sundevilmotorsports/pcb-dev/MiscLibraries/Figures/Mr Robberts/matt_throberts_720.png

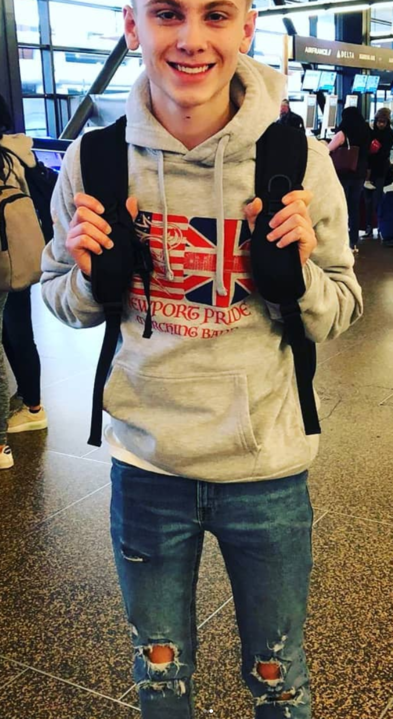
MiscLibraries/Figures/Mr Robberts/matt_throberts_720.png
