sundevilmotorsports/pcb-dev/MiscLibraries/Figures/Berdly/Cooking_Strain_Gauge2.jpeg

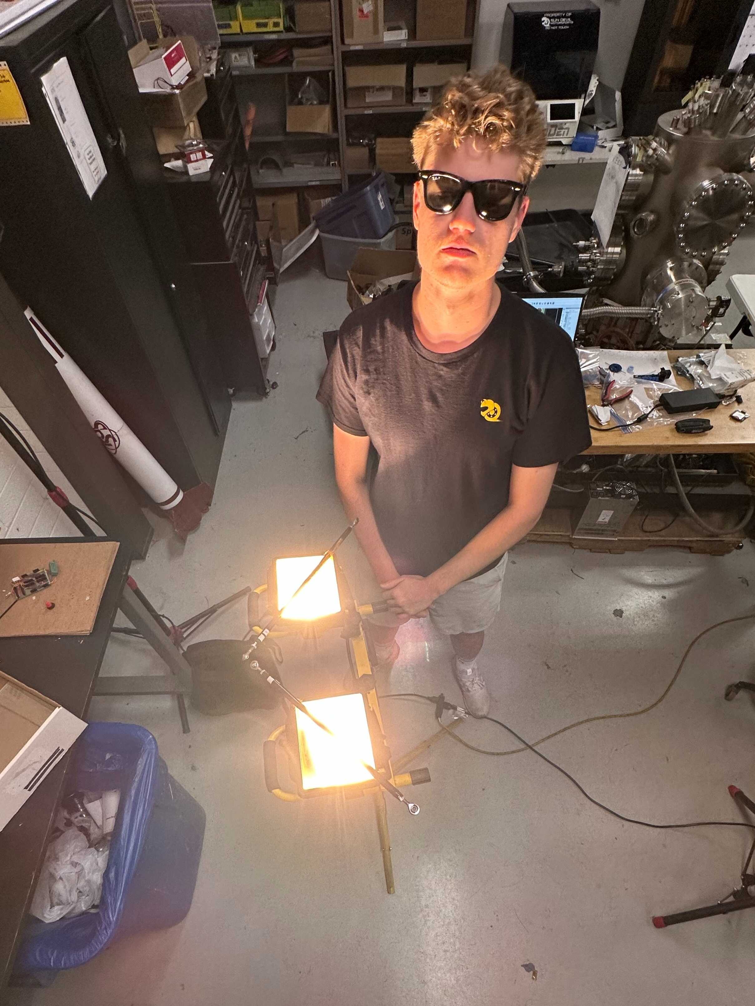
MiscLibraries/Figures/Berdly/Cooking_Strain_Gauge2.jpeg
