sundevilmotorsports/pcb-dev/README.md

# Sun Devil Motorsports Data Acquisition PCB Repository
## About
Various PCB projects for Data Acquisition. Includes:
- SDM-22 Main Board
- SDM-22 Wheel Board
- SDM CAN Board (Texas Instruments SN65HVD230)
- SDM KiCad library (submodule)
- SDM-23 things
- SDM-24 things
## Installation Requirements
- KiCad 6
- `SDM.pretty`, `SDM_kicad`, `teensy.pretty`, `teensy_library` (included here as submodules)
## Installation Instructions
1. Get the project.
```bash
$ git clone --recursive git@github.com:sundevilmotorsports/pcb-dev.git
```
2. Add `SDM.pretty`, `SDM_kicad`, `teensy.pretty`, `teensy_library` as libraries in KiCad.
