sundevilmotorsports/pcb-dev/2027/ESP_C5_Template/ESP C5 Extra Documentation.pdf

ESP USB_C
Power Net Names:
- Any voltage like 3.3v or 5v comes from a regulator on board.
- VBUS comes from a USB connection
- VCC comes from the car/anywhere outside the board.
- GND/VDD = Ground
Switching to USB_C for commonality/accessibility purposes

Power (Protection)
Max current calculation
- 12 * historic input current = 5 * output current + c
- c = losses due to heat, can essentially be ignored 2025 max constant current = 400mA
- 12 * 0.4 = 5 * oc
- oc = 1.042A
The lowest max rated current is TPS2116DRL @ 2.5A. Lowest Max rated current = LMC = 2.5A.
Efuze Max current = EMC.
Max constant current = MCC = 1.042.
MCC < EMC <= LMC

TPS25925x Calculations
TPS259250 = Latch on fault,
TPS259251 = auto retry on fault
Resistor @ ILIM pin calc = (ILIM (max current) - 0.7) / (3 * (10 ^ -5))
(LMC - 0.7) / (3 * (10 ^ -5)) = 60k Ohm
Undervoltage Lockout Set = V_(UV) = ((R_1 + R_2) /R_2) * V_ENR (1.4 Given) Left open so default value of V_(UV) is 4.3V

CAN Transceiver
Layout is essentially the same as SDM 26 except for a few changes:
- New 3.3V FD Transceiver with:
- An exposed thermal pad pin (EP)
- No 0 resistor to adjust slew rate New chip is 8Mbps, while last years was just 1.

Crystal/Oscillator
- 48 MHz req. by C5 chip
Load Capacitors Calculations
- CL is Load Capacitance listed in the crystals datasheet
- Cs is Stray Capacitance (unintentional capacitance due to close proximity of components), set range is debated based on the board but calculators use 2-7pF. CL=10 pF
*Say Cs=4pF
CL= (C1xC2)/(C1+C2)+Cs

Symmetrical Load
C1=C2= 2(CL-Cs)
C = 2(10-4) = 12pF

https://nodeloop.org/tools/crystal-load-capacitor-calculator/?cl=10&cs=4
