sundevilmotorsports/pcb-dev/PRE2026/old/sdm_kicad/README.md

# sdm_kicad
Sun Devil Motorsports KiCad Library.
