sundevilmotorsports/pcb-dev/2026/Telemetry/SDM26_Telemetry_V1.0/Impedance Matching Layers.png

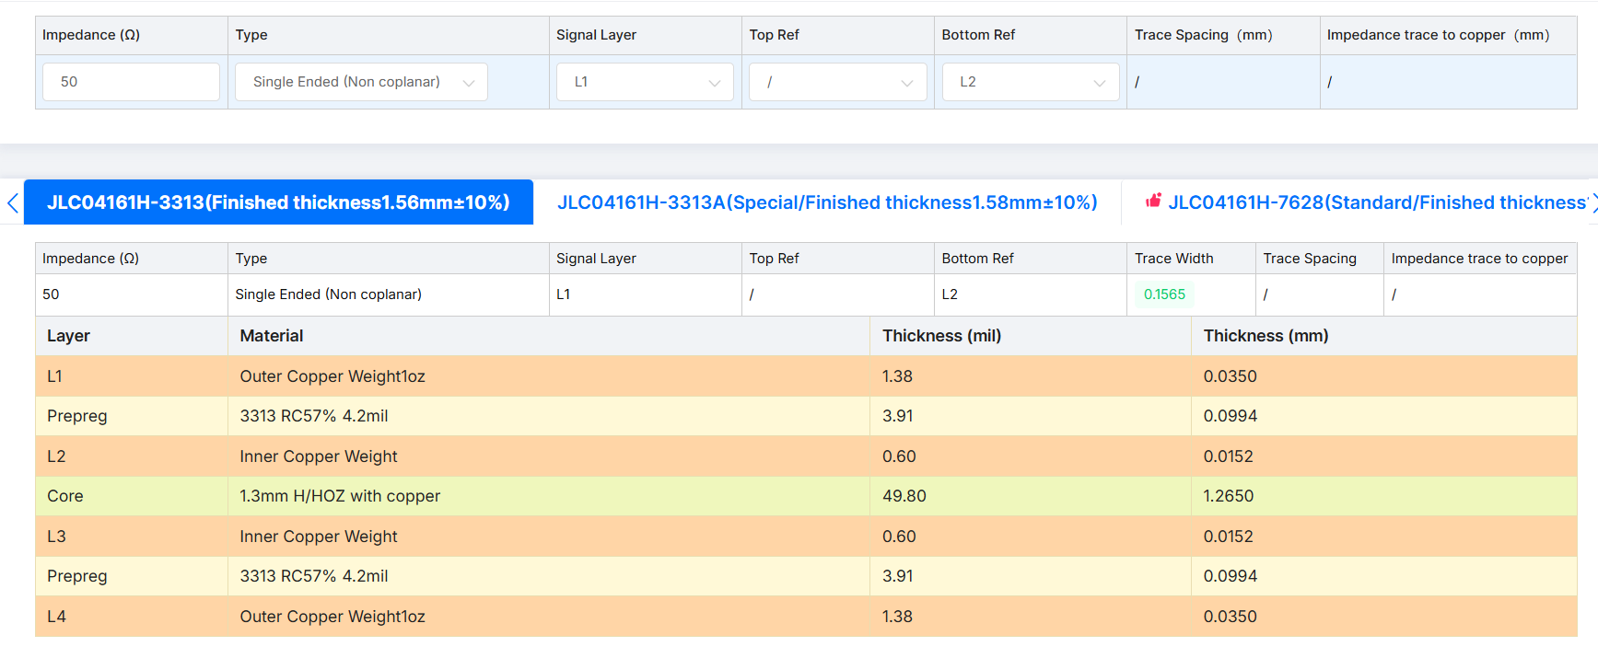
2026/Telemetry/SDM26_Telemetry_V1.0/Impedance Matching Layers.png
