sundevilmotorsports/pcb-dev/MiscLibraries/Figures/Berdly/Cooking_Strain_Gauge.jpeg

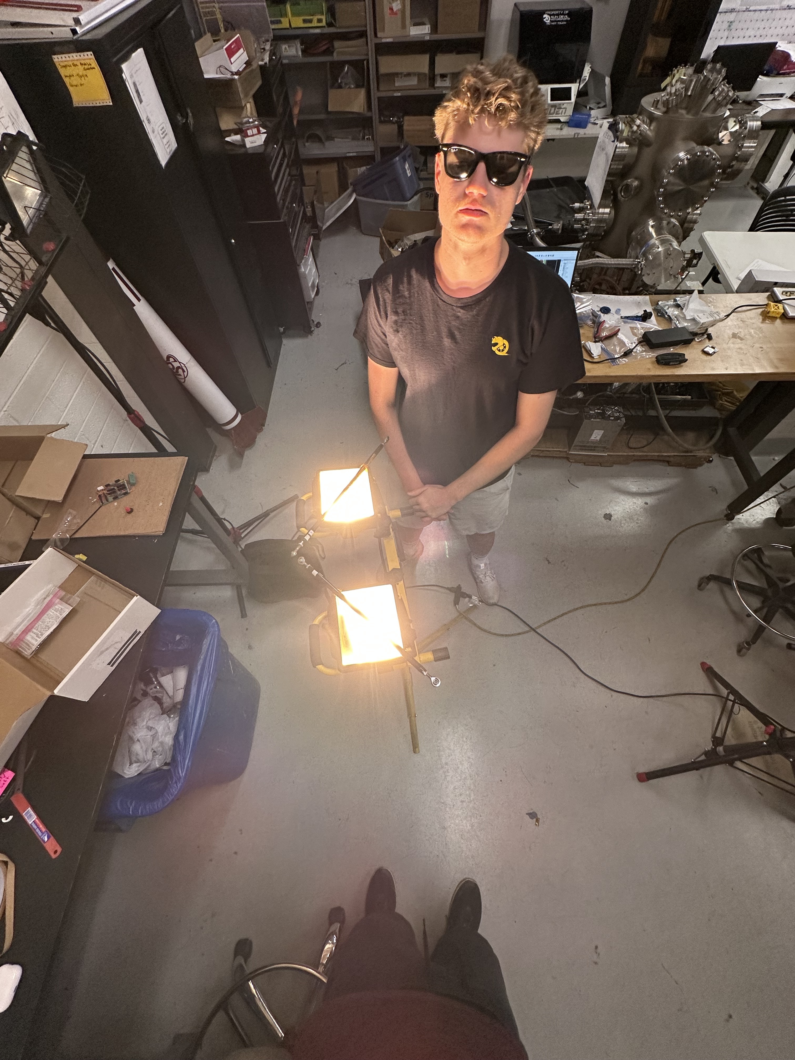
MiscLibraries/Figures/Berdly/Cooking_Strain_Gauge.jpeg
