sundevilmotorsports/pcb-dev/MiscLibraries/Figures/Berdly/FindingGold.jpg

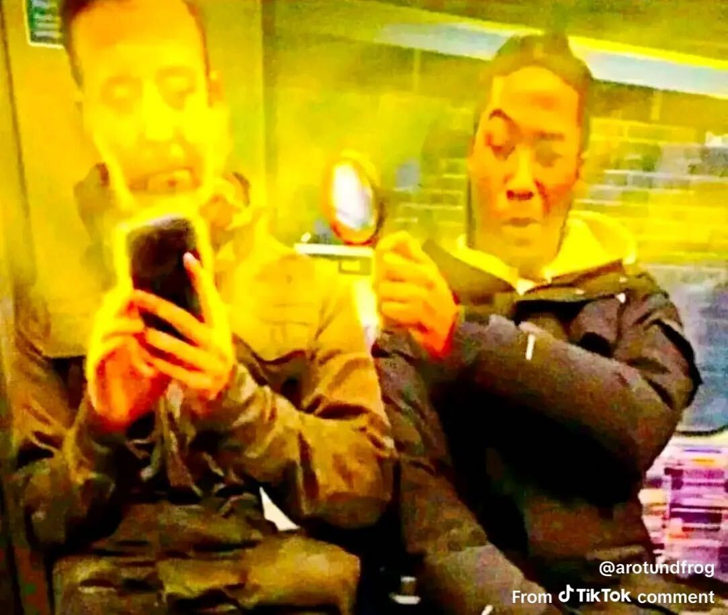
MiscLibraries/Figures/Berdly/FindingGold.jpg
