sundevilmotorsports/pcb-dev/MiscLibraries/Figures/Chris/DevistatedChris.jpg

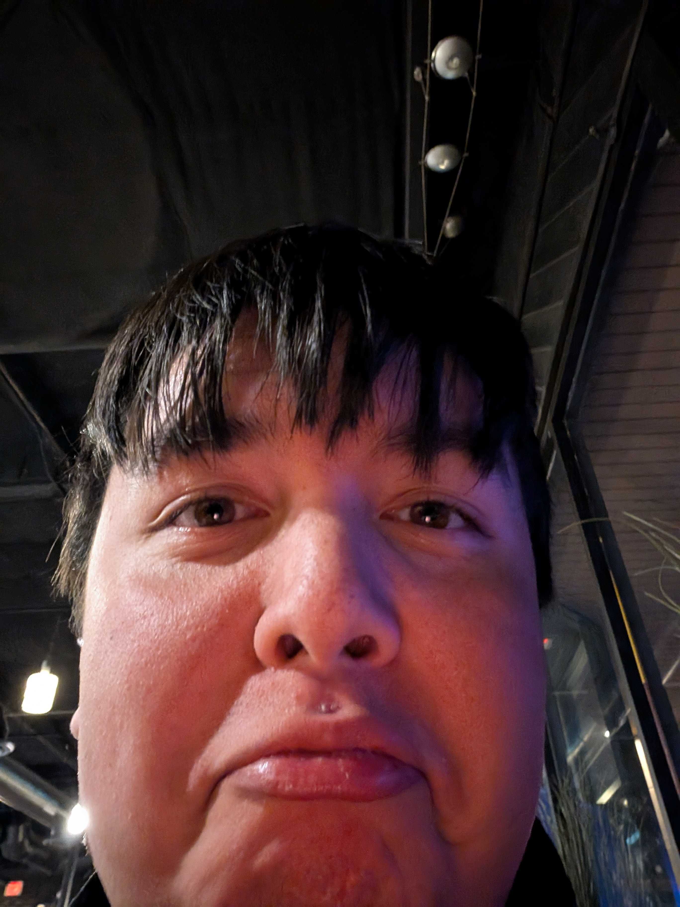
MiscLibraries/Figures/Chris/DevistatedChris.jpg
