sundevilmotorsports/pcb-dev/MiscLibraries/Figures/Chris/PXL_20250712_215207178.jpg

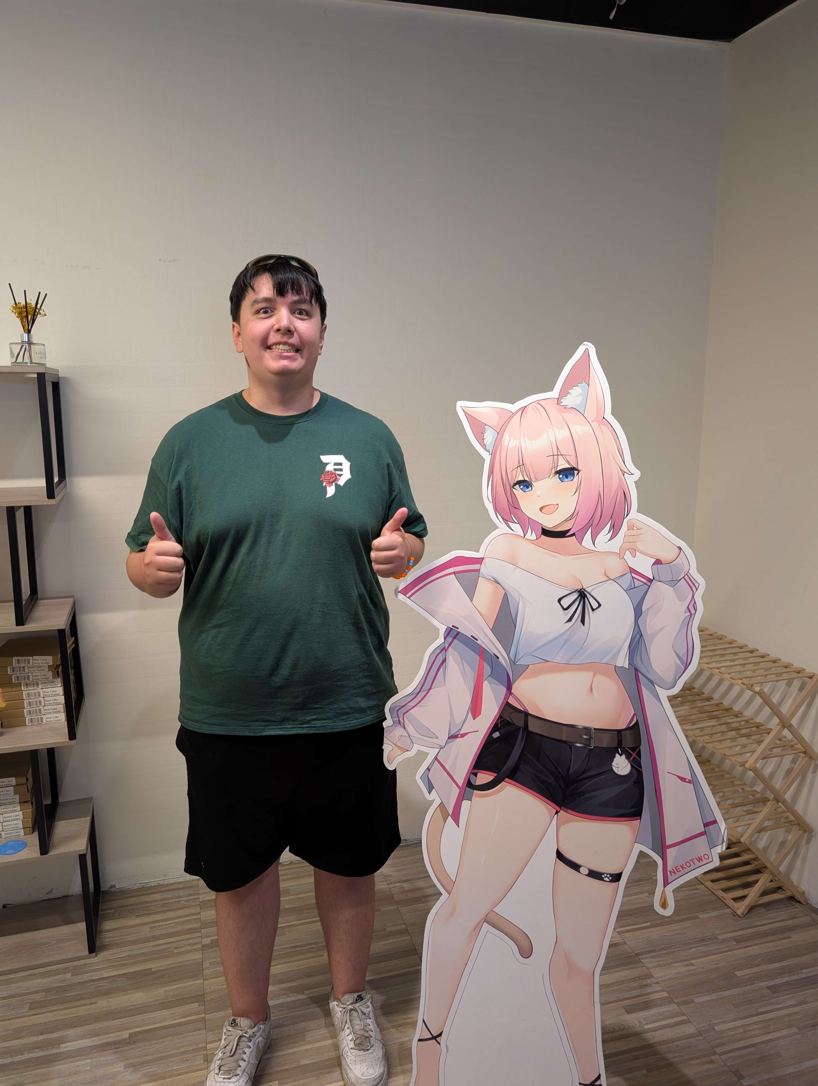
MiscLibraries/Figures/Chris/PXL_20250712_215207178.jpg
