sundevilmotorsports/pcb-dev/MiscLibraries/Figures/Chris/rsz_1chrisdevistatedbw.jpg

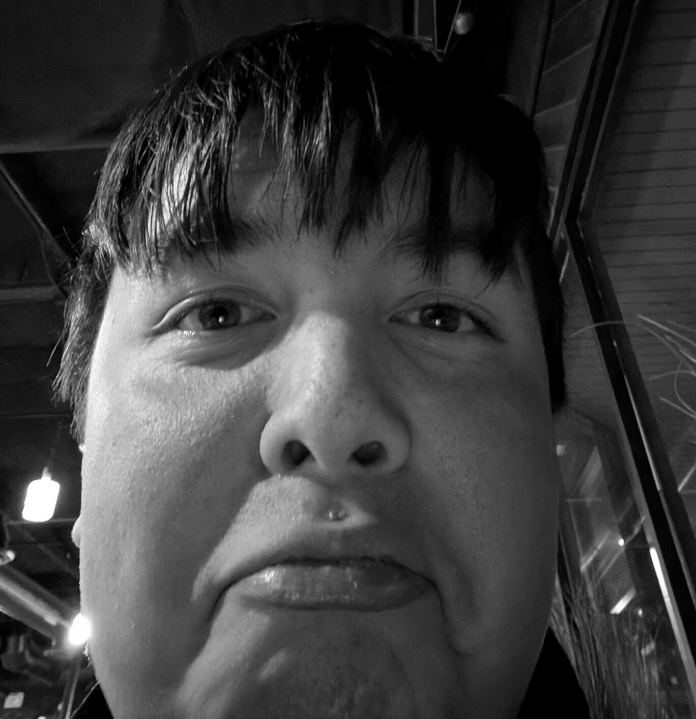
MiscLibraries/Figures/Chris/rsz_1chrisdevistatedbw.jpg
