sundevilmotorsports/pcb-dev/MiscLibraries/Figures/Comp/SDM_Comp24_Team.jpg

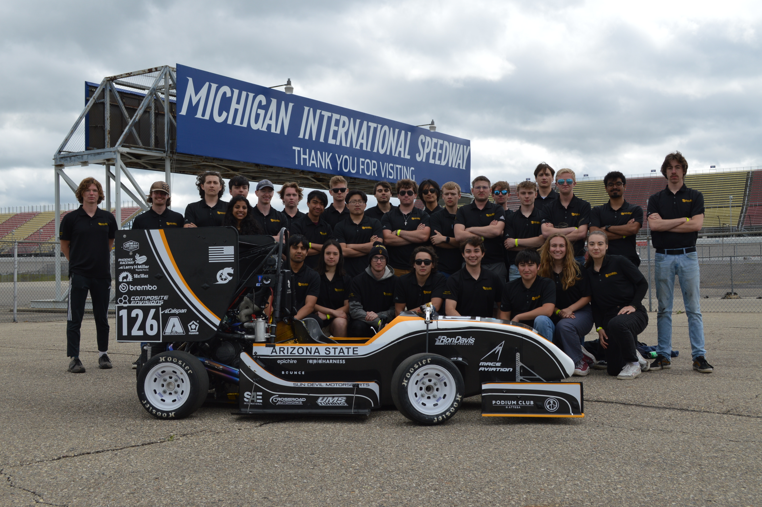
MiscLibraries/Figures/Comp/SDM_Comp24_Team.jpg
