sundevilmotorsports/pcb-dev/MiscLibraries/Figures/Comp/SDM_Comp25_Team.jpg

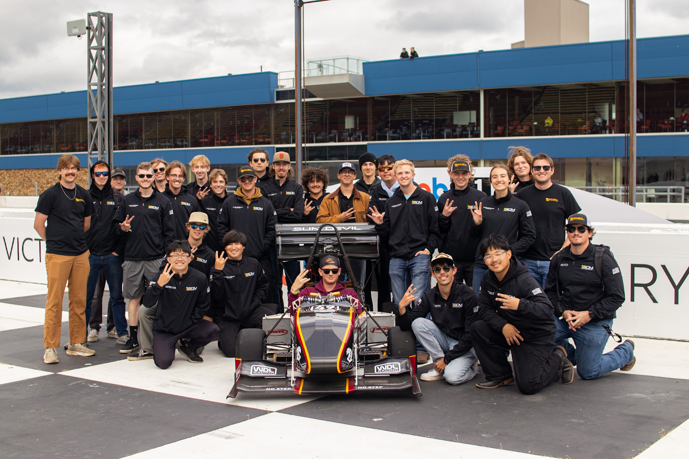
MiscLibraries/Figures/Comp/SDM_Comp25_Team.jpg
