sundevilmotorsports/pcb-dev/MiscLibraries/Figures/DAQ/DAQ_Drawing.jpg

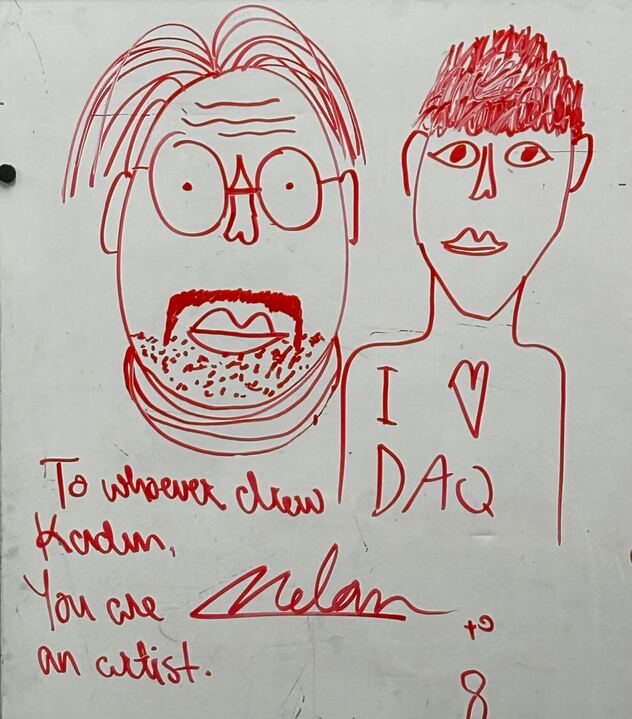
MiscLibraries/Figures/DAQ/DAQ_Drawing.jpg
