sundevilmotorsports/pcb-dev/MiscLibraries/Figures/Derk/Derk2.JPG

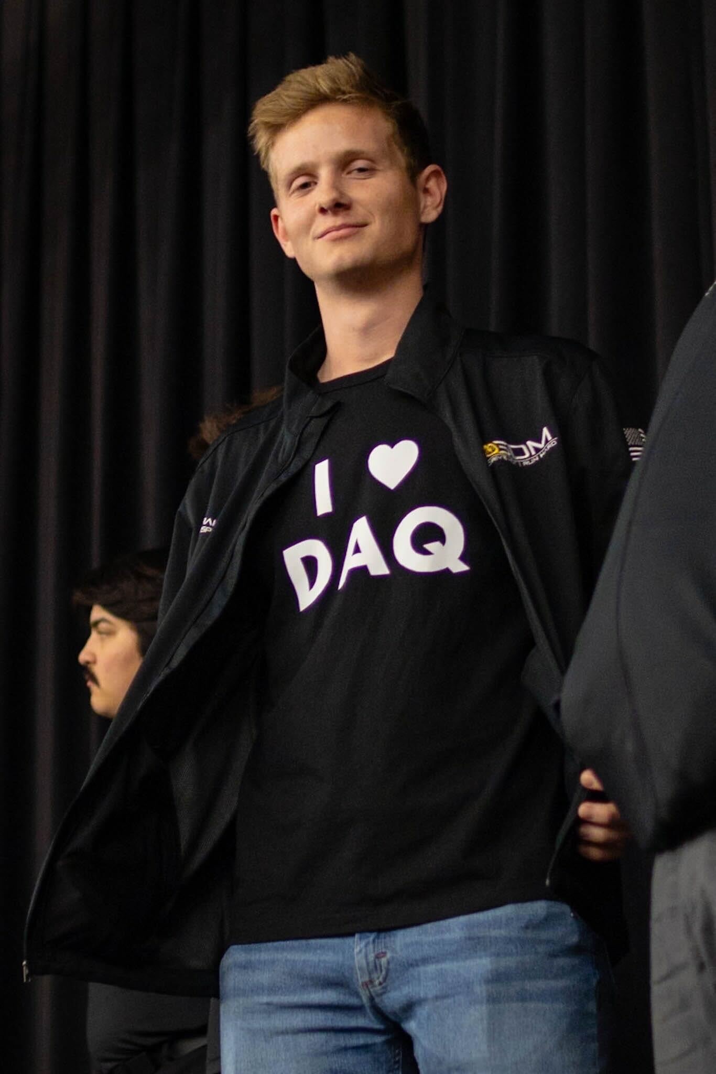
MiscLibraries/Figures/Derk/Derk2.JPG
