sundevilmotorsports/pcb-dev/MiscLibraries/Figures/Derk/Derk-Better.png

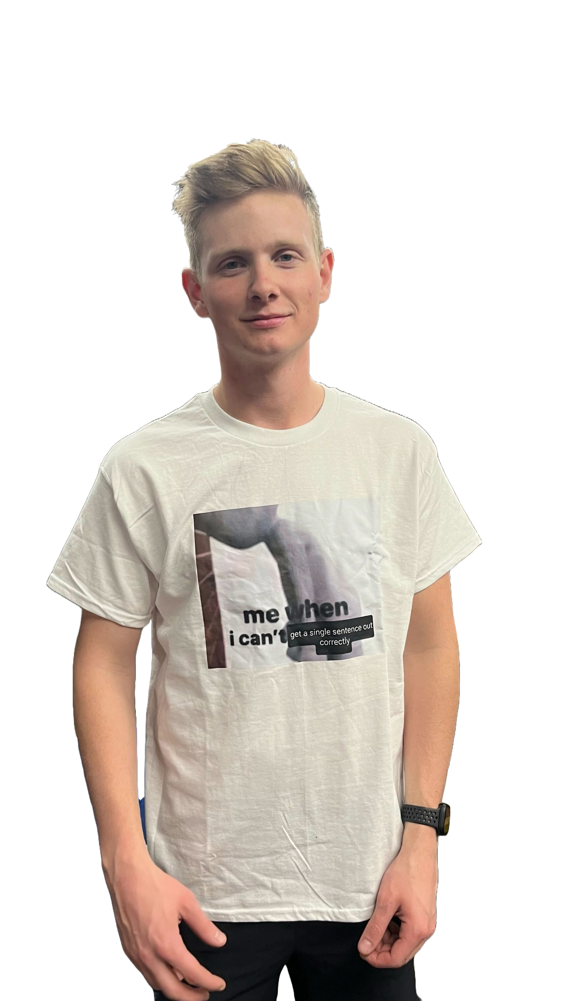
MiscLibraries/Figures/Derk/Derk-Better.png
