sundevilmotorsports/pcb-dev/MiscLibraries/Figures/Derk/Derk.PNG

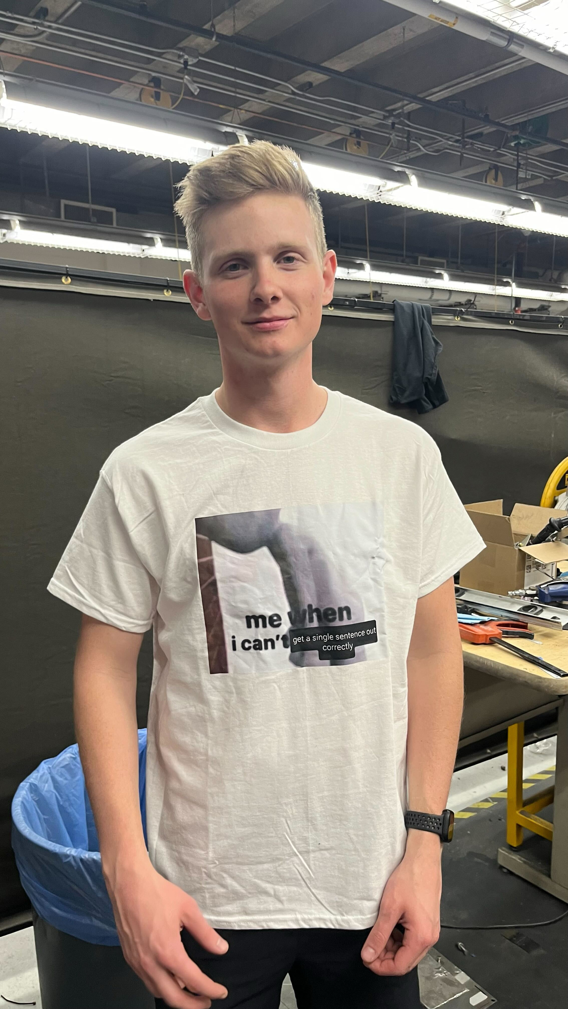
MiscLibraries/Figures/Derk/Derk.PNG
