sundevilmotorsports/pcb-dev/MiscLibraries/Figures/Derk/NotVeryMormonOfYou.jpg

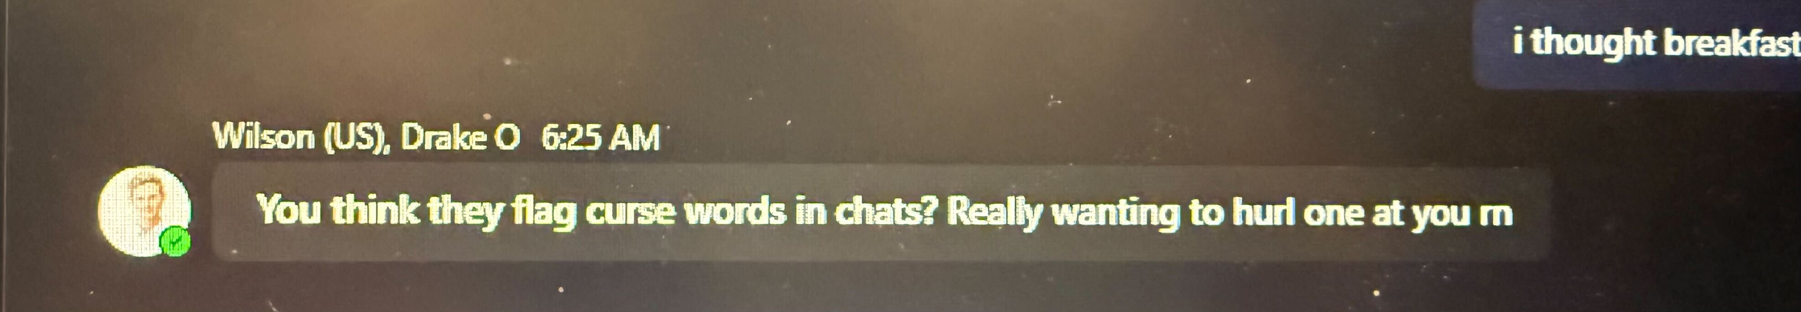
MiscLibraries/Figures/Derk/NotVeryMormonOfYou.jpg
