sundevilmotorsports/pcb-dev/MiscLibraries/Figures/EmojiGuys/BoarHeadExploding.png

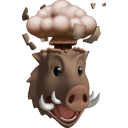
MiscLibraries/Figures/EmojiGuys/BoarHeadExploding.png
