sundevilmotorsports/pcb-dev/MiscLibraries/Figures/EmojiGuys/Emo_ji.JPG

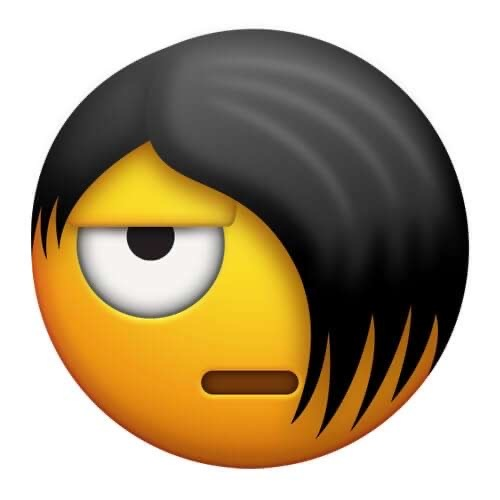
MiscLibraries/Figures/EmojiGuys/Emo_ji.JPG
