sundevilmotorsports/pcb-dev/MiscLibraries/Figures/EmojiGuys/evil_hands.png

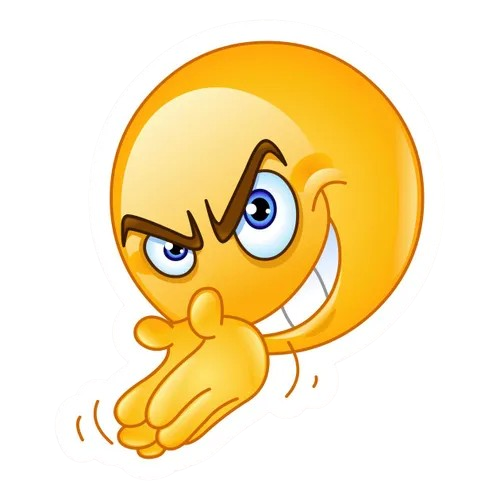
MiscLibraries/Figures/EmojiGuys/evil_hands.png
