sundevilmotorsports/pcb-dev/MiscLibraries/Figures/EmojiGuys/Lean.png

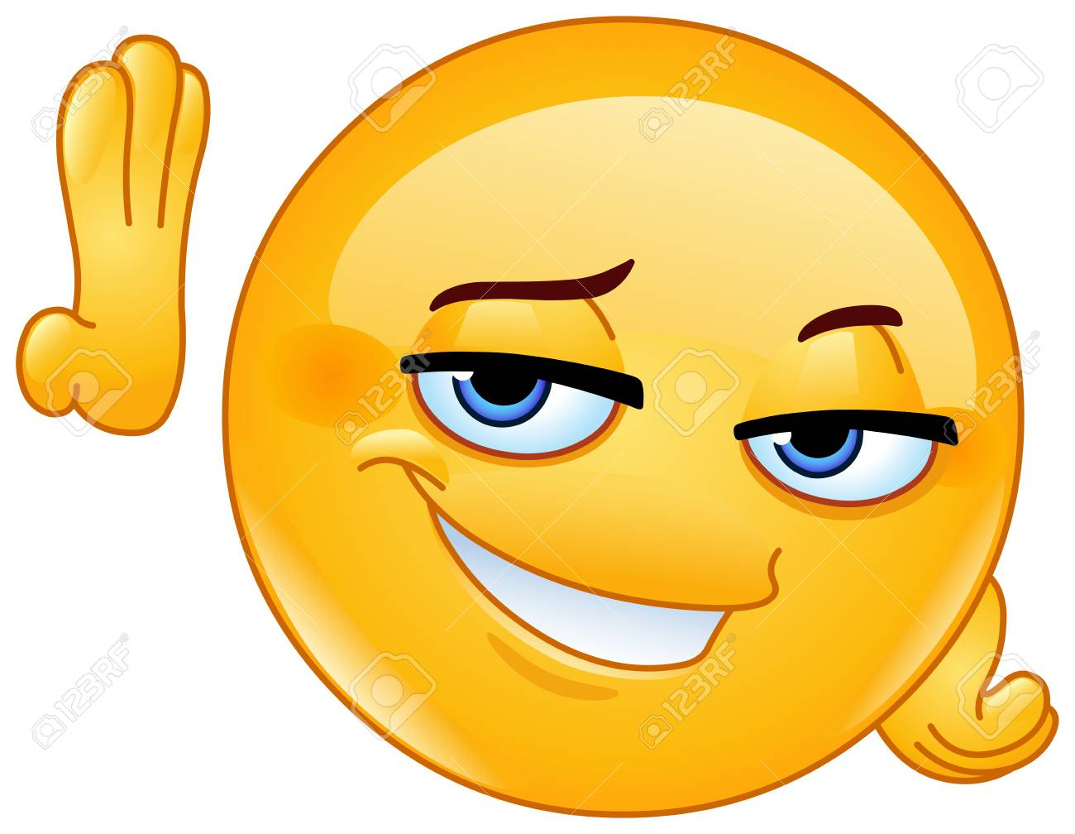
MiscLibraries/Figures/EmojiGuys/Lean.png
