sundevilmotorsports/pcb-dev/MiscLibraries/Figures/Fattu/IMG_8624.jpg

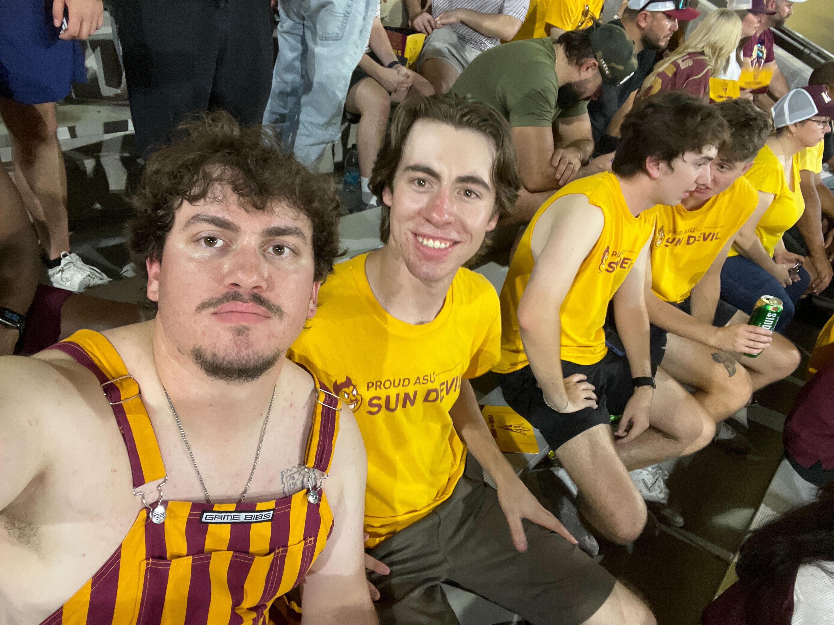
MiscLibraries/Figures/Fattu/IMG_8624.jpg
