sundevilmotorsports/pcb-dev/MiscLibraries/Figures/Hunter/DoubleBoof.jpg

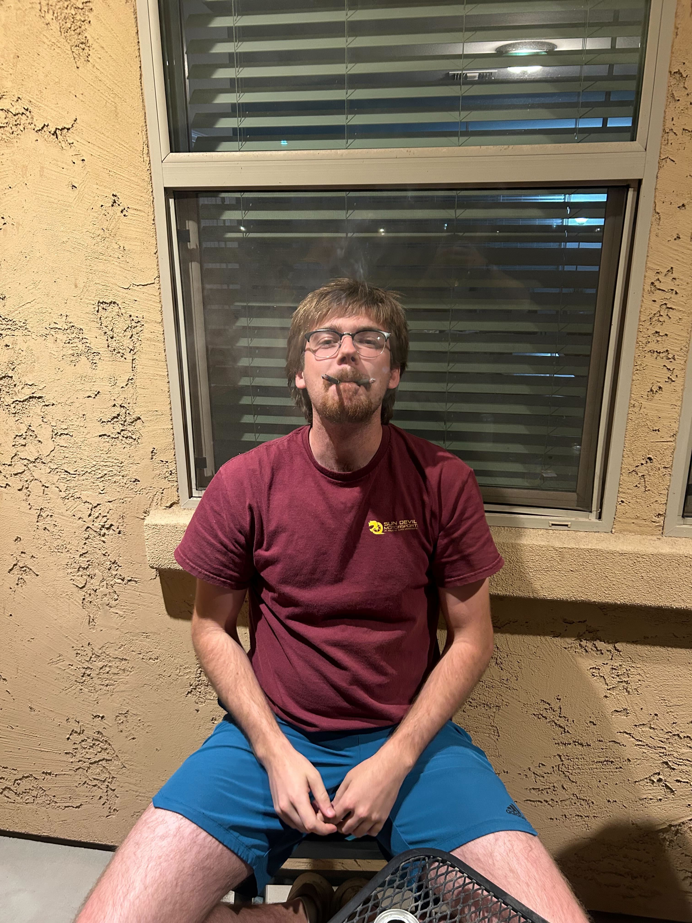
MiscLibraries/Figures/Hunter/DoubleBoof.jpg
