sundevilmotorsports/pcb-dev/MiscLibraries/Figures/Hunter/IMG_1586.jpg

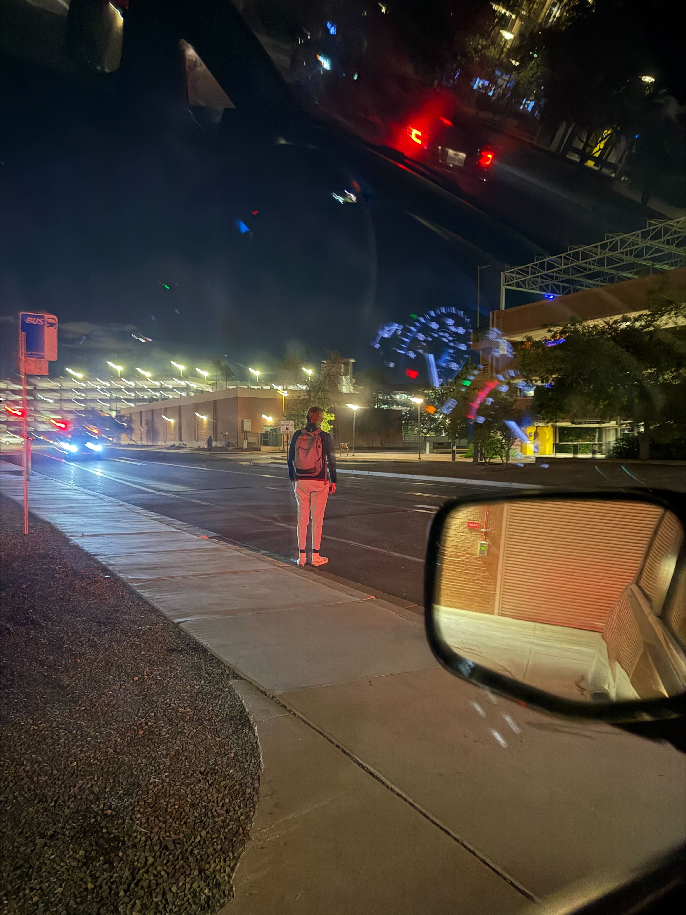
MiscLibraries/Figures/Hunter/IMG_1586.jpg
