sundevilmotorsports/pcb-dev/MiscLibraries/Figures/Kaden/Cooking_Strain_Gauge_Kaden2.jpeg

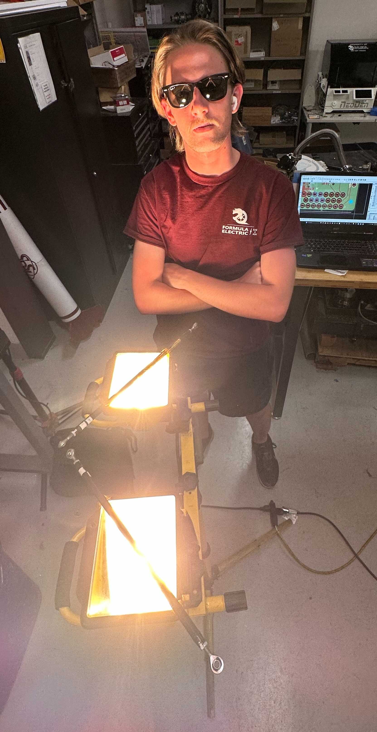
MiscLibraries/Figures/Kaden/Cooking_Strain_Gauge_Kaden2.jpeg
