sundevilmotorsports/pcb-dev/MiscLibraries/Figures/Kaden/Cooking_Strain_Gauge_Kaden.jpeg

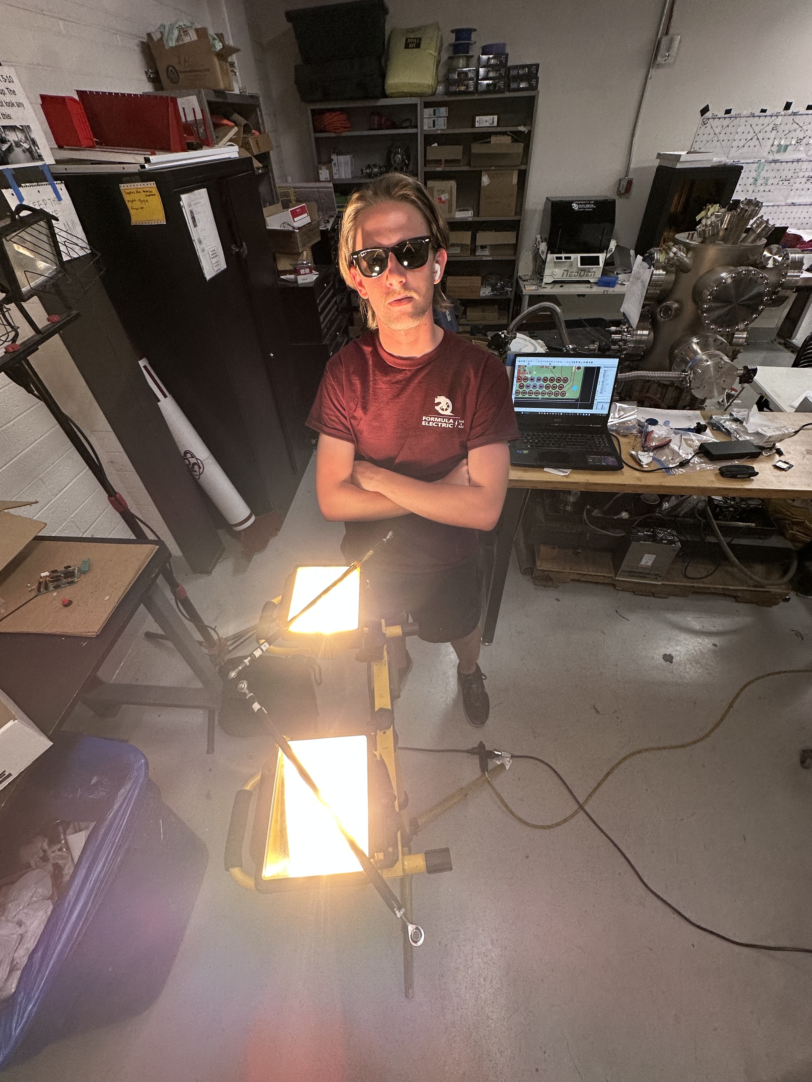
MiscLibraries/Figures/Kaden/Cooking_Strain_Gauge_Kaden.jpeg
