sundevilmotorsports/pcb-dev/MiscLibraries/Figures/Kaden/GodForbidAWhiteBoyHasALittleMotion.png

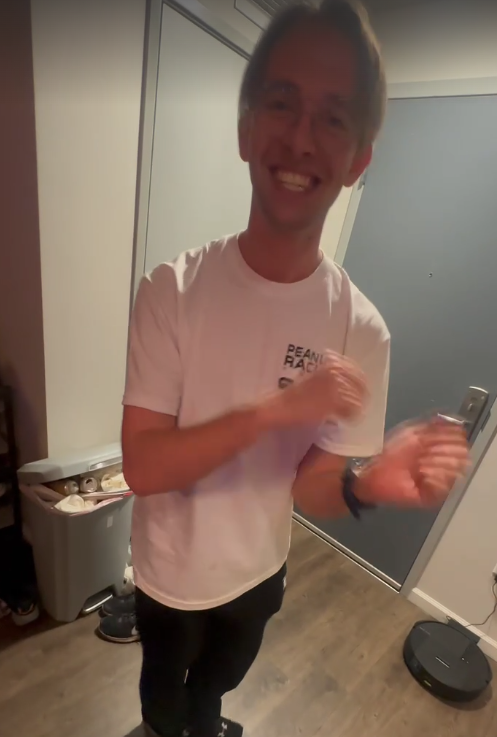
MiscLibraries/Figures/Kaden/GodForbidAWhiteBoyHasALittleMotion.png
