sundevilmotorsports/pcb-dev/MiscLibraries/Figures/Kaden/GodForbidAWhiteBoyHasALittleMotion_NoBackground.png

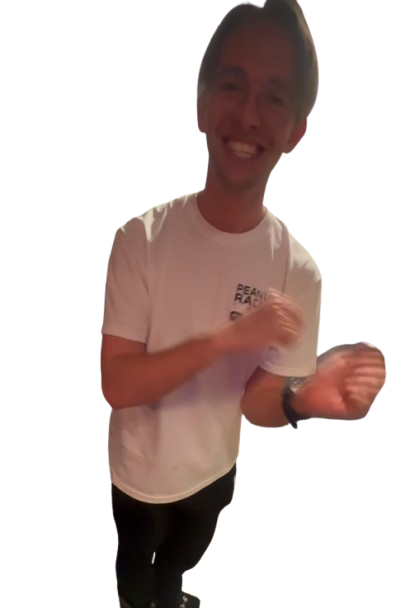
MiscLibraries/Figures/Kaden/GodForbidAWhiteBoyHasALittleMotion_NoBackground.png
