sundevilmotorsports/pcb-dev/MiscLibraries/Figures/Kaden/IMG_5408.JPG

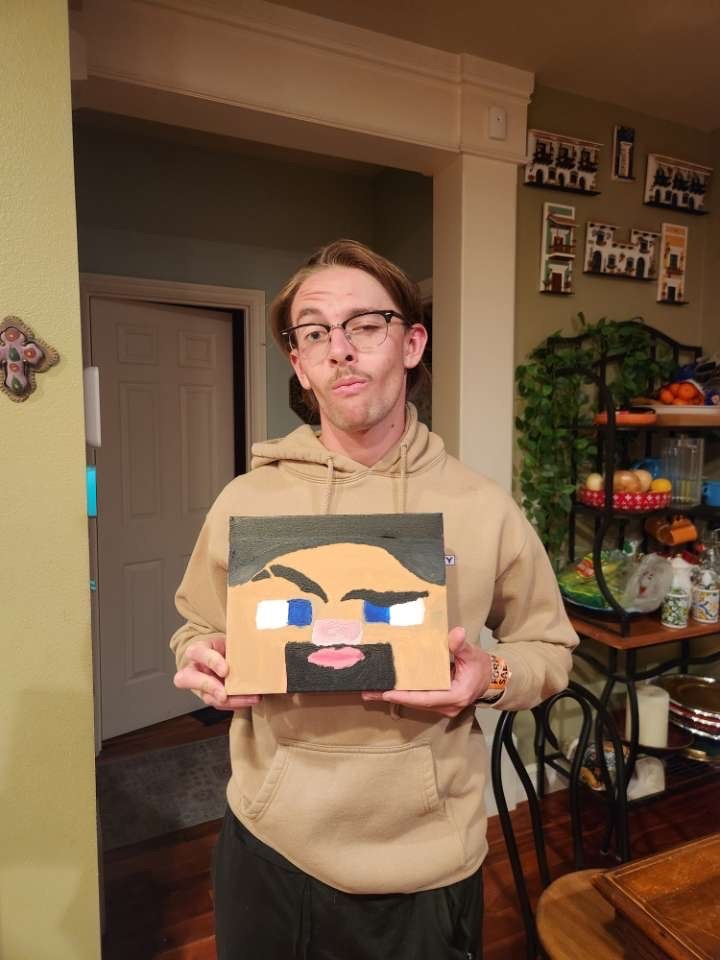
MiscLibraries/Figures/Kaden/IMG_5408.JPG
