sundevilmotorsports/pcb-dev/MiscLibraries/Figures/Kaden/Screenshot 2024-09-02 at 6.34.21 PM.jpg

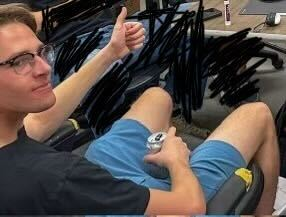
MiscLibraries/Figures/Kaden/Screenshot 2024-09-02 at 6.34.21 PM.jpg
