sundevilmotorsports/pcb-dev/MiscLibraries/Figures/Nick/engine_guy.jpg

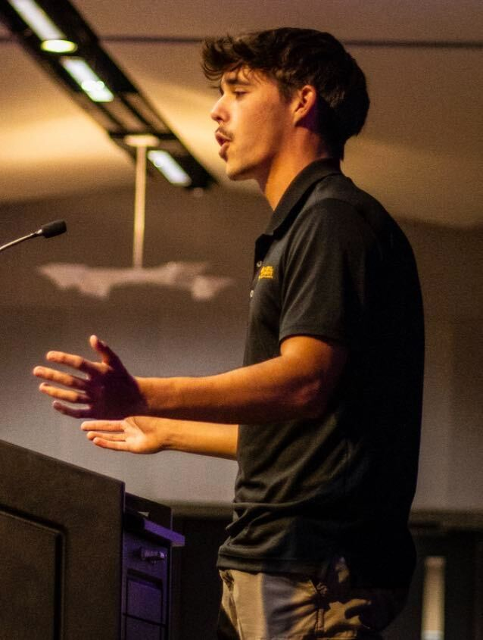
MiscLibraries/Figures/Nick/engine_guy.jpg
