sundevilmotorsports/pcb-dev/MiscLibraries/Figures/Nick/Flickless.png

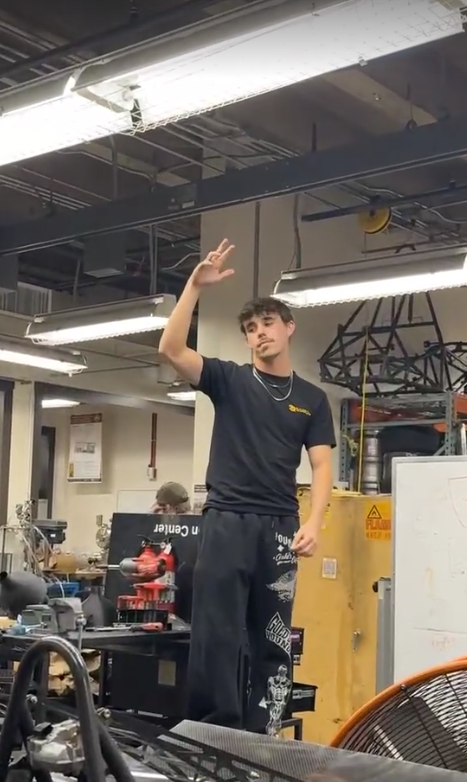
MiscLibraries/Figures/Nick/Flickless.png
