sundevilmotorsports/pcb-dev/MiscLibraries/Figures/Nick/Flickless_NoBackground.png

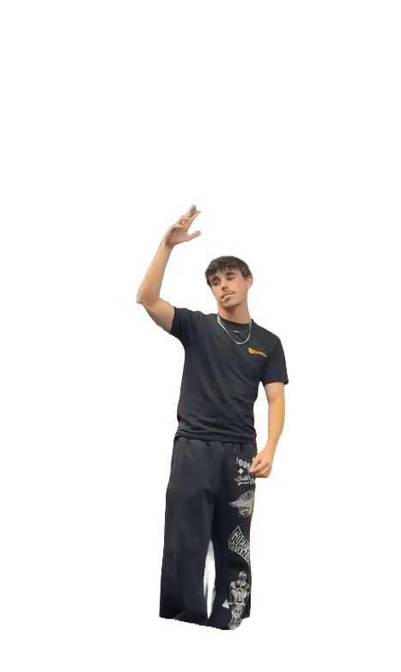
MiscLibraries/Figures/Nick/Flickless_NoBackground.png
