sundevilmotorsports/pcb-dev/MiscLibraries/Figures/Nick/Wazzaaa.jpg

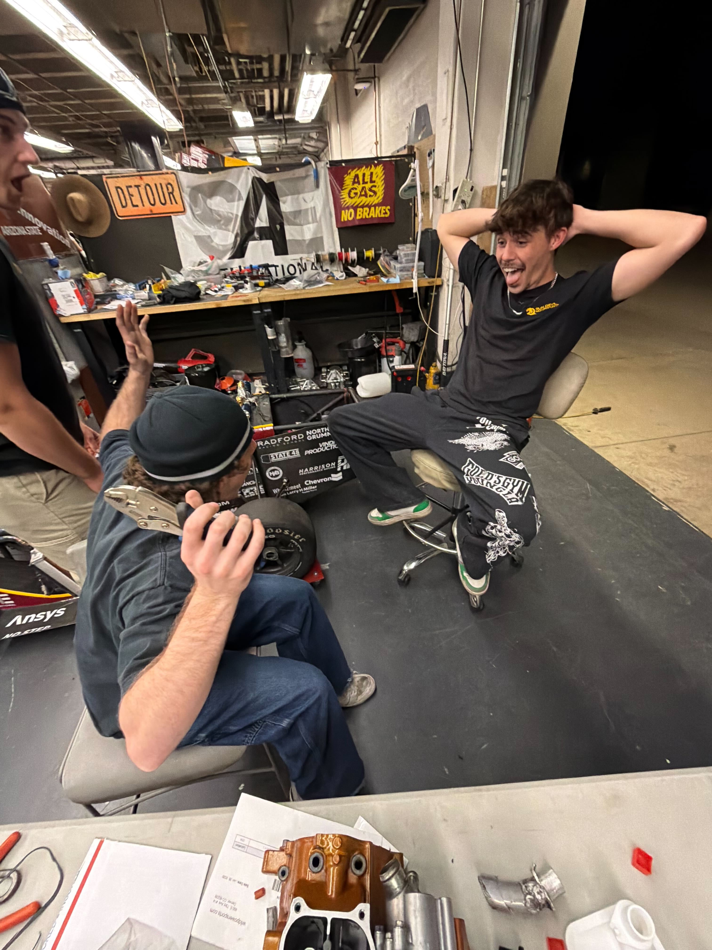
MiscLibraries/Figures/Nick/Wazzaaa.jpg
