sundevilmotorsports/pcb-dev/MiscLibraries/Figures/Nick/Wazzaaa_NoBackground.png

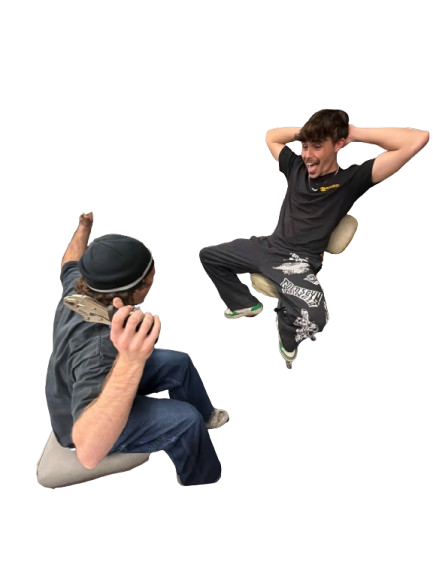
MiscLibraries/Figures/Nick/Wazzaaa_NoBackground.png
