sundevilmotorsports/pcb-dev/MiscLibraries/Figures/SW Requests/aint-shit-sweet.png

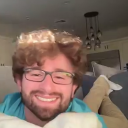
MiscLibraries/Figures/SW Requests/aint-shit-sweet.png
