sundevilmotorsports/pcb-dev/MiscLibraries/Figures/SW Requests/claud silly.png

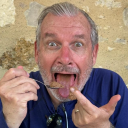
MiscLibraries/Figures/SW Requests/claud silly.png
