sundevilmotorsports/pcb-dev/MiscLibraries/Figures/SW Requests/Thinking Monkey.jpg

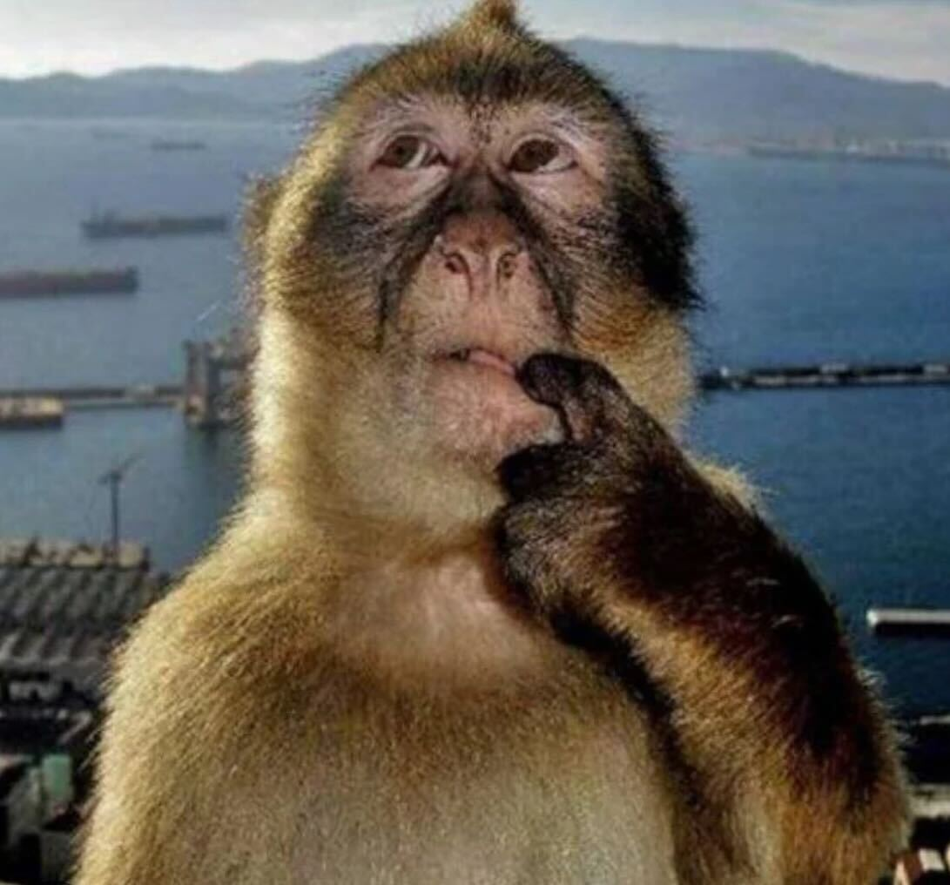
MiscLibraries/Figures/SW Requests/Thinking Monkey.jpg
