sundevilmotorsports/pcb-dev/pictures/sdm22-main.png

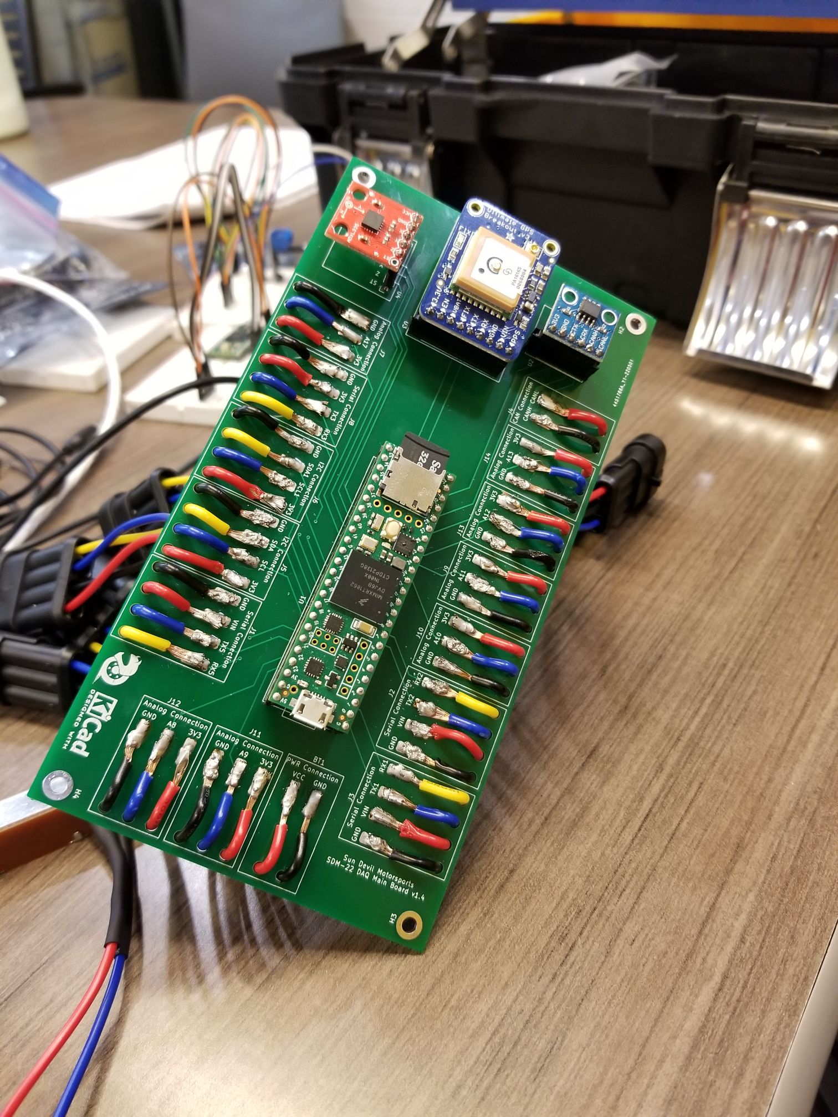
pictures/sdm22-main.png
