sundevilmotorsports/pcb-dev/PRE2026/cansplitter/info/boardstats.png

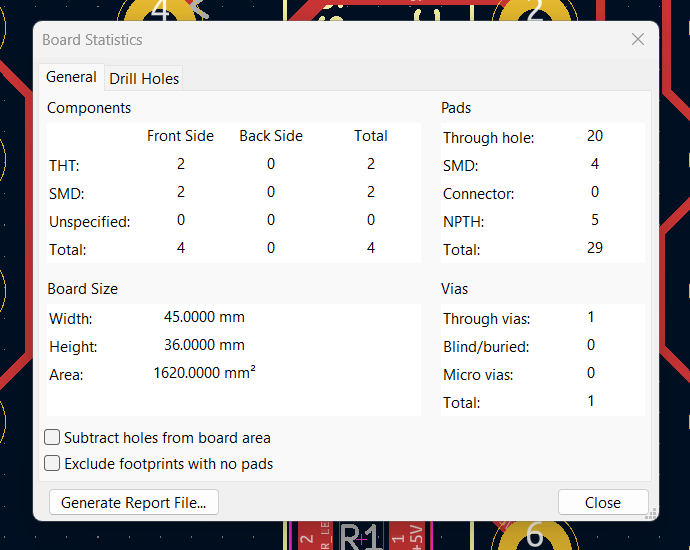
PRE2026/cansplitter/info/boardstats.png
