sundevilmotorsports/pcb-dev/PRE2026/loggerpanel/illegal.jpg

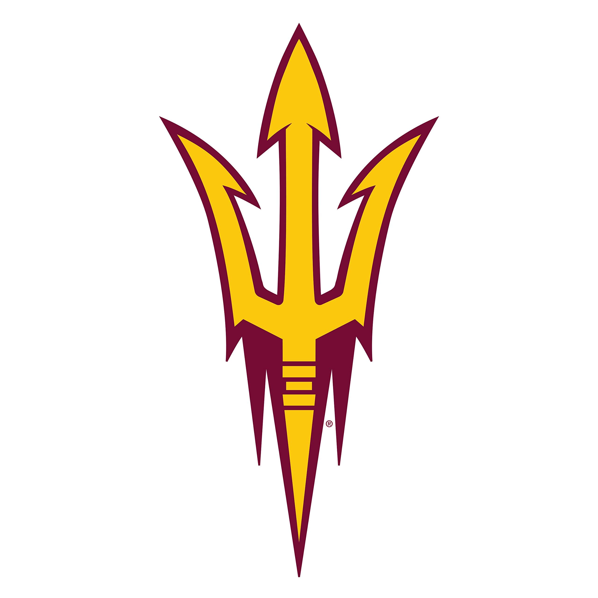
PRE2026/loggerpanel/illegal.jpg
