sundevilmotorsports/pcb-dev/PRE2026/loggerpanel/pompompurin-half.png

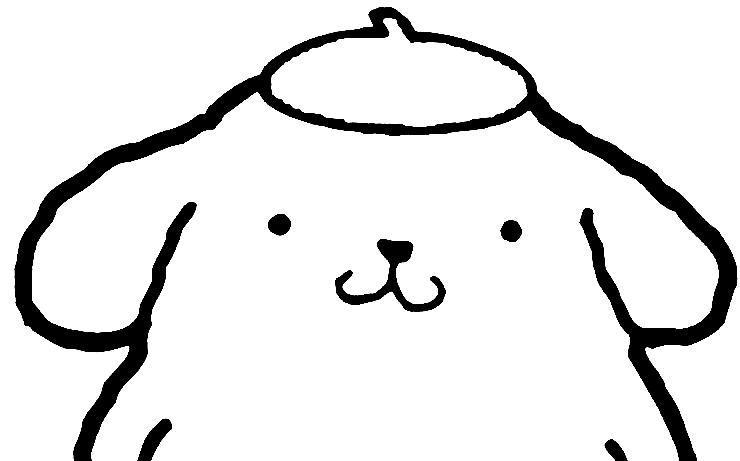
PRE2026/loggerpanel/pompompurin-half.png
