sundevilmotorsports/pcb-dev/PRE2026/loggerpanel/pompompurin.png

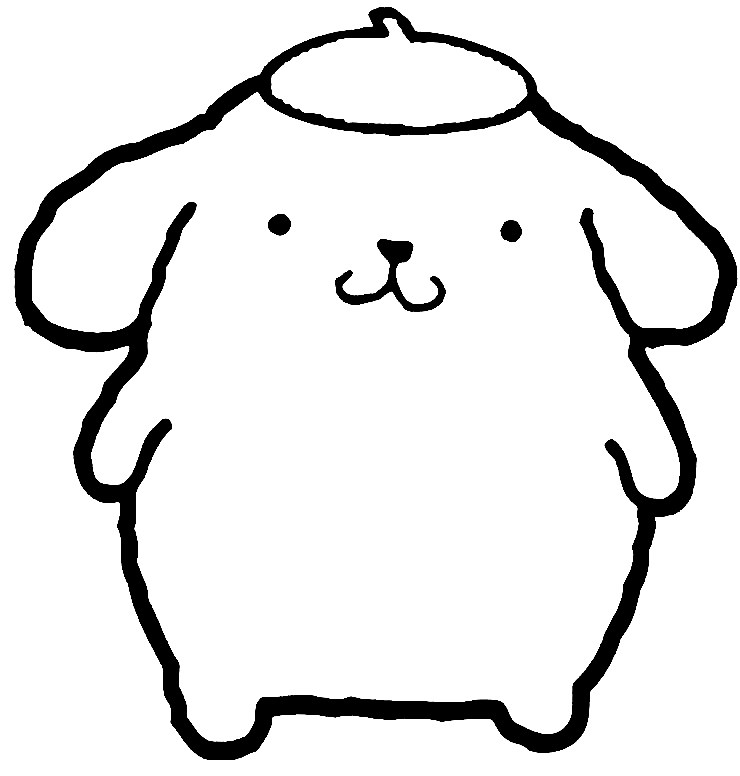
PRE2026/loggerpanel/pompompurin.png
