sundevilmotorsports/pcb-dev/PRE2026/sdm24logger/Screenshot 2023-10-12 192610.png

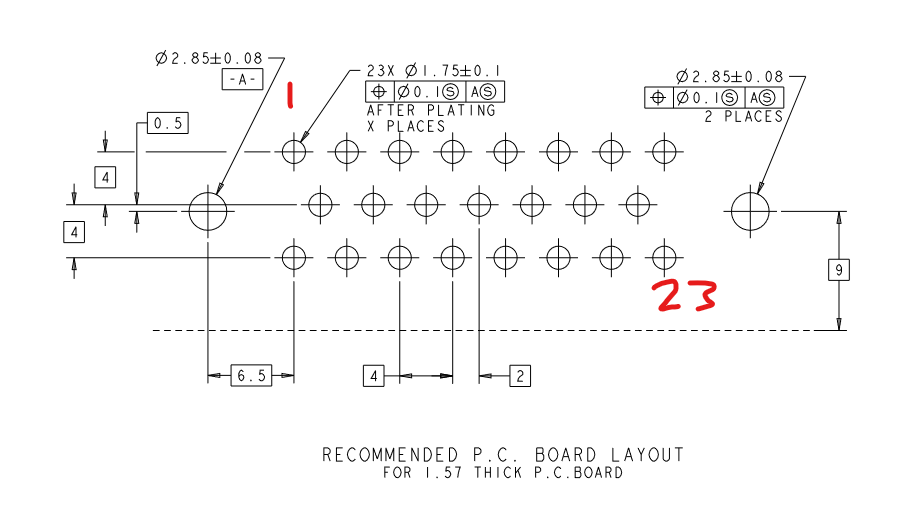
PRE2026/sdm24logger/Screenshot 2023-10-12 192610.png
