sundevilmotorsports/pcb-dev/yaw_probe_stm32/pinout.png

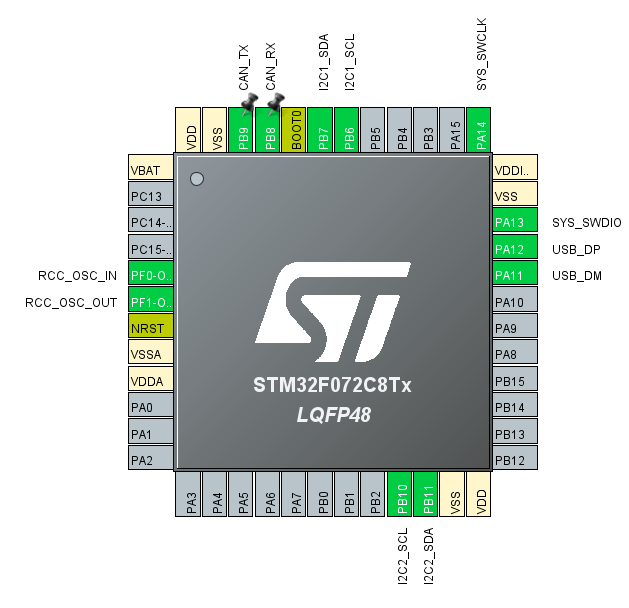
yaw_probe_stm32/pinout.png
