sundevilmotorsports/pcb-dev/2027/SDM27_CANSniffer/CANSniffer V1/ESP-C5-CAN SNIFFERV1.1.csv

Reference | Qty | Value | DNP | Exclude from BOM | Exclude from Board | Footprint | Supplier Link | Datasheet
C1,C2,C3,C4,C5 | 5 | 1uF |  |  |  | Capacitor_SMD:C_0603_1608Metric | https://mou.sr/4A2n7yy
C6,C7,C8,C9,C19,C23,C24,C25,C28 | 9 | 100nF |  |  |  | Capacitor_SMD:C_0603_1608Metric | https://mou.sr/4zfe25a
C10,C11,C12,C26 | 4 | 10uF |  |  |  | Capacitor_SMD:C_0603_1608Metric | https://mou.sr/4BqfCmx
C13 | 1 | 0.3pF |  |  |  | Capacitor_SMD:C_0603_1608Metric | https://mou.sr/4iscM7N
C14 | 1 | 0.8pF |  |  |  | Capacitor_SMD:C_0603_1608Metric | https://mou.sr/4ilLvDI
C15 | 1 | 2.6pF |  |  |  | Capacitor_SMD:C_0603_1608Metric | https://mou.sr/3UsMn1F
C16 | 1 | 3pF |  |  |  | Capacitor_SMD:C_0603_1608Metric | https://mou.sr/4BvYDz4
C17,C18 | 2 | 12pF |  |  |  | Capacitor_SMD:C_0201_0603Metric | https://mou.sr/4yHUIwj
C20 | 1 | 1uF 10V 0603 |  |  |  | Capacitor_SMD:C_0603_1608Metric | https://mou.sr/4A2n7yy
C21 | 1 | 10uF 25V |  |  |  | Capacitor_SMD:C_0603_1608Metric | https://mou.sr/4BqfCmx
C22 | 1 | 22uF |  |  |  | Capacitor_SMD:C_0603_1608Metric | https://mou.sr/4zjyUbM
C27 | 1 | 10nF |  |  |  | Capacitor_SMD:C_0603_1608Metric | https://mou.sr/4zfUVYV
D1,D3,D4 | 3 | LED |  |  |  | SDM_MISC:SSFLXH100LID01 | https://mou.sr/4kBq5Ft
D2 | 1 | ESDCAN03-2BWY |  |  |  | SDM_MISC:SOT65P210X110-3N | https://mou.sr/4idAHHK | https://www.mouser.de/datasheet/2/389/esdcan02-2bwy-954689.pdf
J1,J4 | 2 | WEIPU SA12 7PIN |  |  |  | Connector_PinHeader_2.54mm:PinHeader_1x07_P2.54mm_Vertical
J2 | 1 | USB_C_Receptacle_USB2.0_16P |  |  |  | SDM_MISC:USB_C_Receptacle_G-Switch_GT-USB-7010ASVCAN | https://mou.sr/4zdBBeJ | https://www.usb.org/sites/default/files/documents/usb_type-c.zip
J3 | 1 | ELECROW_2.8_ILI9341 |  |  |  | Connector_PinSocket_2.54mm:PinSocket_1x14_P2.54mm_Vertical | https://www.elecrow.com/2-8-inch-320x240-spi-serial-tft-lcd-module-display-with-driver-ic-ili9341.html
L1 | 1 | 24nH |  |  |  | Inductor_SMD:L_0402_1005Metric | https://mou.sr/4Ajn0if
L2 | 1 | 2.0nH |  |  |  | Inductor_SMD:L_0402_1005Metric | https://mou.sr/3URcQ9e
L3 | 1 | F1C1-201612-2R2M |  |  |  | SDM_MISC:F1C12016122R2M | https://mou.sr/48odq1e | https://www.mouser.de/datasheet/3/191/1/ds_ST_F1C1_2016_series.pdf
LED2 | 1 | 150060RS75000 |  |  |  | SDM_MISC:LEDC1608X80N | https://mou.sr/4x26roO | https://www.we-online.com/components/products/datasheet/150060RS75000.pdf
R1,R2,R20,R21,R23 | 5 | 10k |  |  |  | Resistor_SMD:R_0402_1005Metric | https://mou.sr/4xBMwOD
R3,R4 | 2 | 27 |  |  |  | Resistor_SMD:R_0402_1005Metric | https://mou.sr/4is68yt
R5,R6 | 2 | 5.1k |  |  |  | Resistor_SMD:R_0603_1608Metric | https://mou.sr/48g2HWK
R7,R8,R9,R10 | 4 | 5k |  |  |  | Resistor_SMD:R_0603_1608Metric | https://mou.sr/4eYPfdw
R11 | 1 | 63.4k |  |  |  | Resistor_SMD:R_0603_1608Metric | https://mou.sr/48idtvz
R12 | 1 | 23.7k |  |  |  | Resistor_SMD:R_0603_1608Metric | https://mou.sr/4ijYBmx
R13 | 1 | 18.2k |  |  |  | Resistor_SMD:R_0603_1608Metric | https://mou.sr/4BrQcVz
R14 | 1 | 10.2k |  |  |  | Resistor_SMD:R_0603_1608Metric | https://mou.sr/3W9IuPG
R15 | 1 | 100k |  |  |  | Resistor_SMD:R_0603_1608Metric | https://mou.sr/4hhzJvp
R16 | 1 | 113k |  |  |  | Resistor_SMD:R_0603_1608Metric | https://mou.sr/4jFTFtb
R17 | 1 | 24.9k |  |  |  | Resistor_SMD:R_0603_1608Metric | https://mou.sr/4sBbA6M
R18 | 1 | 330 |  |  |  | Resistor_SMD:R_0603_1608Metric | https://mou.sr/4ioQROT
R19 | 1 | 100 |  |  |  | Resistor_SMD:R_0603_1608Metric | https://mou.sr/4iIFVg5
R22,R24 | 2 | 1k |  |  |  | Resistor_SMD:R_0402_1005Metric | https://mou.sr/4BOeOrv
R25 | 1 | 4.7k |  |  |  | Resistor_SMD:R_0402_1005Metric | https://mou.sr/4sIE2n3
R26 | 1 | 680 |  |  |  | Resistor_SMD:R_0402_1005Metric | https://mou.sr/4BQBzv3
SW1,SW2 | 2 | SW_Push |  |  |  | Button_Switch_SMD:SW_SPST_CK_KXT3 | https://mou.sr/4evRTHy
SW3 | 1 | RotaryEncoder_Bourns_PEC11R-Switch_Vertical |  |  |  | SDM_MISC:XDCR_PEC11R-4220F-S0024 | https://mou.sr/4sIDnlz
U2 | 1 | GD25Q32ESIG |  |  |  | Package_SO:SOIC-8_5.3x5.3mm_P1.27mm | https://mou.sr/4svlFC4 | https://www.gigadevice.com/datasheet/gd25q32e/
U3 | 1 | TPS2121RUXR |  |  |  | SDM_MISC:TPS2121RUXR | https://mou.sr/3WQ0TBc | https://www.ti.com/lit/gpn/TPS2121
U4 | 1 | TPS62901RPJR |  |  |  | SDM_MISC:TPS62901RPJR | https://www.unikeyic.com/products/dc-dc-controller/tps62901rpjr/23452895.html?sku=1003001045691650 | https://www.ti.com/lit/ds/symlink/tps62901.pdf?ts=1622532312813
U5 | 1 | TCAN3403DRBRQ1 |  |  |  | SDM_MISC:SON65P300X300X100-9N-D | https://www.bettlink.com/product/texasinstruments-tcan3403drbrq1-15871437 | https://www.ti.com/lit/ds/symlink/tcan3404-q1.pdf?ts=1775327036713
U6 | 1 | TLP175A_TPL,E |  |  |  | SDM_MISC:TLP266J | https://mou.sr/3WAxCdL | http://toshiba.semicon-storage.com/info/docget.jsp?did=13665&prodName=TLP175A
U7 | 1 | USBLC6-2SC6 |  |  |  | Package_TO_SOT_SMD:SOT-23-6 | https://mou.sr/3Ugb80Z | https://www.st.com/resource/en/datasheet/usblc6-2.pdf
Uee1 | 1 | ESP32-C5HR8 |  |  |  | SDM_MISC:QFN40P600X600X90-49N-D | https://mou.sr/4BvHp4W | https://documentation.espressif.com/esp32-c5_datasheet_en.pdf
Y3 | 1 | CX1612DB48000D0FPJC1 |  |  |  | SDM_MISC:CX1612DB48000D0FPJC1 | https://mou.sr/4sw7bC7 | https://www.mouser.de/datasheet/2/40/cx1612db_e-3180263.pdf
