sundevilmotorsports/pcb-dev/2027/SDM27_SteeringWheel/SDM27_PattleShifterV0/Pattel_Shifter_V0/Pattel_Shifter_V0.step

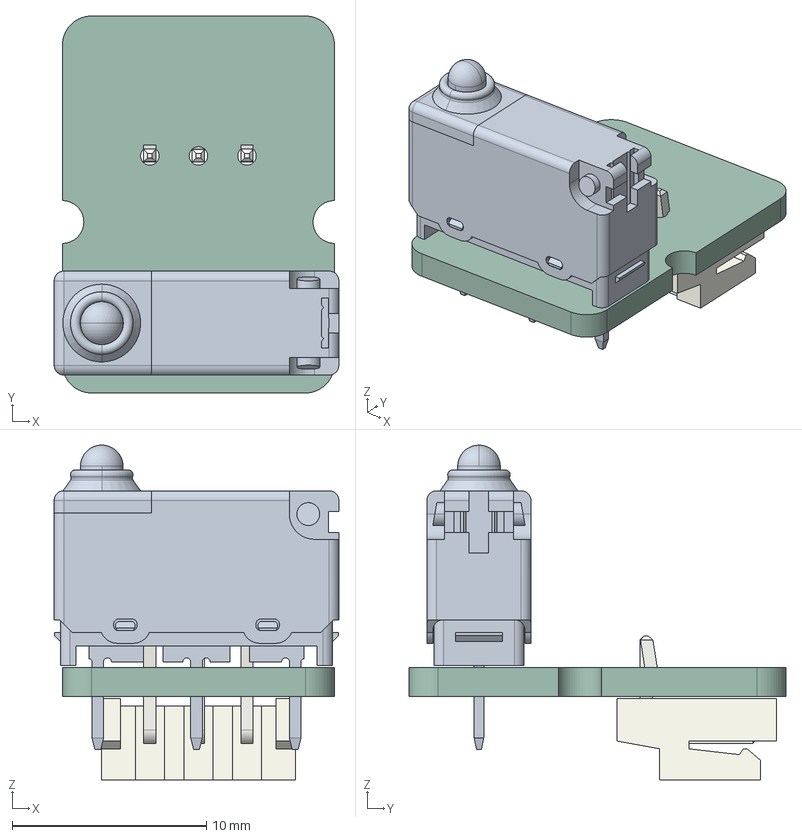
[picture p46: CAD file, 2026-11-06]
2027/SDM27_SteeringWheel/SDM27_PattleShifterV0/Pattel_Shifter_V0/Pattel_Shifter_V0.step
14.6 x 19.4 x 17.2 mm
7792N11_Ultra-Miniature Snap-Acting Switch
JST_S3B_EH
Pattel_Shifter_V0_PCB
