sundevilmotorsports/pcb-dev/2027/SDM27_WheelBoard/SDM27_WheelBoard_v1.0/27wheel board.stl

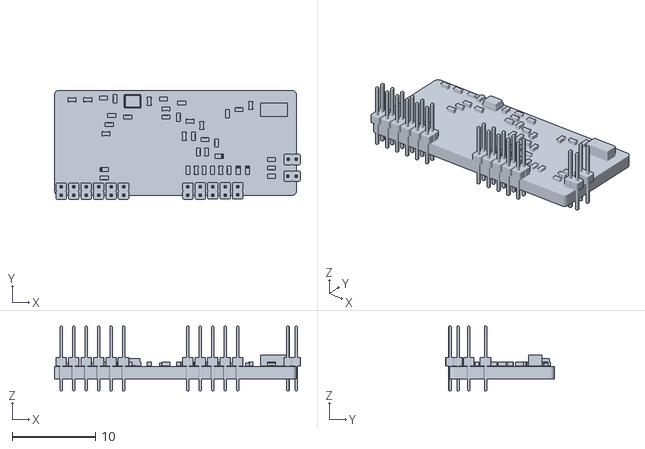
[picture p47: CAD file, 2026-05-21]
2027/SDM27_WheelBoard/SDM27_WheelBoard_v1.0/27wheel board.stl
29.6 x 13.1 x 7.80
