sundevilmotorsports/pcb-dev/MiscLibraries/SDM_Misc3D/KGD_Models/MC74HC1G32DBVT1G.step

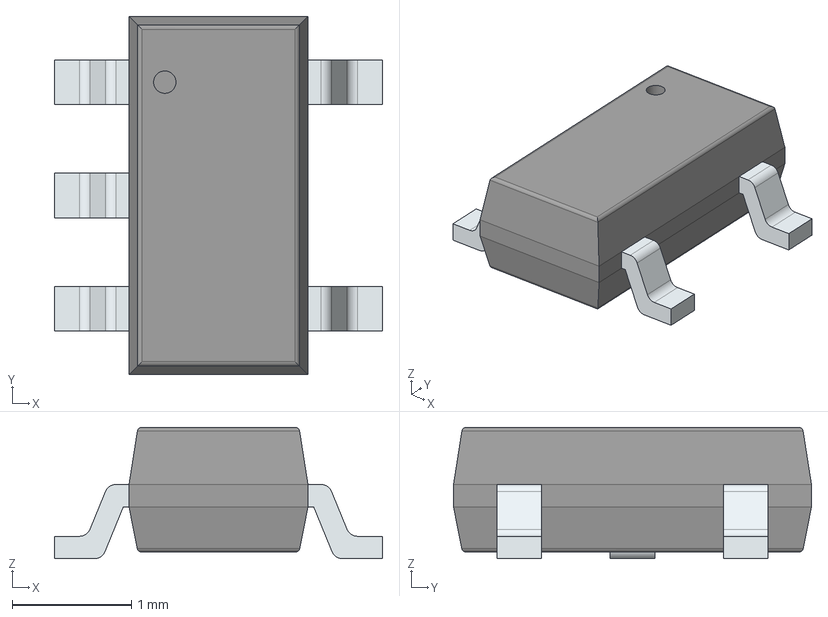
[picture p48: CAD file, 2026-11-06]
MiscLibraries/SDM_Misc3D/KGD_Models/MC74HC1G32DBVT1G.step
2.75 x 3.00 x 1.10 mm
PinsArrayL
PinsArrayR
