sundevilmotorsports/pcb-dev/MiscLibraries/SDM_Misc3D/TC1108-3.0VDBTR.stp

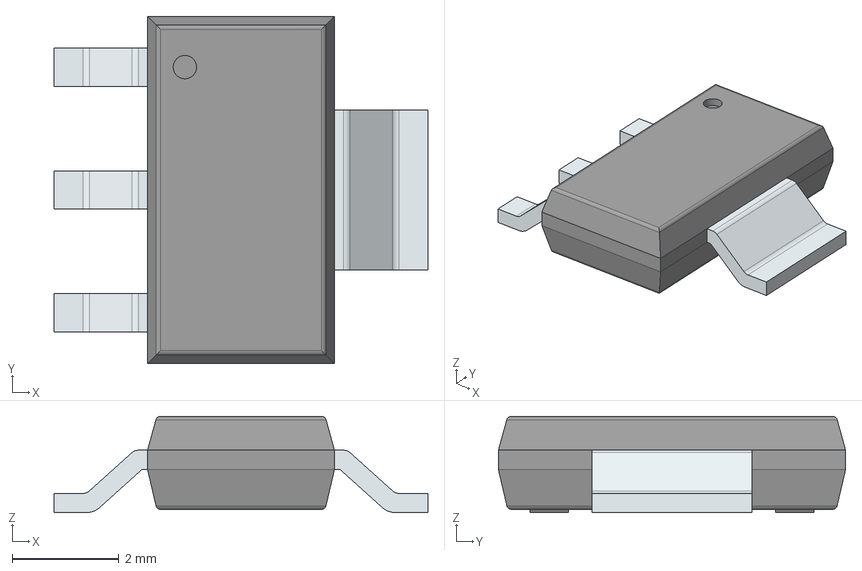
[picture p49: CAD file, 2026-10-08]
MiscLibraries/SDM_Misc3D/TC1108-3.0VDBTR.stp
7.00 x 6.50 x 1.80 mm
PinsArrayL
FilletPinR
