sundevilmotorsports/pcb-dev/PRE2026/BSPD/3362U-1-104ALF/3362U-1-104ALF.stp

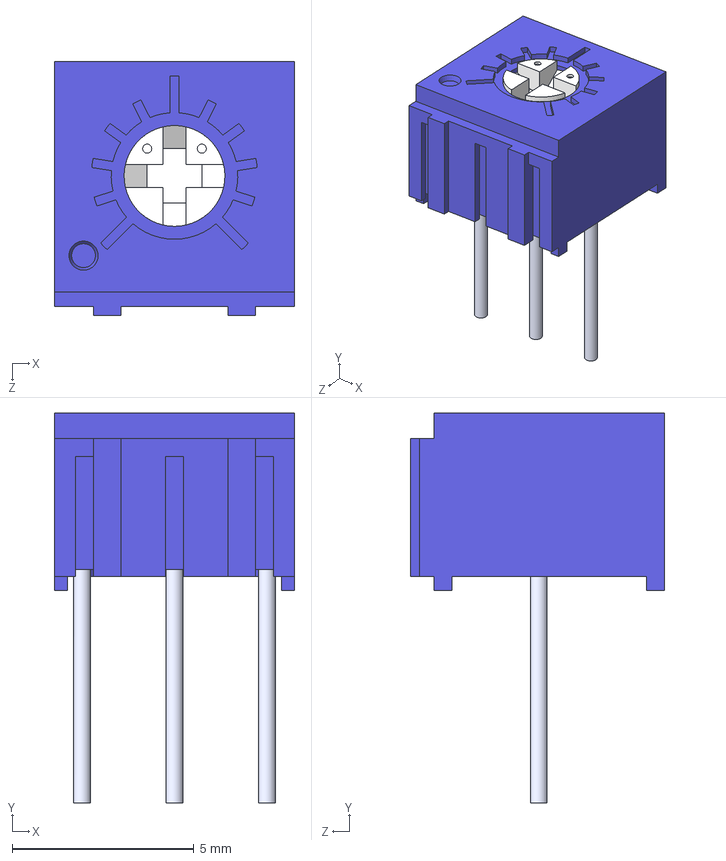
[picture p50: CAD file, 2025-03-17]
PRE2026/BSPD/3362U-1-104ALF/3362U-1-104ALF.stp
6.60 x 10.7 x 6.99 mm
