sundevilmotorsports/pcb-dev/PRE2026/BSPD/CD4001BM96E4/CD4001BM96E4.stp

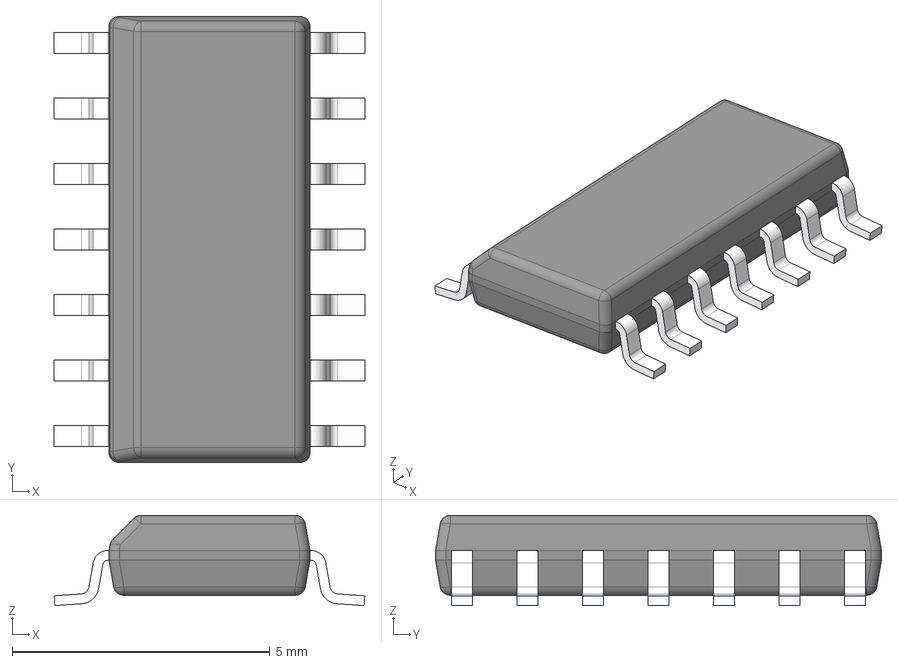
[picture p51: CAD file, 2025-03-17]
PRE2026/BSPD/CD4001BM96E4/CD4001BM96E4.stp
6.03 x 8.65 x 1.75 mm
BODY-SO
LEAD-SO x 14
PIN1-ID
