sundevilmotorsports/pcb-dev/PRE2026/BSPD/DT13_08PA/DT13-08PA.step

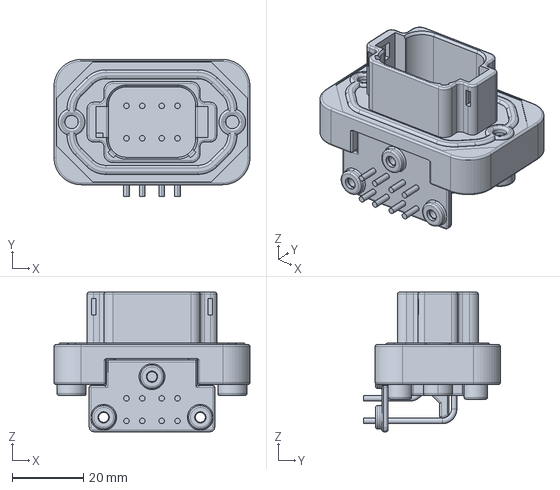
[picture p52: CAD file, 2025-03-18]
PRE2026/BSPD/DT13_08PA/DT13-08PA.step
55.1 x 38.6 x 39.2 mm
