sundevilmotorsports/pcb-dev/PRE2026/BSPD/IMB03IGR/IMB03IGR.stp

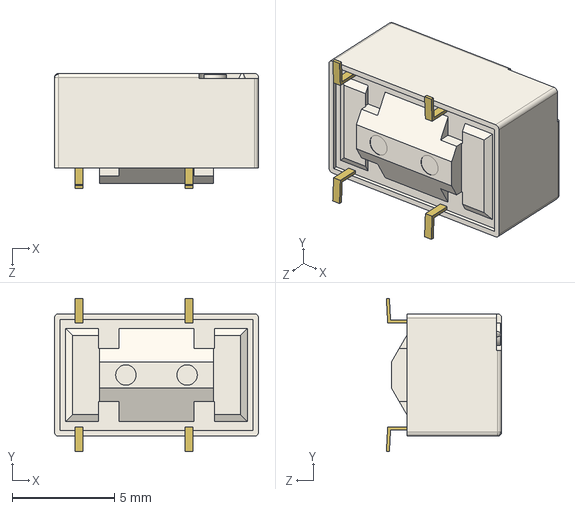
[picture p53: CAD file, 2025-04-12]
PRE2026/BSPD/IMB03IGR/IMB03IGR.stp
10.0 x 7.52 x 5.65 mm
