sundevilmotorsports/pcb-dev/PRE2026/BSPD/L7805ACD2T-TR/L7805ACD2T-TR.stp

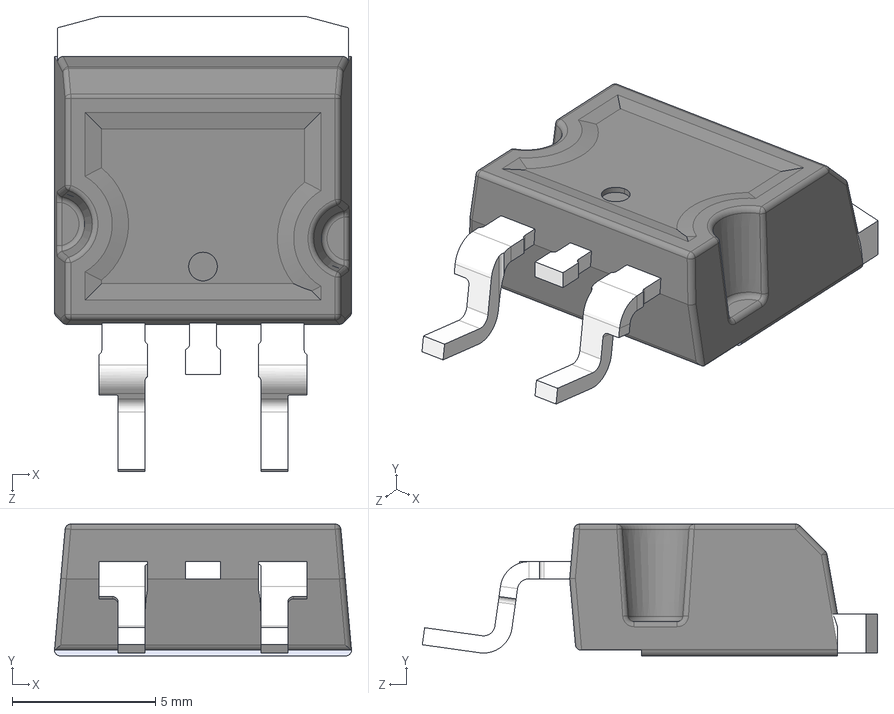
[picture p54: CAD file, 2025-03-17]
PRE2026/BSPD/L7805ACD2T-TR/L7805ACD2T-TR.stp
10.4 x 4.60 x 15.9 mm
