sundevilmotorsports/pcb-dev/PRE2026/BSPD/L78M10ABDT-TR/L78M10ABDT-TR.stp

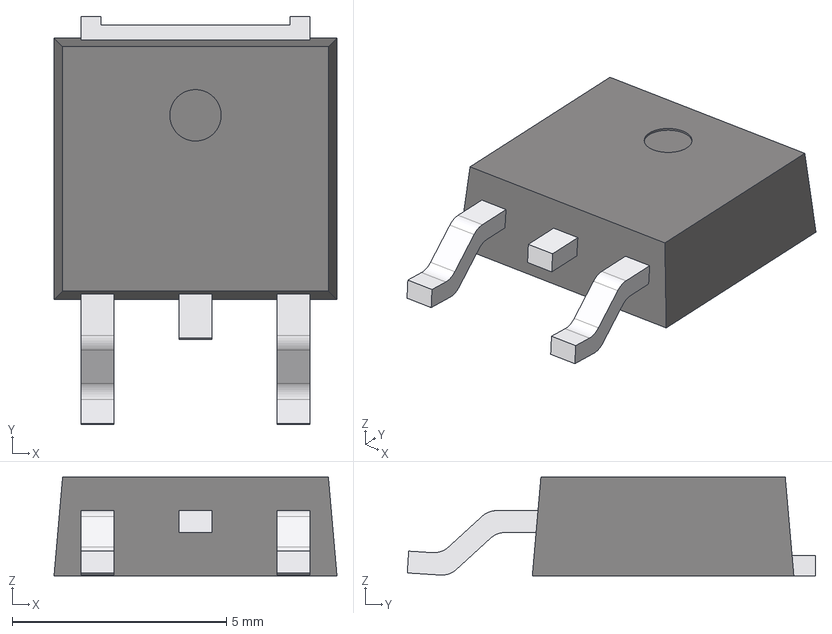
[picture p55: CAD file, 2025-03-17]
PRE2026/BSPD/L78M10ABDT-TR/L78M10ABDT-TR.stp
6.60 x 9.53 x 2.30 mm
