sundevilmotorsports/pcb-dev/PRE2026/BSPD/LM324MTX_NOPB/LM324MTX_NOPB.stp

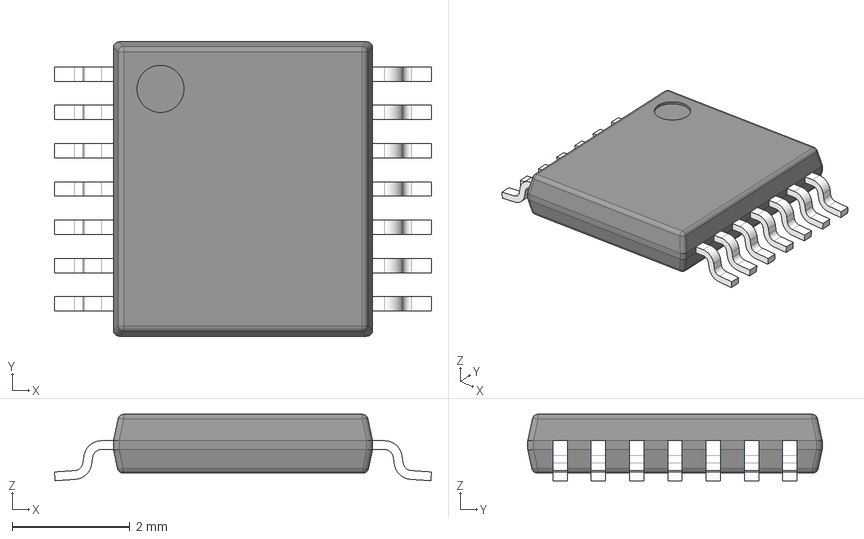
[picture p56: CAD file, 2025-03-17]
PRE2026/BSPD/LM324MTX_NOPB/LM324MTX_NOPB.stp
6.40 x 5.00 x 1.13 mm
BODY-TSSOP
LEAD-TSSOP x 14
PIN1
