sundevilmotorsports/pcb-dev/PRE2026/BSPD/LM358AST/LM358AST.stp

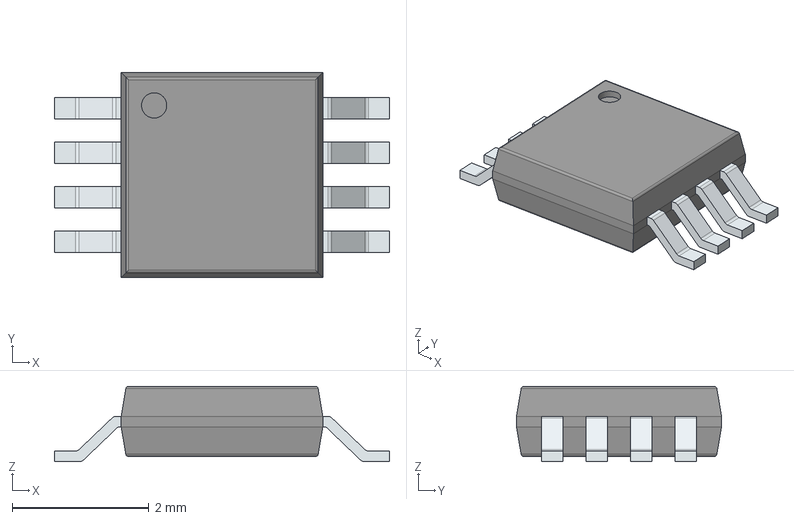
[picture p57: CAD file, 2025-03-17]
PRE2026/BSPD/LM358AST/LM358AST.stp
4.90 x 3.00 x 1.10 mm
PinsArrayLR
