sundevilmotorsports/pcb-dev/PRE2026/BSPD/PV37W502C01B00/PV37W502C01B00.stp

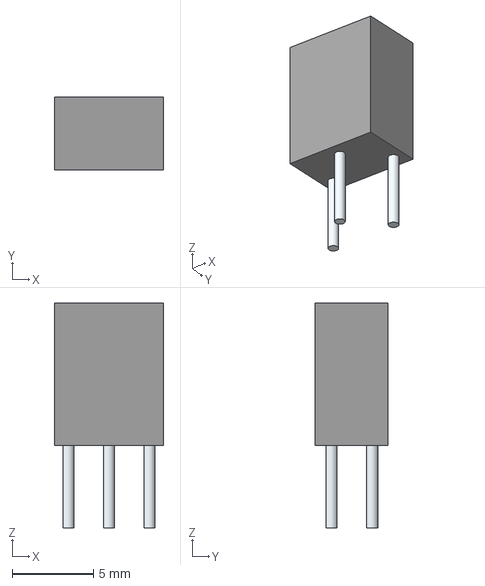
[picture p58: CAD file, 2025-04-12]
PRE2026/BSPD/PV37W502C01B00/PV37W502C01B00.stp
6.71 x 4.50 x 13.9 mm
Leads
