sundevilmotorsports/pcb-dev/PRE2026/BSPD/SN74HC32NSR/SN74HC32NSR.stp

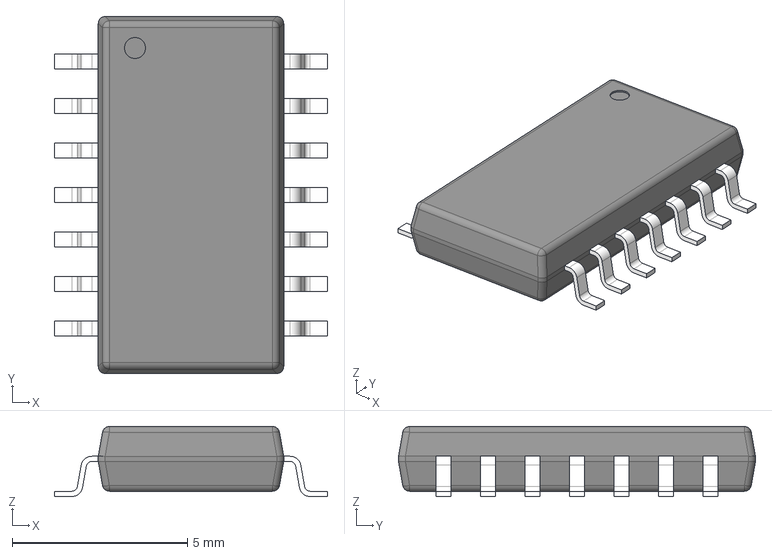
[picture p59: CAD file, 2025-03-17]
PRE2026/BSPD/SN74HC32NSR/SN74HC32NSR.stp
7.80 x 10.2 x 2.00 mm
BODY-SO
LEAD-SO x 14
