sundevilmotorsports/pcb-dev/PRE2026/IMUBox/ISM330DHCX (1)/ISM330DHCX.step

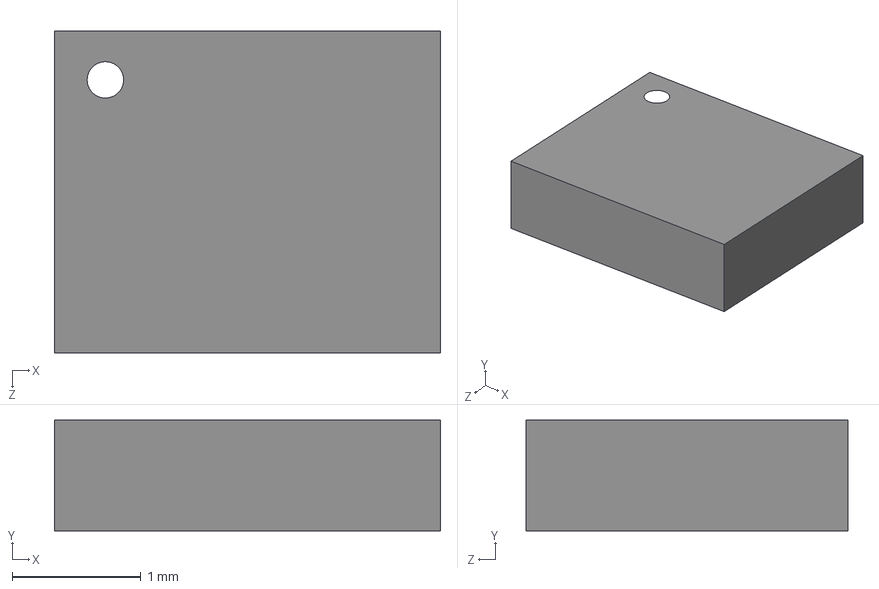
[picture p60: CAD file, 2025-10-08]
PRE2026/IMUBox/ISM330DHCX (1)/ISM330DHCX.step
3.00 x 0.86 x 2.50 mm
