sundevilmotorsports/pcb-dev/PRE2026/lapbeacon/models/c-282834-2-c-3d.stp

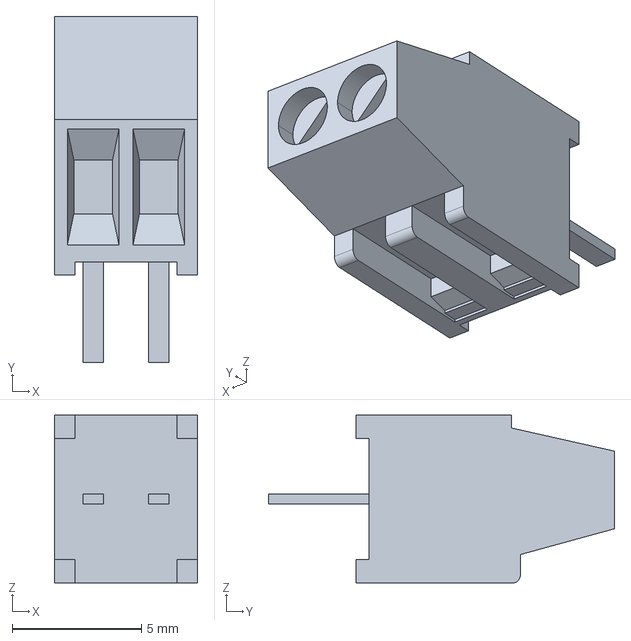
[picture p61: CAD file, 2024-01-14]
PRE2026/lapbeacon/models/c-282834-2-c-3d.stp
5.54 x 13.4 x 6.50 mm
