sundevilmotorsports/pcb-dev/PRE2026/loadcelladapter/c-1734598-4-r-3d.stp

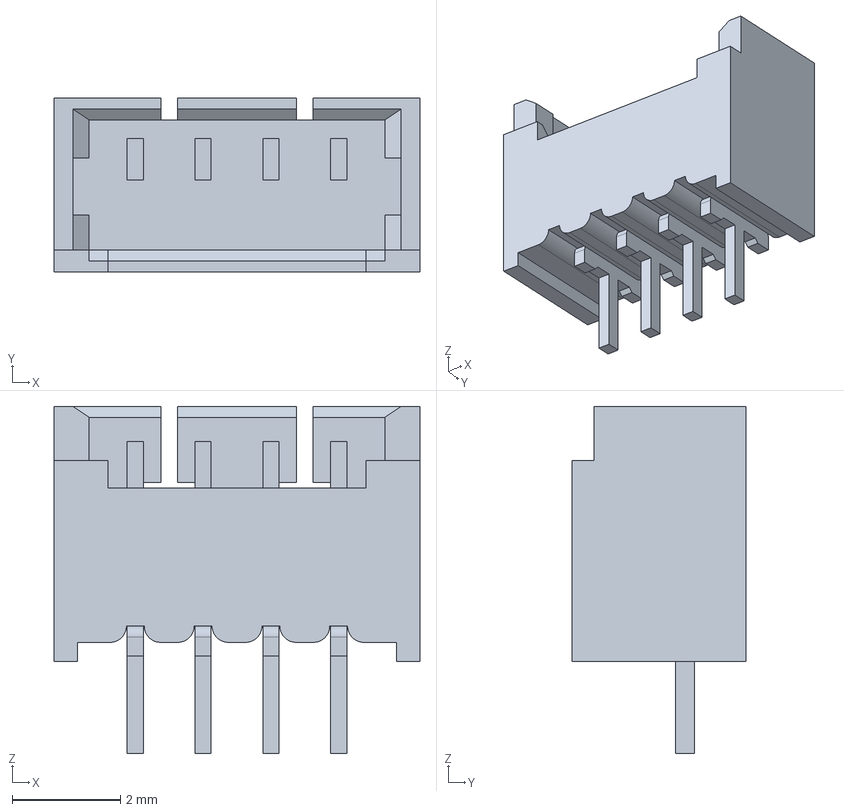
[picture p62: CAD file, 2025-10-08]
PRE2026/loadcelladapter/c-1734598-4-r-3d.stp
6.75 x 3.20 x 6.40 mm
