sundevilmotorsports/pcb-dev/PRE2026/mpcm/JST - XH - Thru - 2Pin - 2.5mm (Genuine).stp

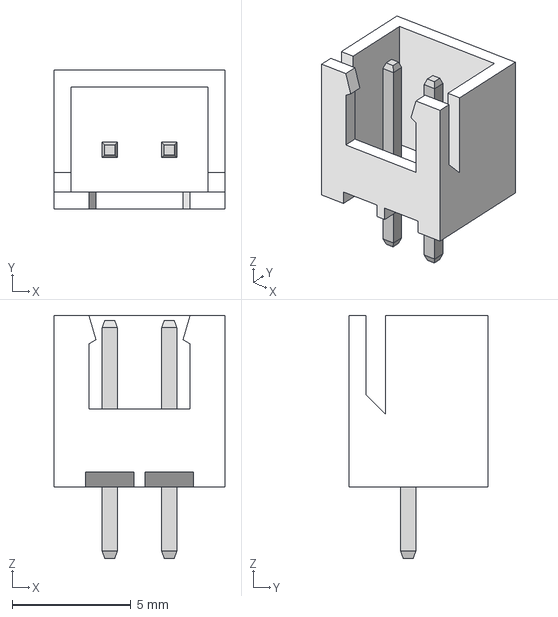
[picture p63: CAD file, 2023-11-30]
PRE2026/mpcm/JST - XH - Thru - 2Pin - 2.5mm (Genuine).stp
7.17 x 5.84 x 10.2 mm
