sundevilmotorsports/pcb-dev/PRE2026/sdm24logger/models/ssf-lxh100lid.STEP

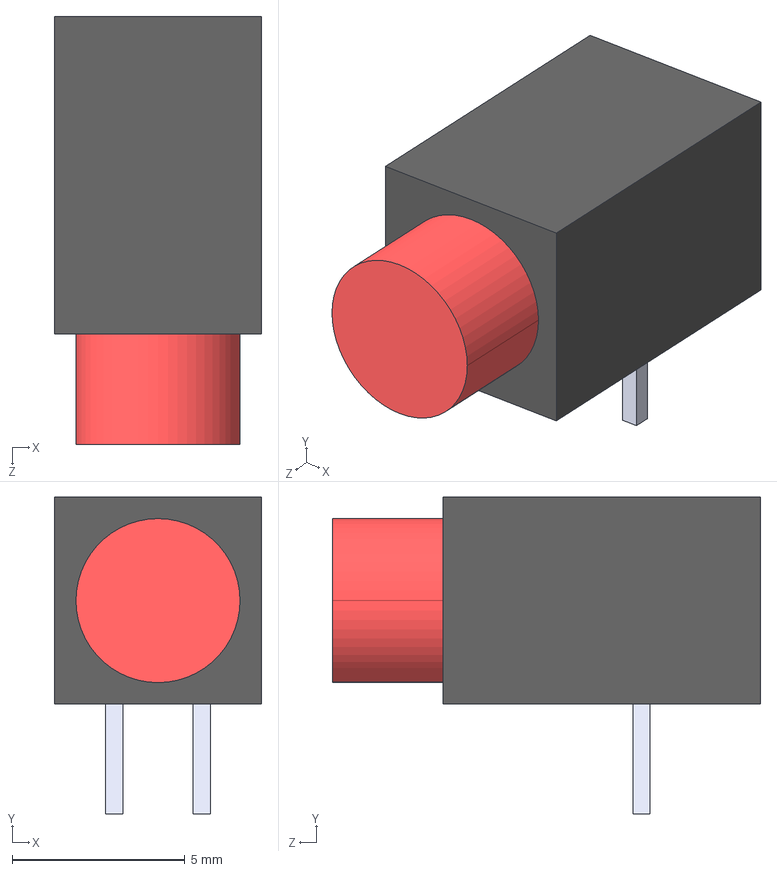
[picture p64: CAD file, 2023-11-08]
PRE2026/sdm24logger/models/ssf-lxh100lid.STEP
6.00 x 9.18 x 12.4 mm
