sundevilmotorsports/pcb-dev/PRE2026/SDM25_IMU_STM32/SDM25_IMU_3D/ISM330DHCXTR_3D.step

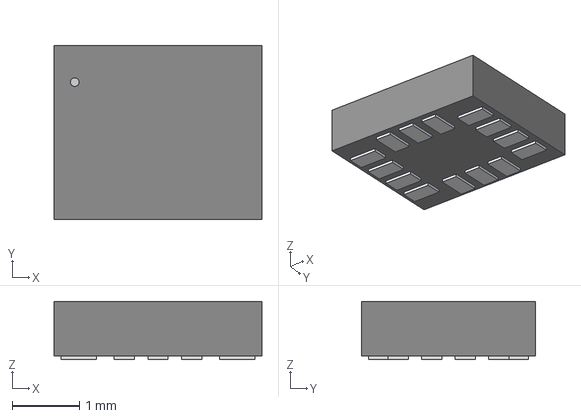
[picture p65: CAD file, 2025-01-25]
PRE2026/SDM25_IMU_STM32/SDM25_IMU_3D/ISM330DHCXTR_3D.step
3.10 x 2.59 x 0.866 mm
