sundevilmotorsports/pcb-dev/PRE2026/sdm25wheel/models/ECS-120-10-36Q-AES-TR.STEP

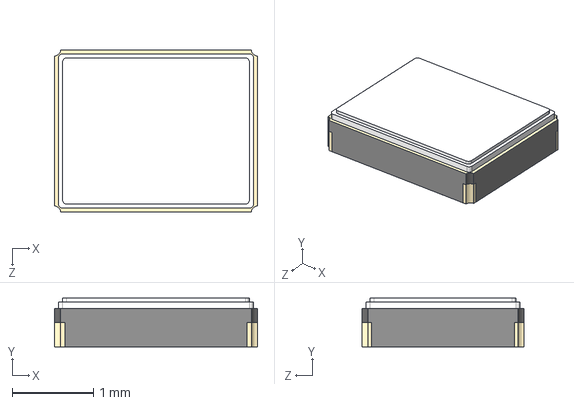
[picture p66: CAD file, 2024-01-21]
PRE2026/sdm25wheel/models/ECS-120-10-36Q-AES-TR.STEP
2.50 x 0.6 x 2.00 mm
