sundevilmotorsports/pcb-dev/PRE2026/sdm25wheel/sdm25mlxboard/sdm25mlxboard.step

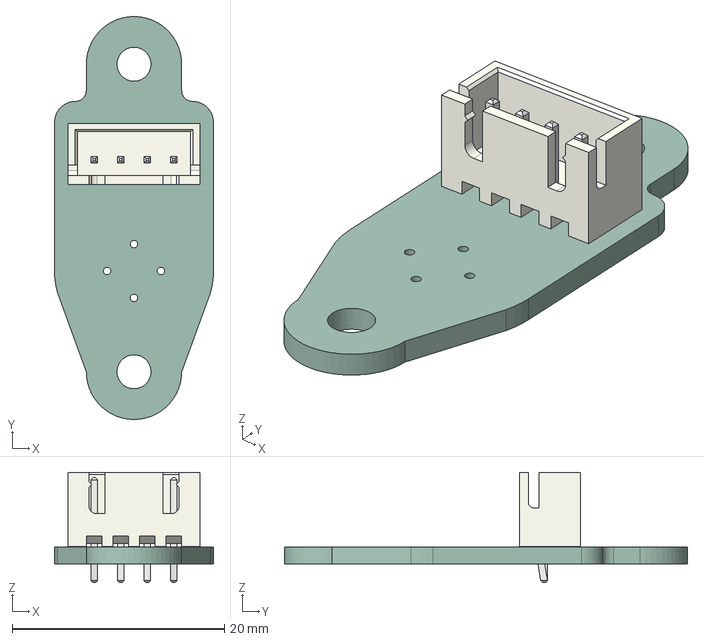
[picture p67: CAD file, 2025-01-25]
PRE2026/sdm25wheel/sdm25mlxboard/sdm25mlxboard.step
15.0 x 38.0 x 10.4 mm
JST_B4B_XH_A
sdm25mlxboard_PCB
