sundevilmotorsports/pcb-dev/PRE2026/telemetry/models/JST - XH - Thru - 4Pin - 2.5mm (Genuine).stp

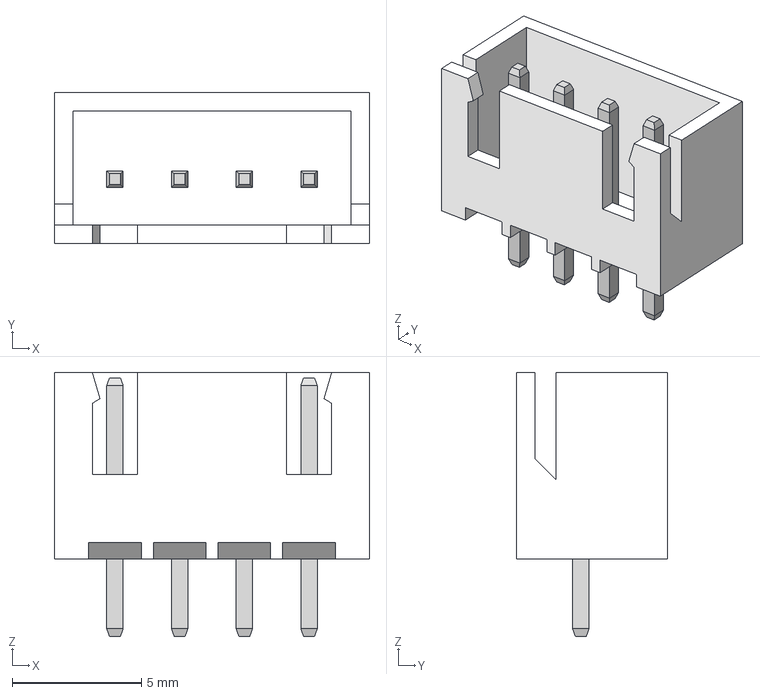
[picture p68: CAD file, 2023-09-04]
PRE2026/telemetry/models/JST - XH - Thru - 4Pin - 2.5mm (Genuine).stp
12.2 x 5.84 x 10.2 mm
