sundevilmotorsports/pcb-dev/PRE2026/TimingGates/timingGatesSTM32/timingGatesSTM32V1/timingGatesSTM32V1.step

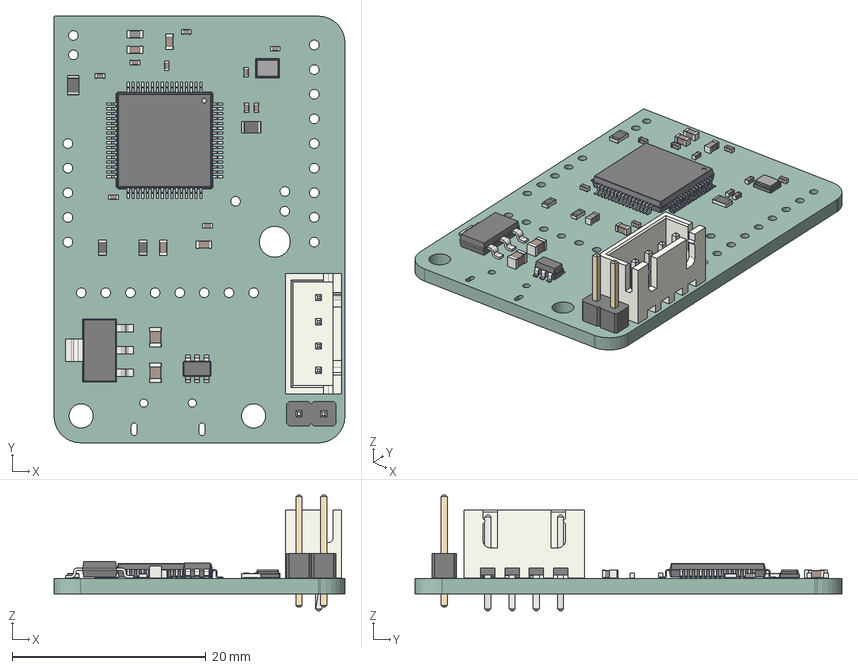
[picture p69: CAD file, 2025-02-26]
PRE2026/TimingGates/timingGatesSTM32/timingGatesSTM32V1/timingGatesSTM32V1.step
30.0 x 44.0 x 11.9 mm
L_0603_1608Metric
C_0402_1005Metric x 10
PinHeader_1x02_P254mm_Vertical
SOT_223
R_0603_1608Metric x 2
R_0805_2012Metric x 2
C_0603_1608Metric x 4
JST_B4B_XH_A
LQFP_64_10x10mm_P05mm
C_0805_2012Metric x 2
Crystal_SMD_2520-4Pin_2.5x2.0mm
SOT_23_6
timingGatesSTM32V1_PCB
