sundevilmotorsports/pcb-dev/MiscLibraries/SDM_Misc3D/CX1612DB48000D0FPJC1.stp

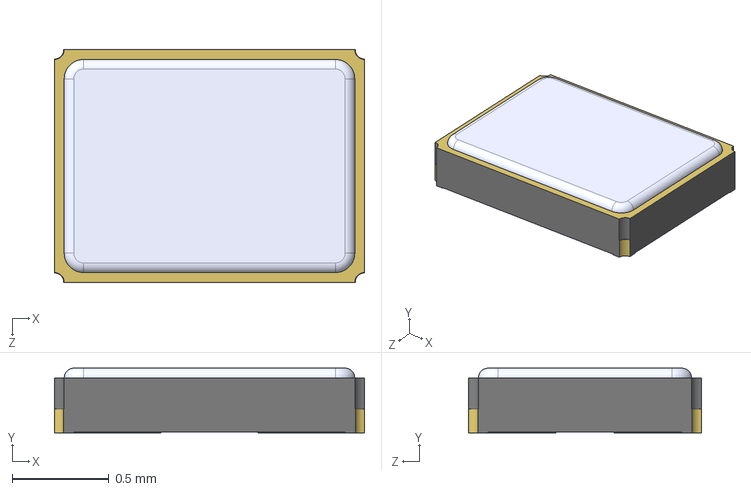
[picture p70: CAD file, 2026-09-10]
MiscLibraries/SDM_Misc3D/CX1612DB48000D0FPJC1.stp
1.60 x 0.334 x 1.20 mm
