sundevilmotorsports/pcb-dev/MiscLibraries/SDM_Misc3D/KGD_Models/74HC4060BQ,115.step

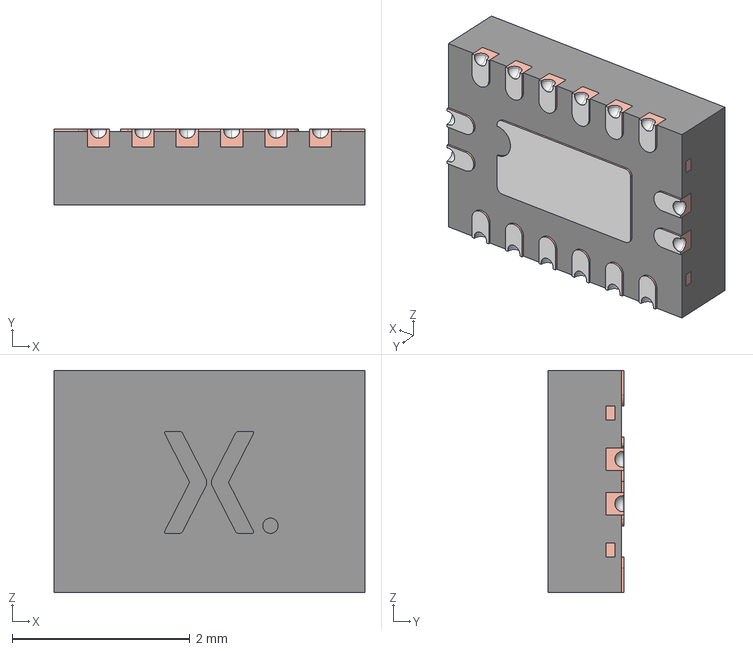
[picture p71: CAD file, 2026-11-06]
MiscLibraries/SDM_Misc3D/KGD_Models/74HC4060BQ,115.step
3.50 x 0.85 x 2.50 mm
SOT763-1 LF
SOT763-1 Mold Body
