sundevilmotorsports/pcb-dev/PRE2026/lapbeacon/models/c-2454985-3-a-3d.stp

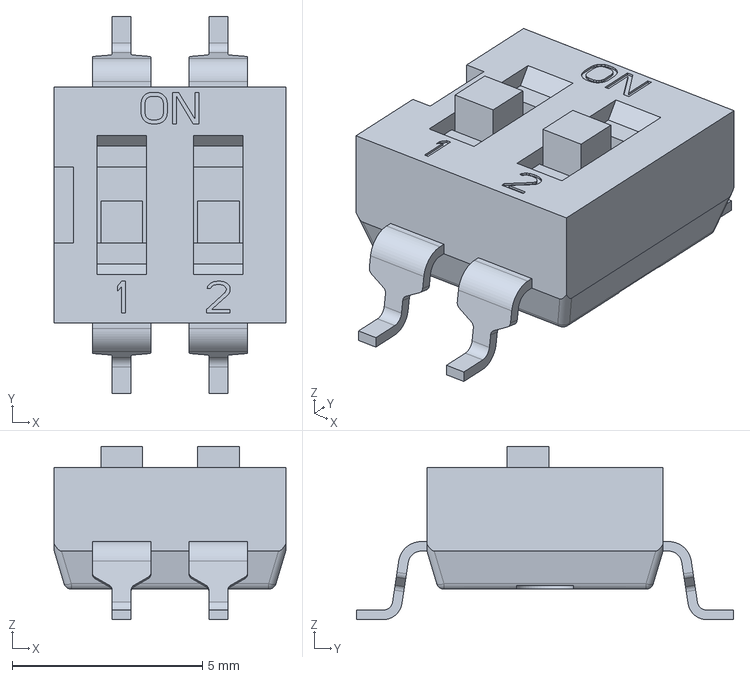
[picture p72: CAD file, 2024-01-14]
PRE2026/lapbeacon/models/c-2454985-3-a-3d.stp
6.08 x 9.90 x 4.55 mm
