sundevilmotorsports/pcb-dev/PRE2026/loadcelladapter/c-1734261-4-a-3d.stp

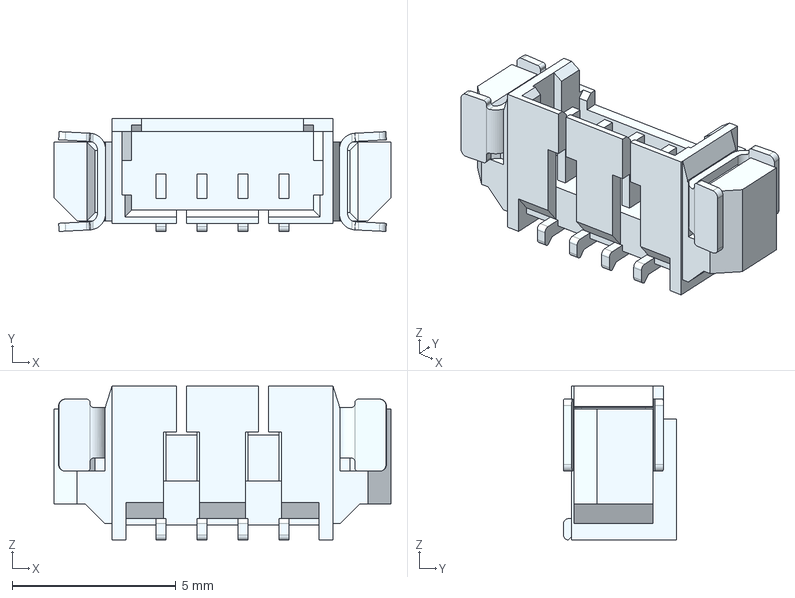
[picture p73: CAD file, 2025-10-08]
PRE2026/loadcelladapter/c-1734261-4-a-3d.stp
10.3 x 3.45 x 4.70 mm
