sundevilmotorsports/pcb-dev/PRE2026/loggerpanel/loggerpanel.step

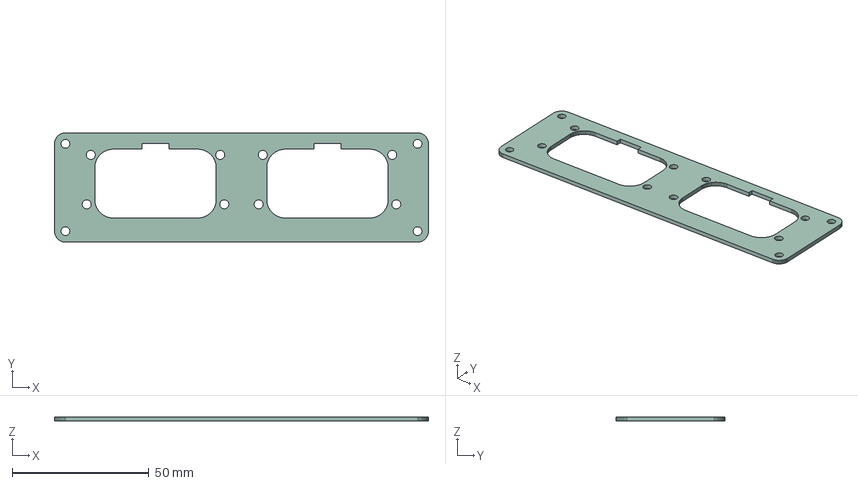
[picture p74: CAD file, 2024-02-01]
PRE2026/loggerpanel/loggerpanel.step
137.0 x 40.0 x 1.58 mm
