sundevilmotorsports/pcb-dev/PRE2026/ONVEHICLE/SOD-123FL.STEP

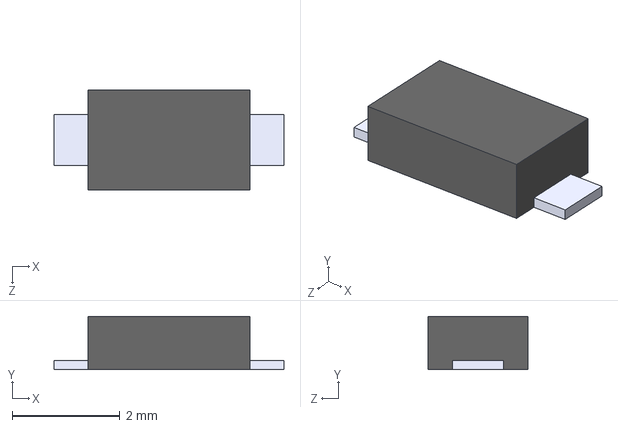
[picture p75: CAD file, 2023-07-04]
PRE2026/ONVEHICLE/SOD-123FL.STEP
4.26 x 0.99 x 1.85 mm
