sundevilmotorsports/pcb-dev/PRE2026/SDM25_IMU_STM32/SDM25_IMU_3D/24LC02BT_ELT_3D.step

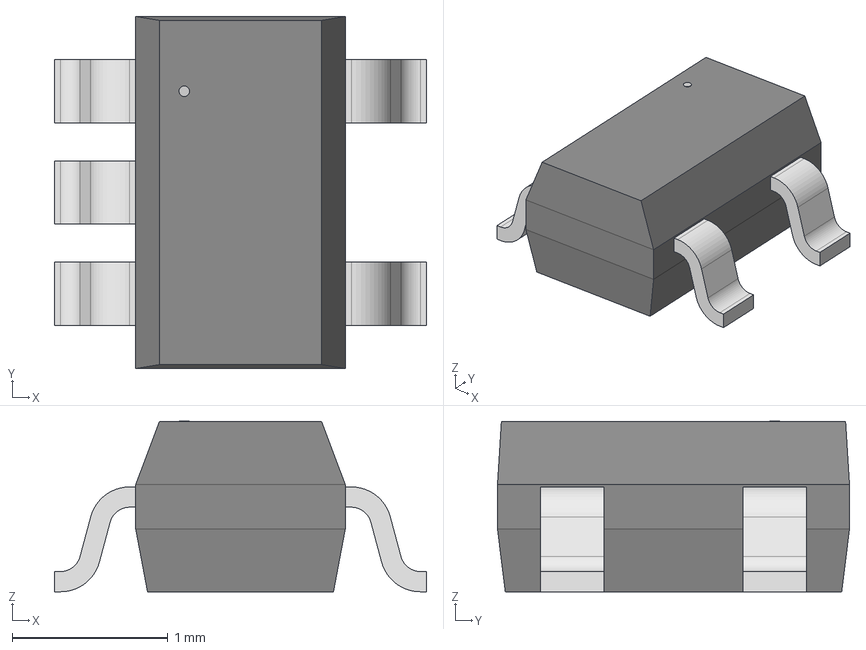
[picture p76: CAD file, 2025-01-25]
PRE2026/SDM25_IMU_STM32/SDM25_IMU_3D/24LC02BT_ELT_3D.step
2.39 x 2.26 x 1.09 mm
