sundevilmotorsports/pcb-dev/PRE2026/sdm25wheel/models/sc705_model.STEP

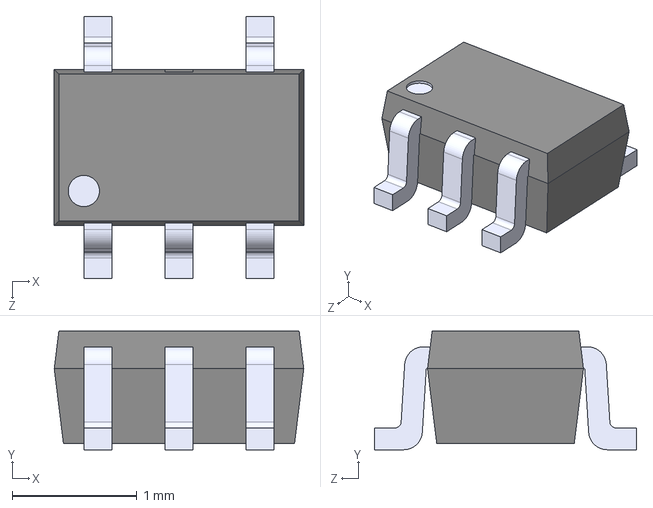
[picture p77: CAD file, 2024-01-21]
PRE2026/sdm25wheel/models/sc705_model.STEP
2.00 x 0.95 x 2.10 mm
sc705_pin x 5
SC705_0M65_2MX1M25X0M9
