sundevilmotorsports/pcb-dev/MiscLibraries/SDM_Misc3D/KGD_Models/74LVC2G02RA3-7.step

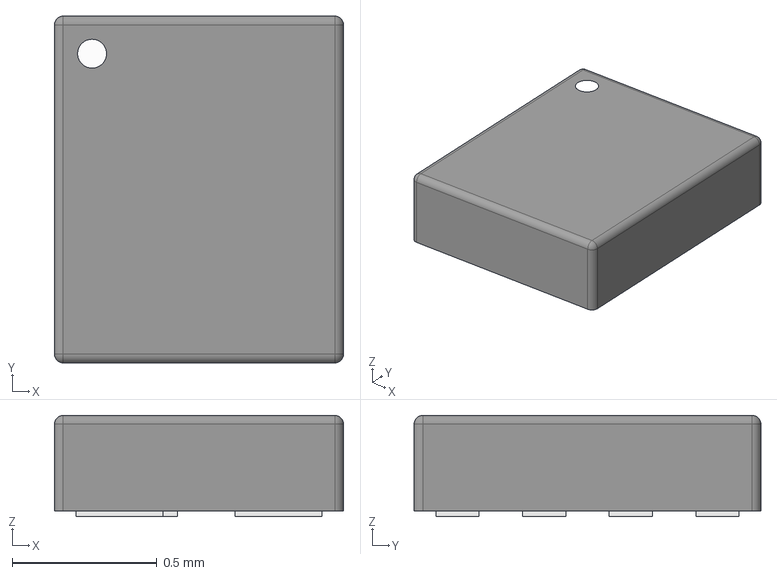
[picture p78: CAD file, 2026-11-06]
MiscLibraries/SDM_Misc3D/KGD_Models/74LVC2G02RA3-7.step
1.00 x 1.20 x 0.35 mm
