sundevilmotorsports/pcb-dev/PRE2026/loggerpanel/loggerpanel-Edge_Cuts.dxf

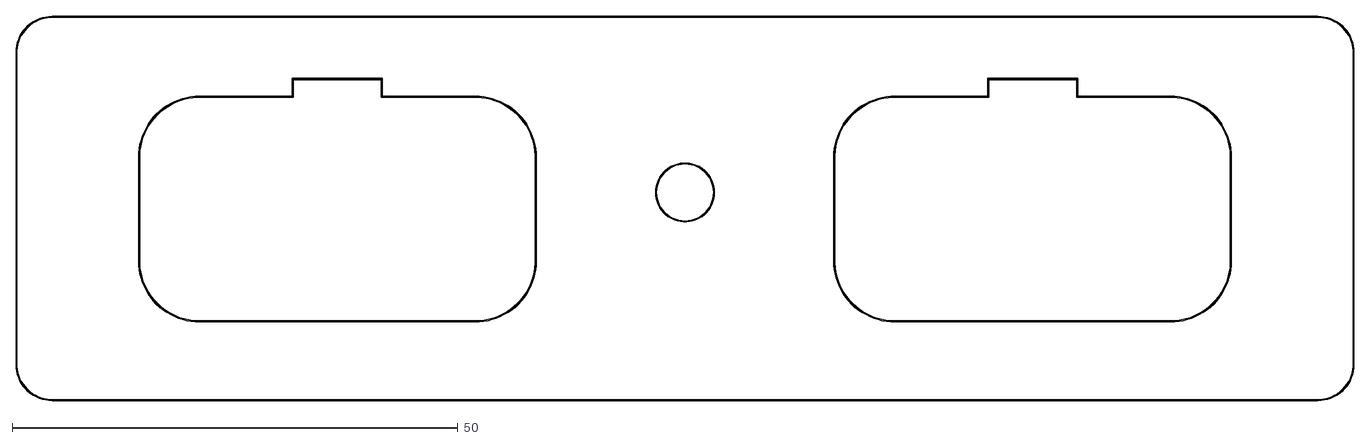
[picture p79: CAD file, 2024-01-22]
PRE2026/loggerpanel/loggerpanel-Edge_Cuts.dxf
150.1 x 43.1
