sundevilmotorsports/pcb-dev/PRE2026/mpcm/JST - XH - Thru - 3Pin - 2.5mm (Genuine).stp

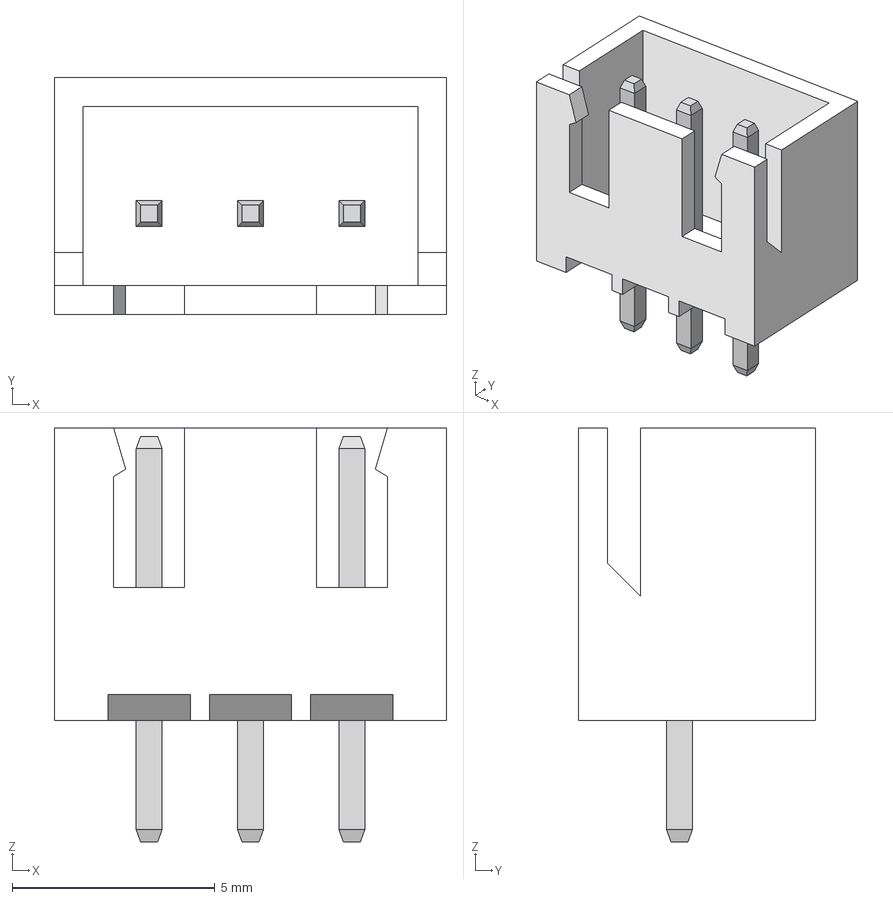
[picture p80: CAD file, 2023-09-04]
PRE2026/mpcm/JST - XH - Thru - 3Pin - 2.5mm (Genuine).stp
9.67 x 5.84 x 10.2 mm
