sundevilmotorsports/pcb-dev/PRE2026/sdm24logger/models/DCT0008A.stp

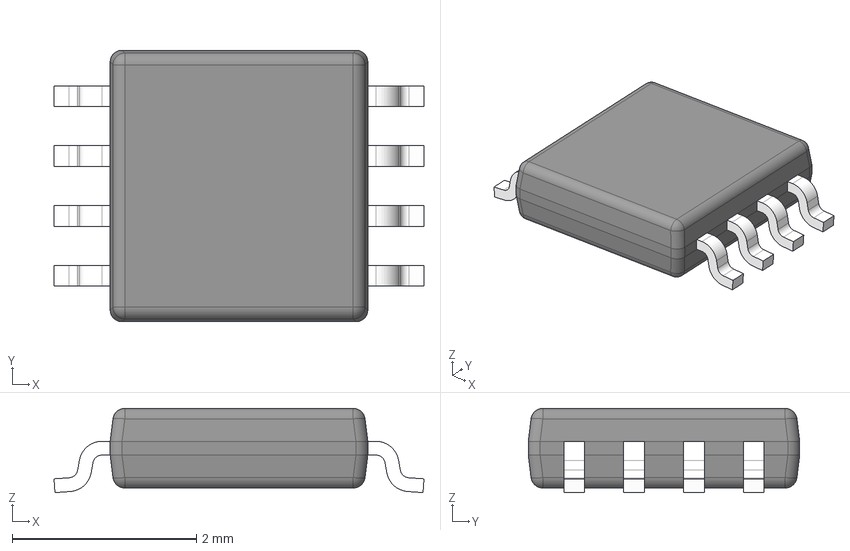
[picture p81: CAD file, 2023-10-21]
PRE2026/sdm24logger/models/DCT0008A.stp
4.02 x 2.95 x 0.915 mm
BODY-SO
LEAD-SO x 8
PIN1-ID
