sundevilmotorsports/pcb-dev/PRE2026/SDM25_IMU_STM32/SDM25_IMU_3D/Micro_USB_Type_B_3D.stp

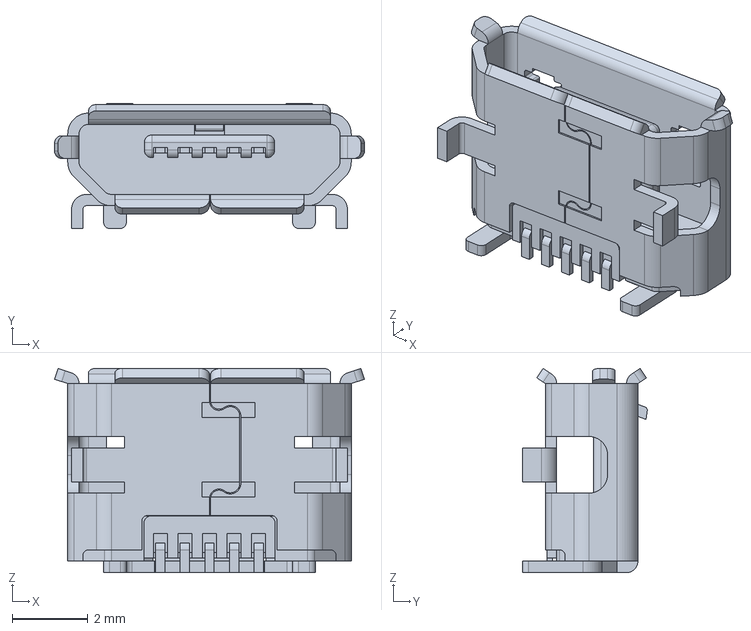
[picture p82: CAD file, 2023-07-09]
PRE2026/SDM25_IMU_STM32/SDM25_IMU_3D/Micro_USB_Type_B_3D.stp
8.20 x 3.30 x 5.40 mm
