sundevilmotorsports/pcb-dev/MiscLibraries/SDM_Misc3D/F1C1-201612-2R2M.stp

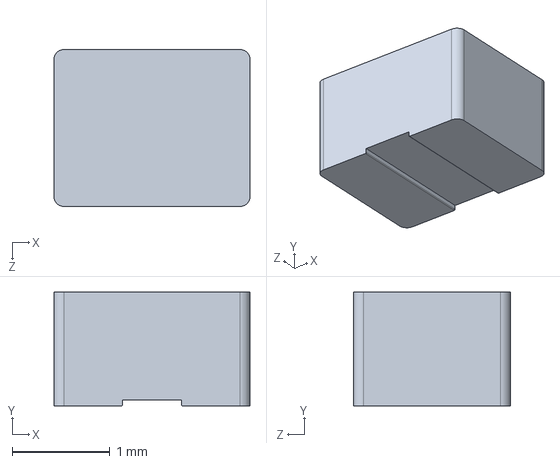
[picture p83: CAD file, 2026-09-03]
MiscLibraries/SDM_Misc3D/F1C1-201612-2R2M.stp
2.00 x 1.16 x 1.60 mm
