sundevilmotorsports/pcb-dev/MiscLibraries/SDM_Misc3D/KGD_Models/74LVC1G04GS,132.step

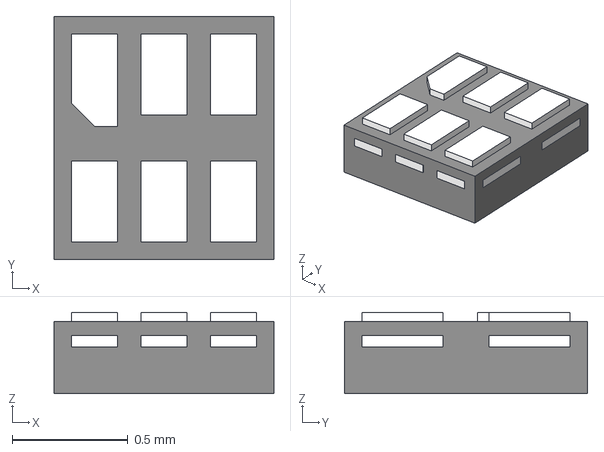
[picture p84: CAD file, 2026-11-06]
MiscLibraries/SDM_Misc3D/KGD_Models/74LVC1G04GS,132.step
0.95 x 1.05 x 0.35 mm
