sundevilmotorsports/pcb-dev/PRE2026/sdm24logger/models/TLX9291A.stp

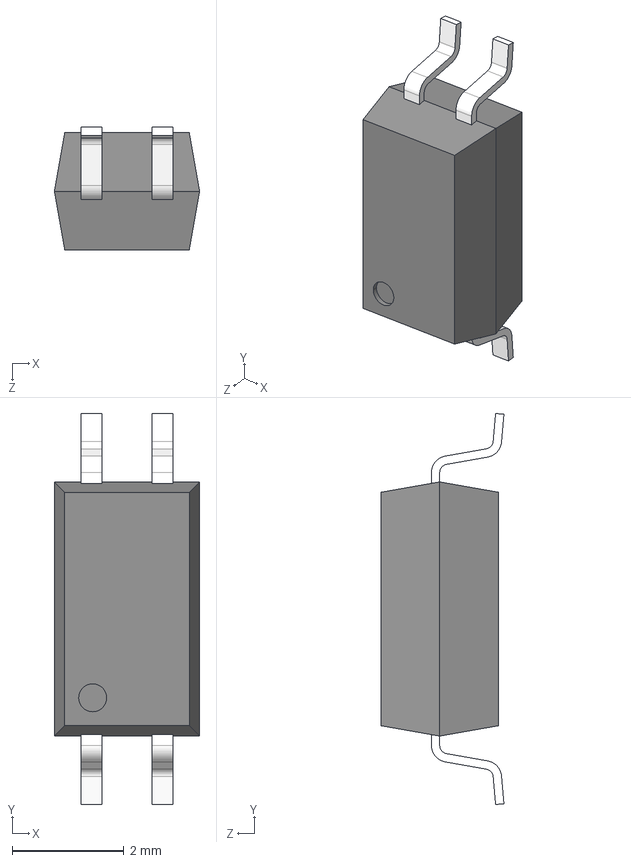
[picture p85: CAD file, 2023-10-20]
PRE2026/sdm24logger/models/TLX9291A.stp
2.60 x 7.00 x 2.20 mm
SO4_3
SO4_5
SO4
SO4_4
SO4_2
