sundevilmotorsports/pcb-dev/MiscLibraries/SDM_Misc3D/USB4730-GF-A_REVA.step

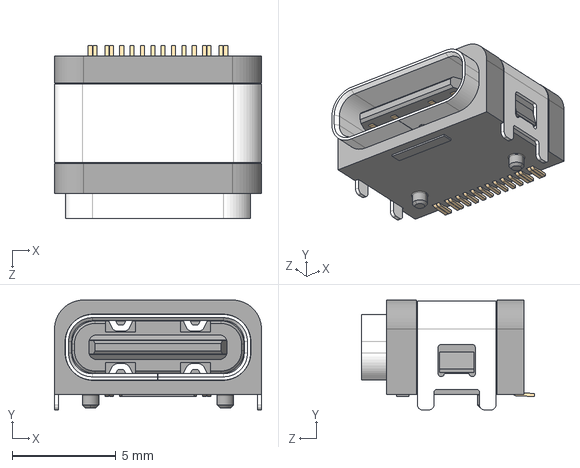
[picture p86: CAD file, 2026-09-02]
MiscLibraries/SDM_Misc3D/USB4730-GF-A_REVA.step
10.0 x 5.31 x 8.36 mm
