sundevilmotorsports/pcb-dev/PRE2026/loggerpanel/loggerpanel-h43-w162-r4.step

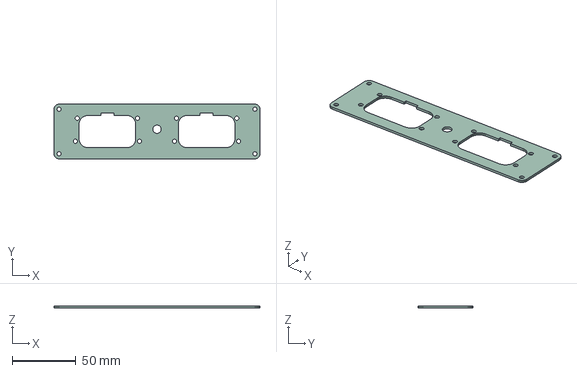
[picture p87: CAD file, 2024-01-14]
PRE2026/loggerpanel/loggerpanel-h43-w162-r4.step
162.0 x 43.0 x 1.58 mm
