sundevilmotorsports/pcb-dev/MiscLibraries/SDM_Misc3D/PUSB3FR6Z.stp

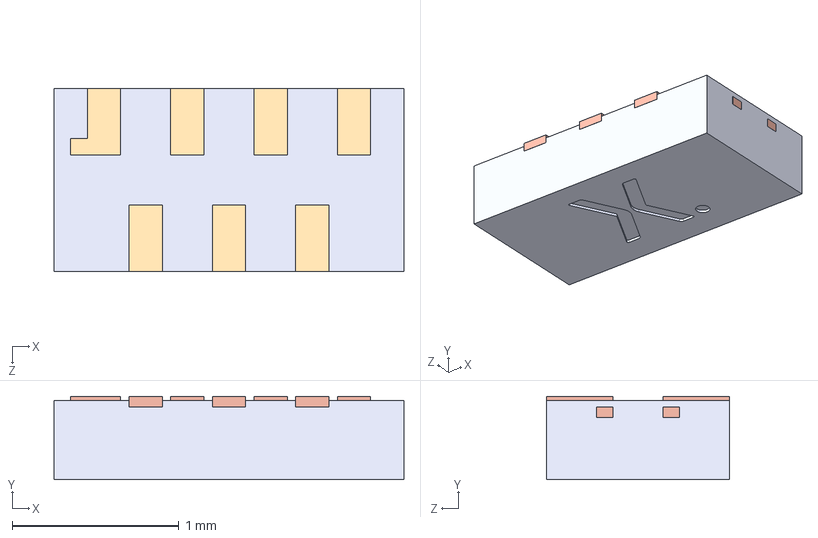
[picture p88: CAD file, 2026-08-12]
MiscLibraries/SDM_Misc3D/PUSB3FR6Z.stp
2.10 x 0.5 x 1.10 mm
SOT1358-1 LF
SOT1358-1 Mold body
