sundevilmotorsports/pcb-dev/PRE2026/loggerpanel/loggerpanel-h45-w164-r5.step

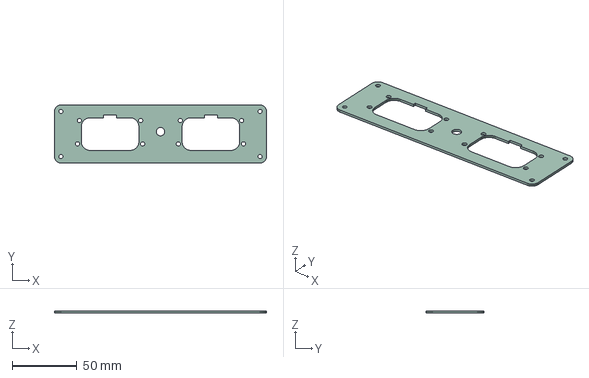
[picture p89: CAD file, 2023-12-19]
PRE2026/loggerpanel/loggerpanel-h45-w164-r5.step
164.0 x 45.0 x 1.58 mm
