sundevilmotorsports/pcb-dev/PRE2026/sdm24logger/models/NX2016SA_NDK.step

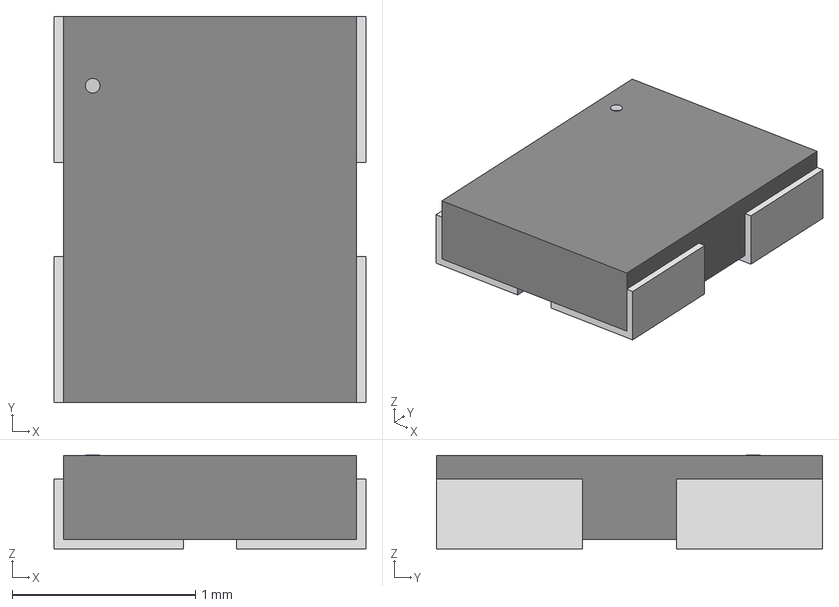
[picture p90: CAD file, 2023-10-14]
PRE2026/sdm24logger/models/NX2016SA_NDK.step
1.70 x 2.11 x 0.511 mm
