sundevilmotorsports/pcb-dev/MiscLibraries/SDM_Misc3D/MLZ2012N3R3LTD25.step

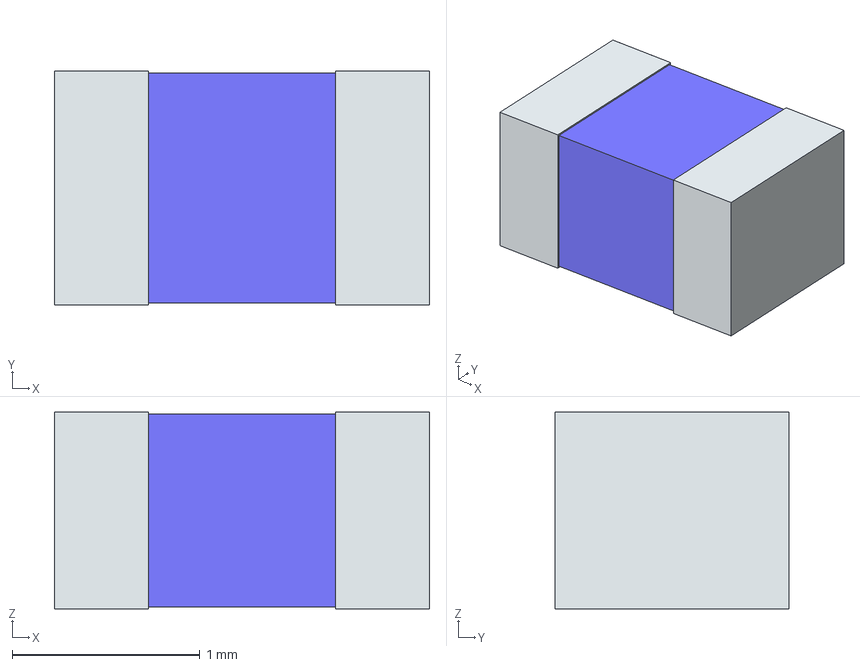
[picture p91: CAD file, 2026-08-01]
MiscLibraries/SDM_Misc3D/MLZ2012N3R3LTD25.step
2.00 x 1.25 x 1.05 mm
term1
term2
