sundevilmotorsports/pcb-dev/PRE2026/sdm24logger/models/3D_SRP7028CC SERIES.stp

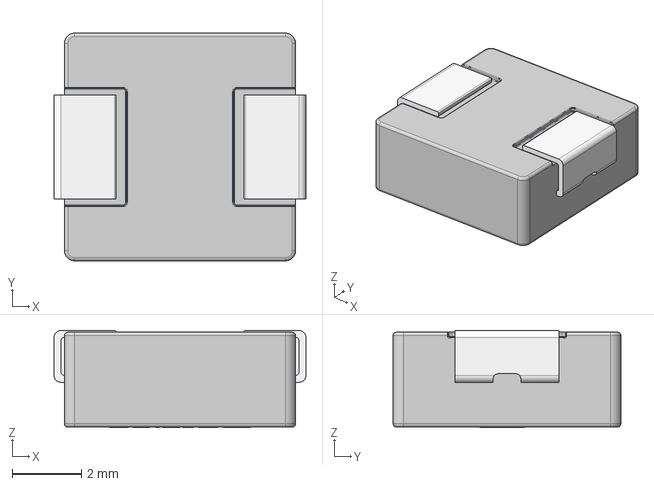
[picture p92: CAD file, 2023-10-13]
PRE2026/sdm24logger/models/3D_SRP7028CC SERIES.stp
7.30 x 6.60 x 2.81 mm
