sundevilmotorsports/pcb-dev/PRE2026/sdm25wheel/models/561-1301-100F.STEP

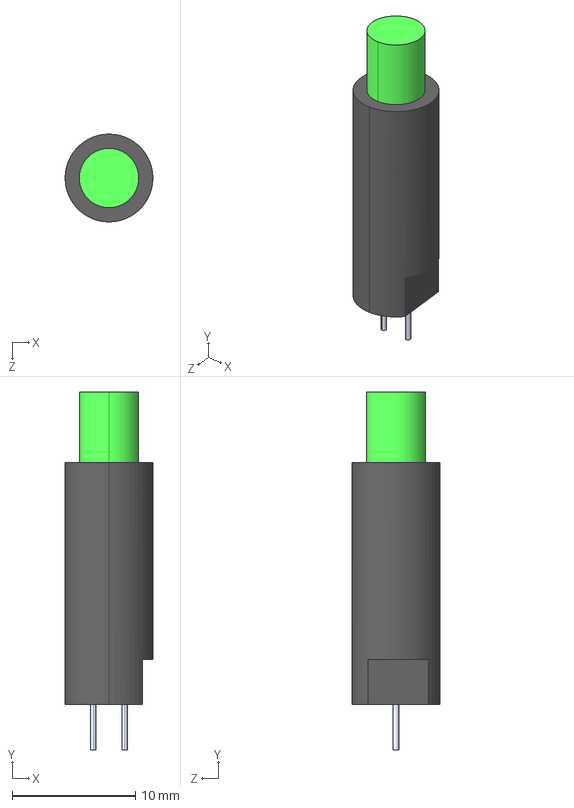
[picture p93: CAD file, 2023-07-04]
PRE2026/sdm25wheel/models/561-1301-100F.STEP
7.14 x 29.1 x 7.14 mm
