sundevilmotorsports/pcb-dev/MiscLibraries/SDM_Misc3D/BSS84AK,215.step

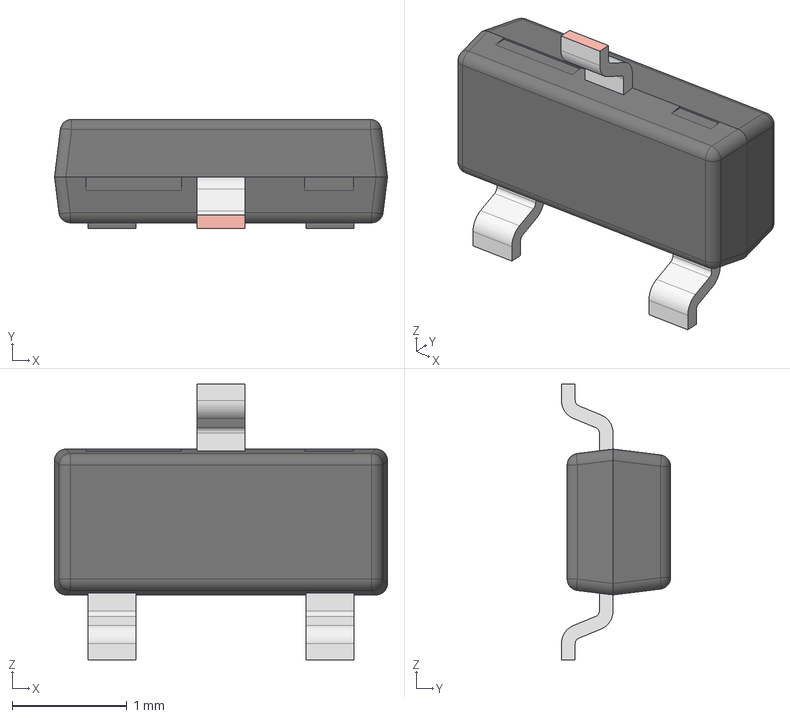
[picture p94: CAD file, 2026-07-31]
MiscLibraries/SDM_Misc3D/BSS84AK,215.step
2.90 x 0.95 x 2.40 mm
SOT23 lower body
SOT23 Lead x 3
SOT23 Upper body
