sundevilmotorsports/pcb-dev/MiscLibraries/SDM_Misc3D/SKTHBAE010.stp

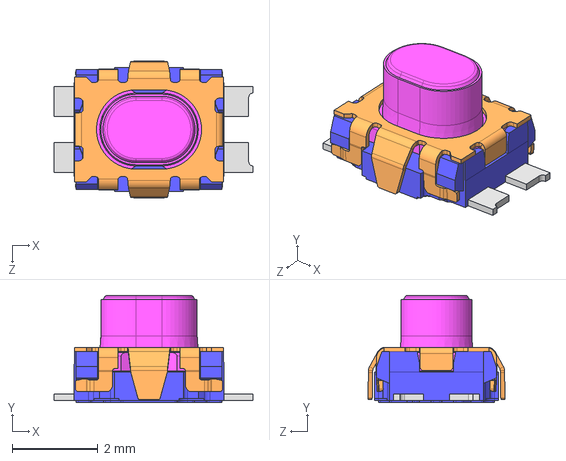
[picture p95: CAD file, 2026-07-30]
MiscLibraries/SDM_Misc3D/SKTHBAE010.stp
4.64 x 2.50 x 3.20 mm
