sundevilmotorsports/pcb-dev/MiscLibraries/SDM_Misc3D/SA1215-S3-C-.stp

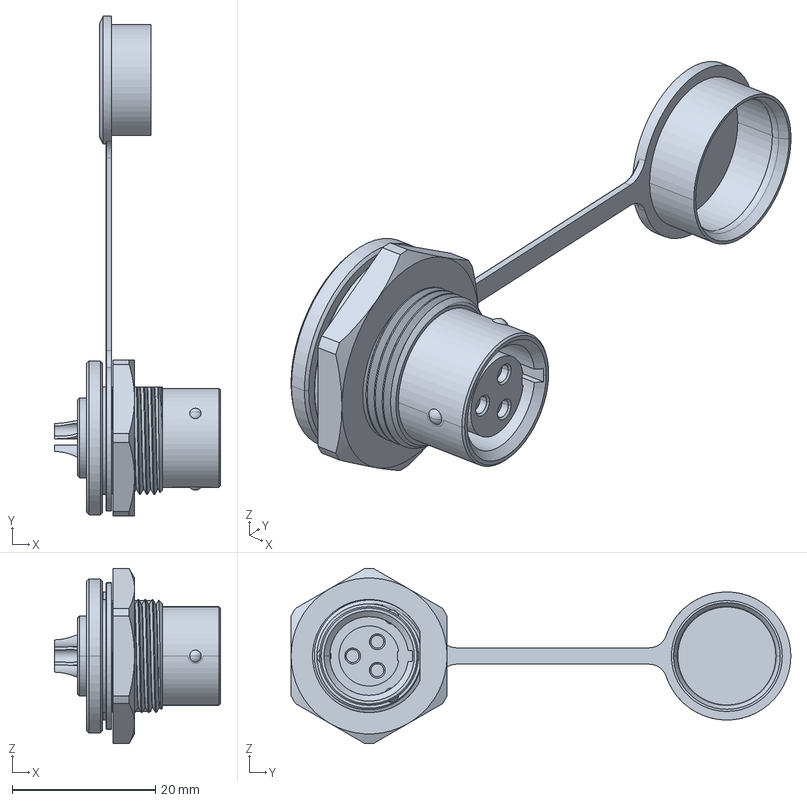
[picture p96: CAD file, 2026-07-28]
MiscLibraries/SDM_Misc3D/SA1215-S3-C-.stp
23.2 x 69.9 x 24.5 mm
