sundevilmotorsports/pcb-dev/PRE2026/sdm24logger/models/c-1-776087-1-n-3d.stp.SLDPRT

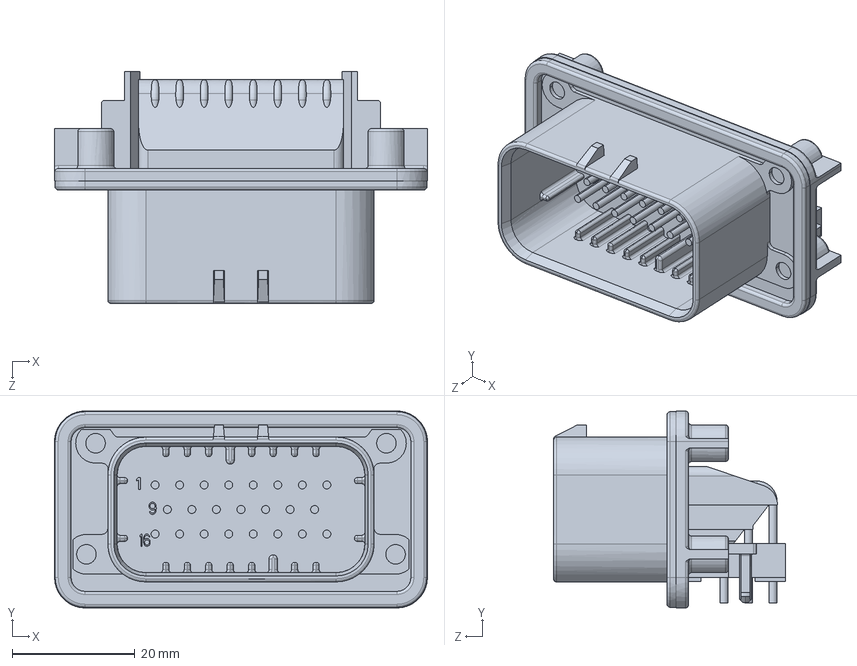
[picture p97: CAD file, 2023-10-13]
PRE2026/sdm24logger/models/c-1-776087-1-n-3d.stp.SLDPRT
60.8 x 32.1 x 37.8 mm
