sundevilmotorsports/pcb-dev/PRE2026/sdm25wheel/models/5x3-2mm.STEP

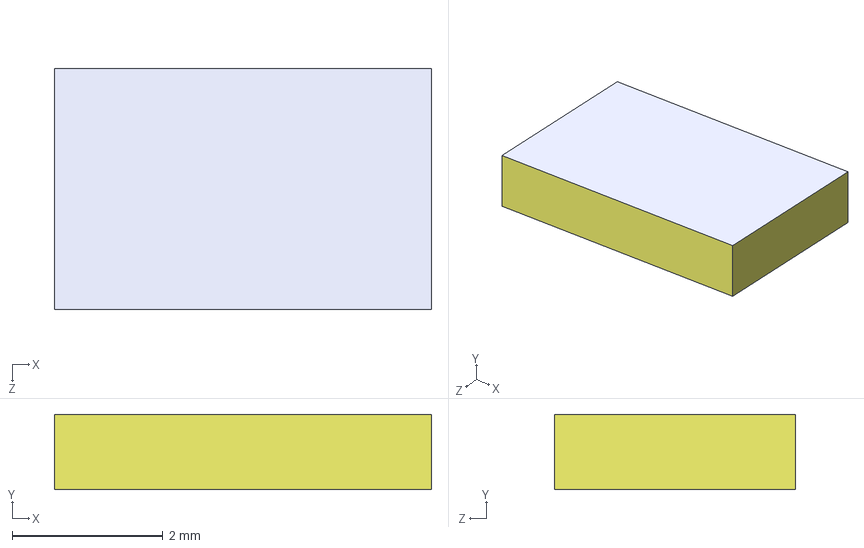
[picture p98: CAD file, 2023-07-04]
PRE2026/sdm25wheel/models/5x3-2mm.STEP
5.00 x 1.00 x 3.20 mm
