sundevilmotorsports/pcb-dev/MiscLibraries/SDM_Misc3D/SN74LVC1G17YZPR.stp

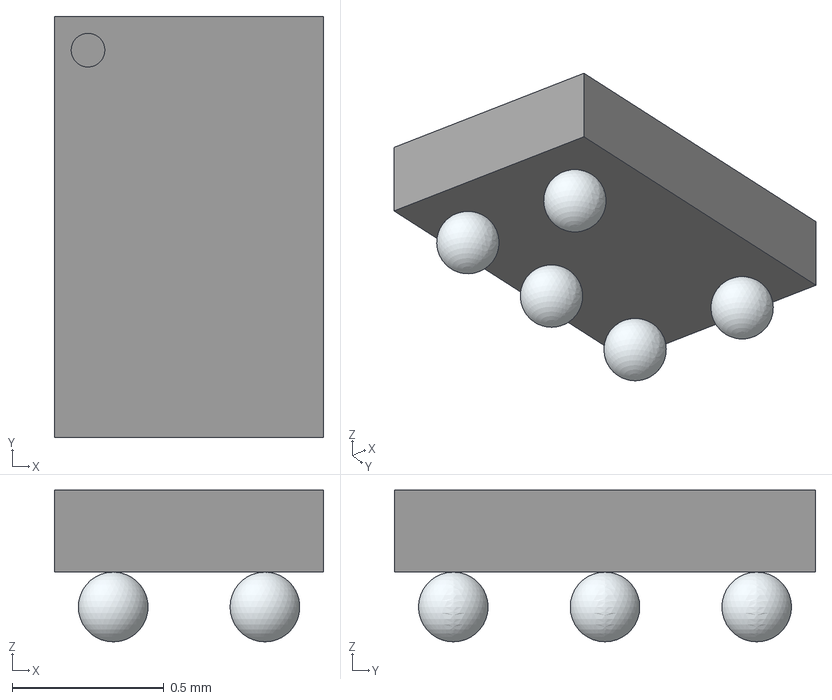
[picture p99: CAD file, 2026-07-17]
MiscLibraries/SDM_Misc3D/SN74LVC1G17YZPR.stp
0.887 x 1.39 x 0.5 mm
A1
A2
B1
C1
C2
