sundevilmotorsports/pcb-dev/MiscLibraries/SDM_Misc3D/TPS2121RUXR.stp

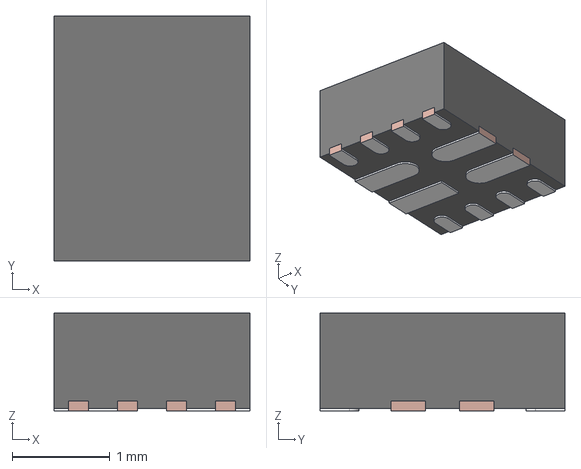
[picture p100: CAD file, 2026-07-11]
MiscLibraries/SDM_Misc3D/TPS2121RUXR.stp
2.00 x 2.50 x 1.00 mm
FRAME
MOLD
