sundevilmotorsports/pcb-dev/PRE2026/sdm24logger/models/texas-sot-5x3.stp

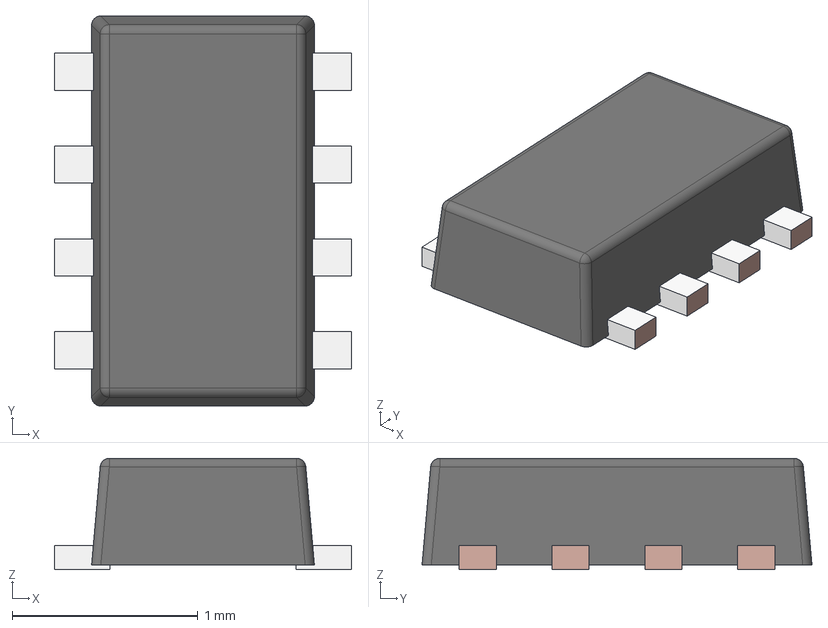
[picture p101: CAD file, 2023-10-13]
PRE2026/sdm24logger/models/texas-sot-5x3.stp
1.60 x 2.10 x 0.6 mm
FRAME-DRL0008A
BODY-SOT
