sundevilmotorsports/pcb-dev/MiscLibraries/SDM_Misc3D/6EDL7141XUMA1.stp

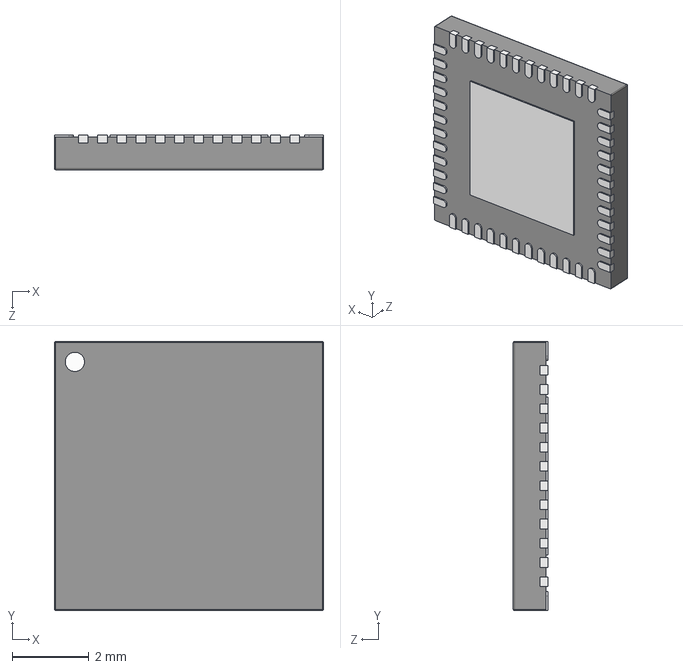
[picture p102: CAD file, 2026-07-11]
MiscLibraries/SDM_Misc3D/6EDL7141XUMA1.stp
7.00 x 7.00 x 0.9 mm
