sundevilmotorsports/pcb-dev/PRE2026/sdm24logger/models/EMIF06-MSD02N16.stp

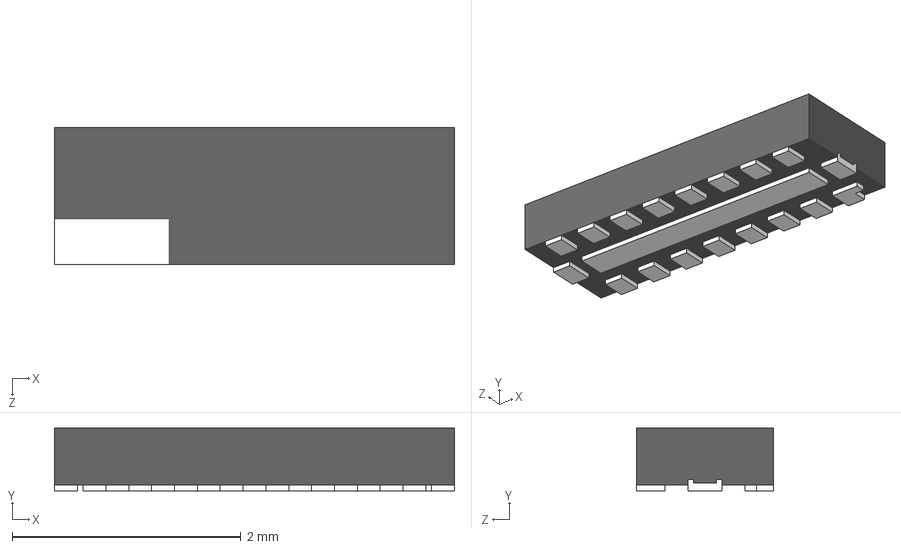
[picture p103: CAD file, 2023-07-09]
PRE2026/sdm24logger/models/EMIF06-MSD02N16.stp
3.50 x 0.55 x 1.20 mm
