sundevilmotorsports/pcb-dev/MiscLibraries/SDM_Misc3D/ADNS-3050.stp

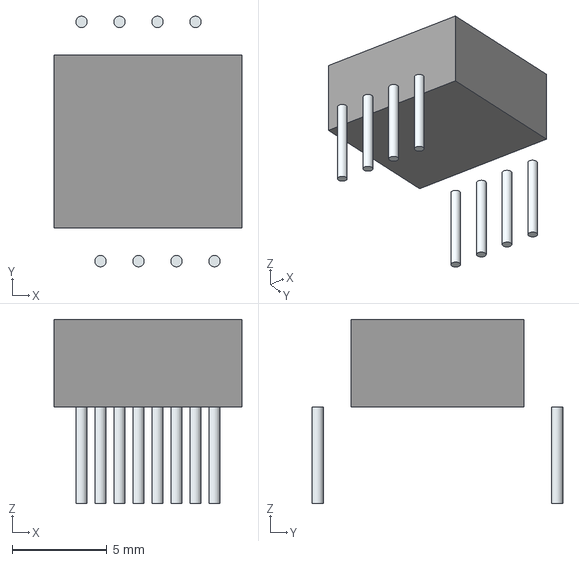
[picture p104: CAD file, 2026-06-14]
MiscLibraries/SDM_Misc3D/ADNS-3050.stp
9.90 x 13.2 x 9.70 mm
Leads x 8
