sundevilmotorsports/pcb-dev/MiscLibraries/SDM_Misc3D/LFD182G45DCHD277.stp

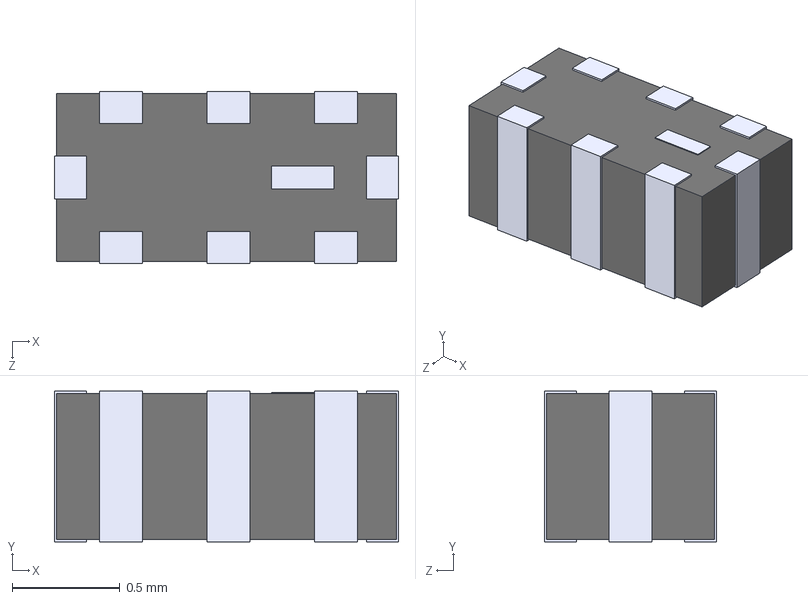
[picture p105: CAD file, 2026-05-19]
MiscLibraries/SDM_Misc3D/LFD182G45DCHD277.stp
1.60 x 0.7 x 0.8 mm
