sundevilmotorsports/pcb-dev/MiscLibraries/SDM_Misc3D/NCP187AMT330TAG.stp

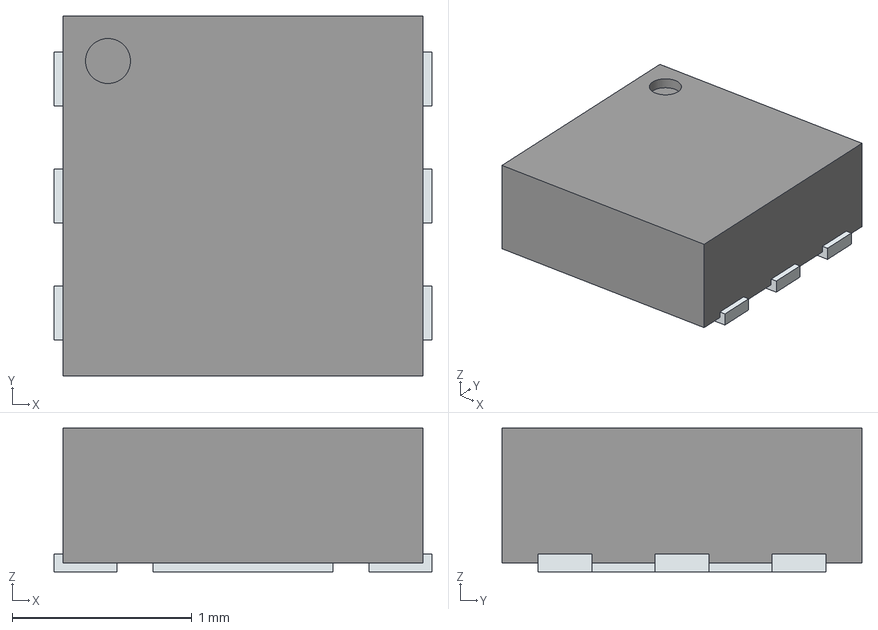
[picture p106: CAD file, 2026-05-19]
MiscLibraries/SDM_Misc3D/NCP187AMT330TAG.stp
2.10 x 2.00 x 0.8 mm
ThermalPin
PinsArrayLR
