sundevilmotorsports/pcb-dev/MiscLibraries/SDM_Misc3D/ESP32-C5HR8.stp

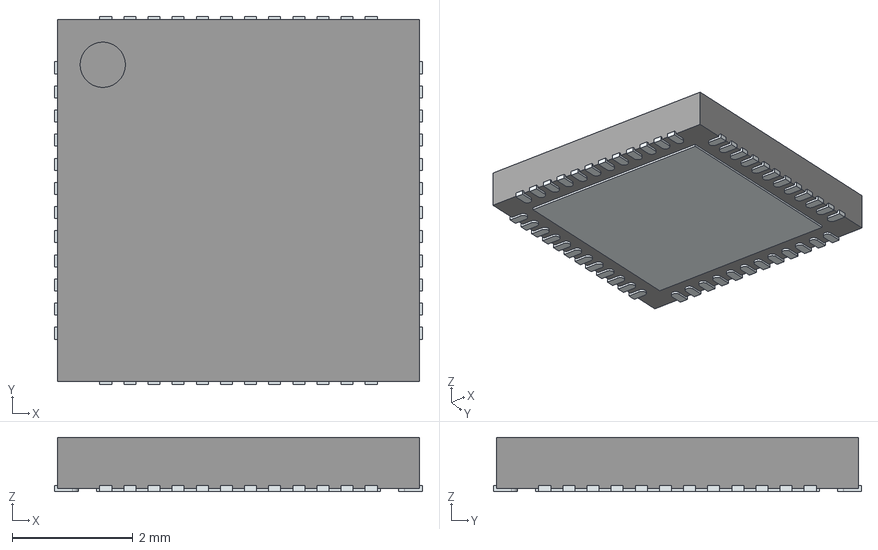
[picture p107: CAD file, 2026-04-25]
MiscLibraries/SDM_Misc3D/ESP32-C5HR8.stp
6.10 x 6.10 x 0.9 mm
ThermalPin
PinsArrayLR
PinsArrayTB
