sundevilmotorsports/pcb-dev/MiscLibraries/SDM_Misc3D/CX3225FB48000F0FZZH1.stp

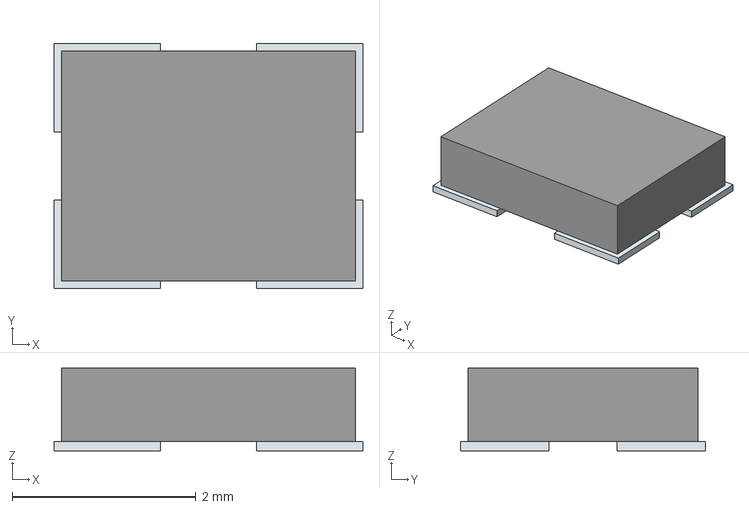
[picture p108: CAD file, 2026-04-25]
MiscLibraries/SDM_Misc3D/CX3225FB48000F0FZZH1.stp
3.36 x 2.66 x 0.9 mm
Pins
