sundevilmotorsports/pcb-dev/MiscLibraries/SDM_Misc3D/TCAN3403DRBRQ1.stp

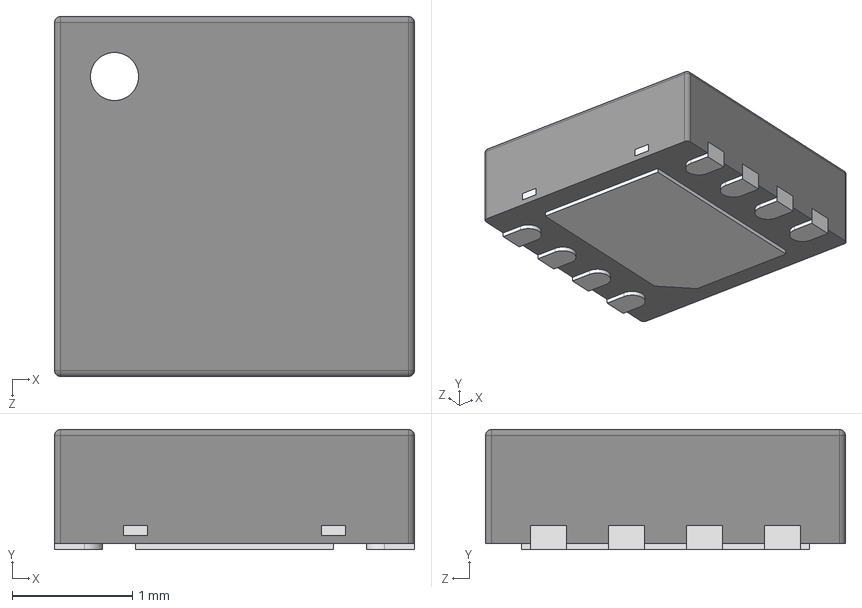
[picture p109: CAD file, 2026-04-25]
MiscLibraries/SDM_Misc3D/TCAN3403DRBRQ1.stp
3.00 x 1.00 x 3.00 mm
