sundevilmotorsports/pcb-dev/MiscLibraries/SDM_Misc3D/CONUFL001-SMD-T.step

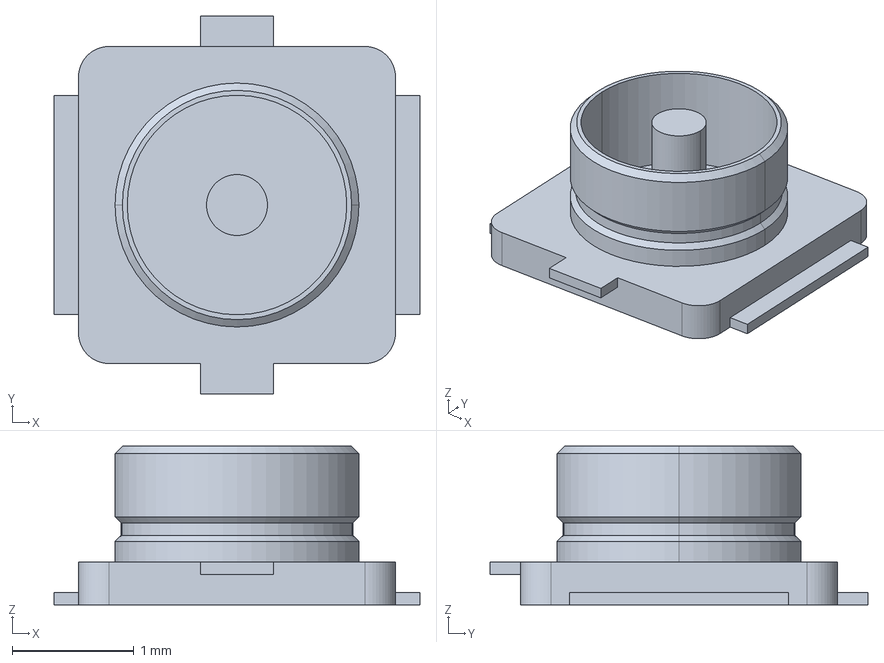
[picture p110: CAD file, 2026-03-19]
MiscLibraries/SDM_Misc3D/CONUFL001-SMD-T.step
3.00 x 3.10 x 1.30 mm
