sundevilmotorsports/pcb-dev/MiscLibraries/SDM_Misc3D/TS11-674-73-BK-260-RA-D.step

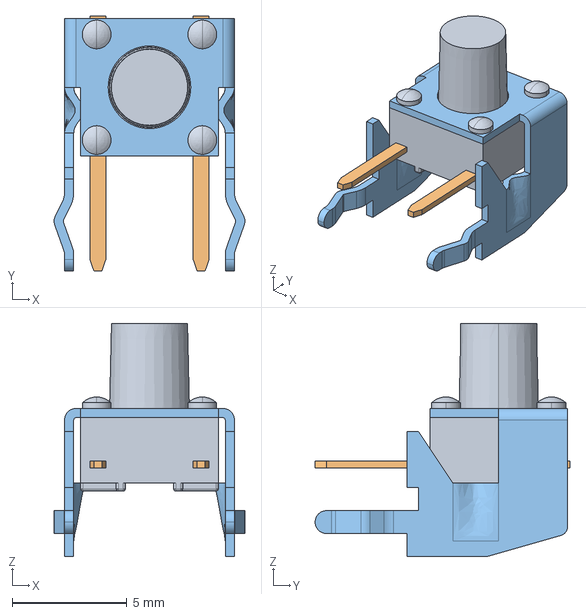
[picture p111: CAD file, 2026-03-19]
MiscLibraries/SDM_Misc3D/TS11-674-73-BK-260-RA-D.step
8.31 x 11.1 x 10.1 mm
