sundevilmotorsports/pcb-dev/MiscLibraries/SDM_Misc3D/IIS2MDCTR.stp

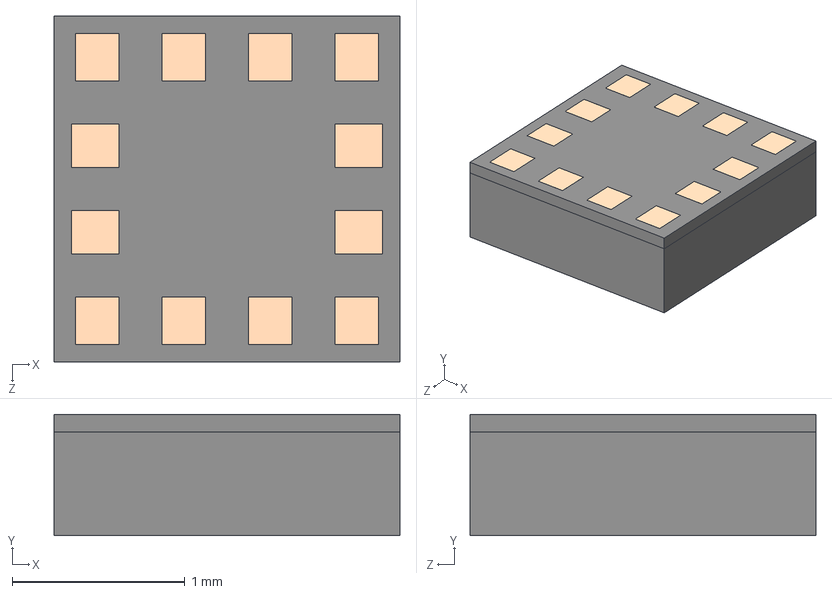
[picture p112: CAD file, 2026-03-19]
MiscLibraries/SDM_Misc3D/IIS2MDCTR.stp
2.00 x 0.7 x 2.00 mm
