sundevilmotorsports/pcb-dev/MiscLibraries/SDM_Misc3D/TPD4S480RUKR.step

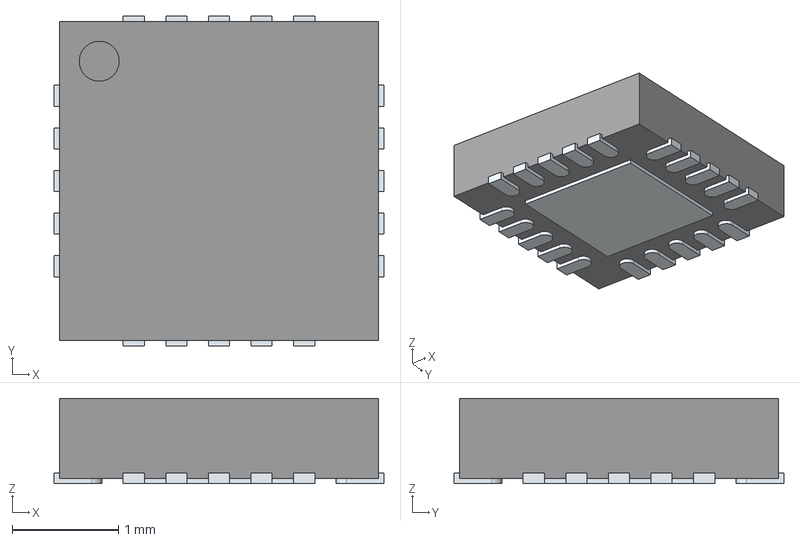
[picture p113: CAD file, 2026-03-19]
MiscLibraries/SDM_Misc3D/TPD4S480RUKR.step
3.10 x 3.10 x 0.8 mm
ThermalPin
PinsArrayLR
PinsArrayTB
