sundevilmotorsports/pcb-dev/MiscLibraries/SDM_Misc3D/SE2576L-R.step

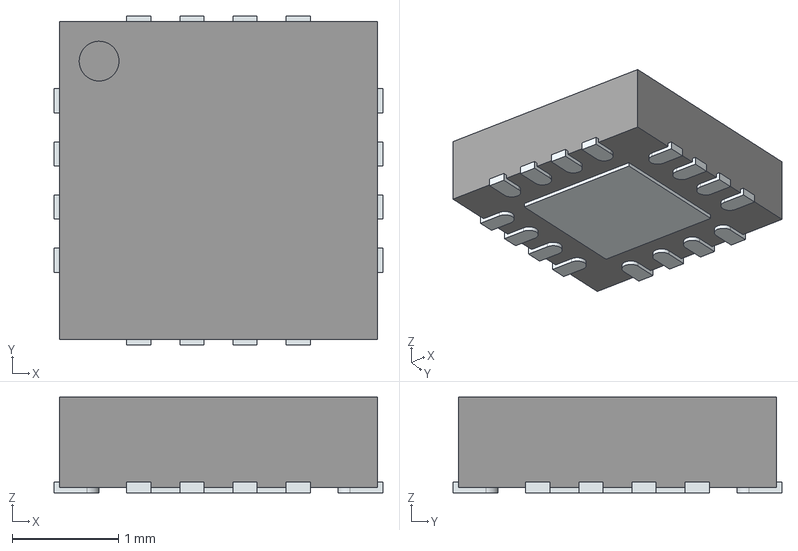
[picture p114: CAD file, 2026-03-17]
MiscLibraries/SDM_Misc3D/SE2576L-R.step
3.10 x 3.10 x 0.9 mm
ThermalPin
PinsArrayLR
PinsArrayTB
