sundevilmotorsports/pcb-dev/MiscLibraries/SDM_Misc3D/ADS7953SRHBR.step

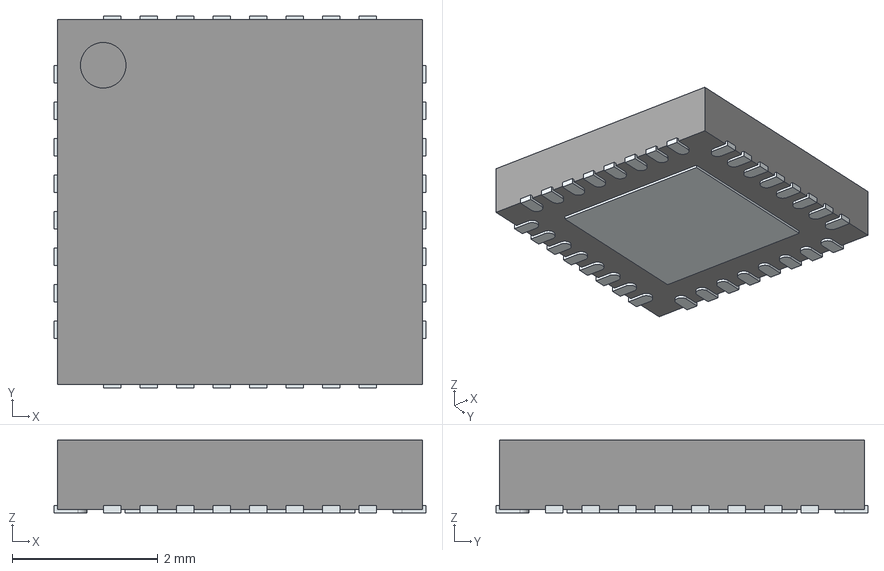
[picture p115: CAD file, 2026-02-18]
MiscLibraries/SDM_Misc3D/ADS7953SRHBR.step
5.10 x 5.10 x 1.00 mm
ThermalPin
PinsArrayLR
PinsArrayTB
