sundevilmotorsports/pcb-dev/MiscLibraries/SDM_Misc3D/KSS321G_LFS.stp

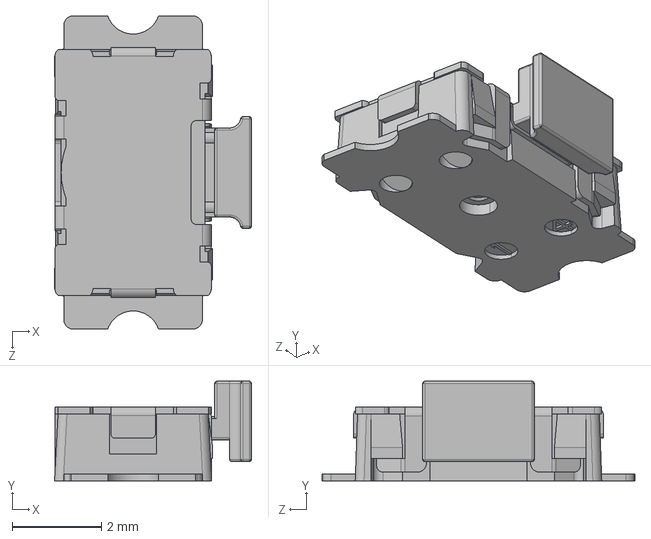
[picture p116: CAD file, 2026-02-13]
MiscLibraries/SDM_Misc3D/KSS321G_LFS.stp
4.41 x 2.23 x 7.00 mm
