sundevilmotorsports/pcb-dev/MiscLibraries/SDM_Misc3D/S25FL256LAGNFB010.stp

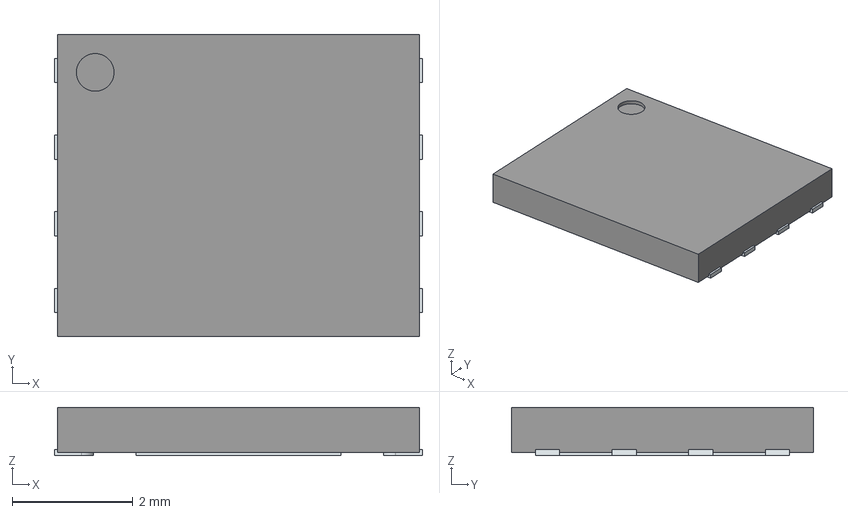
[picture p117: CAD file, 2026-01-31]
MiscLibraries/SDM_Misc3D/S25FL256LAGNFB010.stp
6.10 x 5.00 x 0.8 mm
ThermalPin
PinsArrayLR
