sundevilmotorsports/pcb-dev/MiscLibraries/SDM_Misc3D/BT818Q-T.stp

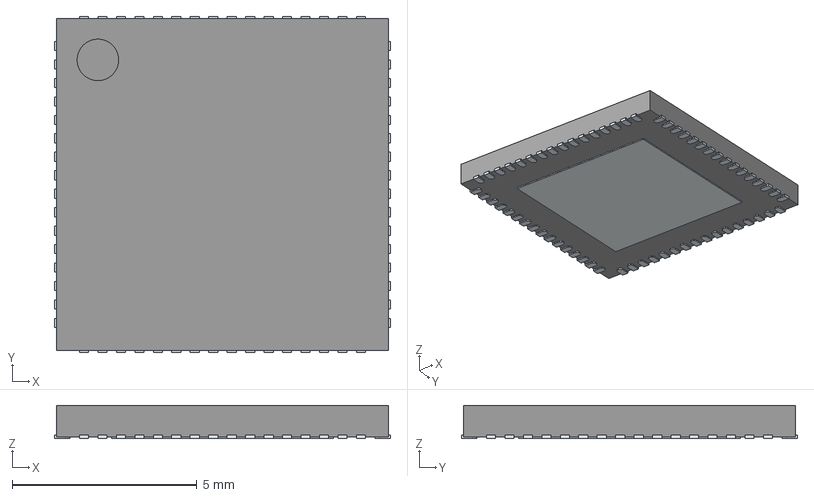
[picture p118: CAD file, 2026-01-31]
MiscLibraries/SDM_Misc3D/BT818Q-T.stp
9.10 x 9.10 x 0.9 mm
ThermalPin
PinsArrayLR
PinsArrayTB
