sundevilmotorsports/pcb-dev/MiscLibraries/SDM_Misc3D/USB4215-03-A.step

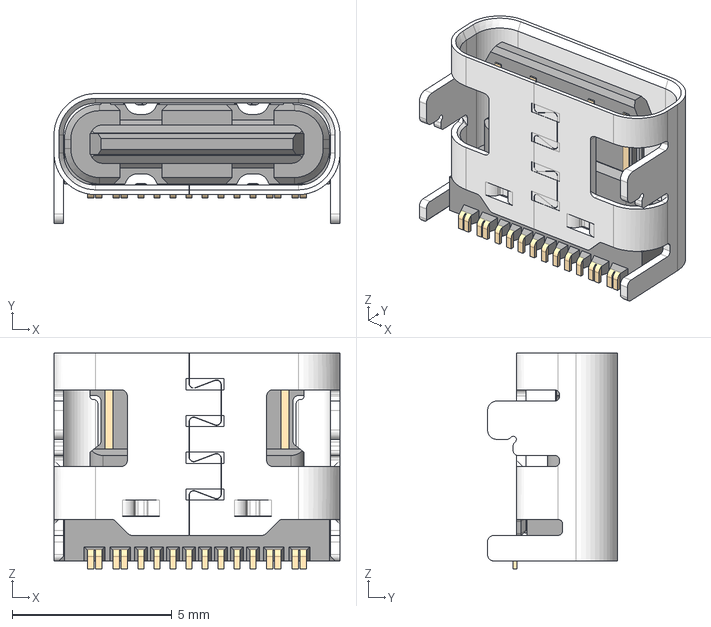
[picture p119: CAD file, 2026-01-16]
MiscLibraries/SDM_Misc3D/USB4215-03-A.step
8.94 x 4.06 x 6.75 mm
USB4215-03-A_PART1
USB4215-03-A_PART2
