sundevilmotorsports/pcb-dev/MiscLibraries/SDM_Misc3D/CLMUD-FKC-CHJNPM569ABB845343.stp

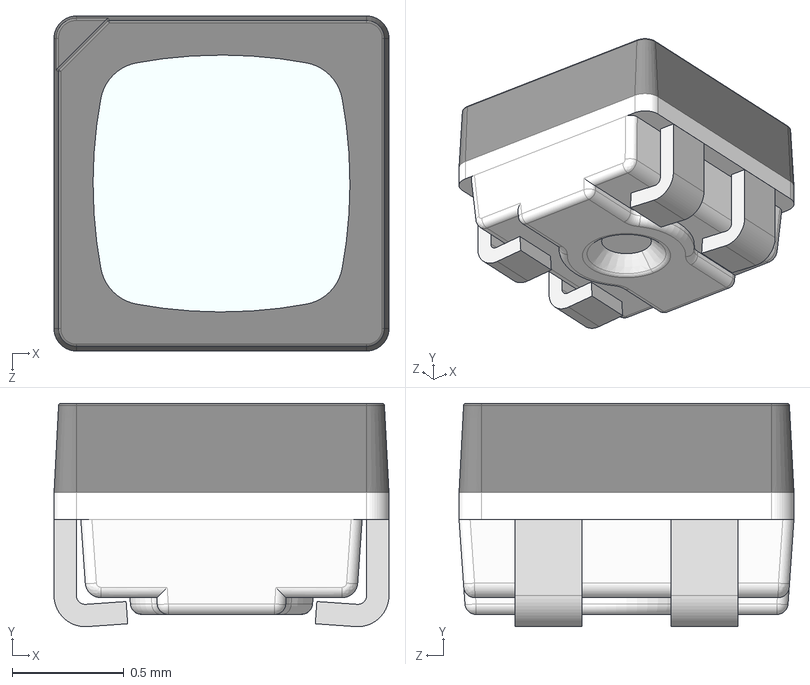
[picture p120: CAD file, 2025-12-04]
MiscLibraries/SDM_Misc3D/CLMUD-FKC-CHJNPM569ABB845343.stp
1.50 x 1 x 1.50 mm
