sundevilmotorsports/pcb-dev/MiscLibraries/SDM_Misc3D/TLC5955RTQT.stp

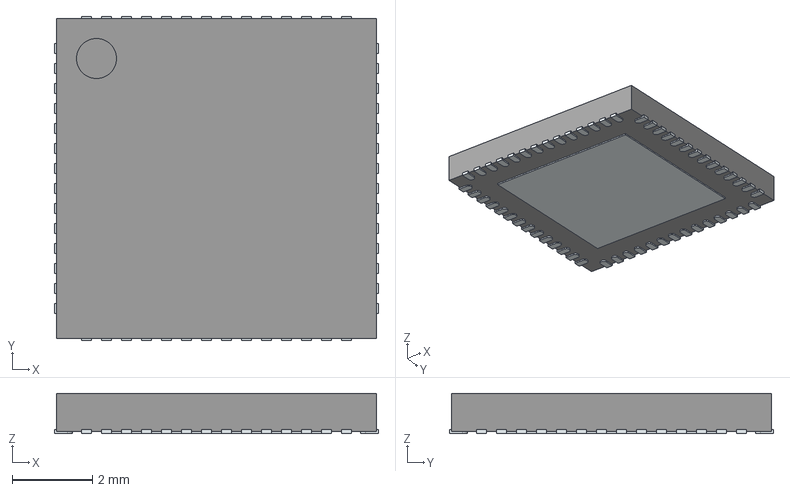
[picture p121: CAD file, 2025-11-26]
MiscLibraries/SDM_Misc3D/TLC5955RTQT.stp
8.10 x 8.10 x 1.00 mm
ThermalPin
PinsArrayLR
PinsArrayTB
