sundevilmotorsports/pcb-dev/MiscLibraries/SDM_Misc3D/MCP2518FDT-H_QBB.stp

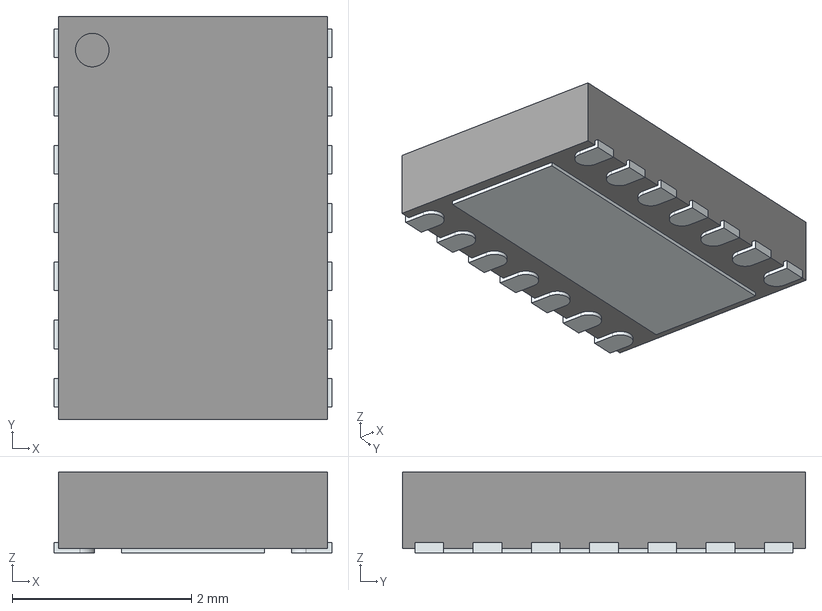
[picture p122: CAD file, 2025-11-03]
MiscLibraries/SDM_Misc3D/MCP2518FDT-H_QBB.stp
3.10 x 4.50 x 0.9 mm
ThermalPin
PinsArrayLR
