sundevilmotorsports/pcb-dev/MiscLibraries/SDM_Misc3D/MHPS2285V.step

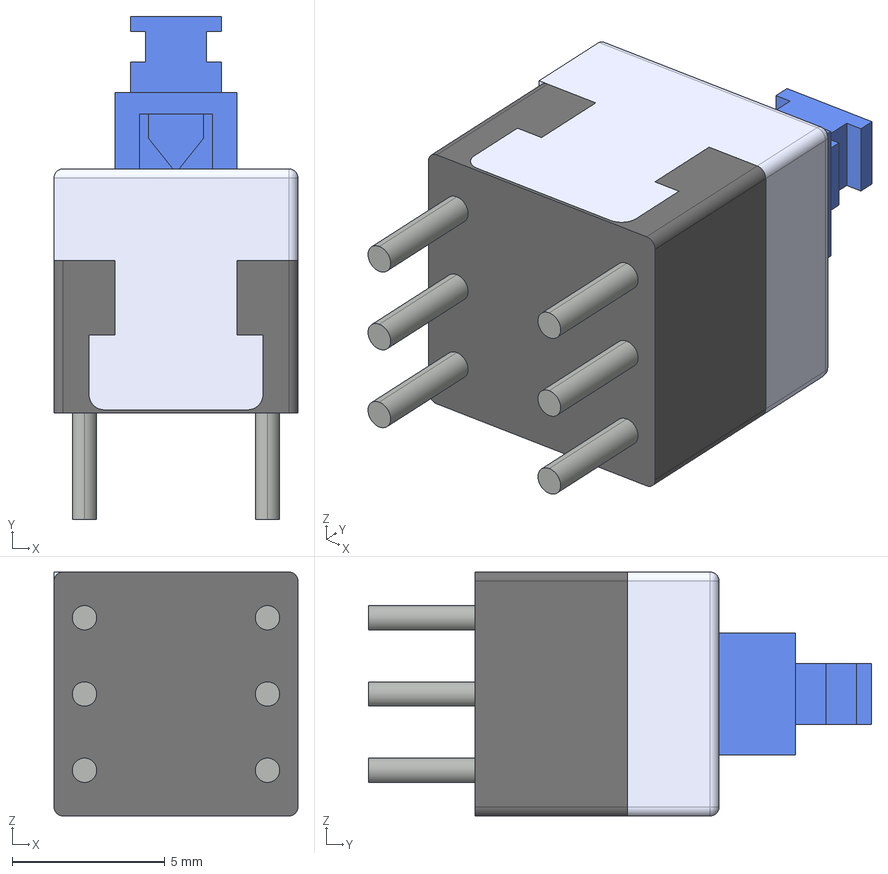
[picture p123: CAD file, 2025-10-20]
MiscLibraries/SDM_Misc3D/MHPS2285V.step
8.00 x 16.5 x 8.00 mm
User Library-MHPS2285_MHPS2285_Base_F
User Library-MHPS2285_MHPS2285_Base_M
User Library-MHPS2285_MHPS2285_Stalk
User Library-MHPS2285_MHPS2285_Pins
