sundevilmotorsports/pcb-dev/MiscLibraries/SDM_Misc3D/4525DO-DS5AI001DP.step

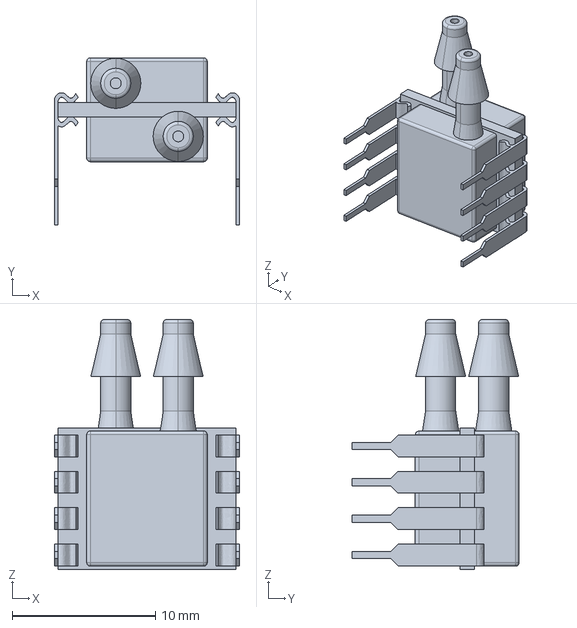
[picture p124: CAD file, 2025-10-17]
MiscLibraries/SDM_Misc3D/4525DO-DS5AI001DP.step
13.0 x 11.7 x 17.5 mm
