sundevilmotorsports/pcb-dev/MiscLibraries/SDM_Misc3D/74HC4050PW-Q100J.stp

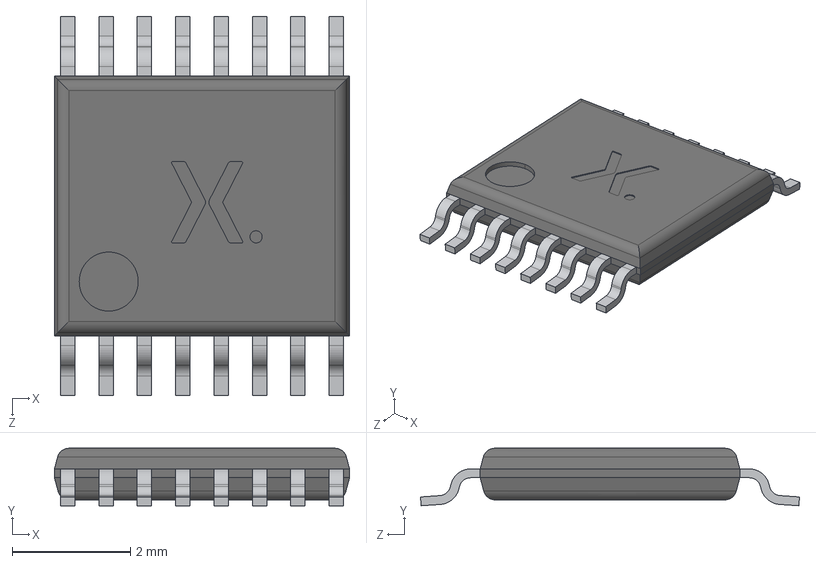
[picture p125: CAD file, 2025-10-08]
MiscLibraries/SDM_Misc3D/74HC4050PW-Q100J.stp
5.00 x 0.975 x 6.42 mm
SOT403-1 mold body
DETAIL X x 16
