sundevilmotorsports/pcb-dev/MiscLibraries/SDM_Misc3D/74AHC1G08GW,125.step

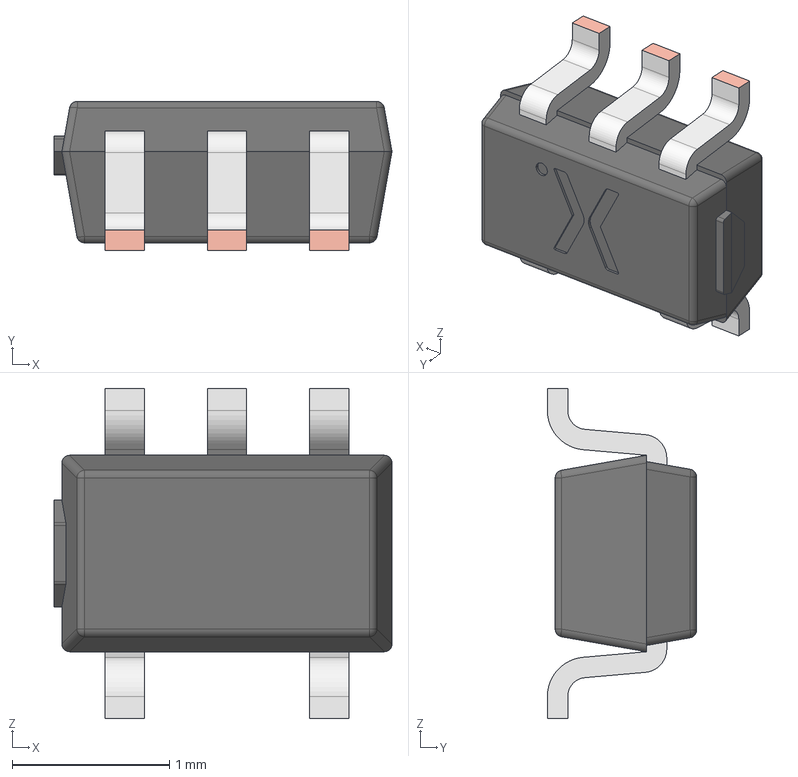
[picture p126: CAD file, 2025-10-08]
MiscLibraries/SDM_Misc3D/74AHC1G08GW,125.step
2.15 x 0.95 x 2.10 mm
SOT353-1 Lower body
SOT353-1 Lead x 5
SOT353-1 Upper body
