sundevilmotorsports/pcb-dev/MiscLibraries/SDM_Misc3D/5009.step

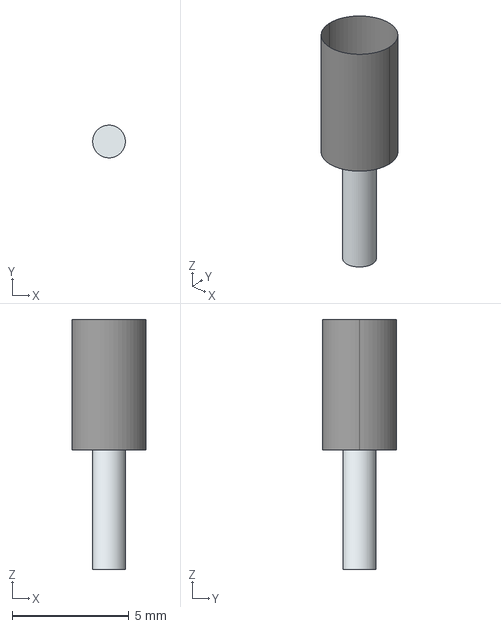
[picture p127: CAD file, 2025-10-08]
MiscLibraries/SDM_Misc3D/5009.step
3.18 x 3.18 x 10.7 mm
Leads
