sundevilmotorsports/pcb-dev/MiscLibraries/SDM_Misc3D/ABM3B-8.000MHZ-10-1-U-T.step

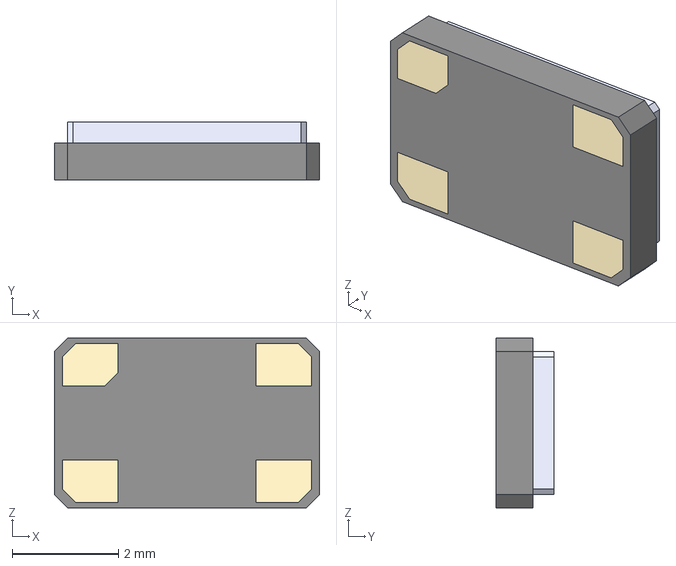
[picture p128: CAD file, 2025-10-08]
MiscLibraries/SDM_Misc3D/ABM3B-8.000MHZ-10-1-U-T.step
5.00 x 1.10 x 3.20 mm
