sundevilmotorsports/pcb-dev/MiscLibraries/SDM_Misc3D/TLP175A_TPL,E.step

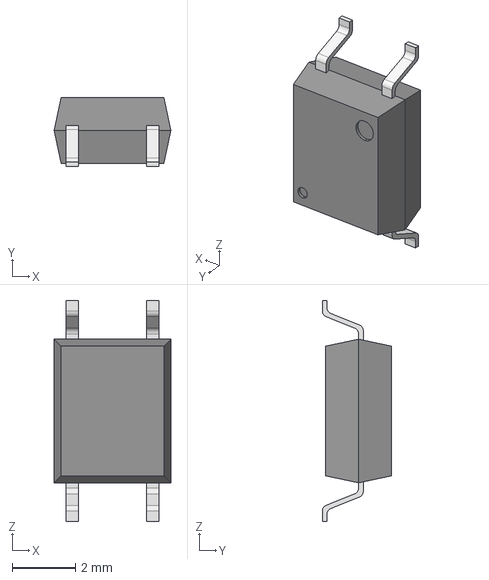
[picture p129: CAD file, 2025-10-08]
MiscLibraries/SDM_Misc3D/TLP175A_TPL,E.step
3.70 x 2.20 x 7.00 mm
