sundevilmotorsports/pcb-dev/MiscLibraries/SDM_Misc3D/PCW1J-B24-KEB103L.step

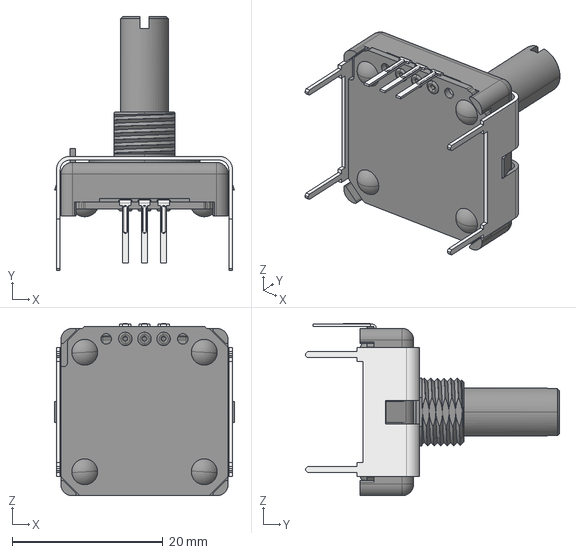
[picture p130: CAD file, 2025-10-08]
MiscLibraries/SDM_Misc3D/PCW1J-B24-KEB103L.step
23.9 x 33.7 x 22.9 mm
