sundevilmotorsports/pcb-dev/MiscLibraries/SDM_Misc3D/5006.step

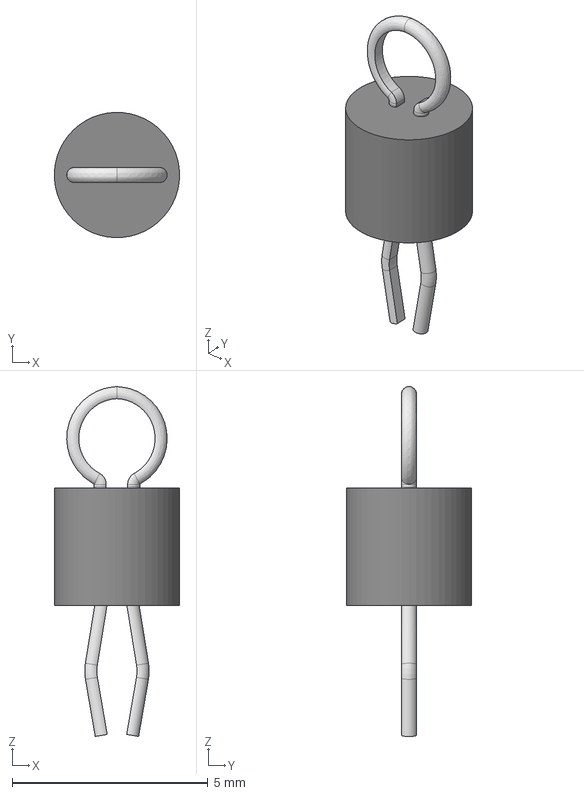
[picture p131: CAD file, 2025-10-08]
MiscLibraries/SDM_Misc3D/5006.step
3.20 x 3.20 x 8.94 mm
