sundevilmotorsports/pcb-dev/MiscLibraries/SDM_Misc3D/ATM13-08PA-BM01.step

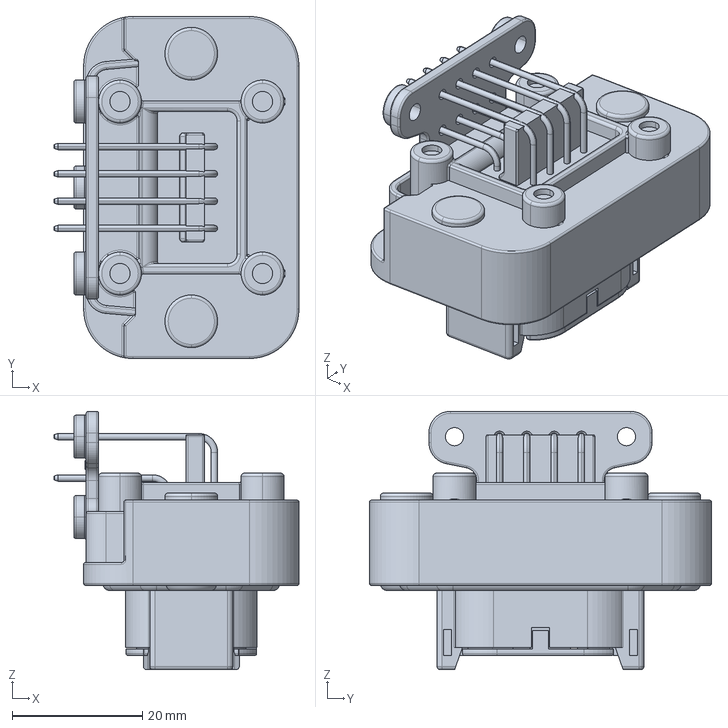
[picture p132: CAD file, 2025-10-08]
MiscLibraries/SDM_Misc3D/ATM13-08PA-BM01.step
37.7 x 52.6 x 39.7 mm
