sundevilmotorsports/pcb-dev/MiscLibraries/SDM_Misc3D/ESP32-S3-WROOM-1U-N8R8.step

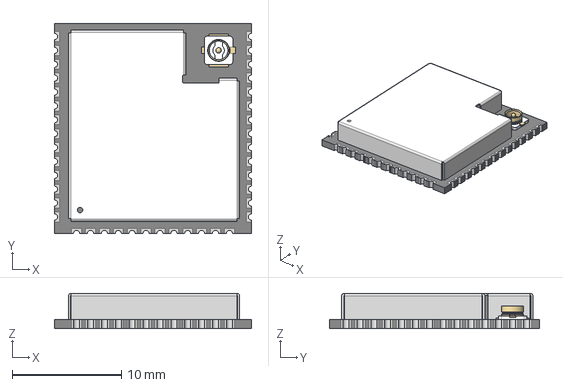
[picture p133: CAD file, 2025-10-08]
MiscLibraries/SDM_Misc3D/ESP32-S3-WROOM-1U-N8R8.step
18.0 x 19.2 x 3.22 mm
