sundevilmotorsports/pcb-dev/MiscLibraries/SDM_Misc3D/SN65HVD230QDR.step

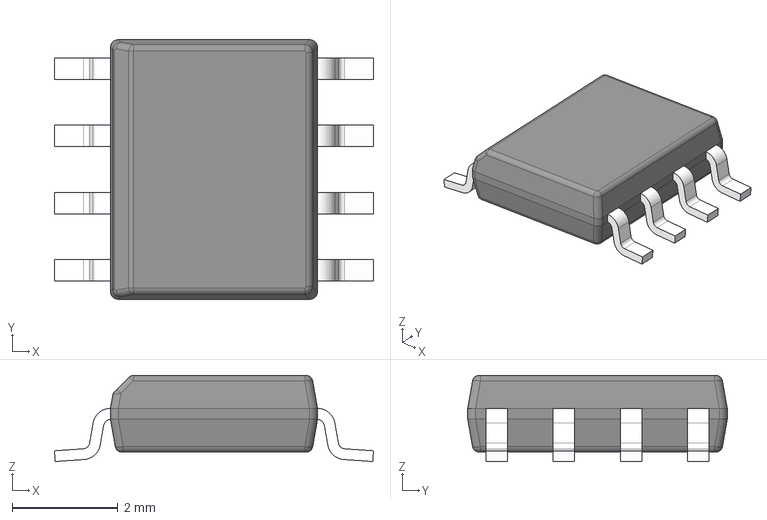
[picture p134: CAD file, 2025-10-08]
MiscLibraries/SDM_Misc3D/SN65HVD230QDR.step
6.02 x 4.90 x 1.63 mm
BODY-SO
LEAD-D0008A x 8
