sundevilmotorsports/pcb-dev/MiscLibraries/SDM_Misc3D/BAT54XV2T1G.step

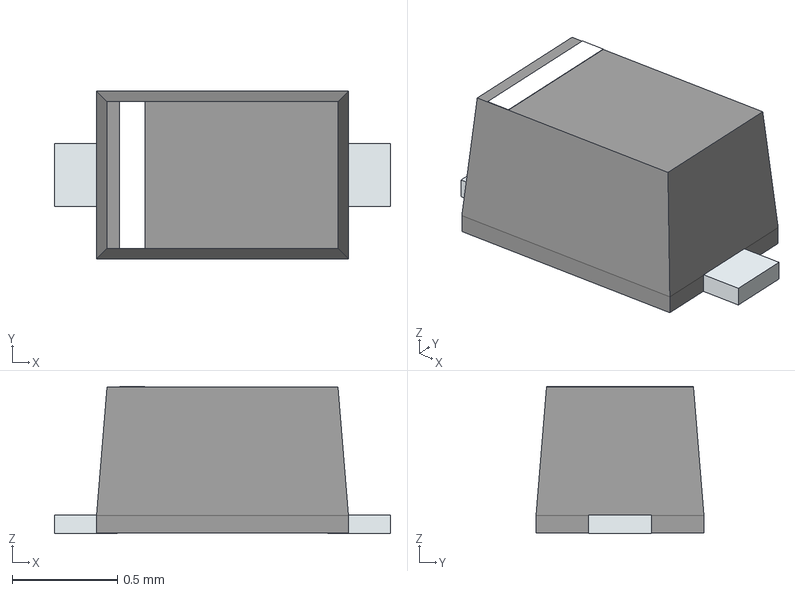
[picture p135: CAD file, 2025-10-08]
MiscLibraries/SDM_Misc3D/BAT54XV2T1G.step
1.60 x 0.8 x 0.7 mm
PinKIdent
PinK
PinA
