sundevilmotorsports/pcb-dev/MiscLibraries/SDM_Misc3D/SM04B-ULHK-1TA1-ETB_HF_.step

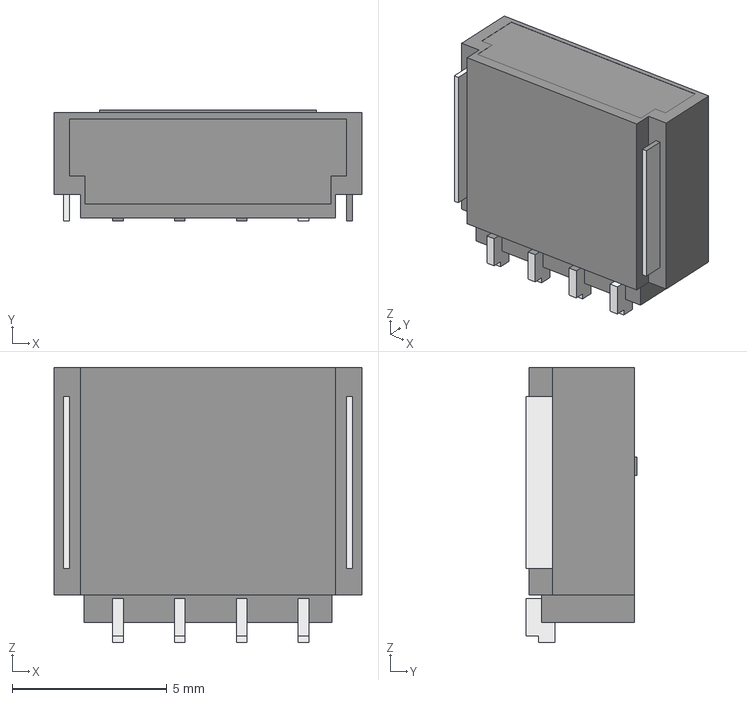
[picture p136: CAD file, 2025-10-08]
MiscLibraries/SDM_Misc3D/SM04B-ULHK-1TA1-ETB_HF_.step
9.95 x 3.58 x 8.90 mm
SM04B-ULH()-1()A()(HF)_2
SM04B-ULH()-1()A()(HF)
