sundevilmotorsports/pcb-dev/MiscLibraries/SDM_Misc3D/MAX9924UAUB+.step

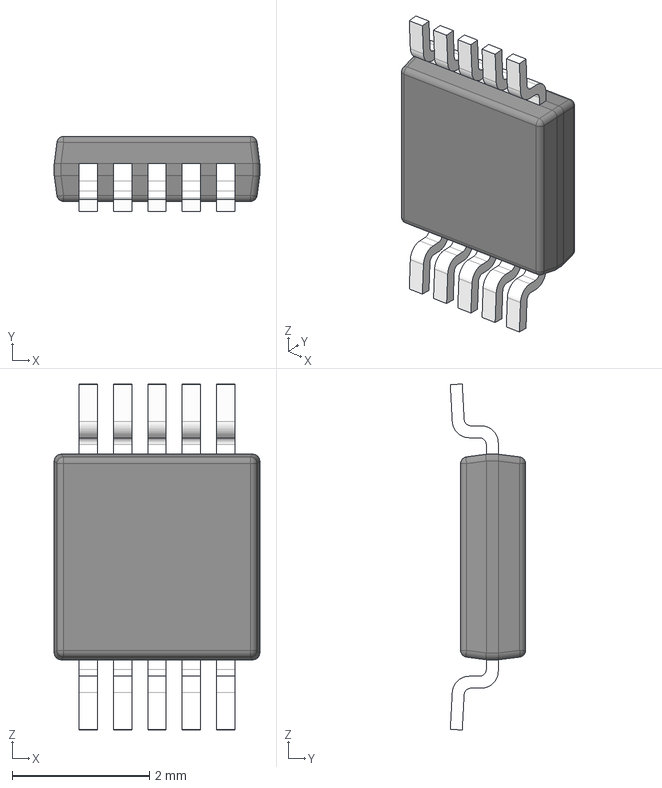
[picture p137: CAD file, 2025-10-08]
MiscLibraries/SDM_Misc3D/MAX9924UAUB+.step
3.00 x 1.10 x 5.05 mm
