sundevilmotorsports/pcb-dev/MiscLibraries/SDM_Misc3D/MBR0540T1G.step

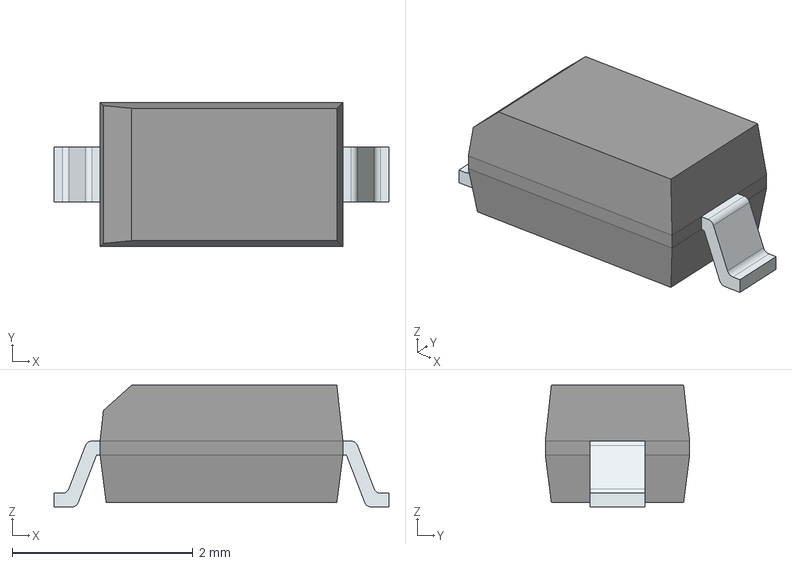
[picture p138: CAD file, 2025-10-08]
MiscLibraries/SDM_Misc3D/MBR0540T1G.step
3.71 x 1.60 x 1.35 mm
FilletPinL
FilletPinR
