sundevilmotorsports/pcb-dev/MiscLibraries/SDM_Misc3D/ECX-.327-CDX-2096.stp

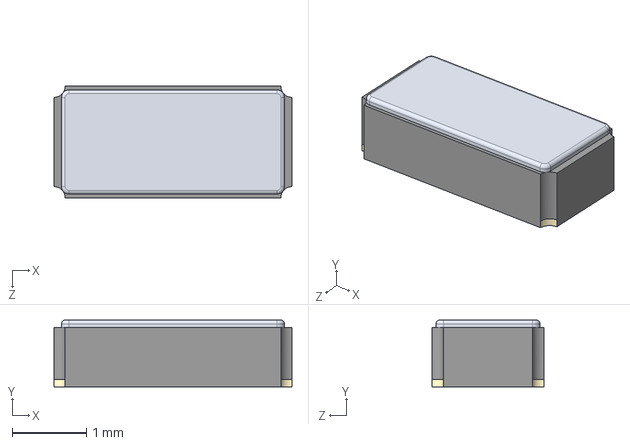
[picture p139: CAD file, 2025-10-08]
MiscLibraries/SDM_Misc3D/ECX-.327-CDX-2096.stp
3.20 x 0.9 x 1.50 mm
