sundevilmotorsports/pcb-dev/MiscLibraries/SDM_Misc3D/3386P-1-103TLF.step

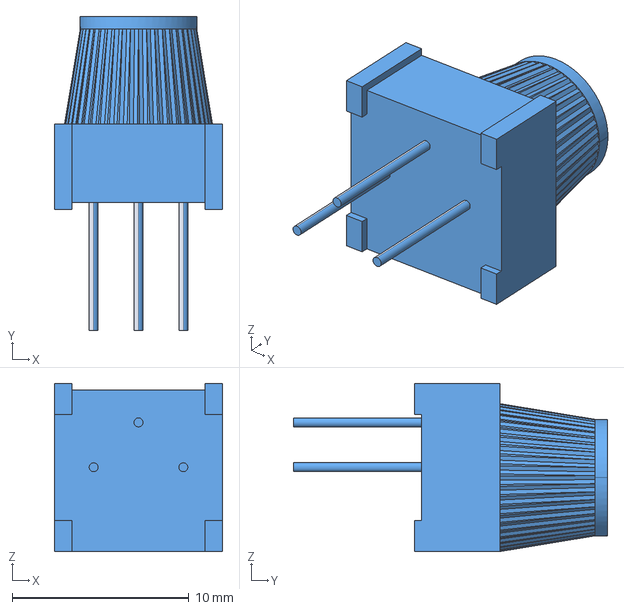
[picture p140: CAD file, 2025-10-08]
MiscLibraries/SDM_Misc3D/3386P-1-103TLF.step
9.53 x 17.8 x 9.53 mm
