sundevilmotorsports/pcb-dev/MiscLibraries/SDM_Misc3D/NEO-F9P-15B.step

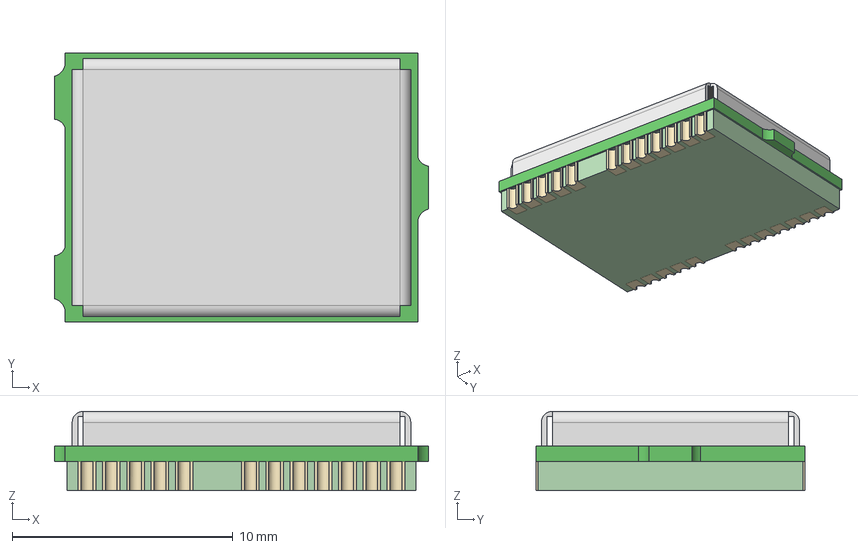
[picture p141: CAD file, 2025-10-08]
MiscLibraries/SDM_Misc3D/NEO-F9P-15B.step
16.9 x 12.2 x 3.59 mm
