sundevilmotorsports/pcb-dev/MiscLibraries/SDM_Misc3D/X0202MN_5BA4.step

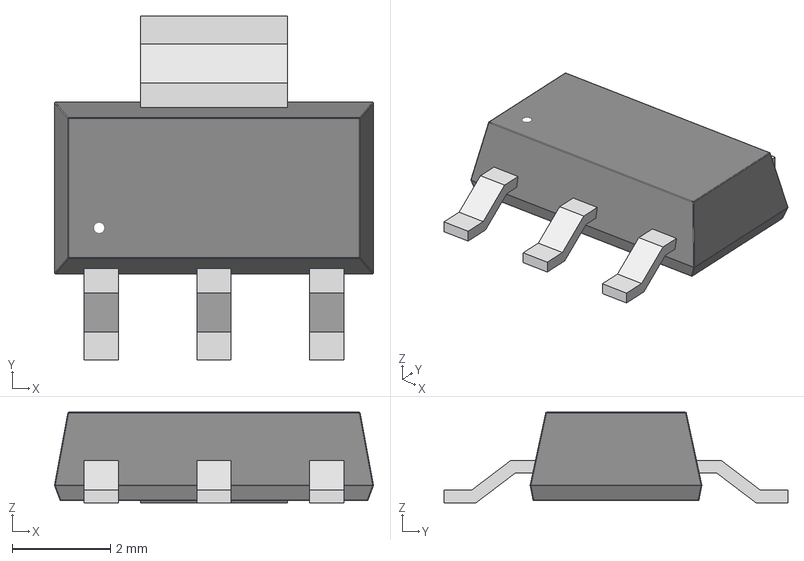
[picture p142: CAD file, 2025-10-08]
MiscLibraries/SDM_Misc3D/X0202MN_5BA4.step
6.50 x 7.00 x 1.84 mm
