sundevilmotorsports/pcb-dev/MiscLibraries/SDM_Misc3D/LM2901BIRTER.step

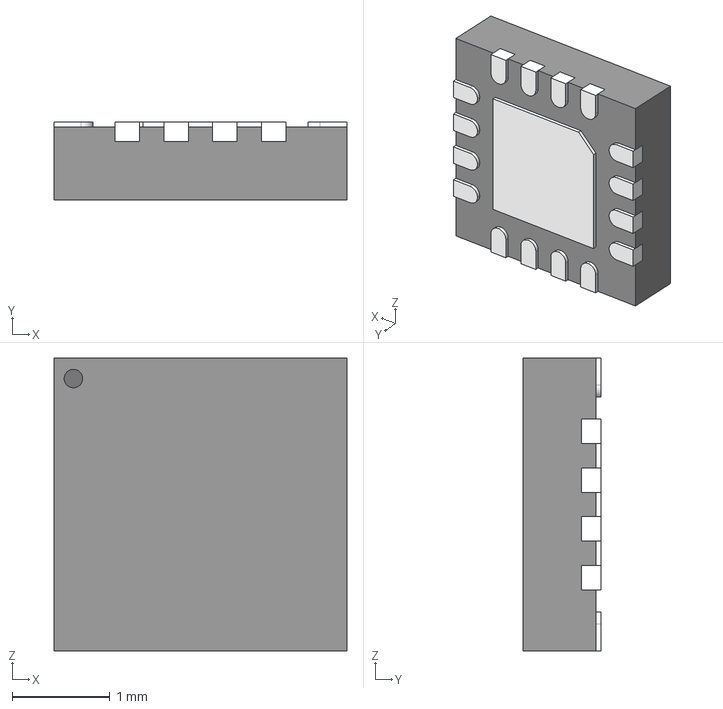
[picture p143: CAD file, 2025-10-08]
MiscLibraries/SDM_Misc3D/LM2901BIRTER.step
3.00 x 0.8 x 3.00 mm
