sundevilmotorsports/pcb-dev/MiscLibraries/SDM_Misc3D/ISM330DHCXTR.step

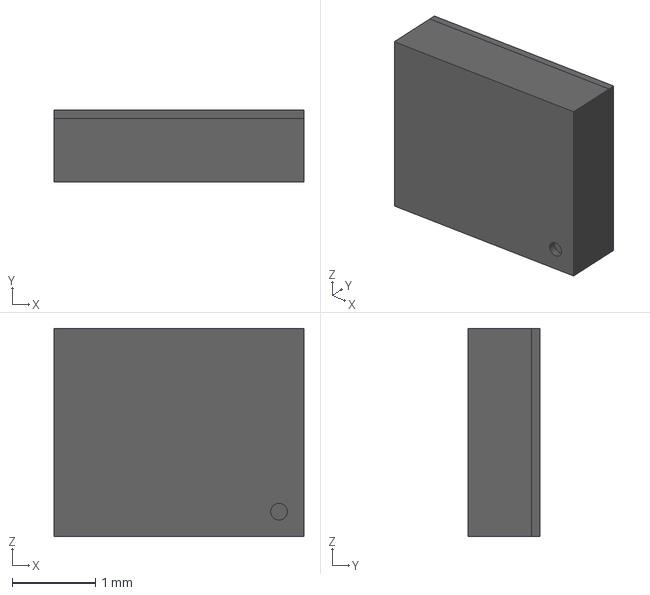
[picture p144: CAD file, 2025-10-08]
MiscLibraries/SDM_Misc3D/ISM330DHCXTR.step
3.00 x 0.86 x 2.50 mm
