sundevilmotorsports/pcb-dev/MiscLibraries/SDM_Misc3D/SOT-323_SC-70.step

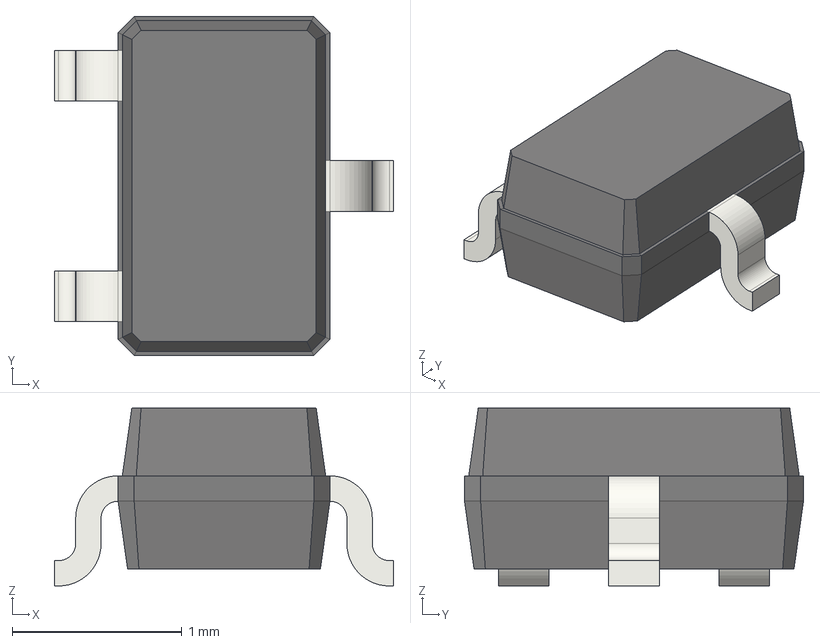
[picture p145: CAD file, 2025-10-08]
MiscLibraries/SDM_Misc3D/SOT-323_SC-70.step
2.00 x 2.00 x 1.05 mm
