sundevilmotorsports/pcb-dev/MiscLibraries/SDM_Misc3D/74LVC1G17SE-7.step

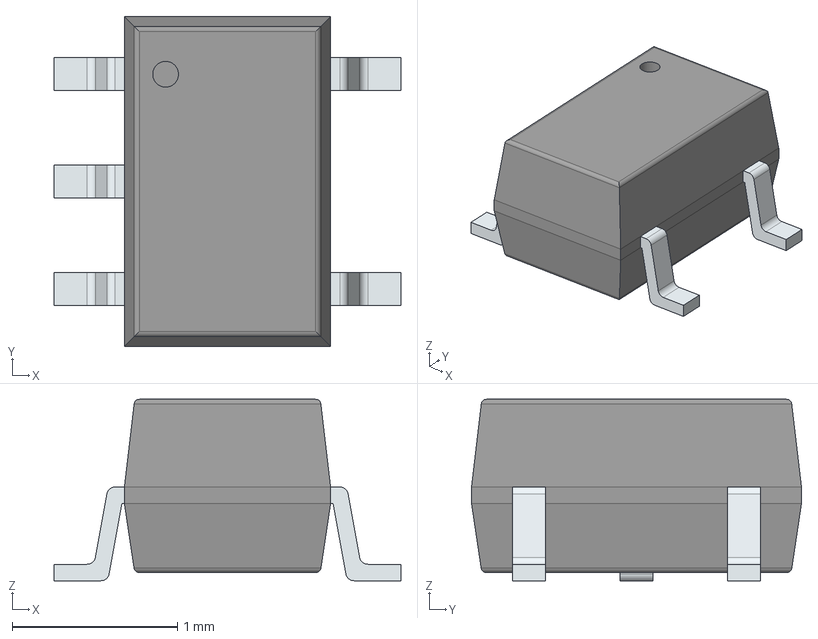
[picture p146: CAD file, 2025-10-08]
MiscLibraries/SDM_Misc3D/74LVC1G17SE-7.step
2.10 x 2.00 x 1.10 mm
PinsArrayL
PinsArrayR
