sundevilmotorsports/pcb-dev/MiscLibraries/SDM_Misc3D/BWVS006060454R7ML1.step

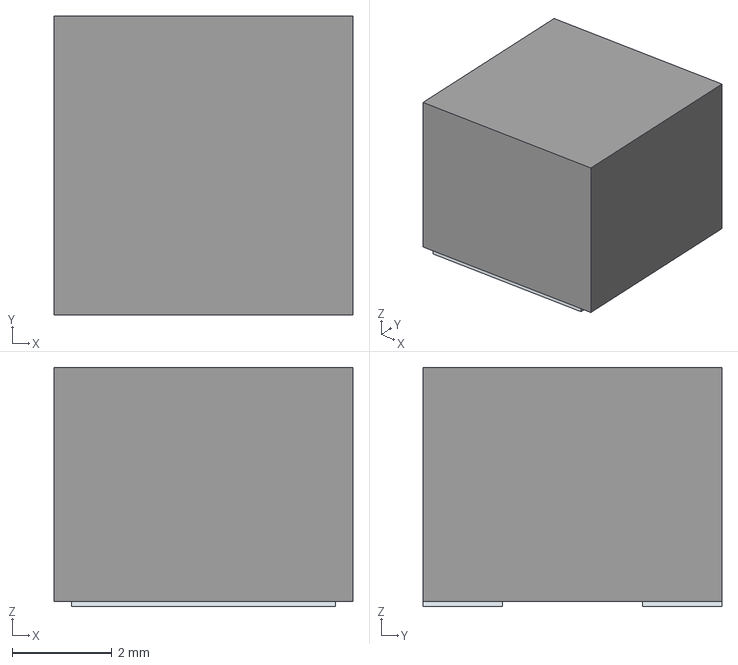
[picture p147: CAD file, 2025-10-08]
MiscLibraries/SDM_Misc3D/BWVS006060454R7ML1.step
6.00 x 6.00 x 4.80 mm
Pins
