sundevilmotorsports/pcb-dev/MiscLibraries/SDM_Misc3D/5007.step

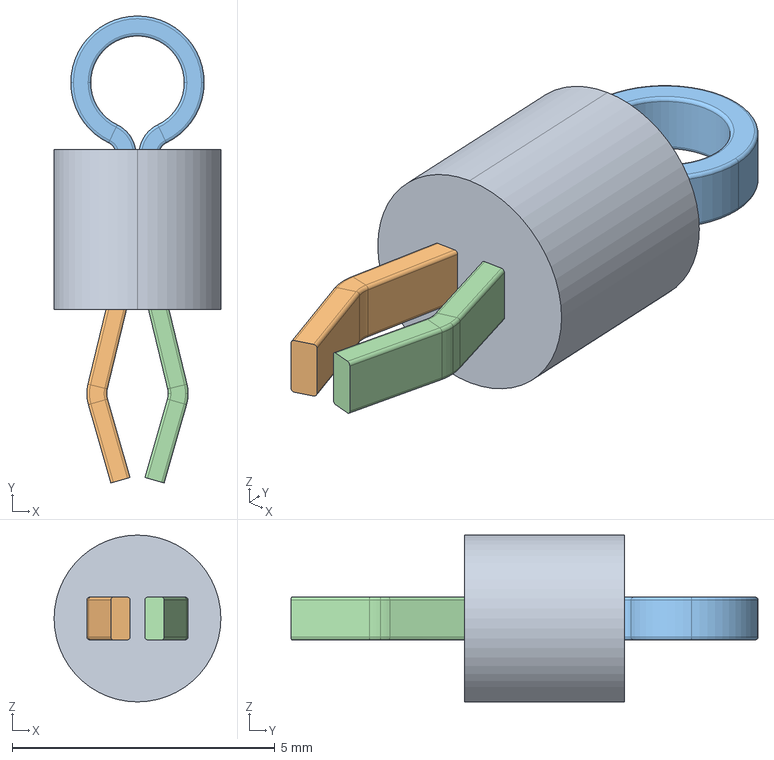
[picture p148: CAD file, 2025-10-08]
MiscLibraries/SDM_Misc3D/5007.step
3.17 x 8.89 x 3.17 mm
