sundevilmotorsports/pcb-dev/MiscLibraries/SDM_Misc3D/BAT54WS-7-F.step

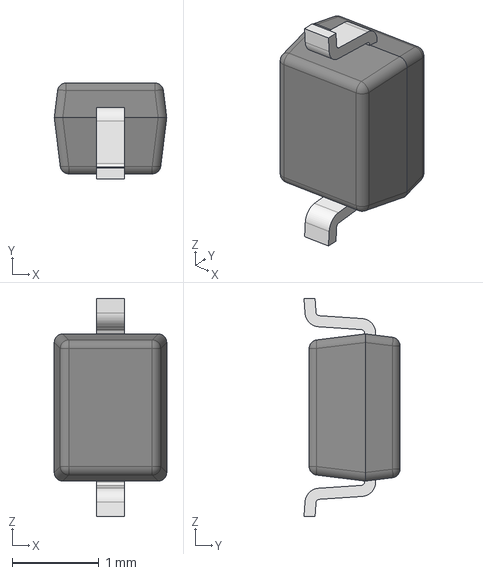
[picture p149: CAD file, 2025-10-08]
MiscLibraries/SDM_Misc3D/BAT54WS-7-F.step
1.30 x 1.11 x 2.52 mm
SOD323-PCB-001
SOD323-LP-001
