sundevilmotorsports/pcb-dev/MiscLibraries/SDM_Misc3D/S5MC-13-F.step

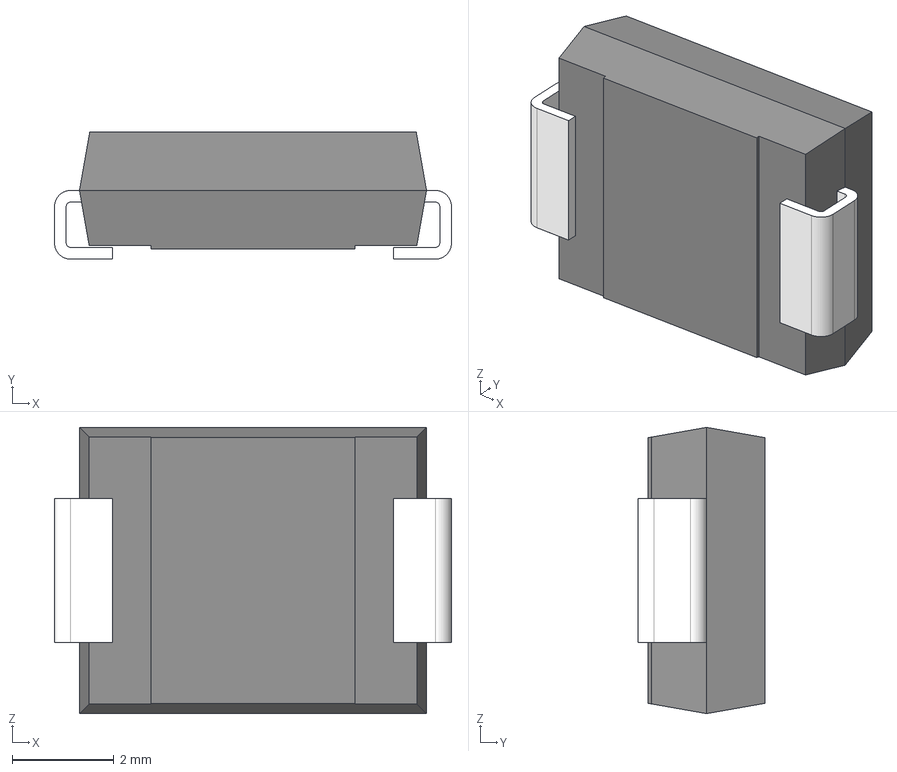
[picture p150: CAD file, 2025-10-08]
MiscLibraries/SDM_Misc3D/S5MC-13-F.step
7.79 x 2.50 x 5.62 mm
SMBJ58CA-13-F_2
SMBJ58CA-13-F
SMBJ58CA-13-F_1
