sundevilmotorsports/pcb-dev/MiscLibraries/SDM_Misc3D/BAT-HLD-001-THM.step

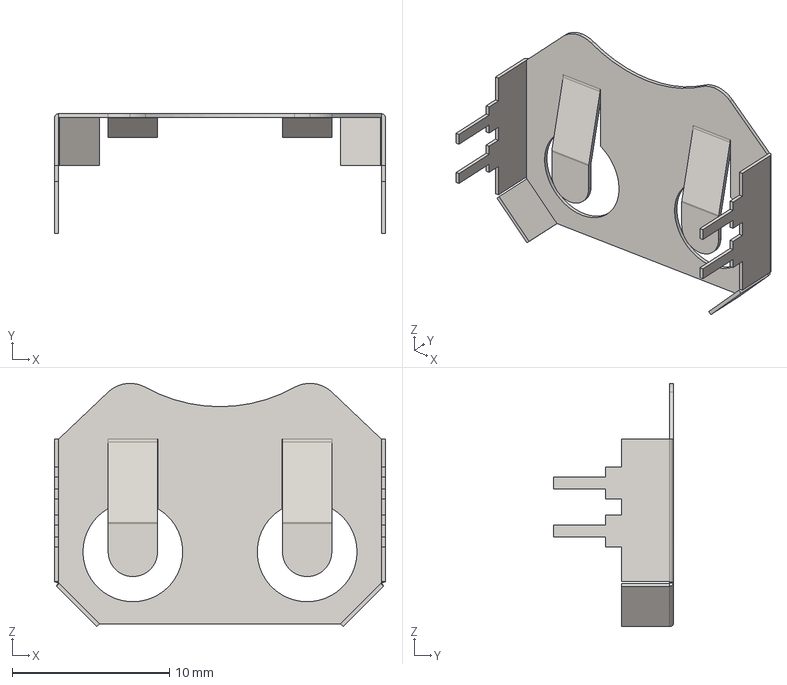
[picture p151: CAD file, 2025-10-08]
MiscLibraries/SDM_Misc3D/BAT-HLD-001-THM.step
21.1 x 7.62 x 15.5 mm
