sundevilmotorsports/pcb-dev/MiscLibraries/SDM_Misc3D/DS3231SN#.step

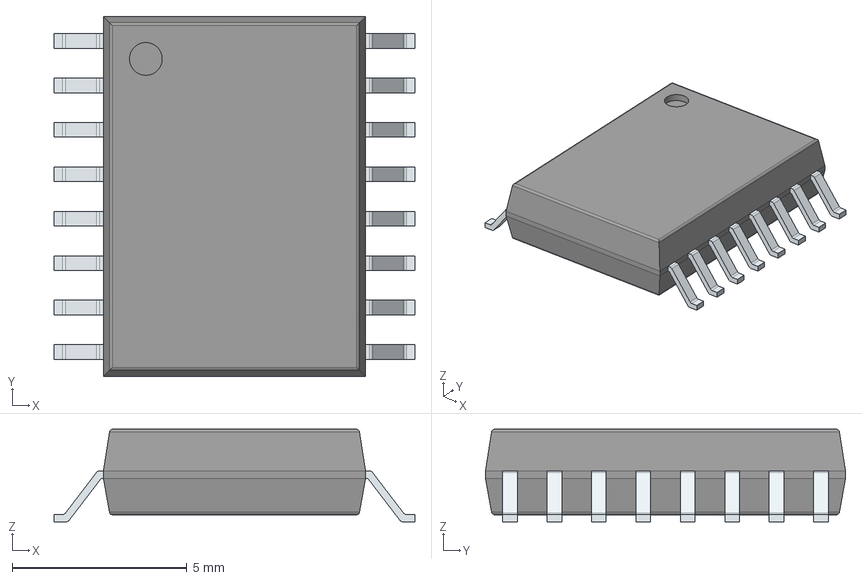
[picture p152: CAD file, 2025-10-08]
MiscLibraries/SDM_Misc3D/DS3231SN#.step
10.3 x 10.3 x 2.65 mm
PinsArrayLR
