sundevilmotorsports/pcb-dev/MiscLibraries/SDM_Misc3D/ESP32-S3-WROOM-1-N8R8.step

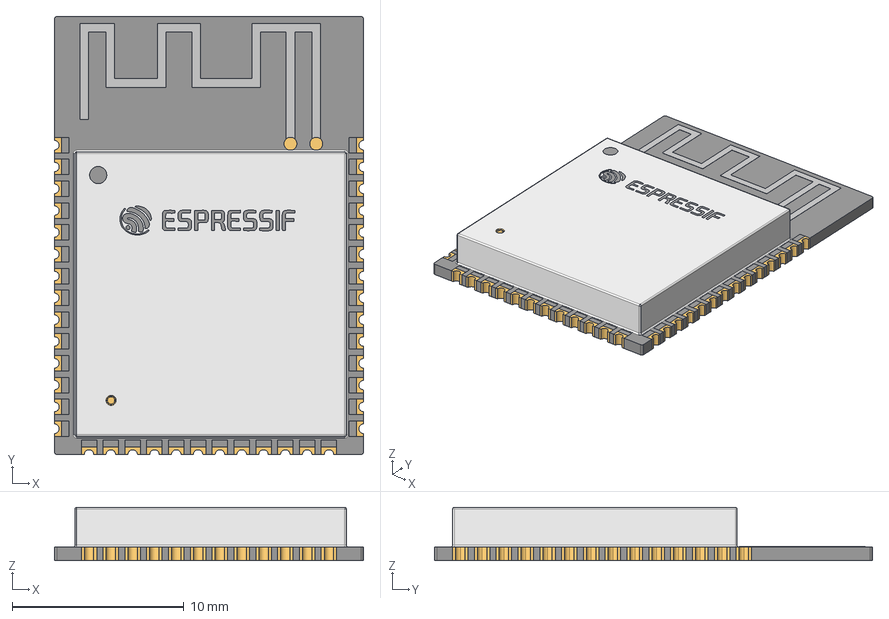
[picture p153: CAD file, 2025-10-08]
MiscLibraries/SDM_Misc3D/ESP32-S3-WROOM-1-N8R8.step
18.0 x 25.5 x 3.10 mm
