sundevilmotorsports/pcb-dev/MiscLibraries/SDM_Misc3D/CP2102N-A02-GQFN28.step

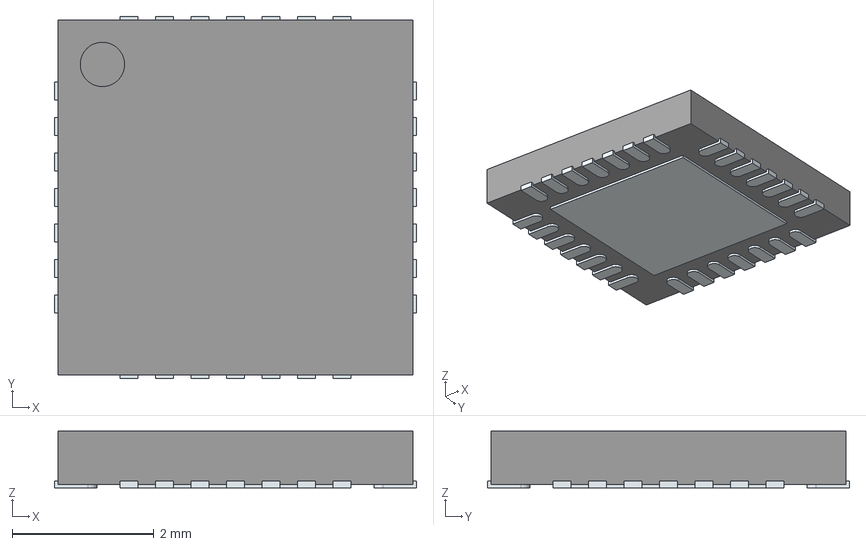
[picture p154: CAD file, 2025-10-08]
MiscLibraries/SDM_Misc3D/CP2102N-A02-GQFN28.step
5.10 x 5.10 x 0.8 mm
ThermalPin
PinsArrayLR
PinsArrayTB
