sundevilmotorsports/pcb-dev/MiscLibraries/SDM_Misc3D/MMBT2222LT1G.step

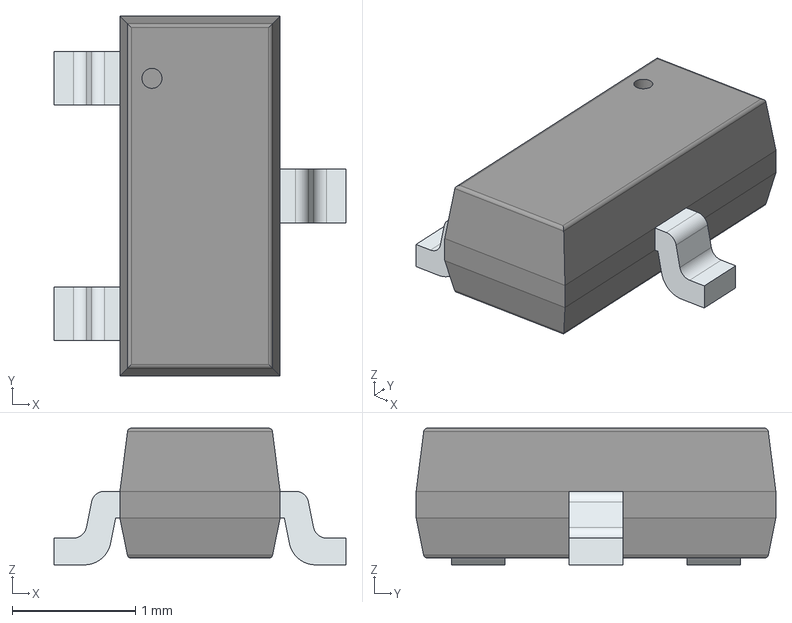
[picture p155: CAD file, 2025-10-08]
MiscLibraries/SDM_Misc3D/MMBT2222LT1G.step
2.37 x 2.92 x 1.11 mm
PinsArrayL
FilletPinR
