sundevilmotorsports/pcb-dev/MiscLibraries/SDM_Misc3D/5008.stp

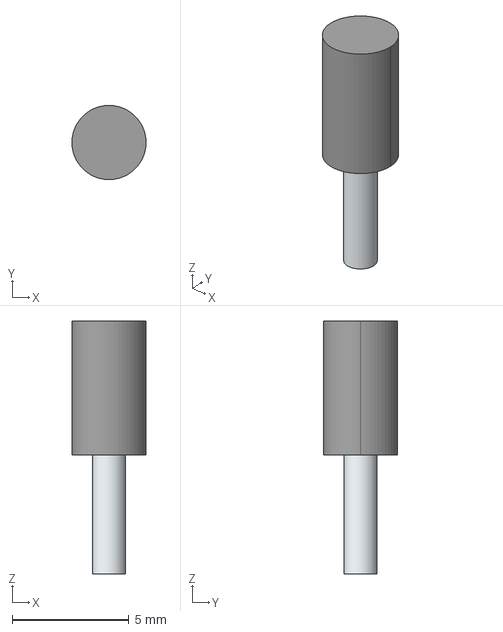
[picture p156: CAD file, 2025-10-08]
MiscLibraries/SDM_Misc3D/5008.stp
3.18 x 3.18 x 10.8 mm
Leads
