sundevilmotorsports/pcb-dev/MiscLibraries/SDM_Misc3D/STM32H743VIT6.step

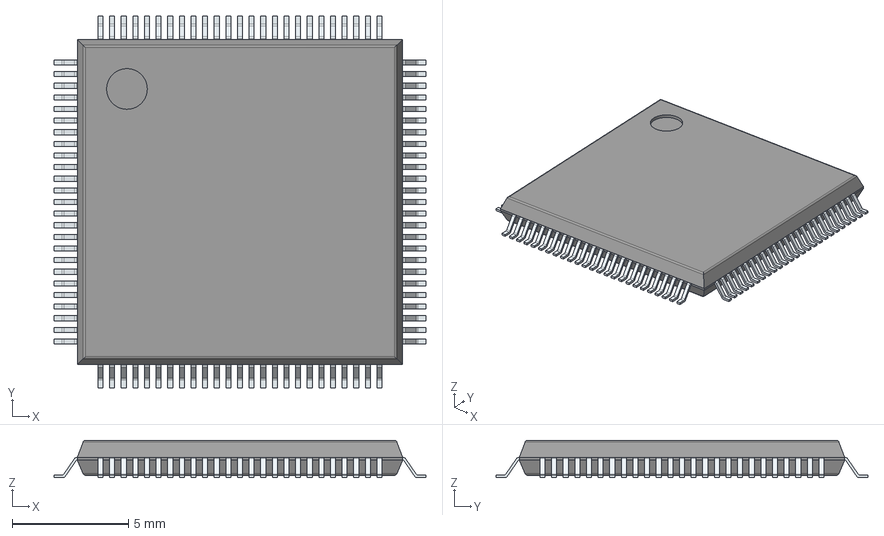
[picture p157: CAD file, 2025-10-08]
MiscLibraries/SDM_Misc3D/STM32H743VIT6.step
16.0 x 16.0 x 1.60 mm
PinsArrayLR
PinsArrayTB
