sundevilmotorsports/pcb-dev/MiscLibraries/SDM_Misc3D/XF2M-4015-1A.step

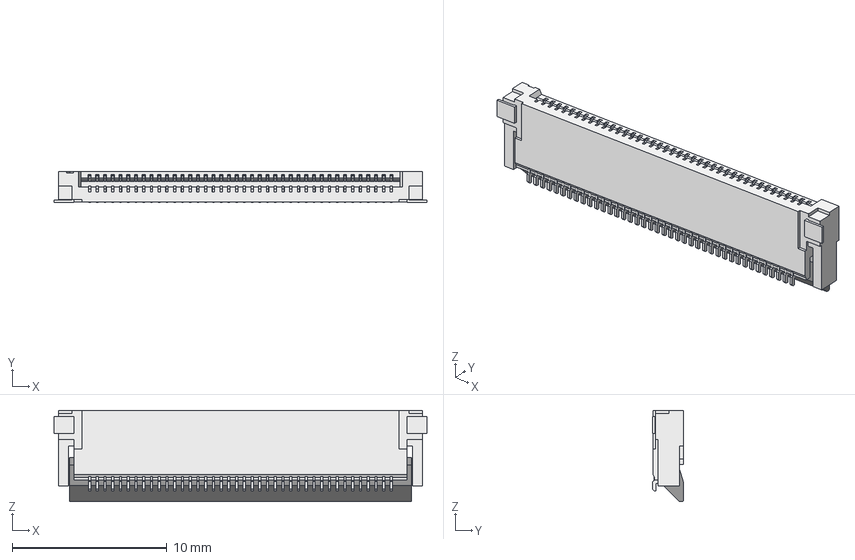
[picture p158: CAD file, 2025-10-08]
MiscLibraries/SDM_Misc3D/XF2M-4015-1A.step
24.1 x 2.00 x 5.90 mm
