sundevilmotorsports/pcb-dev/MiscLibraries/SDM_Misc3D/USB_Micro-B_Molex_47346-0001.step

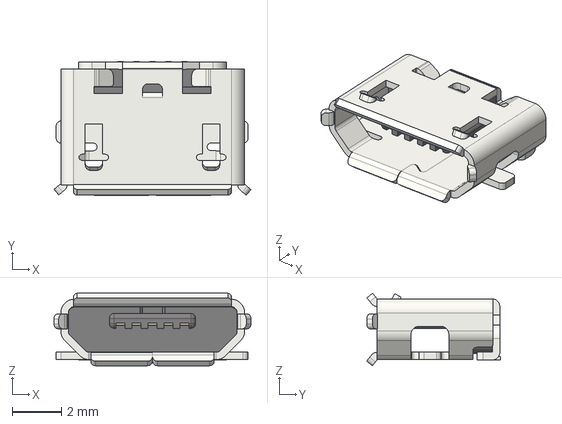
[picture p159: CAD file, 2025-10-08]
MiscLibraries/SDM_Misc3D/USB_Micro-B_Molex_47346-0001.step
7.98 x 5.42 x 2.94 mm
