sundevilmotorsports/pcb-dev/MiscLibraries/SDM_Misc3D/P091N-2QC20BR10K.step

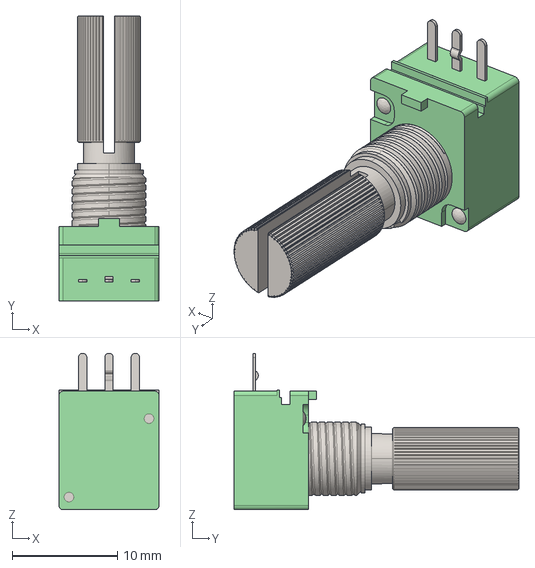
[picture p160: CAD file, 2025-10-08]
MiscLibraries/SDM_Misc3D/P091N-2QC20BR10K.step
9.50 x 27.1 x 14.8 mm
