sundevilmotorsports/pcb-dev/MiscLibraries/SDM_Misc3D/USB_Type_B.stp

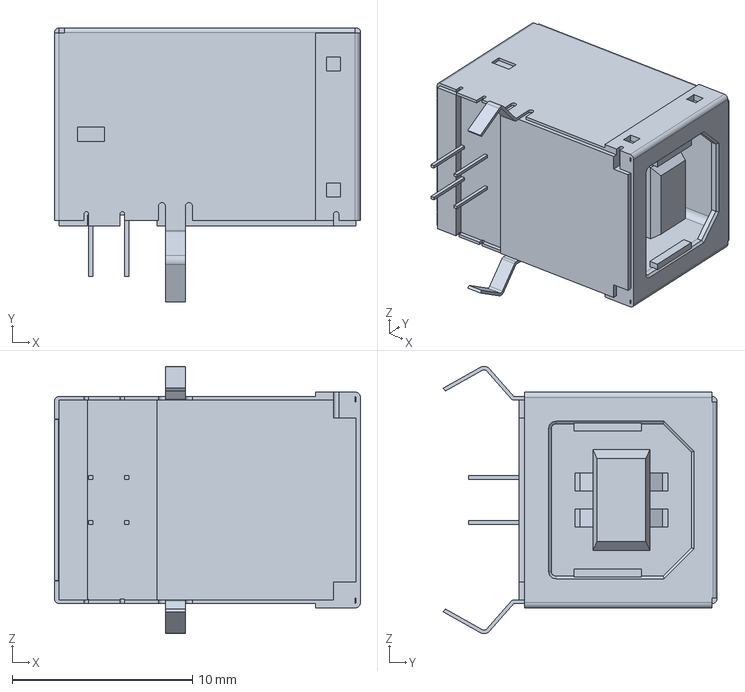
[picture p161: CAD file, 2023-10-13]
MiscLibraries/SDM_Misc3D/USB_Type_B.stp
17.0 x 15.2 x 14.9 mm
