sundevilmotorsports/pcb-dev/(list of files, cad)

Other CAD files:
PRE2026/loggerpanel/loggerpanel PCB.step.SLDPRT
PRE2026/sdm24logger/models/ssf-lxh100lgd.STEP
PRE2026/loggerpanel/loggerpanel PCB_3.step.SLDPRT
PRE2026/sdm25wheel/models/561-1101-100F.STEP
PRE2026/sdm24logger/models/c-1-776087-4-n-3d.stp
MiscLibraries/SDM_Misc3D/USB4730-GF-A.stp
MiscLibraries/SDM_Misc3D/MCP2518FDT-E_SL.step
MiscLibraries/SDM_Misc3D/EMIF06-MSD02N16.step
MiscLibraries/SDM_Misc3D/SN74HC32PWR.step
MiscLibraries/SDM_Misc3D/2N7002,215.step
MiscLibraries/SDM_Misc3D/L7805ACD2T-TR.step
MiscLibraries/SDM_Misc3D/TPS2116DRLR.step
MiscLibraries/SDM_Misc3D/5005.step
MiscLibraries/SDM_Misc3D/ssf-lxh100lgd.STEP
MiscLibraries/SDM_Misc3D/c-1-776087-4-n-3d.stp
MiscLibraries/SDM_Misc3D/1040310811.stp
MiscLibraries/SDM_Misc3D/150060RS75000.step
MiscLibraries/SDM_Misc3D/19428-0011.stp
MiscLibraries/SDM_Misc3D/734120110.stp
MiscLibraries/SDM_Misc3D/776280-1.step
MiscLibraries/SDM_Misc3D/KGD_Models/LM25143QRHARQ1.step
MiscLibraries/SDM_Misc3D/M2_Bolt.STEP
MiscLibraries/SDM_Misc3D/M3_Bolt.STEP
MiscLibraries/SDM_Misc3D/MIC37100-3.3WS.step
MiscLibraries/SDM_Misc3D/MLX90614ESF-BAA-000-SP.step
MiscLibraries/SDM_Misc3D/MLX90640ESF-BAB-000-SP.step
MiscLibraries/SDM_Misc3D/MLX90642ESF-BCA-000-SP.step
MiscLibraries/SDM_Misc3D/TPS259250DRCR.step
MiscLibraries/SDM_Misc3D/TPS26750SRSMR.step
MiscLibraries/SDM_Misc3D/TPS542951RSAR.stp
MiscLibraries/SDM_Misc3D/TPS62901RPJR.stp
PRE2026/ONVEHICLE/82720Mold_SS.stp
PRE2026/loggerpanel/loggerpanel-B_Silkscreen.dxf
PRE2026/loggerpanel/loggerpanel-F_Silkscreen.dxf
PRE2026/mpcm/GG040205170N2P.SLDPRT
PRE2026/mpcm/GG040205170N2P.STEP
PRE2026/old/sdm24wheel/models/561-1101-100F.SLDPRT
PRE2026/old/sdm24wheel/models/561-1101-100F.STEP
PRE2026/old/sdm24wheel/models/561-1301-100F.SLDPRT
PRE2026/old/sdm24wheel/models/5x3-2mm.SLDPRT
PRE2026/old/sdm24wheel/models/SOD-123FL.SLDPRT
PRE2026/old/sdm24wheel/models/mlx90614.SLDPRT
PRE2026/old/sdm24wheel/models/mlx90614.STEP
PRE2026/old/yaw_probe_stm32/629105150521 (rev1).stp
PRE2026/sdm24logger/models/1040310811.stp
PRE2026/sdm24logger/models/472192001.stp
PRE2026/sdm24logger/models/734120110.stp
PRE2026/sdm24logger/models/ssf-lxh100lgd.SLDPRT
PRE2026/sdm24logger/models/ssf-lxh100lid.SLDPRT
PRE2026/sdm25wheel/models/561-1101-100F.SLDPRT
PRE2026/sdm25wheel/models/561-1301-100F.SLDPRT
PRE2026/sdm25wheel/models/5x3-2mm.SLDPRT
PRE2026/sdm25wheel/models/SOD-123FL.SLDPRT
PRE2026/sdm25wheel/models/mlx90614.SLDPRT
PRE2026/sdm25wheel/models/mlx90614.STEP
yaw_probe_stm32/629105150521 (rev1).stp
