sundevilmotorsports/pcb-dev/PRE2026/IMUBox/assembly/IMUBox-F_Fab.pdf

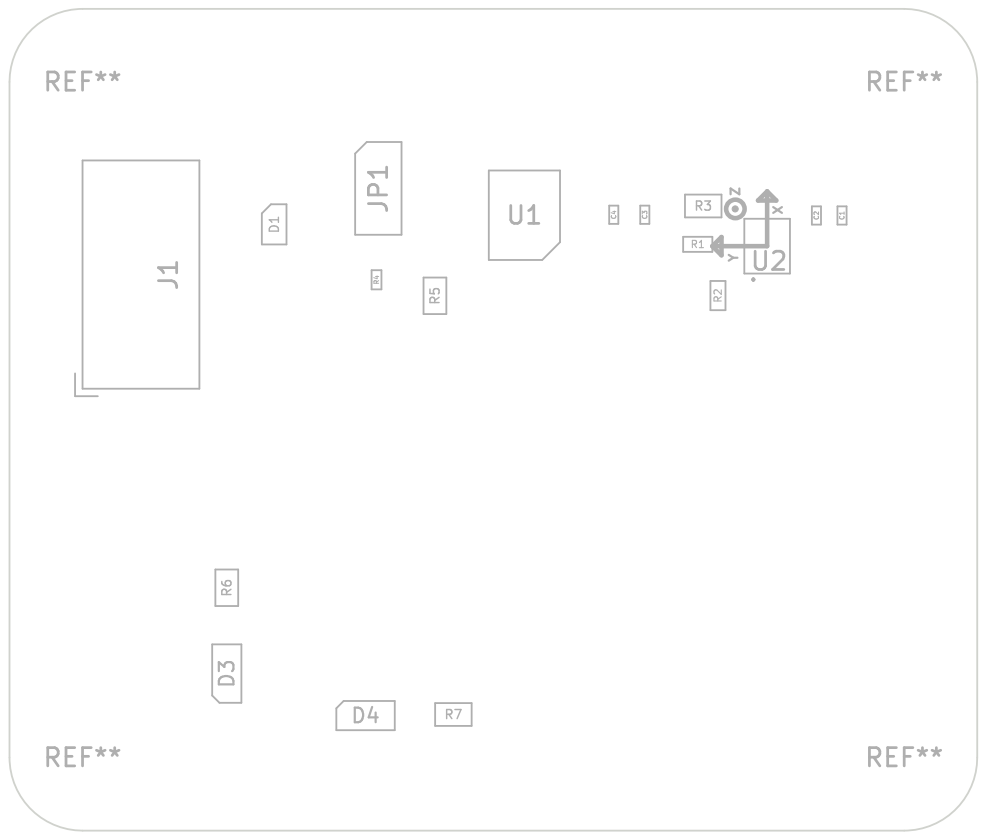
[picture p162: page 1]

Y R3 R7 REF** D1 D3 REF** REF** R4 REF**

Id: 1/1 Title: IMU Box
