sundevilmotorsports/pcb-dev/PRE2026/sdm24logger/assembly/sdm24logger-FB_Cu.pdf

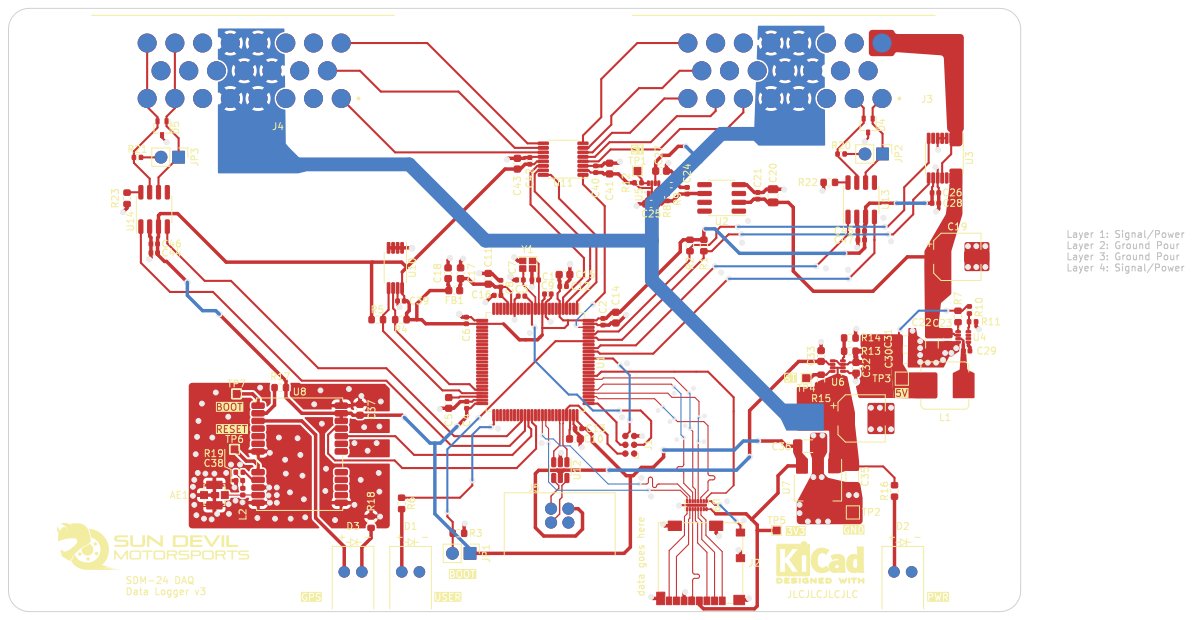
[picture p163: page 1]

Layer 1: Signal/Power Layer 2: Ground Pour Layer 3: Ground Pour Layer 4: Signal/Power
