sundevilmotorsports/pcb-dev/PRE2026/sdm24logger/assembly/sdm24logger.pdf

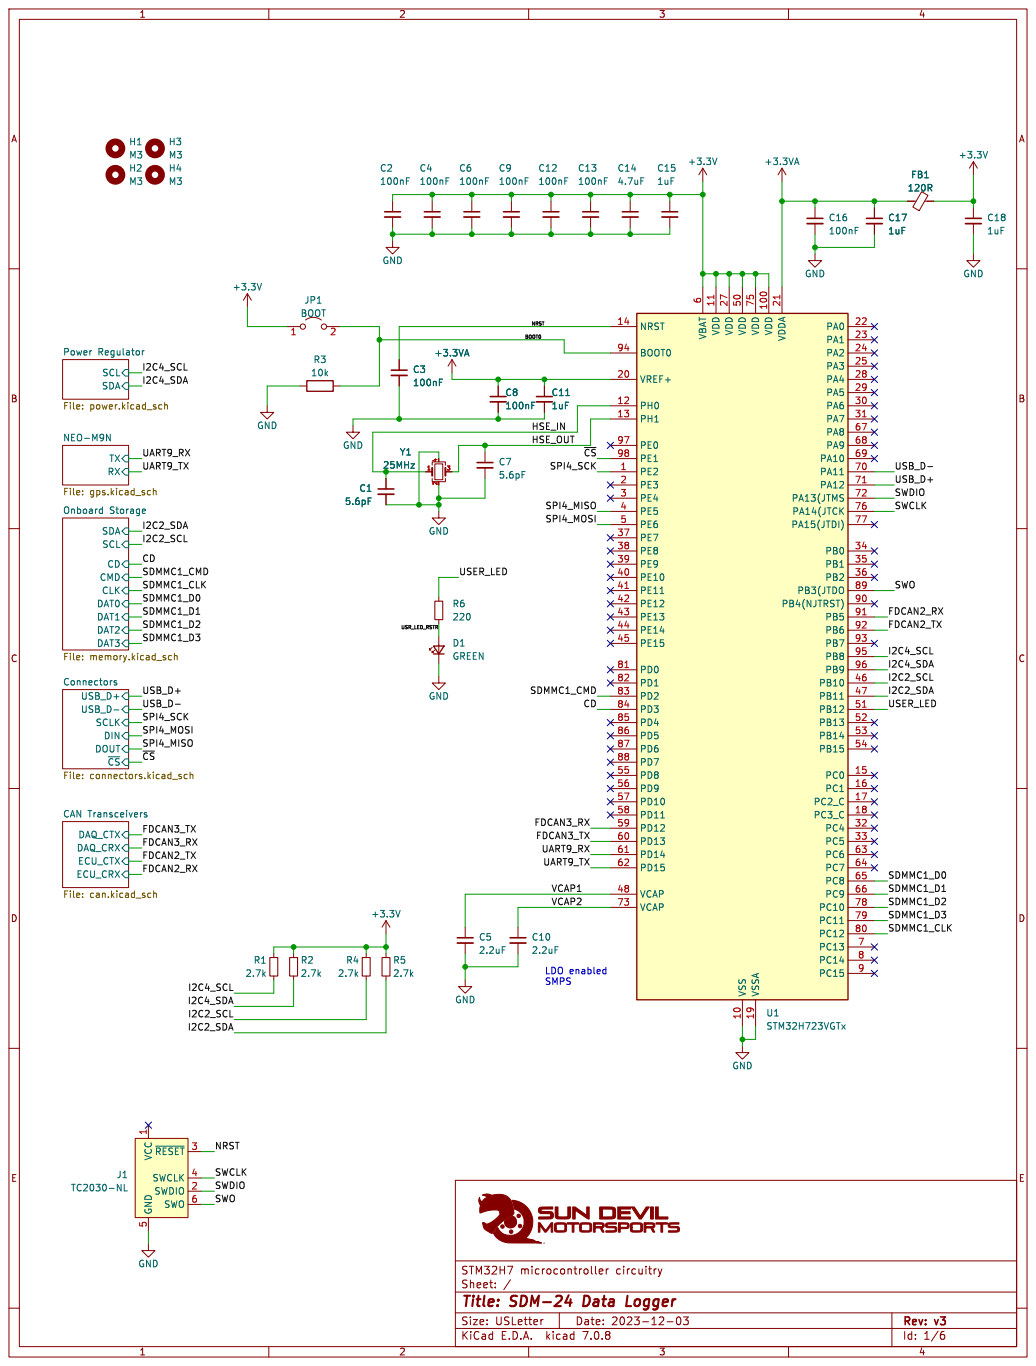
[picture p164: page 1]

Power Regulator File: power.kicad_sch USB_D+ USB_D- SCLK DIN
DAT3 CLK DAT1 DAT0 SCL CD Onboard Storage File: memory.kicad_sch SCL SDA

~{CS} Connectors File: connectors.kicad_sch DAQ_CTX DAQ_CRX

ECU_CRX CAN Transceivers File: can.kicad_sch

1 SWDIO 2 ~{RESET}3 SWCLK 4 GND
GNDVCC

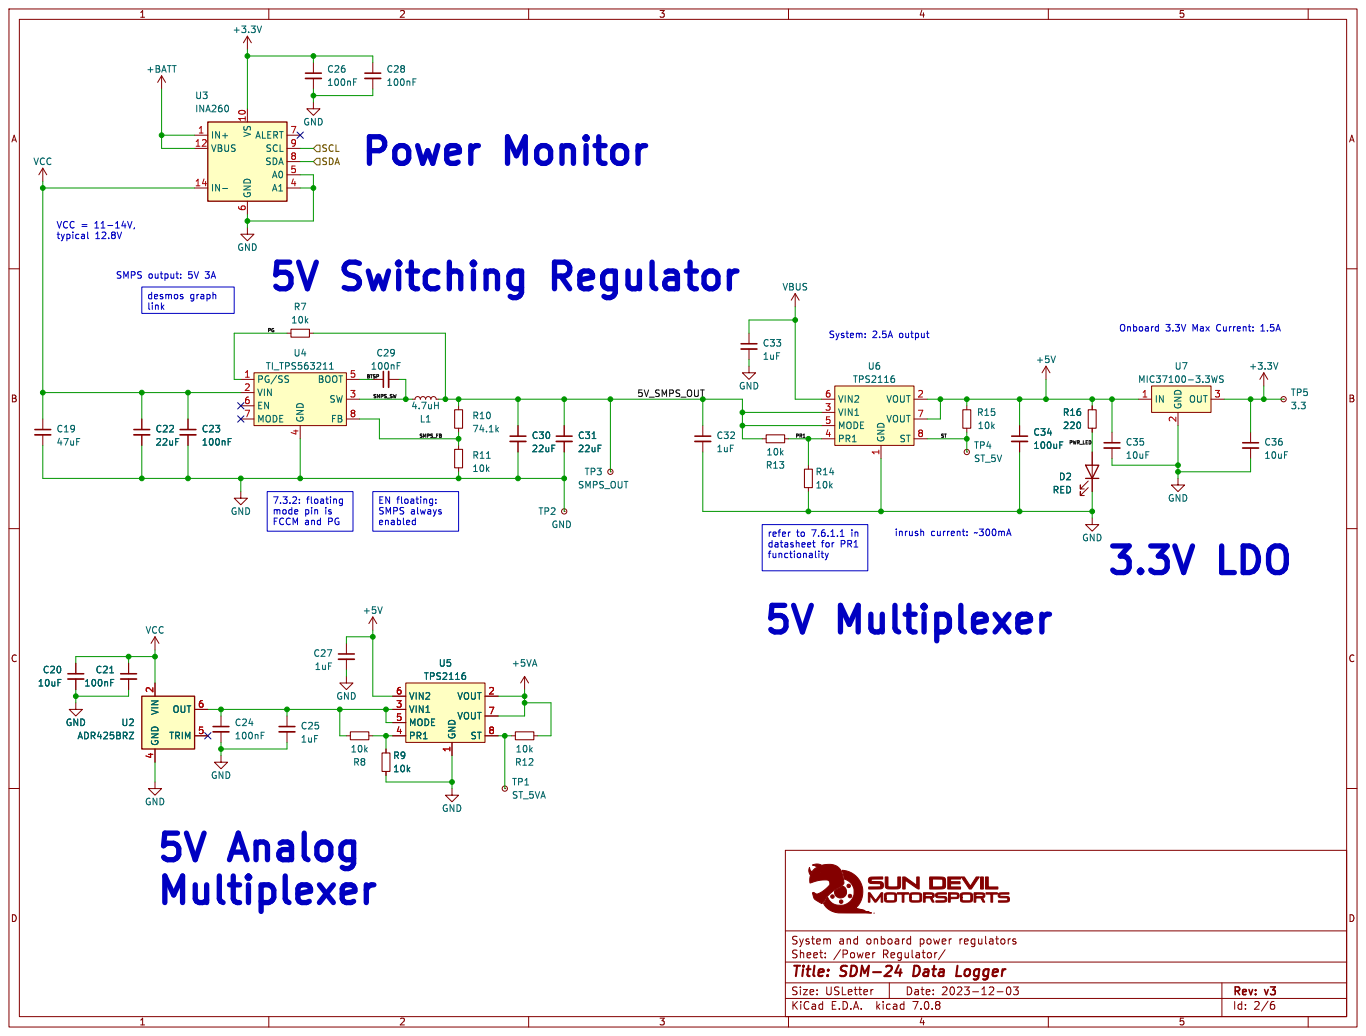
[picture p165: page 2]

4 BOOT 5 EN 6 MODE 7 FB 8 U4 TI_TPS563211 R7

1 VOUT 2 VIN1 3 PR1 4 MODE 5 VIN2 6 VOUT 7 ST 8 U6 TPS2116 +5V C24

functionality 7.3.2: floating mode pin is FCCM and PG

EN floating: SMPS always enabled

1 VOUT 2 VIN1 3 PR1 4 MODE 5 VIN2 6 VOUT 7 ST 8 U5 TPS2116 R9

1 VOUT 2 VIN1 3 PR1 4 MODE 5 VIN2 6 VOUT 7 ST 8 R9

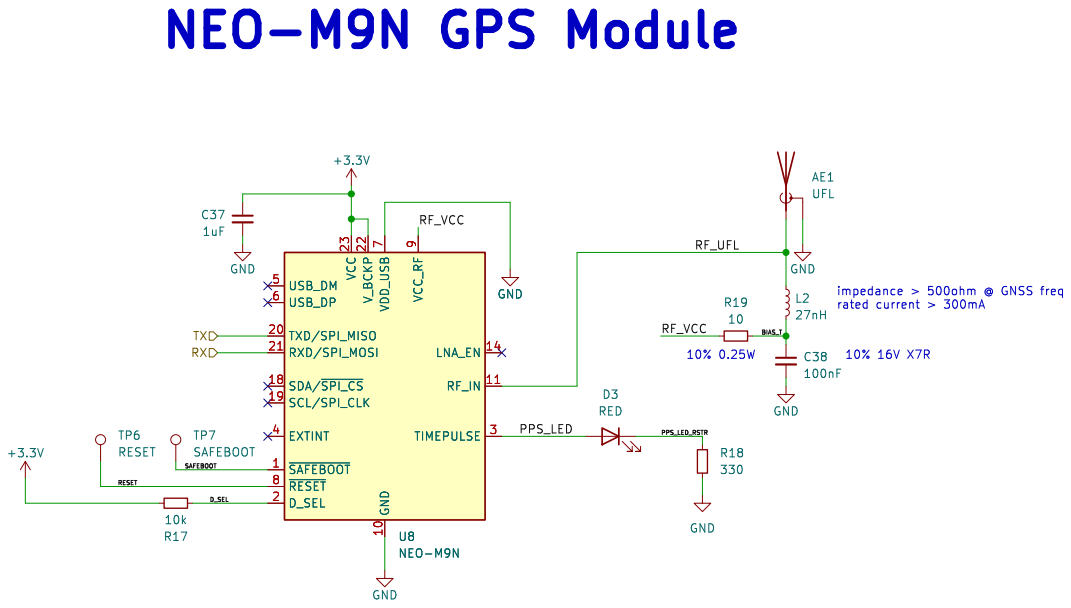
[picture p166: page 3]

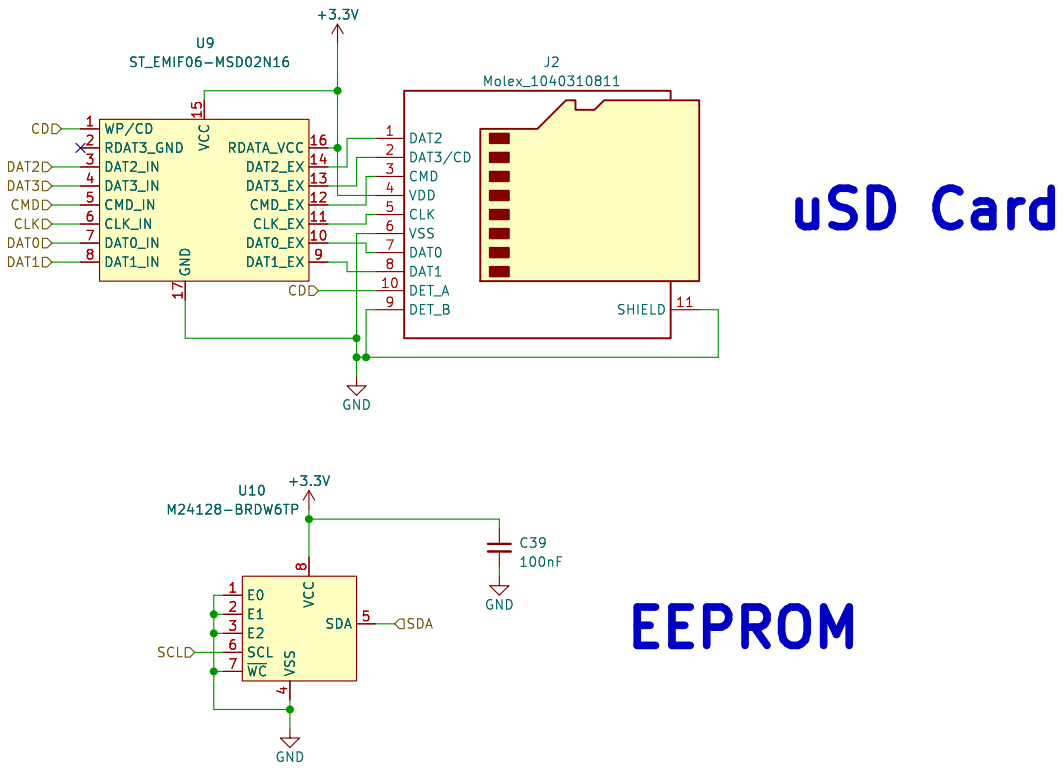
[picture p167: page 4]

8 +3.3V U9 ST_EMIF06-MSD02N16 WP/CD 1 DAT0_EX 10 CLK_EX 11 CMD_EX 12 DAT3_EX 13 DAT2_EX 14 VCC 15 RDATA_VCC16 GND 17 RDAT3_GND 2 DAT2_IN 3 DAT3_IN 4 CMD_IN 5 CLK_IN 6 DAT0_IN 7 DAT1_IN 8 DAT1_EX 9+3.3V

8 U10 M24128-BRDW6TP DAT2 1 DET_A 10 SHIELD 11 DAT3/CD 2 CMD 3 VDD 4 CLK 5 VSS 6 DAT0 7 DAT1 8 DET_B 9

4 SDA 5 SCL 6 ~{WC} 7 VCC

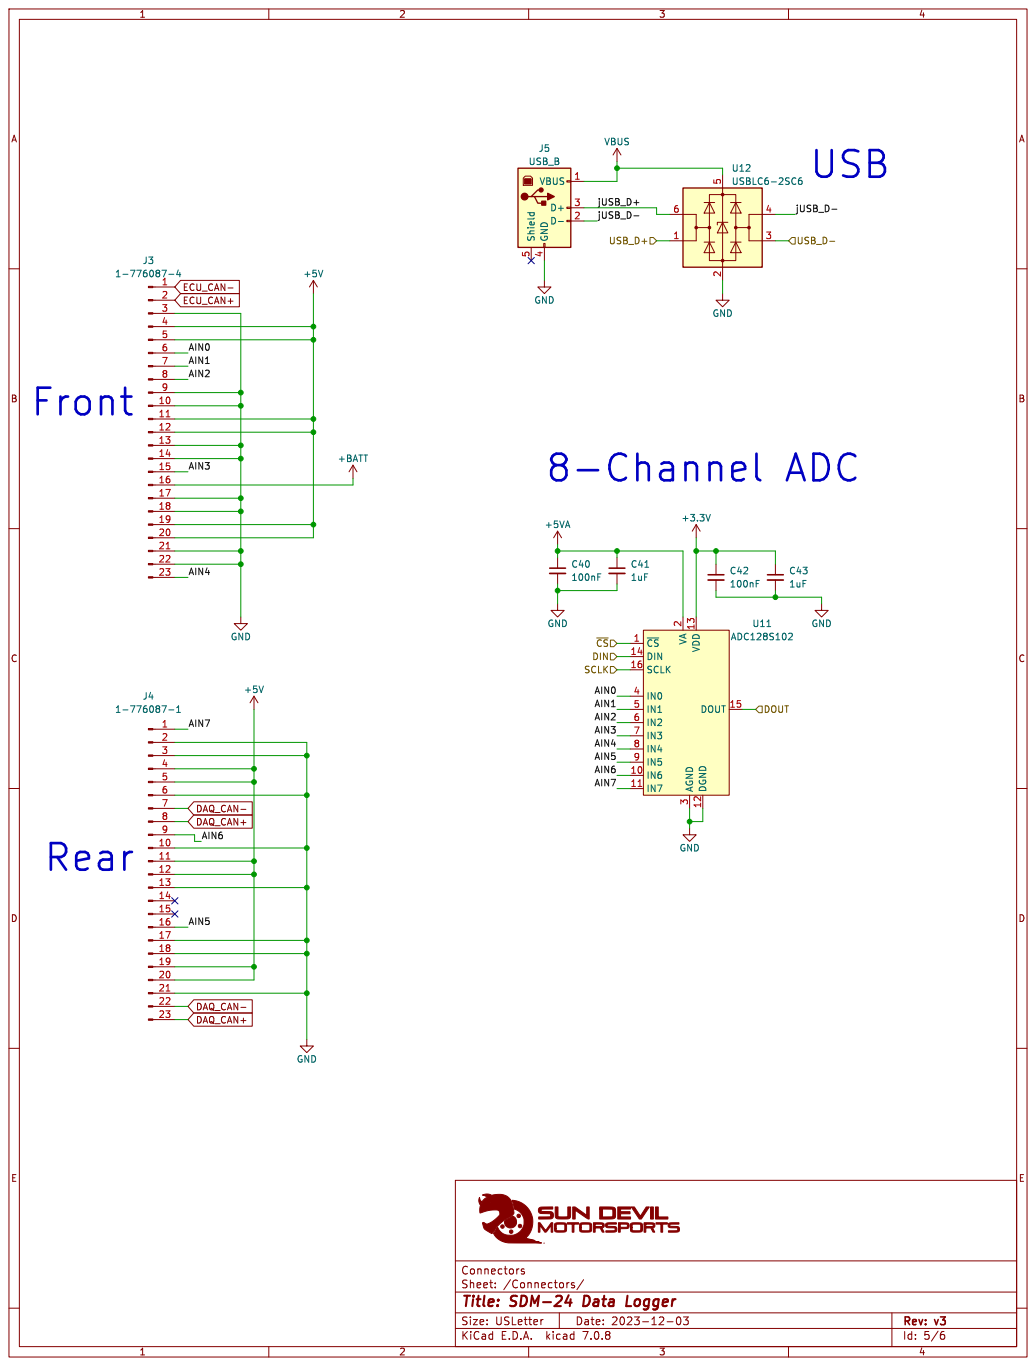
[picture p168: page 5]

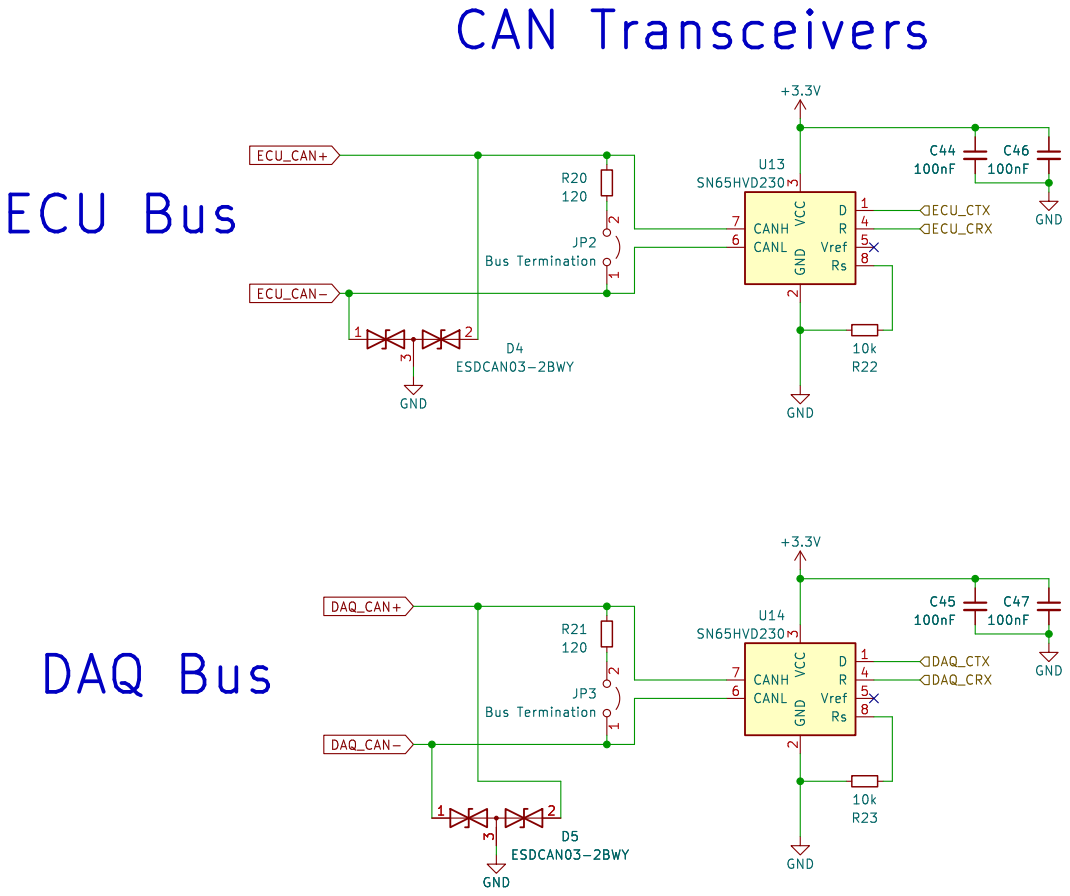
[picture p169: page 6]
