sundevilmotorsports/pcb-dev/PRE2026/cansplitter/info/cansplitter.pdf

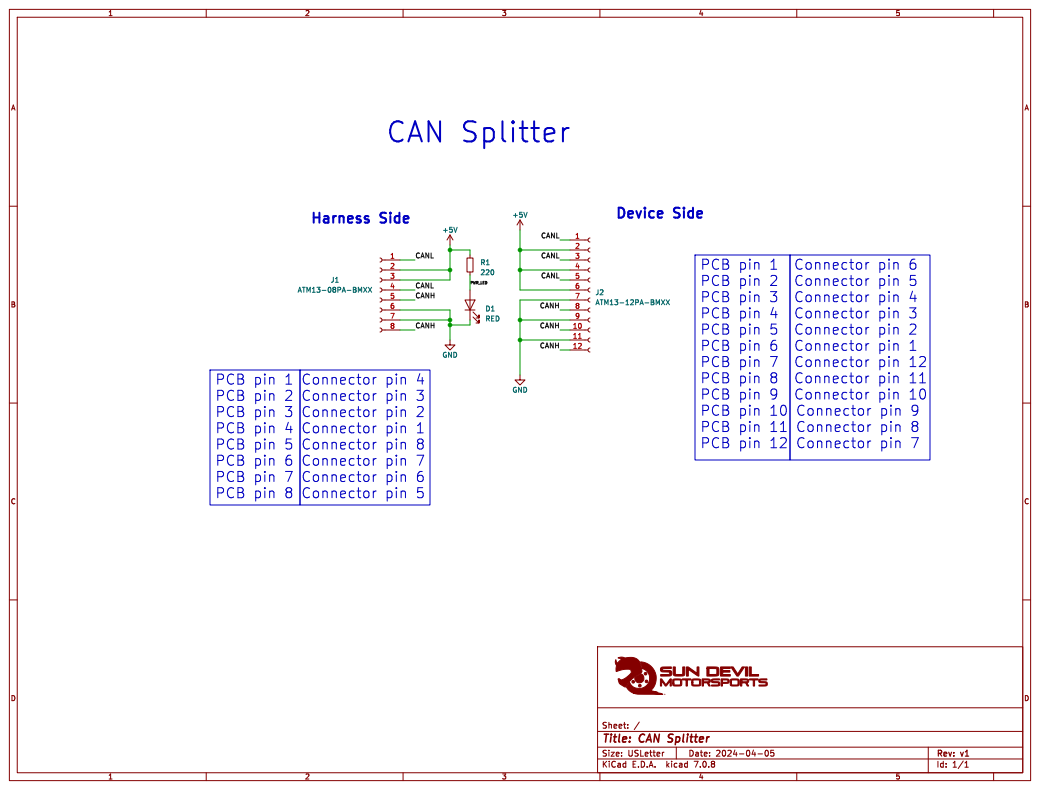
[picture p170: page 1]

PCB pin 6 Connector pin 7
PCB pin 7 Connector pin 6
PCB pin 8 Connector pin 5

Id: 1/1 Title: CAN Splitter Sheet: / GND
