sundevilmotorsports/pcb-dev/PRE2026/sdm25wheel/assembly/sdm24wheel-B_Fab-pads.pdf

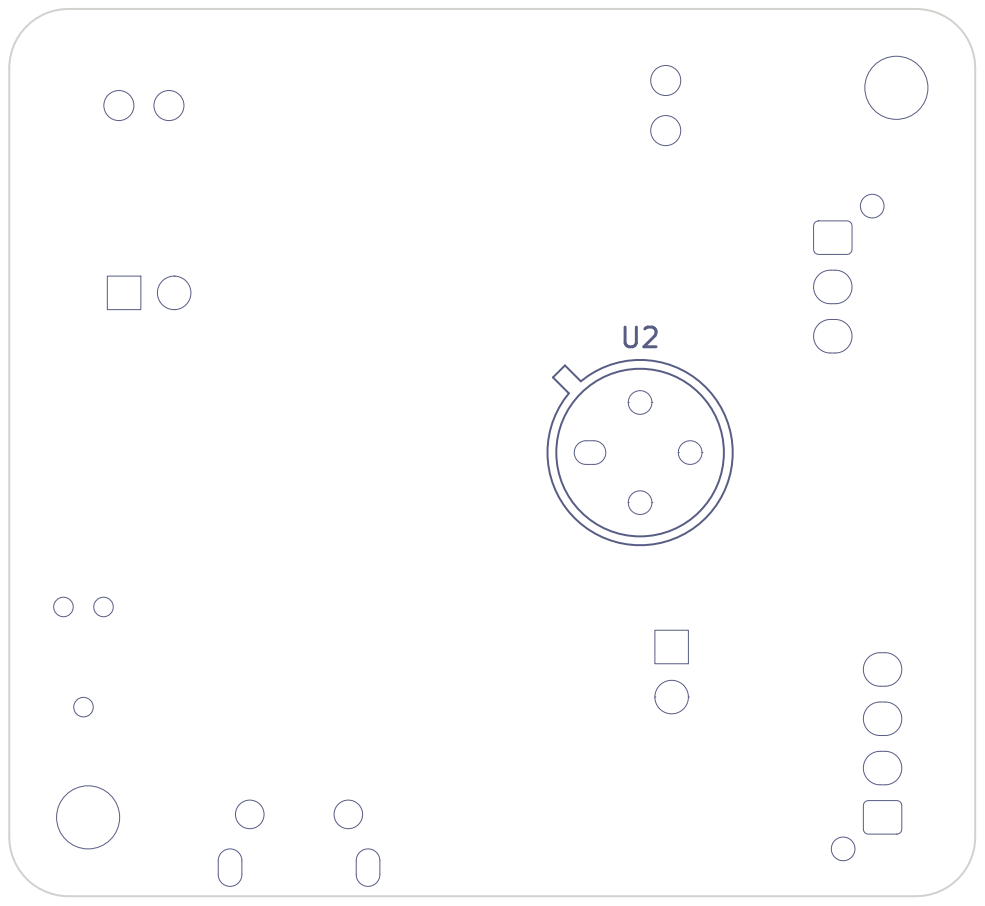
[picture p171: page 1]
