sundevilmotorsports/pcb-dev/PRE2026/sdm25wheel/assembly/sdm24wheel-B_Fab.pdf

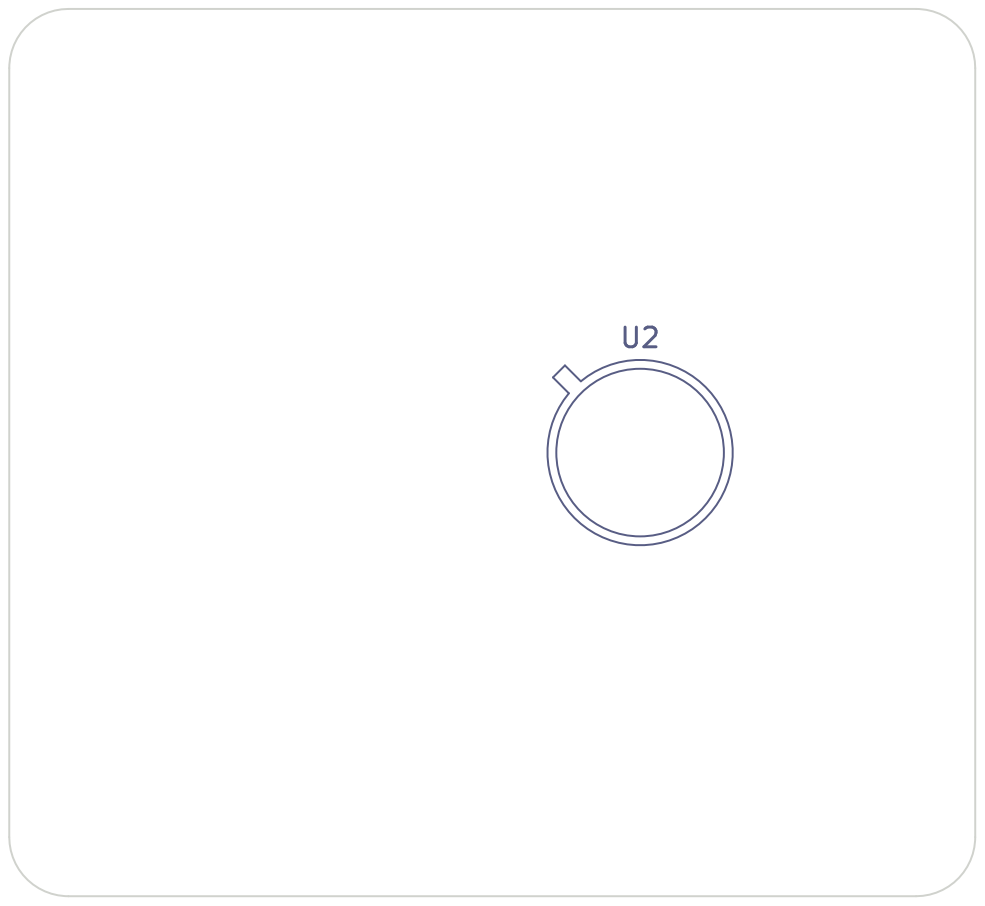
[picture p172: page 1]
