sundevilmotorsports/pcb-dev/PRE2026/sdm25wheel/assembly/sdm24wheel-F_Fab-pads.pdf

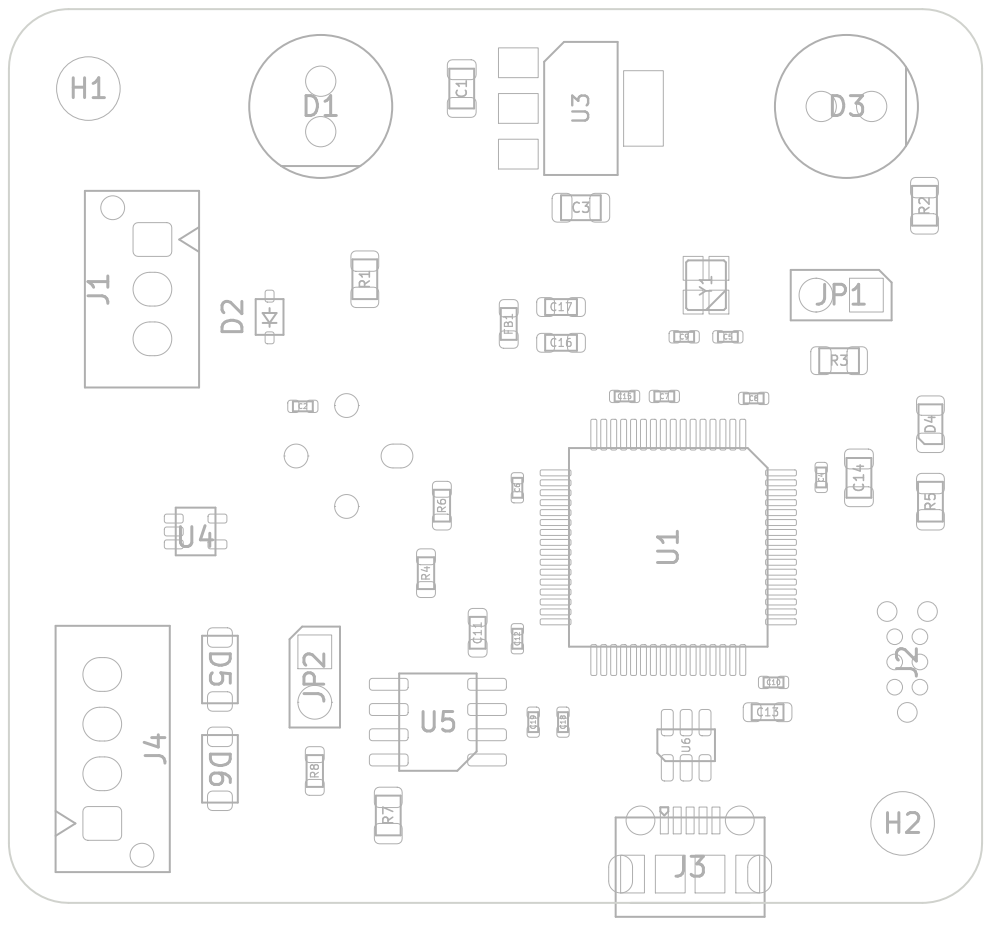
[picture p173: page 1]
