sundevilmotorsports/pcb-dev/PRE2026/sdm25wheel/assembly/sdm24wheel-F_Fab.pdf

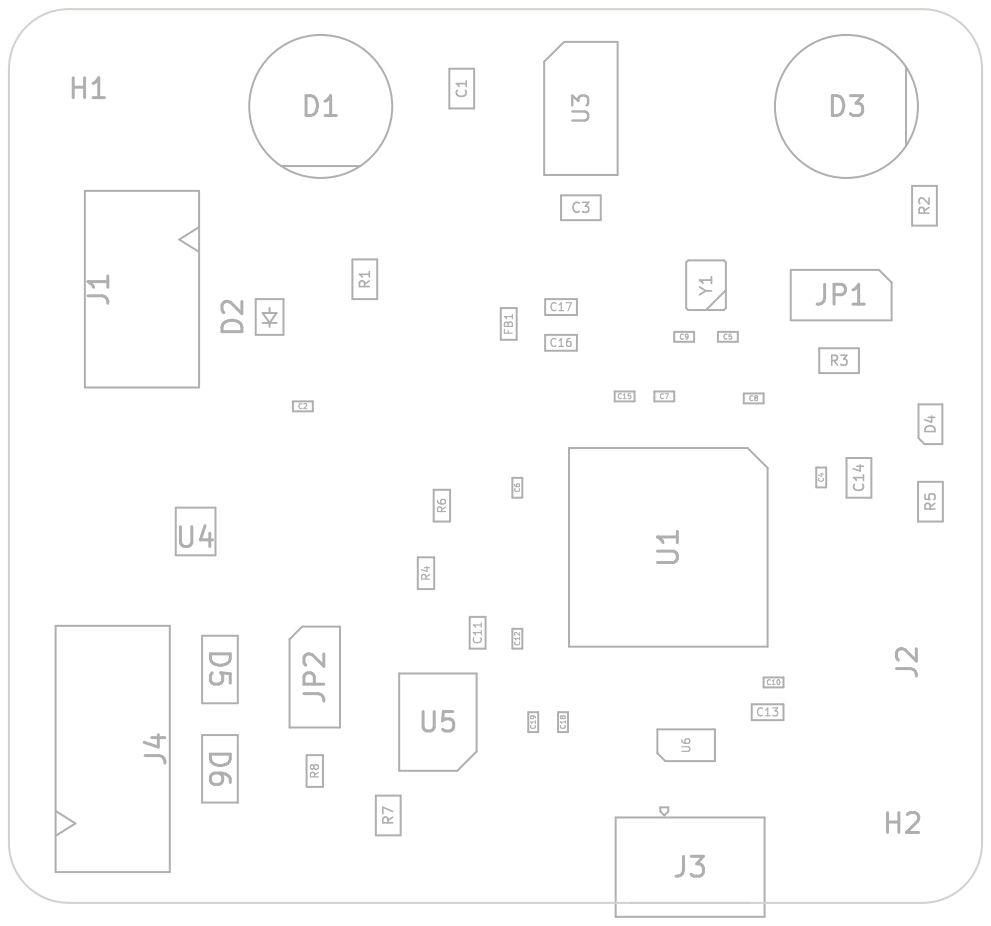
[picture p174: page 1]
