sundevilmotorsports/pcb-dev/PRE2026/wheelspeed/assembly/wheelspeed-B_Fab-pads.pdf

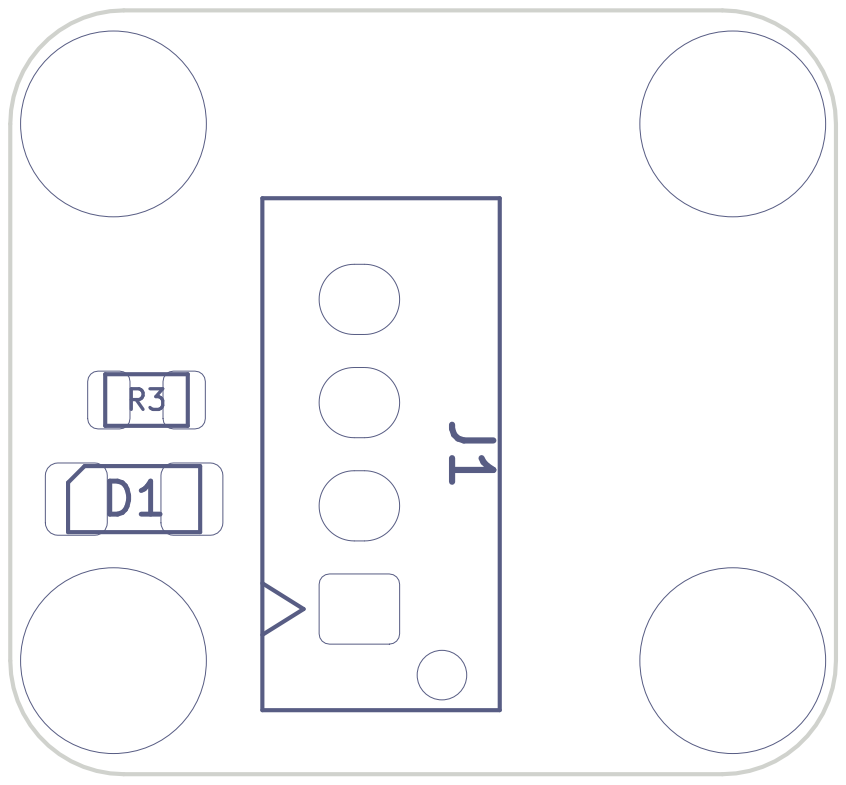
[picture p175: page 1]
