sundevilmotorsports/pcb-dev/PRE2026/wheelspeed/assembly/wheelspeed-B_Fab.pdf

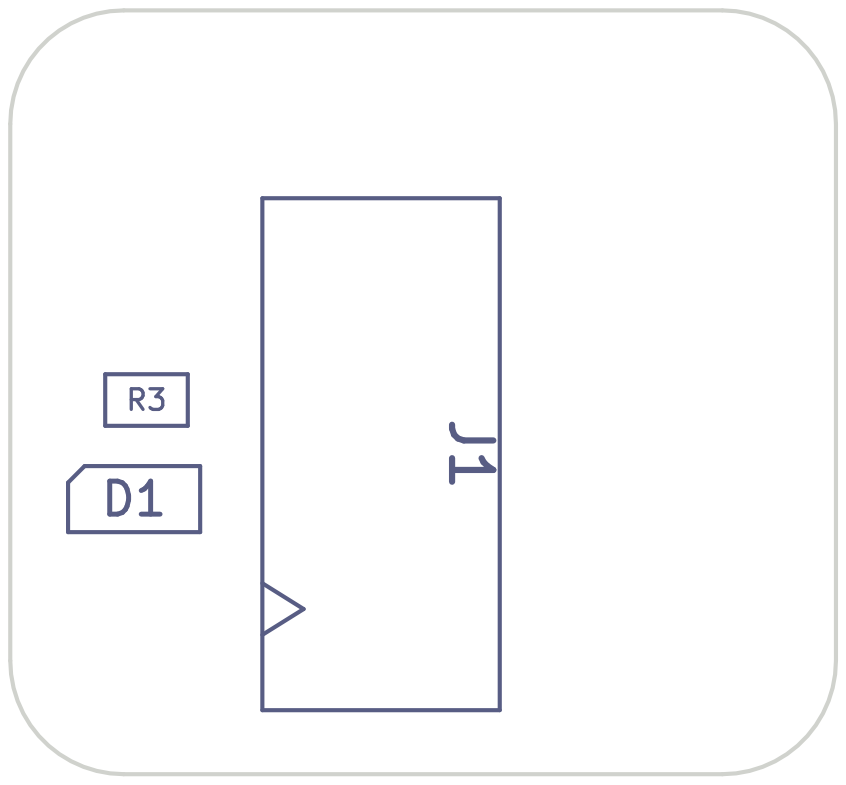
[picture p176: page 1]
