sundevilmotorsports/pcb-dev/PRE2026/wheelspeed/assembly/wheelspeed-F_Fab-pads.pdf

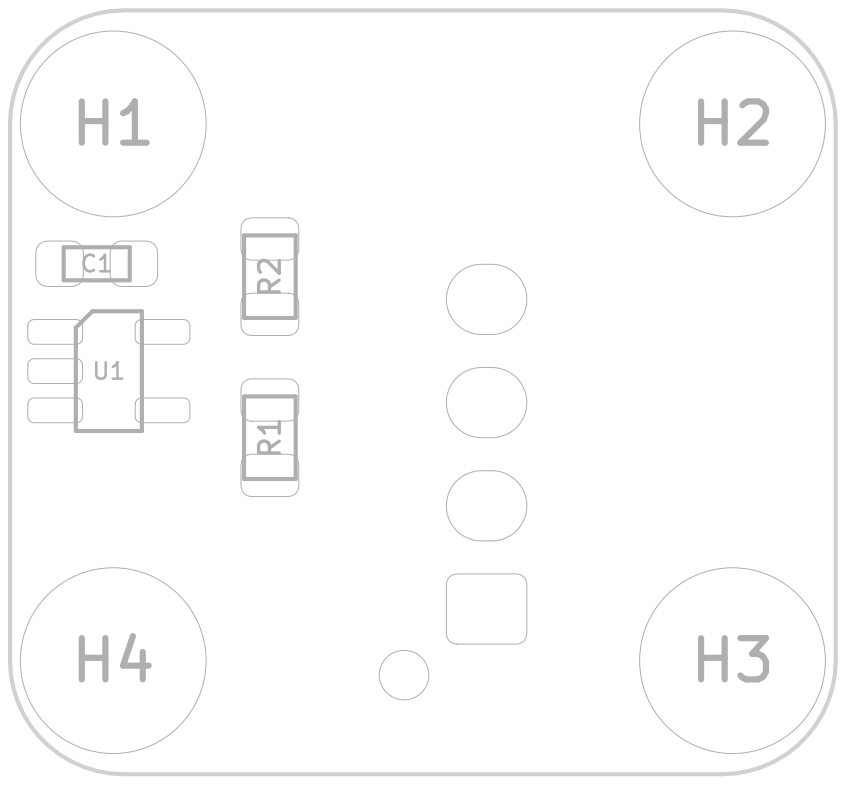
[picture p177: page 1]
