sundevilmotorsports/pcb-dev/PRE2026/wheelspeed/assembly/wheelspeed-F_Fab.pdf

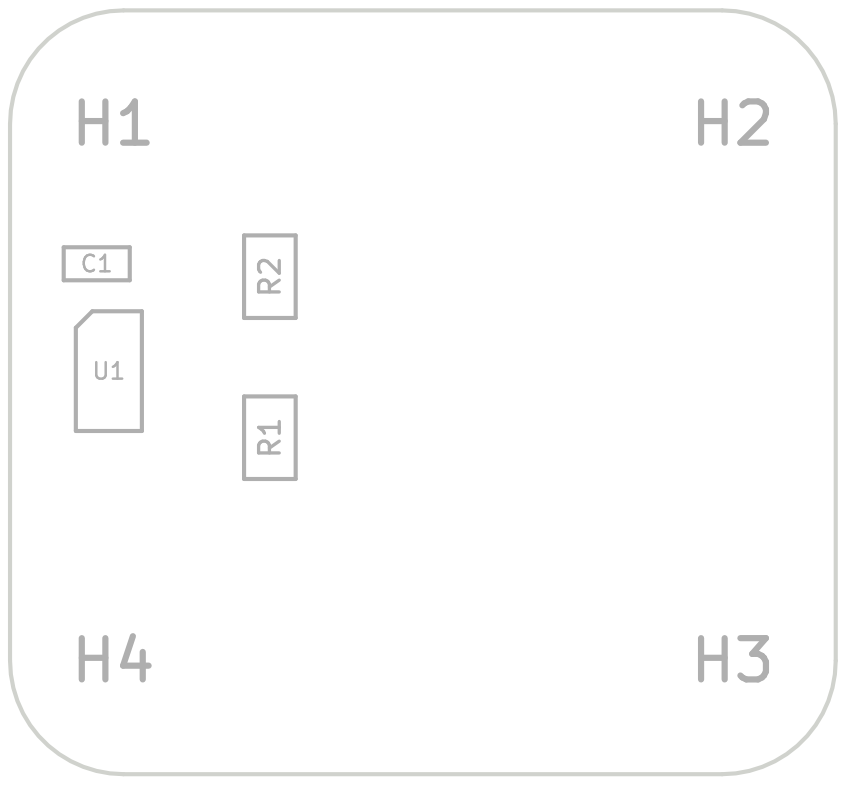
[picture p178: page 1]
