sundevilmotorsports/pcb-dev/PRE2026/sdm24logger/assembly/sdm24logger-B_Cu.pdf

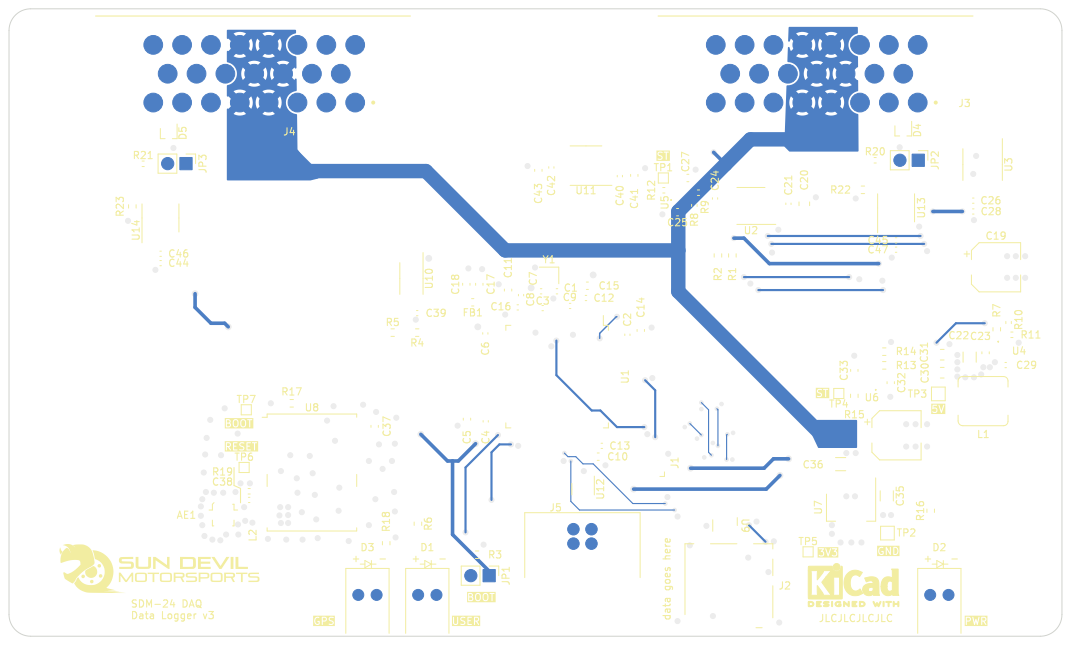
[picture p179: page 1]
