sundevilmotorsports/pcb-dev/PRE2026/sdm24logger/assembly/sdm24logger-F_Cu.pdf

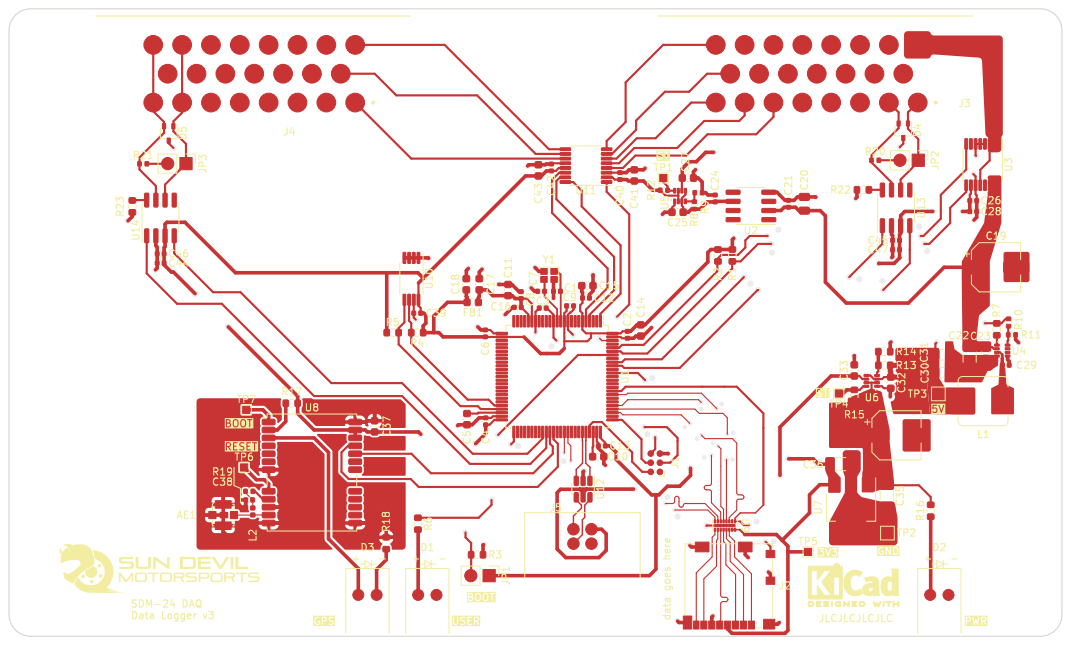
[picture p180: page 1]
