sundevilmotorsports/pcb-dev/PRE2026/sdm24logger/assembly/sdm24logger-F_Fab-pads.pdf

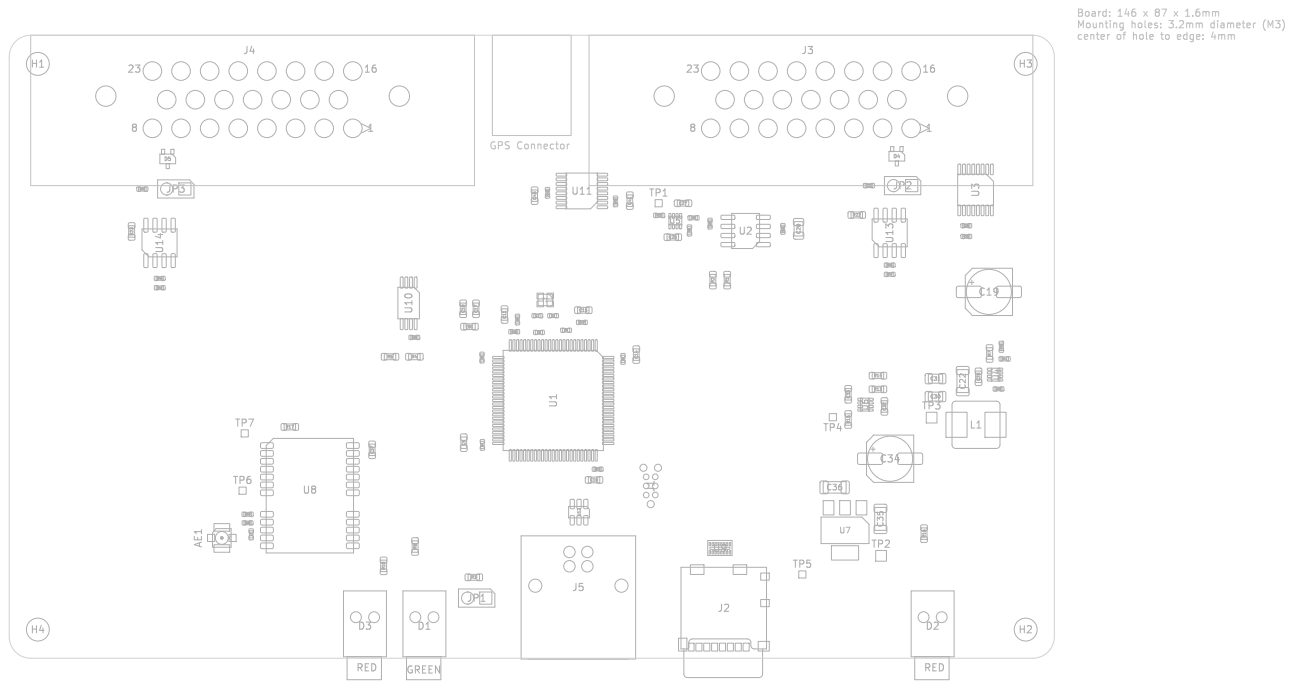
[picture p181: page 1]
