sundevilmotorsports/pcb-dev/PRE2026/sdm24logger/assembly/sdm24logger-F_Fab.pdf

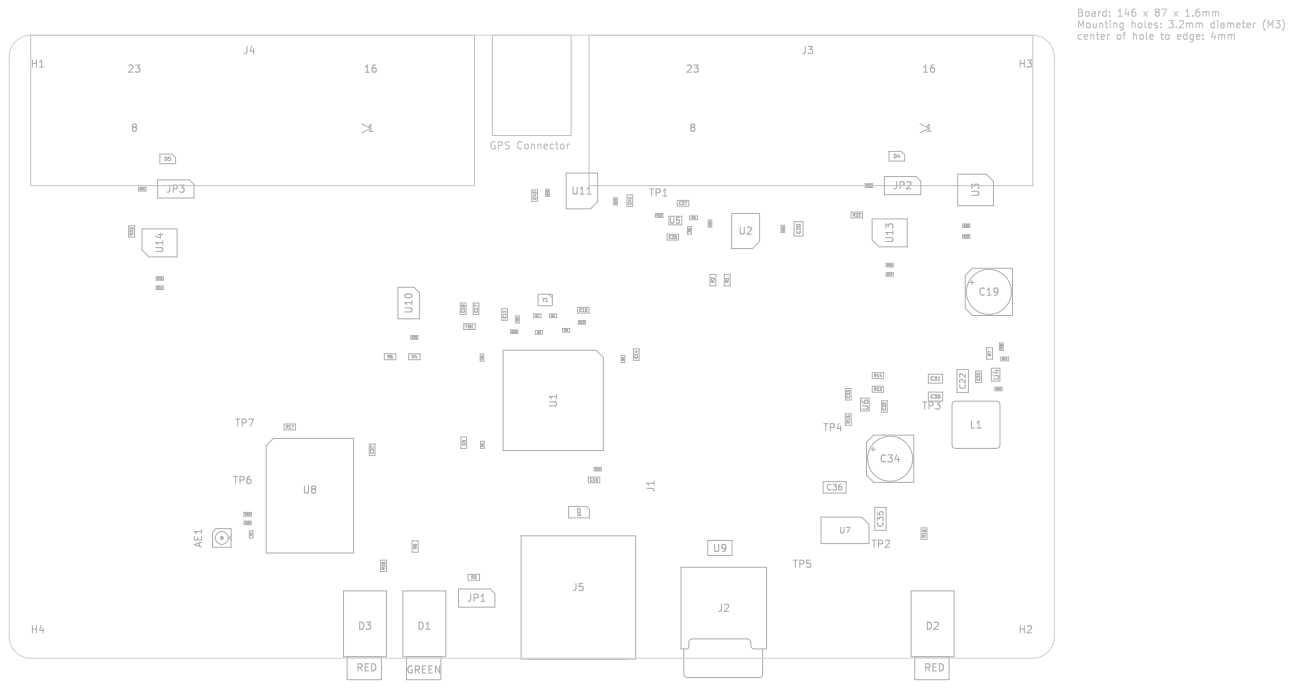
[picture p182: page 1]
