sundevilmotorsports/pcb-dev/PRE2026/sdm24logger/assembly/sdm24logger-In1_Cu.pdf

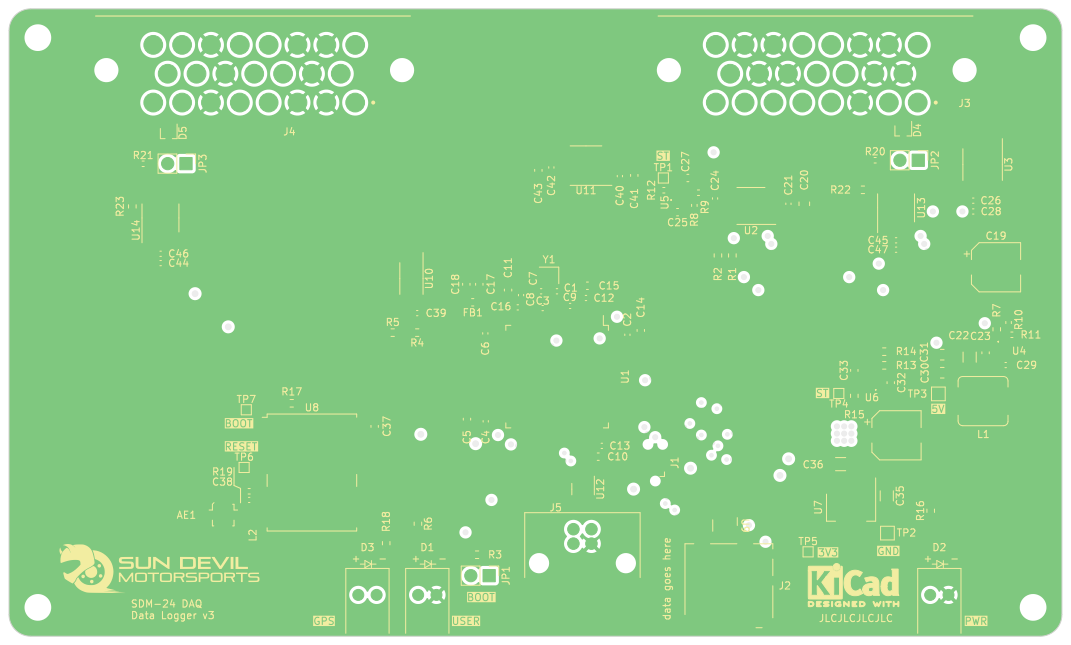
[picture p183: page 1]
