sundevilmotorsports/pcb-dev/PRE2026/sdm24logger/assembly/sdm24logger-In2_Cu.pdf

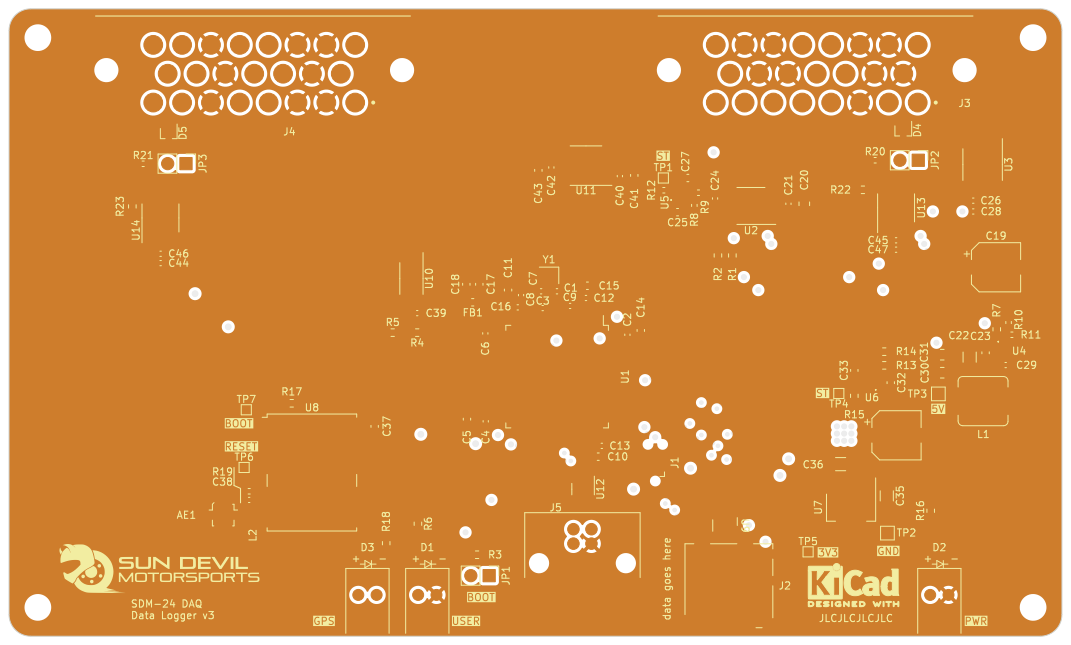
[picture p184: page 1]
