sundevilmotorsports/pcb-dev/PRE2026/BSPD/telemschem.pdf

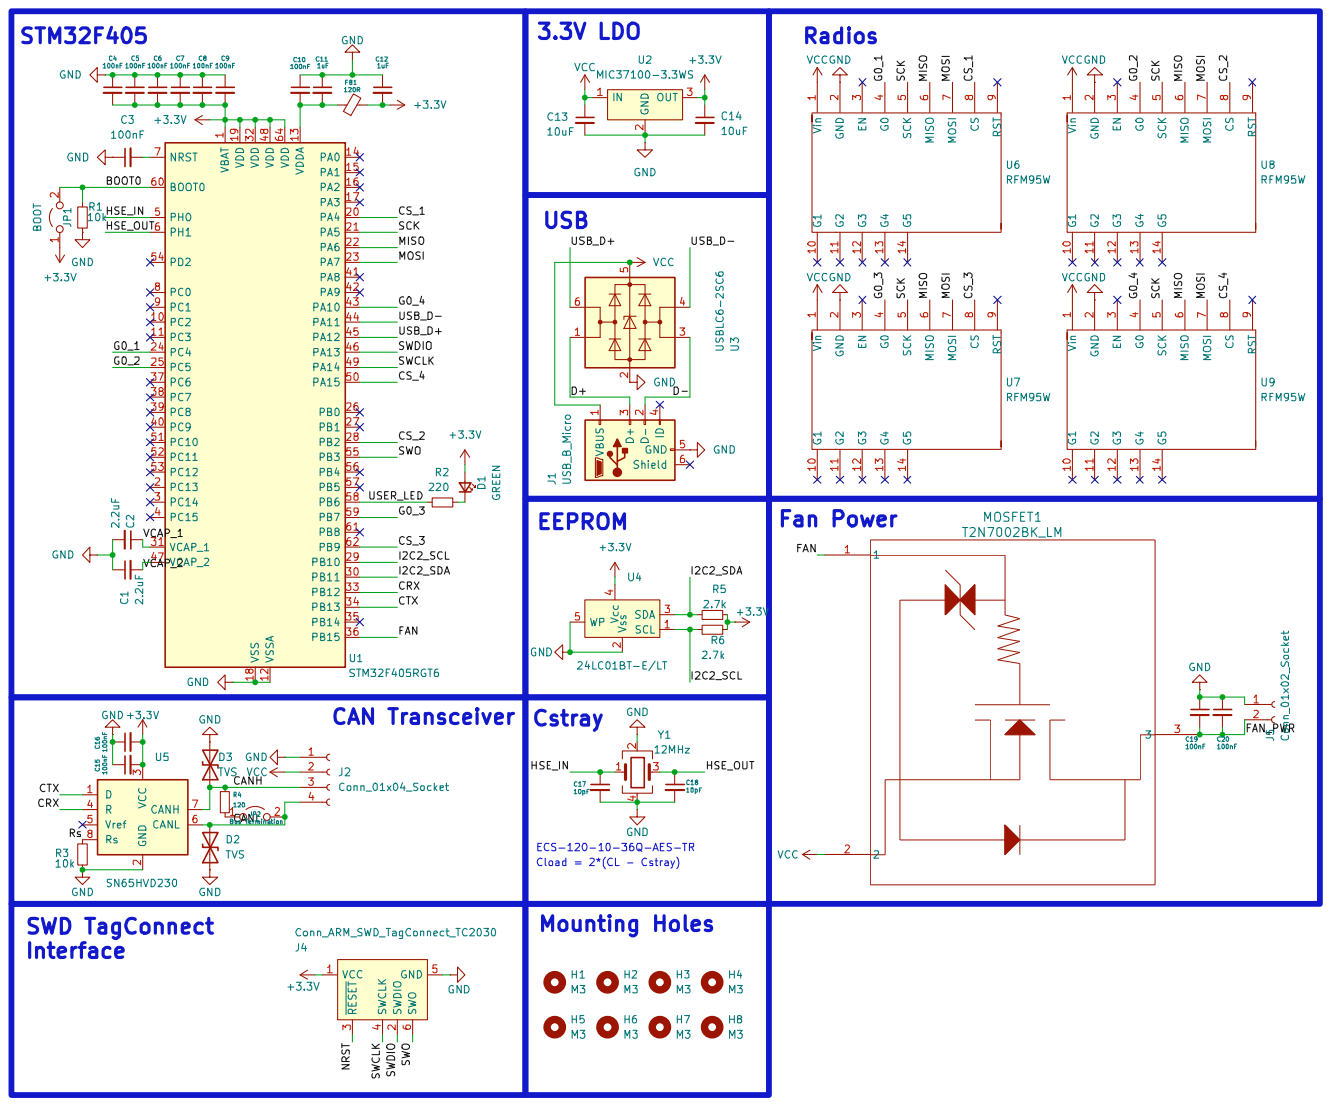
[picture p185: page 1]
