sundevilmotorsports/pcb-dev/2027/SDM27_CANSniffer/CANSniffer V1/ESP-C5-CAN SNIFFERV1.1.kicad_pcb

## KiCad design 2027/SDM27_CANSniffer/CANSniffer V1/ESP-C5-CAN SNIFFERV1.1.kicad_pcb (2026-11-13)

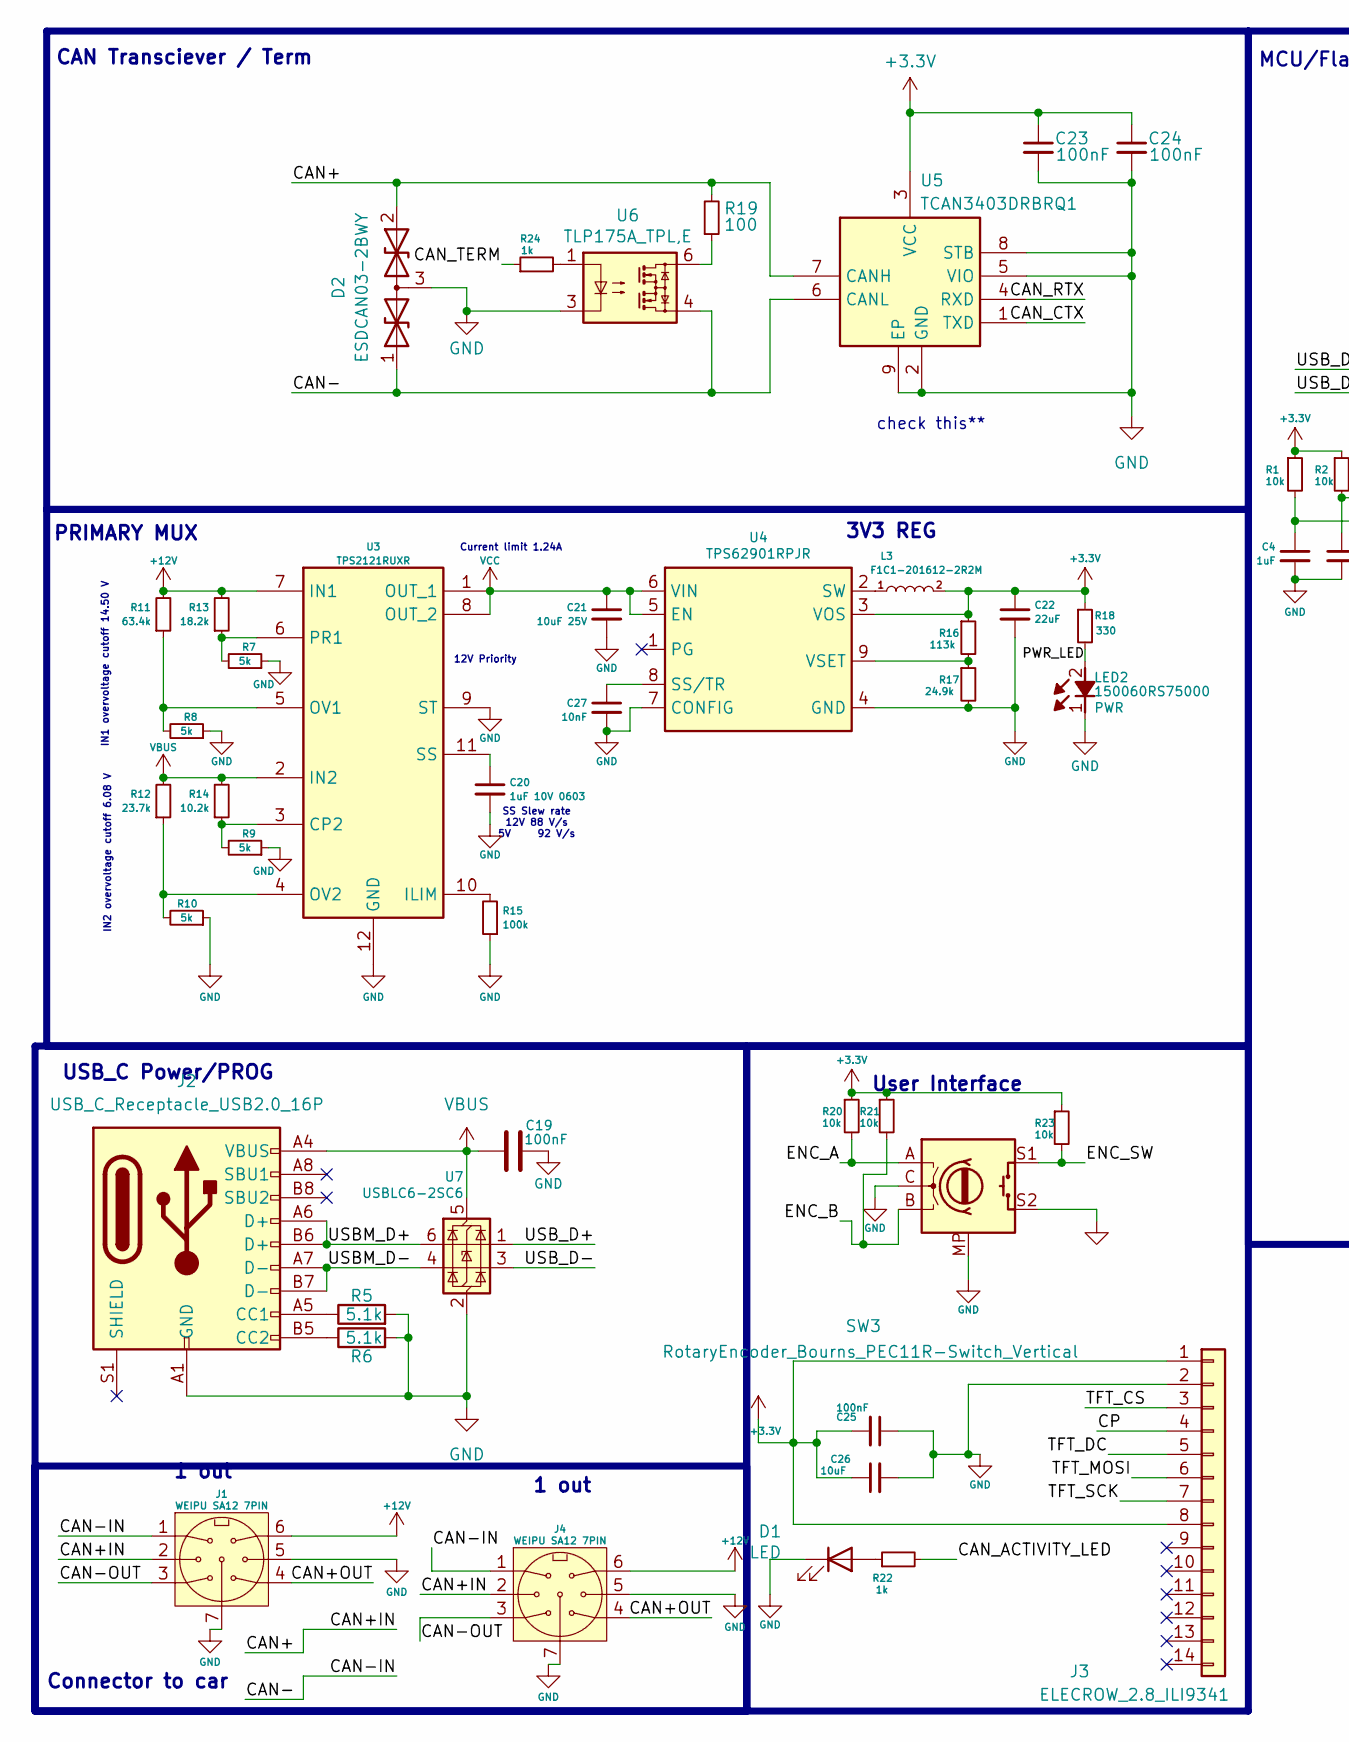
[picture p186: schematic ESP-C5-CAN SNIFFERV1.1.kicad_sch, ESP-C5 CAN Sniffer, part in row 1, column 1]

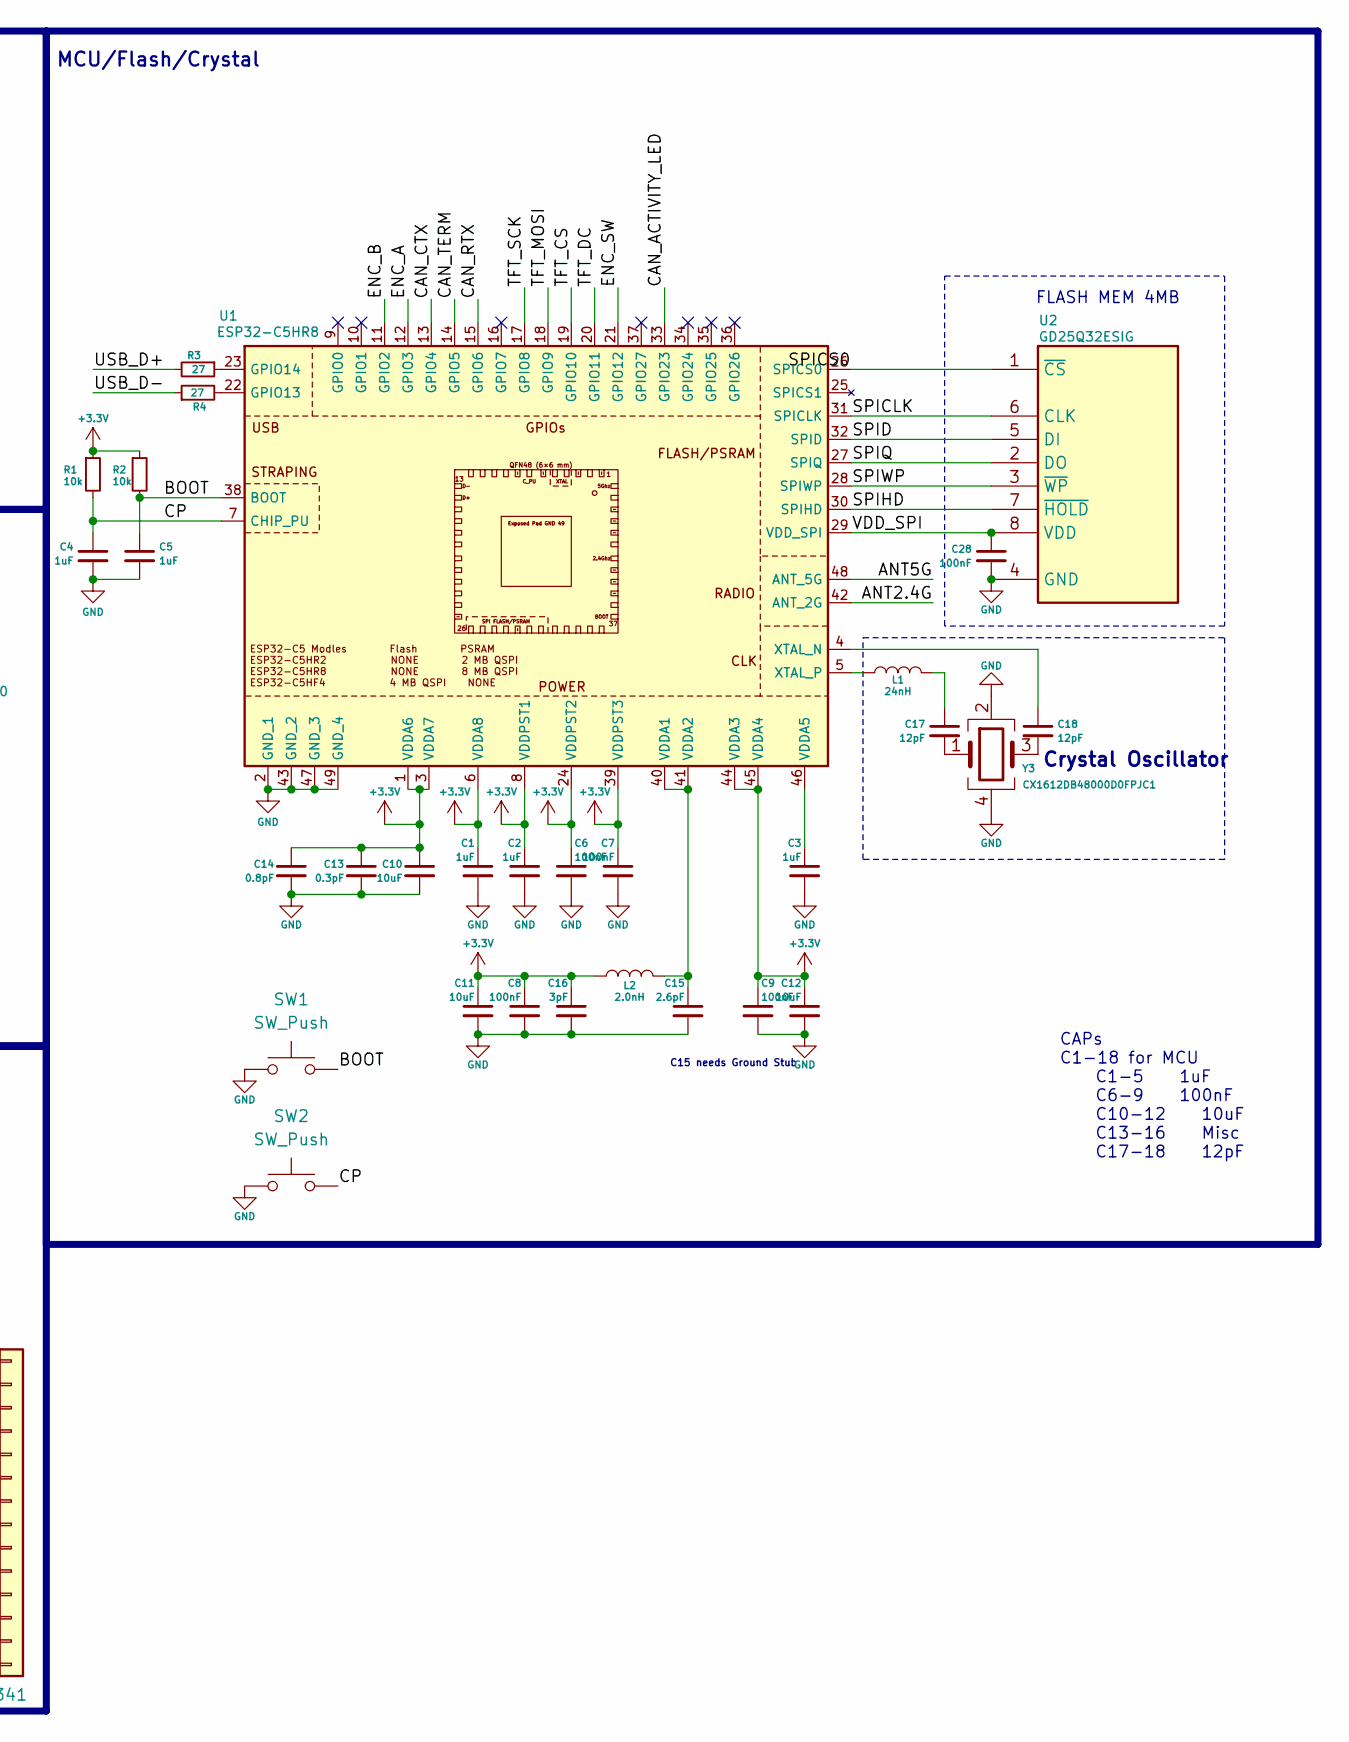
[picture p187: schematic ESP-C5-CAN SNIFFERV1.1.kicad_sch, ESP-C5 CAN Sniffer, part in row 1, column 2]

Parts:
C1, C2, C3, C4, C5: 1uF; C_0603_1608Metric
C6, C7, C8, C9, C19, C23, C24, C25, C28: 100nF; C_0603_1608Metric
C10, C11, C12, C26: 10uF; C_0603_1608Metric
C13: 0.3pF; C_0603_1608Metric
C14: 0.8pF; C_0603_1608Metric
C15: 2.6pF; C_0603_1608Metric
C16: 3pF; C_0603_1608Metric
C17, C18: 12pF; C_0201_0603Metric
C20: 1uF 10V 0603; C_0603_1608Metric
C21: 10uF 25V; C_0603_1608Metric
C22: 22uF; C_0603_1608Metric
C27: 10nF; C_0603_1608Metric
D1: LED; SSFLXH100LID01
D2: ESDCAN03-2BWY; SOT65P210X110-3N; Mouser Part Number 511-ESDCAN03-2BWY
J1, J4: WEIPU SA12 7PIN; PinHeader_1x07_P2.54mm_Vertical
J2: USB_C_Receptacle_USB2.0_16P; USB_C_Receptacle_G-Switch_GT-USB-7010ASVCAN
J3: ELECROW_2.8_ILI9341; PinHeader_1x14_P2.54mm_Vertical
L1: 24nH; L_0402_1005Metric
L2: 2.0nH; L_0402_1005Metric
L3: F1C1-201612-2R2M; F1C12016122R2M; Mouser Part Number 530-F1C1-201612-2R2M
LED2: 150060RS75000; LEDC1608X80N; Mouser Part Number 710-150060RS75000
R1, R2, R20, R21, R23: 10k; R_0402_1005Metric
R3, R4: 27; R_0402_1005Metric
R5, R6: 5.1k; R_0603_1608Metric
R7, R8, R9, R10: 5k; R_0603_1608Metric
R11: 63.4k; R_0603_1608Metric
R12: 23.7k; R_0603_1608Metric
R13: 18.2k; R_0603_1608Metric
R14: 10.2k; R_0603_1608Metric
R15: 100k; R_0603_1608Metric
R16: 113k; R_0603_1608Metric
R17: 24.9k; R_0603_1608Metric
R18: 330; R_0603_1608Metric
R19: 100; R_0603_1608Metric
R22, R24: 1k; R_0402_1005Metric
SW1, SW2: SW_Push; SW_SPST_CK_KXT3
SW3: RotaryEncoder_Bourns_PEC11R-Switch_Vertical; XDCR_PEC11R-4220F-S0024
U1: ESP32-C5HR8; QFN40P600X600X90-49N-D; Manufacturer_Part_Number ESP32-C5HR8
U2: GD25Q32ESIG; SOP-8-1EP_4.57x4.57mm_P1.27mm_EP4.57x4.45mm; Mouser Part Number 363-GD25Q32ESIG
U3: TPS2121RUXR; Mouser Part Number 595-TPS2121RUXR
U4: TPS62901RPJR; Mouser Part Number 595-TPS62901RPJR
U5: TCAN3403DRBRQ1; SON65P300X300X100-9N-D; Manufacturer_Part_Number TCAN3403DRBRQ1; Mouser Part Number 595-TCAN3403DRBRQ1
U6: TLP175A_TPL,E; TLP266J; Mouser Part Number 757-TLP175A(TPLE
U7: USBLC6-2SC6; SOT-23-6
Y3: CX1612DB48000D0FPJC1; Mouser Part Number 581-CX1612DB48D0FPJ

Connections:
+3.3V: C1.1, C2.1, C6.1, C7.1, C8.1, C9.1, C10.1, C11.1, C12.1, C13.1, C14.1, C16.1, C22.1, C23.1, C24.1, C25.2, C26.1, J3.1, J3.8, L2.2, L3.2, R1.1, R2.1, R16.1, R18.1, R20.1, R21.1, R23.1, U1.1 (VDDA6), U1.3 (VDDA7), U1.6 (VDDA8), U1.8 (VDDPST1), U1.24 (VDDPST2), U1.39 (VDDPST3), U1.44 (VDDA3), U1.45 (VDDA4), U4.3 (VOS), U5.3 (VCC); also elsewhere on the board
+12V: J1.6, J4.6, R11.2, R13.2, U3.7 (IN1); also elsewhere on the board
/BOOT: C5.1, R2.2, SW1.2, U1.38 (BOOT); also elsewhere on the board
/CAN+: D2.2, J1.2, J4.2, R19.2, U5.7 (CANH)
/CAN+OUT: J1.4, J4.4
/CAN-: D2.1, J1.1, J4.1, U5.6 (CANL), U6.4
/CAN-OUT: J1.3, J4.3
/CAN_ACTIVITY_LED: R22.2, U1.33 (GPIO23); also elsewhere on the board
/CAN_CTX: U1.13 (GPIO4), U5.1 (TXD); also elsewhere on the board
/CAN_RTX: U1.15 (GPIO6), U5.4 (RXD); also elsewhere on the board
/CAN_TERM: R24.1, U1.14 (GPIO5); also elsewhere on the board
/CP: C4.1, J3.4, R1.2, SW2.2, U1.7 (CHIP_PU); also elsewhere on the board
/ENC_A: R20.2, SW3.A, U1.12 (GPIO3); also elsewhere on the board
/ENC_B: R21.2, SW3.B, U1.11 (GPIO2); also elsewhere on the board
/ENC_SW: R23.2, SW3.S1, U1.21 (GPIO12); also elsewhere on the board
/PWR_LED: LED2.2 (A), R18.2
/SPICLK: U1.31 (SPICLK), U2.6 (CLK); also elsewhere on the board
/SPICS0: U1.26 (SPICS0), U2.1 (~CS); also elsewhere on the board
/SPID: U1.32 (SPID), U2.5 (DI); also elsewhere on the board
/SPIHD: U1.30 (SPIHD), U2.7 (~HOLD); also elsewhere on the board
/SPIQ: U1.27 (SPIQ), U2.2 (DO); also elsewhere on the board
/SPIWP: U1.28 (SPIWP), U2.3 (~WP); also elsewhere on the board
/TFT_CS: J3.3, U1.19 (GPIO10); also elsewhere on the board
/TFT_DC: J3.5, U1.20 (GPIO11); also elsewhere on the board
/TFT_MOSI: J3.6, U1.18 (GPIO9); also elsewhere on the board
/TFT_SCK: J3.7, U1.17 (GPIO8); also elsewhere on the board
/USBM_D+: J2.A6 (D+), J2.B6 (D+), U7.6 (I/O1)
/USBM_D-: J2.A7 (D-), J2.B7 (D-), U7.4 (I/O2)
/USB_D+: R3.2, U7.1 (I/O1)
/USB_D-: R4.1, U7.3 (I/O2)
/VDD_SPI: C28.1, U1.29 (VDD_SPI), U2.8 (VDD); also elsewhere on the board
GND: C1.2, C2.2, C3.2, C4.2, C5.2, C6.2, C7.2, C8.2, C9.2, C10.2, C11.2, C12.2, C13.2, C14.2, C15.2, C16.2, C19.1, C20.2, C21.2, C22.2, C23.2, C24.2, C25.1, C26.2, C27.2, C28.2, D1.1 (K), D2.3, J1.5, J1.7, J2.A1 (GND), J2.A12 (GND), J2.B1 (GND), J2.B12 (GND), J2.S1 (SHIELD), J3.2, J4.5, J4.7, LED2.1 (K), R5.2, R6.2, R7.1, R8.1, R9.1, R10.1, R15.1, R17.2, SW1.1, SW2.1, SW3.C, SW3.MP, SW3.S2, U1.2 (GND_1), U1.43 (GND_2), U1.47 (GND_3), U1.49 (GND_4), U2.4 (GND), U3.9 (ST), U3.12 (GND), U4.4 (GND), U4.7 (CONFIG), U5.2 (GND), U5.5 (VIO), U5.8 (STB), U5.9 (EP), U6.3, U7.2 (GND), Y3.2, Y3.4; also elsewhere on the board
unnamed: C17.1, L1.2
unnamed: C17.2, Y3.1
unnamed: C18.2, Y3.3
unnamed: D1.2 (A), R22.1
unnamed: J2.A5 (CC1), R5.1
unnamed: J2.B5 (CC2), R6.1
unnamed: R19.1, U6.6
unnamed: R24.2, U6.1
unnamed: R9.2, R14.1, U3.3 (CP2)
unnamed: R15.2, U3.10 (ILIM)
unnamed: R8.2, R11.1, U3.5 (OV1)
unnamed: R10.2, R12.1, U3.4 (OV2)
unnamed: R7.2, R13.1, U3.6 (PR1)
unnamed: C20.1, U3.11 (SS)
unnamed: C27.1, U4.8 (SS/TR)
unnamed: L3.1, U4.2 (SW)
unnamed: R16.2, R17.1, U4.9 (VSET)
unnamed 53: R4.2, U1.22 (GPIO13); also elsewhere on the board
unnamed 54: R3.1, U1.23 (GPIO14); also elsewhere on the board
unnamed 55: C15.1, L2.1, U1.40 (VDDA1), U1.41 (VDDA2); also elsewhere on the board
unnamed 56: C3.1, U1.46 (VDDA5); also elsewhere on the board
unnamed 57: C18.1, U1.4 (XTAL_N); also elsewhere on the board
unnamed 58: L1.1, U1.5 (XTAL_P); also elsewhere on the board
VBUS: C19.2, J2.A4 (VBUS), J2.A9 (VBUS), J2.B4 (VBUS), J2.B9 (VBUS), R12.2, R14.2, U3.2 (IN2), U7.5 (VBUS)
VCC: C21.1, U3.1 (OUT_1), U3.8 (OUT_2), U4.5 (EN), U4.6 (VIN)

Notes on the sheet:
3V3 REG
Connector to car
Current limit 1.24A
FLASH MEM 4MB
CAPs C1-18 for MCU C1-5 1uF C6-9 100nF C10-12 10uF C13-16 Misc C17-18 12pF
1 out
SS Slew rate 12V 88 V/s 5V 92 V/s
PRIMARY MUX
MCU/Flash/Crystal
User Interface
12V Priority
IN1 overvoltage cutoff 14.50 V
CAN Transciever / Term
IN2 overvoltage cutoff 6.08 V
C15 needs Ground Stub
Crystal Oscillator
USB_C Power/PROG
check this**

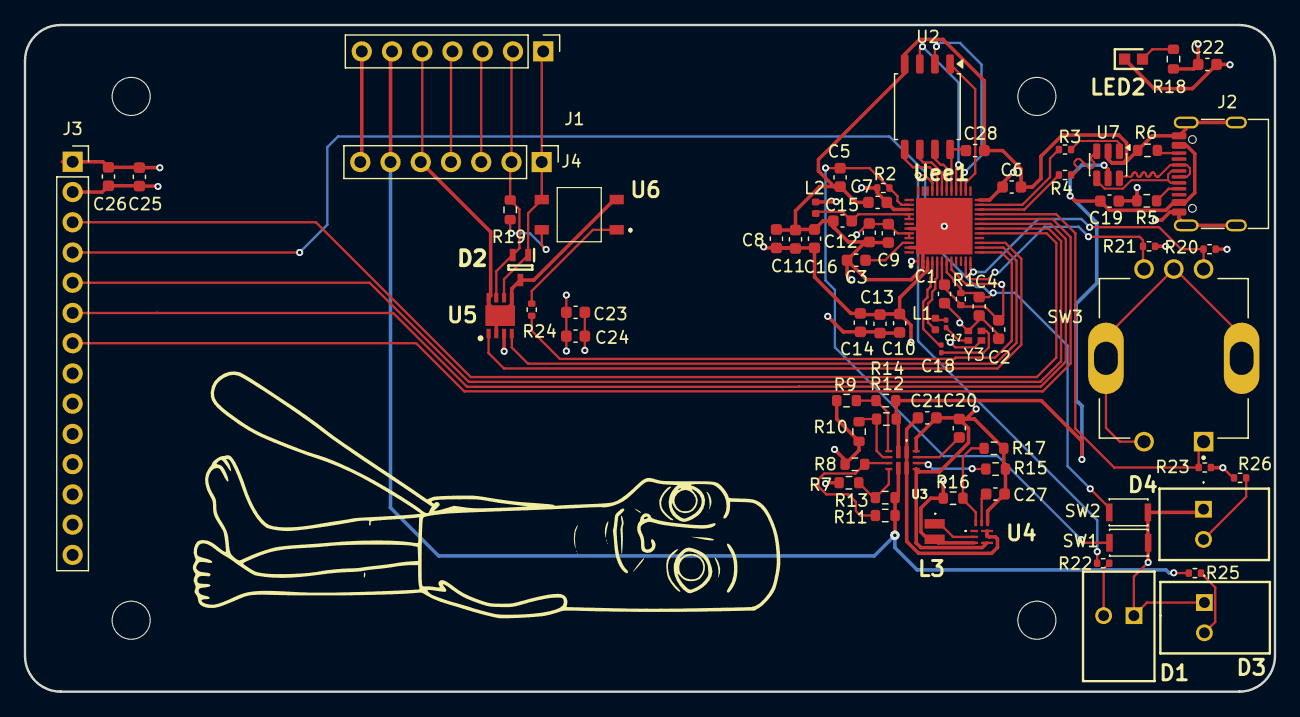
[picture p188: board ESP-C5-CAN SNIFFERV1.1.kicad_pcb from above]

Board: 4 copper layers, 105.0 x 56.0 mm, 77 parts (0 on the bottom side), 59 nets.

Other parts of the board:
D3, D4: LED; SSFLXH100LID01
R25: 4.7k; R_0402_1005Metric
R26: 680; R_0402_1005Metric
Uee1: ESP32-C5HR8; QFN40P600X600X90-49N-D

Their connections:
+3.3V: R26.2, Uee1.1 (VDDA6), Uee1.3 (VDDA7), Uee1.6 (VDDA8), Uee1.8 (VDDPST1), Uee1.24 (VDDPST2), Uee1.39 (VDDPST3), Uee1.44 (VDDA3), Uee1.45 (VDDA4); also elsewhere on the board
+12V: R25.2; also elsewhere on the board
/BOOT: Uee1.38 (BOOT); also elsewhere on the board
/CAN_ACTIVITY_LED: Uee1.33 (GPIO23); also elsewhere on the board
/CAN_CTX: Uee1.15 (GPIO6); also elsewhere on the board
/CAN_RTX: Uee1.14 (GPIO5); also elsewhere on the board
/CAN_TERM: Uee1.13 (GPIO4); also elsewhere on the board
/CP: Uee1.7 (CHIP_PU); also elsewhere on the board
/ENC_A: Uee1.12 (GPIO3); also elsewhere on the board
/ENC_B: Uee1.11 (GPIO2); also elsewhere on the board
/ENC_SW: Uee1.21 (GPIO12); also elsewhere on the board
/SPICLK: Uee1.31 (SPICLK); also elsewhere on the board
/SPICS0: Uee1.26 (SPICS0); also elsewhere on the board
/SPID: Uee1.32 (SPID); also elsewhere on the board
/SPIHD: Uee1.30 (SPIHD); also elsewhere on the board
/SPIQ: Uee1.27 (SPIQ); also elsewhere on the board
/SPIWP: Uee1.28 (SPIWP); also elsewhere on the board
/TFT_CS: Uee1.17 (GPIO8); also elsewhere on the board
/TFT_DC: Uee1.18 (GPIO9); also elsewhere on the board
/TFT_MOSI: Uee1.19 (GPIO10); also elsewhere on the board
/TFT_SCK: Uee1.20 (GPIO11); also elsewhere on the board
/VDD_SPI: Uee1.29 (VDD_SPI); also elsewhere on the board
GND: D3.1 (K), D4.1 (K), Uee1.2 (GND_1), Uee1.43 (GND_2), Uee1.47 (GND_3), Uee1.49 (GND_4); also elsewhere on the board
unnamed: D3.2 (A), R25.1
unnamed: D4.2 (A), R26.1
unnamed 53: Uee1.22 (GPIO13); also elsewhere on the board
unnamed 54: Uee1.23 (GPIO14); also elsewhere on the board
unnamed 55: Uee1.40 (VDDA1), Uee1.41 (VDDA2); also elsewhere on the board
unnamed 56: Uee1.46 (VDDA5); also elsewhere on the board
unnamed 57: Uee1.4 (XTAL_N); also elsewhere on the board
unnamed 58: Uee1.5 (XTAL_P); also elsewhere on the board
