sundevilmotorsports/pcb-dev/2027/SDM27_SteeringWheel/SDM27_PattleShifterV0/Pattel_Shifter_V0/Pattel_Shifter_V0.kicad_pcb

## KiCad design 2027/SDM27_SteeringWheel/SDM27_PattleShifterV0/Pattel_Shifter_V0/Pattel_Shifter_V0.kicad_pcb (2026-11-06)

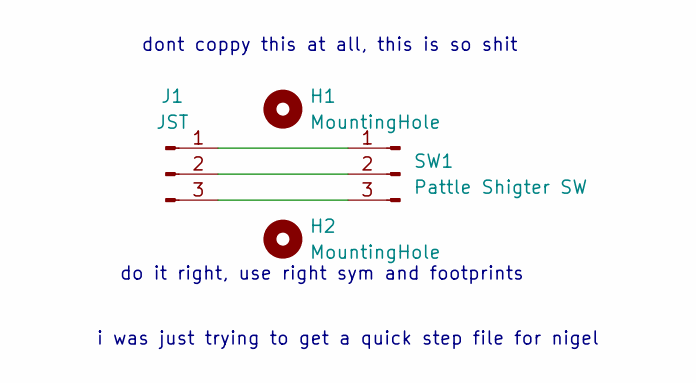
[picture p189: schematic Pattel_Shifter_V0.kicad_sch]

Parts:
H1, H2: MountingHole; MountingHole_2.2mm_M2
J1: JST; JST_EH_S3B-EH_1x03_P2.50mm_Horizontal
SW1: Pattle Shigter SW; SW_Slide_SPDT_Straight_CK_OS102011MS2Q

Connections:
unnamed: J1.1, SW1.1
unnamed: J1.2, SW1.2
unnamed: J1.3, SW1.3

Notes on the sheet:
dont coppy this at all, this is so shit
i was just trying to get a quick step file for nigel
do it right, use right sym and footprints

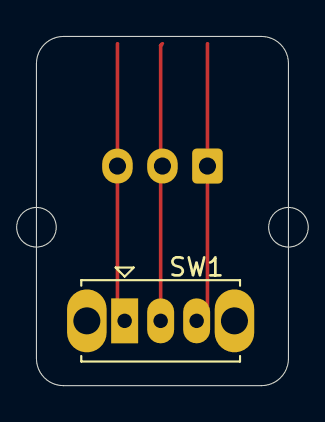
[picture p190: board Pattel_Shifter_V0.kicad_pcb from above]

Board: 2 copper layers, 14.0 x 19.4 mm, 4 parts (1 on the bottom side), 3 nets.
