sundevilmotorsports/pcb-dev/2027/SDM27_StrainGaugeAmp/StrainGaugeBreakout/SDM27_breakout.kicad_pcb

## KiCad design 2027/SDM27_StrainGaugeAmp/StrainGaugeBreakout/SDM27_breakout.kicad_pcb (2026-11-06)

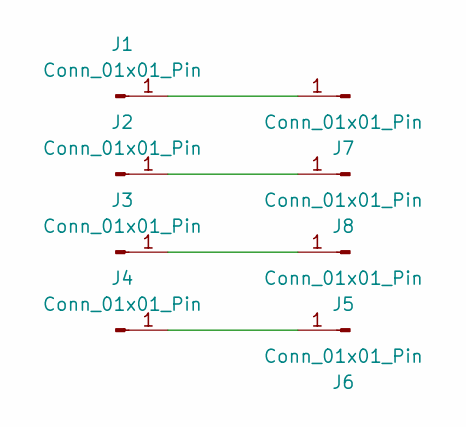
[picture p191: schematic SDM27_breakout.kicad_sch]

Parts:
J1, J2, J3, J4: Conn_01x01_Pin; SolderWirePad_1x01_SMD_1x2mm
J5, J6, J7, J8: Conn_01x01_Pin; SolderWirePad_1x01_SMD_2x4mm

Connections:
unnamed: J1.1 (Pin_1_1), J7.1 (Pin_1_1)
unnamed: J2.1 (Pin_1_1), J8.1 (Pin_1_1)
unnamed: J3.1 (Pin_1_1), J5.1 (Pin_1_1)
unnamed: J4.1 (Pin_1_1), J6.1 (Pin_1_1)

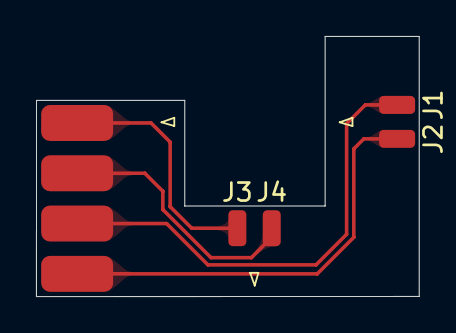
[picture p192: board SDM27_breakout.kicad_pcb from above]

Board: 2 copper layers, 21.3 x 14.5 mm, 8 parts (0 on the bottom side), 4 nets.
