sundevilmotorsports/pcb-dev/2026/IMU/SDM26_IMU_V1.0/SDM26_IMU_V1.0.kicad_pcb

## KiCad design 2026/IMU/SDM26_IMU_V1.0/SDM26_IMU_V1.0.kicad_pcb (2026-11-06, an earlier design)

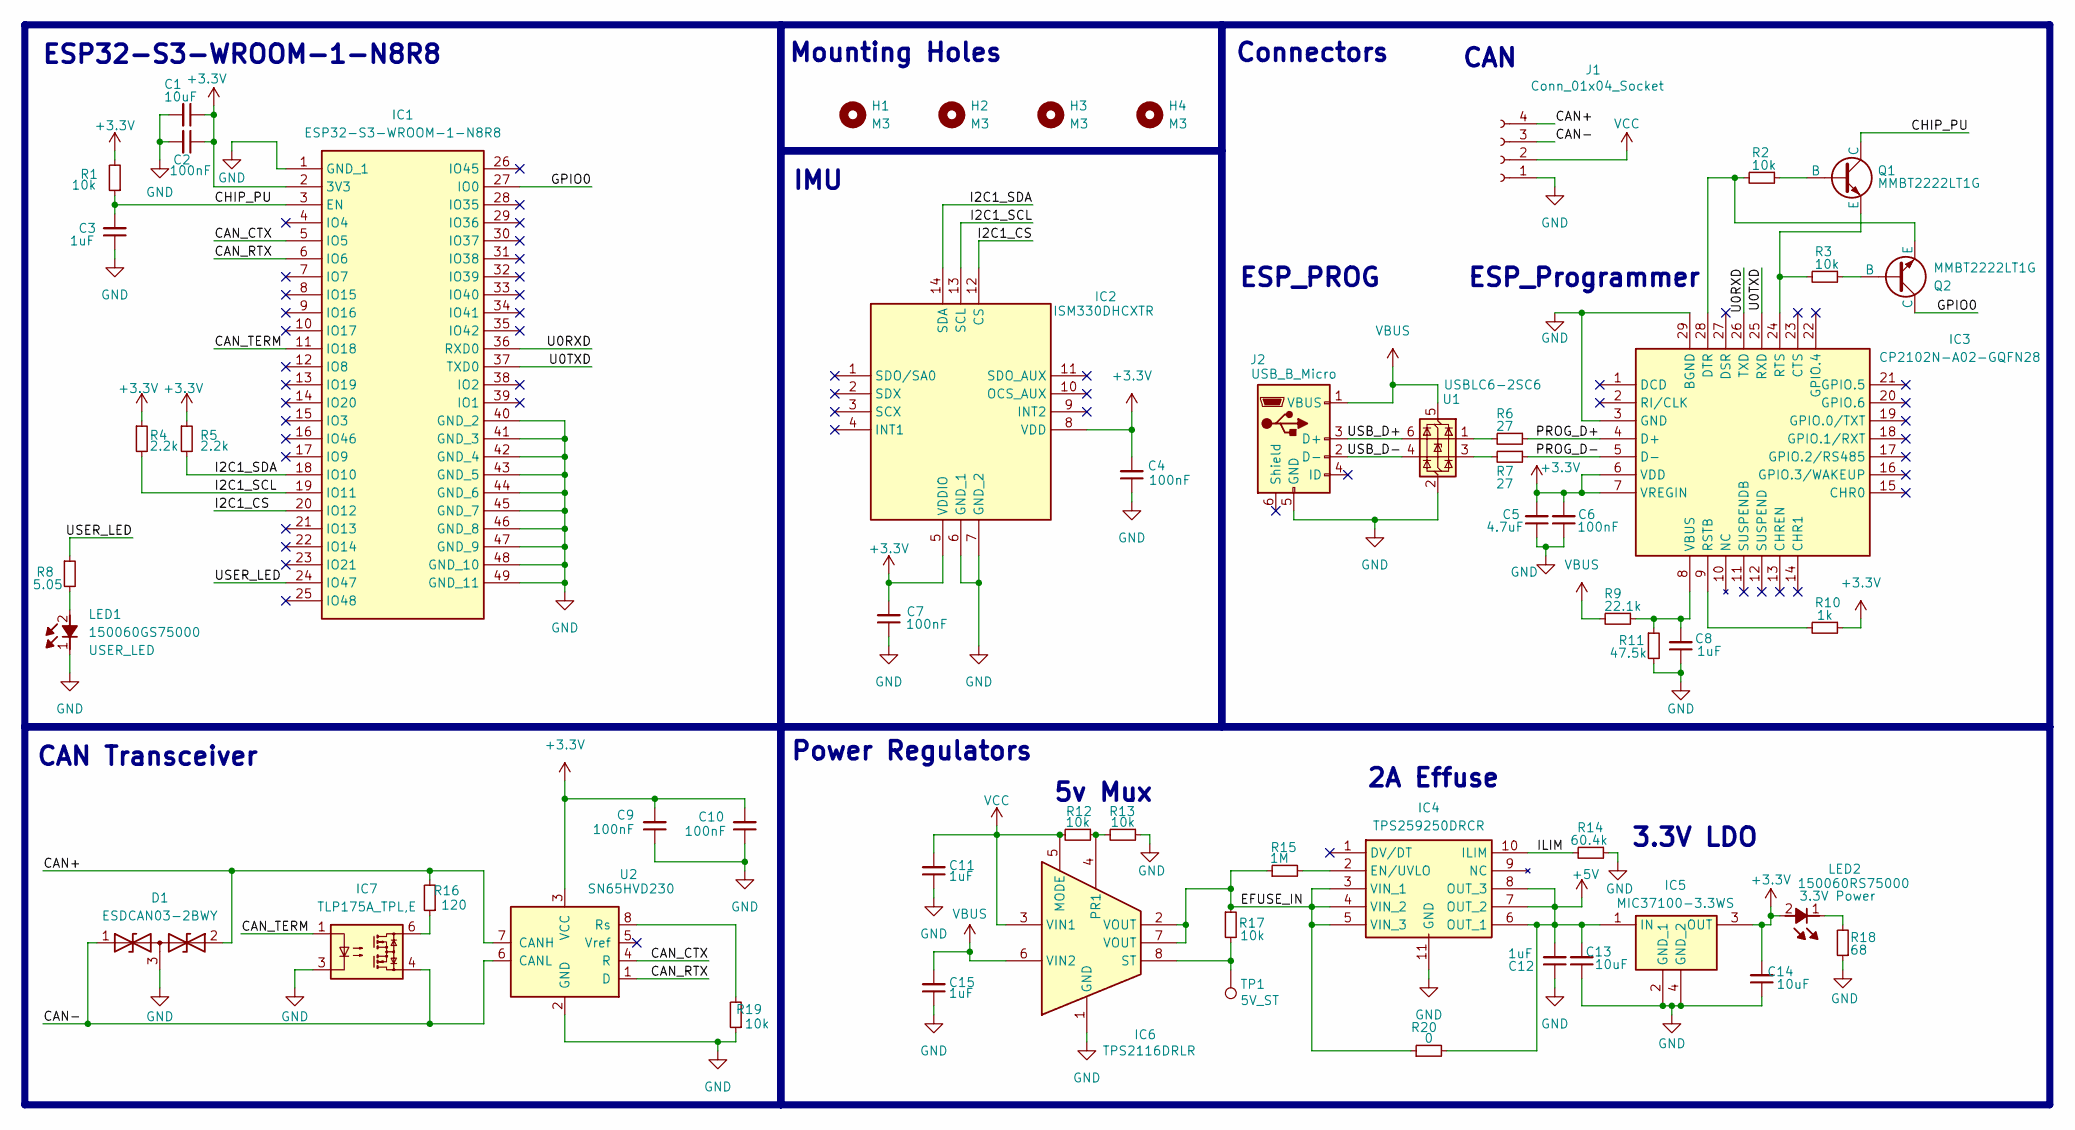
[picture p193: schematic SDM26_IMU_V1.0.kicad_sch]

Parts:
C1, C13, C14: 10uF; C_0603_1608Metric
C2, C4, C6, C7, C9, C10: 100nF; C_0603_1608Metric
C3, C8, C11, C12, C15: 1uF; C_0603_1608Metric
C5: 4.7uF; C_0603_1608Metric
D1: ESDCAN03-2BWY; SOT65P210X110-3N; Mouser Part Number 511-ESDCAN03-2BWY
H1, H2, H3, H4: M3; MountingHole_3.2mm_M3
IC1: ESP32-S3-WROOM-1-N8R8; ESP32S3WROOM1N8R8; Mouser Part Number 356-EP32S3WROOM1N8R8
IC2: ISM330DHCXTR; LSM6DS3USTR; Mouser Part Number 511-ISM330DHCXTR
IC3: CP2102N-A02-GQFN28; QFN50P500X500X80-29N-D; Mouser Part Number 634-CP2102NA02GQFN28
IC4: TPS259250DRCR; SON50P300X300X100-11L-D; Mouser Part Number 595-TPS259250DRCR
IC5: MIC37100-3.3WS; SOT230P700X180-4N; Mouser Part Number 998-MIC37100-3.3WS
IC6: TPS2116DRLR; SOTFL50P160X60-8L; Mouser Part Number 595-TPS2116DRLR
IC7: TLP175A_TPL,E; TLP266J; Mouser Part Number 757-TLP175A(TPLE
J1: Conn_01x04_Socket; JST_XH_S4B-XH-A_1x04_P2.50mm_Horizontal
J2: USB_B_Micro; USB_Micro-B_Molex-105017-0001
LED1: 150060GS75000; LEDC1608X80N; Mouser Part Number 710-150060VS75000
LED2: 150060RS75000; LEDC1608X80N; Mouser Part Number 710-150060RS75000
Q1, Q2: MMBT2222LT1G; SOT96P237X111-3N
R1, R2, R3, R12, R13, R17, R19: 10k; R_0603_1608Metric
R4, R5: 2.2k; R_0603_1608Metric
R6, R7: 27; R_0603_1608Metric
R8: 5.05; R_0603_1608Metric
R9: 22.1k; R_0603_1608Metric
R10: 1k; R_0603_1608Metric
R11: 47.5k; R_0603_1608Metric
R14: 60.4k; R_0603_1608Metric
R15: 1M; R_0603_1608Metric
R16: 120; R_0603_1608Metric
R18: 68; R_0603_1608Metric
R20: 0; R_0603_1608Metric
TP1: 5V_ST; TestPoint_Pad_1.5x1.5mm
U1: USBLC6-2SC6; SOT-23-6
U2: SN65HVD230; SOIC-8_3.9x4.9mm_P1.27mm

Connections:
+3.3V: C1.1, C2.1, C4.2, C5.2, C6.2, C7.2, C9.2, C10.2, C14.2, IC1.2 (3V3), IC2.5 (VDDIO), IC2.8 (VDD), IC3.6 (VDD), IC3.7 (VREGIN), IC5.3 (OUT), LED2.2 (A), R1.2, R4.1, R5.1, R10.1, U2.3 (VCC)
+5V: C12.2, C13.2, IC4.6 (OUT_1), IC4.7 (OUT_2), IC4.8 (OUT_3), IC5.1 (IN), R20.2
/CAN+: D1.2, J1.4, R16.2, U2.7 (CANH)
/CAN-: D1.1, IC7.4, J1.3, U2.6 (CANL)
/CAN_CTX: IC1.5 (IO5), U2.4 (R)
/CAN_RTX: IC1.6 (IO6), U2.1 (D)
/CAN_TERM: IC1.11 (IO18), IC7.1
/CHIP_PU: C3.2, IC1.3 (EN), Q1.3 (C), R1.1
/EFUSE_IN: IC4.3 (VIN_1), IC4.4 (VIN_2), IC4.5 (VIN_3), IC6.2 (VOUT), IC6.7 (VOUT), R15.1, R17.1, R20.1
/GPIO0: IC1.27 (IO0), Q2.3 (C)
/I2C1_CS: IC1.20 (IO12), IC2.12 (CS)
/I2C1_SCL: IC1.19 (IO11), IC2.13 (SCL), R4.2
/I2C1_SDA: IC1.18 (IO10), IC2.14 (SDA), R5.2
/ILIM: IC4.10 (ILIM), R14.2
/PROG_D+: IC3.4 (D+), R6.1
/PROG_D-: IC3.5 (D-), R7.1
/U0RXD: IC1.36 (RXD0), IC3.26 (TXD)
/U0TXD: IC1.37 (TXD0), IC3.25 (RXD)
/USB_D+: J2.3 (D+), U1.6 (I/O1)
/USB_D-: J2.2 (D-), U1.4 (I/O2)
/USER_LED: IC1.24 (IO47), R8.1
GND: C1.2, C2.2, C3.1, C4.1, C5.1, C6.1, C7.1, C8.1, C9.1, C10.1, C11.1, C12.1, C13.1, C14.1, C15.1, D1.3, IC1.1 (GND_1), IC1.40 (GND_2), IC1.41 (GND_3), IC1.42 (GND_4), IC1.43 (GND_5), IC1.44 (GND_6), IC1.45 (GND_7), IC1.46 (GND_8), IC1.47 (GND_9), IC1.48 (GND_10), IC1.49 (GND_11), IC2.6 (GND_1), IC2.7 (GND_2), IC3.3 (GND), IC3.29 (BGND), IC4.11 (GND), IC5.2 (GND_1), IC5.4 (GND_2), IC6.1 (GND), IC7.3, J1.1, J2.5 (GND), LED1.1 (K), R11.2, R13.1, R14.1, R18.1, R19.1, U1.2 (GND), U2.2 (GND)
unnamed: IC3.28 (DTR), Q2.2 (E), R2.2
unnamed: IC3.9 (RSTB), R10.2
unnamed: IC3.24 (RTS), Q1.2 (E), R3.2
unnamed: C8.2, IC3.8 (VBUS), R9.1, R11.1
unnamed: IC4.2 (EN/UVLO), R15.2
unnamed: IC6.4 (PR1), R12.1, R13.2
unnamed: IC6.8 (ST), R17.2, TP1.1
unnamed: IC7.6, R16.1
unnamed: LED1.2 (A), R8.2
unnamed: LED2.1 (K), R18.2
unnamed: Q1.1 (B), R2.1
unnamed: Q2.1 (B), R3.1
unnamed: R6.2, U1.1 (I/O1)
unnamed: R7.2, U1.3 (I/O2)
unnamed: R19.2, U2.8 (Rs)
VBUS: C15.2, IC6.6 (VIN2), J2.1 (VBUS), R9.2, U1.5 (VBUS)
VCC: C11.2, IC6.3 (VIN1), IC6.5 (MODE), J1.2, R12.2

Notes on the sheet:
3.3V LDO
Mounting Holes
ESP_Programmer
Connectors
IMU
5v Mux
ESP32-S3-WROOM-1-N8R8
Power Regulators
CAN
ESP_PROG
2A Effuse
CAN Transceiver

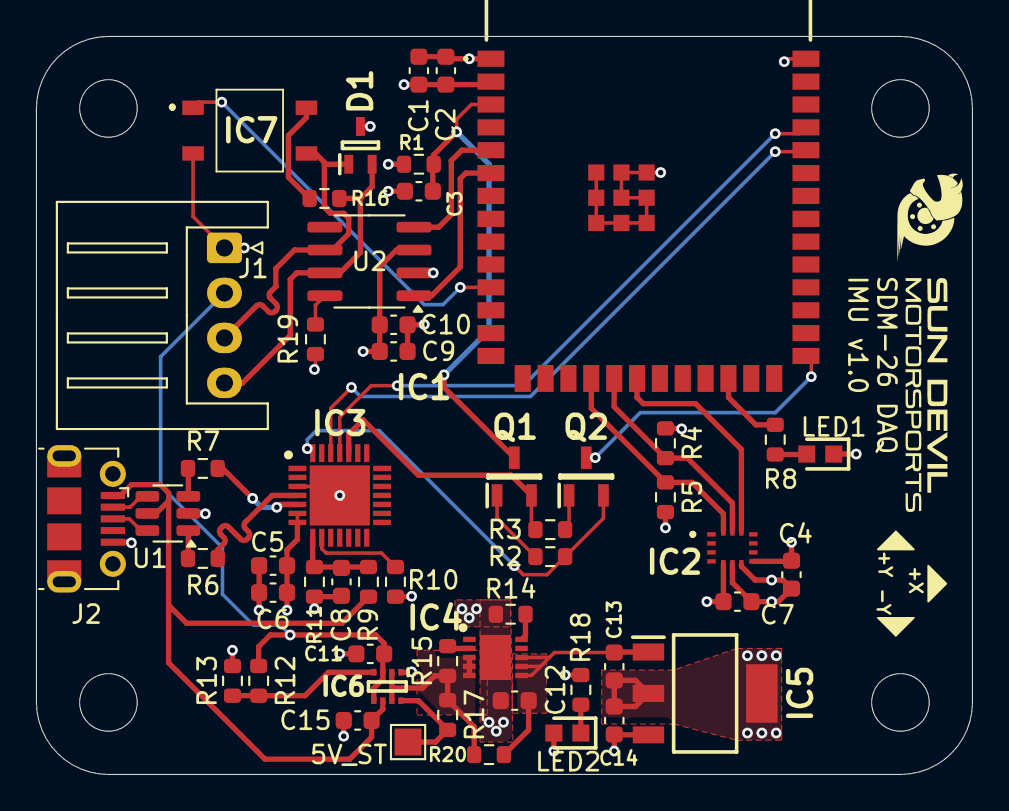
[picture p194: board SDM26_IMU_V1.0.kicad_pcb from above]

Board: 4 copper layers, 52.0 x 41.0 mm, 56 parts (0 on the bottom side), 39 nets.
