sundevilmotorsports/pcb-dev/2026/Logger/SDM26_Logger_V3.3/SDM26LoggerV3.3.kicad_pcb

## KiCad design 2026/Logger/SDM26_Logger_V3.3/SDM26LoggerV3.3.kicad_pcb (2026-11-06, an earlier design)

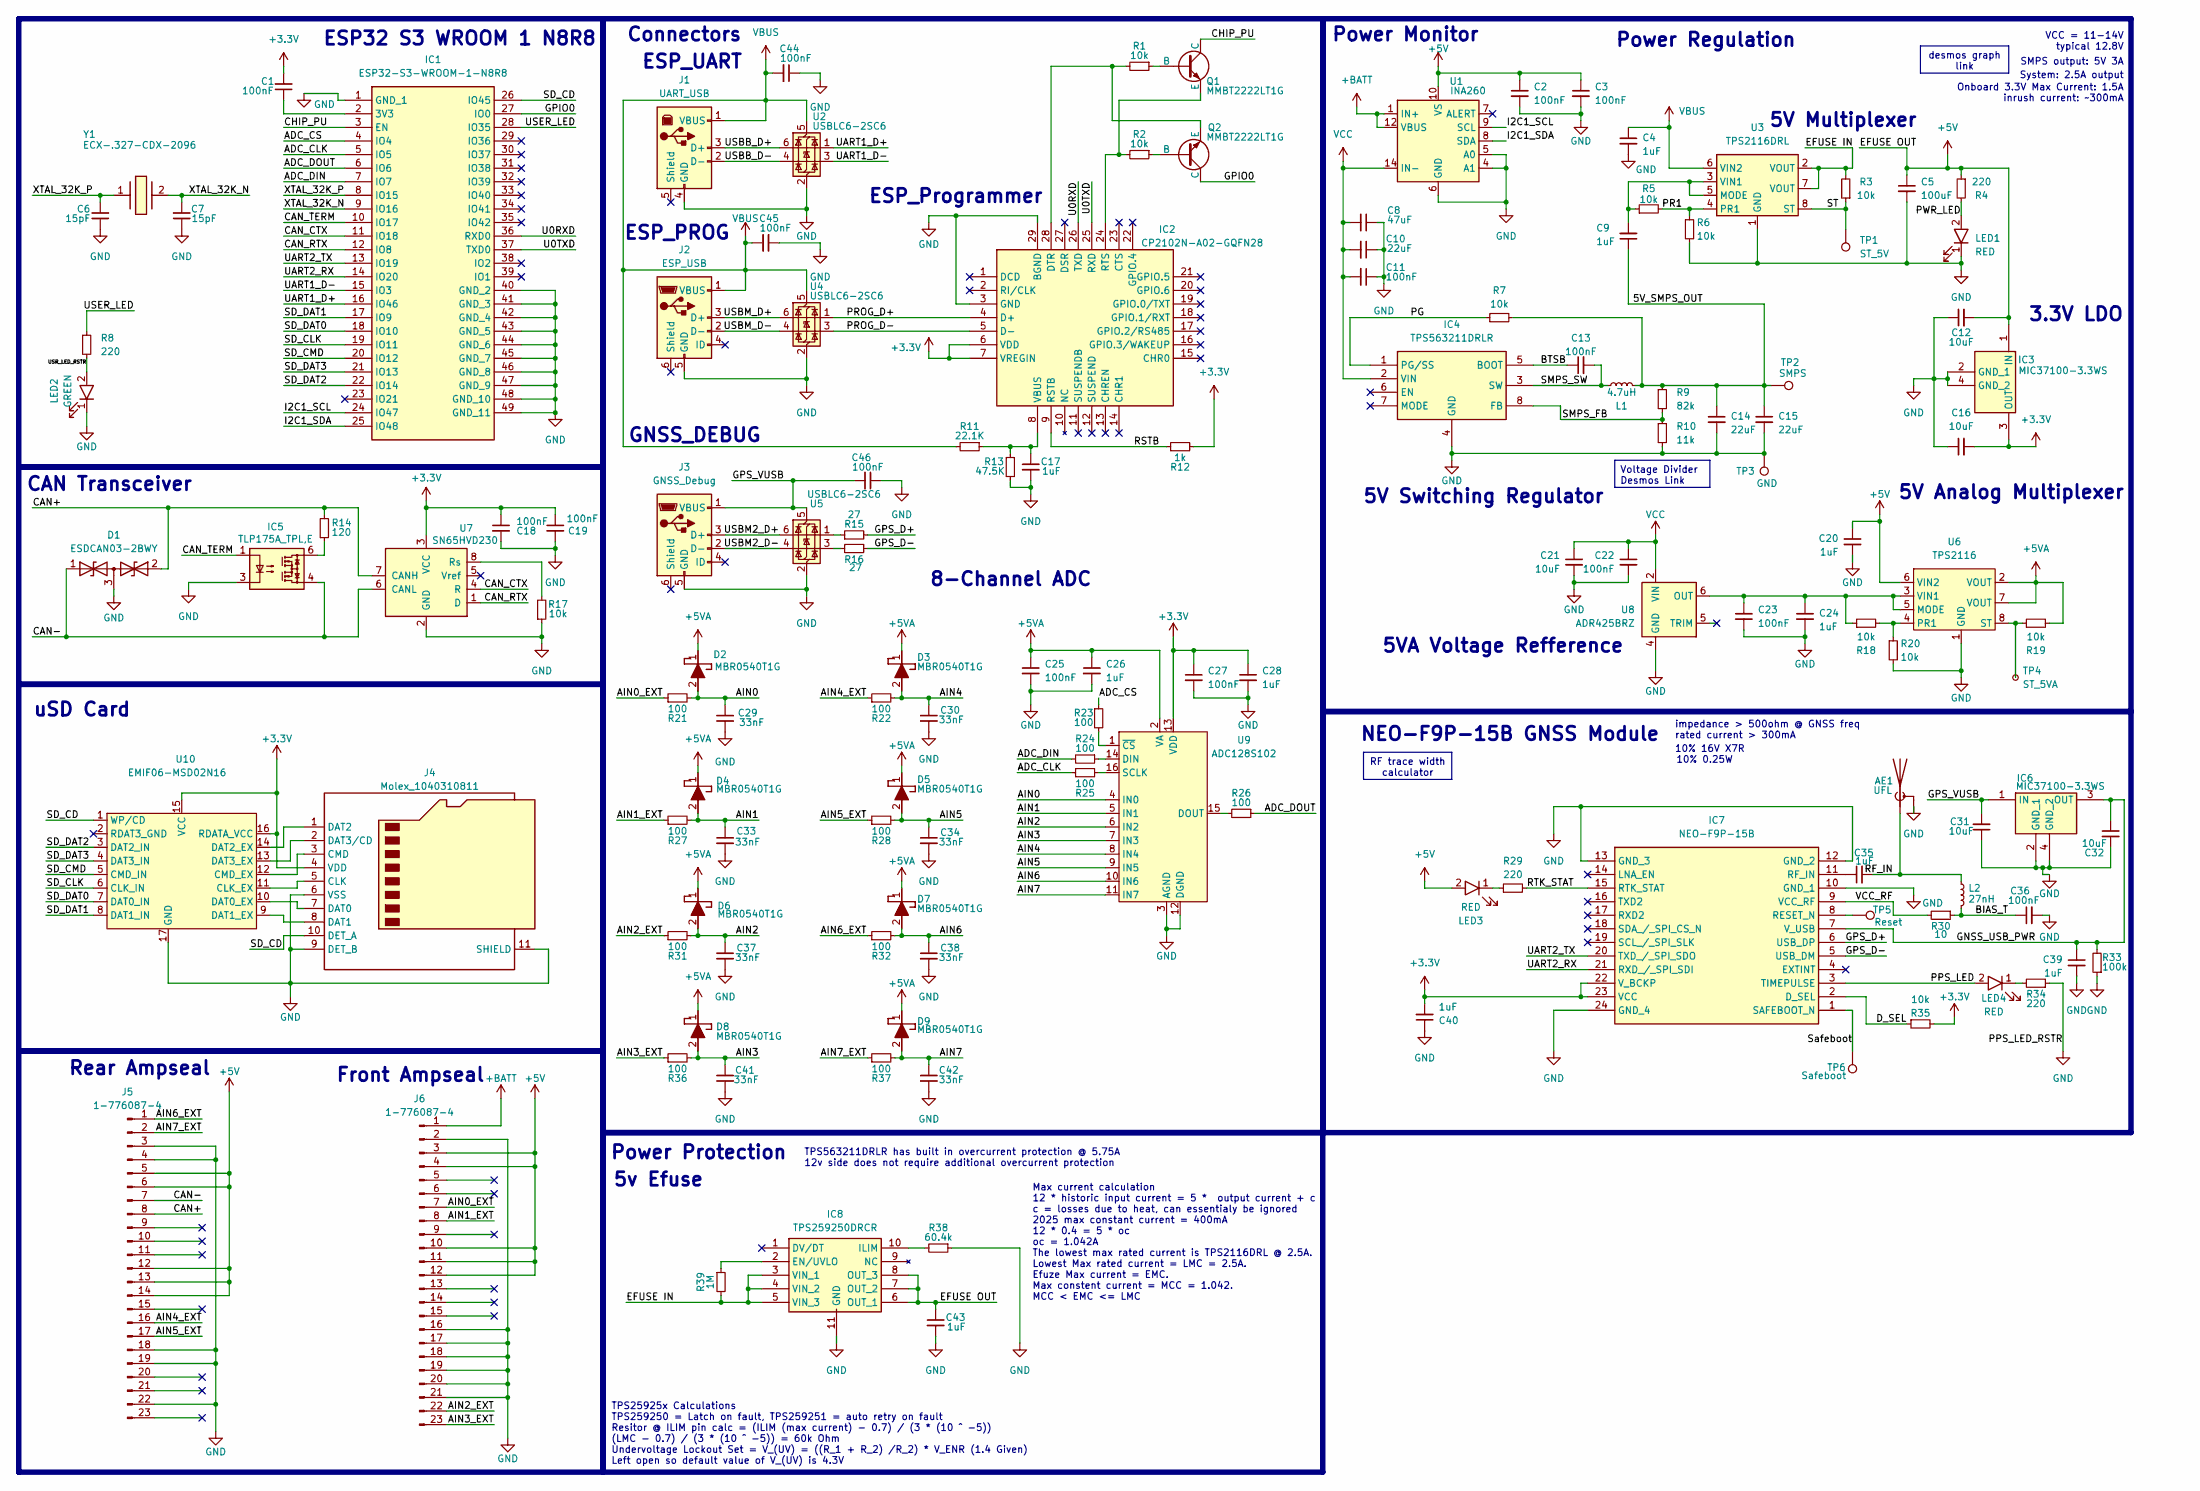
[picture p197: schematic SDM26LoggerV3.3.kicad_sch, SDM26 Datalogger]

Parts:
AE1: UFL; U.FL_Molex_MCRF_73412-0110_Vertical
C1, C2, C3, C11, C13, C18, C19, C22, C23, C25, C27, C36, C44, C45, C46: 100nF; C_0603_1608Metric
C4, C9, C17, C20, C24, C26, C28, C35, C39, C40, C43: 1uF; C_0603_1608Metric
C5: 100uF; CP_Elec_6.3x5.9
C6, C7: 15pF; C_0603_1608Metric
C8: 47uF; CP_Elec_6.3x5.9
C10, C14, C15: 22uF; C_0603_1608Metric
C12, C16, C21, C31, C32: 10uF; C_0603_1608Metric
C29, C30, C33, C34, C37, C38, C41, C42: 33nF; C_0603_1608Metric
D1: ESDCAN03-2BWY; SOT65P210X110-3N; Mouser Part Number 511-ESDCAN03-2BWY
D2, D3, D4, D5, D6, D7, D8, D9: MBR0540T1G; SOD3716X135N; Mouser Part Number 863-MBR0540T1G
IC1: ESP32-S3-WROOM-1-N8R8; ESP32S3WROOM1N8R8; Mouser Part Number 356-EP32S3WROOM1N8R8
IC2: CP2102N-A02-GQFN28; QFN50P500X500X80-29N-D; Mouser Part Number 634-CP2102NA02GQFN28
IC3, IC6: MIC37100-3.3WS; SOT230P700X180-4N; Mouser Part Number 998-MIC37100-3.3WS
IC4: TPS563211DRLR; SOTFL50P160X60-8N; Mouser Part Number 595-TPS563211DRLR
IC5: TLP175A_TPL,E; TLP266J; Mouser Part Number 757-TLP175A(TPLE
IC7: NEO-F9P-15B; NEOF9P15B; Mouser Part Number 377-NEO-F9P-15B
IC8: TPS259250DRCR; SON50P300X300X100-11L-D; Mouser Part Number 595-TPS259250DRCR
J1: UART_USB; 67068-7041
J2: ESP_USB; USB_Micro-B_Molex-105017-0001
J3: GNSS_Debug; USB_Micro-B_Molex-105017-0001
J4: Molex_1040310811; microSD_HC_Molex_104031-0811
J5, J6: 1-776087-4; CONN23_776087_TEC
L1: 4.7uH; L_Bourns_SRP7028A_7.3x6.6mm
L2: 27nH; L_0402_1005Metric
LED1, LED3, LED4: RED; SSFLXH100LID01; Mouser Part Number 696-SSFLXH100LID01
LED2: GREEN; SSFLXH100LID01; Mouser Part Number 696-SSFLXH100LID01
Q1, Q2: MMBT2222LT1G; SOT96P237X111-3N
R1, R2, R3, R5, R6, R7, R17, R18, R19, R20, R35: 10k; R_0603_1608Metric
R4, R8, R29, R34: 220; R_0603_1608Metric
R9: 82k; R_0603_1608Metric
R10: 11k; R_0603_1608Metric
R11: 22.1K; R_0603_1608Metric
R12: 1k; R_0603_1608Metric
R13: 47.5K; R_0603_1608Metric
R14: 120; R_0603_1608Metric
R15, R16: 27; R_0603_1608Metric
R21, R22, R23, R24, R25, R26, R27, R28, R31, R32, R36, R37: 100; R_0603_1608Metric
R30: 10; R_0603_1608Metric
R33: 100k; R_0603_1608Metric
R38: 60.4k; R_0603_1608Metric
R39: 1M; R_0603_1608Metric
TP1: ST_5V; TestPoint_Pad_1.5x1.5mm
TP2: SMPS; TestPoint_Pad_1.5x1.5mm
TP3: GND; TestPoint_Pad_1.5x1.5mm
TP4: ST_5VA; TestPoint_Pad_1.5x1.5mm
TP5: Reset; TestPoint_Pad_1.5x1.5mm
TP6: Safeboot; TestPoint_Pad_1.5x1.5mm
U1: INA260; TSSOP-16_4.4x5mm_P0.65mm
U2, U4, U5: USBLC6-2SC6; SOT-23-6
U3: TPS2116DRL; SOT-583-8
U6: TPS2116; SOT-5X3
U7: SN65HVD230; SOIC-8_3.9x4.9mm_P1.27mm
U8: ADR425BRZ; SOIC-8_3.9x4.9mm_P1.27mm
U9: ADC128S102; TSSOP-16_4.4x5mm_P0.65mm
U10: EMIF06-MSD02N16; UQFN-17-3.5x1.2mm
Y1: ECX-.327-CDX-2096; ECX327CDX2096; Mouser Part Number 520-X-.327-CDX2096

Connections:
+5V: C2.1, C3.1, C5.1, C12.2, C20.1, C43.1, IC3.1 (IN), IC8.6 (OUT_1), IC8.7 (OUT_2), IC8.8 (OUT_3), J5.5, J5.6, J5.12, J5.13, J5.14, J6.3, J6.4, J6.10, J6.11, J6.12, LED3.2 (A), R4.1, U1.10 (VS), U6.6 (VIN2)
+5VA: C25.1, C26.1, D2.1 (K), D3.1 (K), D4.1 (K), D5.1 (K), D6.1 (K), D7.1 (K), D8.1 (K), D9.1 (K), R19.2, U6.2 (VOUT), U6.7 (VOUT), U9.2 (VA)
+BATT: J6.1, U1.1 (IN+), U1.2 (IN+), U1.3 (IN+), U1.12 (VBUS)
/5V_SMPS_OUT: C9.1, C14.1, C15.1, L1.1, R7.2, R9.1, TP2.1
/ADC_CLK: IC1.5 (IO5), R25.1
/ADC_CS: IC1.4 (IO4), R23.1
/ADC_DIN: IC1.7 (IO7), R24.2
/ADC_DOUT: IC1.6 (IO6), R26.1
/AIN0: C29.1, D2.2 (A), R21.2, U9.4 (IN0)
/AIN0_EXT: J6.7, R21.1
/AIN1: C33.1, D4.2 (A), R27.2, U9.5 (IN1)
/AIN1_EXT: J6.8, R27.1
/AIN2: C37.1, D6.2 (A), R31.2, U9.6 (IN2)
/AIN2_EXT: J6.22, R31.1
/AIN3: C41.1, D8.2 (A), R36.2, U9.7 (IN3)
/AIN3_EXT: J6.23, R36.1
/AIN4: C30.1, D3.2 (A), R22.2, U9.8 (IN4)
/AIN4_EXT: J5.16, R22.1
/AIN5: C34.1, D5.2 (A), R28.2, U9.9 (IN5)
/AIN5_EXT: J5.17, R28.1
/AIN6: C38.1, D7.2 (A), R32.2, U9.10 (IN6)
/AIN6_EXT: J5.1, R32.1
/AIN7: C42.1, D9.2 (A), R37.2, U9.11 (IN7)
/AIN7_EXT: J5.2, R37.1
/BIAS_T: C36.1, L2.2, R30.1
/BTSB: C13.1, IC4.5 (BOOT)
/CAN+: D1.2, J5.8, R14.2, U7.7 (CANH)
/CAN-: D1.1, IC5.4, J5.7, U7.6 (CANL)
/CAN_CTX: IC1.11 (IO18), U7.4 (R)
/CAN_RTX: IC1.12 (IO8), U7.1 (D)
/CAN_TERM: IC1.10 (IO17), IC5.1
/CHIP_PU: IC1.3 (EN), Q1.1 (C)
/D_SEL: IC7.2 (D_SEL), R35.1
/EFUSE IN: IC8.3 (VIN_1), IC8.4 (VIN_2), IC8.5 (VIN_3), R3.2, R39.2, U3.2 (VOUT), U3.7 (VOUT)
/GNSS_USB_PWR: C32.1, C39.1, IC6.3 (OUT), IC7.7 (V_USB), R33.2
/GPIO0: IC1.27 (IO0), Q2.1 (C)
/GPS_D+: IC7.6 (USB_DP), R15.2
/GPS_D-: IC7.5 (USB_DM), R16.1
/GPS_VUSB: C31.2, C46.2, IC6.1 (IN), J3.1 (VBUS), U5.5 (VBUS)
/I2C1_SCL: IC1.24 (IO47), U1.9 (SCL)
/I2C1_SDA: IC1.25 (IO48), U1.8 (SDA)
/PG: IC4.1 (PG/SS), R7.1
/PPS_LED: IC7.3 (TIMEPULSE), LED4.2 (A)
/PR1: R5.2, R6.1, U3.4 (PR1)
/PROG_D+: IC2.4 (D+), U4.1 (I/O1)
/PROG_D-: IC2.5 (D-), U4.3 (I/O2)
/PWR_LED: LED1.2 (A), R4.2
/RF_IN: AE1.1 (A), C35.2, L2.1
/RSTB: IC2.9 (RSTB), R12.1
/RTK_STAT: IC7.15 (RTK_STAT), R29.2
/SD_CD: IC1.26 (IO45), J4.10 (DET_A), U10.1 (WP/CD)
/SD_CLK: IC1.19 (IO11), U10.6 (CLK_IN)
/SD_CMD: IC1.20 (IO12), U10.5 (CMD_IN)
/SD_DAT0: IC1.18 (IO10), U10.7 (DAT0_IN)
/SD_DAT1: IC1.17 (IO9), U10.8 (DAT1_IN)
/SD_DAT2: IC1.22 (IO14), U10.3 (DAT2_IN)
/SD_DAT3: IC1.21 (IO13), U10.4 (DAT3_IN)
/SMPS_FB: IC4.8 (FB), R9.2, R10.1
/SMPS_SW: C13.2, IC4.3 (SW), L1.2
/ST: R3.1, TP1.1, U3.8 (ST)
/Safeboot: IC7.1 (SAFEBOOT_N), TP6.1
/U0RXD: IC1.36 (RXD0), IC2.26 (TXD)
/U0TXD: IC1.37 (TXD0), IC2.25 (RXD)
/UART1_D+: IC1.16 (IO46), U2.1 (I/O1)
/UART1_D-: IC1.15 (IO3), U2.3 (I/O2)
/UART2_RX: IC1.14 (IO20), IC7.21 (RXD_/_SPI_SDI)
/UART2_TX: IC1.13 (IO19), IC7.20 (TXD_/_SPI_SDO)
/USBB_D+: J1.3 (D+), U2.6 (I/O1)
/USBB_D-: J1.2 (D-), U2.4 (I/O2)
/USBM2_D+: J3.3 (D+), U5.6 (I/O1)
/USBM2_D-: J3.2 (D-), U5.4 (I/O2)
/USBM_D+: J2.3 (D+), U4.6 (I/O1)
/USBM_D-: J2.2 (D-), U4.4 (I/O2)
/USER_LED: IC1.28 (IO35), R8.1
/USR_LED_RSTR: LED2.2 (A), R8.2
/VCC_RF: IC7.9 (VCC_RF), R30.2
/XTAL_32K_N: C7.2, IC1.9 (IO16), Y1.2
/XTAL_32K_P: C6.2, IC1.8 (IO15), Y1.1
GND: AE1.2 (Shield), C2.2, C3.2, C4.2, C5.2, C6.1, C7.1, C8.1, C10.1, C11.1, C12.1, C14.2, C15.2, C16.1, C17.2, C18.2, C19.2, C20.2, C21.2, C22.2, C23.2, C24.2, C25.2, C26.2, C27.2, C28.2, C29.2, C30.2, C31.1, C32.2, C33.2, C34.2, C36.2, C37.2, C38.2, C39.2, C40.1, C41.2, C42.2, C43.2, C44.1, C45.1, C46.1, D1.3, IC1.1 (GND_1), IC1.40 (GND_2), IC1.41 (GND_3), IC1.42 (GND_4), IC1.43 (GND_5), IC1.44 (GND_6), IC1.45 (GND_7), IC1.46 (GND_8), IC1.47 (GND_9), IC1.48 (GND_10), IC1.49 (GND_11), IC2.3 (GND), IC2.29 (BGND), IC3.2 (GND_1), IC3.4 (GND_2), IC4.4 (GND), IC5.3, IC6.2 (GND_1), IC6.4 (GND_2), IC7.10 (GND_1), IC7.12 (GND_2), IC7.13 (GND_3), IC7.24 (GND_4), IC8.11 (GND), J1.4 (GND), J2.5 (GND), J3.5 (GND), J4.6 (VSS), J4.9 (DET_B), J4.11 (SHIELD), J5.3, J5.4, J5.18, J5.19, J5.22, J6.2, J6.16, J6.17, J6.18, J6.19, J6.20, J6.21, LED1.1 (K), LED2.1 (K), R6.2, R10.2, R13.2, R17.1, R20.2, R33.1, R34.1, R38.1, TP3.1, U1.4 (A1), U1.5 (A0), U1.6 (GND), U1.11 (GND), U2.2 (GND), U3.1 (GND), U4.2 (GND), U5.2 (GND), U6.1 (GND), U7.2 (GND), U8.4 (GND), U9.3 (AGND), U9.12 (DGND), U10.17 (GND)
unnamed: IC2.28 (DTR), Q2.3 (E), R1.2
unnamed: IC2.24 (RTS), Q1.3 (E), R2.2
unnamed: C17.1, IC2.8 (VBUS), R11.1, R13.1
unnamed: IC5.6, R14.1
unnamed: IC7.8 (RESET_N), TP5.1
unnamed: C35.1, IC7.11 (RF_IN)
unnamed: IC8.2 (EN/UVLO), R39.1
unnamed: IC8.10 (ILIM), R38.2
unnamed: J4.5 (CLK), U10.11 (CLK_EX)
unnamed: J4.3 (CMD), U10.12 (CMD_EX)
unnamed: J4.7 (DAT0), U10.10 (DAT0_EX)
unnamed: J4.8 (DAT1), U10.9 (DAT1_EX)
unnamed: J4.1 (DAT2), U10.14 (DAT2_EX)
unnamed: J4.2 (DAT3/CD), U10.13 (DAT3_EX)
unnamed: LED3.1 (K), R29.1
unnamed: LED4.1 (K), R34.2
unnamed: Q1.2 (B), R1.1
unnamed: Q2.2 (B), R2.1
unnamed: R15.1, U5.1 (I/O1)
unnamed: R16.2, U5.3 (I/O2)
unnamed: C9.2, R5.1, U3.3 (VIN1), U3.5 (MODE)
unnamed: C23.1, C24.1, R18.1, U6.3 (VIN1), U6.5 (MODE), U8.6 (OUT)
unnamed: R18.2, R20.1, U6.4 (PR1)
unnamed: R19.1, TP4.1, U6.8 (ST)
unnamed: R17.2, U7.8 (Rs)
unnamed: R24.1, U9.14 (DIN)
unnamed: R26.2, U9.15 (DOUT)
unnamed: R25.2, U9.16 (SCLK)
unnamed: R23.2, U9.1 (~CS)
VBUS: C4.1, C44.2, C45.2, J1.1 (VBUS), J2.1 (VBUS), R11.2, U2.5 (VBUS), U3.6 (VIN2), U4.5 (VBUS)
VCC: C8.2, C10.2, C11.2, C21.1, C22.1, IC4.2 (VIN), U1.14 (IN-), U1.15 (IN-), U1.16 (IN-), U8.2 (VIN)

Notes on the sheet:
Power Regulation
5V Multiplexer
CAN Transceiver
10% 16V X7R
5v Efuse
inrush current: ~300mA
5V Switching Regulator
5V Analog Multiplexer
ESP32 S3 WROOM 1 N8R8
Power Monitor
Connectors
10% 0.25W
ESP_PROG
Onboard 3.3V Max Current: 1.5A
impedance > 500ohm @ GNSS freq rated current > 300mA
Front Ampseal
3.3V LDO
VCC = 11-14V typical 12.8V
GNSS_DEBUG
Max current calculation 12 * historic input current = 5 * output current + c c = losses due to heat, can essentialy be ignored 2025 max constant current = 400mA 12 * 0.4 = 5 * oc oc = 1.042A The lowest max rated current is TPS2116DRL @ 2.5A. Lowest Max rated current = LMC = 2.5A. Efuze Max current 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
ESP_UART
TPS563211DRLR has built in overcurrent protection @ 5.75A 12v side does not require additional overcurrent protection
8-Channel ADC
uSD Card
ESP_Programmer
Power Protection
5VA Voltage Refference
SMPS output: 5V 3A
NEO-F9P-15B GNSS Module
System: 2.5A output
Rear Ampseal
TPS25925x Calculations TPS259250 = Latch on fault, TPS259251 = auto retry on fault Resitor @ ILIM pin calc = (ILIM (max current) - 0.7) / (3 * (10 ^ -5)) (LMC - 0.7) / (3 * (10 ^ -5)) = 60k Ohm Undervoltage Lockout Set = V_(UV) = ((R_1 + R_2) /R_2) * V_ENR (1.4 Given) Left open so default value of 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
desmos graph link
Voltage Divider Desmos Link
RF trace width calculator

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
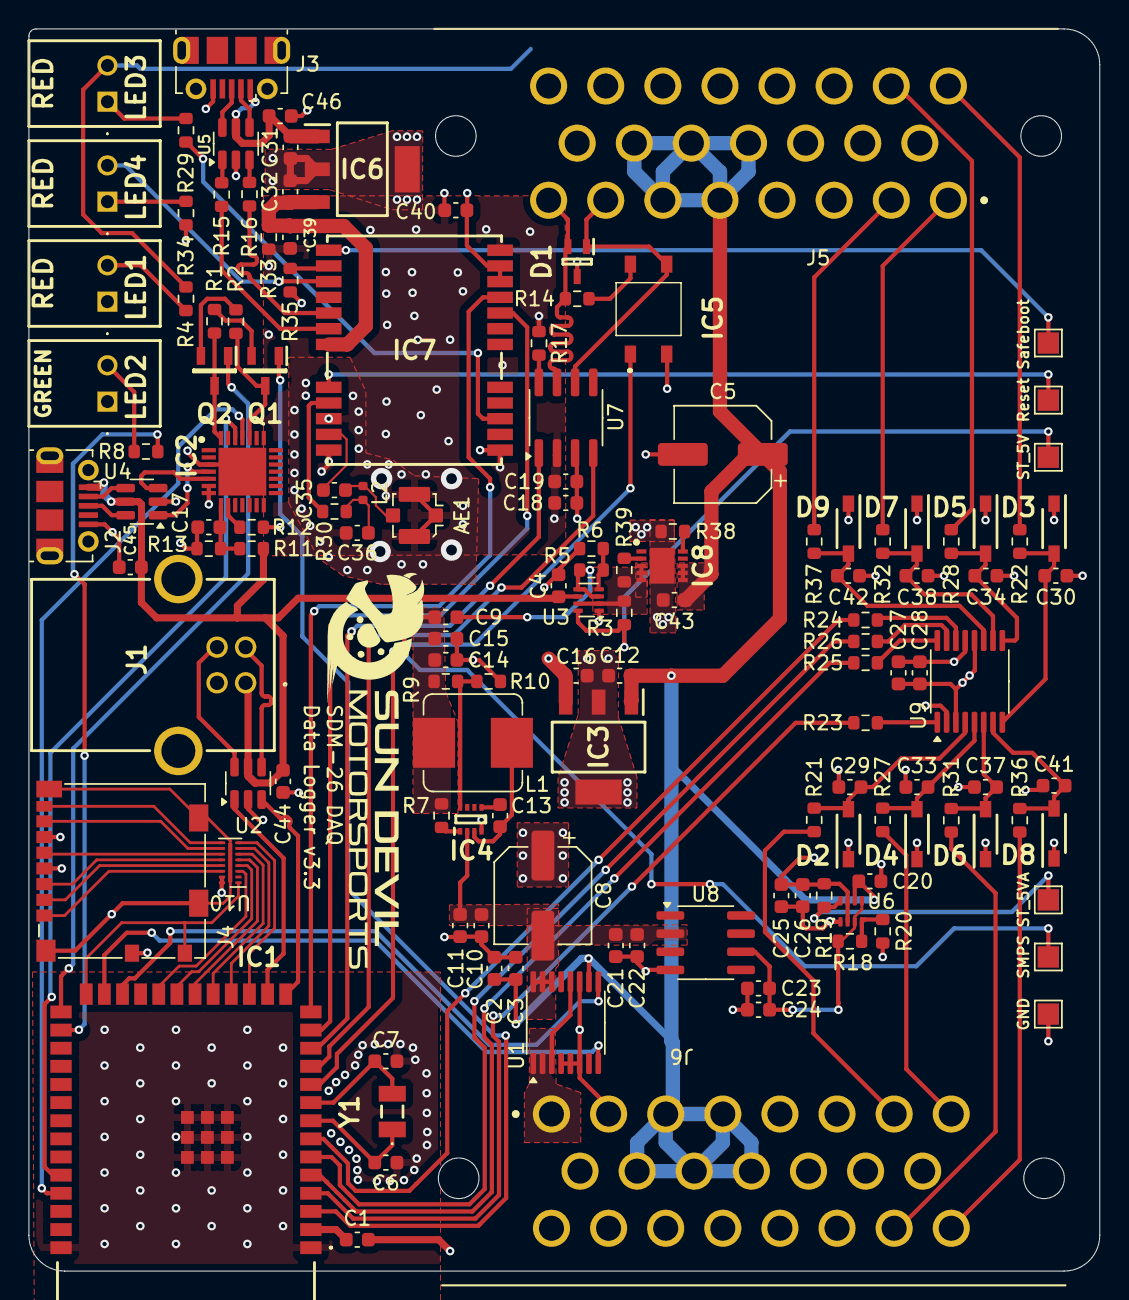
[picture p198: board SDM26LoggerV3.3.kicad_pcb from above]

Board: 4 copper layers, 75.0 x 87.0 mm, 134 parts (0 on the bottom side), 112 nets.
