sundevilmotorsports/pcb-dev/2026/BSPD/SDM26_BSPD_V1.1/SDM26_BSPD_V1.1.kicad_pcb

## KiCad design 2026/BSPD/SDM26_BSPD_V1.1/SDM26_BSPD_V1.1.kicad_pcb (2026-11-06)

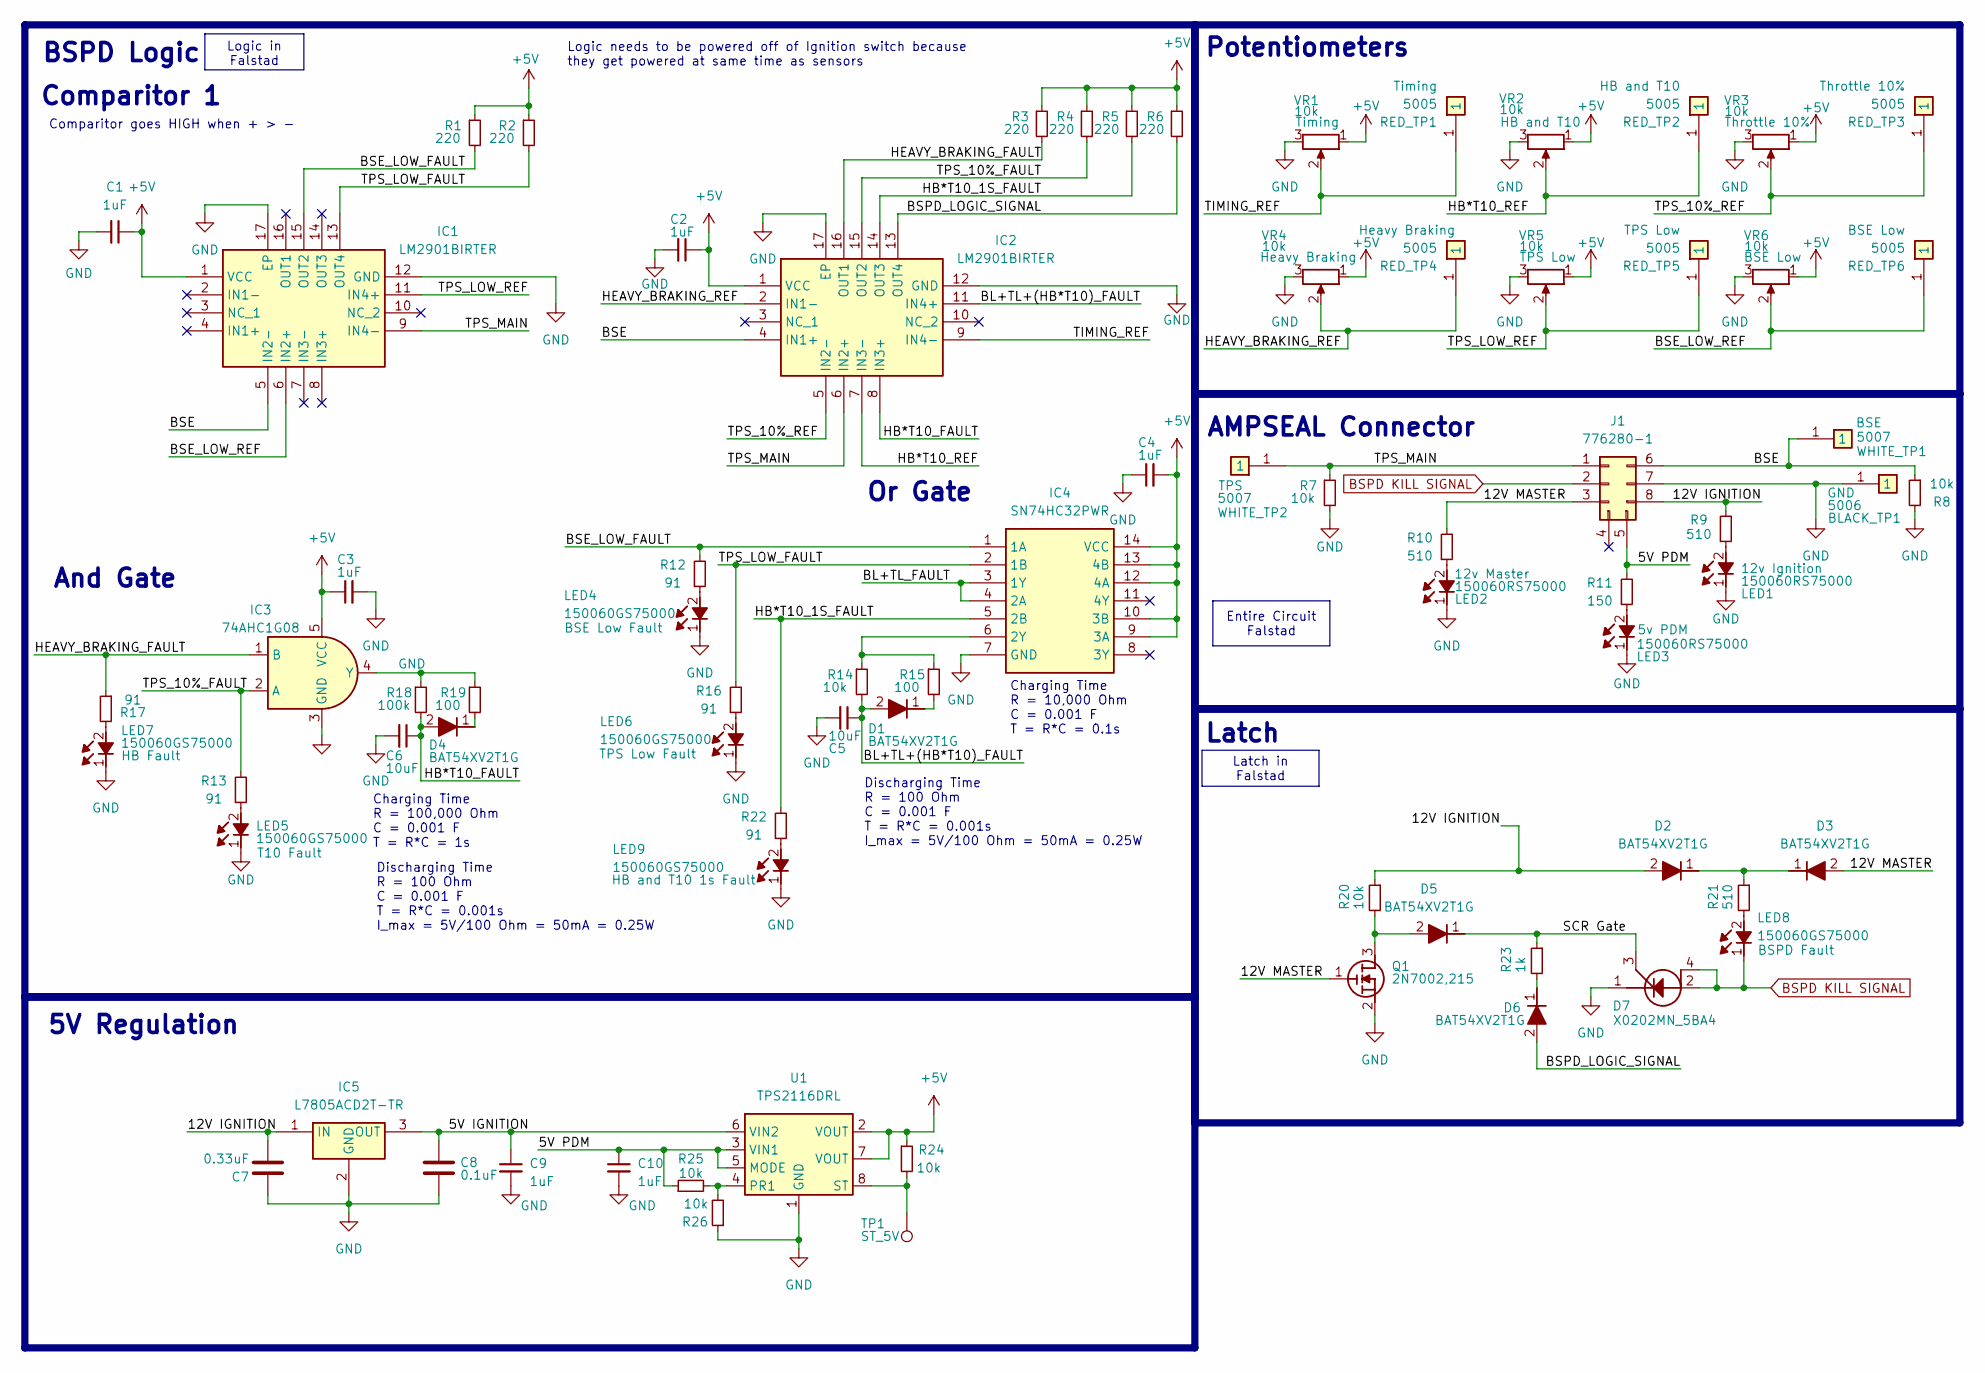
[picture p199: schematic SDM26_BSPD_V1.1.kicad_sch, SDM26 BSPD]

Parts:
BLACK_TP1: 5006; Mouser Part Number 534-5006
C1, C2, C3, C4, C9, C10: 1uF; C_0603_1608Metric
C5, C6: 10uF; C_0603_1608Metric
C7: 0.33uF; C_0603_1608Metric
C8: 0.1uF; C_0603_1608Metric
D1, D2, D3, D4, D5, D6: BAT54XV2T1G; SODFL1608X70N; Mouser Part Number 863-BAT54XV2T1G
D7: X0202MN_5BA4; SOT230P700X190-4N; Mouser Part Number 511-X0202MN
IC1, IC2: LM2901BIRTER; QFN50P300X300X80-17N-D; Mouser Part Number 595-LM2901BIRTER
IC3: 74AHC1G08; SOT65P212X110-5L; Mouser Part Number 771-74AHC1G08GW-G
IC4: SN74HC32PWR; SOP65P640X120-14L; Mouser Part Number 595-SN74HC32PWR
IC5: L7805ACD2T-TR; L7805ACD2TTR; Mouser Part Number 511-L7805ACD2T-TR
J1: 776280-1; Mouser Part Number 571-776280-1
LED1, LED2, LED3: 150060RS75000; LEDC1608X80N; Mouser Part Number 710-150060RS75000
LED4, LED5, LED6, LED7, LED8, LED9: 150060GS75000; LEDC1608X80N; Mouser Part Number 710-150060GS75000
Q1: 2N7002,215; SOT95P230X110-3N; Mouser Part Number 771-2N7002-T/R
R1, R2, R3, R4, R5, R6: 220; R_0603_1608Metric
R7, R8, R14, R20, R24, R25, R26: 10k; R_0603_1608Metric
R9, R10, R21: 510; R_0603_1608Metric
R11: 150; R_0603_1608Metric
R12, R13, R16, R17, R22: 91; R_0603_1608Metric
R15, R19: 100; R_0603_1608Metric
R18: 100k; R_0603_1608Metric
R23: 1k; R_0603_1608Metric
RED_TP1, RED_TP2, RED_TP3, RED_TP4, RED_TP5, RED_TP6: 5005; Mouser Part Number 534-5005
TP1: ST_5V; TestPoint_Pad_1.5x1.5mm
U1: TPS2116DRL; SOT-583-8
VR1, VR2, VR3, VR4, VR5, VR6: 10k; 3386P1103TLF; Mouser Part Number 652-3386P-1-103TLF
WHITE_TP1, WHITE_TP2: 5007; Mouser Part Number 534-5007

Connections:
+5V: C1.1, C2.1, C3.1, C4.2, IC1.1 (VCC), IC2.1 (VCC), IC3.5 (VCC), IC4.9 (3A), IC4.10 (3B), IC4.12 (4A), IC4.13 (4B), IC4.14 (VCC), R1.1, R2.1, R3.1, R4.1, R5.1, R6.1, R24.1, U1.2 (VOUT), U1.7 (VOUT), VR1.1 (CCW), VR2.1 (CCW), VR3.1 (CCW), VR4.1 (CCW), VR5.1 (CCW), VR6.1 (CCW)
/5V IGNITION: C8.2, C9.1, IC5.3 (OUT), U1.6 (VIN2)
/5V PDM: C10.1, J1.5, R11.2, R25.1, U1.3 (VIN1), U1.5 (MODE)
/12V IGNITION: C7.2, D2.2 (A), IC5.1 (IN), J1.8, R9.2, R20.1
/12V MASTER: D3.2 (A), J1.3, Q1.1 (G), R10.2
/BL+TL+(HB*T10)_FAULT: C5.1, D1.2 (A), IC2.11 (IN4+), R14.2
/BL+TL_FAULT: IC4.3 (1Y), IC4.4 (2A)
/BSE: IC1.5 (IN2-), IC2.4 (IN1+), J1.6, R8.1, WHITE_TP1.1
/BSE_LOW_FAULT: IC1.15 (OUT2), IC4.1 (1A), R1.2, R12.2
/BSE_LOW_REF: IC1.6 (IN2+), RED_TP6.1, VR6.2 (Wiper)
/BSPD_LOGIC_SIGNAL: D6.2 (A), IC2.13 (OUT4), R6.2
/HB*T10_1S_FAULT: IC2.14 (OUT3), IC4.5 (2B), R5.2, R22.2
/HB*T10_FAULT: C6.1, D4.2 (A), IC2.8 (IN3+), R18.2
/HB*T10_REF: IC2.7 (IN3-), RED_TP2.1, VR2.2 (Wiper)
/HEAVY_BRAKING_FAULT: IC2.16 (OUT1), IC3.1 (B), R3.2, R17.1
/HEAVY_BRAKING_REF: IC2.2 (IN1-), RED_TP4.1, VR4.2 (Wiper)
/SCR Gate: D5.1 (K), D7.3 (G), R23.1
/TIMING_REF: IC2.9 (IN4-), RED_TP1.1, VR1.2 (Wiper)
/TPS_10%_FAULT: IC2.15 (OUT2), IC3.2 (A), R4.2, R13.2
/TPS_10%_REF: IC2.5 (IN2-), RED_TP3.1, VR3.2 (Wiper)
/TPS_LOW_FAULT: IC1.13 (OUT4), IC4.2 (1B), R2.2, R16.2
/TPS_LOW_REF: IC1.11 (IN4+), RED_TP5.1, VR5.2 (Wiper)
/TPS_MAIN: IC1.9 (IN4-), IC2.6 (IN2+), J1.1, R7.1, WHITE_TP2.1
BSPD KILL SIGNAL: D7.2 (A_1), D7.4 (A_2), J1.2, LED8.1 (K)
GND: BLACK_TP1.1, C1.2, C2.2, C3.2, C4.1, C5.2, C6.2, C7.1, C8.1, C9.2, C10.2, D7.1 (K), IC1.12 (GND), IC1.17 (EP), IC2.12 (GND), IC2.17 (EP), IC3.3 (GND), IC4.7 (GND), IC5.2 (GND), J1.7, LED1.1 (K), LED2.1 (K), LED3.1 (K), LED4.1 (K), LED5.1 (K), LED6.1 (K), LED7.1 (K), LED9.1 (K), Q1.2 (S), R7.2, R8.2, R26.1, U1.1 (GND), VR1.3 (CW), VR2.3 (CW), VR3.3 (CW), VR4.3 (CW), VR5.3 (CW), VR6.3 (CW)
unnamed: D1.1 (K), R15.2
unnamed: D2.1 (K), D3.1 (K), R21.1
unnamed: D4.1 (K), R19.2
unnamed: D5.2 (A), Q1.3 (D), R20.2
unnamed: D6.1 (K), R23.2
unnamed: IC3.4 (Y), R18.1, R19.1
unnamed: IC4.6 (2Y), R14.1, R15.1
unnamed: LED1.2 (A), R9.1
unnamed: LED2.2 (A), R10.1
unnamed: LED3.2 (A), R11.1
unnamed: LED4.2 (A), R12.1
unnamed: LED5.2 (A), R13.1
unnamed: LED6.2 (A), R16.1
unnamed: LED7.2 (A), R17.2
unnamed: LED8.2 (A), R21.2
unnamed: LED9.2 (A), R22.1
unnamed: R25.2, R26.2, U1.4 (PR1)
unnamed: R24.2, TP1.1, U1.8 (ST)

Notes on the sheet:
5V Regulation
Latch
Discharging Time R = 100 Ohm C = 0.001 F T = R*C = 0.001s I_max = 5V/100 Ohm = 50mA = 0.25W
And Gate
Comparitor goes HIGH when + > -
Potentiometers
Logic needs to be powered off of Ignition switch because they get powered at same time as sensors
Charging Time R = 100,000 Ohm C = 0.001 F T = R*C = 1s
Charging Time R = 10,000 Ohm C = 0.001 F T = R*C = 0.1s
AMPSEAL Connector
BSPD Logic
Or Gate
Comparitor 1
Latch in Falstad
Entire Circuit Falstad
Logic in Falstad

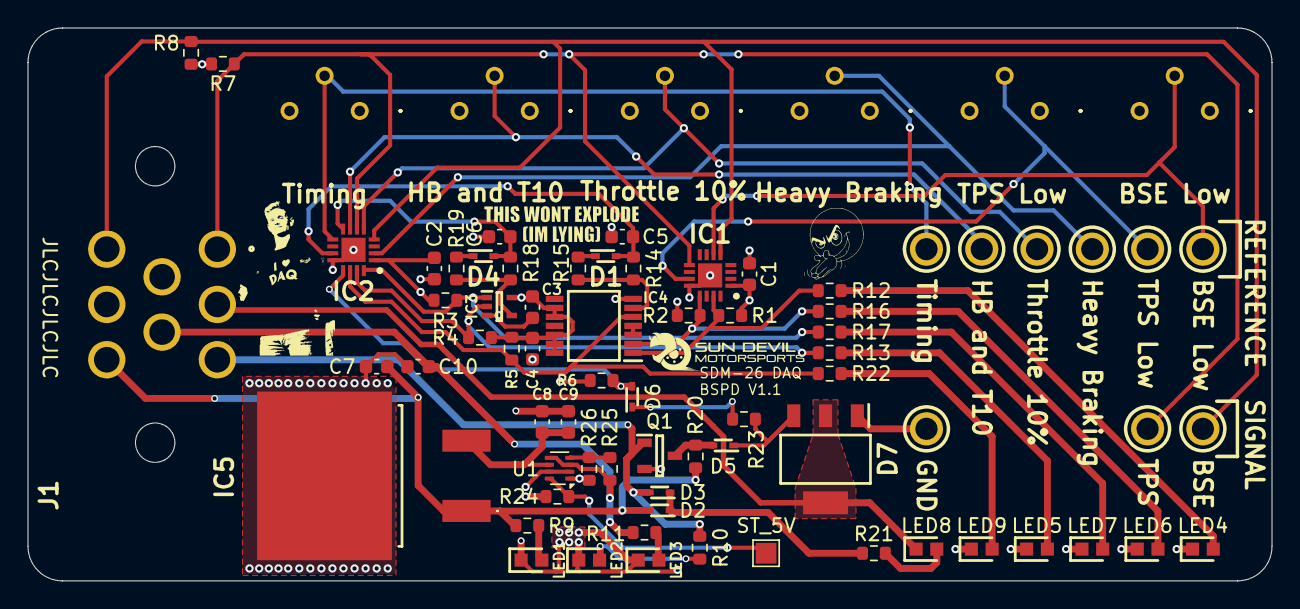
[picture p200: board SDM26_BSPD_V1.1.kicad_pcb from above]

Board: 4 copper layers, 90.0 x 40.0 mm, 76 parts (0 on the bottom side), 43 nets.
