sundevilmotorsports/pcb-dev/2026/NondimensionalTractionControl/SDM26_NondimensionalTractionControl_V1.2/NondimensionalTractionControl_V1.2.kicad_pcb

## KiCad design 2026/NondimensionalTractionControl/SDM26_NondimensionalTractionControl_V1.2/NondimensionalTractionControl_V1.2.kicad_pcb (2026-11-06)

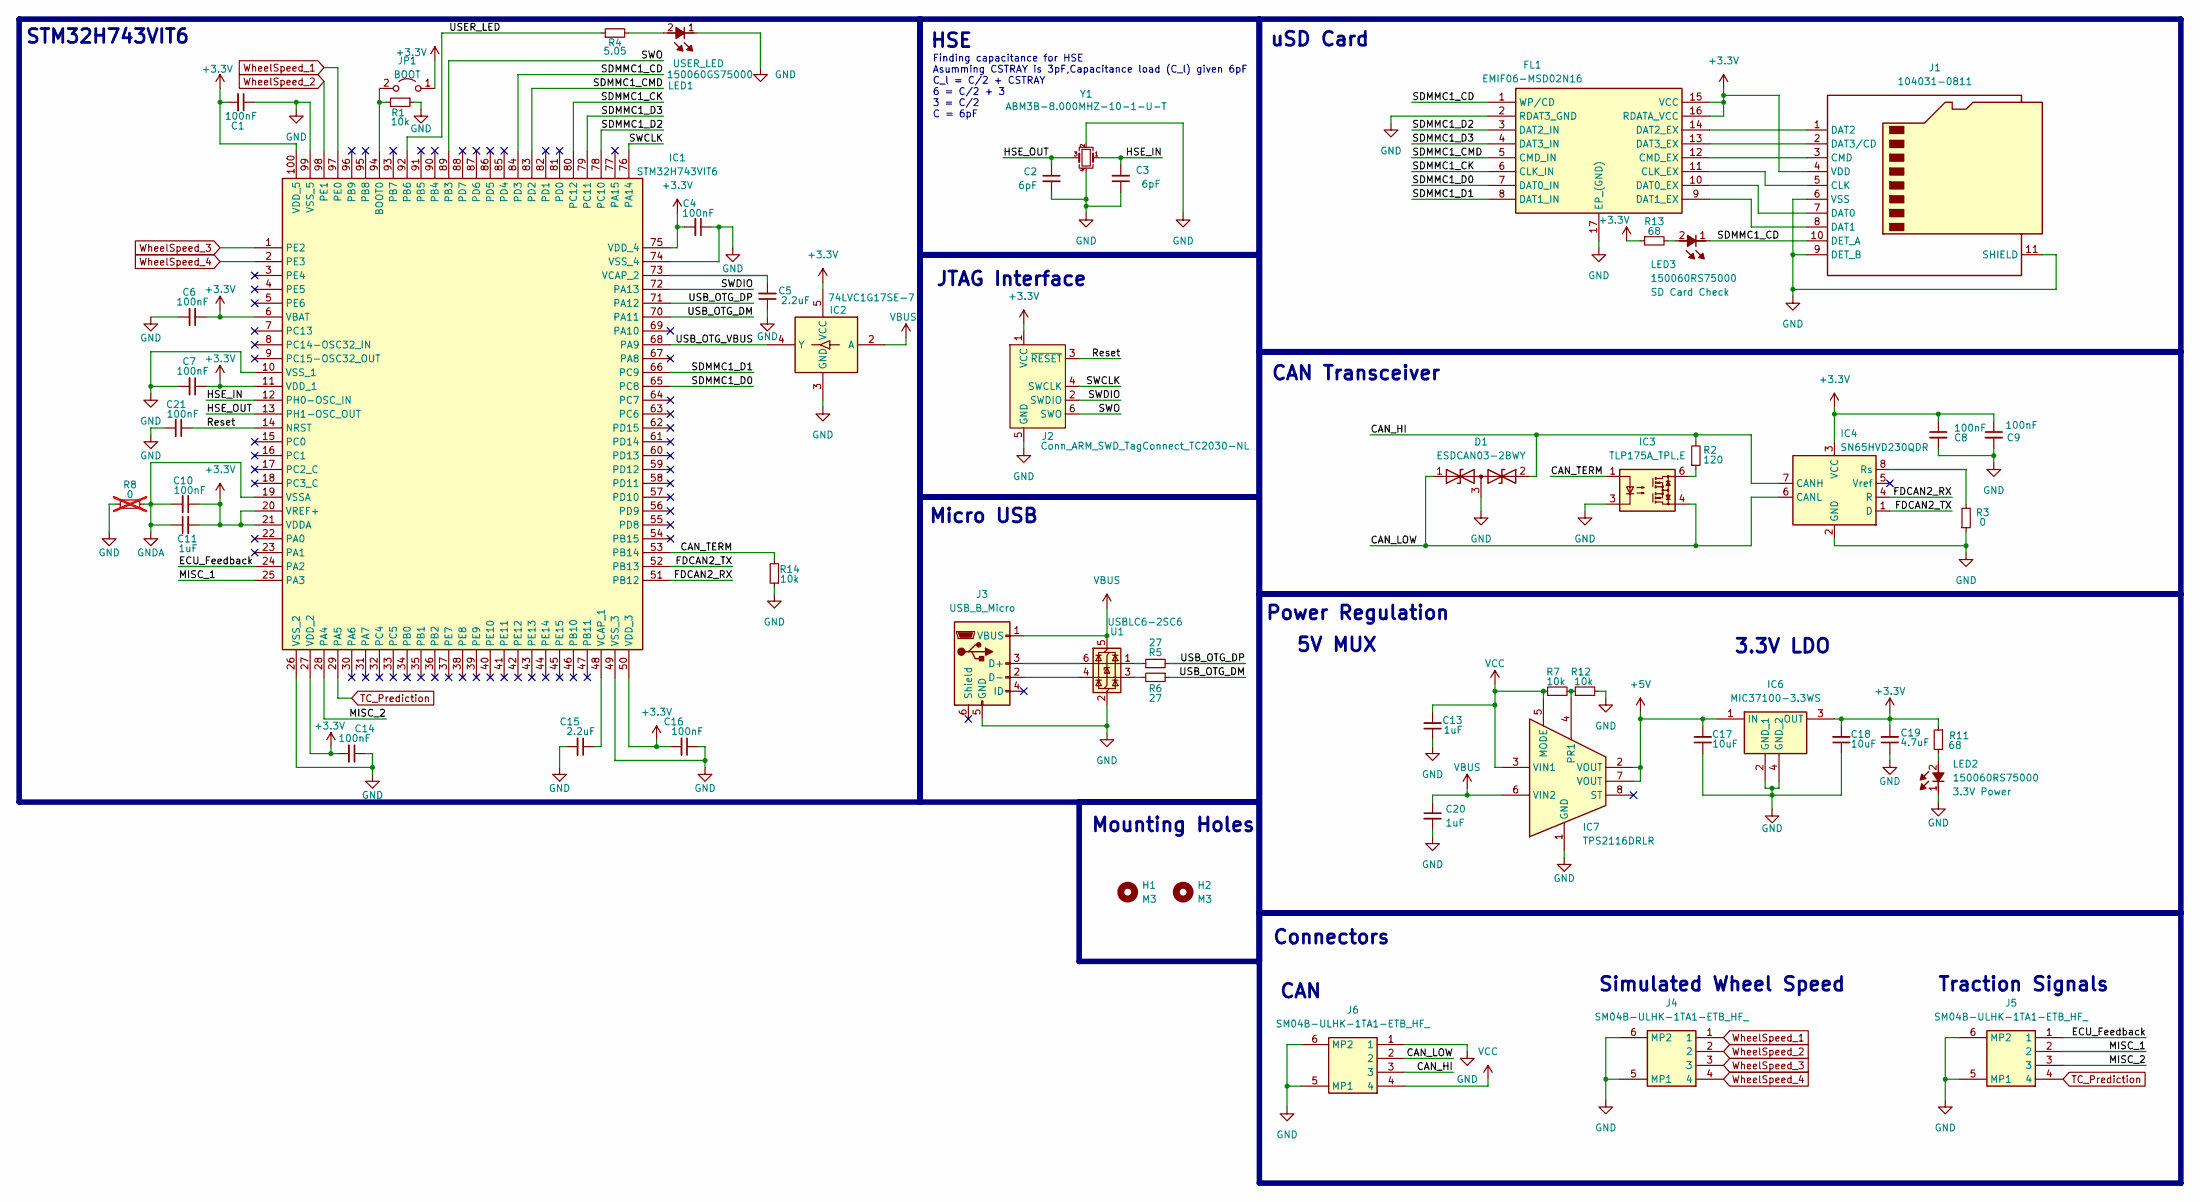
[picture p201: schematic NondimensionalTractionControl_V1.2.kicad_sch, SDM26 Nondimensional Traction Controll Module]

Parts:
C1, C4, C6, C7, C8, C9, C10, C14, C16, C21: 100nF; C_0603_1608Metric
C2, C3: 6pF; C_0603_1608Metric
C5, C15: 2.2uF; C_0603_1608Metric
C11, C13, C20: 1uF; C_0603_1608Metric
C17, C18: 10uF; C_0603_1608Metric
C19: 4.7uF; C_0603_1608Metric
D1: ESDCAN03-2BWY; SOT65P210X110-3N; Mouser Part Number 511-ESDCAN03-2BWY
FL1: EMIF06-MSD02N16; EMIF06MSD02N16; Mouser Part Number 511-EMIF06-MSD02N16
H1, H2: M3; MountingHole_3.2mm_M3
IC1: STM32H743VIT6; QFP50P1600X1600X160-100L; Mouser Part Number 511-STM32H743VIT6
IC2: 74LVC1G17SE-7; SOT65P210X110-5L; Mouser Part Number 621-74LVC1G17SE-7
IC3: TLP175A_TPL,E; TLP266J; Mouser Part Number 757-TLP175A(TPLE
IC4: SN65HVD230QDR; SOIC127P600X175-8L; Mouser Part Number 595-SN65HVD230QDR
IC6: MIC37100-3.3WS; SOT230P700X180-4N; Mouser Part Number 998-MIC37100-3.3WS
IC7: TPS2116DRLR; SOTFL50P160X60-8L; Mouser Part Number 595-TPS2116DRLR
J1: 104031-0811; 1040310811; Mouser Part Number 538-104031-0811
J2: Conn_ARM_SWD_TagConnect_TC2030-NL; Tag-Connect_TC2030-IDC-NL_2x03_P1.27mm_Vertical
J3: USB_B_Micro; USB_Micro-B_Molex-105017-0001
J4, J5, J6: SM04B-ULHK-1TA1-ETB_HF_; SM04BULHK1TA1ETBHF; Mouser Part Number 306-SM4BULH1TA1ETBHF
JP1: BOOT; PinHeader_1x02_P2.54mm_Vertical
LED1: 150060GS75000; LEDC1608X80N; Mouser Part Number 710-150060GS75000
LED2, LED3: 150060RS75000; LEDC1608X80N; Mouser Part Number 710-150060RS75000
R1, R7, R12, R14: 10k; R_0603_1608Metric
R2: 120; R_0603_1608Metric
R3: 0; R_0603_1608Metric
R4: 5.05; R_0603_1608Metric
R5, R6: 27; R_0603_1608Metric
R8: 0; R_0603_1608Metric; not fitted
R11, R13: 68; R_0603_1608Metric
U1: USBLC6-2SC6; SOT-23-6
Y1: ABM3B-8.000MHZ-10-1-U-T; ABM3B; Mouser Part Number 815-ABM3B8MHZ101UT

Connections:
+3.3V: C1.2, C4.2, C6.1, C7.1, C8.1, C9.1, C10.1, C11.2, C14.2, C16.2, C18.2, C19.2, FL1.15 (VCC), FL1.16 (RDATA_VCC), IC1.6 (VBAT), IC1.11 (VDD_1), IC1.20 (VREF+), IC1.21 (VDDA), IC1.27 (VDD_2), IC1.50 (VDD_3), IC1.75 (VDD_4), IC1.100 (VDD_5), IC2.5 (VCC), IC4.3 (VCC), IC6.3 (OUT), J1.4 (VDD), J2.1 (VCC), JP1.1 (A), R11.1, R13.1
+5V: C17.2, IC6.1 (IN), IC7.2 (VOUT), IC7.7 (VOUT)
/CAN_HI: D1.2, IC4.7 (CANH), J6.3, R2.2
/CAN_LOW: D1.1, IC3.4, IC4.6 (CANL), J6.2
/CAN_TERM: IC1.53 (PB14), IC3.1, R14.2
/ECU_Feedback: IC1.24 (PA2), J5.1
/FDCAN2_RX: IC1.51 (PB12), IC4.4 (R)
/FDCAN2_TX: IC1.52 (PB13), IC4.1 (D)
/HSE_IN: C3.2, IC1.12 (PH0-OSC_IN), Y1.1 (XTAL_1)
/HSE_OUT: C2.1, IC1.13 (PH1-OSC_OUT), Y1.3 (XTAL_2)
/MISC_1: IC1.25 (PA3), J5.2
/MISC_2: IC1.28 (PA4), J5.3
/Reset: C21.1, IC1.14 (NRST), J2.3 (~RESET)
/SDMMC1_CD: FL1.1 (WP/CD), IC1.84 (PD3), J1.10 (DET_A), LED3.1 (K)
/SDMMC1_CK: FL1.6 (CLK_IN), IC1.80 (PC12)
/SDMMC1_CMD: FL1.5 (CMD_IN), IC1.83 (PD2)
/SDMMC1_D0: FL1.7 (DAT0_IN), IC1.65 (PC8)
/SDMMC1_D1: FL1.8 (DAT1_IN), IC1.66 (PC9)
/SDMMC1_D2: FL1.3 (DAT2_IN), IC1.78 (PC10)
/SDMMC1_D3: FL1.4 (DAT3_IN), IC1.79 (PC11)
/SWCLK: IC1.76 (PA14), J2.4 (SWCLK)
/SWDIO: IC1.72 (PA13), J2.2 (SWDIO)
/SWO: IC1.89 (PB3), J2.6 (SWO)
/USB_OTG_DM: IC1.70 (PA11), R6.1
/USB_OTG_DP: IC1.71 (PA12), R5.2
/USB_OTG_VBUS: IC1.68 (PA9), IC2.4 (Y)
/USER_LED: IC1.92 (PB6), R4.1
GND: C1.1, C2.2, C3.1, C4.1, C5.1, C6.2, C7.2, C8.2, C9.2, C13.1, C14.1, C15.2, C16.1, C17.1, C18.1, C19.1, C20.2, C21.2, D1.3, FL1.2 (RDAT3_GND), FL1.17 (EP_(GND)), IC1.10 (VSS_1), IC1.26 (VSS_2), IC1.49 (VSS_3), IC1.74 (VSS_4), IC1.99 (VSS_5), IC2.3 (GND), IC3.3, IC4.2 (GND), IC6.2 (GND_1), IC6.4 (GND_2), IC7.1 (GND), J1.6 (VSS), J1.9 (DET_B), J1.11 (SHIELD), J2.5 (GND), J3.5 (GND), J4.5 (MP1), J4.6 (MP2), J5.5 (MP1), J5.6 (MP2), J6.1, J6.5 (MP1), J6.6 (MP2), LED1.1 (K), LED2.1 (K), R1.1, R3.1, R8.2, R12.2, R14.1, U1.2 (GND), Y1.2 (GND_1), Y1.4 (GND_2)
GNDA: C10.2, C11.1, IC1.19 (VSSA), R8.1
unnamed: FL1.11 (CLK_EX), J1.5 (CLK)
unnamed: FL1.12 (CMD_EX), J1.3 (CMD)
unnamed: FL1.10 (DAT0_EX), J1.7 (DAT0)
unnamed: FL1.9 (DAT1_EX), J1.8 (DAT1)
unnamed: FL1.14 (DAT2_EX), J1.1 (DAT2)
unnamed: FL1.13 (DAT3_EX), J1.2 (DAT3/CD)
unnamed: IC1.94 (BOOT0), JP1.2 (B), R1.2
unnamed: C15.1, IC1.48 (VCAP_1)
unnamed: C5.2, IC1.73 (VCAP_2)
unnamed: IC3.6, R2.1
unnamed: IC4.8 (Rs), R3.2
unnamed: IC7.4 (PR1), R7.2, R12.1
unnamed: J3.3 (D+), U1.6 (I/O1)
unnamed: J3.2 (D-), U1.4 (I/O2)
unnamed: LED1.2 (A), R4.2
unnamed: LED2.2 (A), R11.2
unnamed: LED3.2 (A), R13.2
unnamed: R5.1, U1.1 (I/O1)
unnamed: R6.2, U1.3 (I/O2)
TC_Prediction: IC1.29 (PA5), J5.4
VBUS: C20.1, IC2.2 (A), IC7.6 (VIN2), J3.1 (VBUS), U1.5 (VBUS)
VCC: C13.2, IC7.3 (VIN1), IC7.5 (MODE), J6.4, R7.1
WheelSpeed_1: IC1.97 (PE0), J4.1
WheelSpeed_2: IC1.98 (PE1), J4.2
WheelSpeed_3: IC1.1 (PE2), J4.3
WheelSpeed_4: IC1.2 (PE3), J4.4

Notes on the sheet:
HSE
Power Regulation
Traction Signals
Mounting Holes
Simulated Wheel Speed
STM32H743VIT6
uSD Card
CAN
CAN Transceiver
JTAG Interface
3.3V LDO
5V MUX
Finding capacitance for HSE Asumming CSTRAY is 3pF,Capacitance load (C_l) given 6pF C_l = C/2 + CSTRAY 6 = C/2 + 3 3 = C/2 C = 6pF
Connectors
Micro USB

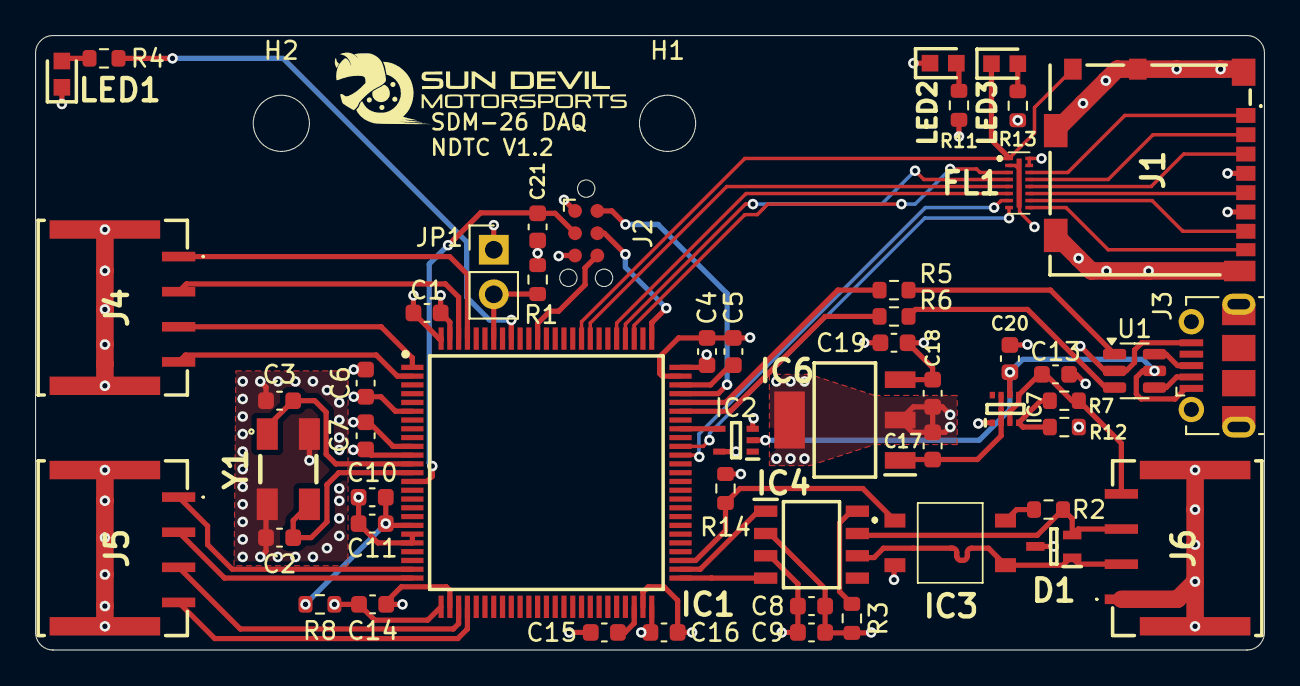
[picture p202: board NondimensionalTractionControl_V1.2.kicad_pcb from above]

Board: 4 copper layers, 70.0 x 35.0 mm, 54 parts (0 on the bottom side), 55 nets.
