sundevilmotorsports/pcb-dev/2026/ESP32_MCU_Template/ESP32_MCU_Template.kicad_pcb

## KiCad design 2026/ESP32_MCU_Template/ESP32_MCU_Template.kicad_pcb (2026-11-06)

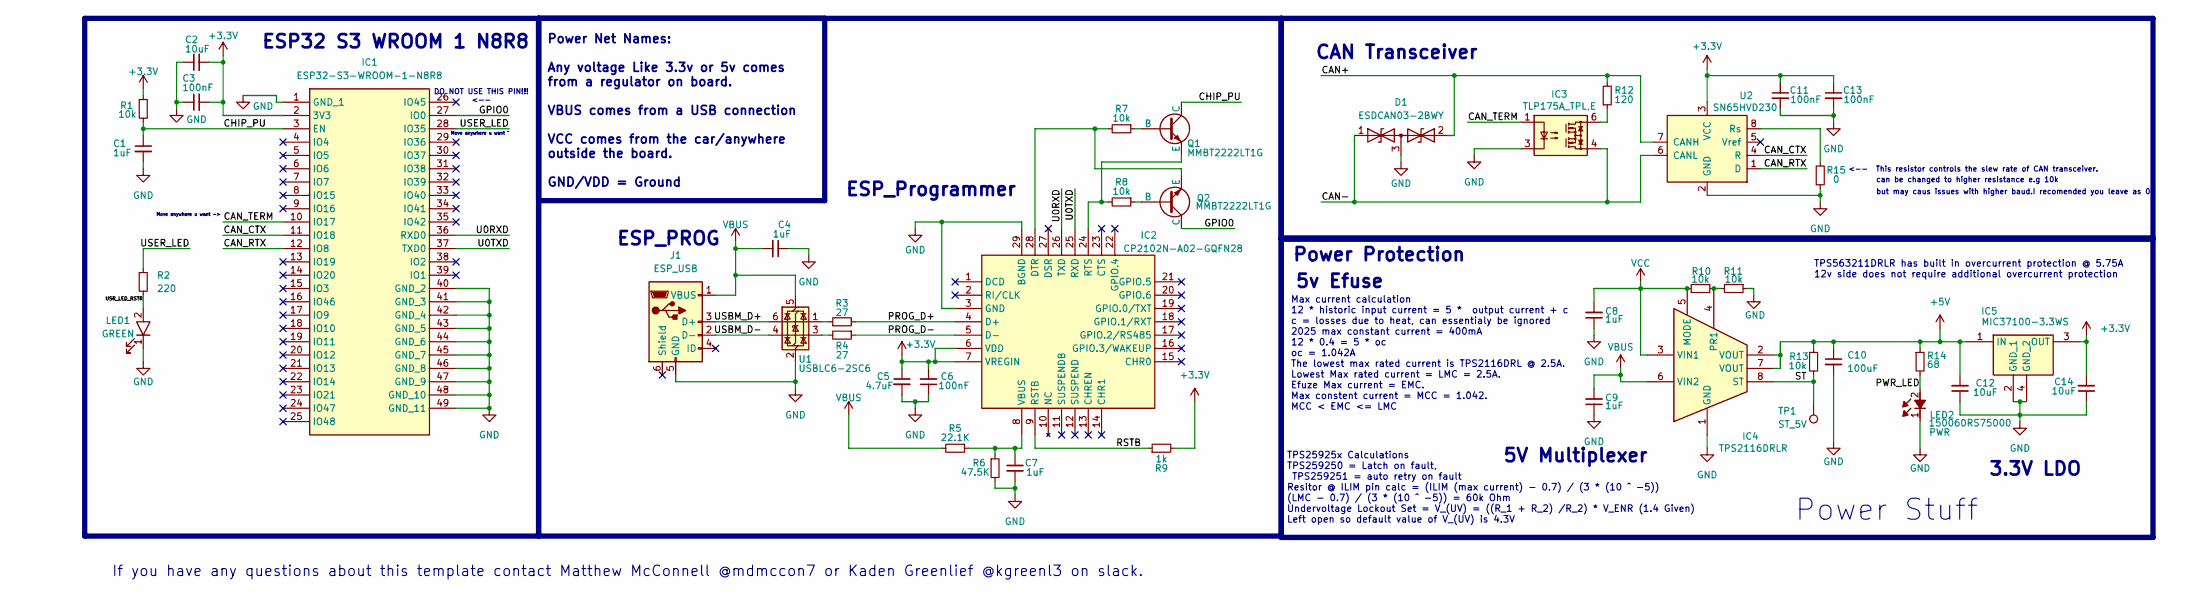
[picture p203: schematic ESP32_MCU_Template.kicad_sch]

Parts:
C1, C4, C7, C8, C9: 1uF; C_0603_1608Metric
C2, C12, C14: 10uF; C_0603_1608Metric
C3, C6, C11, C13: 100nF; C_0603_1608Metric
C5: 4.7uF; C_0603_1608Metric
C10: 100uF; C_0603_1608Metric
D1: ESDCAN03-2BWY; SOT65P210X110-3N; Mouser Part Number 511-ESDCAN03-2BWY
IC1: ESP32-S3-WROOM-1-N8R8; ESP32S3WROOM1N8R8; Mouser Part Number 356-EP32S3WROOM1N8R8
IC2: CP2102N-A02-GQFN28; QFN50P500X500X80-29N-D; Mouser Part Number 634-CP2102NA02GQFN28
IC3: TLP175A_TPL,E; TLP266J; Mouser Part Number 757-TLP175A(TPLE
IC4: TPS2116DRLR; SOTFL50P160X60-8L; Mouser Part Number 595-TPS2116DRLR
IC5: MIC37100-3.3WS; SOT230P700X180-4N; Mouser Part Number 998-MIC37100-3.3WS
J1: ESP_USB; USB_Micro-B_Molex-105017-0001
LED1: GREEN; LED_0603_1608Metric; Mouser Part Number 720-P4112S2U1252X4X5
LED2: 150060RS75000; LEDC1608X80N; Mouser Part Number 710-150060RS75000
Q1, Q2: MMBT2222LT1G; SOT96P237X111-3N
R1, R7, R8, R10, R11, R13: 10k; R_0603_1608Metric
R2: 220; R_0603_1608Metric
R3, R4: 27; R_0603_1608Metric
R5: 22.1K; R_0603_1608Metric
R6: 47.5K; R_0603_1608Metric
R9: 1k; R_0603_1608Metric
R12: 120; R_0603_1608Metric
R14: 68; R_0603_1608Metric
R15: 0; R_0603_1608Metric
TP1: ST_5V; TestPoint_Pad_1.5x1.5mm
U1: USBLC6-2SC6; SOT-23-6
U2: SN65HVD230; SOIC-8_3.9x4.9mm_P1.27mm

Connections:
+3.3V: C2.2, C3.2, C5.1, C6.2, C11.1, C13.1, C14.2, IC1.2 (3V3), IC2.6 (VDD), IC2.7 (VREGIN), IC5.3 (OUT), R1.1, R9.2, U2.3 (VCC)
+5V: C10.1, C12.2, IC4.2 (VOUT), IC4.7 (VOUT), IC5.1 (IN), R13.1, R14.1
/CAN+: D1.2, R12.2, U2.7 (CANH)
/CAN-: D1.1, IC3.4, U2.6 (CANL)
/CAN_CTX: IC1.11 (IO18), U2.4 (R)
/CAN_RTX: IC1.12 (IO8), U2.1 (D)
/CAN_TERM: IC1.10 (IO17), IC3.1
/CHIP_PU: C1.1, IC1.3 (EN), Q1.3 (C), R1.2
/GPIO0: IC1.27 (IO0), Q2.3 (C)
/PROG_D+: IC2.4 (D+), R3.2
/PROG_D-: IC2.5 (D-), R4.1
/PWR_LED: LED2.2 (A), R14.2
/RSTB: IC2.9 (RSTB), R9.1
/ST: IC4.8 (ST), R13.2, TP1.1
/U0RXD: IC1.36 (RXD0), IC2.26 (TXD)
/U0TXD: IC1.37 (TXD0), IC2.25 (RXD)
/USBM_D+: J1.3 (D+), U1.6 (I/O1)
/USBM_D-: J1.2 (D-), U1.4 (I/O2)
/USER_LED: IC1.28 (IO35), R2.1
/USR_LED_RSTR: LED1.2 (A), R2.2
GND: C1.2, C2.1, C3.1, C4.1, C5.2, C6.1, C7.2, C8.1, C9.1, C10.2, C11.2, C12.1, C13.2, C14.1, D1.3, IC1.1 (GND_1), IC1.40 (GND_2), IC1.41 (GND_3), IC1.42 (GND_4), IC1.43 (GND_5), IC1.44 (GND_6), IC1.45 (GND_7), IC1.46 (GND_8), IC1.47 (GND_9), IC1.48 (GND_10), IC1.49 (GND_11), IC2.3 (GND), IC2.29 (BGND), IC3.3, IC4.1 (GND), IC5.2 (GND_1), IC5.4 (GND_2), J1.5 (GND), LED1.1 (K), LED2.1 (K), R6.2, R11.1, R15.1, U1.2 (GND), U2.2 (GND)
unnamed: IC2.28 (DTR), Q2.2 (E), R7.2
unnamed: IC2.24 (RTS), Q1.2 (E), R8.2
unnamed: C7.1, IC2.8 (VBUS), R5.1, R6.1
unnamed: IC3.6, R12.1
unnamed: IC4.4 (PR1), R10.1, R11.2
unnamed: Q1.1 (B), R7.1
unnamed: Q2.1 (B), R8.1
unnamed: R3.1, U1.1 (I/O1)
unnamed: R4.2, U1.3 (I/O2)
unnamed: R15.2, U2.8 (Rs)
VBUS: C4.2, C9.2, IC4.6 (VIN2), J1.1 (VBUS), R5.2, U1.5 (VBUS)
VCC: C8.2, IC4.3 (VIN1), IC4.5 (MODE), R10.2

Notes on the sheet:
<-- This resistor controls the slew rate of CAN transceiver.
If you have any questions about this template contact Matthew McConnell @mdmccon7 or Kaden Greenlief @kgreenl3 on slack.
Move anywhere u want ^
Power Protection
Power Stuff
3.3V LDO
TPS563211DRLR has built in overcurrent protection @ 5.75A 12v side does not require additional overcurrent protection
Move anywhere u want ->
5v Efuse
but may caus issues with higher baud.I recomended you leave as 0.
TPS25925x Calculations TPS259250 = Latch on fault, TPS259251 = auto retry on fault Resitor @ ILIM pin calc = (ILIM (max current) - 0.7) / (3 * (10 ^ -5)) (LMC - 0.7) / (3 * (10 ^ -5)) = 60k Ohm Undervoltage Lockout Set = V_(UV) = ((R_1 + R_2) /R_2) * V_ENR (1.4 Given) Left open so default value of 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
ESP_PROG
CAN Transceiver
5V Multiplexer
DO NOT USE THIS PIN!!! <--
can be changed to higher resistance e.g 10k
Max current calculation 12 * historic input current = 5 * output current + c c = losses due to heat, can essentialy be ignored 2025 max constant current = 400mA 12 * 0.4 = 5 * oc oc = 1.042A The lowest max rated current is TPS2116DRL @ 2.5A. Lowest Max rated current = LMC = 2.5A. Efuze Max current 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
ESP32 S3 WROOM 1 N8R8
ESP_Programmer
Power Net Names: Any voltage Like 3.3v or 5v comes from a regulator on board. VBUS comes from a USB connection VCC comes from the car/anywhere outside the board. GND/VDD = Ground

Board: 2 copper layers, 43 parts (0 on the bottom side), 33 nets, no tracks yet.
