sundevilmotorsports/pcb-dev/2026/TimingGates/SDM26_TimingGates_V2.1/SDM26_TimingGates_V2.1.kicad_pcb

## KiCad design 2026/TimingGates/SDM26_TimingGates_V2.1/SDM26_TimingGates_V2.1.kicad_pcb (2026-11-06, an earlier design)

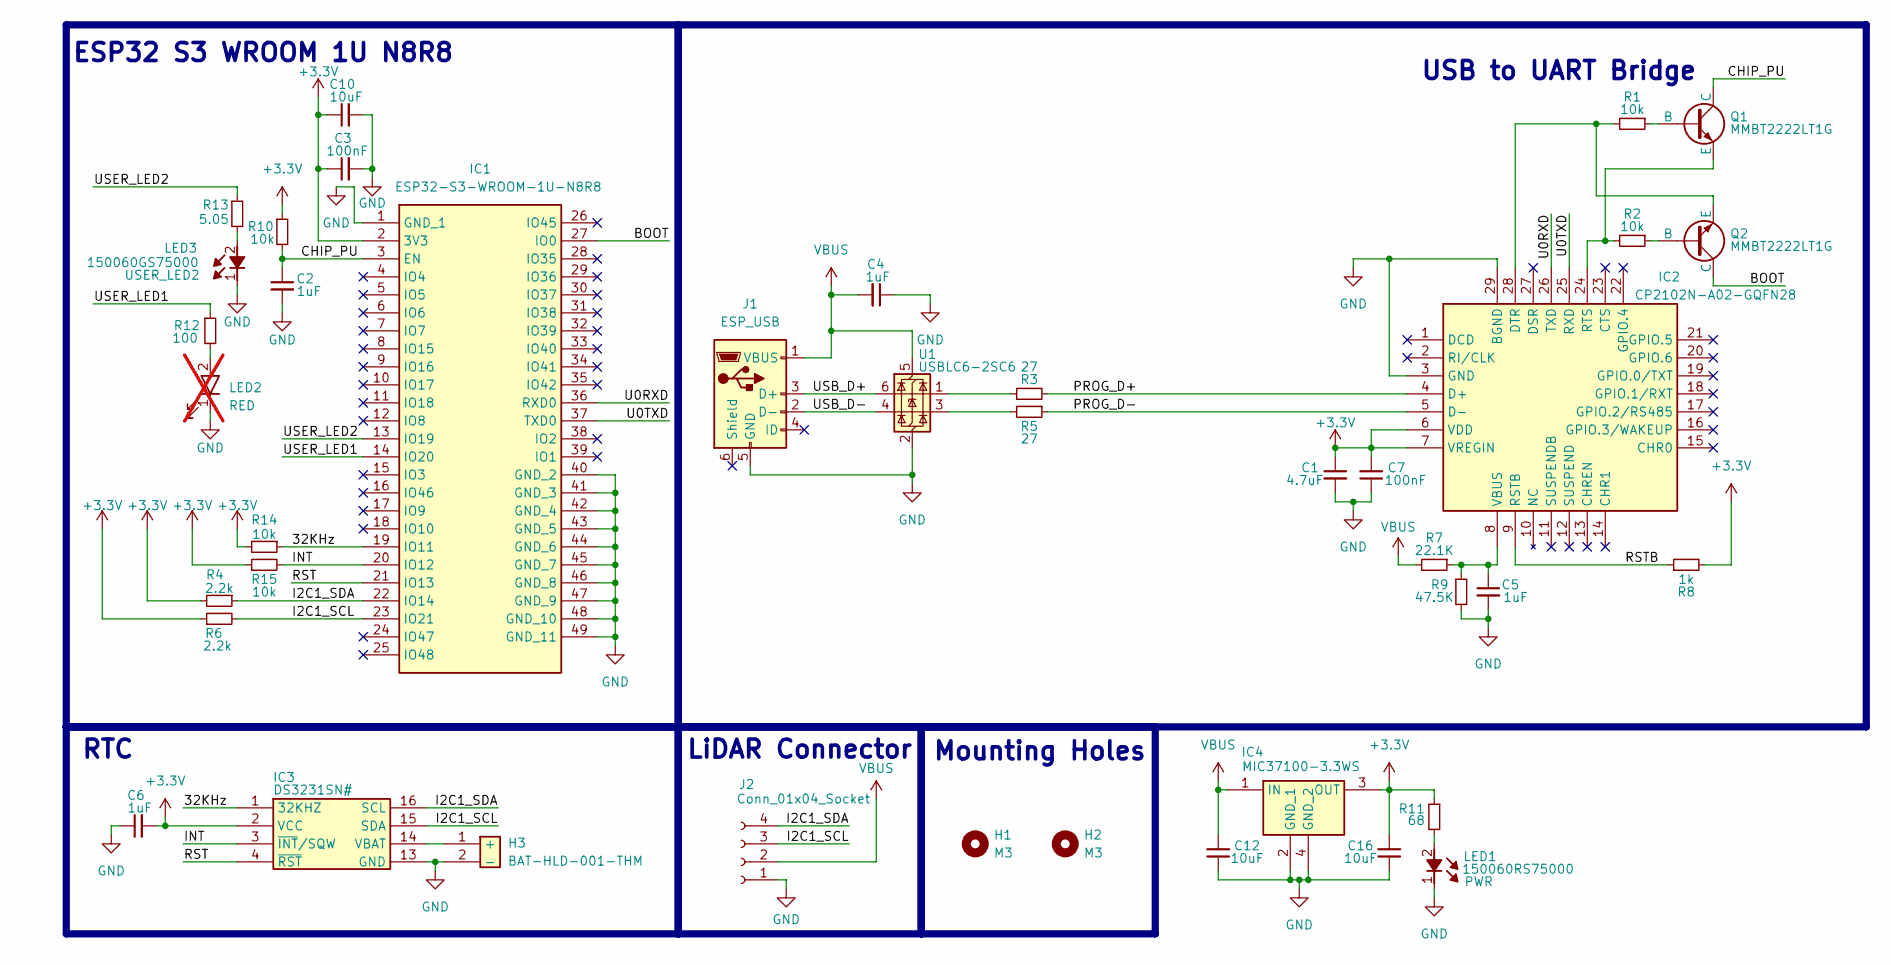
[picture p204: schematic SDM26_TimingGates_V2.1.kicad_sch, SDM26 Timing Gate]

Parts:
C1: 4.7uF; C_0603_1608Metric
C2, C4, C5, C6: 1uF; C_0603_1608Metric
C3, C7: 100nF; C_0603_1608Metric
C10, C12, C16: 10uF; C_0603_1608Metric
H1, H2: M3; MountingHole_3.2mm_M3
H3: BAT-HLD-001-THM; BATHLD001THM; Mouser Part Number N/A
IC1: ESP32-S3-WROOM-1U-N8R8; ESP32S3WROOM1UN8R8; Mouser Part Number 356-ESP32S3WRM1UN8R8
IC2: CP2102N-A02-GQFN28; QFN50P500X500X80-29N-D; Mouser Part Number 634-CP2102NA02GQFN28
IC3: DS3231SN#; SOIC127P1032X265-16L; Mouser Part Number 700-DS3231SN#
IC4: MIC37100-3.3WS; SOT230P700X180-4N; Mouser Part Number 998-MIC37100-3.3WS
J1: ESP_USB; USB_Micro-B_Molex-105017-0001
J2: Conn_01x04_Socket; JST_XH_B4B-XH-A_1x04_P2.50mm_Vertical
LED1: 150060RS75000; LEDC1608X80N; Mouser Part Number 710-150060RS75000
LED2: RED; SSFLXH100LID01; Mouser Part Number 696-SSFLXH100LID01; not fitted
LED3: 150060GS75000; LEDC1608X80N; Mouser Part Number 710-150060GS75000
Q1, Q2: MMBT2222LT1G; SOT96P237X111-3N
R1, R2, R10, R14, R15: 10k; R_0603_1608Metric
R3, R5: 27; R_0603_1608Metric
R4, R6: 2.2k; R_0603_1608Metric
R7: 22.1K; R_0603_1608Metric
R8: 1k; R_0603_1608Metric
R9: 47.5K; R_0603_1608Metric
R11: 68; R_0603_1608Metric
R12: 100; R_0603_1608Metric
R13: 5.05; R_0603_1608Metric
U1: USBLC6-2SC6; SOT-23-6

Connections:
+3.3V: C1.1, C3.1, C6.2, C7.2, C10.1, C16.2, IC1.2 (3V3), IC2.6 (VDD), IC2.7 (VREGIN), IC3.2 (VCC), IC4.3 (OUT), R4.2, R6.1, R8.2, R10.1, R11.1, R14.2, R15.1
/32KHz: IC1.19 (IO11), IC3.1 (32KHZ), R14.1
/BOOT: IC1.27 (IO0), Q2.3 (C)
/CHIP_PU: C2.1, IC1.3 (EN), Q1.3 (C), R10.2
/I2C1_SCL: IC1.23 (IO21), IC3.15 (SDA), J2.3, R6.2
/I2C1_SDA: IC1.22 (IO14), IC3.16 (SCL), J2.4, R4.1
/INT: IC1.20 (IO12), IC3.3 (~INT/SQW), R15.2
/PROG_D+: IC2.4 (D+), R3.2
/PROG_D-: IC2.5 (D-), R5.1
/RST: IC1.21 (IO13), IC3.4 (~RST)
/RSTB: IC2.9 (RSTB), R8.1
/U0RXD: IC1.36 (RXD0), IC2.26 (TXD)
/U0TXD: IC1.37 (TXD0), IC2.25 (RXD)
/USB_D+: J1.3 (D+), U1.6 (I/O1)
/USB_D-: J1.2 (D-), U1.4 (I/O2)
/USER_LED1: IC1.14 (IO20), R12.1
/USER_LED2: IC1.13 (IO19), R13.1
GND: C1.2, C2.2, C3.2, C4.1, C5.2, C6.1, C7.1, C10.2, C12.1, C16.1, H3.2 (-), IC1.1 (GND_1), IC1.40 (GND_2), IC1.41 (GND_3), IC1.42 (GND_4), IC1.43 (GND_5), IC1.44 (GND_6), IC1.45 (GND_7), IC1.46 (GND_8), IC1.47 (GND_9), IC1.48 (GND_10), IC1.49 (GND_11), IC2.3 (GND), IC2.29 (BGND), IC3.13 (GND), IC4.2 (GND_1), IC4.4 (GND_2), J1.5 (GND), J2.1, LED1.1 (K), LED2.1 (K), LED3.1 (K), R9.2, U1.2 (GND)
unnamed: H3.1 (+), IC3.14 (VBAT)
unnamed: IC2.28 (DTR), Q2.2 (E), R1.2
unnamed: IC2.24 (RTS), Q1.2 (E), R2.2
unnamed: C5.1, IC2.8 (VBUS), R7.1, R9.1
unnamed: LED1.2 (A), R11.2
unnamed: LED2.2 (A), R12.2
unnamed: LED3.2 (A), R13.2
unnamed: Q1.1 (B), R1.1
unnamed: Q2.1 (B), R2.1
unnamed: R3.1, U1.1 (I/O1)
unnamed: R5.2, U1.3 (I/O2)
VBUS: C4.2, C12.2, IC4.1 (IN), J1.1 (VBUS), J2.2, R7.2, U1.5 (VBUS)

Notes on the sheet:
ESP32 S3 WROOM 1U N8R8
RTC
USB to UART Bridge
Mounting Holes
LiDAR Connector

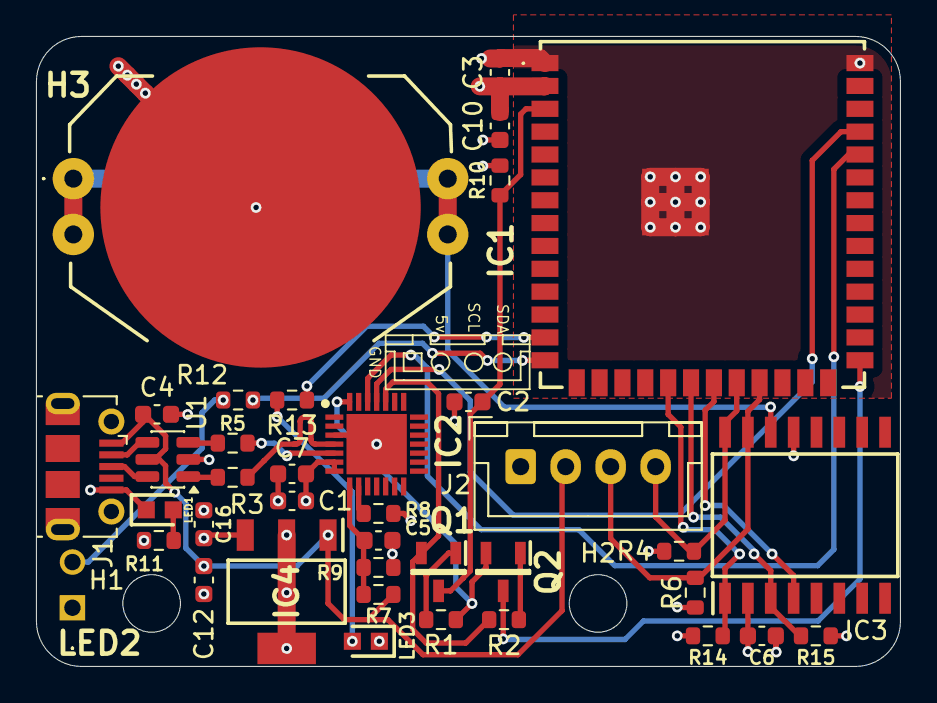
[picture p205: board SDM26_TimingGates_V2.1.kicad_pcb from above]

Board: 4 copper layers, 48.0 x 35.0 mm, 40 parts (1 on the bottom side), 30 nets.
