sundevilmotorsports/pcb-dev/2027/SDM27_CANSplitter/SDM27_CANSplitter_V1.0/SDM27_CANSplitter_V1.0.kicad_pcb

## KiCad design 2027/SDM27_CANSplitter/SDM27_CANSplitter_V1.0/SDM27_CANSplitter_V1.0.kicad_pcb (2026-11-06)

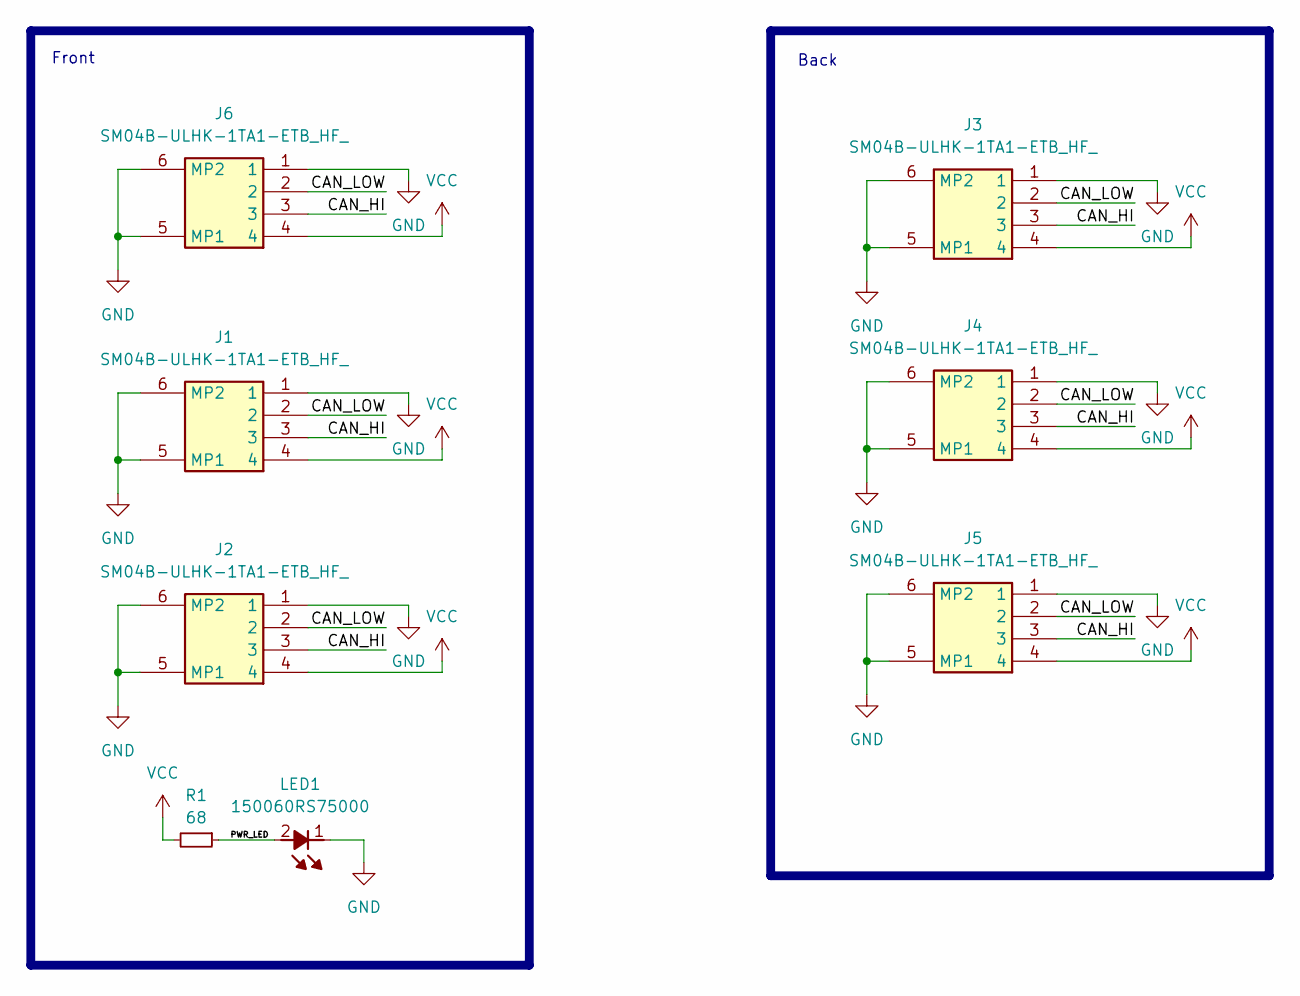
[picture p206: schematic SDM27_CANSplitter_V1.0.kicad_sch]

Parts:
J1, J2, J3, J4, J5, J6: SM04B-ULHK-1TA1-ETB_HF_; SM04BULHK1TA1ETBHF; Mouser Part Number 306-SM4BULH1TA1ETBHF
LED1: 150060RS75000; LEDC1608X80N; Mouser Part Number 710-150060RS75000
R1: 68; C_0603_1608Metric

Connections:
/CAN_HI: J1.3, J2.3, J3.3, J4.3, J5.3, J6.3
/CAN_LOW: J1.2, J2.2, J3.2, J4.2, J5.2, J6.2
/PWR_LED: LED1.2 (A), R1.1
GND: J1.1, J1.5 (MP1), J1.6 (MP2), J2.1, J2.5 (MP1), J2.6 (MP2), J3.1, J3.5 (MP1), J3.6 (MP2), J4.1, J4.5 (MP1), J4.6 (MP2), J5.1, J5.5 (MP1), J5.6 (MP2), J6.1, J6.5 (MP1), J6.6 (MP2), LED1.1 (K)
VCC: J1.4, J2.4, J3.4, J4.4, J5.4, J6.4, R1.2

Notes on the sheet:
Back
Front

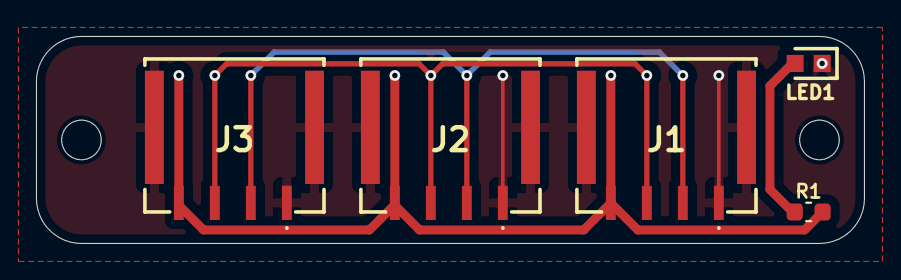
[picture p207: board SDM27_CANSplitter_V1.0.kicad_pcb from above]

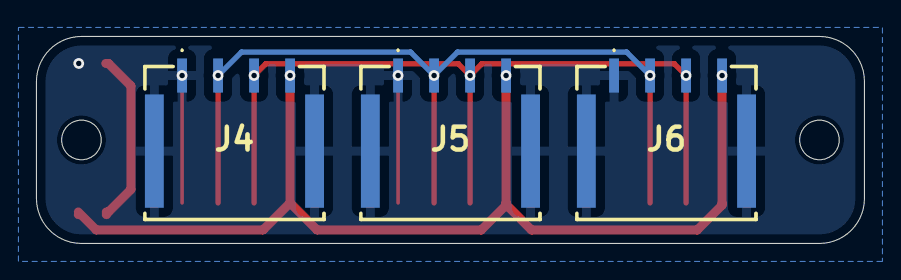
[picture p208: board SDM27_CANSplitter_V1.0.kicad_pcb from below]

Board: 2 copper layers, 46.0 x 11.5 mm, 8 parts (3 on the bottom side), 5 nets.
