sundevilmotorsports/pcb-dev/2026/Telemetry/SDM26_Telemetry_V1.0/SDM26_Telemetry_V1.0.kicad_pcb

## KiCad design 2026/Telemetry/SDM26_Telemetry_V1.0/SDM26_Telemetry_V1.0.kicad_pcb (2026-11-06)

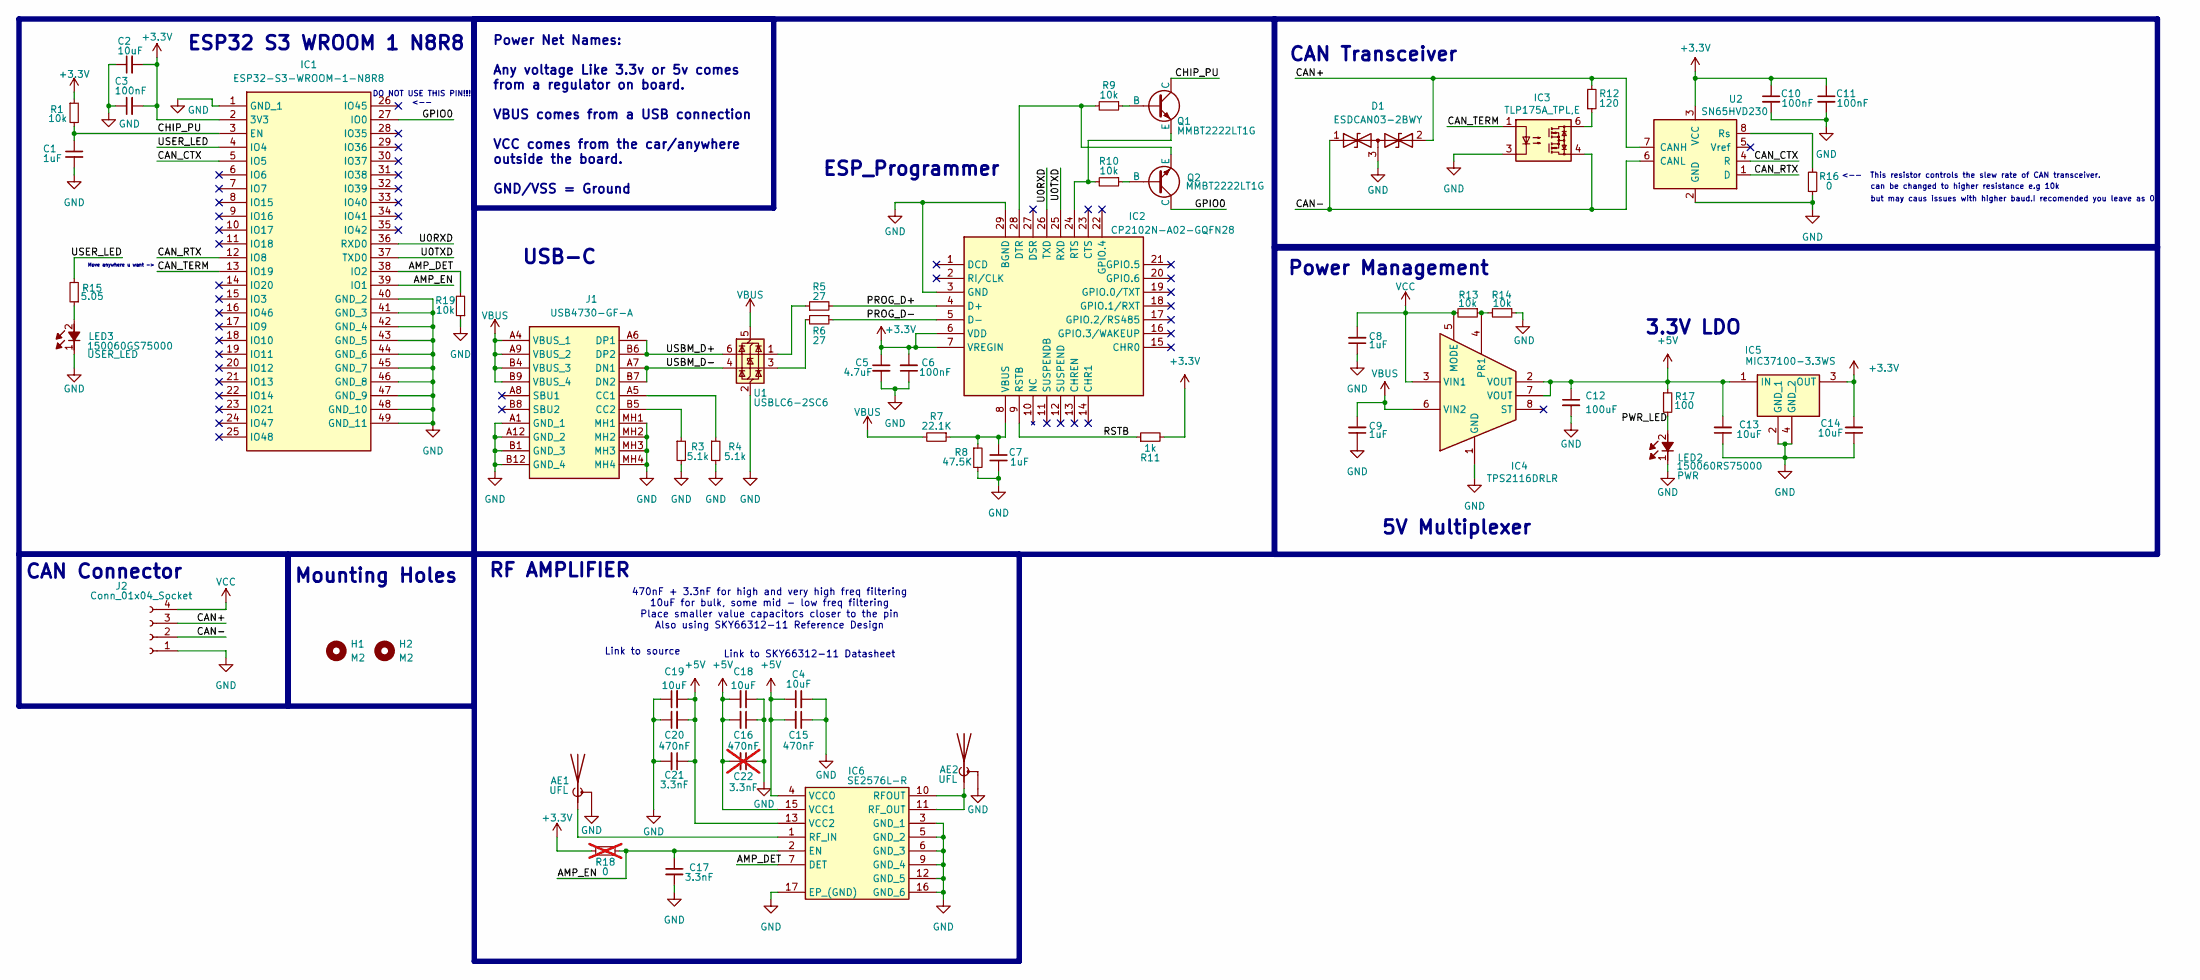
[picture p209: schematic SDM26_Telemetry_V1.0.kicad_sch]

Parts:
AE1, AE2: UFL; CONUFL001SMDT; Mouser Part Number N/A
C1, C7, C8, C9: 1uF; C_0603_1608Metric
C2, C4, C13, C14, C18, C19: 10uF; C_0603_1608Metric
C3, C6, C10, C11: 100nF; C_0603_1608Metric
C5: 4.7uF; C_0603_1608Metric
C12: 100uF; C_0603_1608Metric
C15, C16, C20: 470nF; C_0603_1608Metric
C17, C21: 3.3nF; C_0603_1608Metric
C22: 3.3nF; C_0603_1608Metric; not fitted
D1: ESDCAN03-2BWY; SOT65P210X110-3N; Mouser Part Number 511-ESDCAN03-2BWY
H1, H2: M2; MountingHole_2.2mm_M2
IC1: ESP32-S3-WROOM-1-N8R8; ESP32S3WROOM1UN8R8; Mouser Part Number 356-ESP32S3WRM1UN8R8
IC2: CP2102N-A02-GQFN28; QFN50P500X500X80-29N-D; Mouser Part Number 634-CP2102NA02GQFN28
IC3: TLP175A_TPL,E; TLP266J; Mouser Part Number 757-TLP175A(TPLE
IC4: TPS2116DRLR; SOTFL50P160X60-8L; Mouser Part Number 595-TPS2116DRLR
IC5: MIC37100-3.3WS; SOT230P700X180-4N; Mouser Part Number 998-MIC37100-3.3WS
IC6: SE2576L-R; QFN50P300X300X90-17L-D; Mouser Part Number 873-SE2576L-R
J1: USB4730-GF-A; USB_C_Receptacle_16P; Mouser Part Number 640-USB4730GFA
J2: Conn_01x04_Socket; JST_XH_S4B-XH-A_1x04_P2.50mm_Horizontal
LED2: 150060RS75000; LEDC1608X80N; Mouser Part Number 710-150060RS75000
LED3: 150060GS75000; LEDC1608X80N; Mouser Part Number 710-150060GS75000
Q1, Q2: MMBT2222LT1G; SOT96P237X111-3N
R1, R9, R10, R13, R14, R19: 10k; R_0603_1608Metric
R3, R4: 5.1k; R_0603_1608Metric
R5, R6: 27; R_0603_1608Metric
R7: 22.1K; R_0603_1608Metric
R8: 47.5K; R_0603_1608Metric
R11: 1k; R_0603_1608Metric
R12: 120; R_0603_1608Metric
R15: 5.05; R_0603_1608Metric
R16: 0; R_0603_1608Metric
R17: 100; R_0603_1608Metric
R18: 0; R_0603_1608Metric; not fitted
U1: USBLC6-2SC6; SOT-23-6
U2: SN65HVD230; SOIC-8_3.9x4.9mm_P1.27mm

Connections:
+3.3V: C2.2, C3.2, C5.1, C6.2, C10.1, C11.1, C14.2, IC1.2 (3V3), IC2.6 (VDD), IC2.7 (VREGIN), IC5.3 (OUT), R1.1, R11.2, R18.1, U2.3 (VCC)
+5V: C4.1, C12.1, C13.2, C15.2, C16.2, C18.2, C19.2, C20.2, C21.1, C22.2, IC4.2 (VOUT), IC4.7 (VOUT), IC5.1 (IN), IC6.4 (VCCO), IC6.13 (VCC2), IC6.15 (VCC1), R17.1
/AMP_DET: IC1.38 (IO2), IC6.7 (DET), R19.2
/AMP_EN: C17.1, IC1.39 (IO1), IC6.2 (EN), R18.2
/CAN+: D1.2, J2.3, R12.2, U2.7 (CANH)
/CAN-: D1.1, IC3.4, J2.2, U2.6 (CANL)
/CAN_CTX: IC1.5 (IO5), U2.4 (R)
/CAN_RTX: IC1.12 (IO8), U2.1 (D)
/CAN_TERM: IC1.13 (IO19), IC3.1
/CHIP_PU: C1.1, IC1.3 (EN), Q1.3 (C), R1.2
/GPIO0: IC1.27 (IO0), Q2.3 (C)
/PROG_D+: IC2.4 (D+), R5.2
/PROG_D-: IC2.5 (D-), R6.1
/PWR_LED: LED2.2 (A), R17.2
/RSTB: IC2.9 (RSTB), R11.1
/U0RXD: IC1.36 (RXD0), IC2.26 (TXD)
/U0TXD: IC1.37 (TXD0), IC2.25 (RXD)
/USBM_D+: J1.A6 (DP1), J1.B6 (DP2), U1.6 (I/O1)
/USBM_D-: J1.A7 (DN1), J1.B7 (DN2), U1.4 (I/O2)
/USER_LED: IC1.4 (IO4), R15.2
GND: AE1.2 (Shield), AE1.3 (Shield), AE2.2 (Shield), AE2.3 (Shield), C1.2, C2.1, C3.1, C4.2, C5.2, C6.1, C7.2, C8.1, C9.1, C10.2, C11.2, C12.2, C13.1, C14.1, C15.1, C16.1, C17.2, C18.1, C19.1, C20.1, C21.2, C22.1, D1.3, IC1.1 (GND_1), IC1.40 (GND_2), IC1.41 (GND_3), IC1.42 (GND_4), IC1.43 (GND_5), IC1.44 (GND_6), IC1.45 (GND_7), IC1.46 (GND_8), IC1.47 (GND_9), IC1.48 (GND_10), IC1.49 (GND_11), IC2.3 (GND), IC2.29 (BGND), IC3.3, IC4.1 (GND), IC5.2 (GND_1), IC5.4 (GND_2), IC6.3 (GND_1), IC6.5 (GND_2), IC6.6 (GND_3), IC6.9 (GND_4), IC6.12 (GND_5), IC6.16 (GND_6), IC6.17 (EP_(GND)), J1.A1 (GND_1), J1.A12 (GND_2), J1.B1 (GND_3), J1.B12 (GND_4), J1.MH1, J1.MH2, J1.MH3, J1.MH4, J2.1, LED2.1 (K), LED3.1 (K), R3.2, R4.2, R8.2, R14.1, R16.1, R19.1, U1.2 (GND), U2.2 (GND)
unnamed: AE1.1 (A), IC6.1 (RF_IN)
unnamed: AE2.1 (A), IC6.10 (RFOUT), IC6.11 (RF_OUT)
unnamed: IC2.28 (DTR), Q2.2 (E), R9.2
unnamed: IC2.24 (RTS), Q1.2 (E), R10.2
unnamed: C7.1, IC2.8 (VBUS), R7.1, R8.1
unnamed: IC3.6, R12.1
unnamed: IC4.4 (PR1), R13.1, R14.2
unnamed: J1.A5 (CC1), R4.1
unnamed: J1.B5 (CC2), R3.1
unnamed: LED3.2 (A), R15.1
unnamed: Q1.1 (B), R9.1
unnamed: Q2.1 (B), R10.1
unnamed: R5.1, U1.1 (I/O1)
unnamed: R6.2, U1.3 (I/O2)
unnamed: R16.2, U2.8 (Rs)
VBUS: C9.2, IC4.6 (VIN2), J1.A4 (VBUS_1), J1.A9 (VBUS_2), J1.B4 (VBUS_3), J1.B9 (VBUS_4), R7.2, U1.5 (VBUS)
VCC: C8.2, IC4.3 (VIN1), IC4.5 (MODE), J2.4, R13.2

Notes on the sheet:
Mounting Holes
<-- This resistor controls the slew rate of CAN transceiver.
Power Management
ESP_Programmer
RF AMPLIFIER
470nF + 3.3nF for high and very high freq filtering 10uF for bulk, some mid - low freq filtering Place smaller value capacitors closer to the pin Also using SKY66312-11 Reference Design
Power Net Names: Any voltage Like 3.3v or 5v comes from a regulator on board. VBUS comes from a USB connection VCC comes from the car/anywhere outside the board. GND/VSS = Ground
Link to source
3.3V LDO
Link to SKY66312-11 Datasheet
Move anywhere u want ->
but may caus issues with higher baud.I recomended you leave as 0.
USB-C
CAN Transceiver
5V Multiplexer
DO NOT USE THIS PIN!!! <--
can be changed to higher resistance e.g 10k
CAN Connector
ESP32 S3 WROOM 1 N8R8

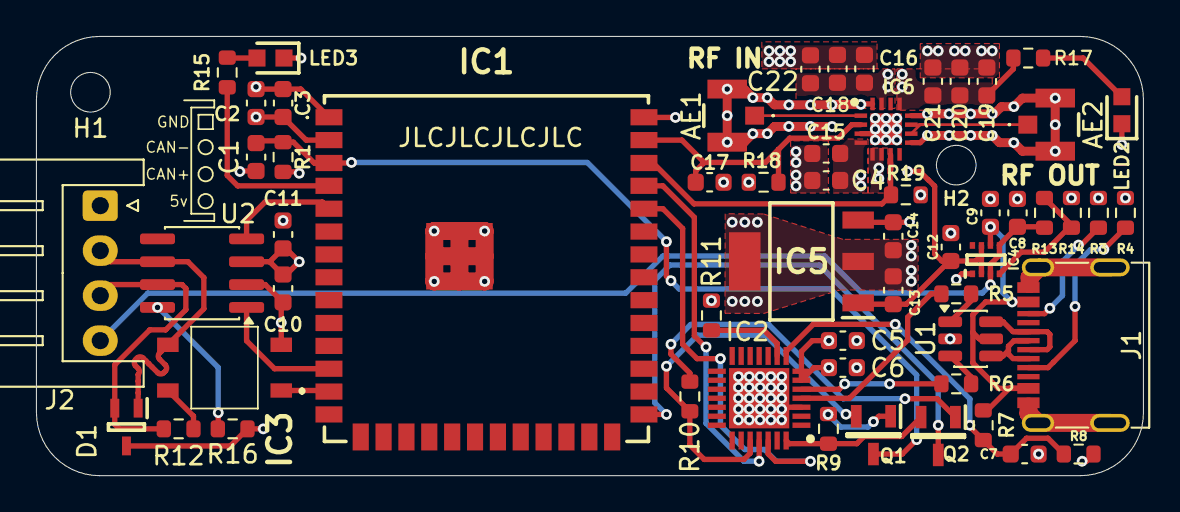
[picture p210: board SDM26_Telemetry_V1.0.kicad_pcb from above]

Board: 4 copper layers, 61.5 x 24.4 mm, 59 parts (1 on the bottom side), 38 nets.
