sundevilmotorsports/pcb-dev/2026/Wheelboard/SDM26_Wheelboard_V1.2/SDM26_Wheelboard_V1.2.kicad_pcb

## KiCad design 2026/Wheelboard/SDM26_Wheelboard_V1.2/SDM26_Wheelboard_V1.2.kicad_pcb (2026-11-06, an earlier design)

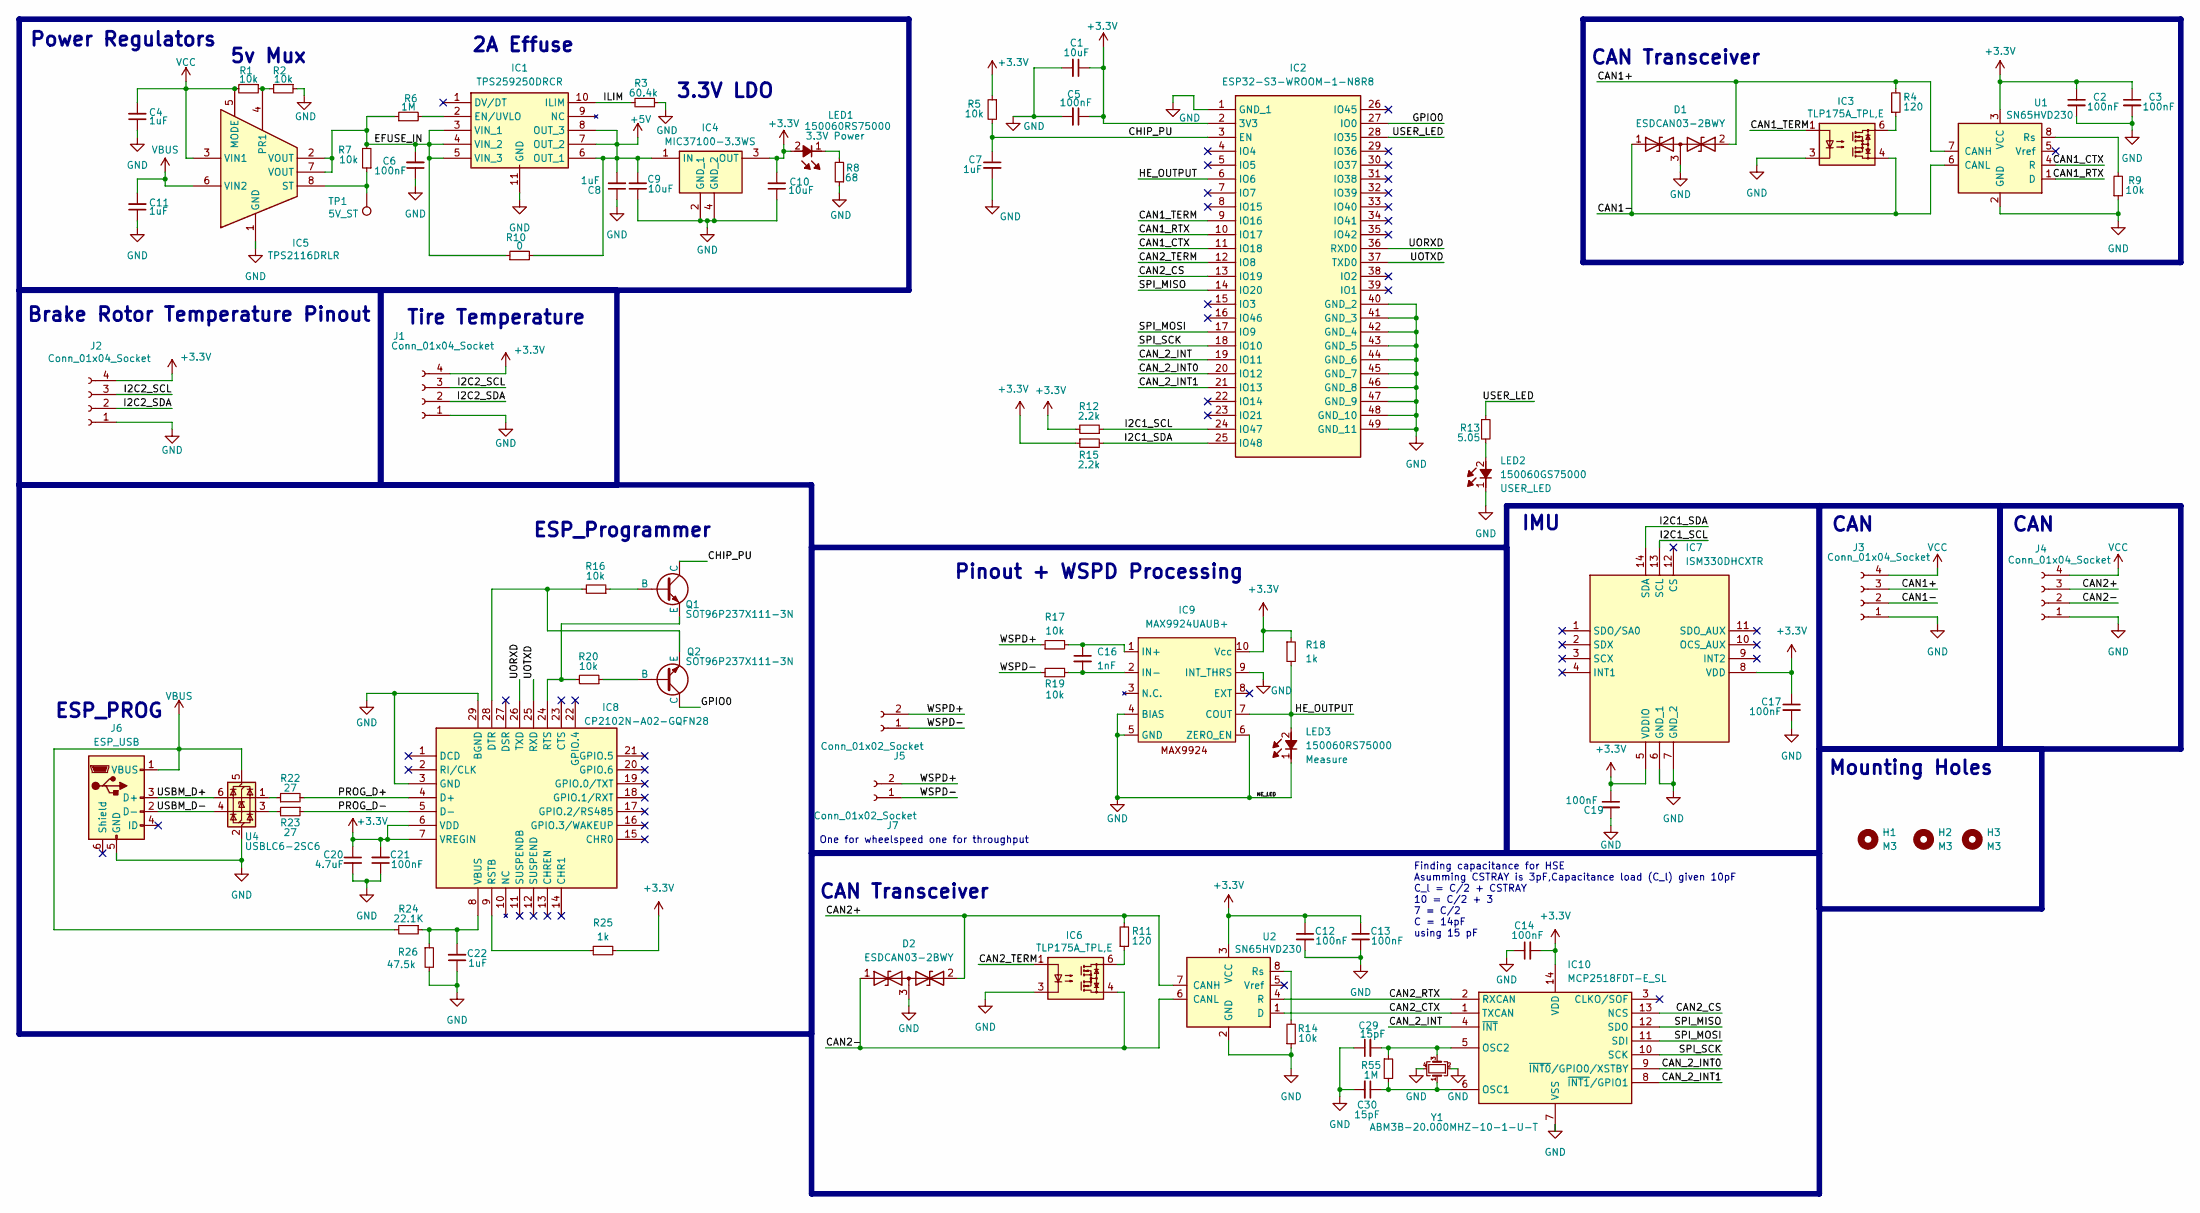
[picture p211: schematic SDM26_Wheelboard_V1.2.kicad_sch]

Parts:
C1, C9, C10: 10uF; C_0603_1608Metric
C2, C3, C5, C6, C12, C13, C14, C17, C19, C21: 100nF; C_0603_1608Metric
C4, C7, C8, C11, C22: 1uF; C_0603_1608Metric
C16: 1nF; C_0603_1608Metric
C20: 4.7uF; C_0603_1608Metric
C29, C30: 15pF; C_0603_1608Metric
D1, D2: ESDCAN03-2BWY; SOT65P210X110-3N; Mouser Part Number 511-ESDCAN03-2BWY
H1, H2, H3: M3; MountingHole_3.2mm_M3
IC1: TPS259250DRCR; SON50P300X300X100-11L-D; Mouser Part Number 595-TPS259250DRCR
IC2: ESP32-S3-WROOM-1-N8R8; ESP32S3WROOM1N8R8; Mouser Part Number 356-EP32S3WROOM1N8R8
IC3, IC6: TLP175A_TPL,E; TLP266J; Mouser Part Number 757-TLP175A(TPLE
IC4: MIC37100-3.3WS; SOT230P700X180-4N; Mouser Part Number 998-MIC37100-3.3WS
IC5: TPS2116DRLR; SOTFL50P160X60-8L; Mouser Part Number 595-TPS2116DRLR
IC7: ISM330DHCXTR; LSM6DS3USTR; Mouser Part Number 511-ISM330DHCXTR
IC8: CP2102N-A02-GQFN28; QFN50P500X500X80-29N-D; Mouser Part Number 634-CP2102NA02GQFN28
IC9: MAX9924UAUB+; SOP50P490X110-10L; Mouser Part Number 700-MAX9924UAUB
IC10: MCP2518FDT-E_SL; SOIC127P600X175-14L; Mouser Part Number 579-MCP2518FDT-E/SL
J1, J2, J3, J4: Conn_01x04_Socket; JST_XH_S4B-XH-A_1x04_P2.50mm_Horizontal
J5, J7: Conn_01x02_Socket; JST_XH_S2B-XH-A_1x02_P2.50mm_Horizontal
J6: ESP_USB; USB_Micro-B_Molex-105017-0001
LED1, LED3: 150060RS75000; LEDC1608X80N; Mouser Part Number 710-150060RS75000
LED2: 150060GS75000; LEDC1608X80N; Mouser Part Number 710-150060VS75000
Q1, Q2: SOT96P237X111-3N
R1, R2, R5, R7, R9, R14, R16, R20: 10k; R_0603_1608Metric
R3: 60.4k; R_0603_1608Metric
R4, R11: 120; R_0603_1608Metric
R6, R55: 1M; R_0603_1608Metric
R8: 68; R_0603_1608Metric
R10: 0; R_0603_1608Metric
R12, R15: 2.2k; R_0603_1608Metric
R13: 5.05; R_0603_1608Metric
R17, R19: 10k; R_0805_2012Metric
R18, R25: 1k; R_0603_1608Metric
R22, R23: 27; R_0603_1608Metric
R24: 22.1K; R_0603_1608Metric
R26: 47.5k; R_0603_1608Metric
TP1: 5V_ST; TestPoint_Pad_1.5x1.5mm
U1, U2: SN65HVD230; SOIC-8_3.9x4.9mm_P1.27mm
U4: USBLC6-2SC6; SOT-23-6
Y1: ABM3B-20.000MHZ-10-1-U-T; ABM3B; Mouser Part Number 815-ABM3B-20-T

Connections:
+3.3V: C1.1, C2.1, C3.1, C5.1, C10.2, C12.1, C13.1, C14.2, C17.1, C19.1, C20.1, C21.2, IC2.2 (3V3), IC4.3 (OUT), IC7.5 (VDDIO), IC7.8 (VDD), IC8.6 (VDD), IC8.7 (VREGIN), IC9.10 (Vcc), IC10.14 (VDD), J1.4, J2.4, LED1.2 (A), R5.1, R12.2, R15.1, R18.1, R25.2, U1.3 (VCC), U2.3 (VCC)
+5V: C8.2, C9.2, IC1.6 (OUT_1), IC1.7 (OUT_2), IC1.8 (OUT_3), IC4.1 (IN), R10.2
/CAN1+: D1.2, J3.3, R4.2, U1.7 (CANH)
/CAN1-: D1.1, IC3.4, J3.2, U1.6 (CANL)
/CAN1_CTX: IC2.11 (IO18), U1.4 (R)
/CAN1_RTX: IC2.10 (IO17), U1.1 (D)
/CAN1_TERM: IC2.9 (IO16), IC3.1
/CAN2+: D2.2, J4.3, R11.2, U2.7 (CANH)
/CAN2-: D2.1, IC6.4, J4.2, U2.6 (CANL)
/CAN2_CS: IC2.13 (IO19), IC10.13 (NCS)
/CAN2_CTX: IC10.1 (TXCAN), U2.1 (D)
/CAN2_RTX: IC10.2 (RXCAN), U2.4 (R)
/CAN2_TERM: IC2.12 (IO8), IC6.1
/CAN_2_INT: IC2.19 (IO11), IC10.4 (~INT)
/CAN_2_INT0: IC2.20 (IO12), IC10.9 (~INT0/GPIO0/XSTBY)
/CAN_2_INT1: IC2.21 (IO13), IC10.8 (~INT1/GPIO1)
/CHIP_PU: C7.1, IC2.3 (EN), Q1.1 (C), R5.2
/EFUSE_IN: C6.2, IC1.3 (VIN_1), IC1.4 (VIN_2), IC1.5 (VIN_3), IC5.2 (VOUT), IC5.7 (VOUT), R6.1, R7.2, R10.1
/GPIO0: IC2.27 (IO0), Q2.1 (C)
/HE_OUTPUT: IC2.6 (IO6), IC9.7 (COUT), LED3.2 (A), R18.2
/I2C1_SCL: IC2.24 (IO47), IC7.13 (SCL), R12.1
/I2C1_SDA: IC2.25 (IO48), IC7.14 (SDA), R15.2
/I2C2_SCL: J1.3, J2.3
/I2C2_SDA: J1.2, J2.2
/ILIM: IC1.10 (ILIM), R3.2
/PROG_D+: IC8.4 (D+), R22.2
/PROG_D-: IC8.5 (D-), R23.1
/SPI_MISO: IC2.14 (IO20), IC10.12 (SDO)
/SPI_MOSI: IC2.17 (IO9), IC10.11 (SDI)
/SPI_SCK: IC2.18 (IO10), IC10.10 (SCK)
/UORXD: IC2.36 (RXD0), IC8.26 (TXD)
/UOTXD: IC2.37 (TXD0), IC8.25 (RXD)
/USBM_D+: J6.3 (D+), U4.6 (I/O1)
/USBM_D-: J6.2 (D-), U4.4 (I/O2)
/USER_LED: IC2.28 (IO35), R13.1
/WSPD+: J5.2, J7.2, R17.1
/WSPD-: J5.1, J7.1, R19.1
GND: C1.2, C2.2, C3.2, C4.1, C5.2, C6.1, C7.2, C8.1, C9.1, C10.1, C11.1, C12.2, C13.2, C14.1, C17.2, C19.2, C20.2, C21.1, C22.1, C29.1, C30.2, D1.3, D2.3, IC1.11 (GND), IC2.1 (GND_1), IC2.40 (GND_2), IC2.41 (GND_3), IC2.42 (GND_4), IC2.43 (GND_5), IC2.44 (GND_6), IC2.45 (GND_7), IC2.46 (GND_8), IC2.47 (GND_9), IC2.48 (GND_10), IC2.49 (GND_11), IC3.3, IC4.2 (GND_1), IC4.4 (GND_2), IC5.1 (GND), IC6.3, IC7.6 (GND_1), IC7.7 (GND_2), IC8.3 (GND), IC8.29 (BGND), IC9.4 (BIAS), IC9.5 (GND), IC9.6 (ZERO_EN), IC9.9 (INT_THRS), IC10.7 (VSS), J1.1, J2.1, J3.1, J4.1, J6.5 (GND), LED2.1 (K), LED3.1 (K), R2.1, R3.1, R8.1, R9.1, R14.1, R26.2, U1.2 (GND), U2.2 (GND), U4.2 (GND), Y1.2 (GND_1), Y1.4 (GND_2)
unnamed: IC1.2 (EN/UVLO), R6.2
unnamed: IC3.6, R4.1
unnamed: IC5.4 (PR1), R1.1, R2.2
unnamed: IC5.8 (ST), R7.1, TP1.1
unnamed: IC6.6, R11.1
unnamed: IC8.28 (DTR), Q2.3 (E), R16.2
unnamed: IC8.9 (RSTB), R25.1
unnamed: IC8.24 (RTS), Q1.3 (E), R20.2
unnamed: C22.2, IC8.8 (VBUS), R24.1, R26.1
unnamed: C16.1, IC9.1 (IN+), R17.2
unnamed: C16.2, IC9.2 (IN-), R19.2
unnamed: C30.1, IC10.6 (OSC1), R55.2, Y1.1 (XTAL_1)
unnamed: C29.2, IC10.5 (OSC2), R55.1, Y1.3 (XTAL_2)
unnamed: LED1.1 (K), R8.2
unnamed: LED2.2 (A), R13.2
unnamed: Q1.2 (B), R16.1
unnamed: Q2.2 (B), R20.1
unnamed: R22.1, U4.1 (I/O1)
unnamed: R23.2, U4.3 (I/O2)
unnamed: R9.2, U1.8 (Rs)
unnamed: R14.2, U2.8 (Rs)
VBUS: C11.2, IC5.6 (VIN2), J6.1 (VBUS), R24.2, U4.5 (VBUS)
VCC: C4.2, IC5.3 (VIN1), IC5.5 (MODE), J3.4, J4.4, R1.2

Notes on the sheet:
Finding capacitance for HSE Asumming CSTRAY is 3pF,Capacitance load (C_l) given 10pF C_l = C/2 + CSTRAY 10 = C/2 + 3 7 = C/2 C = 14pF using 15 pF
One for wheelspeed one for throughput
2A Effuse
IMU
3.3V LDO
CAN Transceiver
CAN
Brake Rotor Temperature Pinout
ESP_Programmer
ESP_PROG
Pinout + WSPD Processing
5v Mux
Mounting Holes
Tire Temperature
Power Regulators
