sundevilmotorsports/pcb-dev/2026/Wheelboard/SDM26_Wheelboard_V1.2/SDM26_Wheelboard_V1.2.kicad_pcb

## KiCad design 2026/Wheelboard/SDM26_Wheelboard_V1.2/SDM26_Wheelboard_V1.2.kicad_pcb (continued)

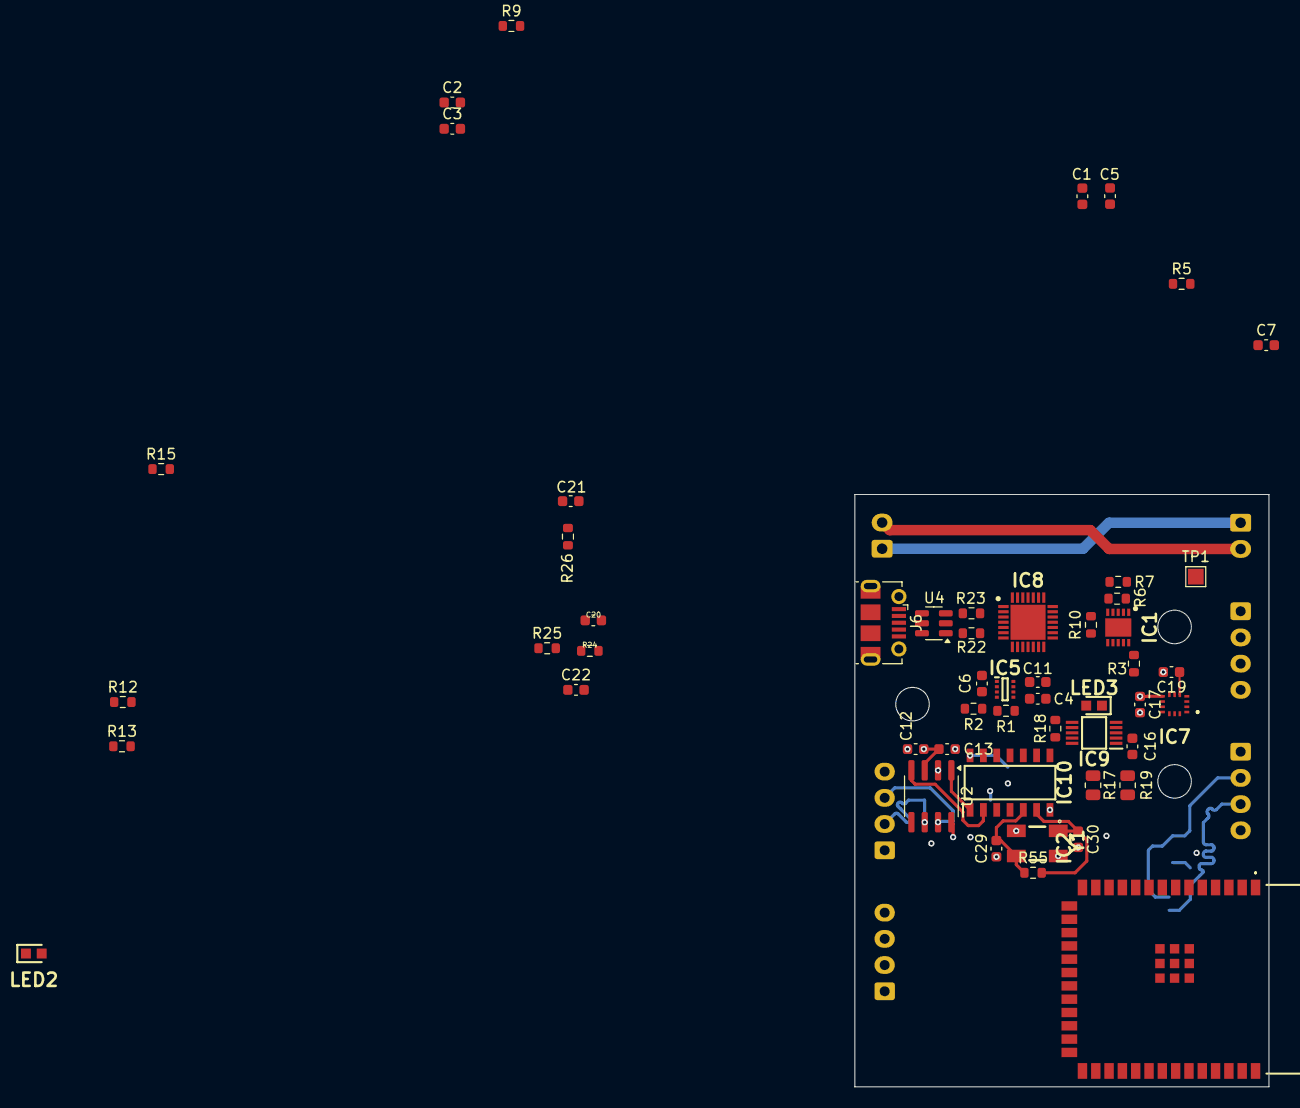
[picture p212: board SDM26_Wheelboard_V1.2.kicad_pcb from above]

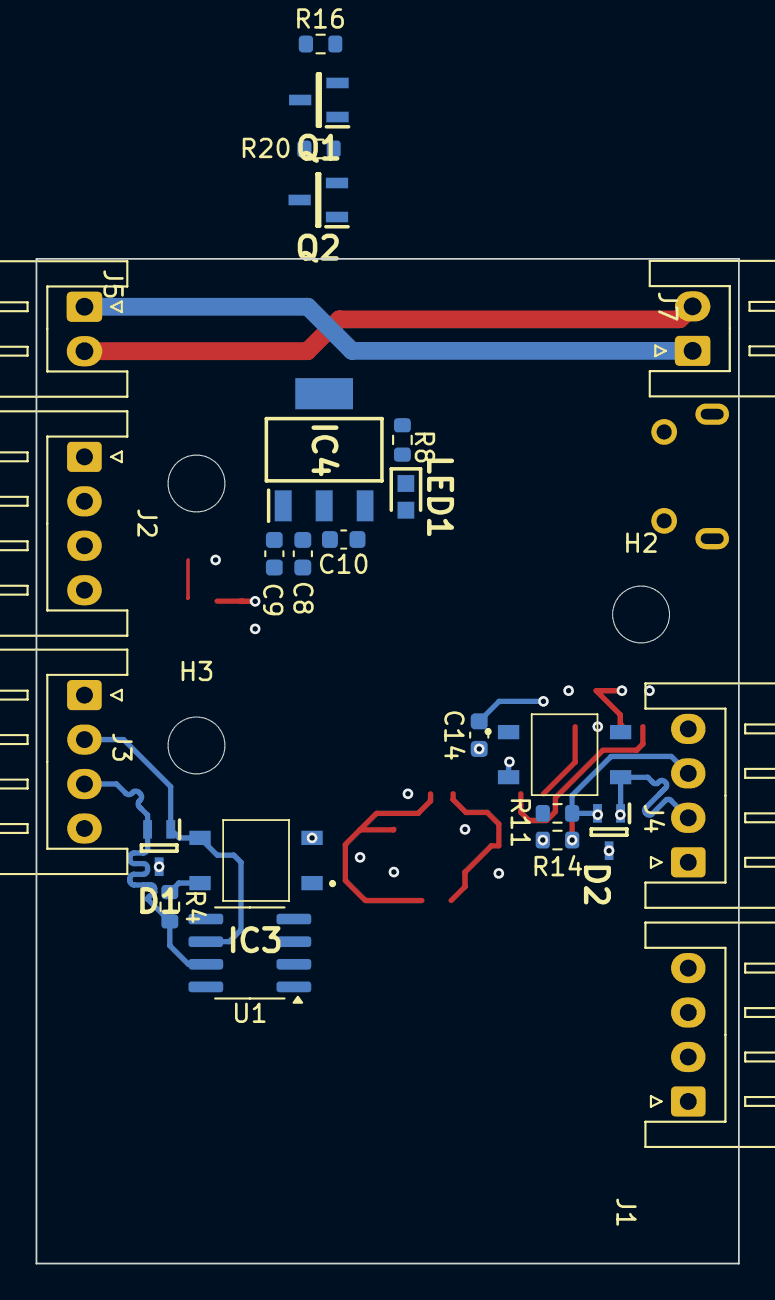
[picture p213: board SDM26_Wheelboard_V1.2.kicad_pcb from below]

Board: 4 copper layers, 39.5 x 56.5 mm, 80 parts (28 on the bottom side), 61 nets.
