sundevilmotorsports/pcb-dev/2027/ESP_C5_Template/ESP-C5.kicad_pcb

## KiCad design 2027/ESP_C5_Template/ESP-C5.kicad_pcb (2026-11-06)

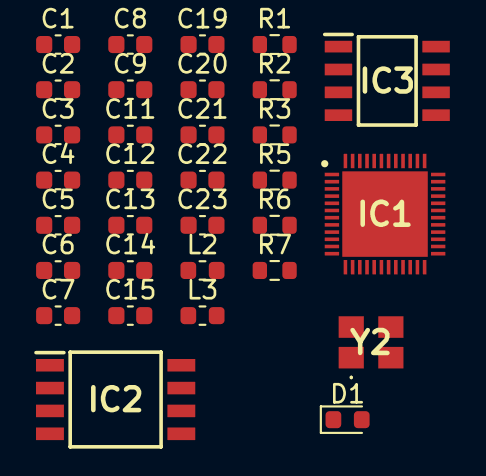
[picture p214: board ESP-C5.kicad_pcb from above]

Board: 2 copper layers, 32 parts (0 on the bottom side), 20 nets, no tracks yet.

Parts:
C1: 0.8pF; C_0603_1608Metric
C2, C3: 12pF; C_0603_1608Metric
C4: 0.3pF; C_0603_1608Metric
C5, C19, C23: 10uF; C_0603_1608Metric
C6, C8, C14: 1uF; C_0603_1608Metric
C7, C11, C13, C20, C22: 0.1uF; C_0603_1608Metric
C9: 2.6pF; C_0603_1608Metric
C12: 10nF; C_0603_1608Metric
C15: 1 uF; C_0603_1608Metric
C21: 3.0pF; C_0603_1608Metric
D1: D_TVS (ESD); D_0603_1608Metric
IC1: ESP32-C5HR8; QFN40P600X600X90-49N-D
IC2: SST26VF064B-104I_SM; SOIC127P794X203-8N
IC3: IS66WVR8M8FBLL-104NLI; SOIC127P600X175-8N
L2: 24nH; L_0603_1608Metric
L3: 2nH; L_0603_1608Metric
R1: 499; R_0603_1608Metric
R2, R3, R5, R6, R7: 0; R_0603_1608Metric
Y2: CX3225FB48000F0FZZH1

Connections:
/SPICLK: IC2.6 (CLK), IC3.6 (CLK), R6.2
/SPICS0: IC1.26 (SPICS0), IC2.1 (~CS)
/SPICS1_IO15: IC1.25 (SPICS1), IC3.1 (~CS)
/SPID: IC2.5 (DI), IC3.5 (DI), R7.2
/SPIHD: IC2.7 (~HOLD), IC3.7 (~HOLD), R5.2
/SPIQ: IC2.2 (DO), IC3.2 (DO), R2.2
/SPIWP: IC2.3 (~WP), IC3.3 (~WP), R3.2
/VDD33: C1.1, C4.1, C5.1, C6.1, C7.1, C8.1, C11.1, C12.1, C13.1, C14.1, C19.1, C21.1, C22.1, C23.1, D1.1 (A1), IC1.1 (VDDA6), IC1.3 (VDDA7), IC1.6 (VDDA8), IC1.8 (VDDPST1), IC1.24 (VDDPST2), IC1.39 (VDDPST3), IC1.44 (VDDA3), IC1.45 (VDDA4), IC1.46 (VDDA5), L3.2
/VDD_SPI: C15.1, C20.1, IC1.29 (VDD_SPI), IC2.8 (VDD), IC3.8 (VDD)
/XTAL_N: C2.2, IC1.4 (XTAL_N), Y2.3 (X_OUT)
/XTAL_P: C3.2, L2.1, Y2.1 (X_IN)
GND: C1.2, C2.1, C3.1, C4.2, C5.2, C6.2, C7.2, C8.2, C9.2, C11.2, C12.2, C13.2, C14.2, C15.2, C19.2, C20.2, C21.2, C22.2, C23.2, D1.2 (A2), IC1.2 (GND_1), IC1.43 (GND_2), IC1.47 (GND_3), IC1.49 (GND_4), IC2.4 (GND), IC3.4 (GND), Y2.2 (GND_1), Y2.4 (GND_2)
unnamed: IC1.31 (SPICLK), R6.1
unnamed: IC1.32 (SPID), R7.1
unnamed: IC1.30 (SPIHD), R5.1
unnamed: IC1.27 (SPIQ), R2.1
unnamed: IC1.28 (SPIWP), R3.1
unnamed: IC1.20 (U0TXD), R1.1
unnamed: C9.1, IC1.40 (VDDA1), IC1.41 (VDDA2), L3.1
unnamed: IC1.5 (XTAL_P), L2.2
