sundevilmotorsports/pcb-dev/2026/PitotBoard/PitotBoard.kicad_pcb

## KiCad design 2026/PitotBoard/PitotBoard.kicad_pcb (2026-11-06)

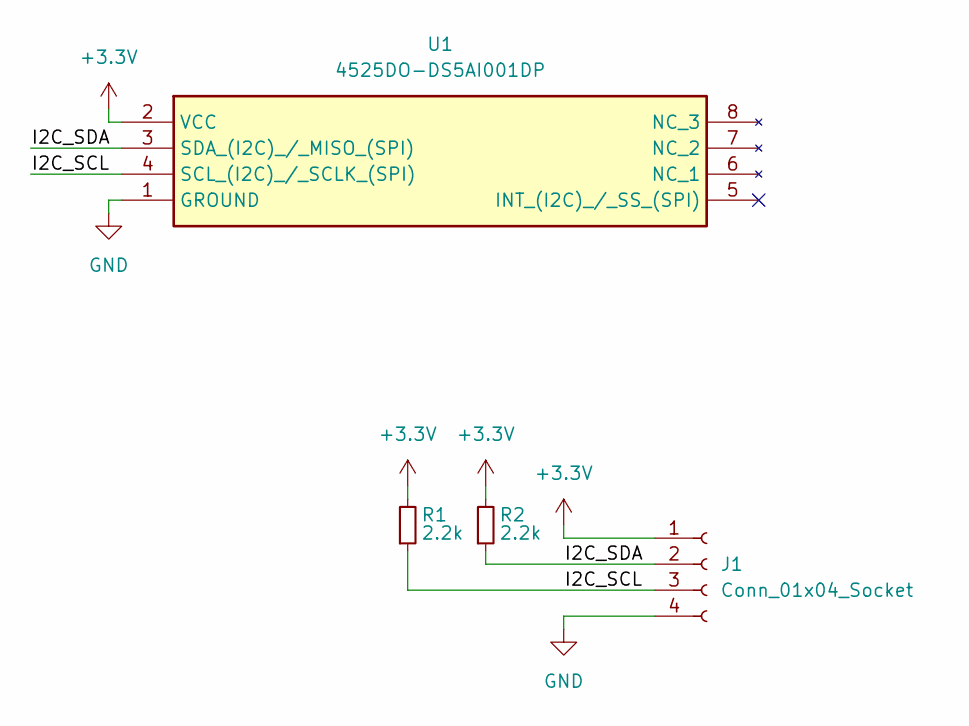
[picture p215: schematic PitotBoard.kicad_sch]

Parts:
J1: Conn_01x04_Socket; JST_XH_B4B-XH-A_1x04_P2.50mm_Vertical
R1, R2: 2.2k; R_0603_1608Metric
U1: 4525DO-DS5AI001DP; 4525DO-DS...P; Mouser Part Number 824-4525DODS5AI001DP

Connections:
+3.3V: J1.1, R1.2, R2.2, U1.2 (VCC)
/I2C_SCL: J1.3, R1.1, U1.4 (SCL_(I2C)_/_SCLK_(SPI))
/I2C_SDA: J1.2, R2.1, U1.3 (SDA_(I2C)_/_MISO_(SPI))
GND: J1.4, U1.1 (GROUND)

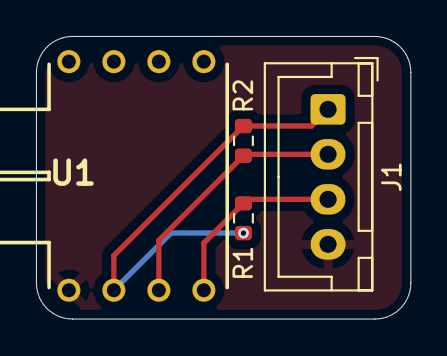
[picture p216: board PitotBoard.kicad_pcb from above]

Board: 2 copper layers, 20.8 x 15.7 mm, 4 parts (0 on the bottom side), 4 nets.
