sundevilmotorsports/pcb-dev/2026/TempSensor/SDM26_TempSensor_V1.0/SDM26_TempSensor_V1.0/SDM26_TempSensor_V1.0.kicad_pcb

## KiCad design 2026/TempSensor/SDM26_TempSensor_V1.0/SDM26_TempSensor_V1.0/SDM26_TempSensor_V1.0.kicad_pcb (2026-11-06)

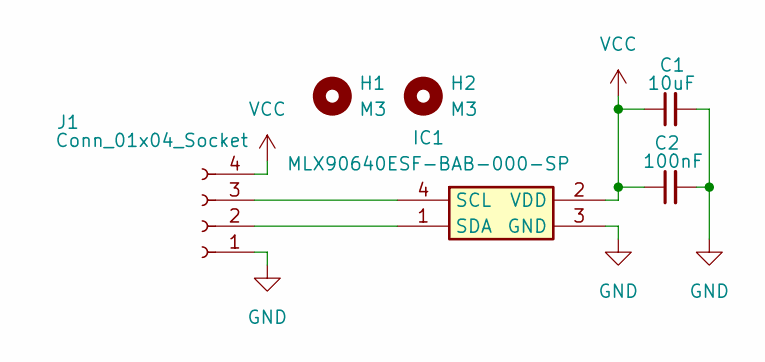
[picture p217: schematic SDM26_TempSensor_V1.0.kicad_sch]

Parts:
C1: 10uF; C_0603_1608Metric
C2: 100nF; C_0603_1608Metric
H1, H2: M3; MountingHole_3.2mm_M3
IC1: MLX90640ESF-BAB-000-SP; MLX90642ESFBCA000SP; Mouser Part Number 482-MLX90640ESFBABSP
J1: Conn_01x04_Socket; JST_XH_S4B-XH-A_1x04_P2.50mm_Horizontal

Connections:
GND: C1.2, C2.2, IC1.3 (GND), J1.1
unnamed: IC1.4 (SCL), J1.3
unnamed: IC1.1 (SDA), J1.2
VCC: C1.1, C2.1, IC1.2 (VDD), J1.4

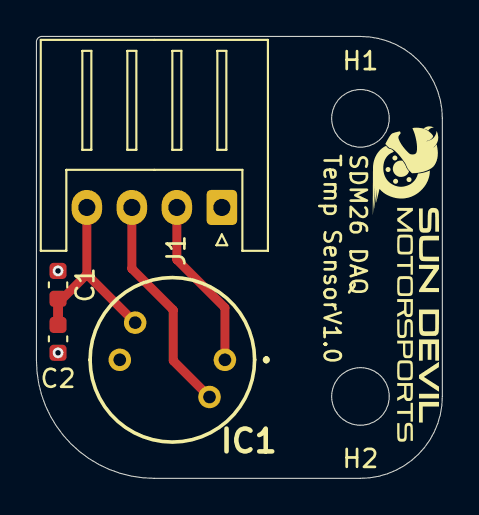
[picture p218: board SDM26_TempSensor_V1.0.kicad_pcb from above]

Board: 2 copper layers, 22.5 x 24.5 mm, 6 parts (0 on the bottom side), 4 nets.
