sundevilmotorsports/pcb-dev/2027/SDM27_StrainGaugeAmp/SDM27_StrainGaugeAmp.kicad_pcb

## KiCad design 2027/SDM27_StrainGaugeAmp/SDM27_StrainGaugeAmp.kicad_pcb (2026-09-28)

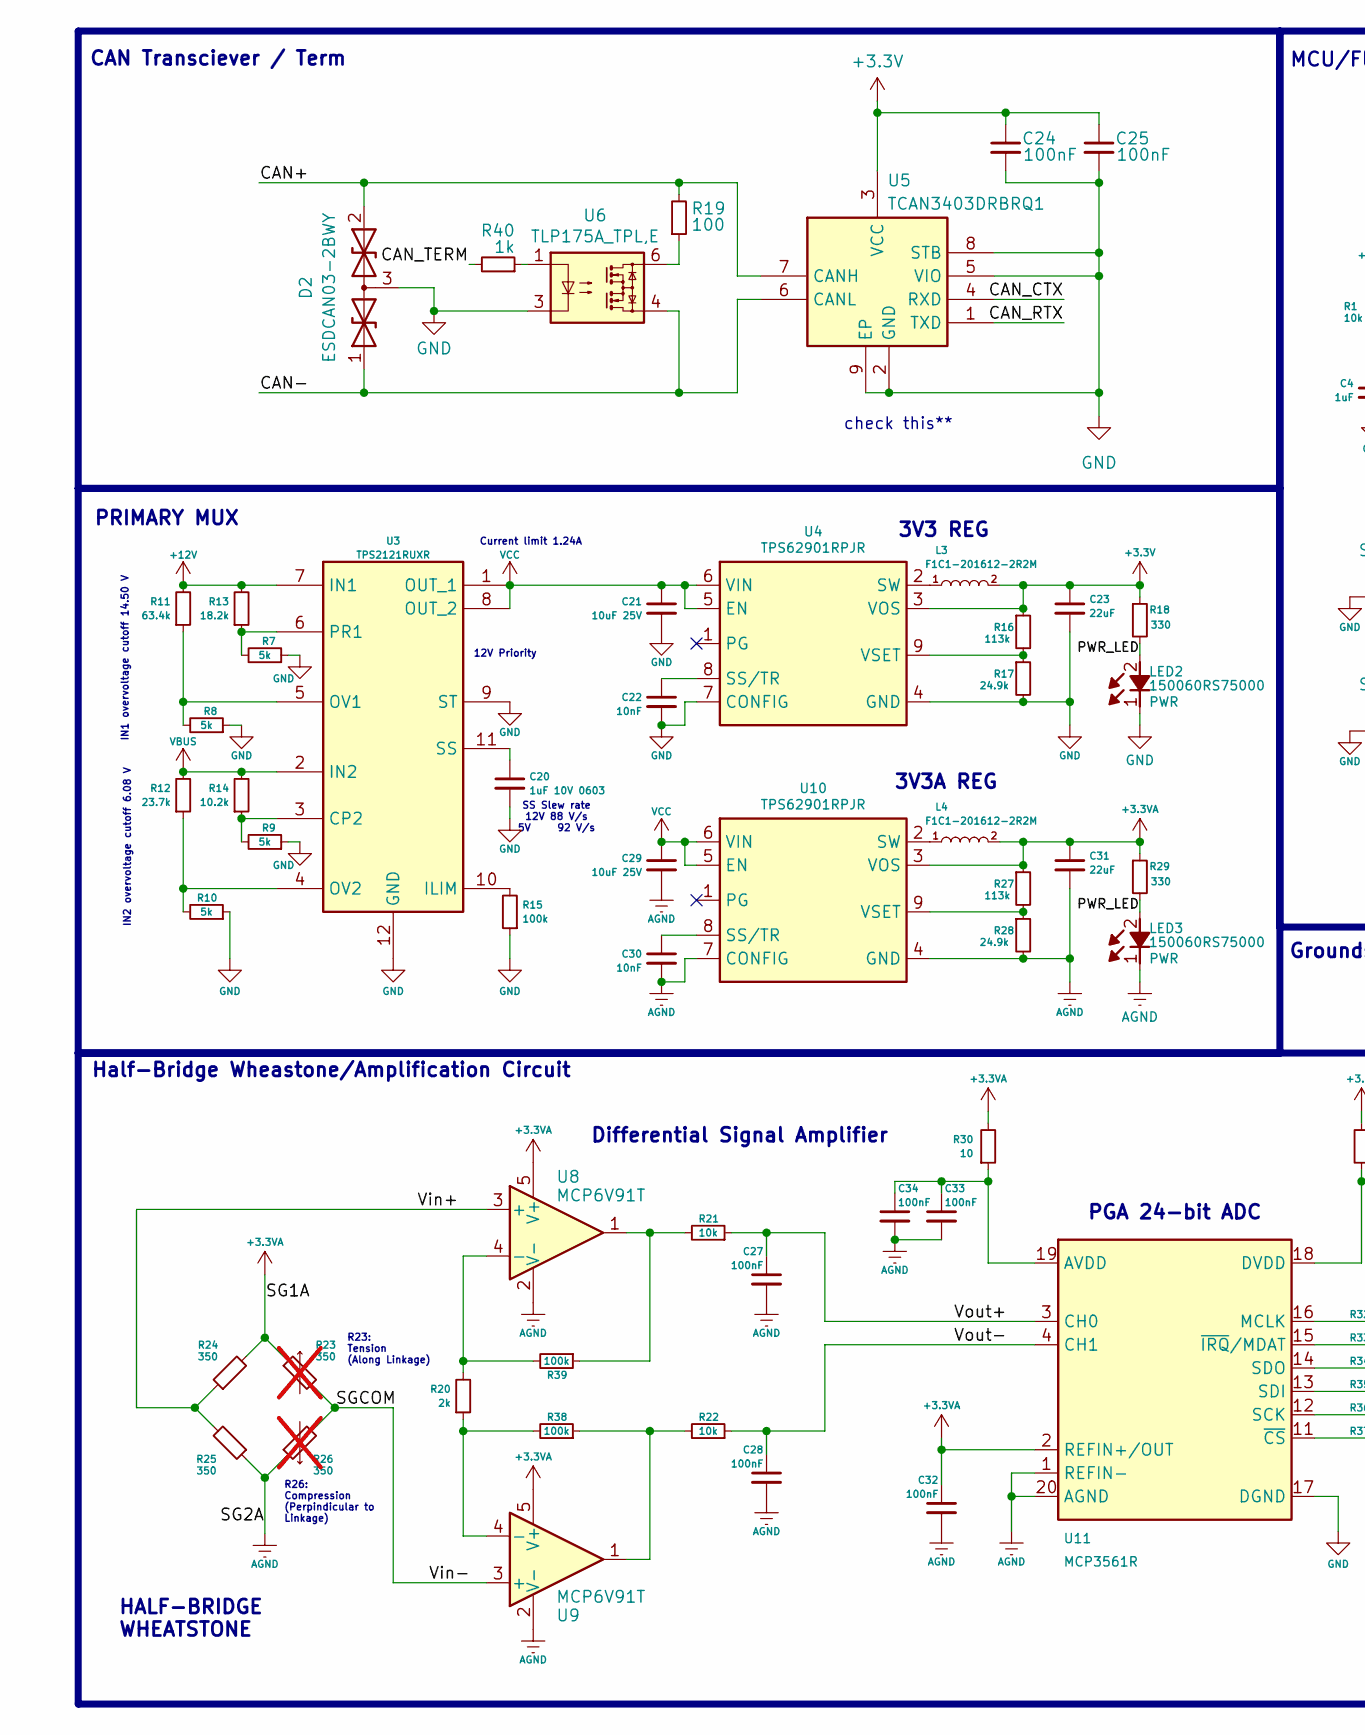
[picture p219: schematic SDM27_StrainGaugeAmp.kicad_sch, part in row 1, column 1]

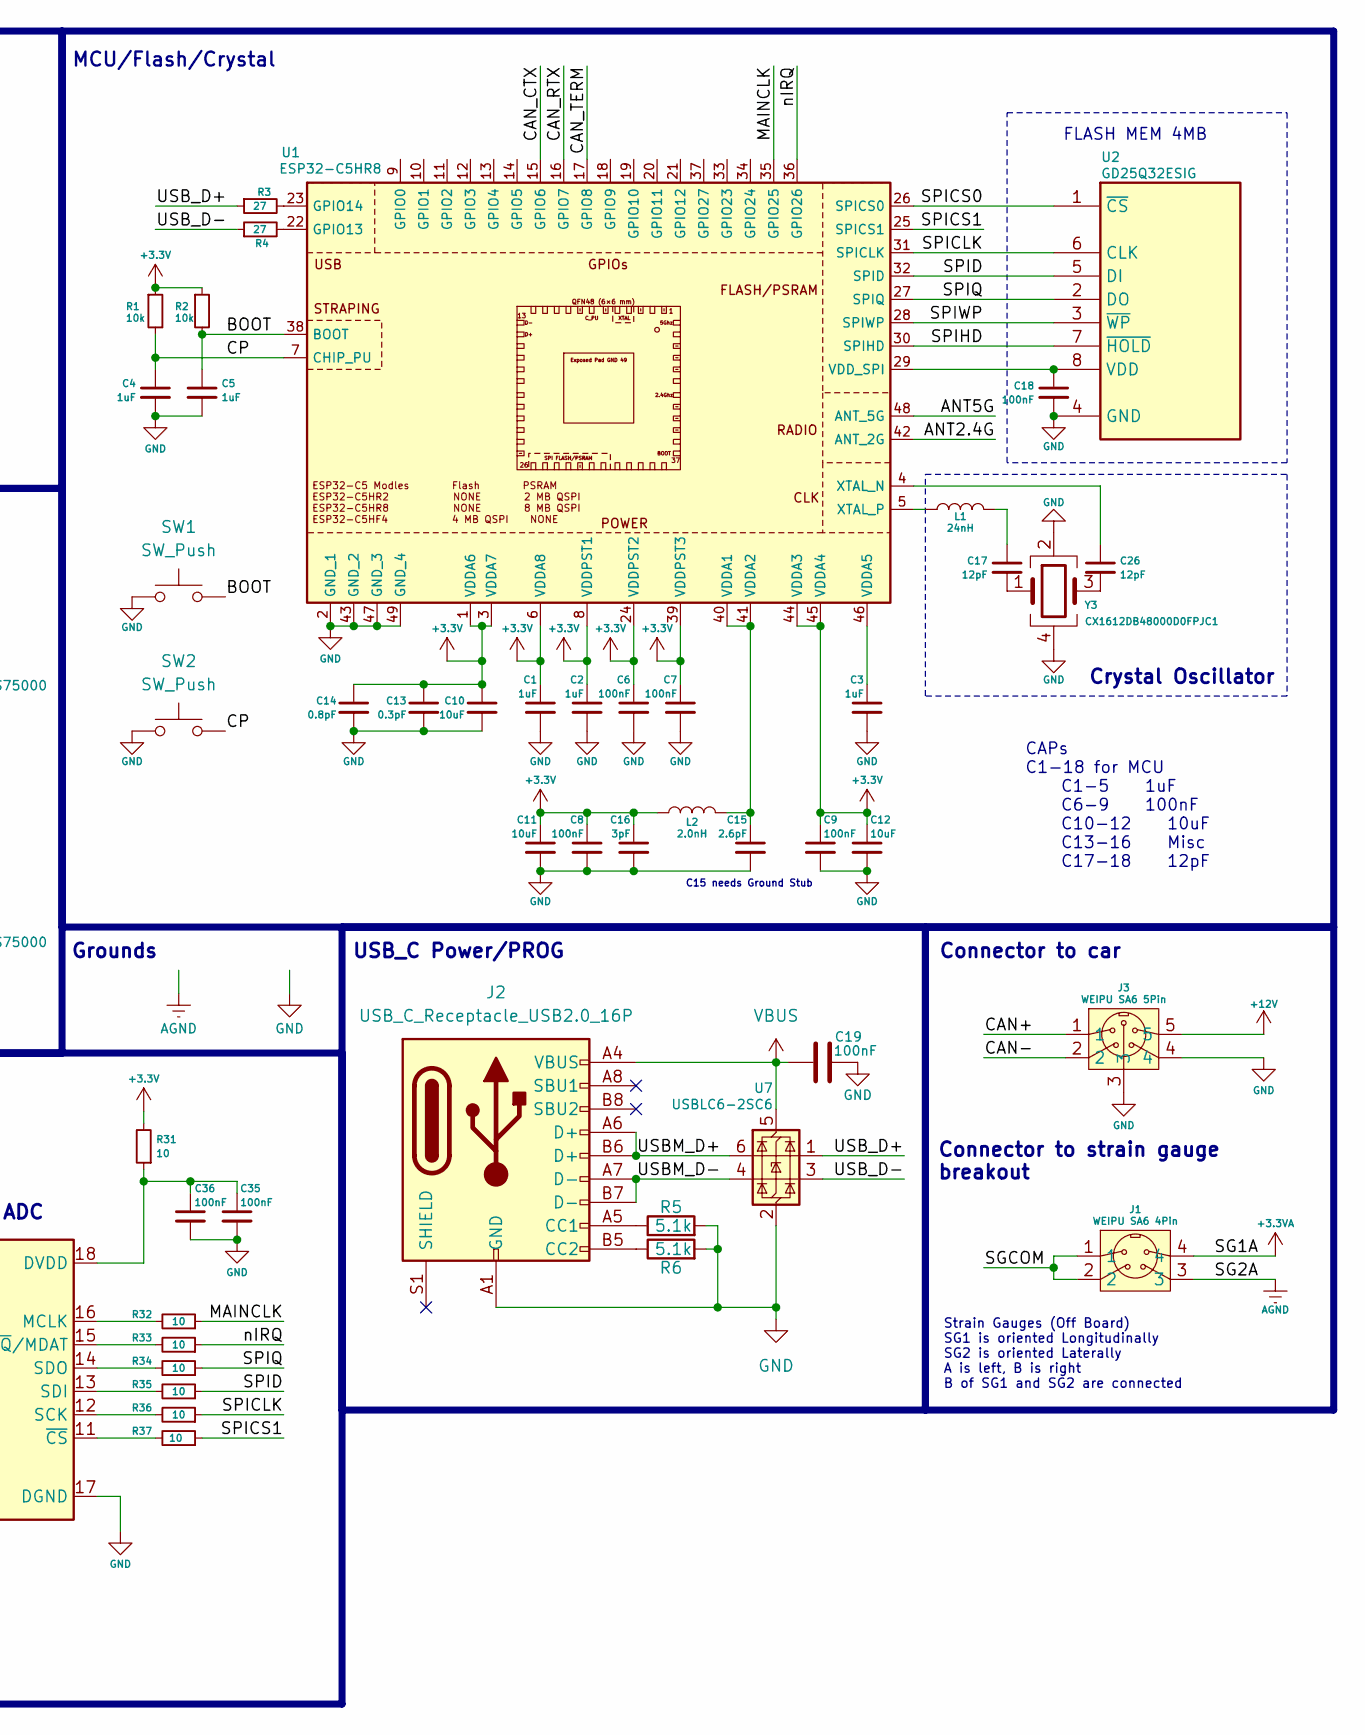
[picture p220: schematic SDM27_StrainGaugeAmp.kicad_sch, part in row 1, column 2]

Parts:
C1, C2, C3, C4, C5: 1uF; C_0603_1608Metric
C6, C7, C8, C9, C18, C19, C24, C25, C27, C28, C32, C33, C34, C35, C36: 100nF; C_0603_1608Metric
C10, C11, C12: 10uF; C_0603_1608Metric
C13: 0.3pF; C_0603_1608Metric
C14: 0.8pF; C_0603_1608Metric
C15: 2.6pF; C_0603_1608Metric
C16: 3pF; C_0603_1608Metric
C17, C26: 12pF; C_0201_0603Metric
C20: 1uF 10V 0603; C_0603_1608Metric
C21, C29: 10uF 25V; C_0603_1608Metric
C22, C30: 10nF; C_0603_1608Metric
C23, C31: 22uF; C_0603_1608Metric
D2: ESDCAN03-2BWY; SOT65P210X110-3N; Mouser Part Number 511-ESDCAN03-2BWY
J1: WEIPU SA6 4Pin; JST_EH_S4B-EH_1x04_P2.50mm_Horizontal
J2: USB_C_Receptacle_USB2.0_16P; USB_C_Receptacle_G-Switch_GT-USB-7010ASV
J3: WEIPU SA6 5Pin; JST_EH_S5B-EH_1x05_P2.50mm_Horizontal
L1: 24nH; L_0402_1005Metric
L2: 2.0nH; L_0402_1005Metric
L3, L4: F1C1-201612-2R2M; F1C12016122R2M; Mouser Part Number 530-F1C1-201612-2R2M
LED2, LED3: 150060RS75000; LEDC1608X80N; Mouser Part Number 710-150060RS75000
R1, R2: 10k; R_0402_1005Metric
R3, R4: 27; R_0402_1005Metric
R5, R6: 5.1k; R_0603_1608Metric
R7, R8, R9, R10: 5k; R_0603_1608Metric
R11: 63.4k; R_0603_1608Metric
R12: 23.7k; R_0603_1608Metric
R13: 18.2k; R_0603_1608Metric
R14: 10.2k; R_0603_1608Metric
R15, R38, R39: 100k; R_0603_1608Metric
R16, R27: 113k; R_0603_1608Metric
R17, R28: 24.9k; R_0603_1608Metric
R18, R29: 330; R_0603_1608Metric
R19: 100; R_0603_1608Metric
R20: 2k; R_0603_1608Metric
R21, R22: 10k; R_0603_1608Metric
R23, R26: 350; R_0603_1608Metric; not fitted
R24, R25: 350; R_0603_1608Metric
R30, R31, R32, R33, R34, R35, R36, R37: 10; R_0603_1608Metric
R40: 1k; R_0603_1608Metric
SW1, SW2: SW_Push; SW_SPST_CK_KXT3
U1: ESP32-C5HR8; QFN40P600X600X90-49N-D; Manufacturer_Part_Number ESP32-C5HR8
U2: GD25Q32ESIG; SOP-8-1EP_4.57x4.57mm_P1.27mm_EP4.57x4.45mm; Mouser Part Number 363-GD25Q32ESIG
U3: TPS2121RUXR; Mouser Part Number 595-TPS2121RUXR
U4, U10: TPS62901RPJR; Mouser Part Number 595-TPS62901RPJR
U5: TCAN3403DRBRQ1; SON65P300X300X100-9N-D; Manufacturer_Part_Number TCAN3403DRBRQ1; Mouser Part Number 595-TCAN3403DRBRQ1
U6: TLP175A_TPL,E; TLP266J; Mouser Part Number 757-TLP175A(TPLE
U7: USBLC6-2SC6; SOT-23-6
U8, U9: MCP6V91T; SOT-23-5
U11: MCP3561R; UQFN-20_3x3mm_P0.55mm
Y3: CX1612DB48000D0FPJC1; Mouser Part Number 581-CX1612DB48D0FPJ

Connections:
+3.3V: C1.1, C2.1, C6.1, C7.1, C8.1, C9.1, C10.1, C11.1, C12.1, C13.1, C14.1, C16.1, C23.1, C24.1, C25.1, L2.2, L3.2, R1.1, R2.1, R16.1, R18.1, R31.2, U1.1 (VDDA6), U1.3 (VDDA7), U1.6 (VDDA8), U1.8 (VDDPST1), U1.24 (VDDPST2), U1.39 (VDDPST3), U1.44 (VDDA3), U1.45 (VDDA4), U4.3 (VOS), U5.3 (VCC)
+3.3VA: C31.1, C32.1, J1.4, L4.2, R23.1, R24.2, R27.1, R29.1, R30.2, U8.5 (V+), U9.5 (V+), U10.3 (VOS), U11.2 (REFIN+/OUT)
+12V: J3.5, R11.2, R13.2, U3.7 (IN1)
/ANT2.4G: U1.42 (ANT_2G)
/ANT5G: U1.48 (ANT_5G)
/BOOT: C5.1, R2.2, SW1.2, U1.38 (BOOT)
/CAN+: D2.2, J3.1, R19.2, U5.7 (CANH)
/CAN-: D2.1, J3.2, U5.6 (CANL), U6.4
/CAN_CTX: U1.15 (GPIO6), U5.4 (RXD)
/CAN_RTX: U1.16 (GPIO7), U5.1 (TXD)
/CAN_TERM: R40.2, U1.17 (GPIO8)
/CP: C4.1, R1.2, SW2.2, U1.7 (CHIP_PU)
/MAINCLK: R32.1, U1.35 (GPIO25)
/PWR_LED: LED2.2 (A), LED3.2 (A), R18.2, R29.2
/SGCOM: J1.1, J1.2, R23.2, R26.2, U9.3 (+)
/SPICLK: R36.1, U1.31 (SPICLK), U2.6 (CLK)
/SPICS0: U1.26 (SPICS0), U2.1 (~CS)
/SPICS1: R37.1, U1.25 (SPICS1)
/SPID: R35.1, U1.32 (SPID), U2.5 (DI)
/SPIHD: U1.30 (SPIHD), U2.7 (~HOLD)
/SPIQ: R34.1, U1.27 (SPIQ), U2.2 (DO)
/SPIWP: U1.28 (SPIWP), U2.3 (~WP)
/USBM_D+: J2.A6 (D+), J2.B6 (D+), U7.6 (I/O1)
/USBM_D-: J2.A7 (D-), J2.B7 (D-), U7.4 (I/O2)
/USB_D+: R3.1, U7.1 (I/O1)
/USB_D-: R4.1, U7.3 (I/O2)
/Vin+: R24.1, R25.2, U8.3 (+)
/Vout+: C27.1, R21.1, U11.3 (CH0)
/Vout-: C28.1, R22.1, U11.4 (CH1)
/nIRQ: R33.1, U1.36 (GPIO26)
AGND: C27.2, C28.2, C29.2, C30.2, C31.2, C32.2, C33.2, C34.2, J1.3, LED3.1 (K), R25.1, R26.1, R28.2, U8.2 (V-), U9.2 (V-), U10.4 (GND), U10.7 (CONFIG), U11.1 (REFIN-), U11.20 (AGND)
GND: C1.2, C2.2, C3.2, C4.2, C5.2, C6.2, C7.2, C8.2, C9.2, C10.2, C11.2, C12.2, C13.2, C14.2, C15.2, C16.2, C18.2, C19.1, C20.2, C21.2, C22.2, C23.2, C24.2, C25.2, C35.2, C36.2, D2.3, J2.A1 (GND), J2.A12 (GND), J2.B1 (GND), J2.B12 (GND), J3.3, J3.4, LED2.1 (K), R5.2, R6.2, R7.1, R8.1, R9.1, R10.1, R15.1, R17.2, SW1.1, SW2.1, U1.2 (GND_1), U1.43 (GND_2), U1.47 (GND_3), U1.49 (GND_4), U2.4 (GND), U3.9 (ST), U3.12 (GND), U4.4 (GND), U4.7 (CONFIG), U5.2 (GND), U5.5 (VIO), U5.8 (STB), U5.9 (EP), U6.3, U7.2 (GND), U11.17 (DGND), Y3.2, Y3.4
unnamed: C17.1, L1.2
unnamed: C17.2, Y3.1
unnamed: C26.2, Y3.3
unnamed: J2.A5 (CC1), R5.1
unnamed: J2.B5 (CC2), R6.1
unnamed: R19.1, U6.6
unnamed: R21.2, R39.1, U8.1
unnamed: R22.2, R38.1, U9.1
unnamed: R40.1, U6.1
unnamed: R4.2, U1.22 (GPIO13)
unnamed: R3.2, U1.23 (GPIO14)
unnamed: C15.1, L2.1, U1.40 (VDDA1), U1.41 (VDDA2)
unnamed: C3.1, U1.46 (VDDA5)
unnamed: C18.1, U1.29 (VDD_SPI), U2.8 (VDD)
unnamed: C26.1, U1.4 (XTAL_N)
unnamed: L1.1, U1.5 (XTAL_P)
unnamed: R9.2, R14.1, U3.3 (CP2)
unnamed: R15.2, U3.10 (ILIM)
unnamed: R8.2, R11.1, U3.5 (OV1)
unnamed: R10.2, R12.1, U3.4 (OV2)
unnamed: R7.2, R13.1, U3.6 (PR1)
unnamed: C20.1, U3.11 (SS)
unnamed: C22.1, U4.8 (SS/TR)
unnamed: L3.1, U4.2 (SW)
unnamed: R16.2, R17.1, U4.9 (VSET)
unnamed: R20.2, R39.2, U8.4 (-)
unnamed: R20.1, R38.2, U9.4 (-)
unnamed: C30.1, U10.8 (SS/TR)
unnamed: L4.1, U10.2 (SW)
unnamed: R27.2, R28.1, U10.9 (VSET)
unnamed: C33.1, C34.1, R30.1, U11.19 (AVDD)
unnamed: C35.1, C36.1, R31.1, U11.18 (DVDD)
unnamed: R32.2, U11.16 (MCLK)
unnamed: R36.2, U11.12 (SCK)
unnamed: R35.2, U11.13 (SDI)
unnamed: R34.2, U11.14 (SDO)
unnamed: R37.2, U11.11 (~CS)
unnamed: R33.2, U11.15 (~IRQ/MDAT)
VBUS: C19.2, J2.A4 (VBUS), J2.A9 (VBUS), J2.B4 (VBUS), J2.B9 (VBUS), R12.2, R14.2, U3.2 (IN2), U7.5 (VBUS)
VCC: C21.1, C29.1, U3.1 (OUT_1), U3.8 (OUT_2), U4.5 (EN), U4.6 (VIN), U10.5 (EN), U10.6 (VIN)

Notes on the sheet:
check this**
FLASH MEM 4MB
3V3 REG
R23: Tension (Along Linkage)
SS Slew rate 12V 88 V/s 5V 92 V/s
Current limit 1.24A
Connector to car
Connector to strain gauge breakout
C15 needs Ground Stub
12V Priority
CAN Transciever / Term
IN2 overvoltage cutoff 6.08 V
MCU/Flash/Crystal
Half-Bridge Wheastone/Amplification Circuit
Differential Signal Amplifier
3V3A REG
HALF-BRIDGE WHEATSTONE
R26: Compression (Perpindicular to Linkage)
CAPs C1-18 for MCU C1-5 1uF C6-9 100nF C10-12 10uF C13-16 Misc C17-18 12pF
Crystal Oscillator
PGA 24-bit ADC
PRIMARY MUX
Grounds
Strain Gauges (Off Board) SG1 is oriented Longitudinally SG2 is oriented Laterally A is left, B is right B of SG1 and SG2 are connected
USB_C Power/PROG
IN1 overvoltage cutoff 14.50 V

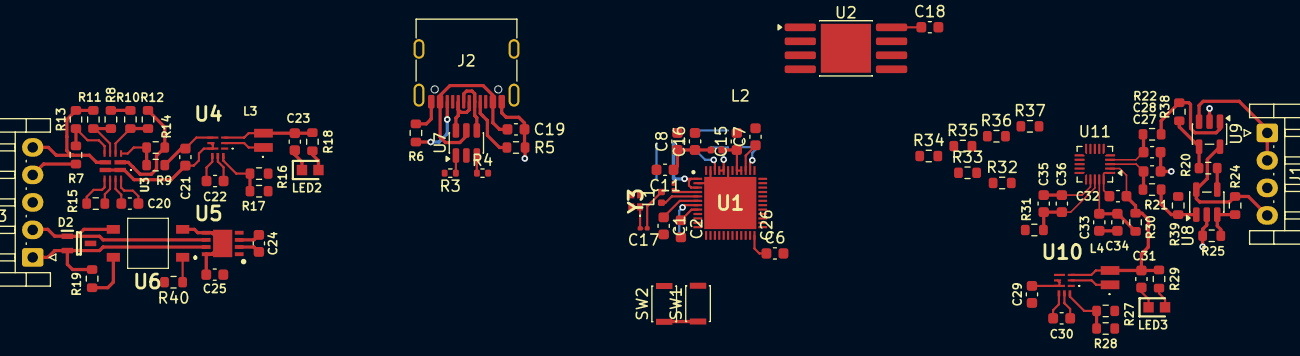
[picture p221: board SDM27_StrainGaugeAmp.kicad_pcb from above]

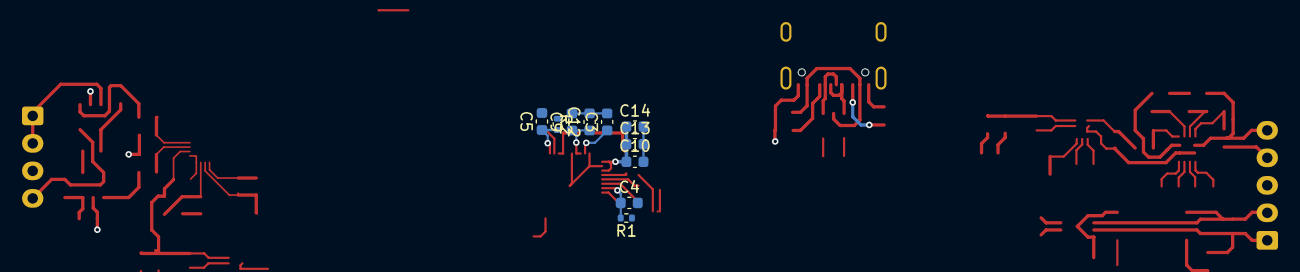
[picture p222: board SDM27_StrainGaugeAmp.kicad_pcb from below]

Board: 2 copper layers, 98 parts (10 on the bottom side), 70 nets.
