sundevilmotorsports/pcb-dev/2027/SDM27_IMU/IMU_V1/IMU_V1.kicad_pcb

## KiCad design 2027/SDM27_IMU/IMU_V1/IMU_V1.kicad_pcb (2026-10-08)

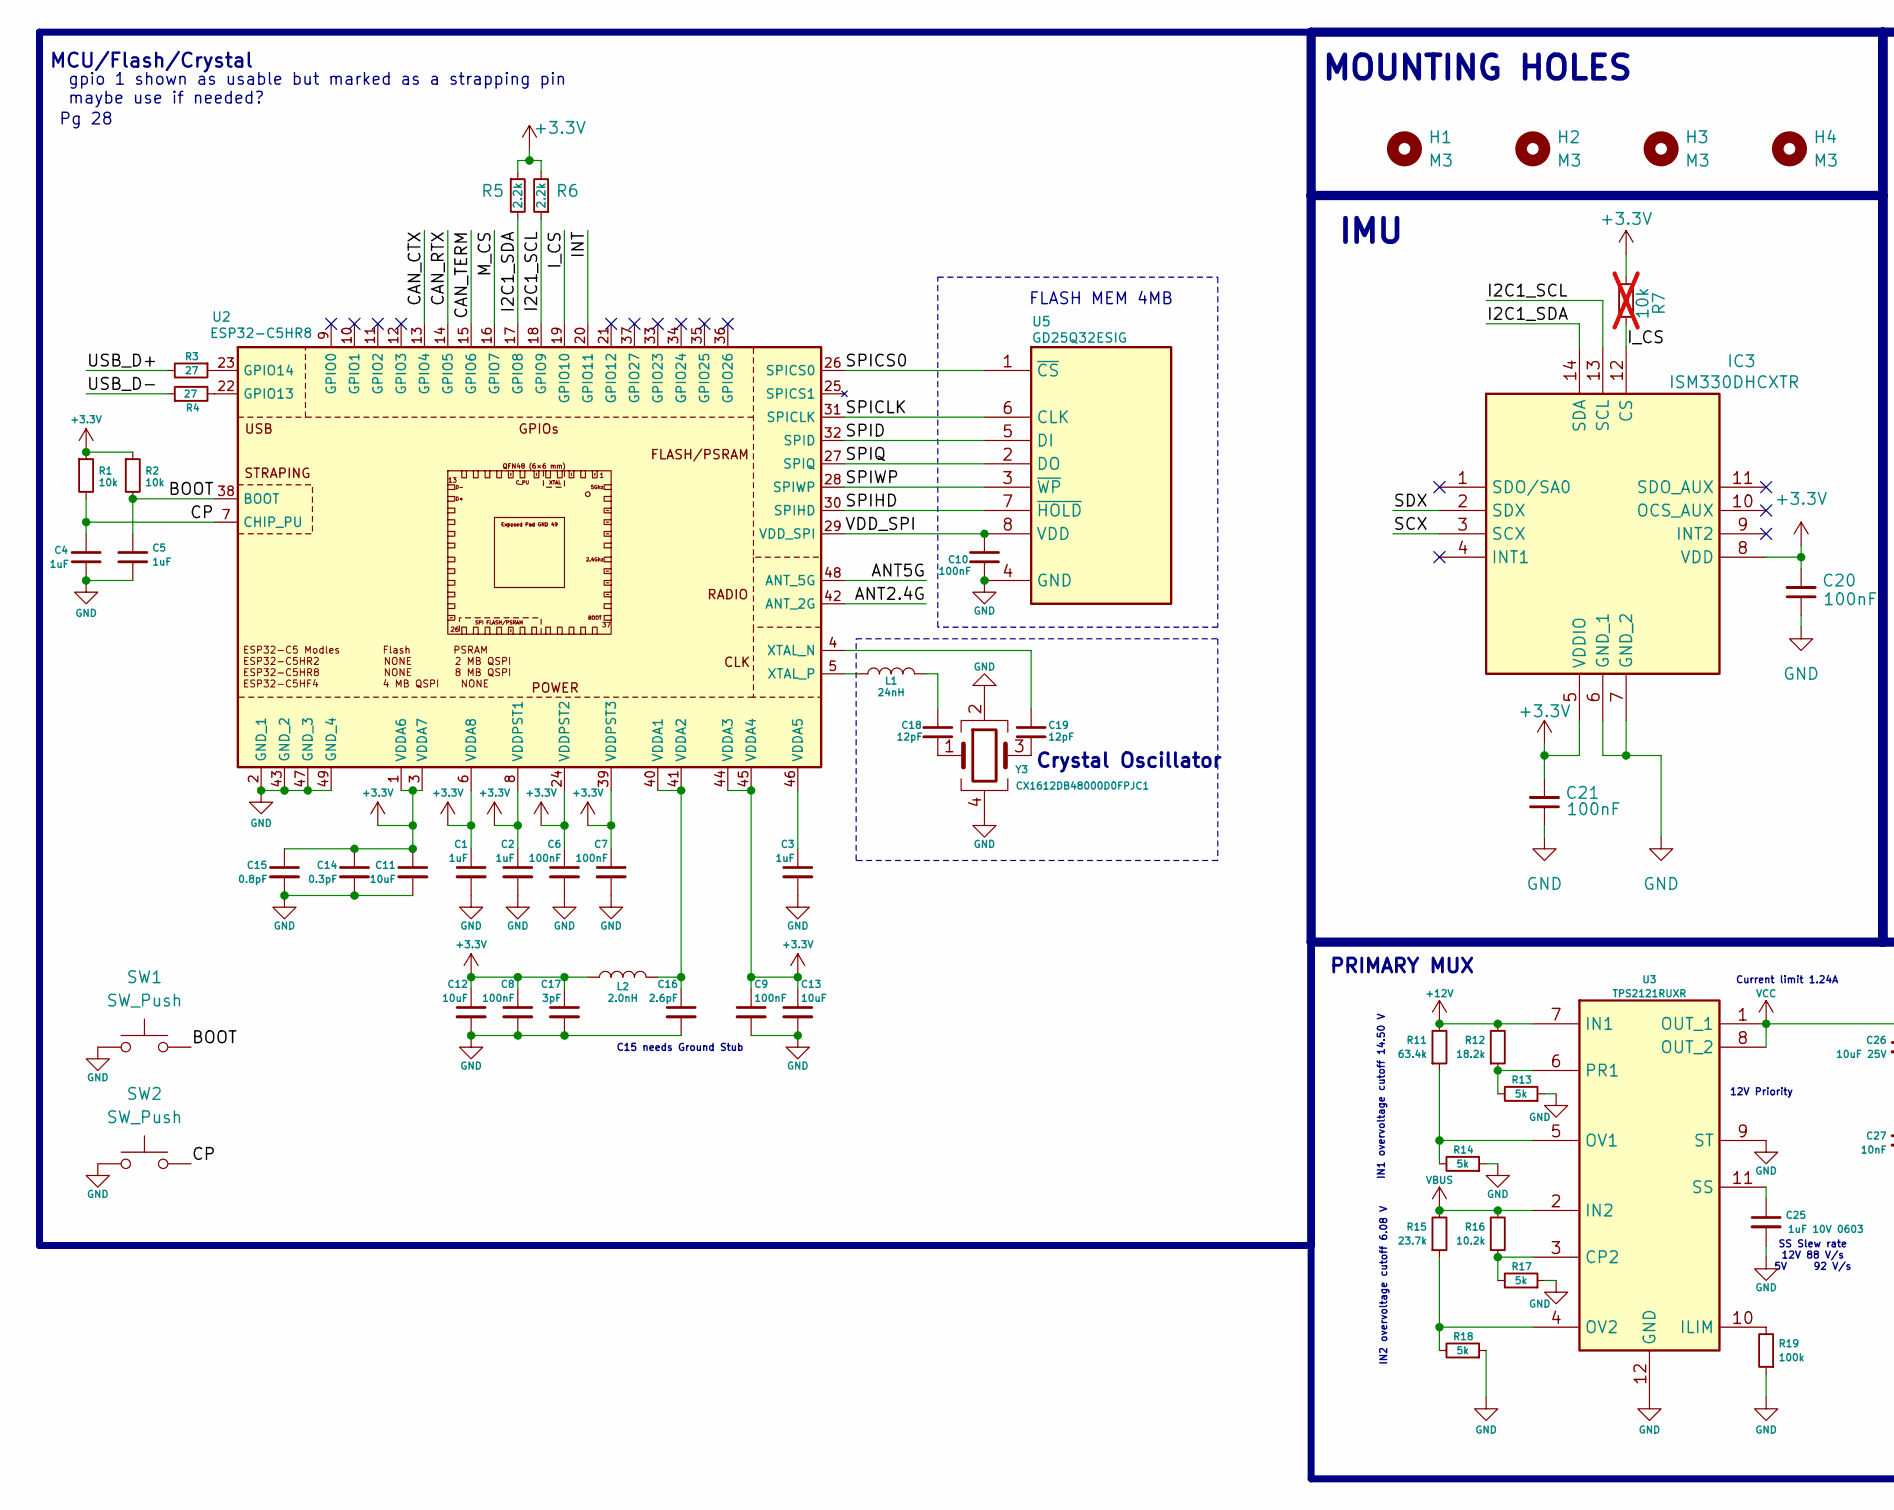
[picture p223: schematic IMU_V1.kicad_sch, part in row 1, column 1]

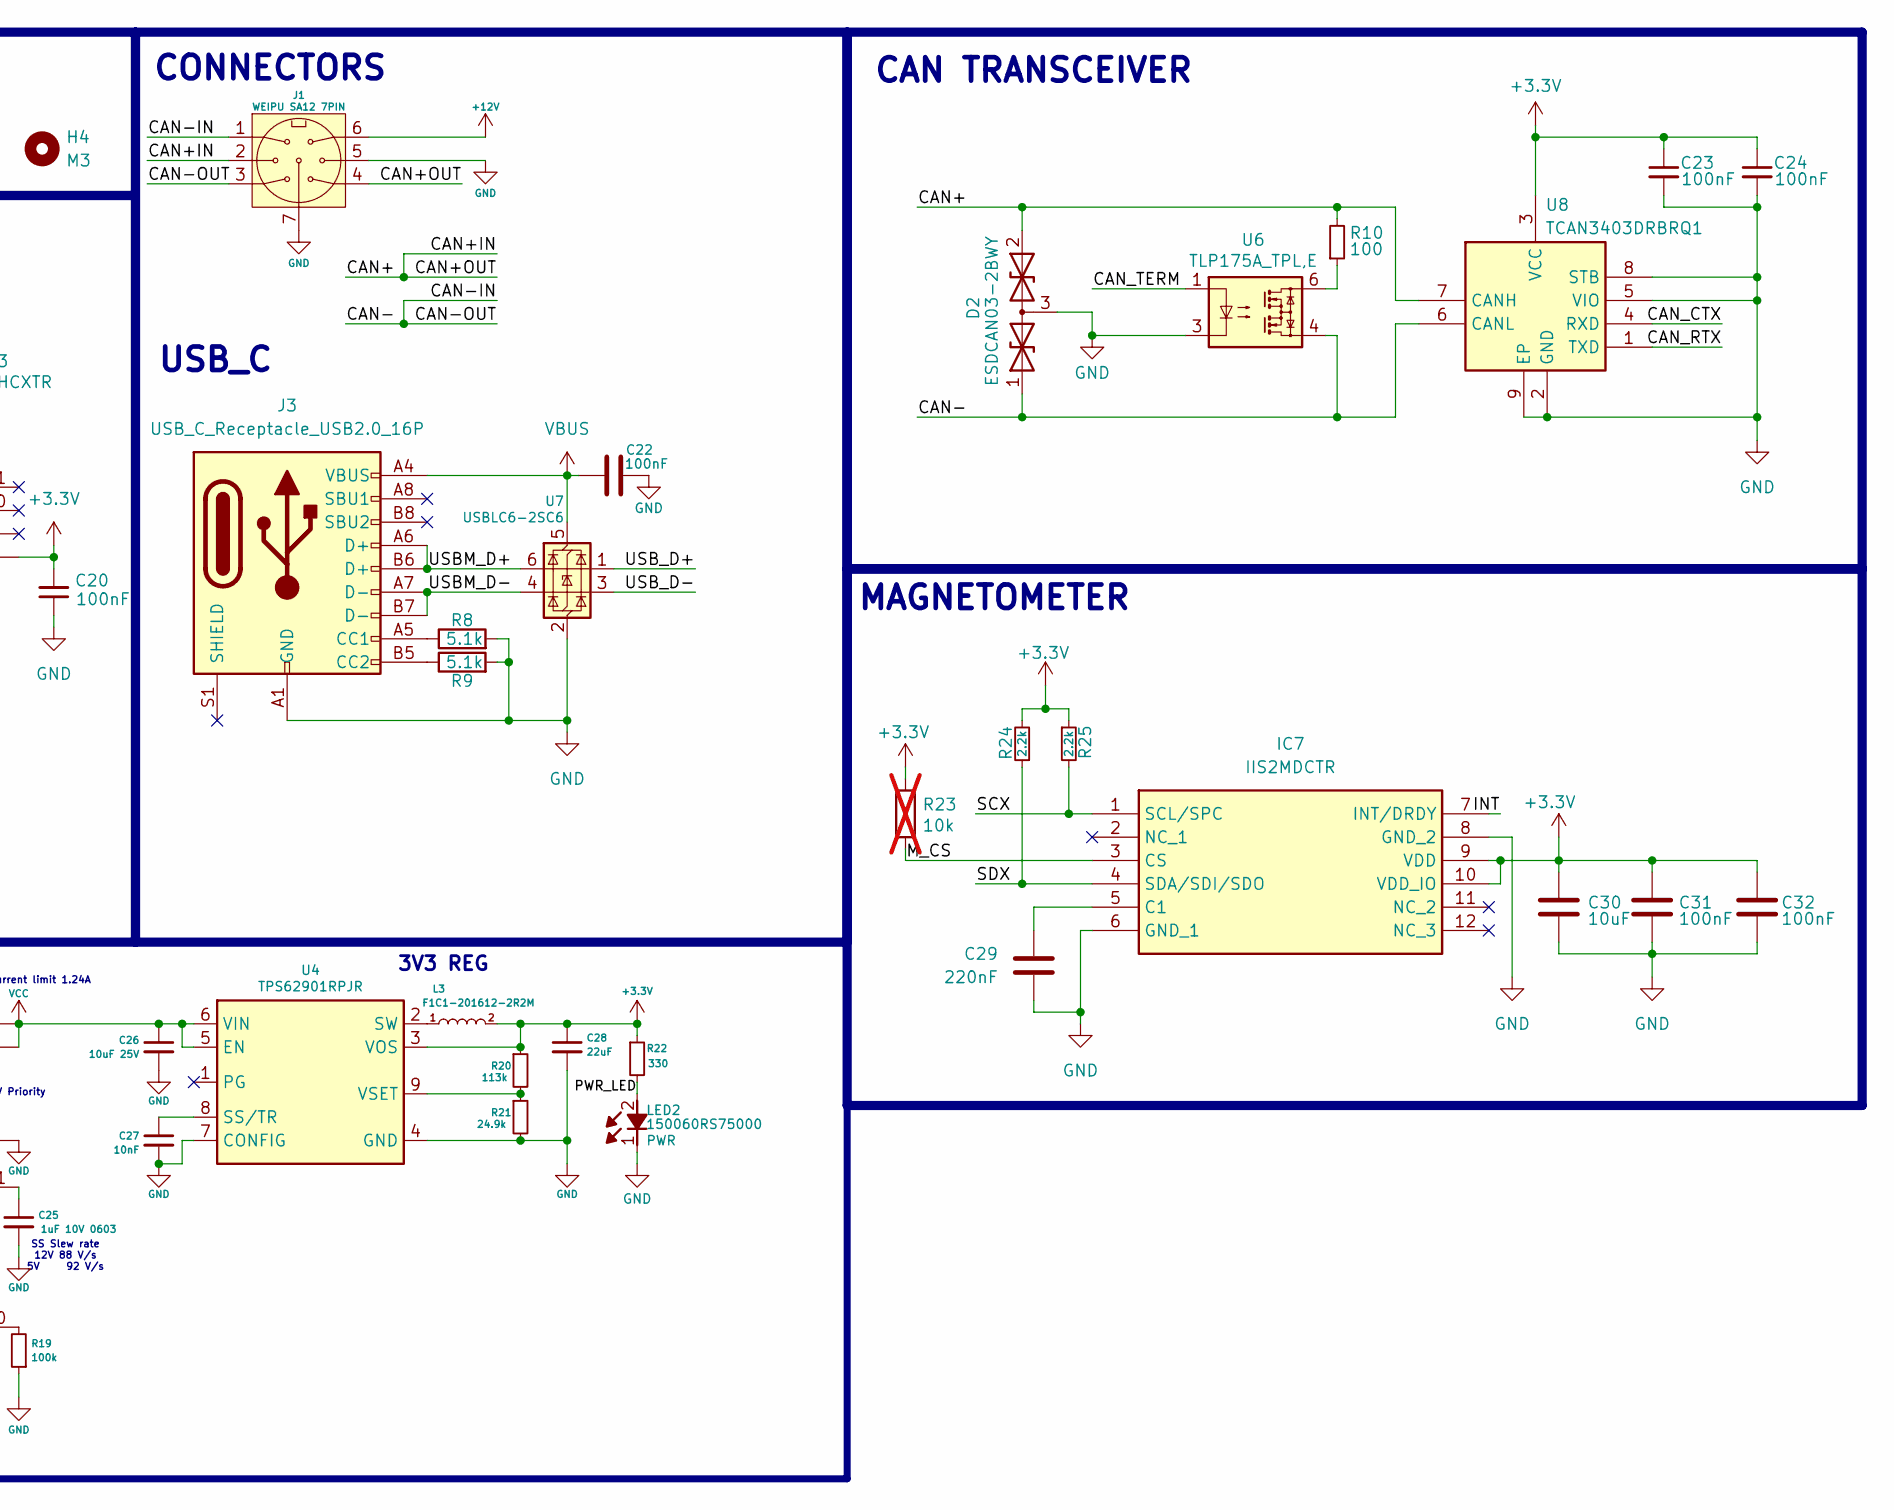
[picture p224: schematic IMU_V1.kicad_sch, part in row 1, column 2]

Parts:
C1, C2, C3, C4, C5: 1uF; C_0603_1608Metric
C6, C7, C8, C9, C10, C20, C21, C22, C23, C24, C31, C32: 100nF; C_0603_1608Metric
C11, C12, C13, C30: 10uF; C_0603_1608Metric
C14: 0.3pF; C_0603_1608Metric
C15: 0.8pF; C_0603_1608Metric
C16: 2.6pF; C_0603_1608Metric
C17: 3pF; C_0603_1608Metric
C18, C19: 12pF; C_0603_1608Metric
C25: 1uF 10V 0603; C_0603_1608Metric
C26: 10uF 25V; C_0603_1608Metric
C27: 10nF; C_0603_1608Metric
C28: 22uF; C_0603_1608Metric
C29: 220nF; C_0603_1608Metric
D2: ESDCAN03-2BWY; SOT65P210X110-3N; Mouser Part Number 511-ESDCAN03-2BWY
H1, H2, H3, H4: M3; MountingHole_3.2mm_M3
IC3: ISM330DHCXTR; LSM6DS3USTR; Mouser Part Number 511-ISM330DHCXTR
IC7: IIS2MDCTR; Mouser Part Number 511-IIS2MDCTR
J1: WEIPU SA12 7PIN; JST_PH_B7B-PH-K_1x07_P2.00mm_Vertical
J3: USB_C_Receptacle_USB2.0_16P; USB_C_Receptacle_G-Switch_GT-USB-7010ASV
L1: 24nH; L_0402_1005Metric
L2: 2.0nH; L_0402_1005Metric
L3: F1C1-201612-2R2M; F1C12016122R2M; Mouser Part Number 530-F1C1-201612-2R2M
LED2: 150060RS75000; LEDC1608X80N; Mouser Part Number 710-150060RS75000
R1, R2: 10k; R_0603_1608Metric
R3, R4: 27; R_0402_1005Metric
R5, R6, R24, R25: 2.2k; R_0603_1608Metric
R7, R23: 10k; R_0603_1608Metric; not fitted
R8, R9: 5.1k; R_0603_1608Metric
R10: 100; R_0603_1608Metric
R11: 63.4k; R_0603_1608Metric
R12: 18.2k; R_0603_1608Metric
R13, R14, R17, R18: 5k; R_0603_1608Metric
R15: 23.7k; R_0603_1608Metric
R16: 10.2k; R_0603_1608Metric
R19: 100k; R_0603_1608Metric
R20: 113k; R_0603_1608Metric
R21: 24.9k; R_0603_1608Metric
R22: 330; R_0603_1608Metric
SW1, SW2: SW_Push; SW_SPST_CK_KXT3
U2: ESP32-C5HR8; QFN40P600X600X90-49N-D; Manufacturer_Part_Number ESP32-C5HR8
U3: TPS2121RUXR; Mouser Part Number 595-TPS2121RUXR
U4: TPS62901RPJR; Mouser Part Number 595-TPS62901RPJR
U5: GD25Q32ESIG; SOP-8_3.76x4.96mm_P1.27mm; Mouser Part Number 363-GD25Q32ESIG
U6: TLP175A_TPL,E; TLP266J; Mouser Part Number 757-TLP175A(TPLE
U7: USBLC6-2SC6; SOT-23-6
U8: TCAN3403DRBRQ1; SON65P300X300X100-9N-D; Manufacturer_Part_Number TCAN3403DRBRQ1; Mouser Part Number 595-TCAN3403DRBRQ1
Y3: CX1612DB48000D0FPJC1; Mouser Part Number 581-CX1612DB48D0FPJ

Connections:
+3.3V: C1.1, C2.1, C6.1, C7.1, C8.1, C9.1, C11.1, C12.1, C13.1, C14.1, C15.1, C17.1, C20.2, C21.2, C23.1, C24.1, C28.1, C30.1, C31.1, C32.1, IC3.5 (VDDIO), IC3.8 (VDD), IC7.9 (VDD), IC7.10 (VDD_IO), L2.2, L3.2, R1.1, R2.1, R5.1, R6.2, R7.2, R20.1, R22.1, R23.1, R24.2, R25.1, U2.1 (VDDA6), U2.3 (VDDA7), U2.6 (VDDA8), U2.8 (VDDPST1), U2.24 (VDDPST2), U2.39 (VDDPST3), U2.44 (VDDA3), U2.45 (VDDA4), U4.3 (VOS), U8.3 (VCC)
+12V: J1.6, R11.2, R12.2, U3.7 (IN1)
/ANT2.4G: U2.42 (ANT_2G)
/ANT5G: U2.48 (ANT_5G)
/BOOT: C5.1, R2.2, SW1.2, U2.38 (BOOT)
/CAN+: D2.2, J1.2, J1.4, R10.2, U8.7 (CANH)
/CAN-: D2.1, J1.1, J1.3, U6.4, U8.6 (CANL)
/CAN_CTX: U2.13 (GPIO4), U8.4 (RXD)
/CAN_RTX: U2.14 (GPIO5), U8.1 (TXD)
/CAN_TERM: U2.15 (GPIO6), U6.1
/CP: C4.1, R1.2, SW2.2, U2.7 (CHIP_PU)
/I2C1_SCL: IC3.13 (SCL), R6.1, U2.18 (GPIO9)
/I2C1_SDA: IC3.14 (SDA), R5.2, U2.17 (GPIO8)
/INT: IC7.7 (INT/DRDY), U2.20 (GPIO11)
/I_CS: IC3.12 (CS), R7.1, U2.19 (GPIO10)
/M_CS: IC7.3 (CS), R23.2, U2.16 (GPIO7)
/PWR_LED: LED2.2 (A), R22.2
/SCX: IC3.3 (SCX), IC7.1 (SCL/SPC), R25.2
/SDX: IC3.2 (SDX), IC7.4 (SDA/SDI/SDO), R24.1
/SPICLK: U2.31 (SPICLK), U5.6 (CLK)
/SPICS0: U2.26 (SPICS0), U5.1 (~CS)
/SPID: U2.32 (SPID), U5.5 (DI)
/SPIHD: U2.30 (SPIHD), U5.7 (~HOLD)
/SPIQ: U2.27 (SPIQ), U5.2 (DO)
/SPIWP: U2.28 (SPIWP), U5.3 (~WP)
/USBM_D+: J3.A6 (D+), J3.B6 (D+), U7.6 (I/O1)
/USBM_D-: J3.A7 (D-), J3.B7 (D-), U7.4 (I/O2)
/USB_D+: R3.2, U7.1 (I/O1)
/USB_D-: R4.1, U7.3 (I/O2)
/VDD_SPI: C10.1, U2.29 (VDD_SPI), U5.8 (VDD)
GND: C1.2, C2.2, C3.2, C4.2, C5.2, C6.2, C7.2, C8.2, C9.2, C10.2, C11.2, C12.2, C13.2, C14.2, C15.2, C16.2, C17.2, C20.1, C21.1, C22.1, C23.2, C24.2, C25.2, C26.2, C27.2, C28.2, C29.2, C30.2, C31.2, C32.2, D2.3, IC3.6 (GND_1), IC3.7 (GND_2), IC7.6 (GND_1), IC7.8 (GND_2), J1.5, J1.7, J3.A1 (GND), J3.A12 (GND), J3.B1 (GND), J3.B12 (GND), LED2.1 (K), R8.2, R9.2, R13.1, R14.1, R17.1, R18.1, R19.1, R21.2, SW1.1, SW2.1, U2.2 (GND_1), U2.43 (GND_2), U2.47 (GND_3), U2.49 (GND_4), U3.9 (ST), U3.12 (GND), U4.4 (GND), U4.7 (CONFIG), U5.4 (GND), U6.3, U7.2 (GND), U8.2 (GND), U8.5 (VIO), U8.8 (STB), U8.9 (EP), Y3.2, Y3.4
unnamed: C18.1, L1.2
unnamed: C18.2, Y3.1
unnamed: C19.2, Y3.3
unnamed: C29.1, IC7.5 (C1)
unnamed: J3.A5 (CC1), R8.1
unnamed: J3.B5 (CC2), R9.1
unnamed: R10.1, U6.6
unnamed: R4.2, U2.22 (GPIO13)
unnamed: R3.1, U2.23 (GPIO14)
unnamed: C16.1, L2.1, U2.40 (VDDA1), U2.41 (VDDA2)
unnamed: C3.1, U2.46 (VDDA5)
unnamed: C19.1, U2.4 (XTAL_N)
unnamed: L1.1, U2.5 (XTAL_P)
unnamed: R16.1, R17.2, U3.3 (CP2)
unnamed: R19.2, U3.10 (ILIM)
unnamed: R11.1, R14.2, U3.5 (OV1)
unnamed: R15.1, R18.2, U3.4 (OV2)
unnamed: R12.1, R13.2, U3.6 (PR1)
unnamed: C25.1, U3.11 (SS)
unnamed: C27.1, U4.8 (SS/TR)
unnamed: L3.1, U4.2 (SW)
unnamed: R20.2, R21.1, U4.9 (VSET)
VBUS: C22.2, J3.A4 (VBUS), J3.A9 (VBUS), J3.B4 (VBUS), J3.B9 (VBUS), R15.2, R16.2, U3.2 (IN2), U7.5 (VBUS)
VCC: C26.1, U3.1 (OUT_1), U3.8 (OUT_2), U4.5 (EN), U4.6 (VIN)

Notes on the sheet:
Crystal Oscillator
IN1 overvoltage cutoff 14.50 V
SS Slew rate 12V 88 V/s 5V 92 V/s
12V Priority
USB_C
IN2 overvoltage cutoff 6.08 V
FLASH MEM 4MB
gpio 1 shown as usable but marked as a strapping pin maybe use if needed?
Pg 28
MAGNETOMETER
CAN TRANSCEIVER
MCU/Flash/Crystal
IMU
C15 needs Ground Stub
3V3 REG
PRIMARY MUX
CONNECTORS
Current limit 1.24A
MOUNTING HOLES

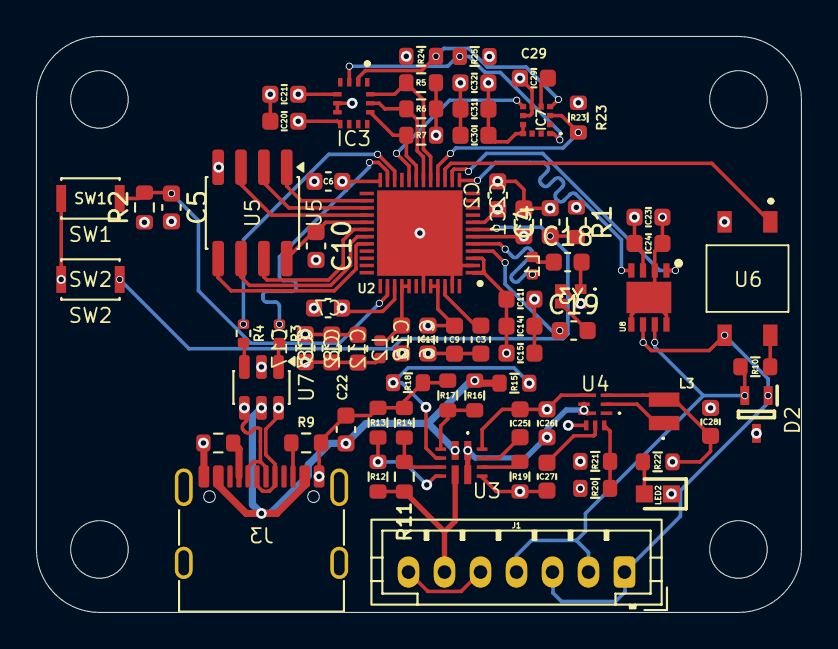
[picture p225: board IMU_V1.kicad_pcb from above]

Board: 4 copper layers, 42.5 x 32.0 mm, 80 parts (0 on the bottom side), 53 nets.
