sundevilmotorsports/pcb-dev/2027/SDM27_WheelBoard/SDM27_WheelBoard_v1.0/SDM27_WheelBoard_v1.0.kicad_pcb

## KiCad design 2027/SDM27_WheelBoard/SDM27_WheelBoard_v1.0/SDM27_WheelBoard_v1.0.kicad_pcb (2026-10-08)

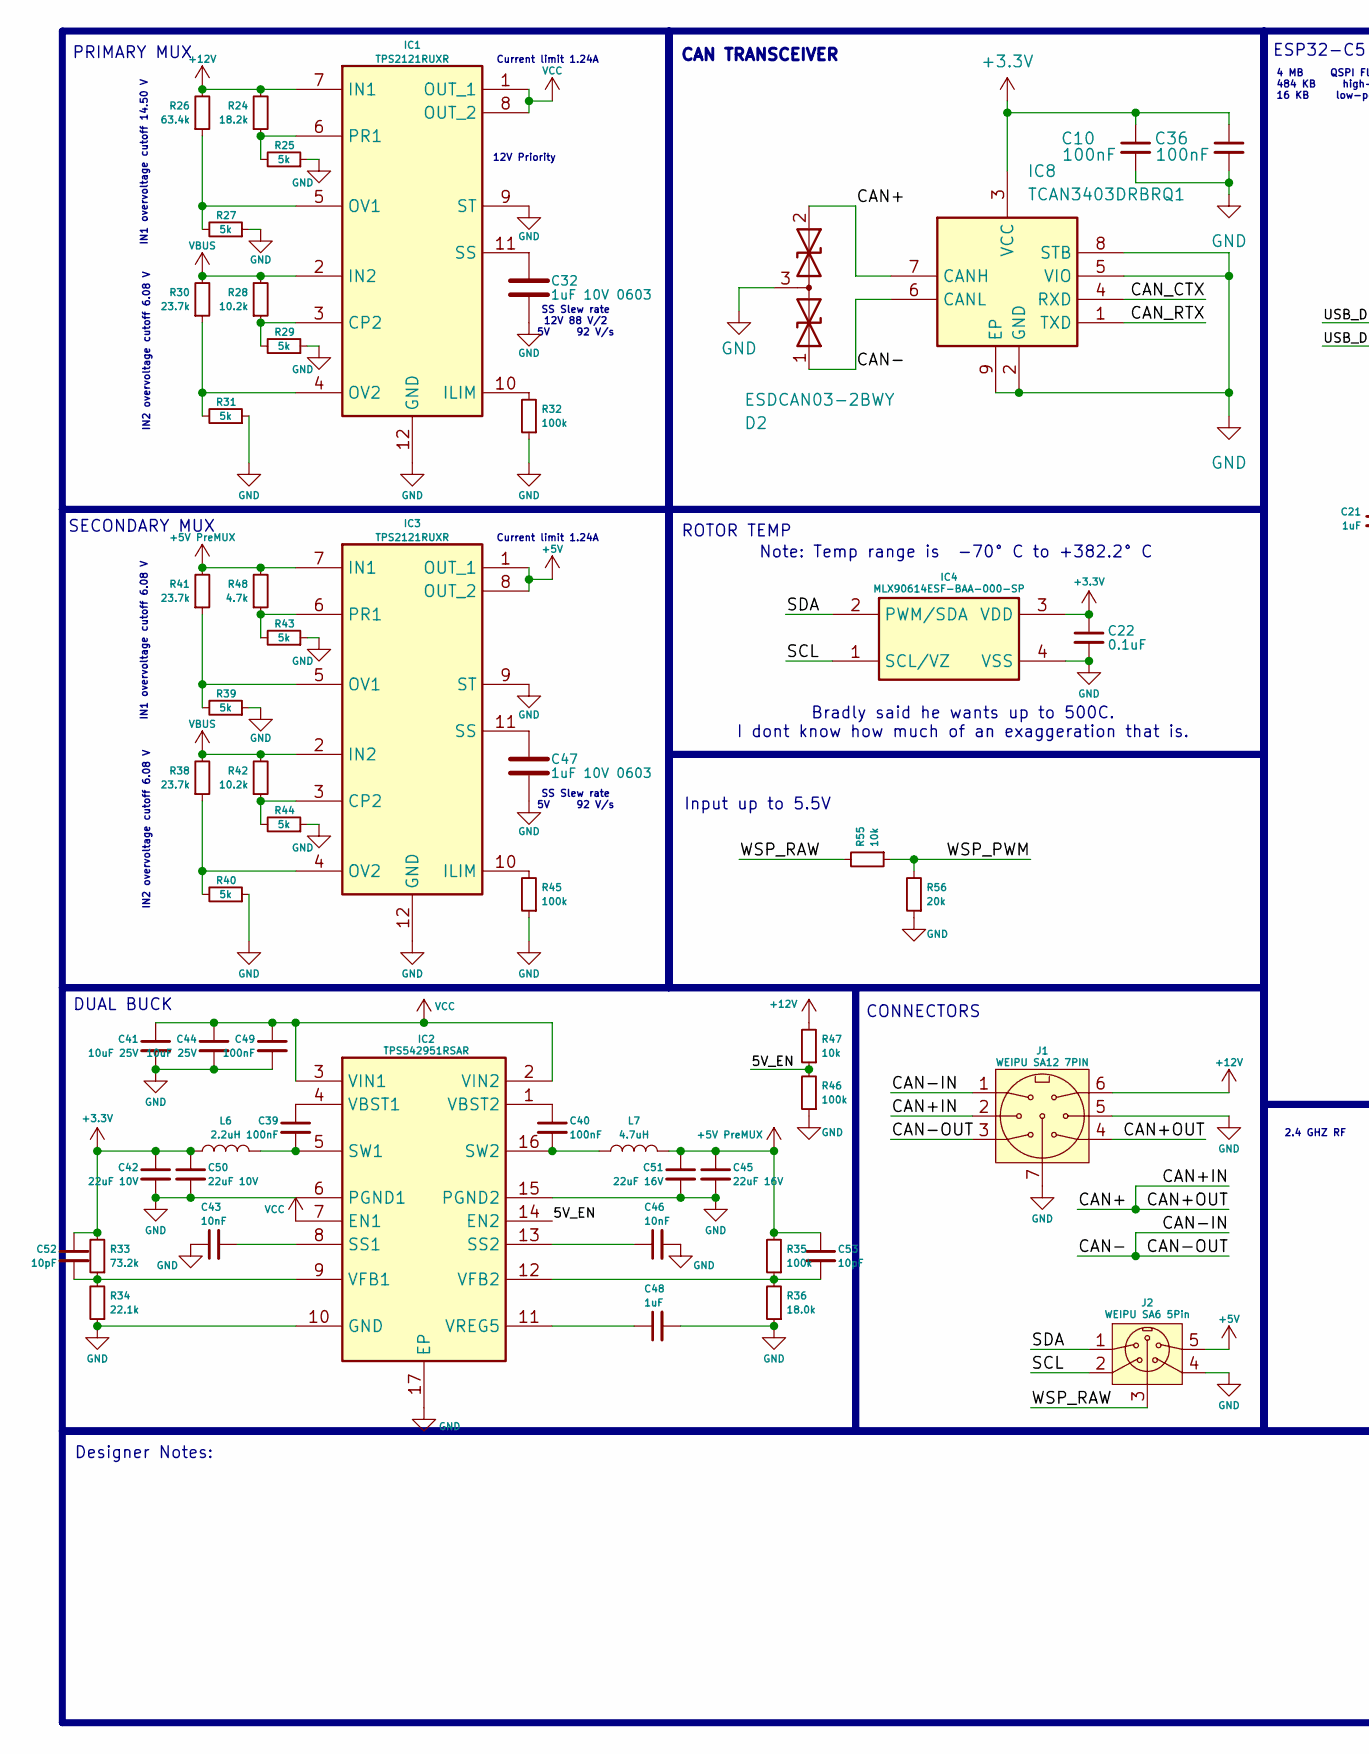
[picture p226: schematic SDM27_WheelBoard_v1.0.kicad_sch, SDM27 Wheel Board ESP32 C5HF4, part in row 1, column 1]

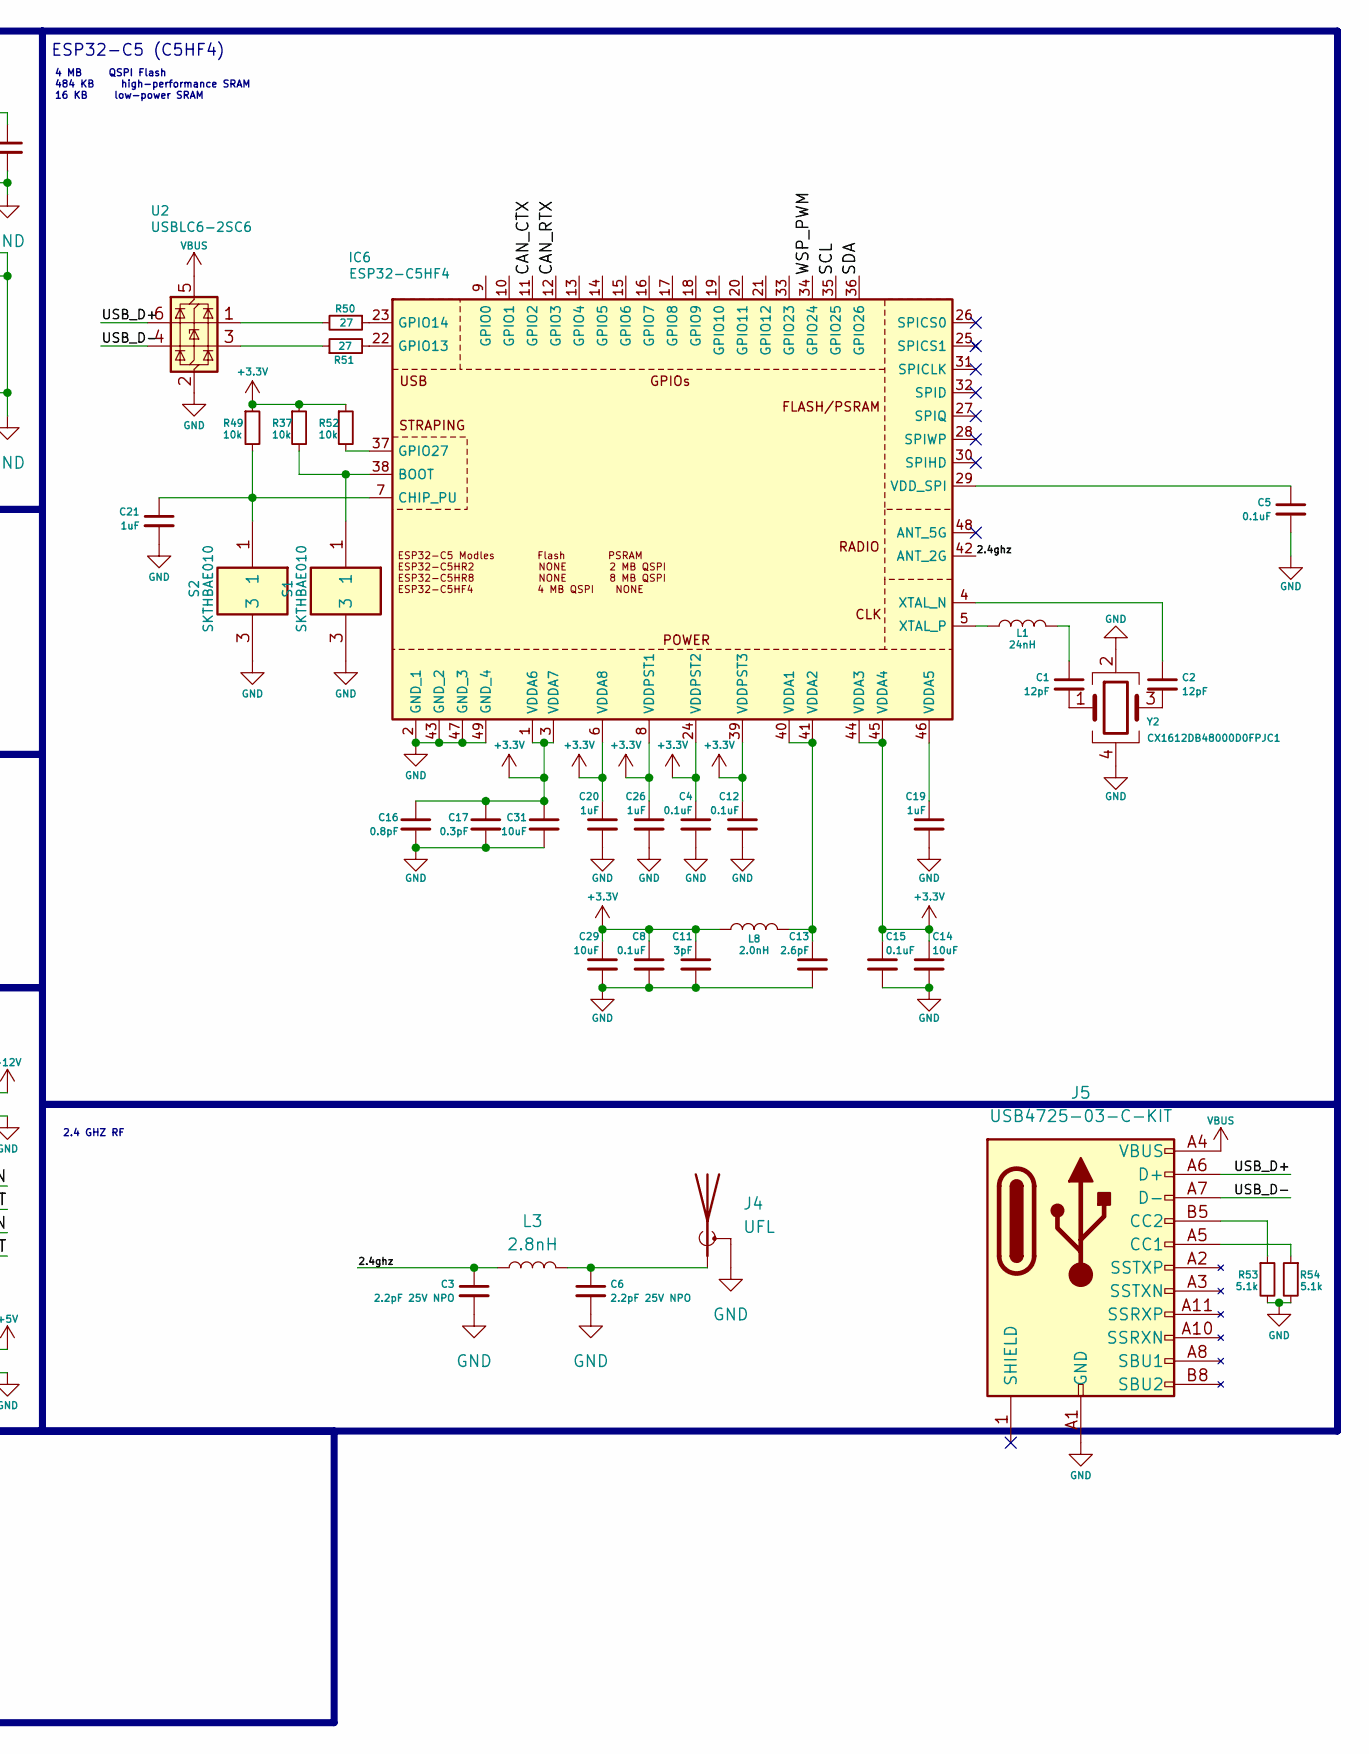
[picture p227: schematic SDM27_WheelBoard_v1.0.kicad_sch, SDM27 Wheel Board ESP32 C5HF4, part in row 1, column 2]

Parts:
C1, C2: 12pF; C_0201_0603Metric
C3, C6: 2.2pF 25V NPO; C_0402_1005Metric
C4, C5, C8, C12, C15, C22: 0.1uF; C_0402_1005Metric
C10, C36, C39, C40, C49: 100nF; C_0402_1005Metric
C11: 3pF; C_0402_1005Metric
C13: 2.6pF; C_0402_1005Metric
C14, C29, C31: 10uF; C_0402_1005Metric
C16: 0.8pF; C_0402_1005Metric
C17: 0.3pF; C_0402_1005Metric
C19, C20, C21, C26, C48: 1uF; C_0402_1005Metric
C32, C47: 1uF 10V 0603; C_0603_1608Metric
C41, C44: 10uF 25V; C_0805_2012Metric
C42, C50: 22uF 10V; C_0805_2012Metric
C43, C46: 10nF; C_0402_1005Metric
C45, C51: 22uF 16V; C_0805_2012Metric
C52, C53: 10pF; C_0402_1005Metric
D2: ESDCAN03-2BWY; SOT65P210X110-3N; Mouser Part Number 511-ESDCAN03-2BWY
IC1, IC3: TPS2121RUXR; Mouser Part Number 595-TPS2121RUXR
IC2: TPS542951RSAR; QFN65P400X400X100-17N-D; Mouser Part Number 595-TPS542951RSAR
IC4: MLX90614ESF-BAA-000-SP; MLX90614ESFBAA000SP; Mouser Part Number 482-90614ESFBAA000SP
IC6: ESP32-C5HF4; QFN40P600X600X90-49N-D; Manufacturer_Part_Number ESP32-C5HR8
IC8: TCAN3403DRBRQ1; SON65P300X300X100-9N-D; Manufacturer_Part_Number TCAN3403DRBRQ1; Mouser Part Number 595-TCAN3403DRBRQ1
J1: WEIPU SA12 7PIN; SA12 7Pin
J2: WEIPU SA6 5Pin; JST_SH_BM05B-SRSS-TB_1x05-1MP_P1.00mm_Vertical
J4: UFL; CONUFL001SMDT; Mouser Part Number N/A
J5: USB4725-03-C-KIT; GCT_USB4730-GF-A_REVA; Mouser Part Number 640-USB472503CKIT
L1: 24nH; L_0402_1005Metric
L3: 2.8nH; L_0402_1005Metric
L6: 2.2uH; L_1008_2520Metric
L7: 4.7uH; L_1210_3225Metric
L8: 2.0nH; L_0402_1005Metric
R24: 18.2k; R_0402_1005Metric
R25, R27, R29, R31, R39, R40, R43, R44: 5k; R_0402_1005Metric
R26: 63.4k; R_0402_1005Metric
R28, R42: 10.2k; R_0402_1005Metric
R30, R38, R41: 23.7k; R_0402_1005Metric
R32, R35, R45, R46: 100k; R_0402_1005Metric
R33: 73.2k; R_0402_1005Metric
R34: 22.1k; R_0402_1005Metric
R36: 18.0k; R_0402_1005Metric
R37, R47, R49, R52, R55: 10k; R_0402_1005Metric
R48: 4.7k; R_0402_1005Metric
R50, R51: 27; R_0402_1005Metric
R53, R54: 5.1k; R_0402_1005Metric
R56: 20k; R_0402_1005Metric
S1, S2: SKTHBAE010; Mouser Part Number 688-SKTHBAE010
U2: USBLC6-2SC6; SOT-23-6
Y2: CX1612DB48000D0FPJC1; Mouser Part Number 581-CX1612DB48D0FPJ

Connections:
+3.3V: C4.1, C8.1, C10.1, C11.1, C12.1, C14.1, C15.1, C16.1, C17.1, C20.1, C22.1, C26.1, C29.1, C31.1, C36.1, C42.1, C50.1, C52.1, IC4.3 (VDD), IC6.1 (VDDA6), IC6.3 (VDDA7), IC6.6 (VDDA8), IC6.8 (VDDPST1), IC6.24 (VDDPST2), IC6.39 (VDDPST3), IC6.44 (VDDA3), IC6.45 (VDDA4), IC8.3 (VCC), L6.2, L8.2, R33.2, R37.1, R49.1, R52.1
+5V: IC3.1 (OUT_1), IC3.8 (OUT_2), J2.5
+5V PreMUX: C45.1, C51.1, C53.1, IC3.7 (IN1), L7.1, R35.2, R41.2, R48.2
+12V: IC1.7 (IN1), J1.6, R24.2, R26.2, R47.2
/2.4ghz: C3.1, IC6.42 (ANT_2G), L3.2
/5V_EN: IC2.14 (EN2), R46.2, R47.1
/CAN+: D2.2, IC8.7 (CANH), J1.2, J1.4
/CAN-: D2.1, IC8.6 (CANL), J1.1, J1.3
/CAN_CTX: IC6.11 (GPIO2), IC8.4 (RXD)
/CAN_RTX: IC6.12 (GPIO3), IC8.1 (TXD)
/SCL: IC4.1 (SCL/VZ), IC6.35 (GPIO25), J2.2
/SDA: IC4.2 (PWM/SDA), IC6.36 (GPIO26), J2.1
/USB_D+: J5.A6 (D+), J5.B6 (D+), U2.6 (I/O1)
/USB_D-: J5.A7 (D-), J5.B7 (D-), U2.4 (I/O2)
/WSP_PWM: IC6.34 (GPIO24), R55.1, R56.2
/WSP_RAW: J2.3, R55.2
GND: C3.2, C4.2, C5.2, C6.2, C8.2, C10.2, C11.2, C12.2, C13.2, C14.2, C15.2, C16.2, C17.2, C19.2, C20.2, C21.2, C22.2, C26.2, C29.2, C31.2, C32.2, C36.2, C41.2, C42.2, C43.1, C44.2, C45.2, C46.2, C47.2, C48.2, C49.2, C50.2, C51.2, D2.3, IC1.9 (ST), IC1.12 (GND), IC2.6 (PGND1), IC2.10 (GND), IC2.15 (PGND2), IC2.17 (EP), IC3.9 (ST), IC3.12 (GND), IC4.4 (VSS), IC6.2 (GND_1), IC6.43 (GND_2), IC6.47 (GND_3), IC6.49 (GND_4), IC8.2 (GND), IC8.5 (VIO), IC8.8 (STB), IC8.9 (EP), J1.5, J1.7, J2.4, J4.2 (Shield), J4.3 (Shield), J5.A1 (GND), R25.1, R27.1, R29.1, R31.1, R32.1, R34.1, R36.1, R39.1, R40.1, R43.1, R44.1, R45.1, R46.1, R53.2, R54.2, R56.1, S1.3, S1.4, S2.3, S2.4, U2.2 (GND), Y2.2, Y2.4
unnamed: C1.1, L1.2
unnamed: C1.2, Y2.1
unnamed: C2.2, Y2.3
unnamed: IC1.3 (CP2), R28.1, R29.2
unnamed: IC1.10 (ILIM), R32.2
unnamed: IC1.5 (OV1), R26.1, R27.2
unnamed: IC1.4 (OV2), R30.1, R31.2
unnamed: IC1.6 (PR1), R24.1, R25.2
unnamed: C32.1, IC1.11 (SS)
unnamed: C43.2, IC2.8 (SS1)
unnamed: C46.1, IC2.13 (SS2)
unnamed: C39.2, IC2.5 (SW1), L6.1
unnamed: C40.2, IC2.16 (SW2), L7.2
unnamed: C39.1, IC2.4 (VBST1)
unnamed: C40.1, IC2.1 (VBST2)
unnamed: C52.2, IC2.9 (VFB1), R33.1, R34.2
unnamed: C53.2, IC2.12 (VFB2), R35.1, R36.2
unnamed: C48.1, IC2.11 (VREG5)
unnamed: IC3.3 (CP2), R42.1, R44.2
unnamed: IC3.10 (ILIM), R45.2
unnamed: IC3.5 (OV1), R39.2, R41.1
unnamed: IC3.4 (OV2), R38.1, R40.2
unnamed: IC3.6 (PR1), R43.2, R48.1
unnamed: C47.1, IC3.11 (SS)
unnamed: IC6.38 (BOOT), R37.2, S1.1, S1.2
unnamed: C21.1, IC6.7 (CHIP_PU), R49.2, S2.1, S2.2
unnamed: IC6.22 (GPIO13), R51.2
unnamed: IC6.23 (GPIO14), R50.1
unnamed: IC6.37 (GPIO27), R52.2
unnamed: C13.1, IC6.40 (VDDA1), IC6.41 (VDDA2), L8.1
unnamed: C19.1, IC6.46 (VDDA5)
unnamed: C5.1, IC6.29 (VDD_SPI)
unnamed: C2.1, IC6.4 (XTAL_N)
unnamed: IC6.5 (XTAL_P), L1.1
unnamed: C6.1, J4.1 (A), L3.1
unnamed: J5.A5 (CC1), R54.1
unnamed: J5.B5 (CC2), R53.1
unnamed: R50.2, U2.1 (I/O1)
unnamed: R51.1, U2.3 (I/O2)
VBUS: IC1.2 (IN2), IC3.2 (IN2), J5.A4 (VBUS), R28.2, R30.2, R38.2, R42.2, U2.5 (VBUS)
VCC: C41.1, C44.1, C49.1, IC1.1 (OUT_1), IC1.8 (OUT_2), IC2.2 (VIN2), IC2.3 (VIN1), IC2.7 (EN1)

Notes on the sheet:
Bradly said he wants up to 500C. I dont know how much of an exaggeration that is.
IN1 overvoltage cutoff 6.08 V
ROTOR TEMP
ESP32-C5 (C5HF4)
12V Priority
IN2 overvoltage cutoff 6.08 V
2.4 GHZ RF
IN1 overvoltage cutoff 14.50 V
4 MB QSPI Flash 484 KB high-performance SRAM 16 KB low-power SRAM
SECONDARY MUX
DUAL BUCK
SS Slew rate 5V 92 V/s
Input up to 5.5V
Current limit 1.24A
CONNECTORS
Note: Temp range is -70° C to +382.2° C
Designer Notes:
CAN TRANSCEIVER
SS Slew rate 12V 88 V/2 5V 92 V/s
PRIMARY MUX

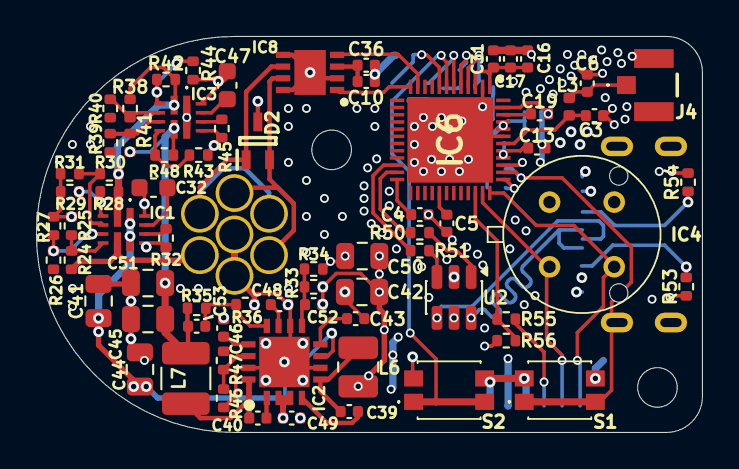
[picture p228: board SDM27_WheelBoard_v1.0.kicad_pcb from above]

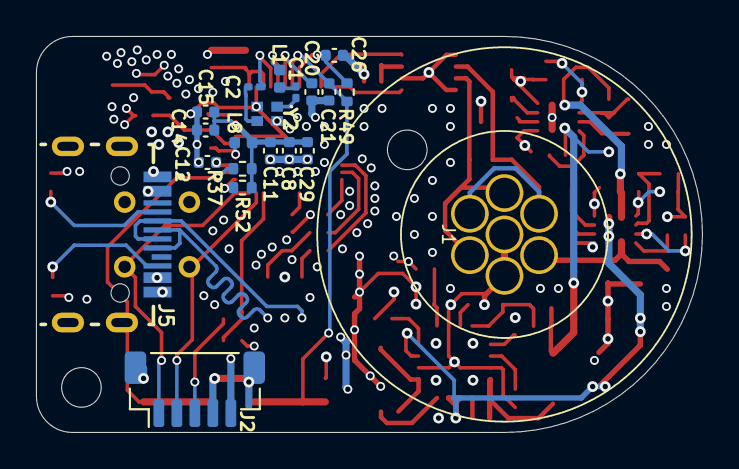
[picture p229: board SDM27_WheelBoard_v1.0.kicad_pcb from below]

Board: 4 copper layers, 37.0 x 22.0 mm, 91 parts (20 on the bottom side), 58 nets.
