sundevilmotorsports/pcb-dev/2027/StrainGaugeEval/StrainGaugeEval_V1/StrainGaugeEval_V1.kicad_pcb

## KiCad design 2027/StrainGaugeEval/StrainGaugeEval_V1/StrainGaugeEval_V1.kicad_pcb (2026-10-08)

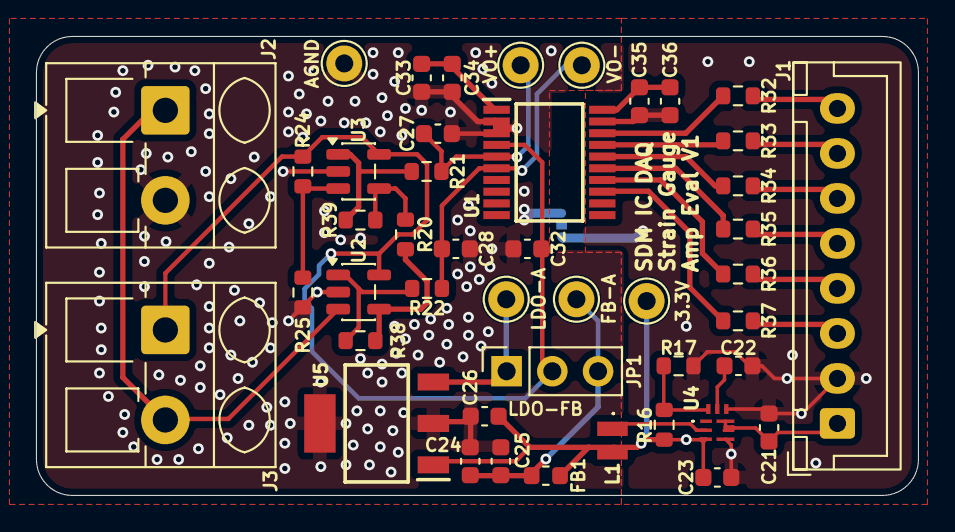
[picture p230: board StrainGaugeEval_V1.kicad_pcb from above]

Board: 2 copper layers, 49.0 x 25.5 mm, 46 parts (1 on the bottom side), 30 nets.

Parts:
3.3V: REG 3.3V; Pin_D1.0mm_L10.0mm
AGND: AGND; Pin_D1.0mm_L10.0mm
C21: 10uF 25V; C_0603_1608Metric
C22: 10nF; C_0603_1608Metric
C23: 22uF; C_0603_1608Metric
C24: 10uF; C_0603_1608Metric
C25, C27, C28, C32, C33, C34, C35, C36: 100nF; C_0603_1608Metric
C26: 1uF; C_0603_1608Metric
FB1: 60Ohm 1MHZ; L_0603_1608Metric
FB-A: Filter VA; Pin_D1.0mm_L10.0mm
J1: Conn_01x08_Pin; JST_XH_B8B-XH-A_1x08_P2.50mm_Vertical
J2, J3: Screw_Terminal_01x02; TerminalBlock_MetzConnect_Type205_RT04502UBLC_1x02_P5.00mm_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
JP1: A power; PinSocket_1x03_P2.54mm_Vertical
JP2: GND Bridge; SolderJumper-2_P1.3mm_Bridged_Pad1.0x1.5mm
L1: F1C1-201612-2R2M; F1C12016122R2M
LDO-A: LDO VA; Pin_D1.0mm_L10.0mm
R16: 113k; R_0603_1608Metric
R17: 24.9k; R_0603_1608Metric
R20: 2k; R_0603_1608Metric
R21, R22: 10k; R_0603_1608Metric
R24, R25: 350; R_0603_1608Metric
R32, R33, R34, R35, R36, R37: 10; R_0603_1608Metric
R38, R39: 100k; R_0603_1608Metric
U1: MCP3561R-E_ST; SOP65P640X120-20N
U2, U3: MCP6V91T; SOT-23-5
U4: TPS62901RPJR
U5: TC1108-3.0VDBTR; SOT230P700X180-4N
VO+: VO+; Pin_D1.0mm_L10.0mm
VO-: VO-; Pin_D1.0mm_L10.0mm

Connections:
+3.3V: 3.3V.1 (1_1), C23.1, C26.1, C35.1, C36.1, FB1.1, L1.2, R16.1, U1.20 (DVDD), U4.3 (VOS), U5.1 (VIN)
+3.3VA: C32.1, C33.1, C34.1, J3.1, JP1.2 (C), R24.2, U1.1 (AVDD), U1.4 (REFIN+/OUT), U2.5 (V+), U3.5 (V+)
/MAINCLK: J1.8, R32.1
/SGCOM: J2.1, J3.2, U2.3 (+)
/SPICLK: J1.4, R36.1
/SPICS1: J1.3, R37.1
/SPID: J1.5, R35.1
/SPIQ: J1.6, R34.1
/Vin+: R24.1, R25.2, U3.3 (+)
/Vout+: C27.1, R21.1, U1.5 (CH0), VO+.1 (1_1)
/Vout-: C28.1, R22.1, U1.6 (CH1), VO-.1 (1_1)
/nIRQ: J1.7, R33.1
AGND: AGND.1 (1_1), C24.2, C25.2, C26.2, C27.2, C28.2, C32.2, C33.2, C34.2, J2.2, JP2.1 (A), R25.1, U1.2 (AGND), U1.3 (REFIN-), U2.2 (V-), U3.2 (V-), U5.2 (GND), U5.4 (GND_2)
GND: C21.2, C22.2, C23.2, C35.2, C36.2, J1.2, JP2.2 (B), R17.2, U1.19 (DGND), U4.4 (GND), U4.7 (CONFIG)
unnamed: R32.2, U1.18 (MCLK)
unnamed: R36.2, U1.14 (SCK)
unnamed: R35.2, U1.15 (SDI)
unnamed: R34.2, U1.16 (SDO)
unnamed: R37.2, U1.13 (~CS)
unnamed: R33.2, U1.17 (~IRQ/MDAT)
unnamed: JP1.1 (A), LDO-A.1 (1_1), U5.3 (VOUT)
unnamed: C24.1, C25.1, FB1.2, FB-A.1 (1_1), JP1.3 (B)
unnamed: R21.2, R39.1, U3.1
unnamed: R22.2, R38.1, U2.1
unnamed: R20.1, R38.2, U2.4 (-)
unnamed: R20.2, R39.2, U3.4 (-)
unnamed: C22.1, U4.8 (SS/TR)
unnamed: L1.1, U4.2 (SW)
unnamed: R16.2, R17.1, U4.9 (VSET)
VIN: C21.1, J1.1, U4.5 (EN), U4.6 (VIN)
