sundevilmotorsports/pcb-dev/2027/SDM27_BSPD/SDM27_BSPD_V1.0/SDM27_BSPD_V1.0.kicad_pcb

## KiCad design 2027/SDM27_BSPD/SDM27_BSPD_V1.0/SDM27_BSPD_V1.0.kicad_pcb (2026-08-01)

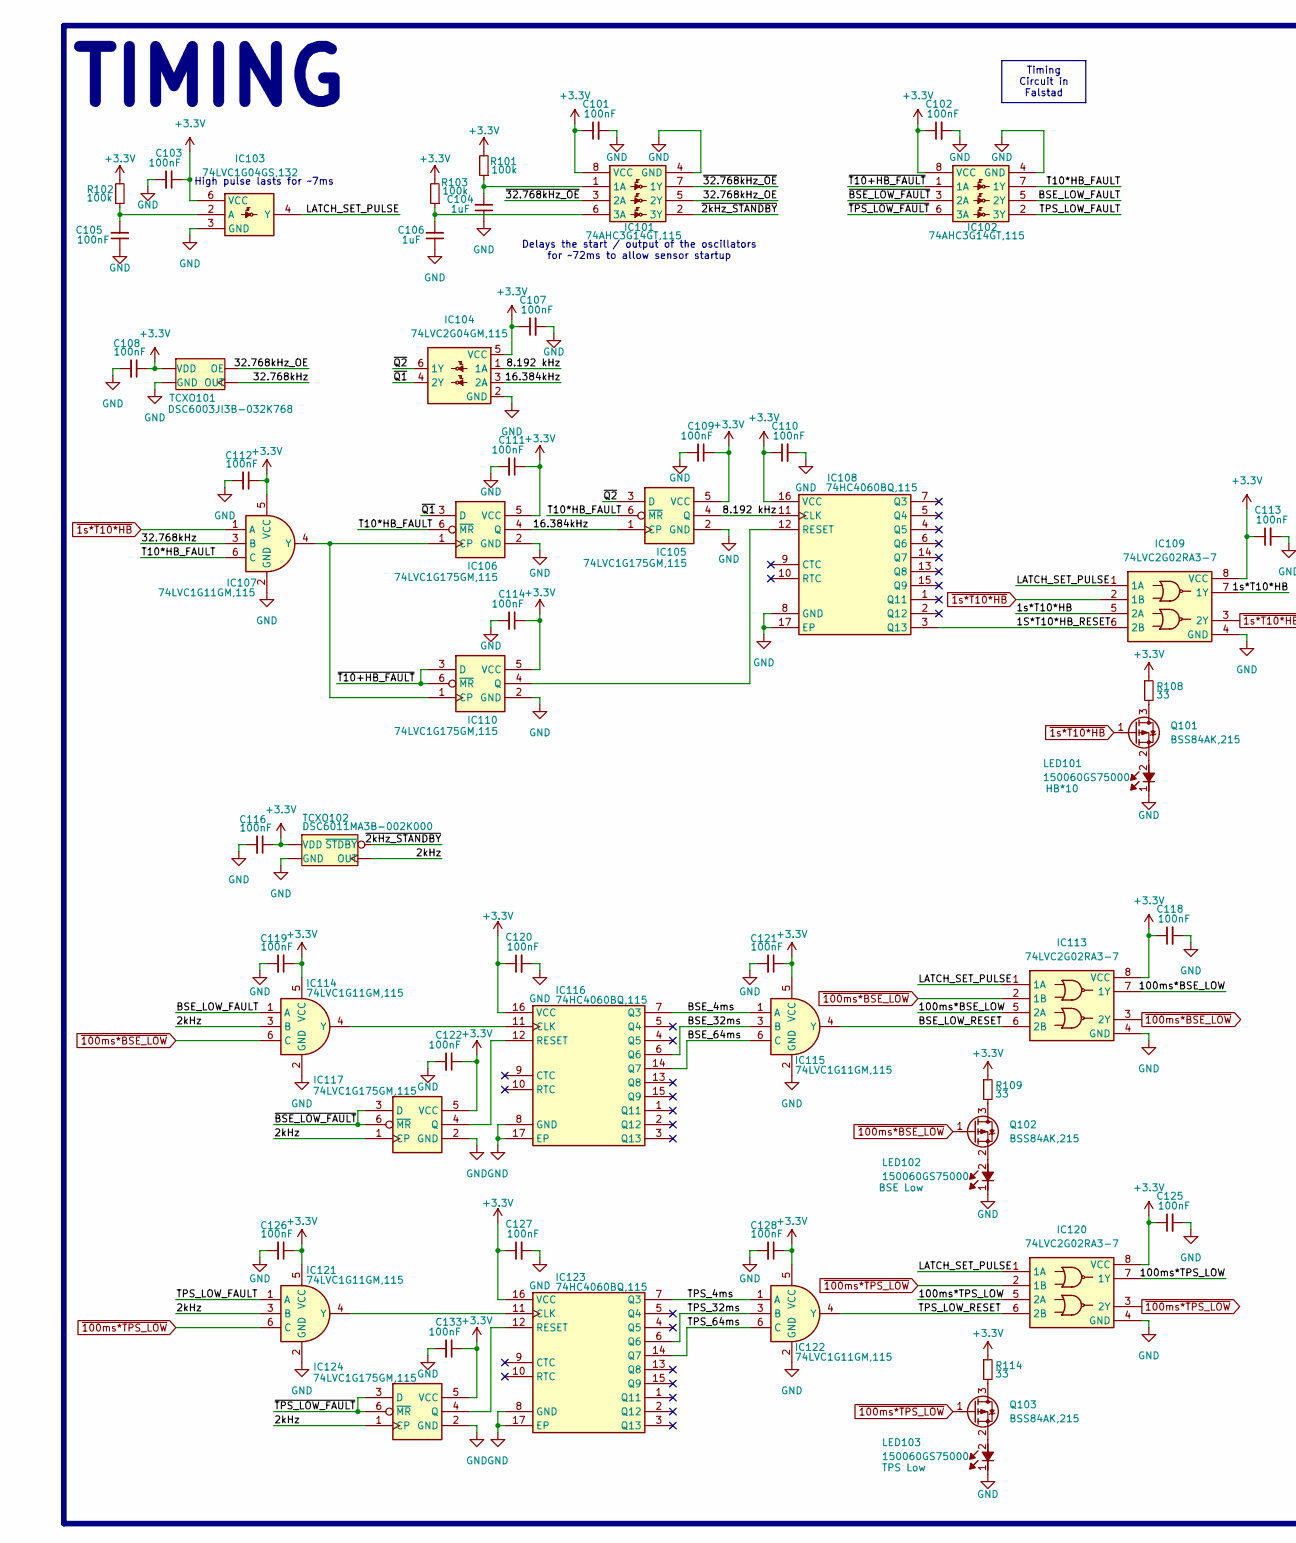
[picture p231: schematic SDM27_BSPD_V1.0.kicad_sch, part in row 1, column 1]

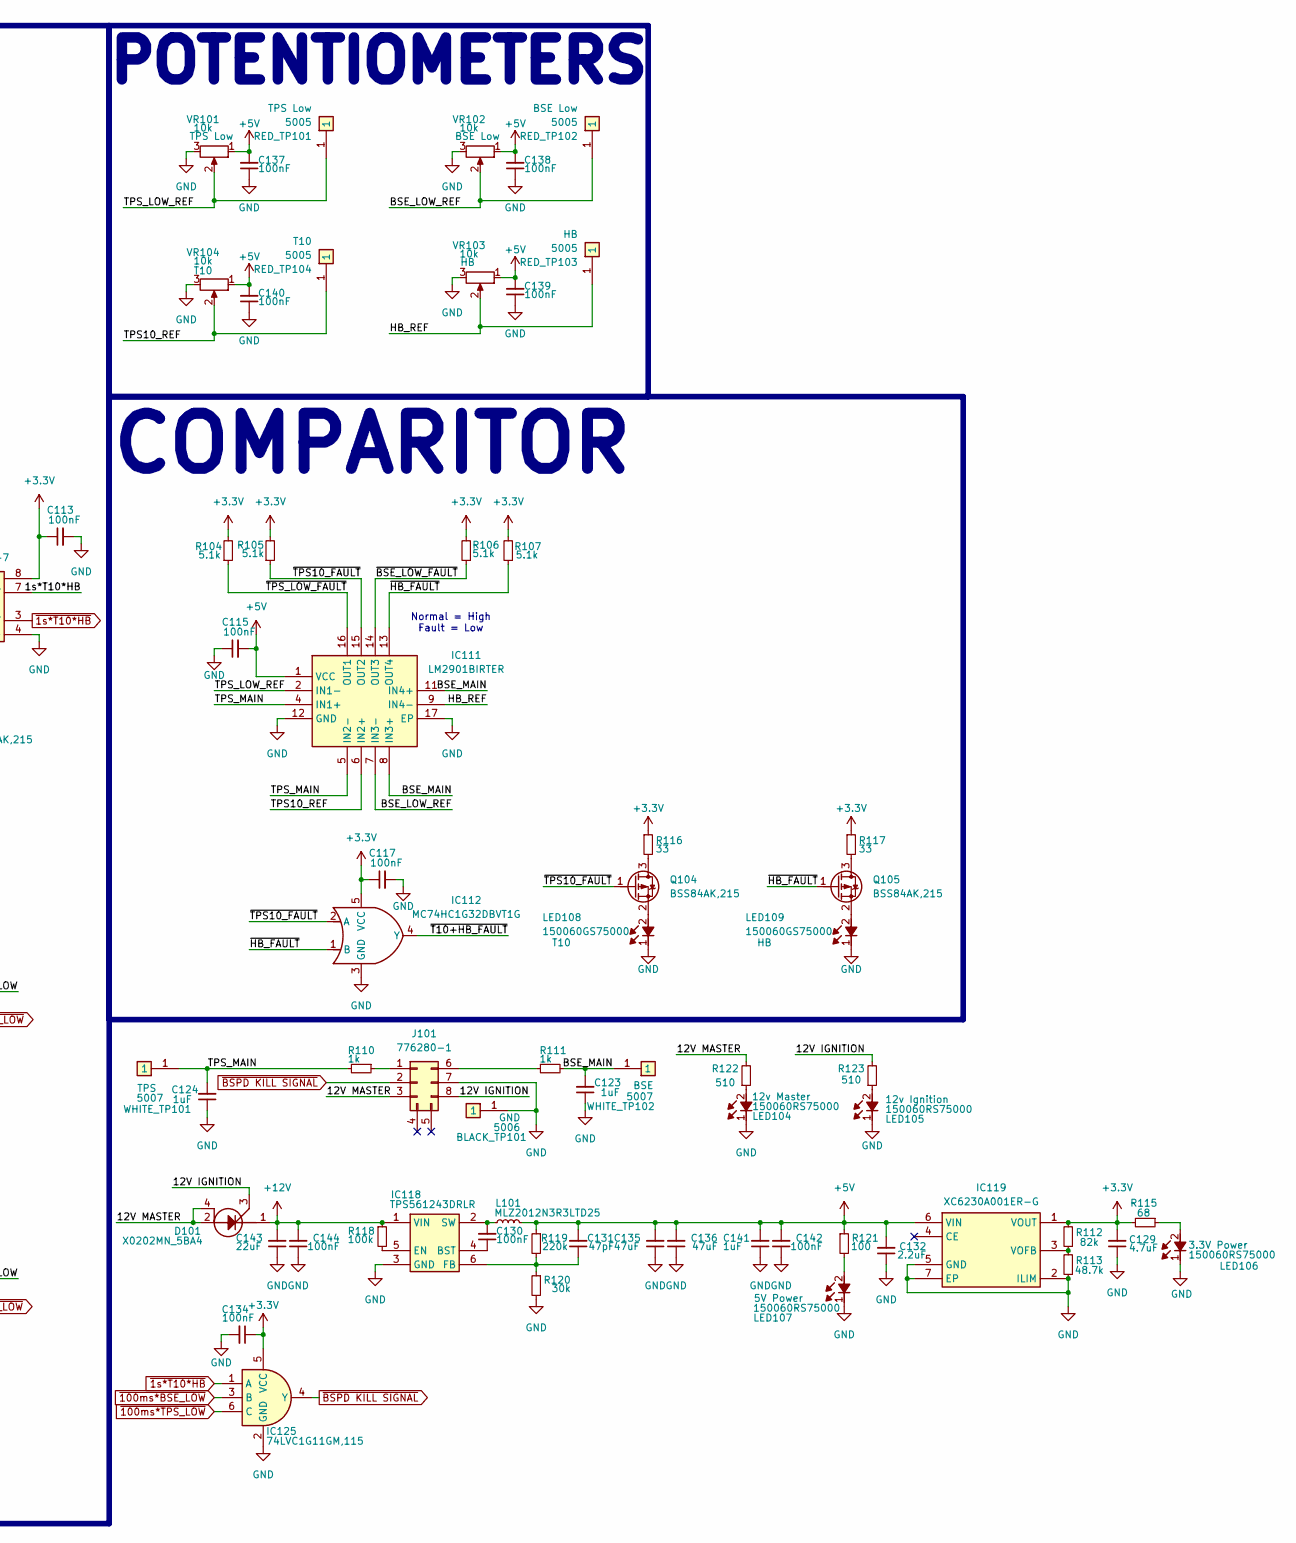
[picture p232: schematic SDM27_BSPD_V1.0.kicad_sch, part in row 1, column 2]

Parts:
BLACK_TP101: 5006; Mouser Part Number 534-5006
C101, C102, C103, C105, C107, C108, C109, C110, C111, C112, C113, C114, C115, C116, C117, C118, C119, C120, C121, C122, C125, C126, C127, C128, C130, C133, C134, C137, C138, C139, C140, C142, C144: 100nF; C_0603_1608Metric
C104, C106, C123, C124, C141: 1uF; C_0603_1608Metric
C129: 4.7uF; C_0603_1608Metric
C131: 47pF; C_0603_1608Metric
C132: 2.2uF; C_0603_1608Metric
C135, C136: 47uF; C_0805_2012Metric
C143: 22uF; C_0603_1608Metric
D101: X0202MN_5BA4; SOT230P700X190-4N; Mouser Part Number 511-X0202MN
IC101, IC102: 74AHC3G14GT,115; 74AVC9112GTX; Mouser Part Number 771-74AHC3G14GT115
IC103: 74LVC1G04GS,132; 74LVC1G3157GS132; Mouser Part Number 771-74LVC1G04GS132
IC104: 74LVC2G04GM,115; PESD3V3L5UF115; Mouser Part Number 771-LVC2G04GM115
IC105, IC106, IC110, IC117, IC124: 74LVC1G175GM,115; PESD3V3L5UF115; Mouser Part Number 771-LVC1G175GM115
IC107, IC114, IC115, IC121, IC122, IC125: 74LVC1G11GM,115; PESD3V3L5UF115; Mouser Part Number 771-LVC1G11GM115
IC108, IC116, IC123: 74HC4060BQ,115; 74HC4060BQ115; Mouser Part Number 771-74HC4060BQ,115
IC109, IC113, IC120: 74LVC2G02RA3-7; 74LVC2G02RA37; Mouser Part Number 621-74LVC2G02RA3-7
IC111: LM2901BIRTER; QFN50P300X300X80-17N-D; Mouser Part Number 595-LM2901BIRTER
IC112: MC74HC1G32DBVT1G; SOT95P275X110-5L; Mouser Part Number 863-MC74HC1G32DBVT1G
IC118: TPS561243DRLR; SOTFL50P160X60-6L; Mouser Part Number 595-TPS561243DRLR
IC119: XC6230A001ER-G; XD9264D75DERQ; Manufacturer_Part_Number XC6230A001ER-G
J101: 776280-1; Mouser Part Number 571-776280-1
L101: MLZ2012N3R3LTD25; INDC2012X105L; Mouser Part Number 810-MLZ2012N3R3LTD25
LED101, LED102, LED103, LED108, LED109: 150060GS75000; LEDC1608X80N; Mouser Part Number 710-150060GS75000
LED104, LED105, LED106, LED107: 150060RS75000; LEDC1608X80N; Mouser Part Number 710-150060RS75000
Q101, Q102, Q103, Q104, Q105: BSS84AK,215; SOT95P230X110-3L; Mouser Part Number 771-BSS84AK215
R101, R102, R103, R118: 100k; R_0603_1608Metric
R104, R105, R106, R107: 5.1k; R_0603_1608Metric
R108, R109, R114, R116, R117: 33; R_0603_1608Metric
R110, R111: 1k; R_0603_1608Metric
R112: 82k; R_0603_1608Metric
R113: 48.7k; R_0603_1608Metric
R115: 68; R_0603_1608Metric
R119: 220k; R_0603_1608Metric
R120: 30k; R_0603_1608Metric
R121: 100; R_0603_1608Metric
R122, R123: 510; R_0603_1608Metric
RED_TP101, RED_TP102, RED_TP103, RED_TP104: 5005; Mouser Part Number 534-5005
TCXO101: DSC6003JI3B-032K768; Mouser Part Number 579-D6003JI3B032K768
TCXO102: DSC6011MA3B-002K000; Mouser Part Number 579-C6011MA3B02K000
VR101, VR102, VR103, VR104: 10k; 3386P1103TLF; Mouser Part Number 652-3386P-1-103TLF
WHITE_TP101, WHITE_TP102: 5007; Mouser Part Number 534-5007

Connections:
+3.3V: C101.1, C102.1, C103.1, C107.1, C108.1, C109.1, C110.1, C111.1, C112.1, C113.1, C114.1, C116.1, C117.1, C118.1, C119.1, C120.1, C121.1, C122.1, C125.1, C126.1, C127.1, C128.1, C129.2, C133.1, C134.1, IC101.8 (VCC), IC102.8 (VCC), IC103.6 (VCC), IC104.5 (VCC), IC105.5 (VCC), IC106.5 (VCC), IC107.5 (VCC), IC108.16 (VCC), IC109.8 (VCC), IC110.5 (VCC), IC112.5 (VCC), IC113.8 (VCC), IC114.5 (VCC), IC115.5 (VCC), IC116.16 (VCC), IC117.5 (VCC), IC119.1 (VOUT), IC120.8 (VCC), IC121.5 (VCC), IC122.5 (VCC), IC123.16 (VCC), IC124.5 (VCC), IC125.5 (VCC), R101.2, R102.2, R103.2, R104.2, R105.2, R106.2, R107.2, R108.1, R109.1, R112.2, R114.1, R115.2, R116.1, R117.1, TCXO101.4 (VDD), TCXO102.4 (VDD)
+5V: C115.2, C131.2, C132.2, C135.2, C136.2, C137.2, C138.2, C139.2, C140.2, C141.2, C142.2, IC111.1 (VCC), IC119.6 (VIN), L101.2, R119.1, R121.1, VR101.1 (CCW), VR102.1 (CCW), VR103.1 (CCW), VR104.1 (CCW)
+12V: C143.2, C144.2, D101.1 (K), IC118.1 (VIN), R118.1
/1S*T10*HB_RESET: IC108.3 (Q13), IC109.6 (2B)
/1s*T10*HB: IC109.5 (2A), IC109.7 (1Y)
/2kHz: IC114.3 (B), IC117.1 (CP), IC121.3 (B), IC124.1 (CP), TCXO102.3 (OUT)
/8.192 kHz: IC104.1 (1A), IC105.4 (Q), IC108.11 (CLK)
/12V IGNITION: D101.3 (G), J101.8, R123.2
/12V MASTER: D101.2 (A_1), D101.4 (A_2), J101.3, R122.2
/16.384kHz: IC104.3 (2A), IC105.1 (CP), IC106.4 (Q)
/32.768kHz: IC107.3 (B), TCXO101.3 (OUT)
/32.768kHz_OE: IC101.5 (2Y), TCXO101.1 (OE)
/100ms*BSE_LOW: IC113.5 (2A), IC113.7 (1Y)
/100ms*TPS_LOW: IC120.5 (2A), IC120.7 (1Y)
/BSE_4ms: IC115.1 (A), IC116.7 (Q3)
/BSE_32ms: IC115.3 (B), IC116.6 (Q6)
/BSE_64ms: IC115.6 (C), IC116.14 (Q7)
/BSE_LOW_FAULT: IC102.5 (2Y), IC114.1 (A)
/BSE_LOW_REF: IC111.7 (IN3-), RED_TP102.1, VR102.2 (Wiper)
/BSE_LOW_RESET: IC113.6 (2B), IC115.4 (Y)
/BSE_MAIN: C123.2, IC111.8 (IN3+), IC111.11 (IN4+), R111.2, WHITE_TP102.1
/HB_REF: IC111.9 (IN4-), RED_TP103.1, VR103.2 (Wiper)
/LATCH_SET_PULSE: IC103.4 (Y), IC109.1 (1A), IC113.1 (1A), IC120.1 (1A)
/T10*HB_FAULT: IC102.7 (1Y), IC105.6 (~MR), IC106.6 (~MR), IC107.6 (C)
/TPS10_REF: IC111.6 (IN2+), RED_TP104.1, VR104.2 (Wiper)
/TPS_4ms: IC122.1 (A), IC123.7 (Q3)
/TPS_32ms: IC122.3 (B), IC123.6 (Q6)
/TPS_64ms: IC122.6 (C), IC123.14 (Q7)
/TPS_LOW_FAULT: IC102.2 (3Y), IC121.1 (A)
/TPS_LOW_REF: IC111.2 (IN1-), RED_TP101.1, VR101.2 (Wiper)
/TPS_LOW_RESET: IC120.6 (2B), IC122.4 (Y)
/TPS_MAIN: C124.2, IC111.4 (IN1+), IC111.5 (IN2-), R110.2, WHITE_TP101.1
/~2kHz_STANDBY: IC101.2 (3Y), TCXO102.1 (~STDBY)
/~32.768kHz_OE: IC101.3 (2A), IC101.7 (1Y)
/~BSE_LOW_FAULT: IC102.3 (2A), IC111.14 (OUT3), IC117.3 (D), IC117.6 (~MR), R106.1
/~HB_FAULT: IC111.13 (OUT4), IC112.1 (B), Q105.1 (G), R107.1
/~Q1: IC104.4 (2Y), IC106.3 (D)
/~Q2: IC104.6 (1Y), IC105.3 (D)
/~T10+HB_FAULT: IC102.1 (1A), IC110.3 (D), IC110.6 (~MR), IC112.4 (Y)
/~TPS10_FAULT: IC111.15 (OUT2), IC112.2 (A), Q104.1 (G), R105.1
/~TPS_LOW_FAULT: IC102.6 (3A), IC111.16 (OUT1), IC124.3 (D), IC124.6 (~MR), R104.1
GND: BLACK_TP101.1, C101.2, C102.2, C103.2, C104.1, C105.1, C106.1, C107.2, C108.2, C109.2, C110.2, C111.2, C112.2, C113.2, C114.2, C115.1, C116.2, C117.2, C118.2, C119.2, C120.2, C121.2, C122.2, C123.1, C124.1, C125.2, C126.2, C127.2, C128.2, C129.1, C132.1, C133.2, C134.2, C135.1, C136.1, C137.1, C138.1, C139.1, C140.1, C141.1, C142.1, C143.1, C144.1, IC101.4 (GND), IC102.4 (GND), IC103.3 (GND), IC104.2 (GND), IC105.2 (GND), IC106.2 (GND), IC107.2 (GND), IC108.8 (GND), IC108.17 (EP), IC109.4 (GND), IC110.2 (GND), IC111.12 (GND), IC111.17 (EP), IC112.3 (GND), IC113.4 (GND), IC114.2 (GND), IC115.2 (GND), IC116.8 (GND), IC116.17 (EP), IC117.2 (GND), IC118.3 (GND), IC119.2 (ILIM), IC119.5 (GND), IC119.7 (EP), IC120.4 (GND), IC121.2 (GND), IC122.2 (GND), IC123.8 (GND), IC123.17 (EP), IC124.2 (GND), IC125.2 (GND), J101.7, LED101.1 (K), LED102.1 (K), LED103.1 (K), LED104.1 (K), LED105.1 (K), LED106.1 (K), LED107.1 (K), LED108.1 (K), LED109.1 (K), R113.1, R120.2, TCXO101.2 (GND), TCXO102.2 (GND), VR101.3 (CW), VR102.3 (CW), VR103.3 (CW), VR104.3 (CW)
unnamed: C104.2, IC101.1 (1A), R101.1
unnamed: C106.2, IC101.6 (3A), R103.1
unnamed: C105.2, IC103.2 (A), R102.1
unnamed: IC106.1 (CP), IC107.4 (Y), IC110.1 (CP)
unnamed: IC108.12 (RESET), IC110.4 (Q)
unnamed: IC114.4 (Y), IC116.11 (CLK)
unnamed: IC116.12 (RESET), IC117.4 (Q)
unnamed: C130.1, IC118.4 (BST)
unnamed: IC118.5 (EN), R118.2
unnamed: C131.1, IC118.6 (FB), R119.2, R120.1
unnamed: C130.2, IC118.2 (SW), L101.1
unnamed: IC119.3 (VOFB), R112.1, R113.2
unnamed: IC121.4 (Y), IC123.11 (CLK)
unnamed: IC123.12 (RESET), IC124.4 (Q)
unnamed: J101.1, R110.1
unnamed: J101.6, R111.1
unnamed: LED101.2 (A), Q101.2 (S)
unnamed: LED102.2 (A), Q102.2 (S)
unnamed: LED103.2 (A), Q103.2 (S)
unnamed: LED104.2 (A), R122.1
unnamed: LED105.2 (A), R123.1
unnamed: LED106.2 (A), R115.1
unnamed: LED107.2 (A), R121.2
unnamed: LED108.2 (A), Q104.2 (S)
unnamed: LED109.2 (A), Q105.2 (S)
unnamed: Q101.3 (D), R108.2
unnamed: Q102.3 (D), R109.2
unnamed: Q103.3 (D), R114.2
unnamed: Q104.3 (D), R116.2
unnamed: Q105.3 (D), R117.2
~1s*T10*HB: IC107.1 (A), IC109.2 (1B), IC109.3 (2Y), IC125.1 (A), Q101.1 (G)
~100ms*BSE_LOW: IC113.2 (1B), IC113.3 (2Y), IC114.6 (C), IC125.3 (B), Q102.1 (G)
~100ms*TPS_LOW: IC120.2 (1B), IC120.3 (2Y), IC121.6 (C), IC125.6 (C), Q103.1 (G)
~BSPD KILL SIGNAL: IC125.4 (Y), J101.2

Notes on the sheet:
POTENTIOMETERS
High pulse lasts for ~7ms
Delays the start / output of the oscillators for ~72ms to allow sensor startup
COMPARITOR
TIMING
Normal = High Fault = Low
Timing Circuit in Falstad

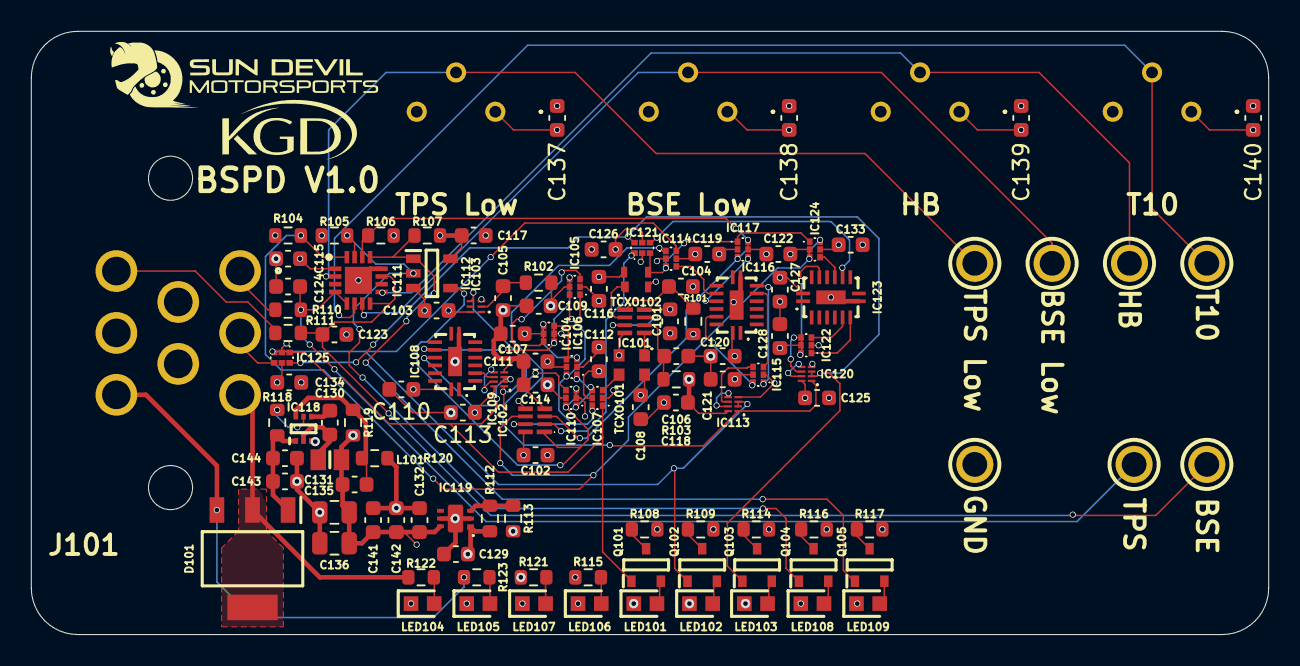
[picture p233: board SDM27_BSPD_V1.0.kicad_pcb from above]

Board: 4 copper layers, 80.0 x 39.0 mm, 122 parts (0 on the bottom side), 76 nets.
