sundevilmotorsports/pcb-dev/2027/SDM27_Shifter/ShifterBoard_V1/ShifterBoard_V1.kicad_pcb

## KiCad design 2027/SDM27_Shifter/ShifterBoard_V1/ShifterBoard_V1.kicad_pcb (2026-07-11)

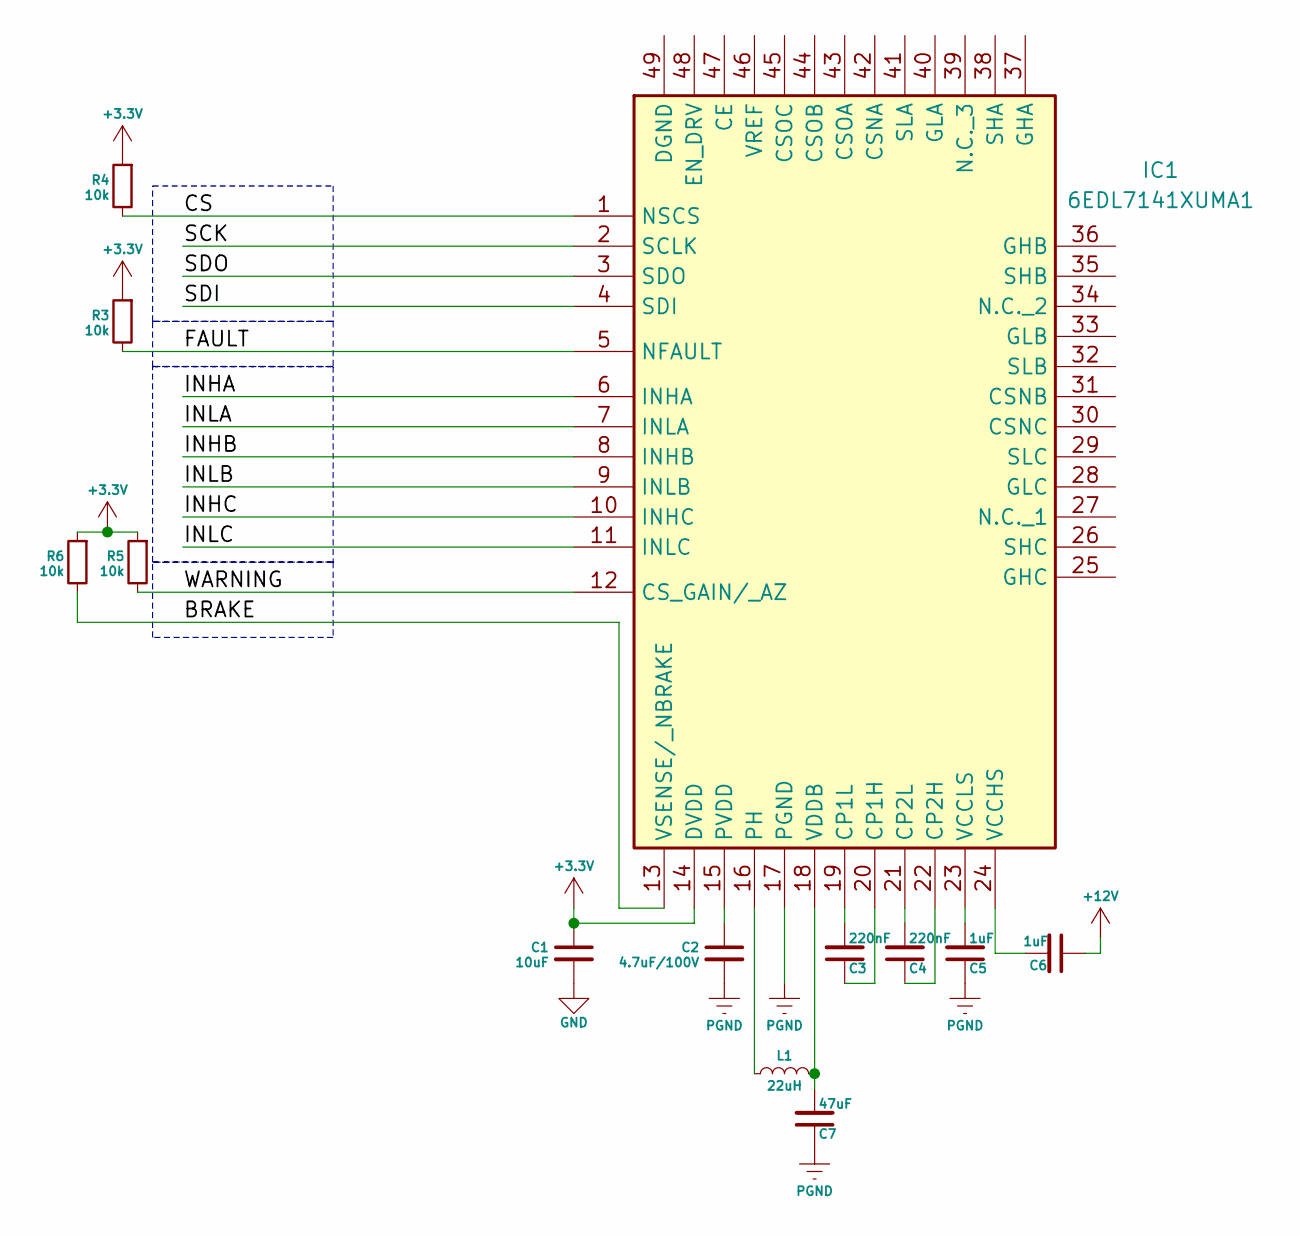
[picture p234: schematic ShifterBoard_V1.kicad_sch]

Parts:
C1: 10uF; C_0603_1608Metric
C2: 4.7uF/100V; C_0603_1608Metric
C3, C4: 220nF; C_0603_1608Metric
C5, C6: 1uF; C_0603_1608Metric
C7: 47uF; C_0603_1608Metric
IC1: 6EDL7141XUMA1; Mouser Part Number 726-6EDL7141XUMA1
L1: 22uH; L_1008_2520Metric
R3, R4, R5, R6: 10k; R_0603_1608Metric

Connections:
+3.3V: C1.1, IC1.14 (DVDD), R3.1, R4.1, R5.1, R6.1
+12V: C6.1
/BRAKE: IC1.13 (VSENSE/_NBRAKE), R6.2
/CS: IC1.1 (NSCS), R4.2
/FAULT: IC1.5 (NFAULT), R3.2
/INHA: IC1.6 (INHA)
/INHB: IC1.8 (INHB)
/INHC: IC1.10 (INHC)
/INLA: IC1.7 (INLA)
/INLB: IC1.9 (INLB)
/INLC: IC1.11 (INLC)
/SCK: IC1.2 (SCLK)
/SDI: IC1.4 (SDI)
/SDO: IC1.3 (SDO)
/WARNING: IC1.12 (CS_GAIN/_AZ), R5.2
GND: C1.2
unnamed: C3.1, IC1.20 (CP1H)
unnamed: C3.2, IC1.19 (CP1L)
unnamed: C4.1, IC1.22 (CP2H)
unnamed: C4.2, IC1.21 (CP2L)
unnamed: IC1.16 (PH), L1.1
unnamed: C2.1, IC1.15 (PVDD)
unnamed: C6.2, IC1.24 (VCCHS)
unnamed: C5.2, IC1.23 (VCCLS)
unnamed: C7.2, IC1.18 (VDDB), L1.2
PGND: C2.2, C5.1, C7.1, IC1.17 (PGND)

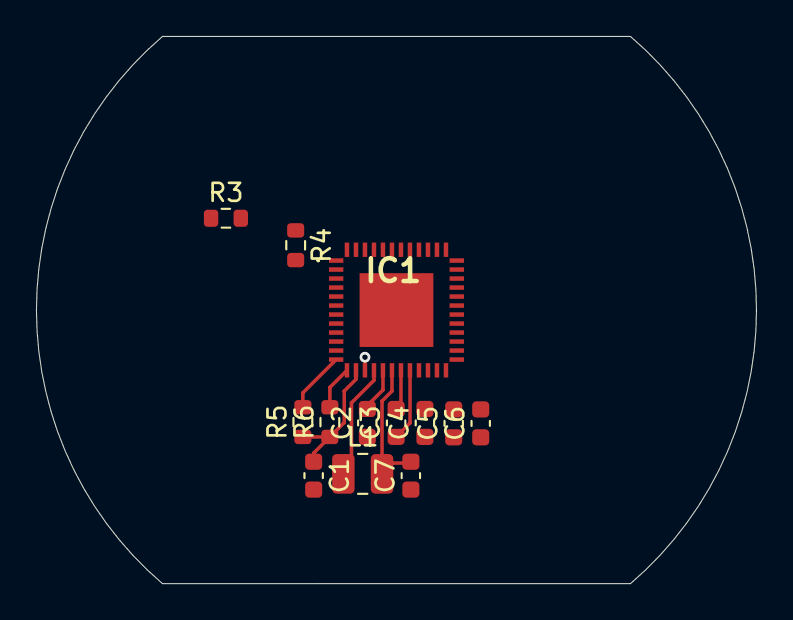
[picture p235: board ShifterBoard_V1.kicad_pcb from above]

Board: 2 copper layers, 40.0 x 30.4 mm, 13 parts (0 on the bottom side), 15 nets.
