sundevilmotorsports/pcb-dev/2027/SDM27_SlipAngle/SensorMountV2/SensorMountV2.kicad_pcb

## KiCad design 2027/SDM27_SlipAngle/SensorMountV2/SensorMountV2.kicad_pcb (2026-07-10)

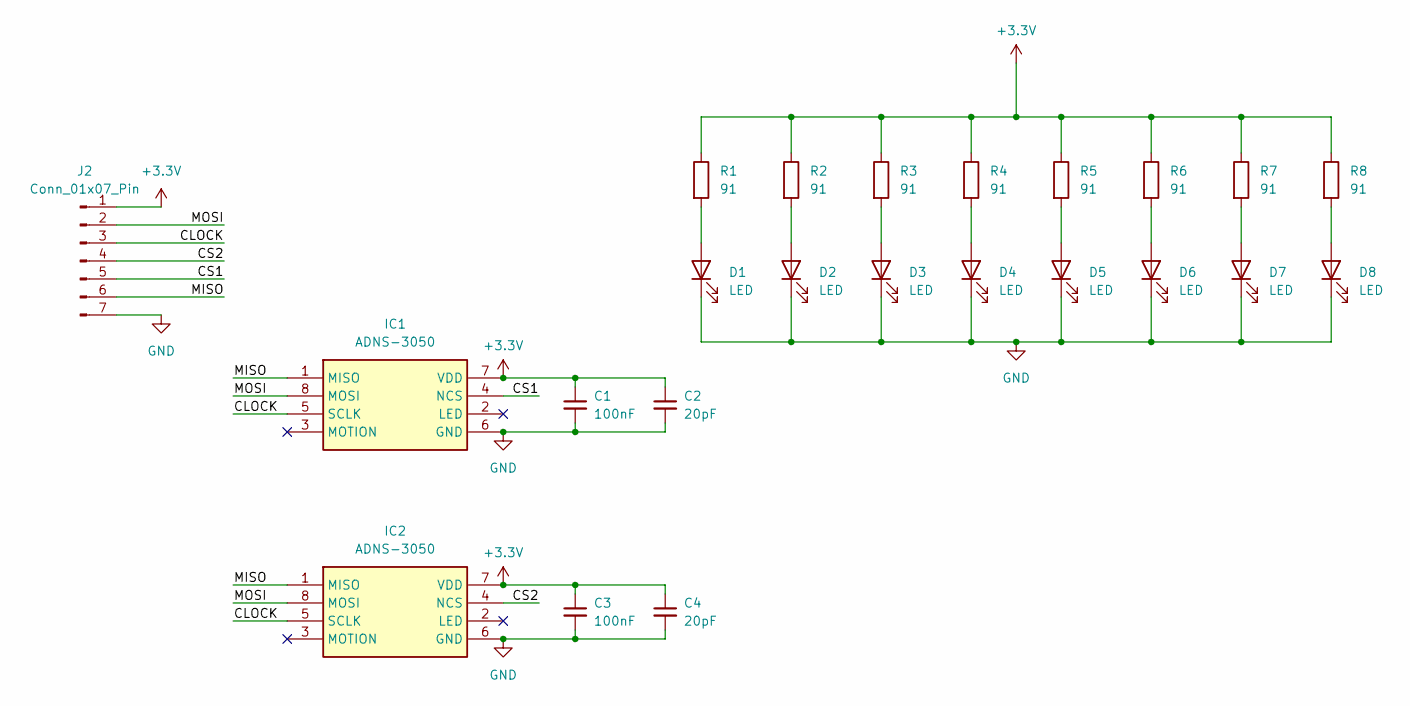
[picture p236: schematic SensorMountV2.kicad_sch]

Parts:
C1, C3: 100nF; C_0603_1608Metric
C2, C4: 20pF; C_0603_1608Metric
D1, D2, D3, D4, D5, D6, D7, D8: LED; LED_D5.0mm_Clear
IC1, IC2: ADNS-3050; ADNS3050; Mouser Part Number 630-ADNS-3050
J2: Conn_01x07_Pin; PinHeader_1x07_P2.54mm_Vertical
R1, R2, R3, R4, R5, R6, R7, R8: 91; R_Axial_DIN0204_L3.6mm_D1.6mm_P5.08mm_Horizontal

Connections:
+3.3V: C1.1, C2.1, C3.1, C4.1, IC1.7 (VDD), IC2.7 (VDD), J2.1, R1.1, R2.1, R3.1, R4.1, R5.1, R6.1, R7.1, R8.1
/CLOCK: IC1.5 (SCLK), IC2.5 (SCLK), J2.3
/CS1: IC1.4 (NCS), J2.5
/CS2: IC2.4 (NCS), J2.4
/MISO: IC1.1 (MISO), IC2.1 (MISO), J2.6
/MOSI: IC1.8 (MOSI), IC2.8 (MOSI), J2.2
GND: C1.2, C2.2, C3.2, C4.2, D1.1 (K), D2.1 (K), D3.1 (K), D4.1 (K), D5.1 (K), D6.1 (K), D7.1 (K), D8.1 (K), IC1.6 (GND), IC2.6 (GND), J2.7 (Pin_6)
unnamed: D1.2 (A), R1.2
unnamed: D2.2 (A), R2.2
unnamed: D3.2 (A), R3.2
unnamed: D4.2 (A), R4.2
unnamed: D5.2 (A), R5.2
unnamed: D6.2 (A), R6.2
unnamed: D7.2 (A), R7.2
unnamed: D8.2 (A), R8.2

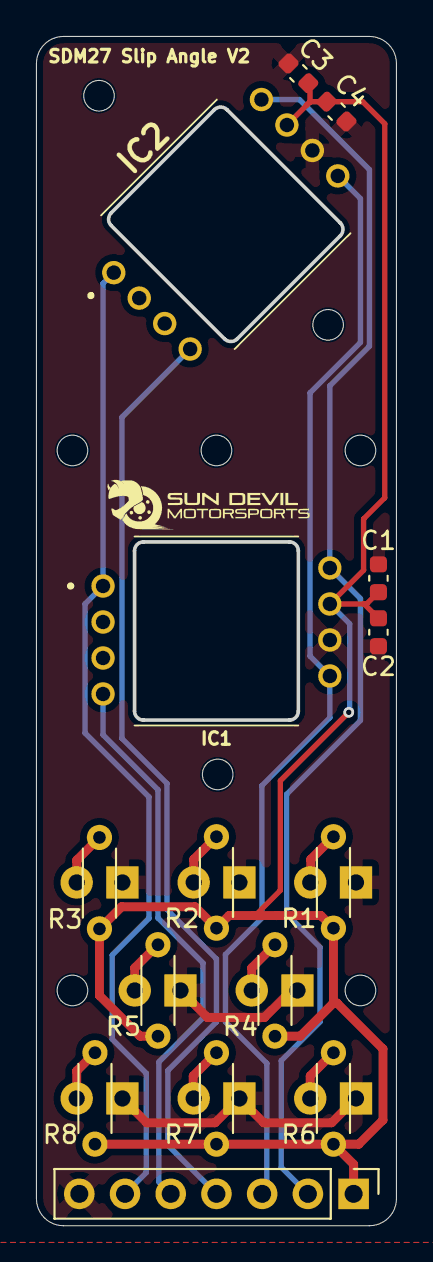
[picture p237: board SensorMountV2.kicad_pcb from above]

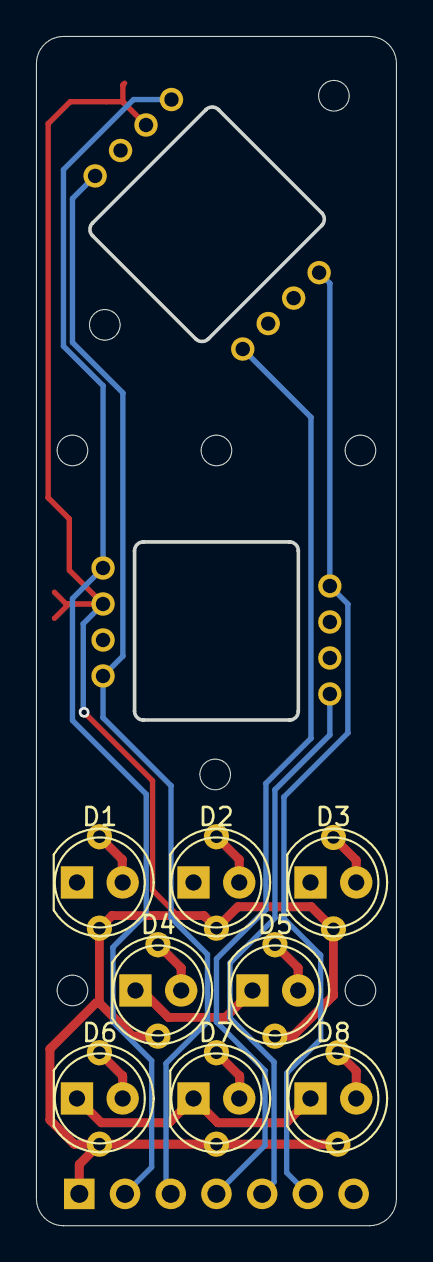
[picture p238: board SensorMountV2.kicad_pcb from below]

Board: 2 copper layers, 20.0 x 66.1 mm, 23 parts (8 on the bottom side), 15 nets.
