sundevilmotorsports/pcb-dev/2027/SDM27_CoolingSystem/Cooling_System_Sensor_Board_V1/Cooling_System_Sensor_Board_V1.kicad_pcb

## KiCad design 2027/SDM27_CoolingSystem/Cooling_System_Sensor_Board_V1/Cooling_System_Sensor_Board_V1.kicad_pcb (2026-07-10)

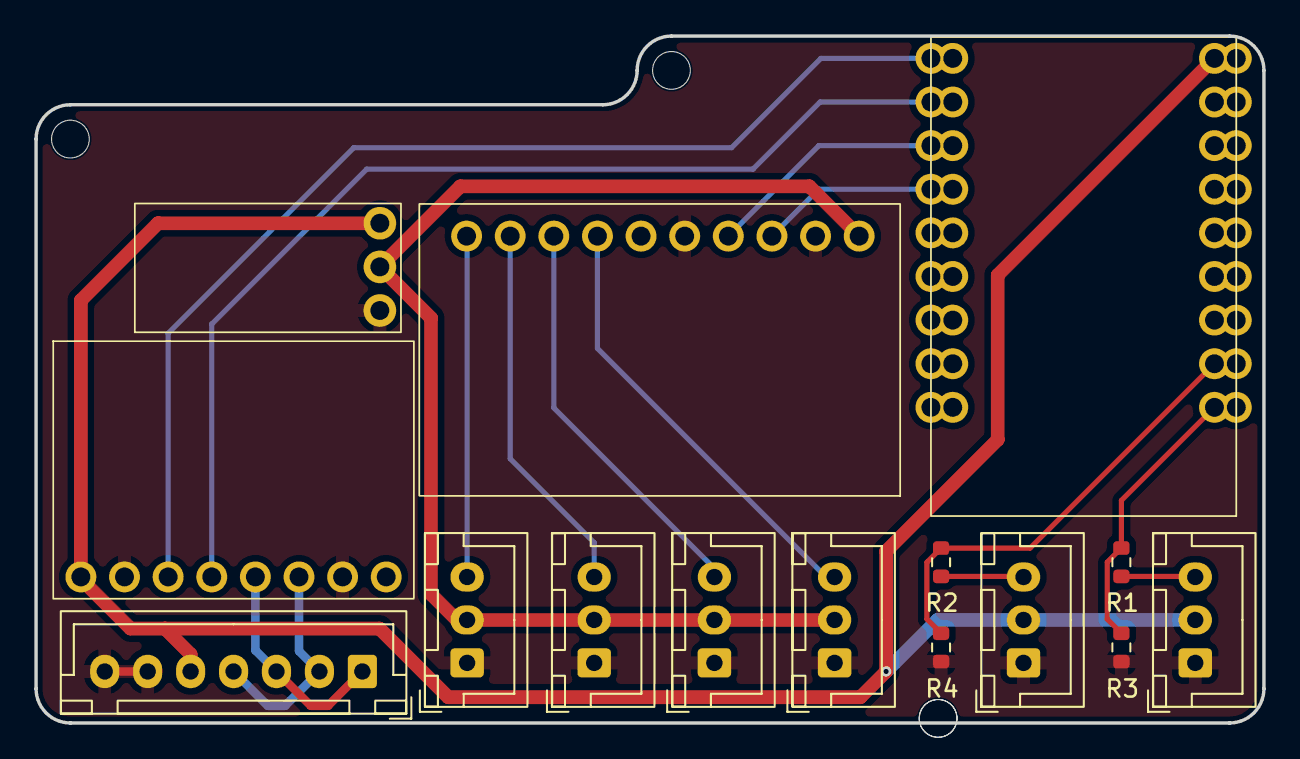
[picture p239: board Cooling_System_Sensor_Board_V1.kicad_pcb from above]

Board: 2 copper layers, 71.5 x 40.0 mm, 15 parts (0 on the bottom side), 17 nets.

Parts:
J1: JST_XH_B7B-XH-A_1x07_P2.50mm_Vertical
J2: A1; JST_XH_B3B-XH-A_1x03_P2.50mm_Vertical
J3: A2; JST_XH_B3B-XH-A_1x03_P2.50mm_Vertical
J4: A3; JST_XH_B3B-XH-A_1x03_P2.50mm_Vertical
J5: A4; JST_XH_B3B-XH-A_1x03_P2.50mm_Vertical
J6: FLOW1; JST_XH_B3B-XH-A_1x03_P2.50mm_Vertical
J7: FLOW2; JST_XH_B3B-XH-A_1x03_P2.50mm_Vertical
M1: ESP32 C5 Mini
M2: TJA10423 CAD
M3: ADS1115ADC
M4: 3.3v LDO
R1, R2: 10K; R_0603_1608Metric
R3, R4: 20k; R_0603_1608Metric

Connections:
+3.3VA: J2.2, J3.2, J4.2, J5.2, M3.1 (VDD), M4.2 (3.3V)
+5V: J1.5, J6.2, J7.2, M1.9 (5V), M2.1 (VCC), M4.3 (VIN)
/Analog1: J2.3, M3.7 (A0)
/Analog2: J3.3, M3.8 (A1)
/Analog3: J4.3, M3.9 (A2)
/Analog4: J5.3, M3.10 (A3)
/CAN+: J1.1, J1.3, M2.5 (CANH)
/CAN-: J1.2, J1.4, M2.6 (CANL)
/CRX: M1.17 (IO6), M2.4 (CRX)
/CTX: M1.18 (IO5), M2.3 (CTX)
/FLOW1: J6.3, R2.1
/FLOW1lv: M1.2 (IO1), R2.2, R4.2
/FLOW2: J7.3, R1.1
/FLOW2lv: M1.1 (IO0), R1.2, R3.2
/SCL: M1.15 (IO8), M3.3 (SCL)
/SDA: M1.16 (IO7), M3.4 (SDA)
GND: J1.6, J1.7, J2.1, J3.1, J4.1, J5.1, J6.1, J7.1, M1.8 (GND), M2.2 (GND), M2.7 (S), M3.2 (GND), M3.5 (ADDR), M4.1 (GND), R3.1, R4.1
