sundevilmotorsports/pcb-dev/2026/Dash/Dash.kicad_pcb

## KiCad design 2026/Dash/Dash.kicad_pcb (2026-04-04)

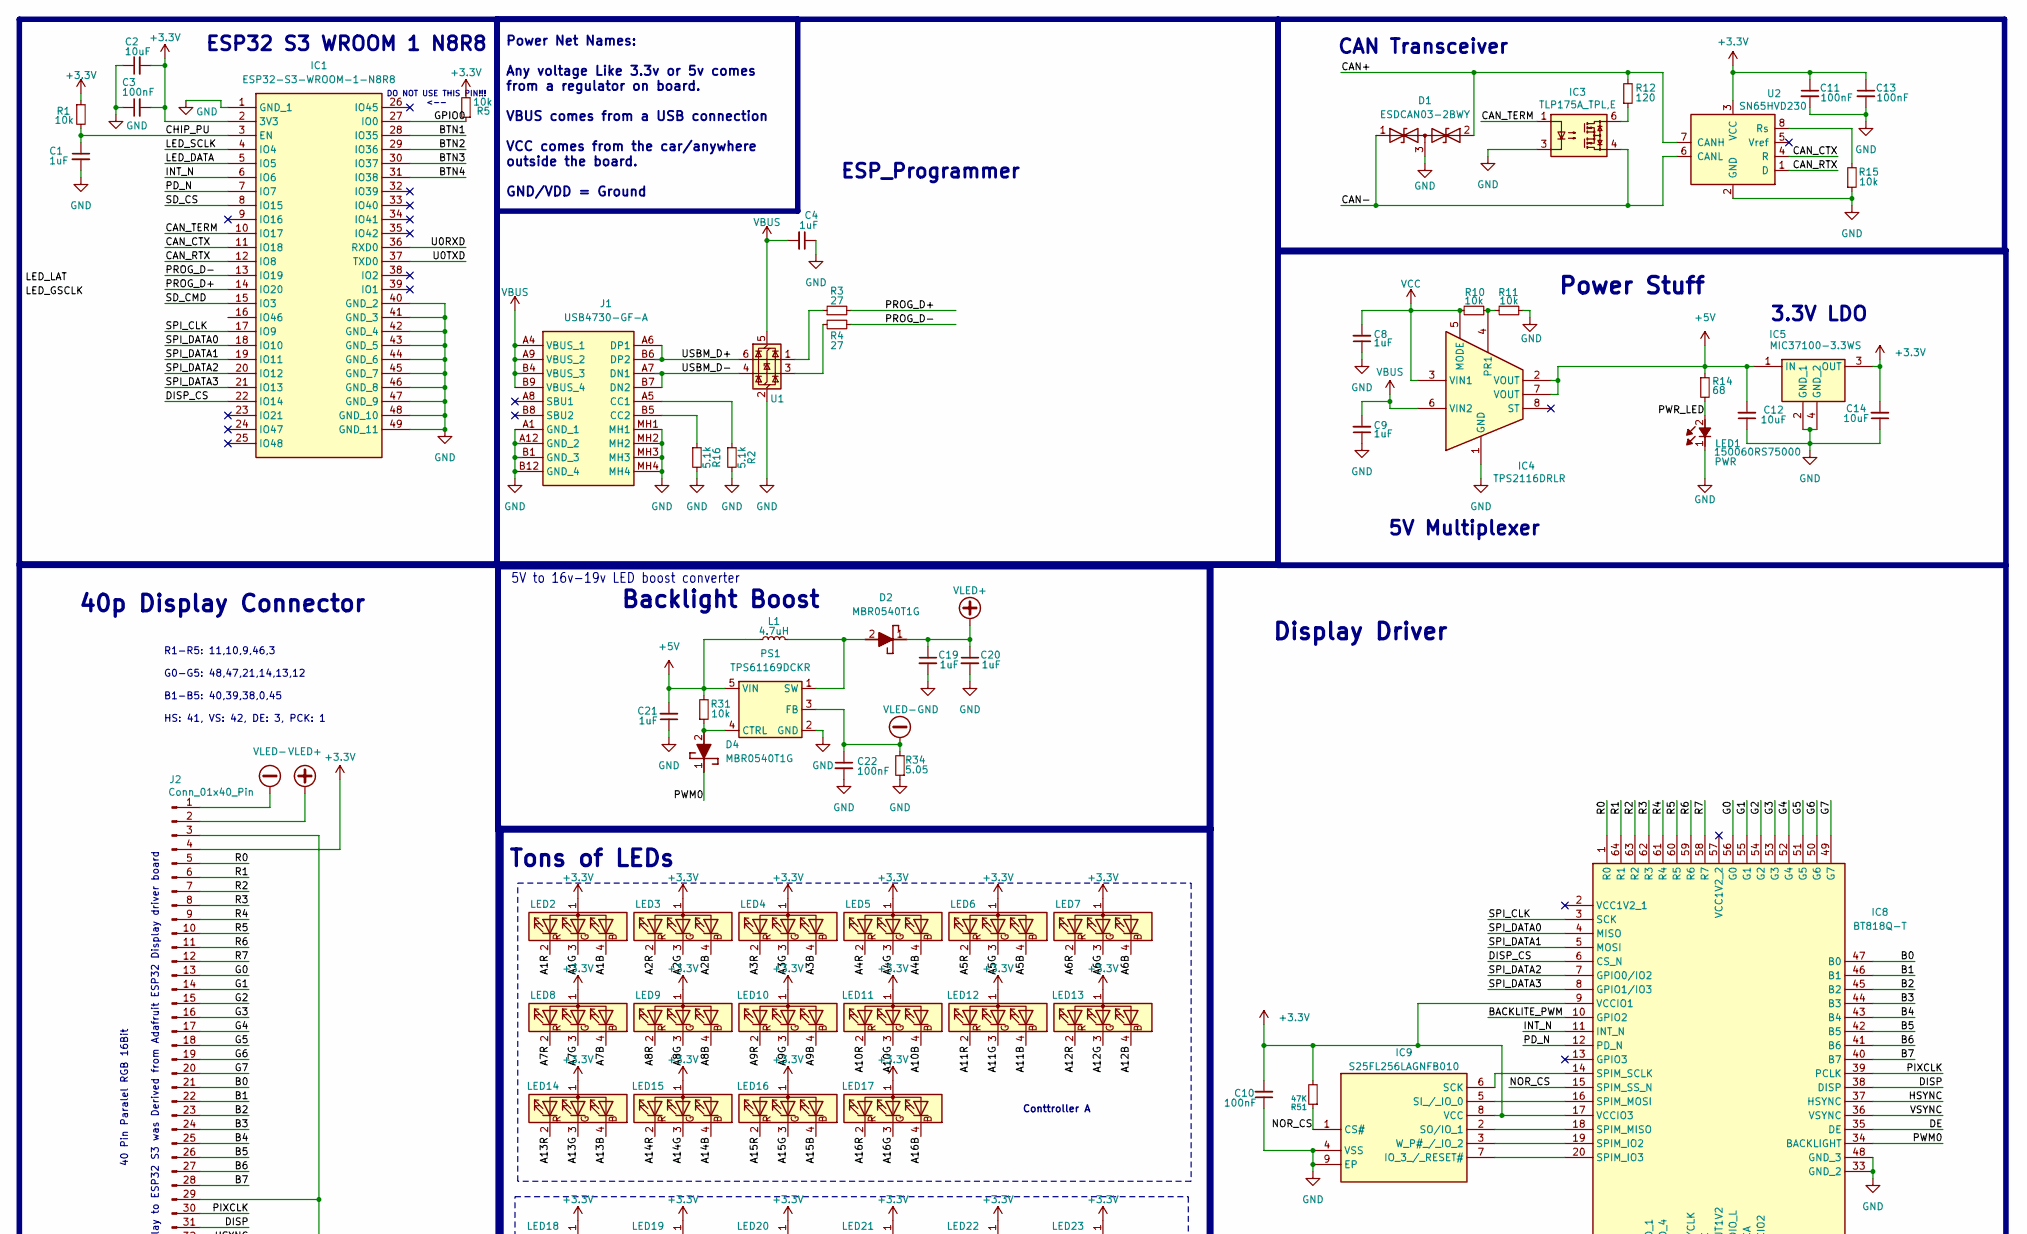
[picture p240: schematic Dash.kicad_sch, part in row 1, column 1]

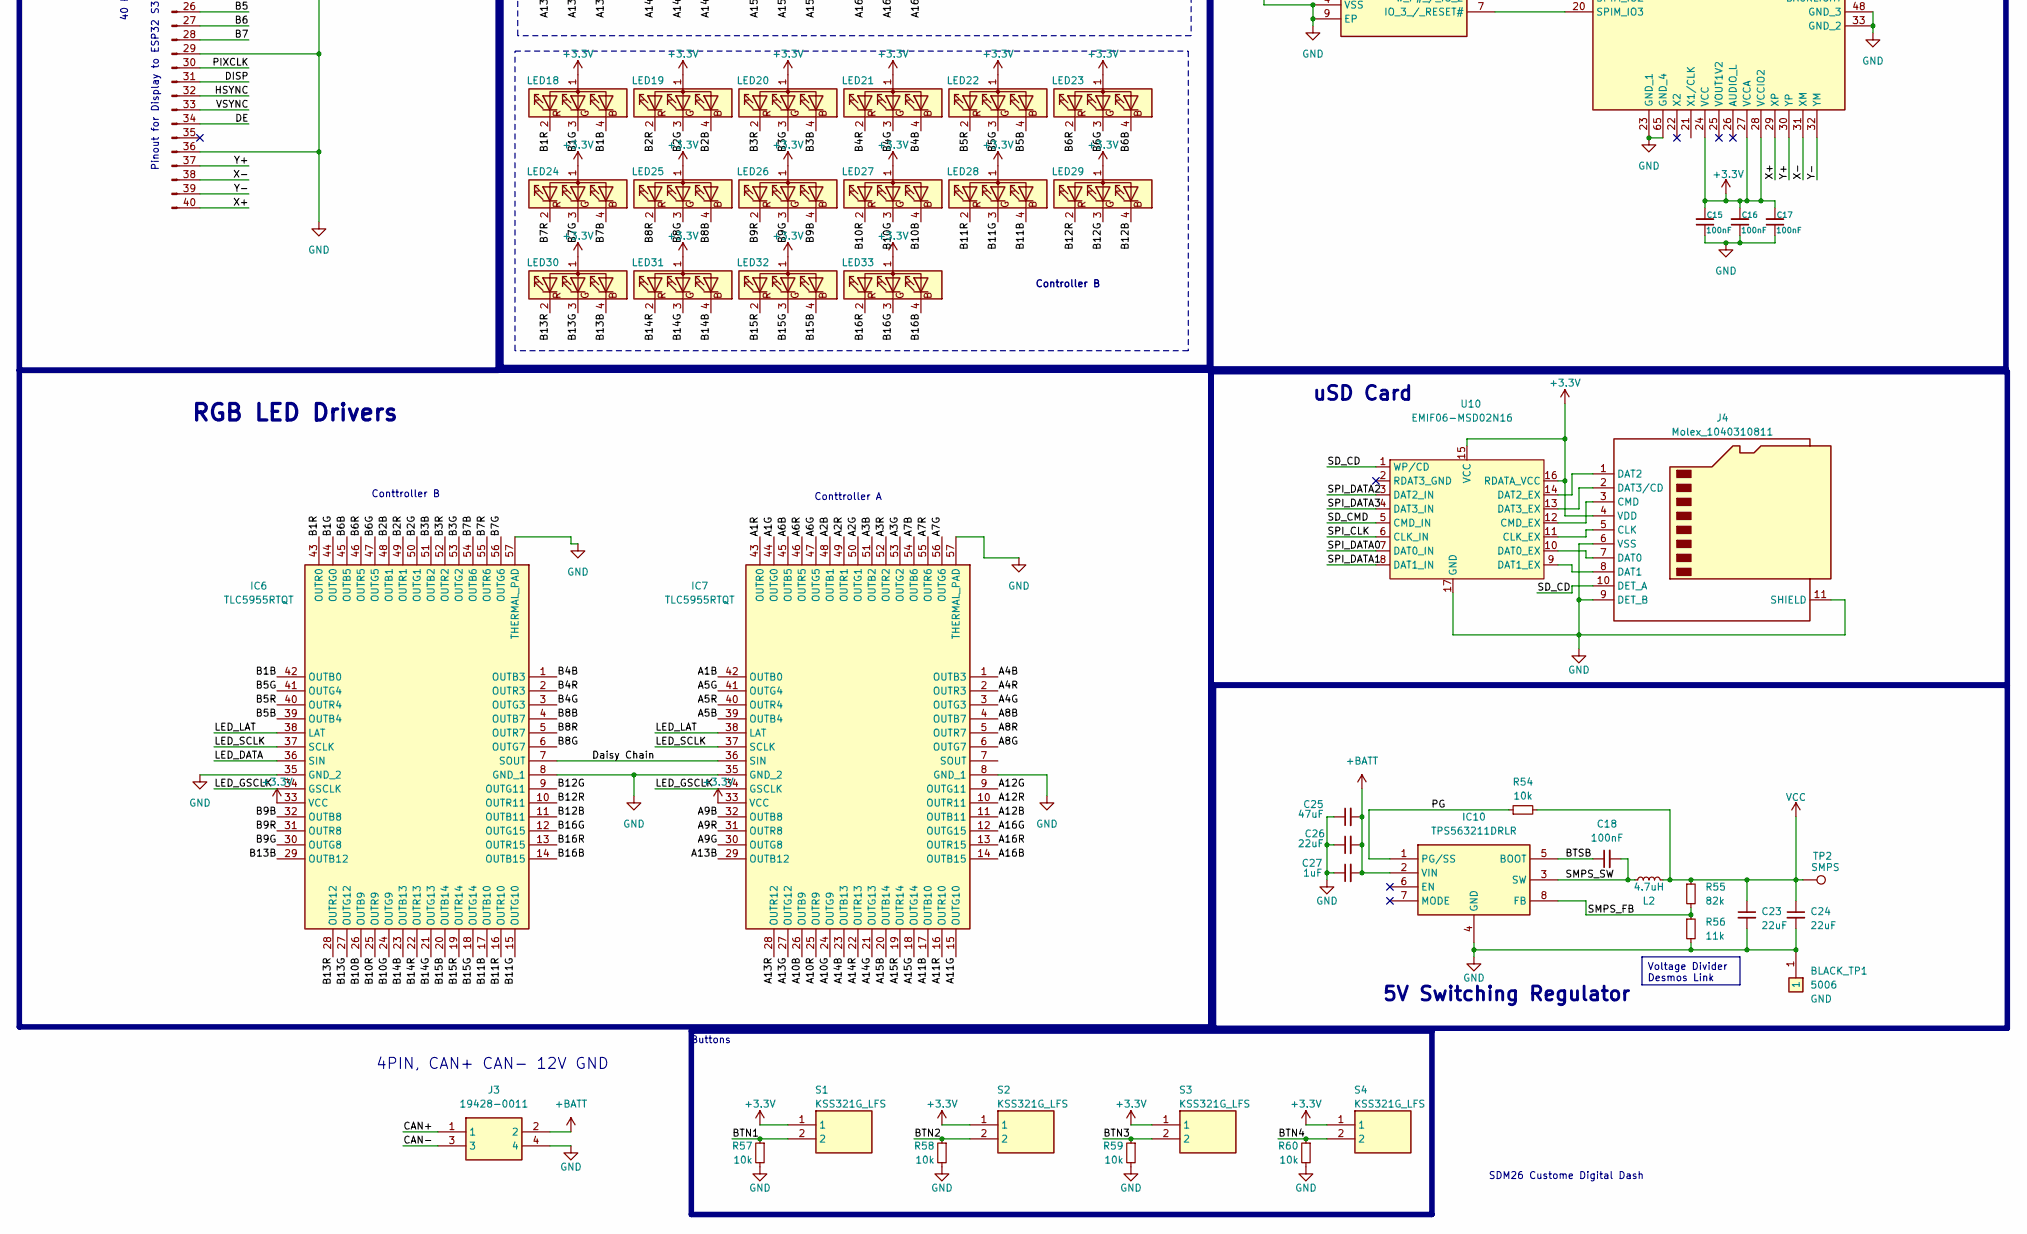
[picture p241: schematic Dash.kicad_sch, part in row 2, column 1]

Parts:
BLACK_TP1: 5006; Mouser Part Number 534-5006
C1, C4, C8, C9, C19, C20, C21, C27: 1uF; C_0603_1608Metric
C2, C12, C14: 10uF; C_0603_1608Metric
C3, C10, C11, C13, C15, C16, C17, C18, C22: 100nF; C_0603_1608Metric
C23, C24, C26: 22uF; C_0603_1608Metric
C25: 47uF; CP_Elec_6.3x5.9
D1: ESDCAN03-2BWY; SOT65P210X110-3N; Mouser Part Number 511-ESDCAN03-2BWY
D2, D4: MBR0540T1G; SOD3716X135N; Mouser Part Number 863-MBR0540T1G
IC1: ESP32-S3-WROOM-1-N8R8; ESP32S3WROOM1N8R8; Mouser Part Number 356-EP32S3WROOM1N8R8
IC3: TLP175A_TPL,E; TLP266J; Mouser Part Number 757-TLP175A(TPLE
IC4: TPS2116DRLR; SOTFL50P160X60-8L; Mouser Part Number 595-TPS2116DRLR
IC5: MIC37100-3.3WS; SOT230P700X180-4N; Mouser Part Number 998-MIC37100-3.3WS
IC6, IC7: TLC5955RTQT; QFN50P800X800X100-57N-D; Mouser Part Number 595-TLC5955RTQT
IC8: BT818Q-T; QFN50P900X900X90-65N-D; Mouser Part Number 895-BT818Q-T
IC9: S25FL256LAGNFB010; SON127P600X500X80-9N-D; Mouser Part Number 727-S25FL256LANFB010
IC10: TPS563211DRLR; SOTFL50P160X60-8N; Mouser Part Number 595-TPS563211DRLR
J1: USB4730-GF-A; USB4730GFA; Mouser Part Number 640-USB4730GFA
J2: Conn_01x40_Pin; Omron_XF2M-4015-1A_1x40-1MP_P0.5mm_Horizontal
J3: 19428-0011; 194280011; Mouser Part Number 538-19428-0011
J4: Molex_1040310811; microSD_HC_Molex_104031-0811
L1: 4.7uH; BWVS006060454R7ML1
L2: 4.7uH; L_Bourns_SRP7028A_7.3x6.6mm
LED1: 150060RS75000; LEDC1608X80N; Mouser Part Number 710-150060RS75000
LED2, LED3, LED4, LED5, LED6, LED7, LED8, LED9, LED10, LED11, LED12, LED13, LED14, LED15, LED16, LED17, LED18, LED19, LED20, LED21, LED22, LED23, LED24, LED25, LED26, LED27, LED28, LED29, LED30, LED31, LED32, LED33: CLMUD-FKC-CHJNPM569ABB845343; PLCC4_CLMUD-FKC_CRW
PS1: TPS61169DCKR; SOT65P210X110-5N; Mouser Part Number 595-TPS61169DCKR
R1, R5, R10, R11, R15, R31, R54, R57, R58, R59, R60: 10k; R_0603_1608Metric
R2, R16: 5.1k; R_0603_1608Metric
R3, R4: 27; R_0603_1608Metric
R12: 120; R_0603_1608Metric
R14: 68; R_0603_1608Metric
R34: 5.05; R_0603_1608Metric
R51: 47K; R_0603_1608Metric
R55: 82k; R_0603_1608Metric
R56: 11k; R_0603_1608Metric
S1, S2, S3, S4: KSS321G_LFS; KSS321GLFS; Manufacturer_Part_Number KSS321G LFS
TP2: SMPS; TestPoint_Pad_1.5x1.5mm
U1: USBLC6-2SC6; SOT-23-6
U2: SN65HVD230; SOIC-8_3.9x4.9mm_P1.27mm
U10: EMIF06-MSD02N16; UQFN-17-3.5x1.2mm

Connections:
+3.3V: C2.2, C3.2, C10.2, C11.1, C13.1, C14.2, C15.2, C16.2, C17.2, IC1.2 (3V3), IC5.3 (OUT), IC6.33 (VCC), IC7.33 (VCC), IC8.9 (VCCIO1), IC8.17 (VCCIO3), IC8.24 (VCC), IC8.27 (VCCA), IC8.28 (VCCIO2), IC9.8 (VCC), J2.4, J4.4 (VDD), LED2.1 (A), LED3.1 (A), LED4.1 (A), LED5.1 (A), LED6.1 (A), LED7.1 (A), LED8.1 (A), LED9.1 (A), LED10.1 (A), LED11.1 (A), LED12.1 (A), LED13.1 (A), LED14.1 (A), LED15.1 (A), LED16.1 (A), LED17.1 (A), LED18.1 (A), LED19.1 (A), LED20.1 (A), LED21.1 (A), LED22.1 (A), LED23.1 (A), LED24.1 (A), LED25.1 (A), LED26.1 (A), LED27.1 (A), LED28.1 (A), LED29.1 (A), LED30.1 (A), LED31.1 (A), LED32.1 (A), LED33.1 (A), R1.1, R5.2, R51.2, S1.1, S2.1, S3.1, S4.1, U2.3 (VCC), U10.15 (VCC), U10.16 (RDATA_VCC)
+5V: C12.2, C21.2, IC4.2 (VOUT), IC4.7 (VOUT), IC5.1 (IN), L1.2, PS1.5 (VIN), R14.1, R31.2
+BATT: C25.2, C26.2, C27.2, IC10.2 (VIN), J3.2
/A1B: IC7.42 (OUTB0), LED2.4 (B)
/A1G: IC7.44 (OUTG0), LED2.3 (G)
/A1R: IC7.43 (OUTR0), LED2.2 (R)
/A2B: IC7.48 (OUTB1), LED3.4 (B)
/A2G: IC7.50 (OUTG1), LED3.3 (G)
/A2R: IC7.49 (OUTR1), LED3.2 (R)
/A3B: IC7.51 (OUTB2), LED4.4 (B)
/A3G: IC7.53 (OUTG2), LED4.3 (G)
/A3R: IC7.52 (OUTR2), LED4.2 (R)
/A4B: IC7.1 (OUTB3), LED5.4 (B)
/A4G: IC7.3 (OUTG3), LED5.3 (G)
/A4R: IC7.2 (OUTR3), LED5.2 (R)
/A5B: IC7.39 (OUTB4), LED6.4 (B)
/A5G: IC7.41 (OUTG4), LED6.3 (G)
/A5R: IC7.40 (OUTR4), LED6.2 (R)
/A6B: IC7.45 (OUTB5), LED7.4 (B)
/A6G: IC7.47 (OUTG5), LED7.3 (G)
/A6R: IC7.46 (OUTR5), LED7.2 (R)
/A7B: IC7.54 (OUTB6), LED8.4 (B)
/A7G: IC7.56 (OUTG6), LED8.3 (G)
/A7R: IC7.55 (OUTR6), LED8.2 (R)
/A8B: IC7.4 (OUTB7), LED9.4 (B)
/A8G: IC7.6 (OUTG7), LED9.3 (G)
/A8R: IC7.5 (OUTR7), LED9.2 (R)
/A9B: IC7.32 (OUTB8), LED10.4 (B)
/A9G: IC7.30 (OUTG8), LED10.3 (G)
/A9R: IC7.31 (OUTR8), LED10.2 (R)
/A10B: IC7.26 (OUTB9), LED11.4 (B)
/A10G: IC7.24 (OUTG9), LED11.3 (G)
/A10R: IC7.25 (OUTR9), LED11.2 (R)
/A11B: IC7.17 (OUTB10), LED12.4 (B)
/A11G: IC7.15 (OUTG10), LED12.3 (G)
/A11R: IC7.16 (OUTR10), LED12.2 (R)
/A12B: IC7.11 (OUTB11), LED13.4 (B)
/A12G: IC7.9 (OUTG11), LED13.3 (G)
/A12R: IC7.10 (OUTR11), LED13.2 (R)
/A13B: IC7.29 (OUTB12), LED14.4 (B)
/A13G: IC7.27 (OUTG12), LED14.3 (G)
/A13R: IC7.28 (OUTR12), LED14.2 (R)
/A14B: IC7.23 (OUTB13), LED15.4 (B)
/A14G: IC7.21 (OUTG13), LED15.3 (G)
/A14R: IC7.22 (OUTR13), LED15.2 (R)
/A15B: IC7.20 (OUTB14), LED16.4 (B)
/A15G: IC7.18 (OUTG14), LED16.3 (G)
/A15R: IC7.19 (OUTR14), LED16.2 (R)
/A16B: IC7.14 (OUTB15), LED17.4 (B)
/A16G: IC7.12 (OUTG15), LED17.3 (G)
/A16R: IC7.13 (OUTR15), LED17.2 (R)
/B0: IC8.47 (B0), J2.21
/B1: IC8.46 (B1), J2.22
/B1B: IC6.42 (OUTB0), LED18.4 (B)
/B1G: IC6.44 (OUTG0), LED18.3 (G)
/B1R: IC6.43 (OUTR0), LED18.2 (R)
/B2: IC8.45 (B2), J2.23
/B2B: IC6.48 (OUTB1), LED19.4 (B)
/B2G: IC6.50 (OUTG1), LED19.3 (G)
/B2R: IC6.49 (OUTR1), LED19.2 (R)
/B3: IC8.44 (B3), J2.24
/B3B: IC6.51 (OUTB2), LED20.4 (B)
/B3G: IC6.53 (OUTG2), LED20.3 (G)
/B3R: IC6.52 (OUTR2), LED20.2 (R)
/B4: IC8.43 (B4), J2.25
/B4B: IC6.1 (OUTB3), LED21.4 (B)
/B4G: IC6.3 (OUTG3), LED21.3 (G)
/B4R: IC6.2 (OUTR3), LED21.2 (R)
/B5: IC8.42 (B5), J2.26
/B5B: IC6.39 (OUTB4), LED22.4 (B)
/B5G: IC6.41 (OUTG4), LED22.3 (G)
/B5R: IC6.40 (OUTR4), LED22.2 (R)
/B6: IC8.41 (B6), J2.27
/B6B: IC6.45 (OUTB5), LED23.4 (B)
/B6G: IC6.47 (OUTG5), LED23.3 (G)
/B6R: IC6.46 (OUTR5), LED23.2 (R)
/B7: IC8.40 (B7), J2.28
/B7B: IC6.54 (OUTB6), LED24.4 (B)
/B7G: IC6.56 (OUTG6), LED24.3 (G)
/B7R: IC6.55 (OUTR6), LED24.2 (R)
/B8B: IC6.4 (OUTB7), LED25.4 (B)
/B8G: IC6.6 (OUTG7), LED25.3 (G)
/B8R: IC6.5 (OUTR7), LED25.2 (R)
/B9B: IC6.32 (OUTB8), LED26.4 (B)
/B9G: IC6.30 (OUTG8), LED26.3 (G)
/B9R: IC6.31 (OUTR8), LED26.2 (R)
/B10B: IC6.26 (OUTB9), LED27.4 (B)
/B10G: IC6.24 (OUTG9), LED27.3 (G)
/B10R: IC6.25 (OUTR9), LED27.2 (R)
/B11B: IC6.17 (OUTB10), LED28.4 (B)
/B11G: IC6.15 (OUTG10), LED28.3 (G)
/B11R: IC6.16 (OUTR10), LED28.2 (R)
/B12B: IC6.11 (OUTB11), LED29.4 (B)
/B12G: IC6.9 (OUTG11), LED29.3 (G)
/B12R: IC6.10 (OUTR11), LED29.2 (R)
/B13B: IC6.29 (OUTB12), LED30.4 (B)
/B13G: IC6.27 (OUTG12), LED30.3 (G)
/B13R: IC6.28 (OUTR12), LED30.2 (R)
/B14B: IC6.23 (OUTB13), LED31.4 (B)
/B14G: IC6.21 (OUTG13), LED31.3 (G)
/B14R: IC6.22 (OUTR13), LED31.2 (R)
/B15B: IC6.20 (OUTB14), LED32.4 (B)
/B15G: IC6.18 (OUTG14), LED32.3 (G)
/B15R: IC6.19 (OUTR14), LED32.2 (R)
/B16B: IC6.14 (OUTB15), LED33.4 (B)
/B16G: IC6.12 (OUTG15), LED33.3 (G)
/B16R: IC6.13 (OUTR15), LED33.2 (R)
/BACKLITE_PWM: IC8.10 (GPIO2)
/BTN1: IC1.28 (IO35), R57.1, S1.2
/BTN2: IC1.29 (IO36), R58.1, S2.2
/BTN3: IC1.30 (IO37), R59.1, S3.2
/BTN4: IC1.31 (IO38), R60.1, S4.2
/BTSB: C18.1, IC10.5 (BOOT)
/CAN+: D1.2, J3.1, R12.2, U2.7 (CANH)
/CAN-: D1.1, IC3.4, J3.3, U2.6 (CANL)
/CAN_CTX: IC1.11 (IO18), U2.4 (R)
/CAN_RTX: IC1.12 (IO8), U2.1 (D)
/CAN_TERM: IC1.10 (IO17), IC3.1
/CHIP_PU: C1.1, IC1.3 (EN), R1.2
/DE: IC8.35 (DE), J2.34
/DISP: IC8.38 (DISP), J2.31
/DISP_CS: IC1.22 (IO14), IC8.6 (CS_N)
/Daisy Chain: IC6.7 (SOUT), IC7.36 (SIN)
/G0: IC8.56 (G0), J2.13
/G1: IC8.55 (G1), J2.14
/G2: IC8.54 (G2), J2.15
/G3: IC8.53 (G3), J2.16
/G4: IC8.52 (G4), J2.17
/G5: IC8.51 (G5), J2.18
/G6: IC8.50 (G6), J2.19
/G7: IC8.49 (G7), J2.20
/GPIO0: IC1.27 (IO0), R5.1
/HSYNC: IC8.37 (HSYNC), J2.32
/INT_N: IC1.6 (IO6), IC8.11 (INT_N)
/LED_DATA: IC1.5 (IO5), IC6.36 (SIN)
/LED_GSCLK: IC6.34 (GSCLK), IC7.34 (GSCLK)
/LED_LAT: IC6.38 (LAT), IC7.38 (LAT)
/LED_SCLK: IC1.4 (IO4), IC6.37 (SCLK), IC7.37 (SCLK)
/NOR_CS: IC8.15 (SPIM_SS_N), IC9.1 (CS#), R51.1
/PD_N: IC1.7 (IO7), IC8.12 (PD_N)
/PG: IC10.1 (PG/SS), R54.1
/PIXCLK: IC8.39 (PCLK), J2.30
/PROG_D+: IC1.14 (IO20), R3.2
/PROG_D-: IC1.13 (IO19), R4.1
/PWM0: D4.1 (K), IC8.34 (BACKLIGHT)
/PWR_LED: LED1.2 (A), R14.2
/R0: IC8.1 (R0), J2.5
/R1: IC8.64 (R1), J2.6
/R2: IC8.63 (R2), J2.7
/R3: IC8.62 (R3), J2.8
/R4: IC8.61 (R4), J2.9
/R5: IC8.60 (R5), J2.10
/R6: IC8.59 (R6), J2.11
/R7: IC8.58 (R7), J2.12
/SD_CD: J4.10 (DET_A), U10.1 (WP/CD)
/SD_CMD: IC1.15 (IO3), U10.5 (CMD_IN)
/SD_CS: IC1.8 (IO15)
/SMPS_FB: IC10.8 (FB), R55.2, R56.1
/SMPS_SW: C18.2, IC10.3 (SW), L2.2
/SPI_CLK: IC1.17 (IO9), IC8.3 (SCK), U10.6 (CLK_IN)
/SPI_DATA0: IC1.18 (IO10), IC8.4 (MISO), U10.7 (DAT0_IN)
/SPI_DATA1: IC1.19 (IO11), IC8.5 (MOSI), U10.8 (DAT1_IN)
/SPI_DATA2: IC1.20 (IO12), IC8.7 (GPIO0/IO2), U10.3 (DAT2_IN)
/SPI_DATA3: IC1.21 (IO13), IC8.8 (GPIO1/IO3), U10.4 (DAT3_IN)
/U0RXD: IC1.36 (RXD0)
/U0TXD: IC1.37 (TXD0)
/USBM_D+: J1.A6 (DP1), J1.B6 (DP2), U1.6 (I/O1)
/USBM_D-: J1.A7 (DN1), J1.B7 (DN2), U1.4 (I/O2)
/VSYNC: IC8.36 (VSYNC), J2.33
/X+: IC8.29 (XP), J2.40
/X-: IC8.31 (XM), J2.38
/Y+: IC8.30 (YP), J2.37
/Y-: IC8.32 (YM), J2.39
GND: BLACK_TP1.1 (1_1), C1.2, C2.1, C3.1, C4.1, C8.1, C9.1, C10.1, C11.2, C12.1, C13.2, C14.1, C15.1, C16.1, C17.1, C19.2, C20.2, C21.1, C22.2, C23.2, C24.2, C25.1, C26.1, C27.1, D1.3, IC1.1 (GND_1), IC1.40 (GND_2), IC1.41 (GND_3), IC1.42 (GND_4), IC1.43 (GND_5), IC1.44 (GND_6), IC1.45 (GND_7), IC1.46 (GND_8), IC1.47 (GND_9), IC1.48 (GND_10), IC1.49 (GND_11), IC3.3, IC4.1 (GND), IC5.2 (GND_1), IC5.4 (GND_2), IC6.8 (GND_1), IC6.35 (GND_2), IC6.57 (THERMAL_PAD), IC7.8 (GND_1), IC7.35 (GND_2), IC7.57 (THERMAL_PAD), IC8.23 (GND_1), IC8.33 (GND_2), IC8.48 (GND_3), IC8.65 (GND_4), IC9.4 (VSS), IC9.9 (EP), IC10.4 (GND), J1.A1 (GND_1), J1.A12 (GND_2), J1.B1 (GND_3), J1.B12 (GND_4), J1.MH1, J1.MH2, J1.MH3, J1.MH4, J2.3, J2.29, J2.36, J3.4, J4.6 (VSS), J4.9 (DET_B), J4.11 (SHIELD), LED1.1 (K), PS1.2 (GND), R2.2, R11.1, R15.1, R16.2, R34.1, R56.2, R57.2, R58.2, R59.2, R60.2, U1.2 (GND), U2.2 (GND), U10.17 (GND)
unnamed: D2.2 (A), L1.1, PS1.1 (SW)
unnamed: D4.2 (A), PS1.4 (CTRL), R31.1
unnamed: IC3.6, R12.1
unnamed: IC4.4 (PR1), R10.1, R11.2
unnamed: IC8.19 (SPIM_IO2), IC9.3 (W_P#_/_IO_2)
unnamed: IC8.20 (SPIM_IO3), IC9.7 (IO_3_/_RESET#)
unnamed: IC8.18 (SPIM_MISO), IC9.2 (SO/IO_1)
unnamed: IC8.16 (SPIM_MOSI), IC9.5 (SI_/_IO_0)
unnamed: IC8.14 (SPIM_SCLK), IC9.6 (SCK)
unnamed: J1.A5 (CC1), R2.1
unnamed: J1.B5 (CC2), R16.1
unnamed: J4.5 (CLK), U10.11 (CLK_EX)
unnamed: J4.3 (CMD), U10.12 (CMD_EX)
unnamed: J4.7 (DAT0), U10.10 (DAT0_EX)
unnamed: J4.8 (DAT1), U10.9 (DAT1_EX)
unnamed: J4.1 (DAT2), U10.14 (DAT2_EX)
unnamed: J4.2 (DAT3/CD), U10.13 (DAT3_EX)
unnamed: R3.1, U1.1 (I/O1)
unnamed: R4.2, U1.3 (I/O2)
unnamed: R15.2, U2.8 (Rs)
VBUS: C4.2, C9.2, IC4.6 (VIN2), J1.A4 (VBUS_1), J1.A9 (VBUS_2), J1.B4 (VBUS_3), J1.B9 (VBUS_4), U1.5 (VBUS)
VCC: C8.2, C23.1, C24.1, IC4.3 (VIN1), IC4.5 (MODE), L2.1, R10.2, R54.2, R55.1, TP2.1 (1_1)
VLED+: C19.1, C20.1, D2.1 (K), J2.2
VLED-: C22.1, J2.1, PS1.3 (FB), R34.2

Notes on the sheet:
Pinout for Display to ESP32 S3 was Derived from Adafruit ESP32 Display driver board
Controller B
CAN Transceiver
R1-R5: 11,10,9,46,3 G0-G5: 48,47,21,14,13,12 B1-B5: 40,39,38,0,45 HS: 41, VS: 42, DE: 3, PCK: 1
RGB LED Drivers
3.3V LDO
40 Pin Paralel RGB 16Bit
Display Driver
Conttroller A
5V Multiplexer
Buttons
40p Display Connector
5V to 16v-19v LED boost converter
ESP32 S3 WROOM 1 N8R8
DO NOT USE THIS PIN!!! <--
ESP_Programmer
Power Net Names: Any voltage Like 3.3v or 5v comes from a regulator on board. VBUS comes from a USB connection VCC comes from the car/anywhere outside the board. GND/VDD = Ground
5V Switching Regulator
Power Stuff
SDM26 Custome Digital Dash
Tons of LEDs
uSD Card
Conttroller B
Backlight Boost
4PIN, CAN+ CAN- 12V GND
Voltage Divider Desmos Link

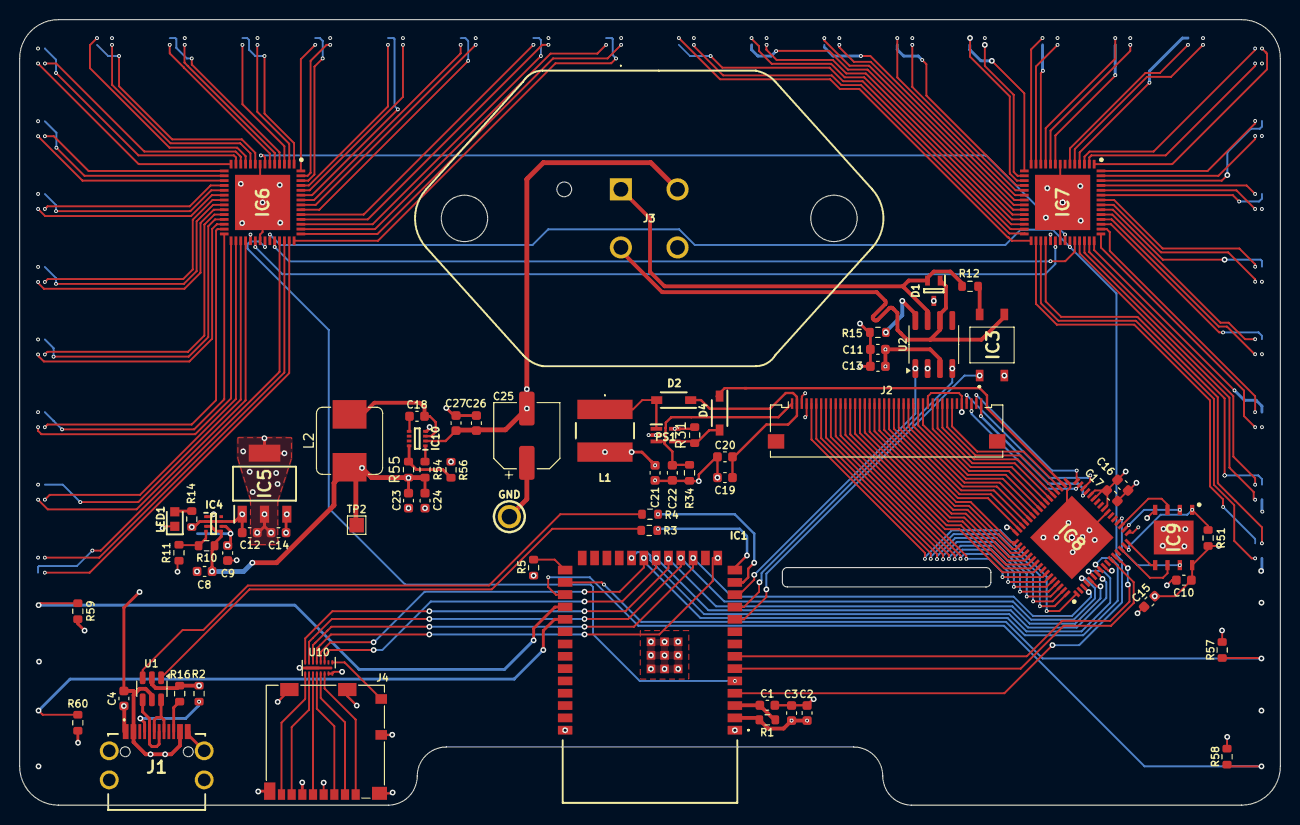
[picture p242: board Dash.kicad_pcb from above]

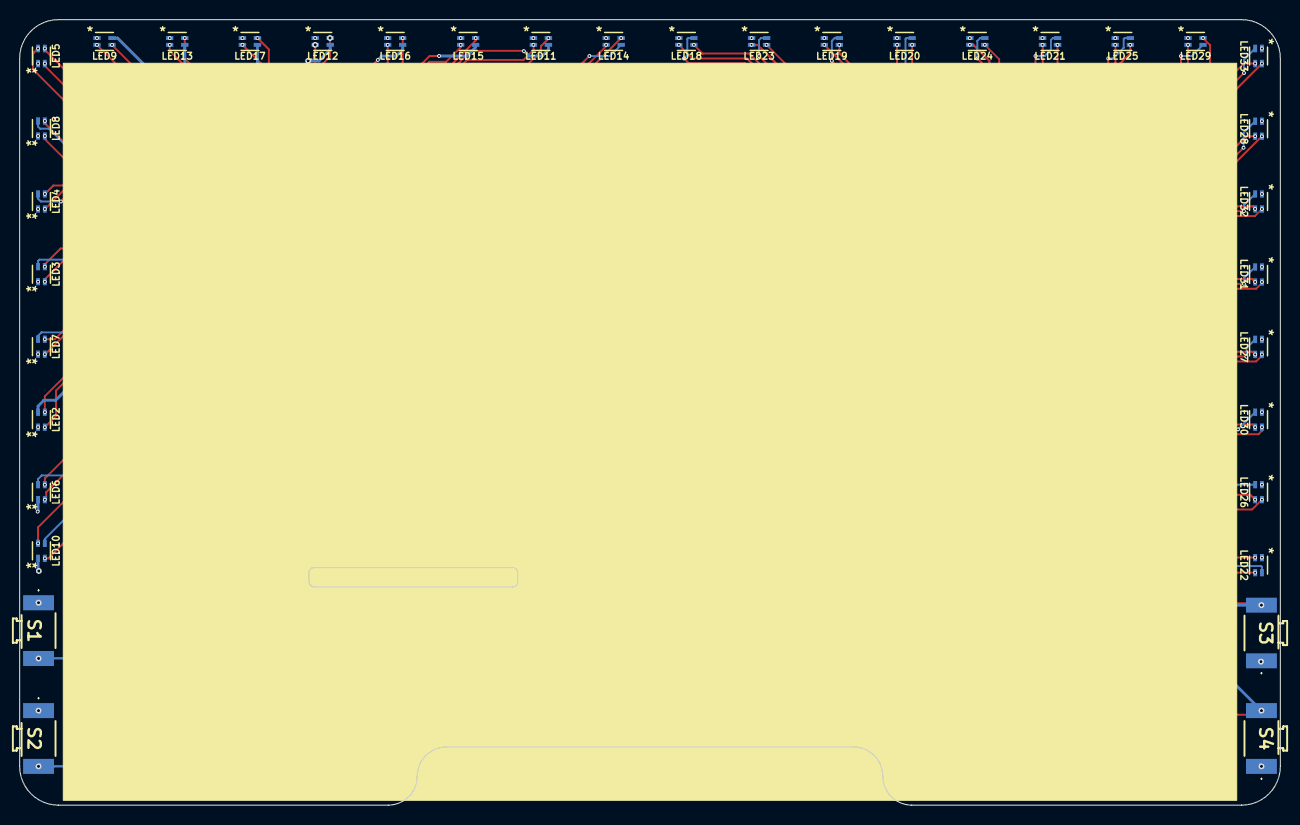
[picture p243: board Dash.kicad_pcb from below]

Board: 4 copper layers, 130.0 x 81.0 mm, 106 parts (36 on the bottom side), 194 nets.
