sundevilmotorsports/pcb-dev/2026/TempSensor/SDM26_RotorTempSensor_V1.0/SDM26_RotorTempSensor_V1.0.kicad_pcb

## KiCad design 2026/TempSensor/SDM26_RotorTempSensor_V1.0/SDM26_RotorTempSensor_V1.0.kicad_pcb (2026-03-19)

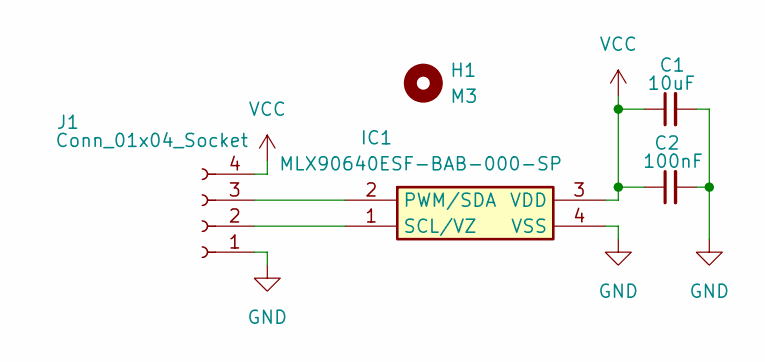
[picture p244: schematic SDM26_RotorTempSensor_V1.0.kicad_sch]

Parts:
C1: 10uF; C_0603_1608Metric
C2: 100nF; C_0603_1608Metric
H1: M3; MountingHole_3.2mm_M3
IC1: MLX90640ESF-BAB-000-SP; MLX90614ESFBAA000SP; Mouser Part Number 482-90614ESFBAA000SP
J1: Conn_01x04_Socket; JST_EH_B4B-EH-A_1x04_P2.50mm_Vertical

Connections:
GND: C1.2, C2.2, IC1.4 (VSS), J1.1
unnamed: IC1.2 (PWM/SDA), J1.3
unnamed: IC1.1 (SCL/VZ), J1.2
VCC: C1.1, C2.1, IC1.3 (VDD), J1.4

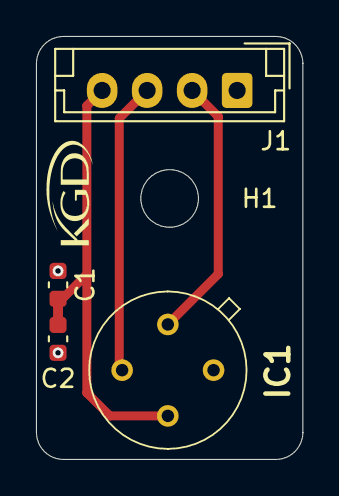
[picture p245: board SDM26_RotorTempSensor_V1.0.kicad_pcb from above]

Board: 2 copper layers, 14.8 x 23.5 mm, 5 parts (0 on the bottom side), 4 nets.
