sundevilmotorsports/pcb-dev/2026/Shifter/SDM26_Shifter_V1.0/SDM26_Shifter_V1.0.kicad_pcb

## KiCad design 2026/Shifter/SDM26_Shifter_V1.0/SDM26_Shifter_V1.0.kicad_pcb (2026-03-19)

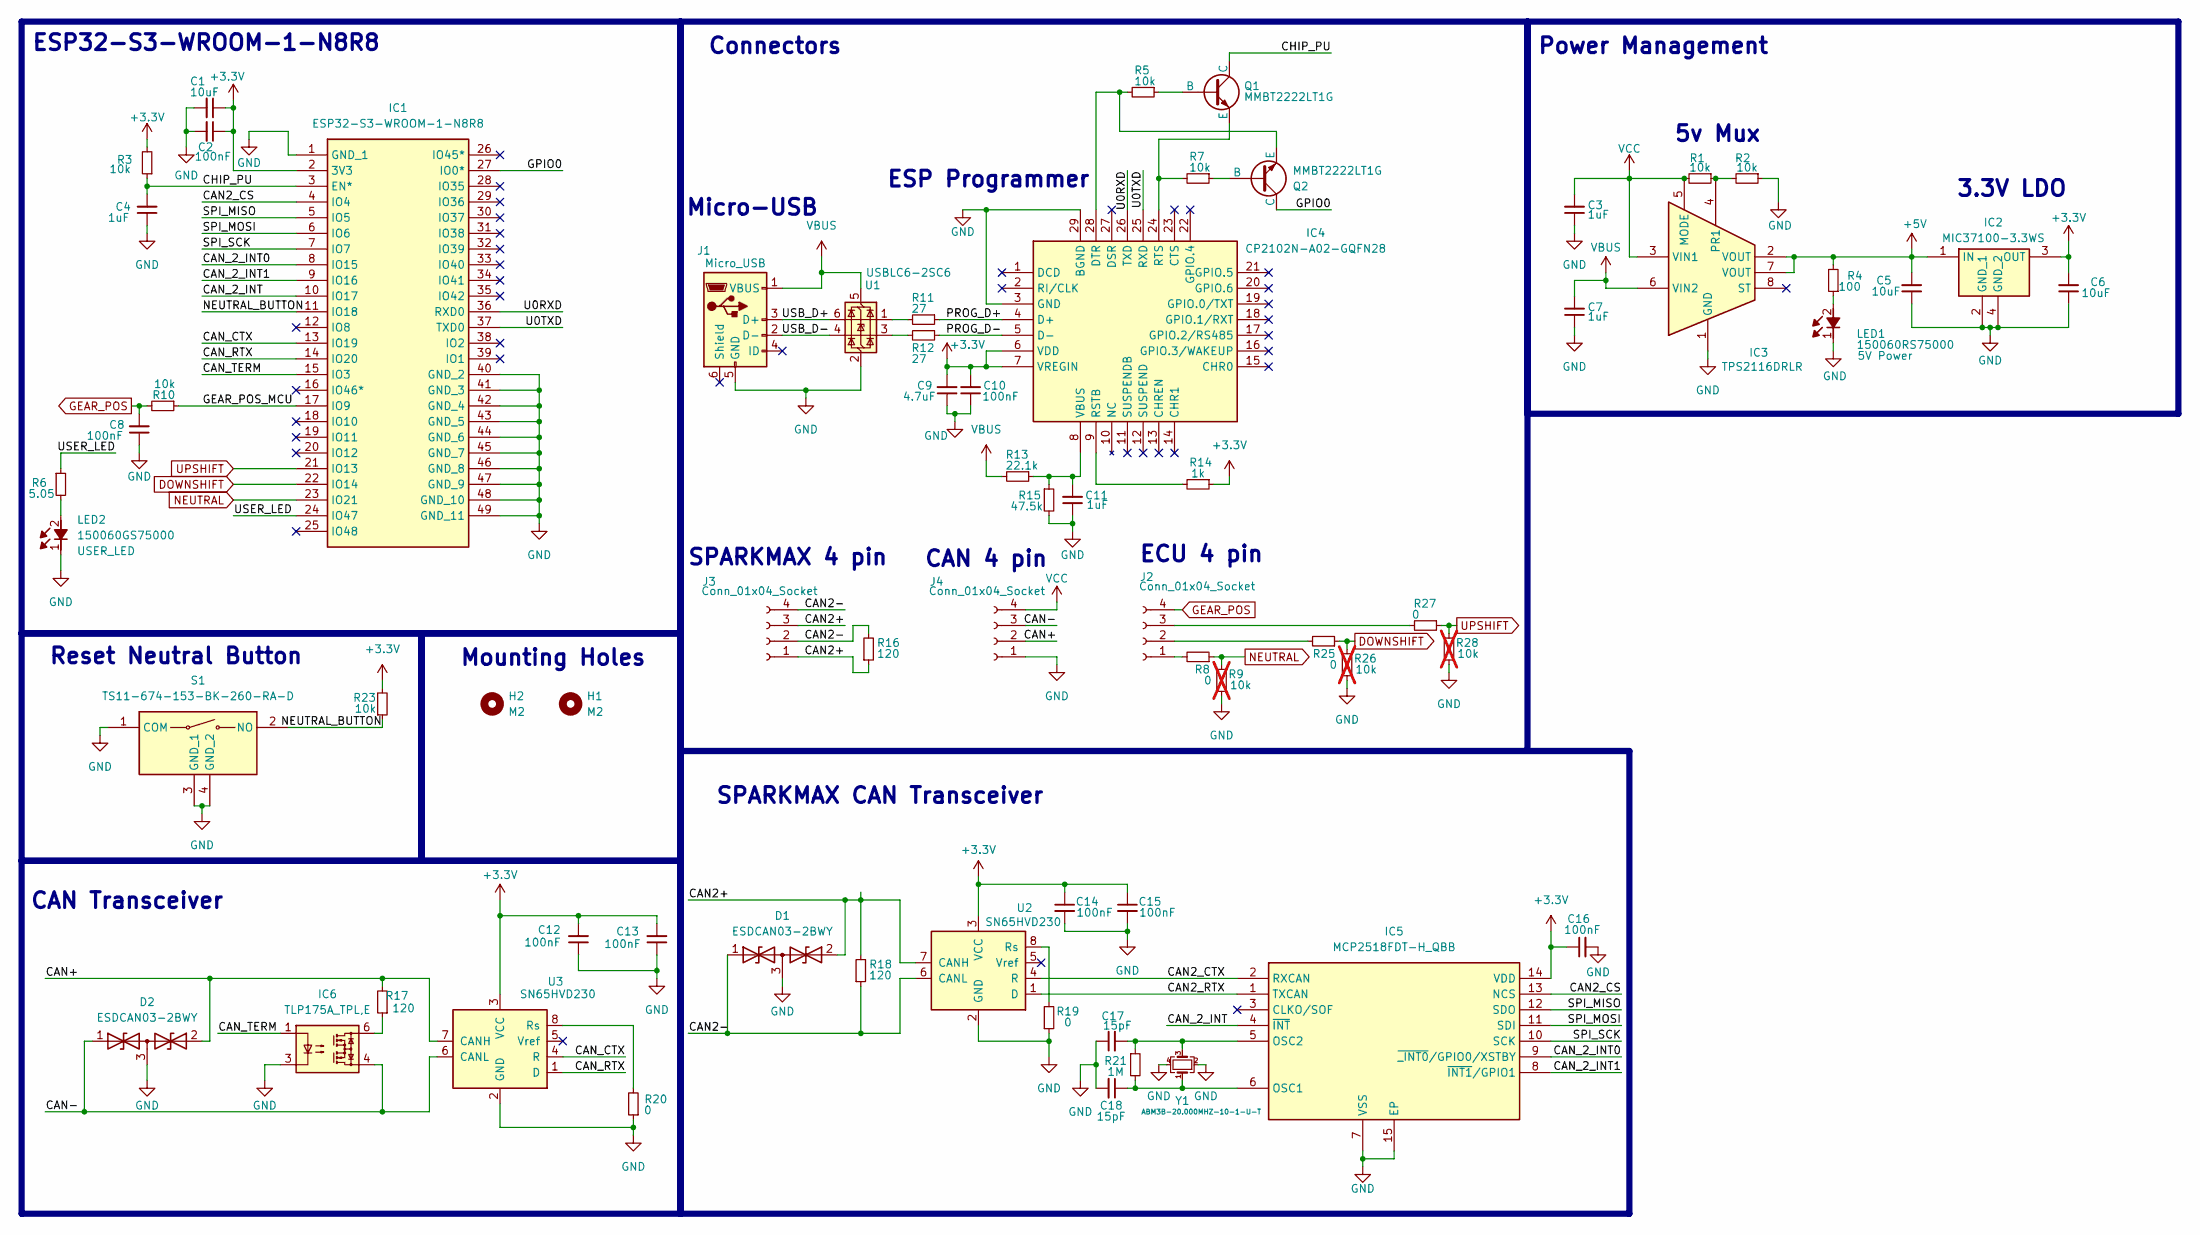
[picture p246: schematic SDM26_Shifter_V1.0.kicad_sch, SDM26 Shifter]

Parts:
C1, C5, C6: 10uF; C_0603_1608Metric
C2, C8, C10, C12, C13, C14, C15, C16: 100nF; C_0603_1608Metric
C3, C4, C7, C11: 1uF; C_0603_1608Metric
C9: 4.7uF; C_0603_1608Metric
C17, C18: 15pF; C_0603_1608Metric
D1, D2: ESDCAN03-2BWY; SOT65P210X110-3N; Mouser Part Number 511-ESDCAN03-2BWY
H1, H2: M2; MountingHole_2.2mm_M2
IC1: ESP32-S3-WROOM-1-N8R8; ESP32S3WROOM1N8R8; Mouser Part Number 356-EP32S3WROOM1N8R8
IC2: MIC37100-3.3WS; SOT230P700X180-4N; Mouser Part Number 998-MIC37100-3.3WS
IC3: TPS2116DRLR; SOTFL50P160X60-8L; Mouser Part Number 595-TPS2116DRLR
IC4: CP2102N-A02-GQFN28; QFN50P500X500X80-29N-D; Mouser Part Number 634-CP2102NA02GQFN28
IC5: MCP2518FDT-H_QBB; SON65P300X450X90-15L-D; Mouser Part Number 579-MCP2518FDT-H/QBB
IC6: TLP175A_TPL,E; TLP266J; Mouser Part Number 757-TLP175A(TPLE
J1: Micro_USB; USB_Micro-B_Molex-105017-0001
J2, J3, J4: Conn_01x04_Socket; JST_EH_S4B-EH_1x04_P2.50mm_Horizontal_1
LED1: 150060RS75000; LEDC1608X80N; Mouser Part Number 710-150060RS75000
LED2: 150060GS75000; LEDC1608X80N; Mouser Part Number 710-150060VS75000
Q1, Q2: MMBT2222LT1G; SOT96P237X111-3N
R1, R2, R3, R5, R7, R10, R23: 10k; R_0603_1608Metric
R4: 100; R_0603_1608Metric
R6: 5.05; R_0603_1608Metric
R8, R19, R20, R25, R27: 0; R_0603_1608Metric
R9, R26, R28: 10k; R_0603_1608Metric; not fitted
R11, R12: 27; R_0603_1608Metric
R13: 22.1k; R_0603_1608Metric
R14: 1k; R_0603_1608Metric
R15: 47.5k; R_0603_1608Metric
R16, R17, R18: 120; R_0603_1608Metric
R21: 1M; R_0603_1608Metric
S1: TS11-674-153-BK-260-RA-D; TS1167473BK260RAD; Mouser Part Number 179-TS1167473260RAD
U1: USBLC6-2SC6; SOT-23-6
U2, U3: SN65HVD230; SOIC-8_3.9x4.9mm_P1.27mm
Y1: ABM3B-20.000MHZ-10-1-U-T; ABM3B; Mouser Part Number 815-ABM3B-20-T

Connections:
+3.3V: C1.1, C2.1, C6.2, C9.2, C10.2, C12.2, C13.2, C14.1, C15.1, C16.1, IC1.2 (3V3), IC2.3 (OUT), IC4.6 (VDD), IC4.7 (VREGIN), IC5.14 (VDD), R3.2, R14.1, R23.2, U2.3 (VCC), U3.3 (VCC)
+5V: C5.2, IC2.1 (IN), IC3.2 (VOUT), IC3.7 (VOUT), R4.2
/CAN2+: D1.2, J3.1, J3.3, R16.1, R18.2, U2.7 (CANH)
/CAN2-: D1.1, J3.2, J3.4, R16.2, R18.1, U2.6 (CANL)
/CAN2_CS: IC1.4 (IO4), IC5.13 (NCS)
/CAN2_CTX: IC5.2 (RXCAN), U2.4 (R)
/CAN2_RTX: IC5.1 (TXCAN), U2.1 (D)
/CAN+: D2.2, J4.2, R17.2, U3.7 (CANH)
/CAN-: D2.1, IC6.4, J4.3, U3.6 (CANL)
/CAN_2_INT: IC1.10 (IO17), IC5.4 (~INT)
/CAN_2_INT0: IC1.8 (IO15), IC5.9 (~_INT0/GPIO0/XSTBY)
/CAN_2_INT1: IC1.9 (IO16), IC5.8 (~INT1/GPIO1)
/CAN_CTX: IC1.13 (IO19), U3.4 (R)
/CAN_RTX: IC1.14 (IO20), U3.1 (D)
/CAN_TERM: IC1.15 (IO3), IC6.1
/CHIP_PU: C4.2, IC1.3 (EN*), Q1.3 (C), R3.1
/GEAR_POS_MCU: IC1.17 (IO9), R10.1
/GPIO0: IC1.27 (IO0*), Q2.3 (C)
/NEUTRAL_BUTTON: IC1.11 (IO18), R23.1, S1.2 (NO)
/PROG_D+: IC4.4 (D+), R11.1
/PROG_D-: IC4.5 (D-), R12.1
/SPI_MISO: IC1.5 (IO5), IC5.12 (SDO)
/SPI_MOSI: IC1.6 (IO6), IC5.11 (SDI)
/SPI_SCK: IC1.7 (IO7), IC5.10 (SCK)
/U0RXD: IC1.36 (RXD0), IC4.26 (TXD)
/U0TXD: IC1.37 (TXD0), IC4.25 (RXD)
/USB_D+: J1.3 (D+), U1.6 (I/O1)
/USB_D-: J1.2 (D-), U1.4 (I/O2)
/USER_LED: IC1.24 (IO47), R6.1
DOWNSHIFT: IC1.22 (IO14), R25.1, R26.1
GEAR_POS: C8.2, J2.4, R10.2
GND: C1.2, C2.2, C3.1, C4.1, C5.1, C6.1, C7.1, C8.1, C9.1, C10.1, C11.1, C12.1, C13.1, C14.2, C15.2, C16.2, C17.1, C18.2, D1.3, D2.3, IC1.1 (GND_1), IC1.40 (GND_2), IC1.41 (GND_3), IC1.42 (GND_4), IC1.43 (GND_5), IC1.44 (GND_6), IC1.45 (GND_7), IC1.46 (GND_8), IC1.47 (GND_9), IC1.48 (GND_10), IC1.49 (GND_11), IC2.2 (GND_1), IC2.4 (GND_2), IC3.1 (GND), IC4.3 (GND), IC4.29 (BGND), IC5.7 (VSS), IC5.15 (EP), IC6.3, J1.5 (GND), J4.1, LED1.1 (K), LED2.1 (K), R2.1, R9.2, R15.2, R19.1, R20.1, R26.2, R28.2, S1.1 (COM), S1.3 (GND_1), S1.4 (GND_2), U1.2 (GND), U2.2 (GND), U3.2 (GND), Y1.2 (GND_1), Y1.4 (GND_2)
NEUTRAL: IC1.23 (IO21), R8.1, R9.1
unnamed: IC3.4 (PR1), R1.1, R2.2
unnamed: IC4.28 (DTR), Q2.2 (E), R5.2
unnamed: IC4.9 (RSTB), R14.2
unnamed: IC4.24 (RTS), Q1.2 (E), R7.2
unnamed: C11.2, IC4.8 (VBUS), R13.1, R15.1
unnamed: C18.1, IC5.6 (OSC1), R21.2, Y1.1 (XTAL_1)
unnamed: C17.2, IC5.5 (OSC2), R21.1, Y1.3 (XTAL_2)
unnamed: IC6.6, R17.1
unnamed: J2.1, R8.2
unnamed: J2.2, R25.2
unnamed: J2.3, R27.2
unnamed: LED1.2 (A), R4.1
unnamed: LED2.2 (A), R6.2
unnamed: Q1.1 (B), R5.1
unnamed: Q2.1 (B), R7.1
unnamed: R11.2, U1.1 (I/O1)
unnamed: R12.2, U1.3 (I/O2)
unnamed: R19.2, U2.8 (Rs)
unnamed: R20.2, U3.8 (Rs)
UPSHIFT: IC1.21 (IO13), R27.1, R28.1
VBUS: C7.2, IC3.6 (VIN2), J1.1 (VBUS), R13.2, U1.5 (VBUS)
VCC: C3.2, IC3.3 (VIN1), IC3.5 (MODE), J4.4, R1.2

Notes on the sheet:
SPARKMAX CAN Transceiver
CAN 4 pin
Connectors
Reset Neutral Button
Micro-USB
CAN Transceiver
3.3V LDO
ESP32-S3-WROOM-1-N8R8
ESP Programmer
Power Management
5v Mux
SPARKMAX 4 pin
Mounting Holes
ECU 4 pin

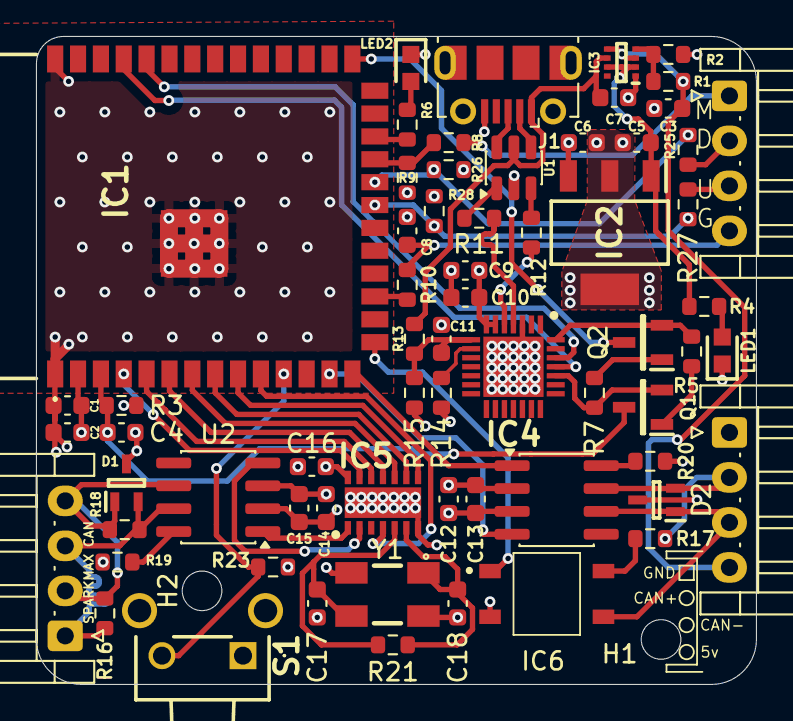
[picture p247: board SDM26_Shifter_V1.0.kicad_pcb from above]

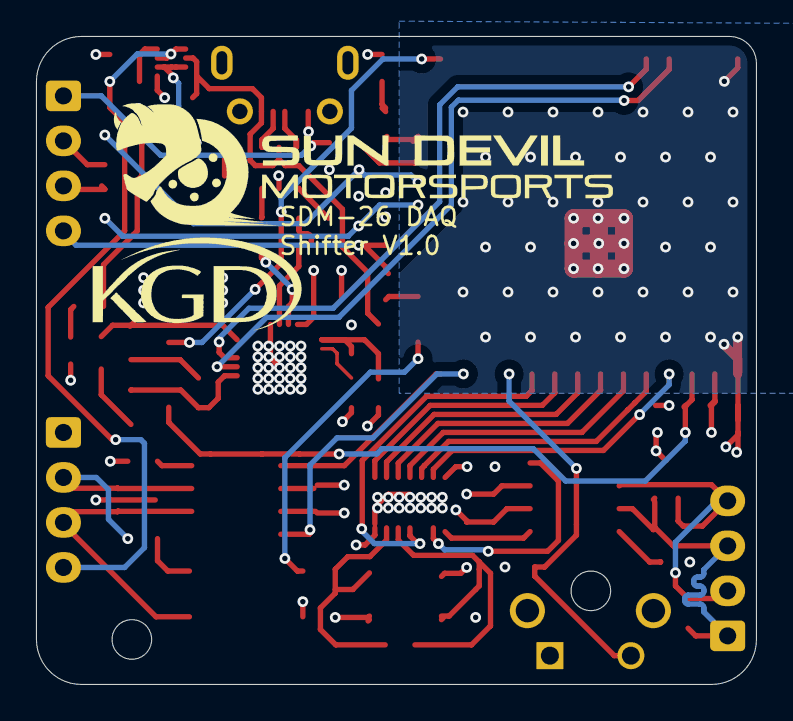
[picture p248: board SDM26_Shifter_V1.0.kicad_pcb from below]

Board: 4 copper layers, 40.0 x 36.0 mm, 67 parts (2 on the bottom side), 55 nets.
