sundevilmotorsports/pcb-dev/2026/IMU/SDM26_IMU_V1.1/SDM26_IMU_V1.1.kicad_pcb

## KiCad design 2026/IMU/SDM26_IMU_V1.1/SDM26_IMU_V1.1.kicad_pcb (2026-03-19)

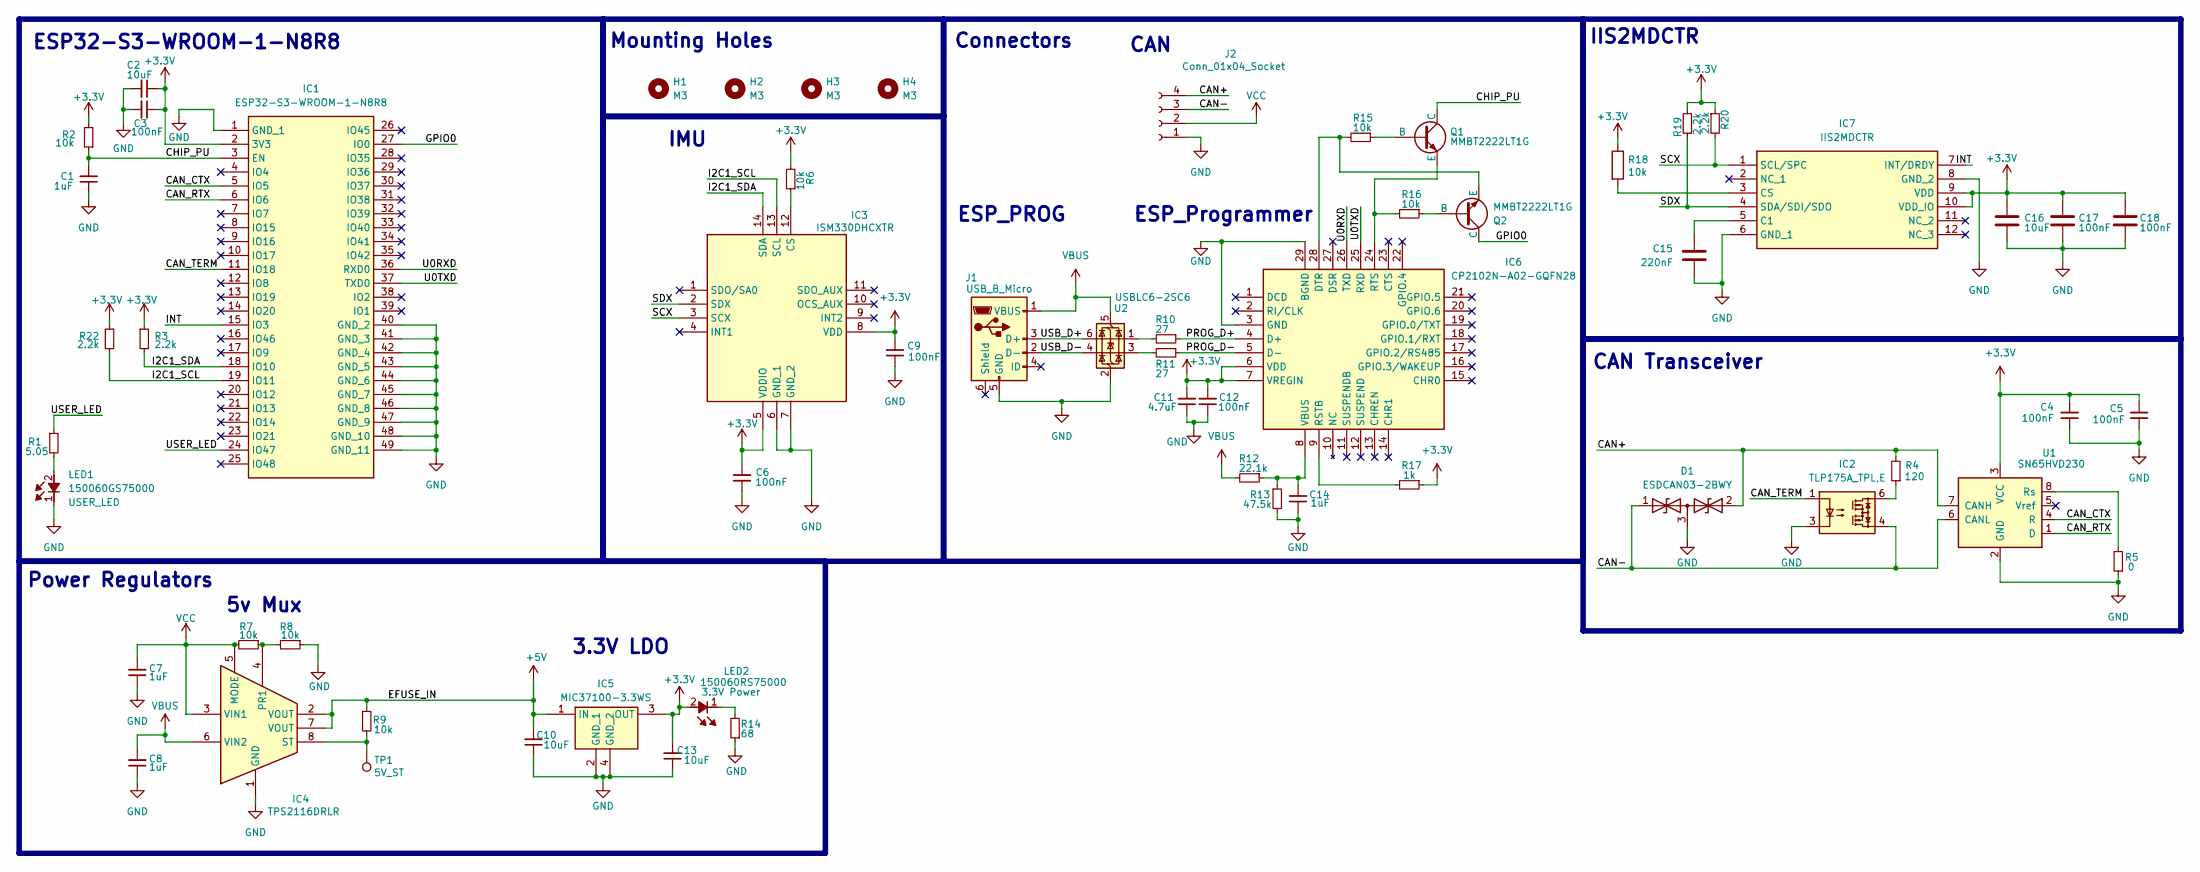
[picture p249: schematic SDM26_IMU_V1.1.kicad_sch, SDM26 IMU V1.1]

Parts:
C1, C7, C8, C14: 1uF; C_0603_1608Metric
C2, C10, C13, C16: 10uF; C_0603_1608Metric
C3, C4, C5, C6, C9, C12, C17, C18: 100nF; C_0603_1608Metric
C11: 4.7uF; C_0603_1608Metric
C15: 220nF; C_0603_1608Metric
D1: ESDCAN03-2BWY; SOT65P210X110-3N; Mouser Part Number 511-ESDCAN03-2BWY
H1, H2, H3, H4: M3; MountingHole_3.2mm_M3
IC1: ESP32-S3-WROOM-1-N8R8; ESP32S3WROOM1N8R8; Mouser Part Number 356-EP32S3WROOM1N8R8
IC2: TLP175A_TPL,E; TLP266J; Mouser Part Number 757-TLP175A(TPLE
IC3: ISM330DHCXTR; LSM6DS3USTR; Mouser Part Number 511-ISM330DHCXTR
IC4: TPS2116DRLR; SOTFL50P160X60-8L; Mouser Part Number 595-TPS2116DRLR
IC5: MIC37100-3.3WS; SOT230P700X180-4N; Mouser Part Number 998-MIC37100-3.3WS
IC6: CP2102N-A02-GQFN28; QFN50P500X500X80-29N-D; Mouser Part Number 634-CP2102NA02GQFN28
IC7: IIS2MDCTR; Mouser Part Number 511-IIS2MDCTR
J1: USB_B_Micro; USB_Micro-B_Molex-105017-0001
J2: Conn_01x04_Socket; JST_XH_S4B-XH-A_1x04_P2.50mm_Horizontal
LED1: 150060GS75000; LEDC1608X80N; Mouser Part Number 710-150060VS75000
LED2: 150060RS75000; LEDC1608X80N; Mouser Part Number 710-150060RS75000
Q1, Q2: MMBT2222LT1G; SOT96P237X111-3N
R1: 5.05; R_0603_1608Metric
R2, R6, R7, R8, R9, R15, R16, R18: 10k; R_0603_1608Metric
R3, R19, R20, R22: 2.2k; R_0603_1608Metric
R4: 120; R_0603_1608Metric
R5: 0; R_0603_1608Metric
R10, R11: 27; R_0603_1608Metric
R12: 22.1k; R_0603_1608Metric
R13: 47.5k; R_0603_1608Metric
R14: 68; R_0603_1608Metric
R17: 1k; R_0603_1608Metric
TP1: 5V_ST; TestPoint_Pad_1.5x1.5mm
U1: SN65HVD230; SOIC-8_3.9x4.9mm_P1.27mm
U2: USBLC6-2SC6; SOT-23-6

Connections:
+3.3V: C2.1, C3.1, C4.2, C5.2, C6.2, C9.2, C11.2, C12.2, C13.2, C16.1, C17.1, C18.1, IC1.2 (3V3), IC3.5 (VDDIO), IC3.8 (VDD), IC5.3 (OUT), IC6.6 (VDD), IC6.7 (VREGIN), IC7.9 (VDD), IC7.10 (VDD_IO), LED2.2 (A), R2.2, R3.1, R6.2, R17.1, R18.1, R19.2, R20.1, R22.1, U1.3 (VCC)
+5V: C10.2, IC4.2 (VOUT), IC4.7 (VOUT), IC5.1 (IN), R9.1
/CAN+: D1.2, J2.4, R4.2, U1.7 (CANH)
/CAN-: D1.1, IC2.4, J2.3, U1.6 (CANL)
/CAN_CTX: IC1.5 (IO5), U1.4 (R)
/CAN_RTX: IC1.6 (IO6), U1.1 (D)
/CAN_TERM: IC1.11 (IO18), IC2.1
/CHIP_PU: C1.2, IC1.3 (EN), Q1.3 (C), R2.1
/GPIO0: IC1.27 (IO0), Q2.3 (C)
/I2C1_SCL: IC1.19 (IO11), IC3.13 (SCL), R22.2
/I2C1_SDA: IC1.18 (IO10), IC3.14 (SDA), R3.2
/INT: IC1.15 (IO3), IC7.7 (INT/DRDY)
/PROG_D+: IC6.4 (D+), R10.1
/PROG_D-: IC6.5 (D-), R11.1
/SCX: IC3.3 (SCX), IC7.1 (SCL/SPC), R20.2
/SDX: IC3.2 (SDX), IC7.4 (SDA/SDI/SDO), R19.1
/U0RXD: IC1.36 (RXD0), IC6.26 (TXD)
/U0TXD: IC1.37 (TXD0), IC6.25 (RXD)
/USB_D+: J1.3 (D+), U2.6 (I/O1)
/USB_D-: J1.2 (D-), U2.4 (I/O2)
/USER_LED: IC1.24 (IO47), R1.1
GND: C1.1, C2.2, C3.2, C4.1, C5.1, C6.1, C7.1, C8.1, C9.1, C10.1, C11.1, C12.1, C13.1, C14.1, C15.2, C16.2, C17.2, C18.2, D1.3, IC1.1 (GND_1), IC1.40 (GND_2), IC1.41 (GND_3), IC1.42 (GND_4), IC1.43 (GND_5), IC1.44 (GND_6), IC1.45 (GND_7), IC1.46 (GND_8), IC1.47 (GND_9), IC1.48 (GND_10), IC1.49 (GND_11), IC2.3, IC3.6 (GND_1), IC3.7 (GND_2), IC4.1 (GND), IC5.2 (GND_1), IC5.4 (GND_2), IC6.3 (GND), IC6.29 (BGND), IC7.6 (GND_1), IC7.8 (GND_2), J1.5 (GND), J2.1, LED1.1 (K), R5.1, R8.1, R13.2, R14.1, U1.2 (GND), U2.2 (GND)
unnamed: IC2.6, R4.1
unnamed: IC3.12 (CS), R6.1
unnamed: IC4.4 (PR1), R7.1, R8.2
unnamed: IC4.8 (ST), R9.2, TP1.1
unnamed: IC6.28 (DTR), Q2.2 (E), R15.2
unnamed: IC6.9 (RSTB), R17.2
unnamed: IC6.24 (RTS), Q1.2 (E), R16.2
unnamed: C14.2, IC6.8 (VBUS), R12.1, R13.1
unnamed: C15.1, IC7.5 (C1)
unnamed: IC7.3 (CS), R18.2
unnamed: LED1.2 (A), R1.2
unnamed: LED2.1 (K), R14.2
unnamed: Q1.1 (B), R15.1
unnamed: Q2.1 (B), R16.1
unnamed: R10.2, U2.1 (I/O1)
unnamed: R11.2, U2.3 (I/O2)
unnamed: R5.2, U1.8 (Rs)
VBUS: C8.2, IC4.6 (VIN2), J1.1 (VBUS), R12.2, U2.5 (VBUS)
VCC: C7.2, IC4.3 (VIN1), IC4.5 (MODE), J2.2, R7.2

Notes on the sheet:
3.3V LDO
Mounting Holes
IIS2MDCTR
ESP_Programmer
Connectors
IMU
5v Mux
ESP32-S3-WROOM-1-N8R8
Power Regulators
CAN
ESP_PROG
CAN Transceiver

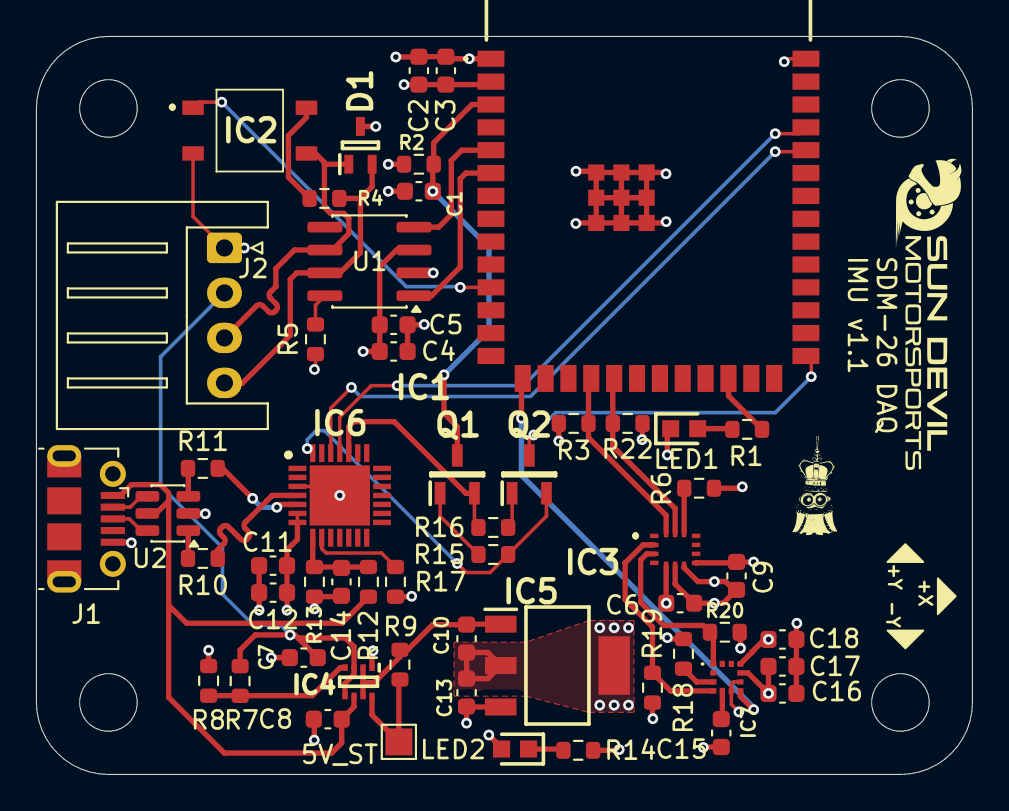
[picture p250: board SDM26_IMU_V1.1.kicad_pcb from above]

Board: 4 copper layers, 52.0 x 41.0 mm, 60 parts (0 on the bottom side), 41 nets.
