sundevilmotorsports/pcb-dev/canboard/can_board.kicad_sch

## KiCad design canboard/can_board.kicad_sch (2023-01-27)

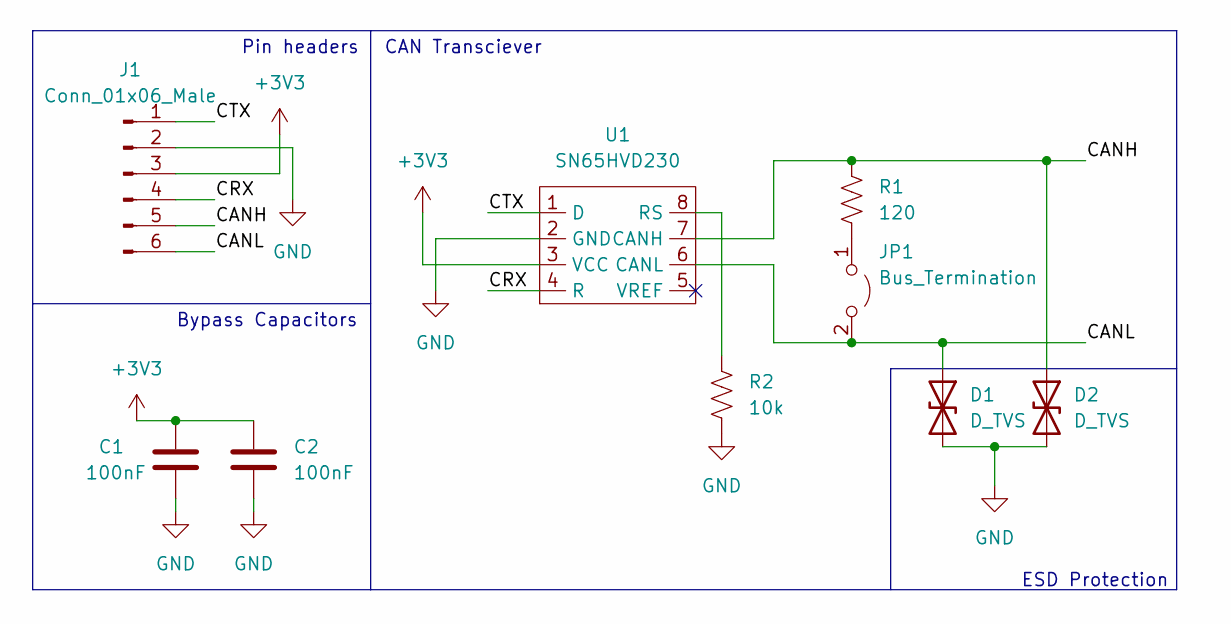
[picture p251: schematic can_board.kicad_sch]

Parts:
C1, C2: 100nF; C_0402_1005Metric
D1, D2: D_TVS; D_SOD-323
J1: Conn_01x06_Male; PinHeader_1x06_P2.54mm_Vertical
JP1: Bus_Termination; PinHeader_1x02_P2.54mm_Vertical
R1: 120; R_0603_1608Metric
R2: 10k; R_1206_3216Metric
U1: SN65HVD230; SOIC-8_3.9x4.9mm_P1.27mm

Connections:
+3V3: C1.1, C2.1, J1.3, U1.3 (VCC)
CANH: D2.1 (A1), J1.5, R1.1, U1.7 (CANH)
CANL: D1.1 (A1), J1.6, JP1.2 (B), U1.6 (CANL)
CRX: J1.4, U1.4 (R)
CTX: J1.1, U1.1 (D)
GND: C1.2, C2.2, D1.2 (A2), D2.2 (A2), J1.2, R2.2, U1.2 (GND)
unnamed: JP1.1 (A), R1.2
unnamed: R2.1, U1.8 (RS)

Notes on the sheet:
Bypass Capacitors
Pin headers
ESD Protection
CAN Transciever
