sundevilmotorsports/pcb-dev/sdm22main/sdm22main.kicad_sch

## KiCad design sdm22main/sdm22main.kicad_sch (2022-04-23)

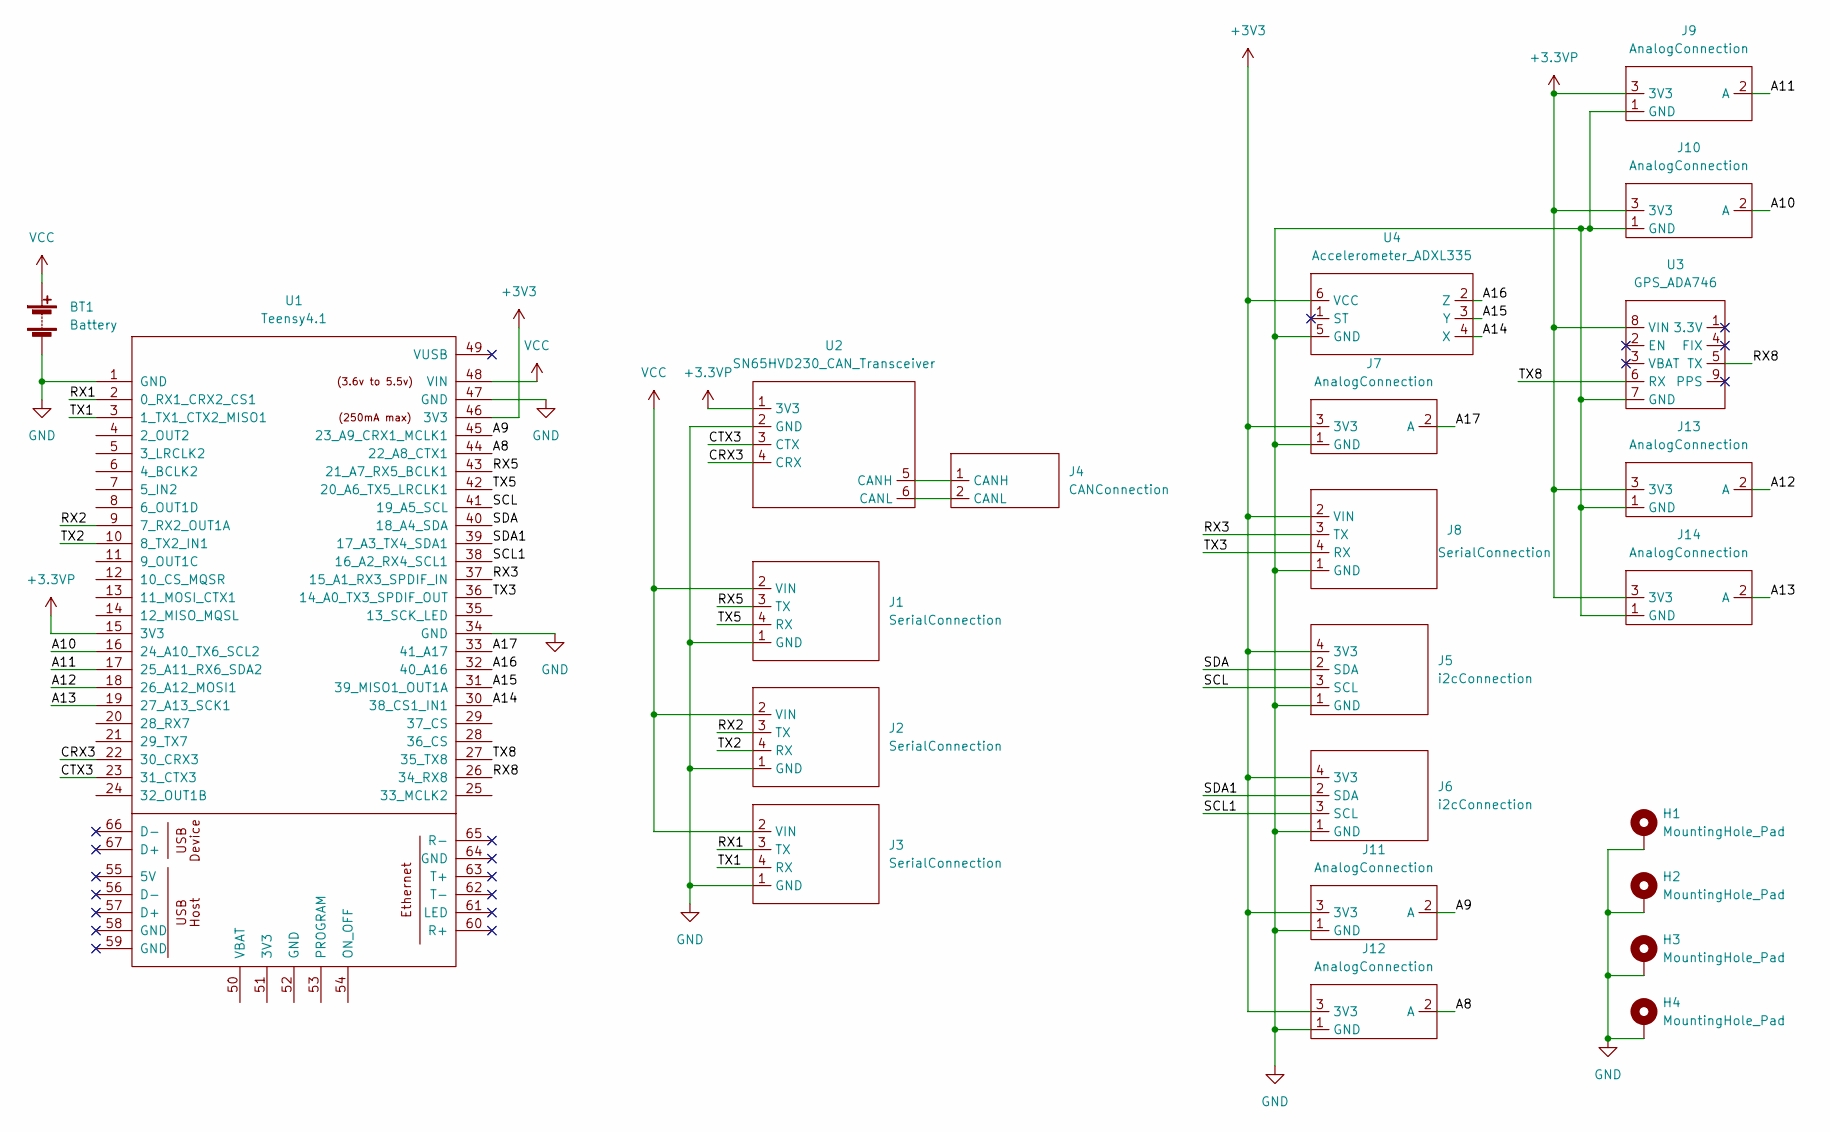
[picture p252: schematic sdm22main.kicad_sch]

Parts:
BT1: Battery; 2Wire_PWRConnector
H1, H2, H3, H4: MountingHole_Pad; MountingHole_3.2mm_M3_ISO7380_Pad
J1, J2, J3, J8: SerialConnection; 4Wire_SerialConnector
J4: CANConnection; 2Wire_CANConnector
J5, J6: i2cConnection; 4Wire_i2cConnector
J7, J9, J10, J11, J12, J13, J14: AnalogConnection; 3Wire_AnalogConnector
U1: Teensy4.1; Teensy41
U2: SN65HVD230_CAN_Transceiver; SN65HVD230_Socket_P2.54mm_Vertical
U3: GPS_ADA746; ADA746_Socket_P2.54mm_Vertical
U4: Accelerometer_ADXL335; ADXL335_Socket_P2.54mm_Vertical

Connections:
+3.3VP: J9.3 (3V3), J10.3 (3V3), J13.3 (3V3), J14.3 (3V3), U1.15 (3V3), U2.1 (3V3), U3.8 (VIN)
+3V3: J5.4 (3V3), J6.4 (3V3), J7.3 (3V3), J8.2 (VIN), J11.3 (3V3), J12.3 (3V3), U1.46 (3V3), U4.6 (VCC)
A8: J12.2 (A), U1.44 (22_A8_CTX1)
A9: J11.2 (A), U1.45 (23_A9_CRX1_MCLK1)
A10: J10.2 (A), U1.16 (24_A10_TX6_SCL2)
A11: J9.2 (A), U1.17 (25_A11_RX6_SDA2)
A12: J13.2 (A), U1.18 (26_A12_MOSI1)
A13: J14.2 (A), U1.19 (27_A13_SCK1)
A14: U1.30 (38_CS1_IN1), U4.4 (X)
A15: U1.31 (39_MISO1_OUT1A), U4.3 (Y)
A16: U1.32 (40_A16), U4.2 (Z)
A17: J7.2 (A), U1.33 (41_A17)
CRX3: U1.22 (30_CRX3), U2.4 (CRX)
CTX3: U1.23 (31_CTX3), U2.3 (CTX)
GND: BT1.2 (-), H1.1, H2.1, H3.1, H4.1, J1.1 (GND), J2.1 (GND), J3.1 (GND), J5.1 (GND), J6.1 (GND), J7.1 (GND), J8.1 (GND), J9.1 (GND), J10.1 (GND), J11.1 (GND), J12.1 (GND), J13.1 (GND), J14.1 (GND), U1.1 (GND), U1.34 (GND), U1.47 (GND), U2.2 (GND), U3.7 (GND), U4.5 (GND)
unnamed: J4.1 (CANH), U2.5 (CANH)
unnamed: J4.2 (CANL), U2.6 (CANL)
RX1: J3.3 (TX), U1.2 (0_RX1_CRX2_CS1)
RX2: J2.3 (TX), U1.9 (7_RX2_OUT1A)
RX3: J8.3 (TX), U1.37 (15_A1_RX3_SPDIF_IN)
RX5: J1.3 (TX), U1.43 (21_A7_RX5_BCLK1)
RX8: U1.26 (34_RX8), U3.5 (TX)
SCL: J5.3 (SCL), U1.41 (19_A5_SCL)
SCL1: J6.3 (SCL), U1.38 (16_A2_RX4_SCL1)
SDA: J5.2 (SDA), U1.40 (18_A4_SDA)
SDA1: J6.2 (SDA), U1.39 (17_A3_TX4_SDA1)
TX1: J3.4 (RX), U1.3 (1_TX1_CTX2_MISO1)
TX2: J2.4 (RX), U1.10 (8_TX2_IN1)
TX3: J8.4 (RX), U1.36 (14_A0_TX3_SPDIF_OUT)
TX5: J1.4 (RX), U1.42 (20_A6_TX5_LRCLK1)
TX8: U1.27 (35_TX8), U3.6 (RX)
VCC: BT1.1 (+), J1.2 (VIN), J2.2 (VIN), J3.2 (VIN), U1.48 (VIN)
