sundevilmotorsports/pcb-dev/sdm22wheel/sdm22wheel.kicad_sch

## KiCad design sdm22wheel/sdm22wheel.kicad_sch (2022-04-06)

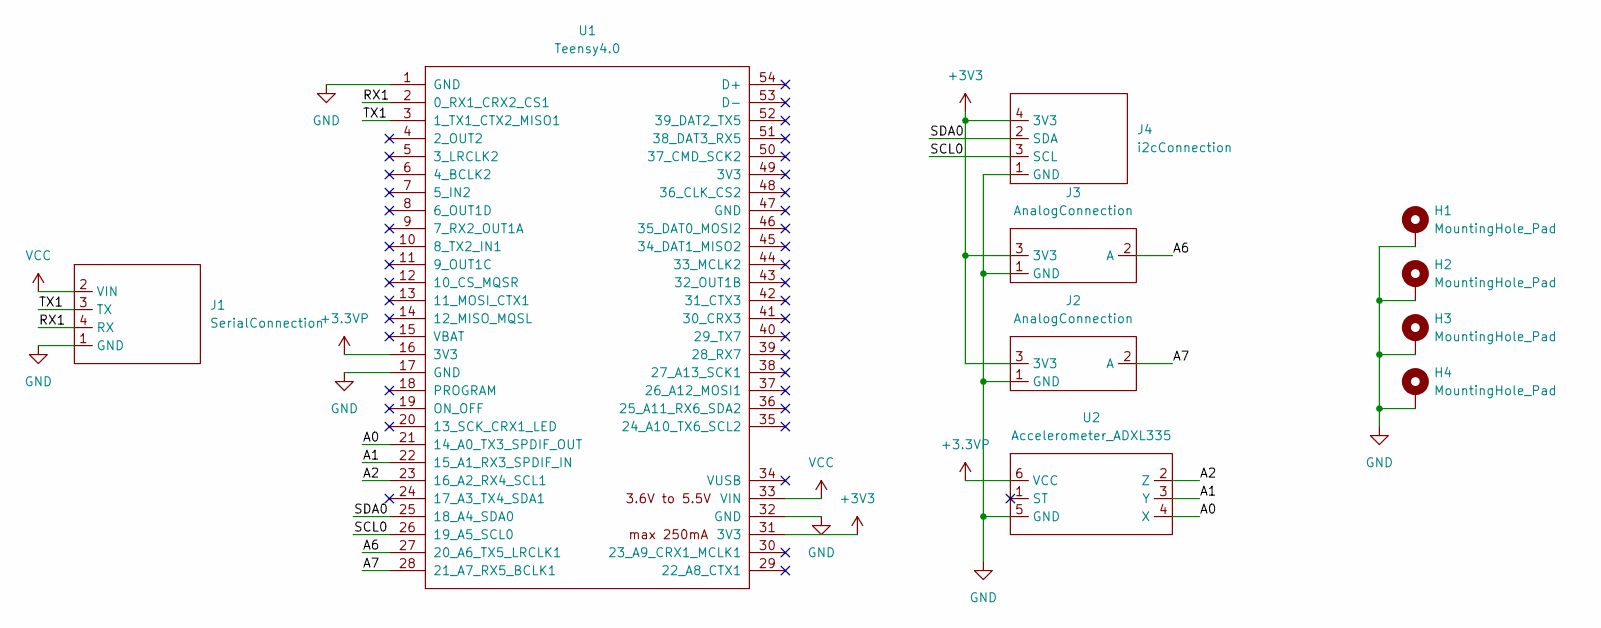
[picture p253: schematic sdm22wheel.kicad_sch]

Parts:
H1, H2, H3, H4: MountingHole_Pad; MountingHole_3.2mm_M3_ISO7380_Pad
J1: SerialConnection; 4Wire_SerialConnector
J2, J3: AnalogConnection; 3Wire_AnalogConnector
J4: i2cConnection; 4Wire_i2cConnector
U1: Teensy4.0; Teensy40
U2: Accelerometer_ADXL335; ADXL335_Socket_P2.54mm_Vertical

Connections:
+3V3: J2.3 (3V3), J3.3 (3V3), J4.4 (3V3), U1.31 (3V3)
A0: U1.21 (14_A0_TX3_SPDIF_OUT), U2.4 (X)
A1: U1.22 (15_A1_RX3_SPDIF_IN), U2.3 (Y)
A2: U1.23 (16_A2_RX4_SCL1), U2.2 (Z)
A6: J3.2 (A), U1.27 (20_A6_TX5_LRCLK1)
A7: J2.2 (A), U1.28 (21_A7_RX5_BCLK1)
GND: H1.1, H2.1, H3.1, H4.1, J1.1 (GND), J2.1 (GND), J3.1 (GND), J4.1 (GND), U1.1 (GND), U1.17 (GND), U1.32 (GND), U2.5 (GND)
RX1: J1.4 (RX), U1.2 (0_RX1_CRX2_CS1)
SCL0: J4.3 (SCL), U1.26 (19_A5_SCL0)
SDA0: J4.2 (SDA), U1.25 (18_A4_SDA0)
TX1: J1.3 (TX), U1.3 (1_TX1_CTX2_MISO1)
VCC: J1.2 (VIN), U1.33 (VIN)
