sundevilmotorsports/pcb-dev/sdm23front-rear/sdm23front-rear1.kicad_sch

## KiCad design sdm23front-rear/sdm23front-rear1.kicad_sch (2022-12-12)

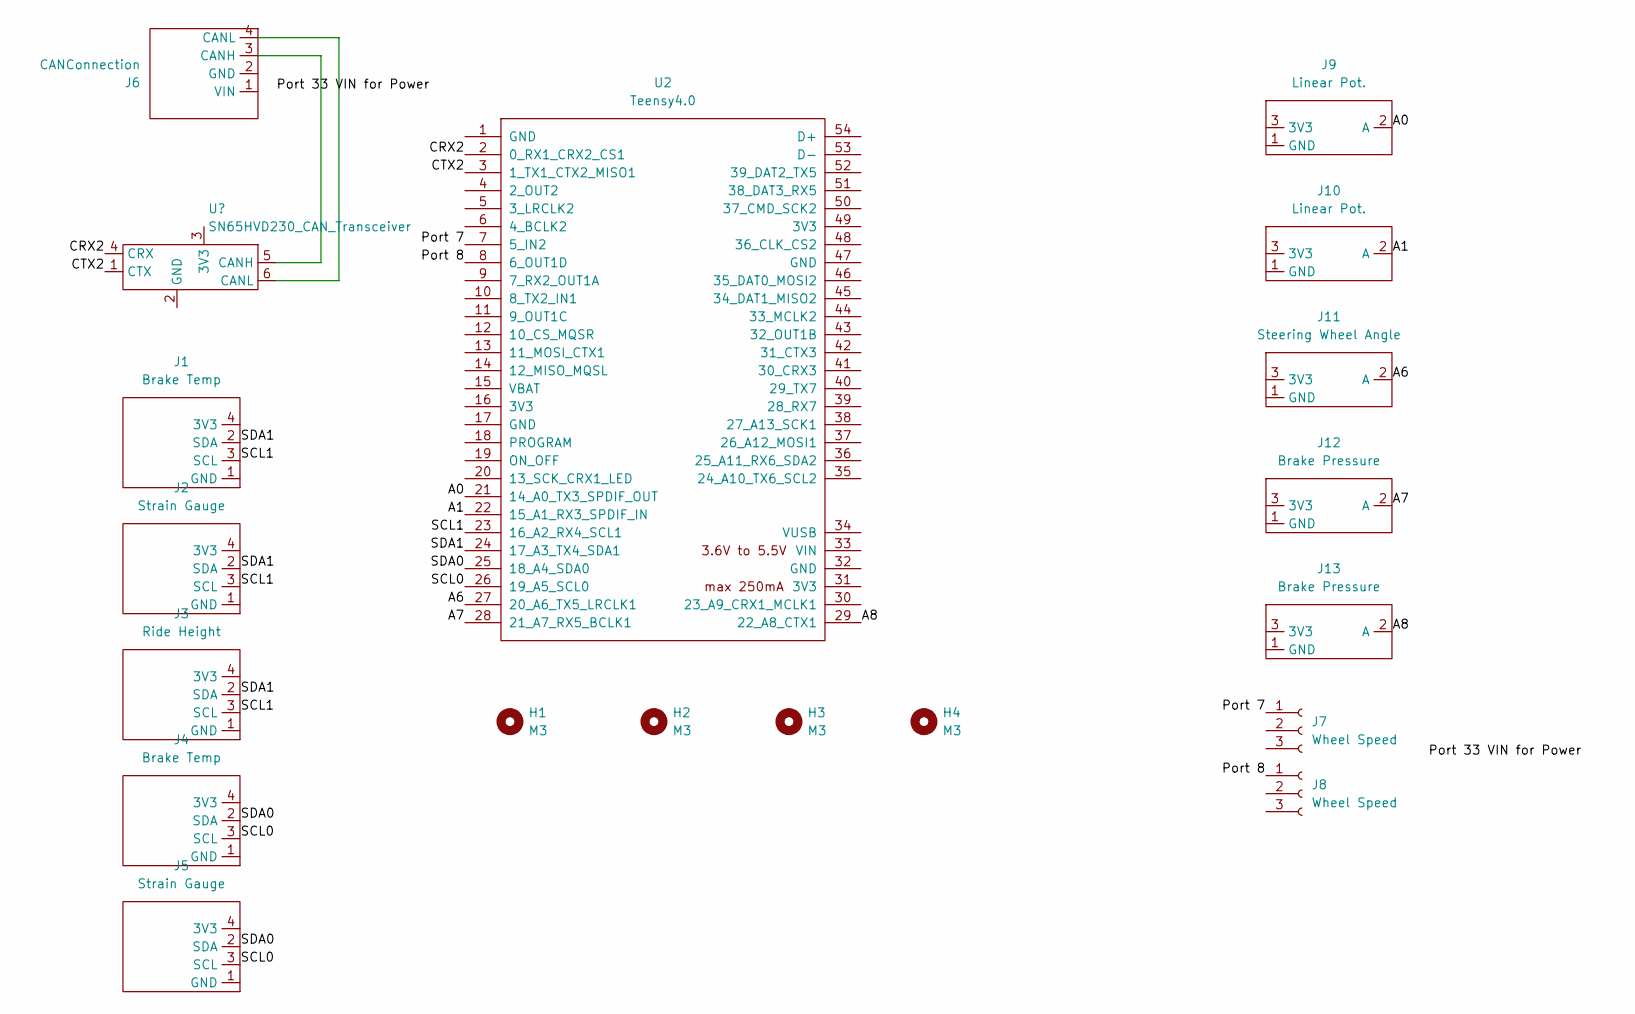
[picture p254: schematic sdm23front-rear1.kicad_sch]

Parts:
H1, H2, H3, H4: M3; MountingHole_3.2mm_M3
J1, J4: Brake Temp; TerminalBlock_TE_282834-4_1x04_P2.54mm_Horizontal
J2, J5: Strain Gauge; TerminalBlock_TE_282834-4_1x04_P2.54mm_Horizontal
J3: Ride Height; TerminalBlock_TE_282834-4_1x04_P2.54mm_Horizontal
J6: CANConnection; TerminalBlock_TE_282834-4_1x04_P2.54mm_Horizontal
J7, J8: Wheel Speed
J9, J10: Linear Pot.
J11: Steering Wheel Angle
J12, J13: Brake Pressure
U2: Teensy4.0

Connections:
A0: J9.2 (A), U2.21 (14_A0_TX3_SPDIF_OUT)
A1: J10.2 (A), U2.22 (15_A1_RX3_SPDIF_IN)
A6: J11.2 (A), U2.27 (20_A6_TX5_LRCLK1)
A7: J12.2 (A), U2.28 (21_A7_RX5_BCLK1)
A8: J13.2 (A), U2.29 (22_A8_CTX1)
CRX2: U2.2 (0_RX1_CRX2_CS1)
CTX2: U2.3 (1_TX1_CTX2_MISO1)
Port 7: J7.1, U2.7 (5_IN2)
Port 8: J8.1, U2.8 (6_OUT1D)
SCL0: J4.3 (SCL), J5.3 (SCL), U2.26 (19_A5_SCL0)
SCL1: J1.3 (SCL), J2.3 (SCL), J3.3 (SCL), U2.23 (16_A2_RX4_SCL1)
SDA0: J4.2 (SDA), J5.2 (SDA), U2.25 (18_A4_SDA0)
SDA1: J1.2 (SDA), J2.2 (SDA), J3.2 (SDA), U2.24 (17_A3_TX4_SDA1)
