sundevilmotorsports/pcb-dev/sdm25wheel/sdm24wheel.kicad_sch

## KiCad design sdm25wheel/sdm24wheel.kicad_sch (2024-08-31)

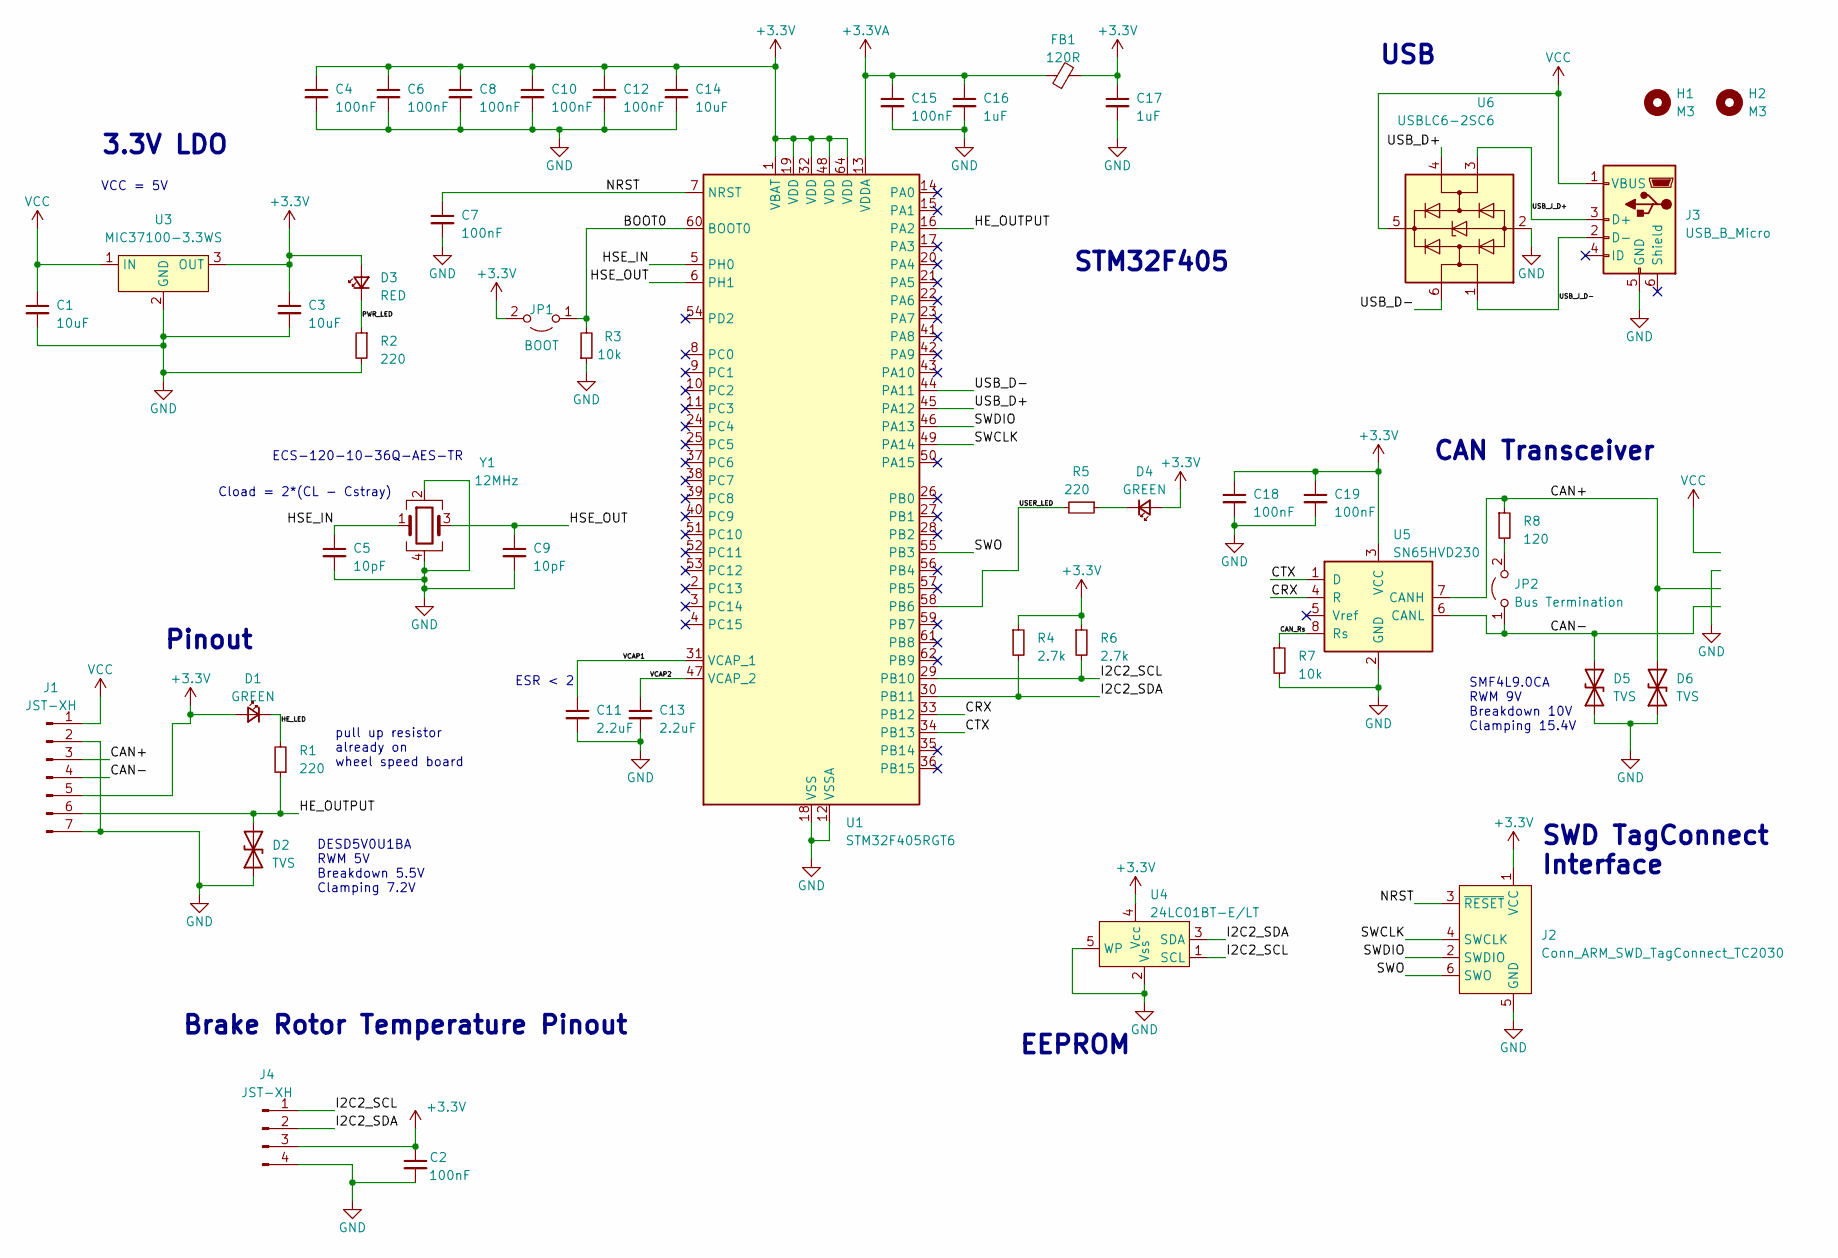
[picture p255: schematic sdm24wheel.kicad_sch]

Parts:
C1, C3, C14: 10uF; C_0805_2012Metric
C2, C4, C6, C7, C8, C10, C12, C15, C18, C19: 100nF; C_0402_1005Metric
C5, C9: 10pF; C_0402_1005Metric
C11, C13: 2.2uF; C_0603_1608Metric
C16, C17: 1uF; C_0603_1608Metric
D1: GREEN; Dialight_561-XX0X-XXX
D2: TVS; D_SOD-323
D3: RED; Dialight_561-XX0X-XXX
D4: GREEN; LED_0805_2012Metric
D5, D6: TVS; SOD-123FL
FB1: 120R; L_0603_1608Metric
H1, H2: M3; MountingHole_3.2mm_M3
J1: JST-XH; JST_XH_B7B-XH-A_1x07_P2.50mm_Vertical
J2: Conn_ARM_SWD_TagConnect_TC2030; Tag-Connect_TC2030-IDC-NL_2x03_P1.27mm_Vertical
J3: USB_B_Micro; USB_Micro-B_Molex-105017-0001
J4: JST-XH; JST_XH_B4B-XH-A_1x04_P2.50mm_Vertical
JP1: BOOT; PinHeader_1x02_P2.54mm_Vertical
JP2: Bus Termination; PinHeader_1x02_P2.54mm_Vertical
R1, R2, R5: 220; R_0805_2012Metric
R3, R7: 10k; R_0805_2012Metric
R4, R6: 2.7k; R_0603_1608Metric
R8: 120; R_0603_1608Metric
U1: STM32F405RGT6; LQFP-64_10x10mm_P0.5mm
U3: MIC37100-3.3WS; SOT-223-3_TabPin2
U4: 24LC01BT-E/LT; SC-70-5
U5: SN65HVD230; SOIC-8_3.9x4.9mm_P1.27mm
U6: USBLC6-2SC6; SOT-23-6
Y1: 12MHz; Crystal_SMD_2520-4Pin_2.5x2.0mm

Connections:
+3.3V: C2.1, C3.1, C4.1, C6.1, C8.1, C10.1, C12.1, C14.1, C17.1, C18.1, C19.1, D1.2 (A), D3.2 (A), D4.2 (A), FB1.2, J1.5, J2.1 (VCC), J4.3, JP1.2 (B), R4.1, R6.1, U1.1 (VBAT), U1.19 (VDD), U1.32 (VDD), U1.48 (VDD), U1.64 (VDD), U3.3 (OUT), U4.4 (Vcc), U5.3 (VCC)
+3.3VA: C15.1, C16.1, FB1.1, U1.13 (VDDA)
BOOT0: JP1.1 (A), R3.2, U1.60 (BOOT0)
CAN+: D6.2 (A2), J1.3, R8.1, U5.7 (CANH)
CAN-: D5.2 (A2), J1.4, JP2.1 (A), U5.6 (CANL)
CAN_Rs: R7.1, U5.8 (Rs)
CRX: U1.33 (PB12), U5.4 (R)
CTX: U1.34 (PB13), U5.1 (D)
GND: C1.2, C2.2, C3.2, C4.2, C5.2, C6.2, C7.2, C8.2, C9.2, C10.2, C11.2, C12.2, C13.2, C14.2, C15.2, C16.2, C17.2, C18.2, C19.2, D2.1 (A1), D5.1 (A1), D6.1 (A1), J1.2, J1.7, J2.5 (GND), J3.5 (GND), J4.4, R2.2, R3.1, R7.2, U1.12 (VSSA), U1.18 (VSS), U1.63 (VSS), U3.2 (GND), U4.2 (Vss), U4.5 (WP), U5.2 (GND), U6.2 (GND), Y1.2, Y1.4
HE_LED: D1.1 (K), R1.2
HE_OUTPUT: D2.2 (A2), J1.6, R1.1, U1.16 (PA2)
HSE_IN: C5.1, U1.5 (PH0), Y1.1
HSE_OUT: C9.1, U1.6 (PH1), Y1.3
I2C2_SCL: J4.1, R6.2, U1.29 (PB10), U4.1 (SCL)
I2C2_SDA: J4.2, R4.2, U1.30 (PB11), U4.3 (SDA)
NRST: C7.1, J2.3 (~RESET), U1.7 (NRST)
unnamed: D4.1 (K), R5.1
unnamed: JP2.2 (B), R8.2
PWR_LED: D3.1 (K), R2.1
SWCLK: J2.4 (SWCLK), U1.49 (PA14)
SWDIO: J2.2 (SWDIO), U1.46 (PA13)
SWO: J2.6 (SWO), U1.55 (PB3)
USB_D+: U1.45 (PA12), U6.4 (I/O2)
USB_D-: U1.44 (PA11), U6.6 (I/O1)
USB_J_D+: J3.3 (D+), U6.3 (I/O2)
USB_J_D-: J3.2 (D-), U6.1 (I/O1)
USER_LED: R5.2, U1.58 (PB6)
VCAP1: C11.1, U1.31 (VCAP_1)
VCAP2: C13.1, U1.47 (VCAP_2)
VCC: C1.1, J1.1, J3.1 (VBUS), U3.1 (IN), U6.5 (VBUS)

Notes on the sheet:
SWD TagConnect Interface
Brake Rotor Temperature Pinout
EEPROM
USB
DESD5V0U1BA RWM 5V Breakdown 5.5V Clamping 7.2V
pull up resistor already on wheel speed board
STM32F405
ESR < 2
ECS-120-10-36Q-AES-TR
VCC = 5V
Pinout
SMF4L9.0CA RWM 9V Breakdown 10V Clamping 15.4V
3.3V LDO
Cload = 2*(CL - Cstray)
CAN Transceiver
