sundevilmotorsports/pcb-dev/yaw_probe_stm32/yaw_probe_stm32.kicad_sch

## KiCad design yaw_probe_stm32/yaw_probe_stm32.kicad_sch (2022-10-27)

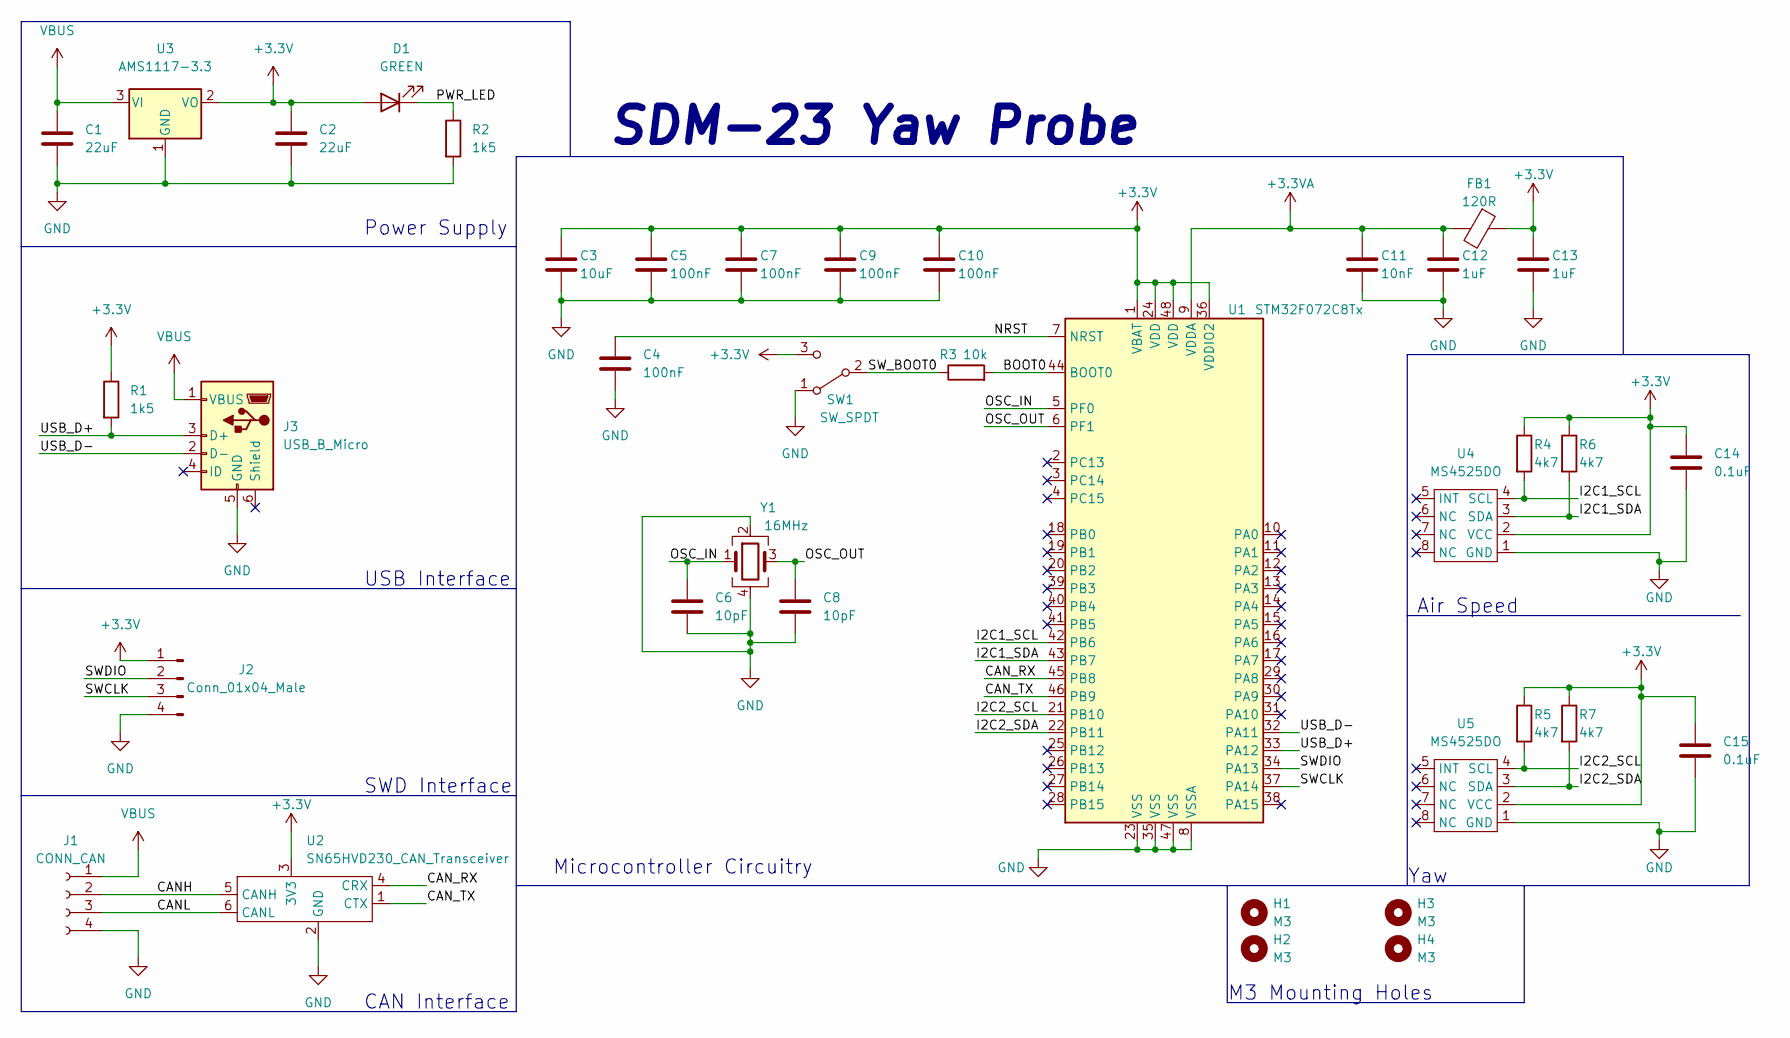
[picture p256: schematic yaw_probe_stm32.kicad_sch]

Parts:
C1, C2: 22uF; C_0805_2012Metric
C3: 10uF; C_0603_1608Metric
C4, C5, C7, C9, C10: 100nF; C_0402_1005Metric
C6, C8: 10pF; C_0402_1005Metric
C11: 10nF; C_0402_1005Metric
C12, C13: 1uF; C_0402_1005Metric
C14, C15: 0.1uF; C_0402_1005Metric
D1: GREEN; LED_0603_1608Metric
FB1: 120R; L_0603_1608Metric
H1, H2, H3, H4: M3; MountingHole_3.2mm_M3
J1: CONN_CAN; TerminalBlock_TE_282834-4_1x04_P2.54mm_Horizontal
J2: Conn_01x04_Male; PinSocket_1x04_P2.54mm_Vertical
J3: USB_B_Micro; USB_Micro-B_Wuerth_629105150521
R1, R2: 1k5; R_0402_1005Metric
R3: 10k; R_0402_1005Metric
R4, R5, R6, R7: 4k7; R_0402_1005Metric
SW1: SW_SPDT; SW_SPDT_PCM12
U1: STM32F072C8Tx; LQFP-48_7x7mm_P0.5mm
U2: SN65HVD230_CAN_Transceiver; SDM_CANBoard_v1
U3: AMS1117-3.3; SOT-223-3_TabPin2
U4, U5: MS4525DO; MS4525-DSvoxxxyP
Y1: 16MHz; Crystal_SMD_3225-4Pin_3.2x2.5mm

Connections:
+3.3V: C2.1, C3.1, C5.1, C7.1, C9.1, C10.1, C13.1, C14.1, C15.1, D1.2 (A), FB1.1, J2.1, R1.1, R4.1, R5.1, R6.1, R7.1, SW1.3 (C), U1.1 (VBAT), U1.24 (VDD), U1.36 (VDDIO2), U1.48 (VDD), U2.3 (3V3), U3.2 (VO), U4.2 (VCC), U5.2 (VCC)
+3.3VA: C11.1, C12.1, FB1.2, U1.9 (VDDA)
BOOT0: R3.2, U1.44 (BOOT0)
CANH: J1.2, U2.5 (CANH)
CANL: J1.3, U2.6 (CANL)
CAN_RX: U1.45 (PB8), U2.4 (CRX)
CAN_TX: U1.46 (PB9), U2.1 (CTX)
GND: C1.2, C2.2, C3.2, C4.2, C5.2, C6.2, C7.2, C8.2, C9.2, C10.2, C11.2, C12.2, C13.2, C14.2, C15.2, J1.4, J2.4, J3.5 (GND), R2.2, SW1.1 (A), U1.8 (VSSA), U1.23 (VSS), U1.35 (VSS), U1.47 (VSS), U2.2 (GND), U3.1 (GND), U4.1 (GND), U5.1 (GND), Y1.2, Y1.4
I2C1_SCL: R4.2, U1.42 (PB6), U4.4 (SCL)
I2C1_SDA: R6.2, U1.43 (PB7), U4.3 (SDA)
I2C2_SCL: R5.2, U1.21 (PB10), U5.4 (SCL)
I2C2_SDA: R7.2, U1.22 (PB11), U5.3 (SDA)
NRST: C4.1, U1.7 (NRST)
OSC_IN: C6.1, U1.5 (PF0), Y1.1
OSC_OUT: C8.1, U1.6 (PF1), Y1.3
PWR_LED: D1.1 (K), R2.1
SWCLK: J2.3, U1.37 (PA14)
SWDIO: J2.2, U1.34 (PA13)
SW_BOOT0: R3.1, SW1.2 (B)
USB_D+: J3.3 (D+), R1.2, U1.33 (PA12)
USB_D-: J3.2 (D-), U1.32 (PA11)
VBUS: C1.1, J1.1, J3.1 (VBUS), U3.3 (VI)

Notes on the sheet:
Yaw
Power Supply
SDM-23 Yaw Probe
USB Interface
Microcontroller Circuitry
M3 Mounting Holes
Air Speed
CAN Interface
SWD Interface
