sundevilmotorsports/pcb-dev/PRE2026/BSPD/BSPD.kicad_sch

## KiCad design PRE2026/BSPD/BSPD.kicad_sch (2025-03-18)

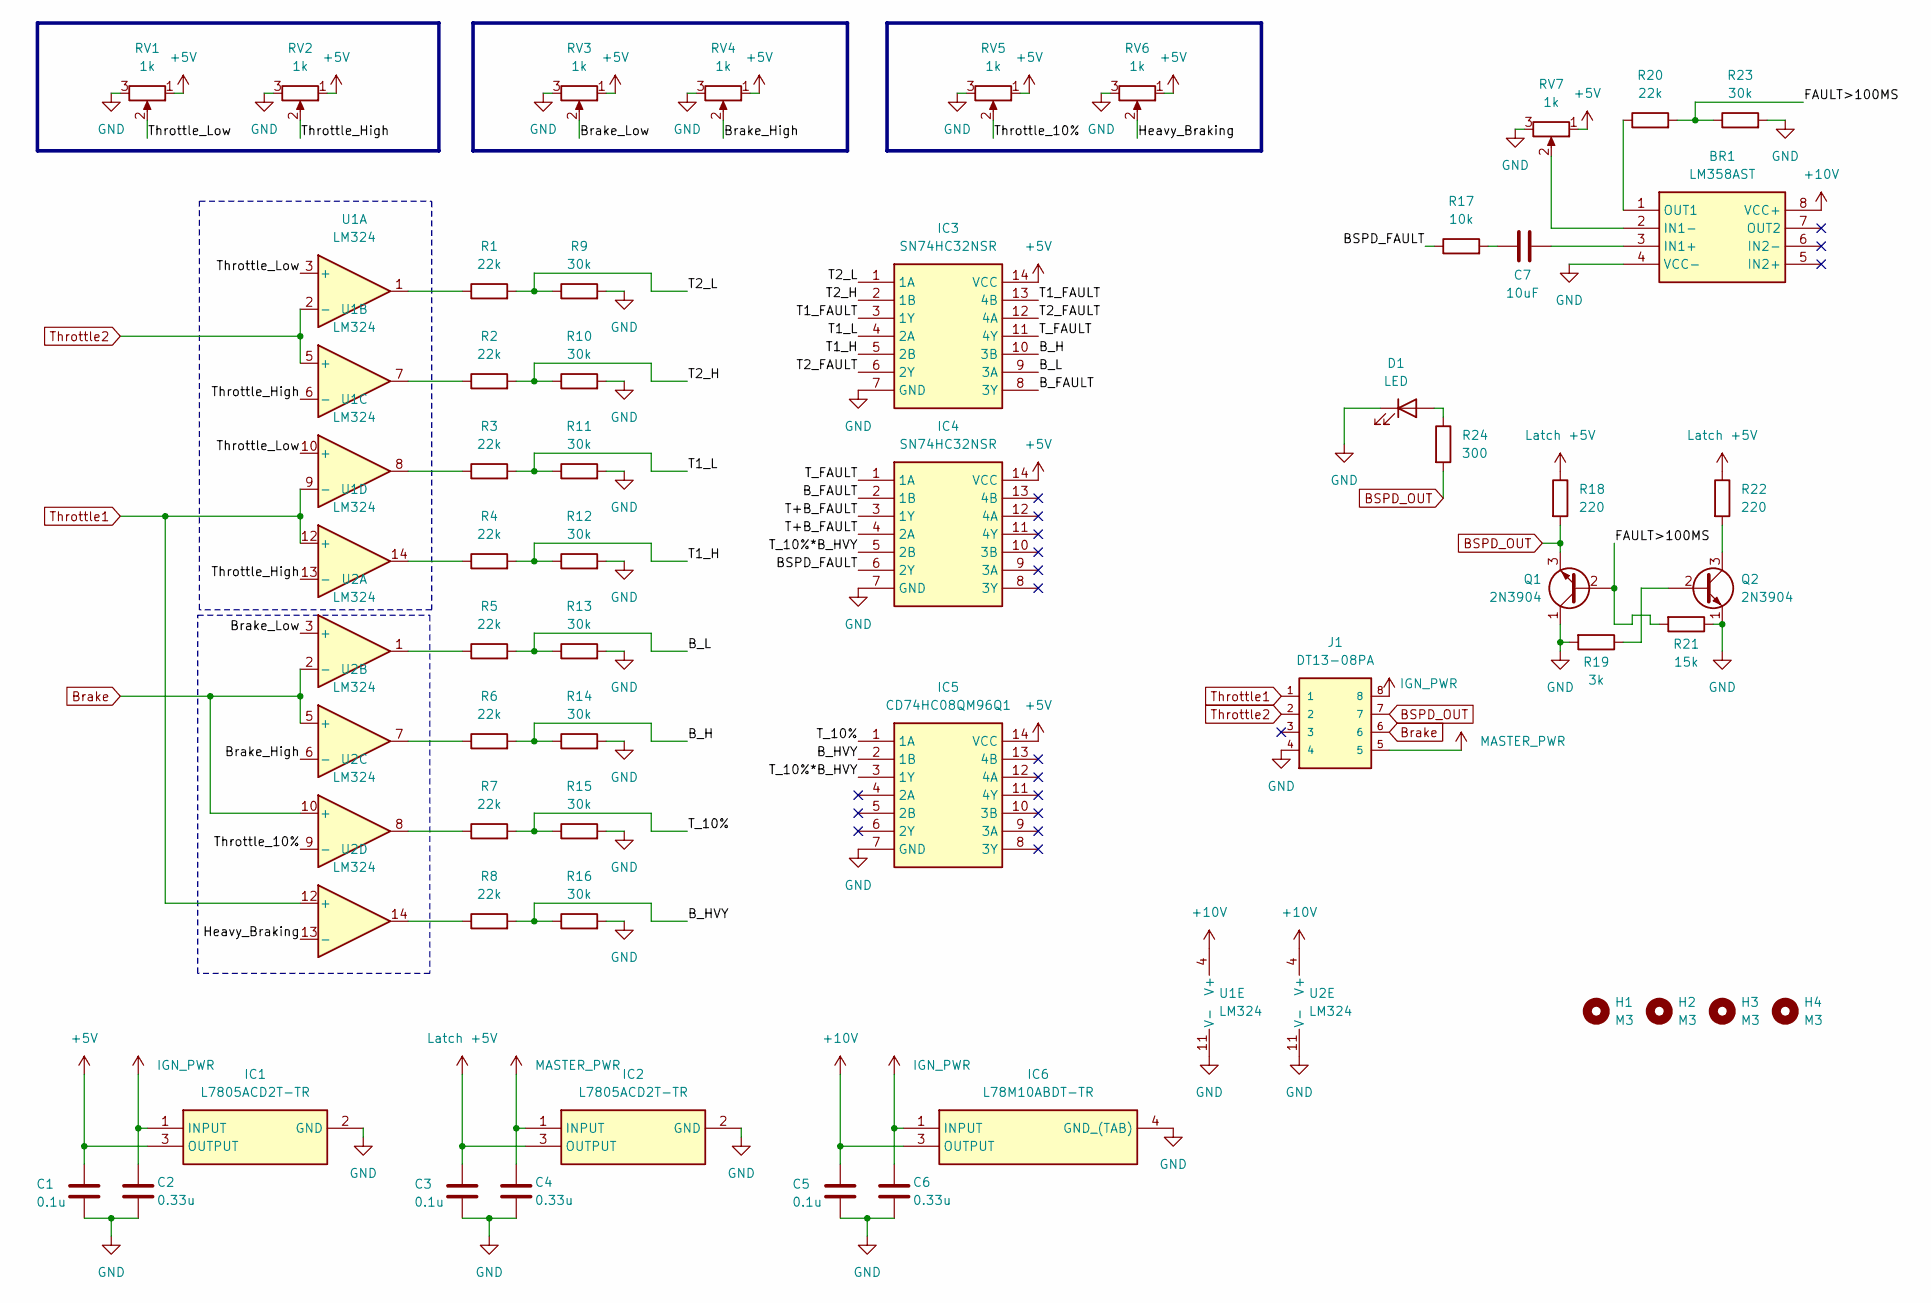
[picture p257: schematic BSPD.kicad_sch]

Parts:
BR1: LM358AST; Mouser Part Number 511-LM358AST
C1, C3, C5: 0.1u; C_0603_1608Metric
C2, C4, C6: 0.33u; C_0603_1608Metric
C7: 10uF; C_0603_1608Metric
D1: LED; LED_0603_1608Metric
H1, H2, H3, H4: M3; MountingHole_3.2mm_M3
IC1, IC2: L7805ACD2T-TR; L7805ACD2TTR; Mouser Part Number 511-L7805ACD2T-TR
IC3, IC4: SN74HC32NSR; SOIC127P780X200-14N; Mouser Part Number 595-SN74HC32NSR
IC5: CD74HC08QM96Q1; SOIC127P600X175-14N; Mouser Part Number 595-CD74HC08QM96Q1
IC6: L78M10ABDT-TR; TO228P972X240-3N; Mouser Part Number 511-L78M10ABDT-TR
J1: DT13-08PA; TE_DT13-08PA; PARTREV C
Q1, Q2: 2N3904; TO-92_Inline
R1, R2, R3, R4, R5, R6, R7, R8, R20: 22k; R_0603_1608Metric
R9, R10, R11, R12, R13, R14, R15, R16, R23: 30k; R_0603_1608Metric
R17: 10k; R_0603_1608Metric
R18, R22: 220; R_0603_1608Metric
R19: 3k; R_0603_1608Metric
R21: 15k; R_0603_1608Metric
R24: 300; R_0603_1608Metric
RV1, RV2, RV3, RV4, RV5, RV6, RV7: 1k; 3362U1104ALF
U1, U2: LM324

Connections:
+5V: C1.1, IC1.3 (OUTPUT), IC3.14 (VCC), IC4.14 (VCC), IC5.14 (VCC), RV1.1, RV2.1, RV3.1, RV4.1, RV5.1, RV6.1, RV7.1
+10V: BR1.8 (VCC+), C5.1, IC6.3 (OUTPUT), U1.4 (V+), U2.4 (V+)
BSPD_FAULT: IC4.6 (2Y), R17.1
BSPD_OUT: J1.7, Q1.3 (C), R18.2, R24.2
B_FAULT: IC3.8 (3Y), IC4.2 (1B)
B_H: IC3.10 (3B), R6.2, R14.1
B_HVY: IC5.2 (1B), R8.2, R16.1
B_L: IC3.9 (3A), R5.2, R13.1
Brake: J1.6, U2.2 (-), U2.5 (+), U2.10 (+)
Brake_High: RV4.2, U2.6 (-)
Brake_Low: RV3.2, U2.3 (+)
FAULT>100MS: Q1.2 (B), R20.2, R21.2, R23.1
GND: BR1.4 (VCC-), C1.2, C2.2, C3.2, C4.2, C5.2, C6.2, D1.1 (K), IC1.2 (GND), IC2.2 (GND), IC3.7 (GND), IC4.7 (GND), IC5.7 (GND), IC6.4 (GND_(TAB)), J1.4, Q1.1 (E), Q2.1 (E), R9.2, R10.2, R11.2, R12.2, R13.2, R14.2, R15.2, R16.2, R19.2, R21.1, R23.2, RV1.3, RV2.3, RV3.3, RV4.3, RV5.3, RV6.3, RV7.3, U1.11 (V-), U2.11 (V-)
Heavy_Braking: RV6.2, U2.13 (-)
IGN_PWR: C2.1, C6.1, IC1.1 (INPUT), IC6.1 (INPUT), J1.8
Latch +5V: C3.1, IC2.3 (OUTPUT), R18.1, R22.1
MASTER_PWR: C4.1, IC2.1 (INPUT), J1.5
unnamed: BR1.1 (OUT1), R20.1
unnamed: BR1.2 (IN1-), RV7.2
unnamed: BR1.3 (IN1+), C7.2
unnamed: C7.1, R17.2
unnamed: D1.2 (A), R24.1
unnamed: Q2.2 (B), R19.1
unnamed: Q2.3 (C), R22.2
unnamed: R1.1, U1.1
unnamed: R2.1, U1.7
unnamed: R3.1, U1.8
unnamed: R4.1, U1.14
unnamed: R5.1, U2.1
unnamed: R6.1, U2.7
unnamed: R7.1, U2.8
unnamed: R8.1, U2.14
T1_FAULT: IC3.3 (1Y), IC3.13 (4B)
T1_H: IC3.5 (2B), R4.2, R12.1
T1_L: IC3.4 (2A), R3.2, R11.1
T2_FAULT: IC3.6 (2Y), IC3.12 (4A)
T2_H: IC3.2 (1B), R2.2, R10.1
T2_L: IC3.1 (1A), R1.2, R9.1
T+B_FAULT: IC4.3 (1Y), IC4.4 (2A)
T_10%: IC5.1 (1A), R7.2, R15.1
T_10%*B_HVY: IC4.5 (2B), IC5.3 (1Y)
T_FAULT: IC3.11 (4Y), IC4.1 (1A)
Throttle1: J1.1, U1.9 (-), U1.12 (+), U2.12 (+)
Throttle2: J1.2, U1.2 (-), U1.5 (+)
Throttle_10%: RV5.2, U2.9 (-)
Throttle_High: RV2.2, U1.6 (-), U1.13 (-)
Throttle_Low: RV1.2, U1.3 (+), U1.10 (+)
