sundevilmotorsports/pcb-dev/PRE2026/IMUBox/IMUBox.kicad_sch

## KiCad design PRE2026/IMUBox/IMUBox.kicad_sch (2023-11-09)

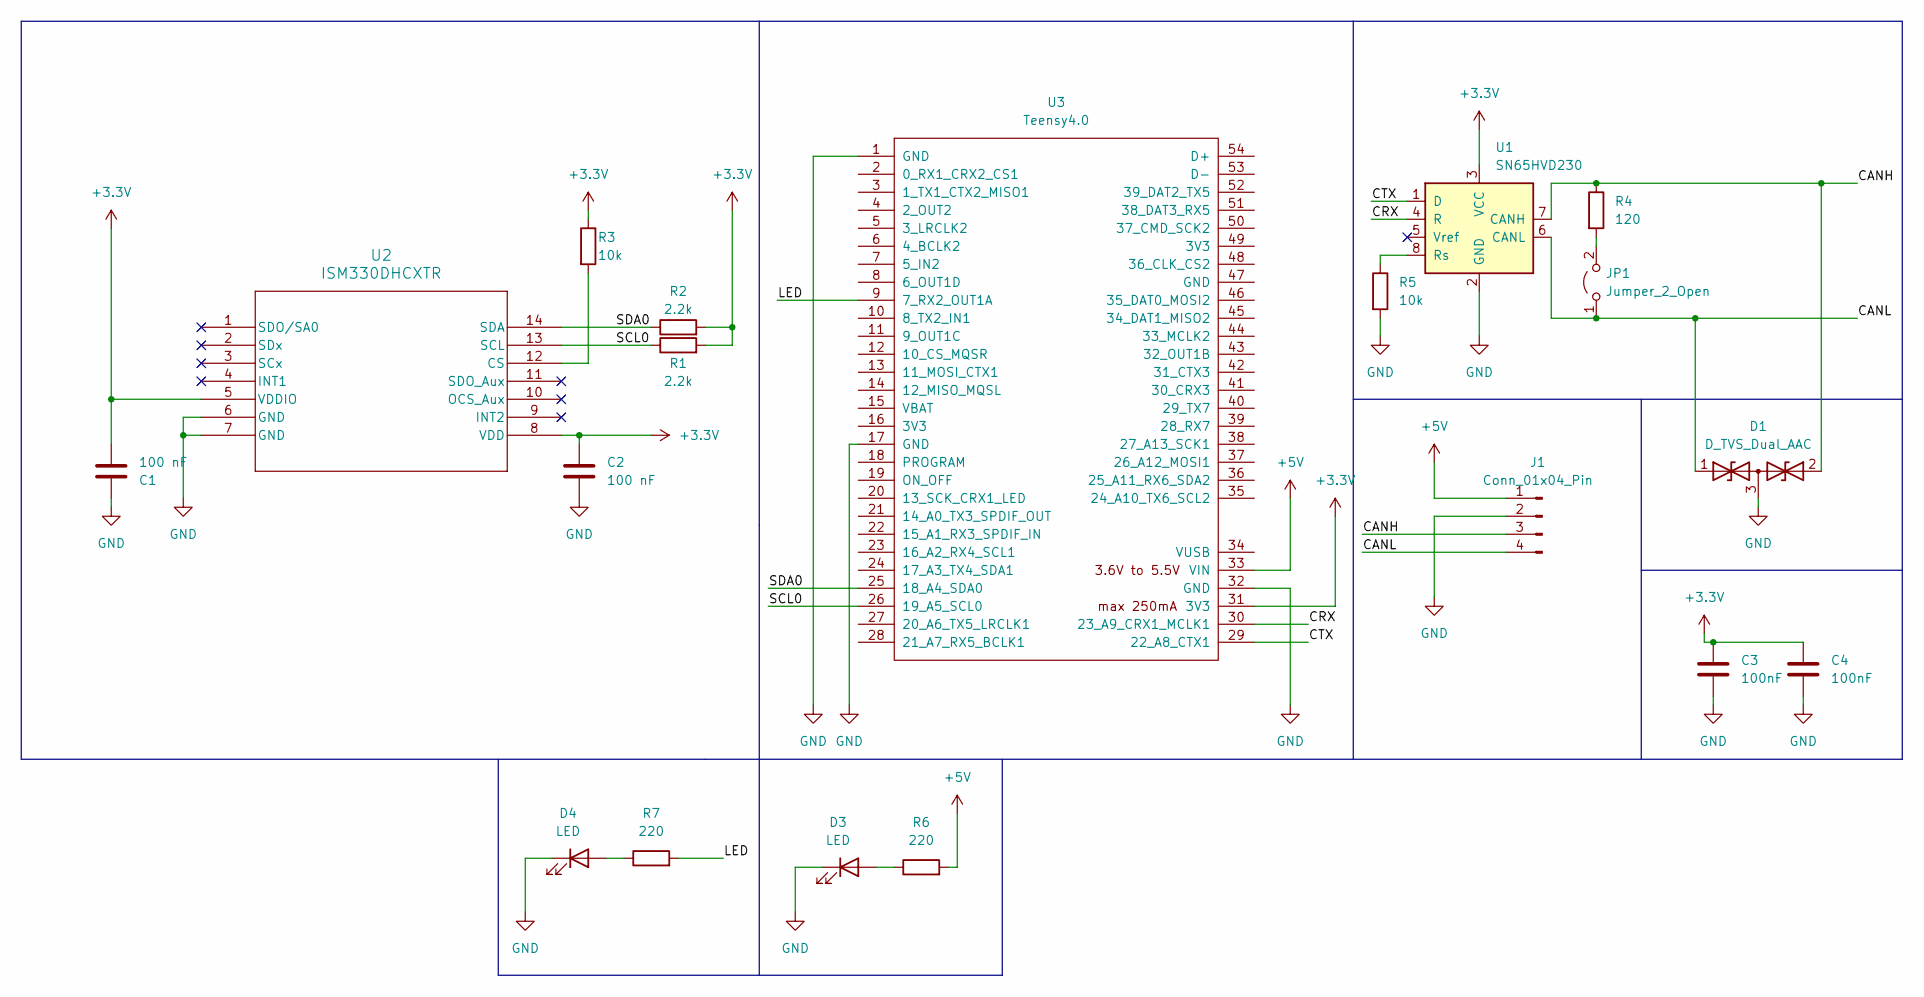
[picture p258: schematic IMUBox.kicad_sch]

Parts:
C1, C2: 100 nF; C_0402_1005Metric
C3, C4: 100nF; C_0402_1005Metric
D1: D_TVS_Dual_AAC; SOT-323_SC-70
D3, D4: LED; LED_1206_3216Metric
J1: Conn_01x04_Pin; JST_XA_B04B-XASK-1_1x04_P2.50mm_Vertical
JP1: Jumper_2_Open; PinHeader_1x02_P2.54mm_Vertical
R1, R2: 2.2k; R_0603_1608Metric
R3, R5: 10k; R_0805_2012Metric
R4: 120; R_0402_1005Metric
R6, R7: 220; R_0805_2012Metric
U1: SN65HVD230; SOIC-8_3.9x4.9mm_P1.27mm
U2: ISM330DHCXTR; LGA-14L
U3: Teensy4.0; Teensy40

Connections:
+3.3V: C1.2, C2.1, C3.1, C4.1, R1.2, R2.2, R3.1, U1.3 (VCC), U2.5 (VDDIO), U2.8 (VDD), U3.31 (3V3)
+5V: J1.1, R6.2, U3.33 (VIN)
CANH: D1.2 (A2), J1.3, R4.1, U1.7 (CANH)
CANL: D1.1 (A1), J1.4, JP1.1 (A), U1.6 (CANL)
CRX: U1.4 (R), U3.30 (23_A9_CRX1_MCLK1)
CTX: U1.1 (D), U3.29 (22_A8_CTX1)
GND: C1.1, C2.2, C3.2, C4.2, D1.3 (common), D3.1 (K), D4.1 (K), J1.2, R5.2, U1.2 (GND), U2.6 (GND), U2.7 (GND), U3.1 (GND), U3.17 (GND), U3.32 (GND)
LED: R7.2, U3.9 (7_RX2_OUT1A)
unnamed: D3.2 (A), R6.1
unnamed: D4.2 (A), R7.1
unnamed: JP1.2 (B), R4.2
unnamed: R3.2, U2.12 (CS)
unnamed: R5.1, U1.8 (Rs)
SCL0: R1.1, U2.13 (SCL), U3.26 (19_A5_SCL0)
SDA0: R2.1, U2.14 (SDA), U3.25 (18_A4_SDA0)
