sundevilmotorsports/pcb-dev/PRE2026/ONVEHICLE/ONVEHICLE.kicad_sch

## KiCad design PRE2026/ONVEHICLE/ONVEHICLE.kicad_sch (2024-01-15)

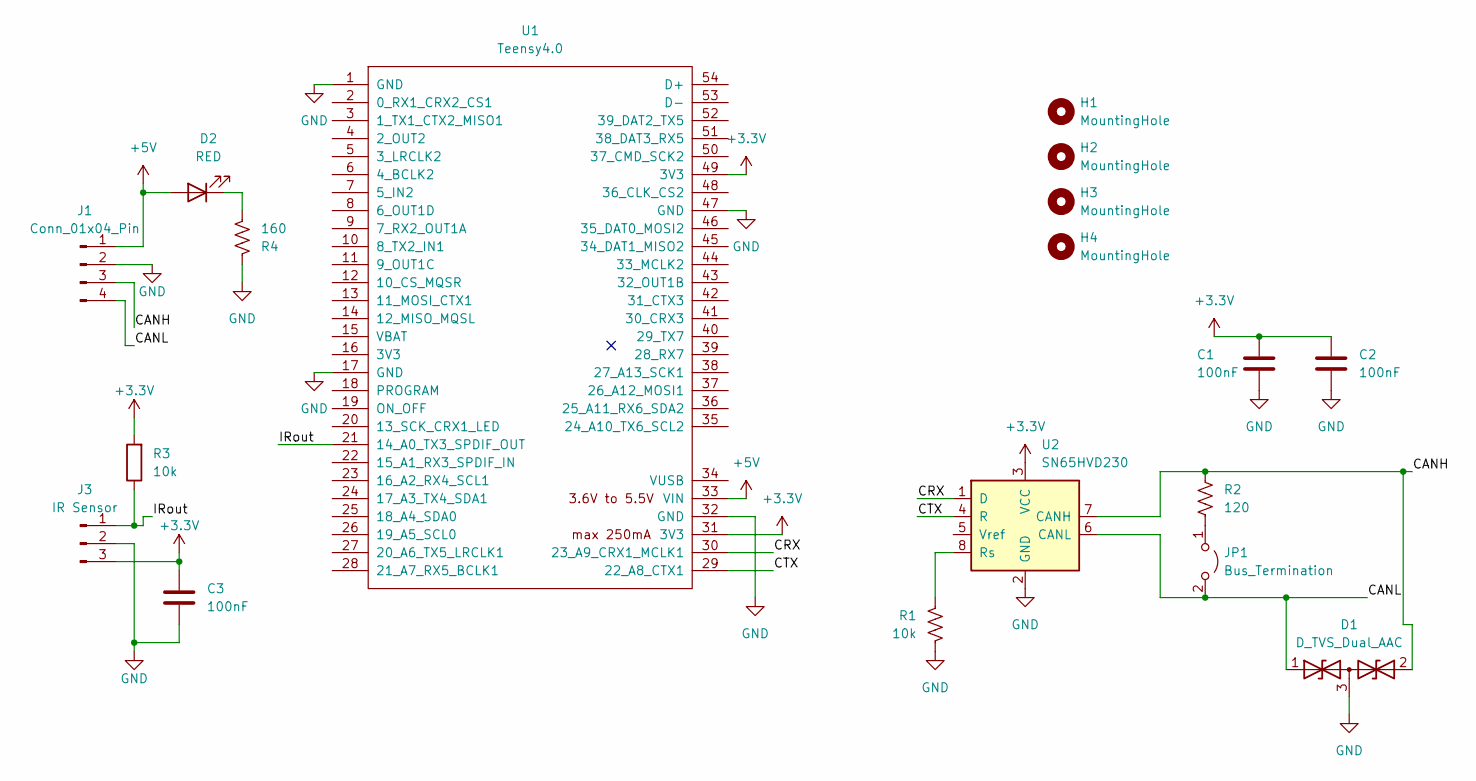
[picture p259: schematic ONVEHICLE.kicad_sch]

Parts:
C1, C2, C3: 100nF; C_0603_1608Metric
D1: D_TVS_Dual_AAC; SOT-323_SC-70
D2: RED; LED_1206_3216Metric
H1, H2, H3, H4: MountingHole; MountingHole_3.2mm_M3
J1: Conn_01x04_Pin; JST_XH_B4B-XH-AM_1x04_P2.50mm_Vertical
J3: IR Sensor; PinSocket_1x03_P2.54mm_Vertical
JP1: Bus_Termination; PinHeader_1x02_P2.54mm_Vertical
R1: 10k; R_0805_2012Metric
R2: 120; R_0603_1608Metric
R3: 10k; R_0805_2012Metric_Pad1.20x1.40mm_HandSolder
R4: 160; R_0805_2012Metric
U1: Teensy4.0; Teensy40
U2: SN65HVD230; SOIC-8_3.9x4.9mm_P1.27mm

Connections:
+3.3V: C1.1, C2.1, C3.2, J3.3, R3.2, U1.31 (3V3), U1.49 (3V3), U2.3 (VCC)
+5V: D2.2 (A), J1.1, U1.33 (VIN)
CANH: D1.2 (A2), J1.3, R2.1, U2.7 (CANH)
CANL: D1.1 (A1), J1.4, JP1.2 (B), U2.6 (CANL)
CRX: U1.30 (23_A9_CRX1_MCLK1), U2.1 (D)
CTX: U1.29 (22_A8_CTX1), U2.4 (R)
GND: C1.2, C2.2, C3.1, D1.3 (common), J1.2, J3.2, R1.2, R4.1, U1.1 (GND), U1.17 (GND), U1.32 (GND), U1.47 (GND), U2.2 (GND)
IRout: J3.1, R3.1, U1.21 (14_A0_TX3_SPDIF_OUT)
unnamed: D2.1 (K), R4.2
unnamed: JP1.1 (A), R2.2
unnamed: R1.1, U2.8 (Rs)
