sundevilmotorsports/pcb-dev/PRE2026/SDM24-Shifter/SDM24-Shifter.kicad_sch

## KiCad design PRE2026/SDM24-Shifter/SDM24-Shifter.kicad_sch (2024-02-01)

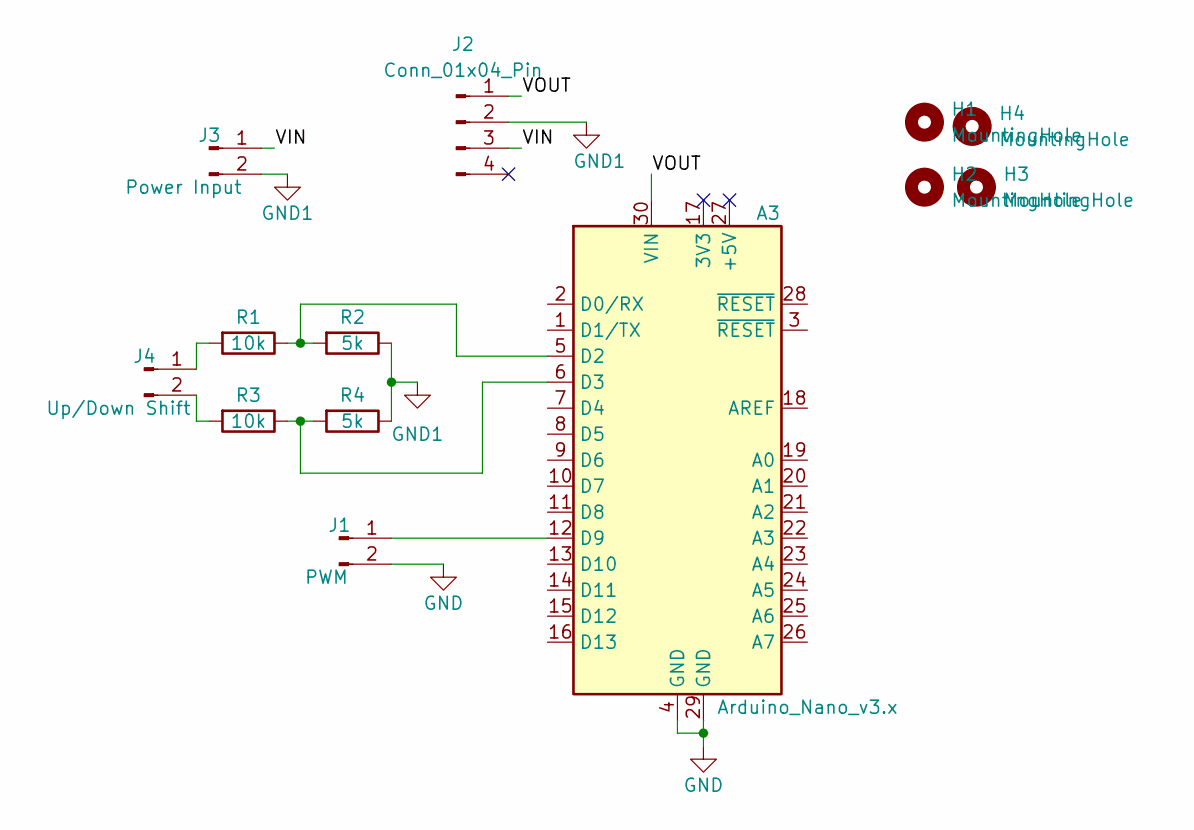
[picture p260: schematic SDM24-Shifter.kicad_sch]

Parts:
A3: Arduino_Nano_v3.x; Arduino_Nano
H1, H2, H3, H4: MountingHole; MountingHole_3.2mm_M3
J1: PWM; JST_XH_B2B-XH-A_1x02_P2.50mm_Vertical
J2: Conn_01x04_Pin; PinHeader_1x04_P2.54mm_Vertical
J3: Power Input; JST_XH_B2B-XH-A_1x02_P2.50mm_Vertical
J4: Up/Down Shift; JST_XH_B2B-XH-A_1x02_P2.50mm_Vertical
R1, R3: 10k; R_Axial_DIN0207_L6.3mm_D2.5mm_P7.62mm_Horizontal
R2, R4: 5k; R_Axial_DIN0207_L6.3mm_D2.5mm_P7.62mm_Horizontal

Connections:
GND: A3.4 (GND), A3.29 (GND), J1.2
GND1: J2.2, J3.2, R2.1, R4.1
unnamed: A3.5 (D2), R1.1, R2.2
unnamed: A3.6 (D3), R3.1, R4.2
unnamed: A3.12 (D9), J1.1
unnamed: J4.1, R1.2
unnamed: J4.2, R3.2
VIN: J2.3, J3.1
VOUT: A3.30 (VIN), J2.1
