sundevilmotorsports/pcb-dev/PRE2026/SDM25_IMU_STM32/SDM25_IMU_STM32.kicad_sch

## KiCad design PRE2026/SDM25_IMU_STM32/SDM25_IMU_STM32.kicad_sch (2025-04-05)

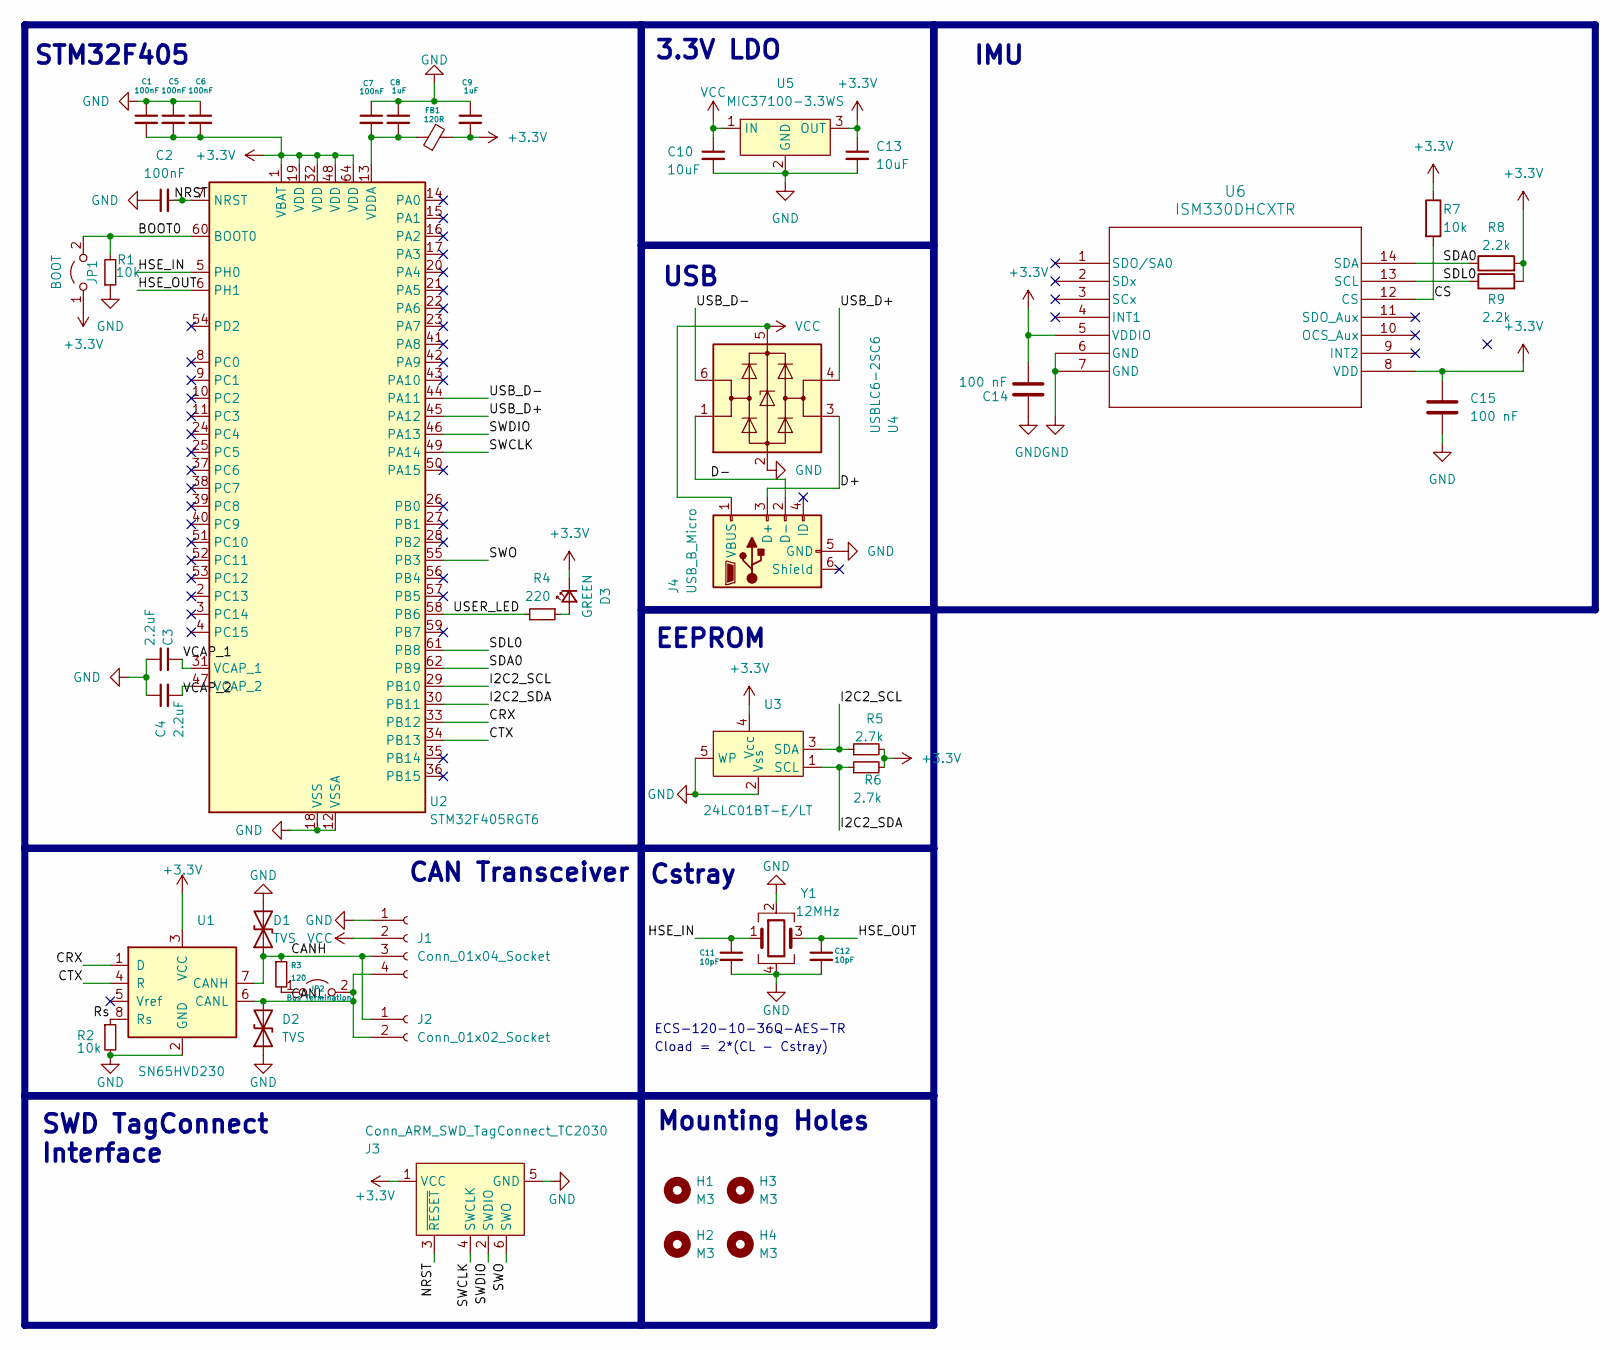
[picture p261: schematic SDM25_IMU_STM32.kicad_sch]

Parts:
C1, C2, C5, C6, C7: 100nF; C_0402_1005Metric
C3, C4: 2.2uF; C_0603_1608Metric
C8, C9: 1uF; C_0603_1608Metric
C10, C13: 10uF; C_0805_2012Metric
C11, C12: 10pF; C_0402_1005Metric
C14, C15: 100 nF; C_0402_1005Metric
D1, D2: TVS; SOD-123FL
D3: GREEN; LED_0805_2012Metric
FB1: 120R; L_0603_1608Metric
H1, H2, H3, H4: M3; MountingHole_3.2mm_M3
J1: Conn_01x04_Socket
J2: Conn_01x02_Socket
J3: Conn_ARM_SWD_TagConnect_TC2030; Tag-Connect_TC2030-IDC-NL_2x03_P1.27mm_Vertical
J4: USB_B_Micro
JP1: BOOT; PinHeader_1x02_P2.54mm_Vertical
JP2: Bus Termination; PinHeader_1x02_P2.54mm_Vertical
R1, R2, R7: 10k; R_0805_2012Metric
R3: 120; R_0603_1608Metric
R4: 220; R_0805_2012Metric
R5, R6: 2.7k; R_0603_1608Metric
R8, R9: 2.2k; R_0603_1608Metric
U1: SN65HVD230; LQFP-64_10x10mm_P0.5mm
U2: STM32F405RGT6; SOIC-8_3.9x4.9mm_P1.27mm
U3: 24LC01BT-E/LT; SOT-223-3_TabPin2
U4: USBLC6-2SC6; SOT-23-6
U5: MIC37100-3.3WS; SC-70-5
U6: ISM330DHCXTR; LGA-14L
Y1: 12MHz; Crystal_SMD_2520-4Pin_2.5x2.0mm

Connections:
+3.3V: C1.2, C5.2, C6.2, C9.2, C13.1, C14.2, C15.1, D3.1 (K), FB1.2, J3.1 (VCC), JP1.1 (A), R5.2, R6.2, R7.1, R8.2, R9.2, U1.3 (VCC), U2.1 (VBAT), U2.19 (VDD), U2.32 (VDD), U2.48 (VDD), U2.64 (VDD), U3.4 (Vcc), U5.3 (OUT), U6.5 (VDDIO), U6.8 (VDD)
BOOT0: JP1.2 (B), R1.2, U2.60 (BOOT0)
CANH: D1.1 (A1), J1.3, J2.1, R3.1, U1.7 (CANH)
CANL: D2.2 (A2), J1.4, J2.2, JP2.2 (B), U1.6 (CANL)
CRX: U1.1 (D), U2.33 (PB12)
CS: R7.2, U6.12 (CS)
CTX: U1.4 (R), U2.34 (PB13)
D+: J4.3 (D+), U4.3 (I/O2)
D-: J4.2 (D-), U4.1 (I/O1)
GND: C1.1, C2.1, C3.2, C4.1, C5.1, C6.1, C7.1, C8.1, C9.1, C10.2, C11.2, C12.2, C13.2, C14.1, C15.2, D1.2 (A2), D2.1 (A1), J1.1, J3.5 (GND), J4.5 (GND), R1.1, R2.2, U1.2 (GND), U2.12 (VSSA), U2.18 (VSS), U2.63 (VSS), U3.2 (Vss), U3.5 (WP), U4.2 (GND), U5.2 (GND), U6.6 (GND), U6.7 (GND), Y1.2, Y1.4
HSE_IN: C11.1, U2.5 (PH0), Y1.1
HSE_OUT: C12.1, U2.6 (PH1), Y1.3
I2C2_SCL: R5.1, U2.29 (PB10), U3.3 (SDA)
I2C2_SDA: R6.1, U2.30 (PB11), U3.1 (SCL)
NRST: C2.2, J3.3 (~RESET), U2.7 (NRST)
unnamed: C7.2, C8.2, FB1.1, U2.13 (VDDA)
unnamed: D3.2 (A), R4.1
unnamed: JP2.1 (A), R3.2
Rs: R2.1, U1.8 (Rs)
SDA0: R8.1, U2.62 (PB9), U6.14 (SDA)
SDL0: R9.1, U2.61 (PB8), U6.13 (SCL)
SWCLK: J3.4 (SWCLK), U2.49 (PA14)
SWDIO: J3.2 (SWDIO), U2.46 (PA13)
SWO: J3.6 (SWO), U2.55 (PB3)
USB_D+: U2.45 (PA12), U4.4 (I/O2)
USB_D-: U2.44 (PA11), U4.6 (I/O1)
USER_LED: R4.2, U2.58 (PB6)
VCAP_1: C3.1, U2.31 (VCAP_1)
VCAP_2: C4.2, U2.47 (VCAP_2)
VCC: C10.1, J1.2, J4.1 (VBUS), U4.5 (VBUS), U5.1 (IN)

Notes on the sheet:
EEPROM
STM32F405
Cload = 2*(CL - Cstray)
IMU
Cstray
SWD TagConnect Interface
CAN Transceiver
ECS-120-10-36Q-AES-TR
3.3V LDO
USB
Mounting Holes
