sundevilmotorsports/pcb-dev/PRE2026/Teensy_Telemetry_Compact/Teensy_Telemetry_Compact.kicad_sch

## KiCad design PRE2026/Teensy_Telemetry_Compact/Teensy_Telemetry_Compact.kicad_sch (2025-04-12)

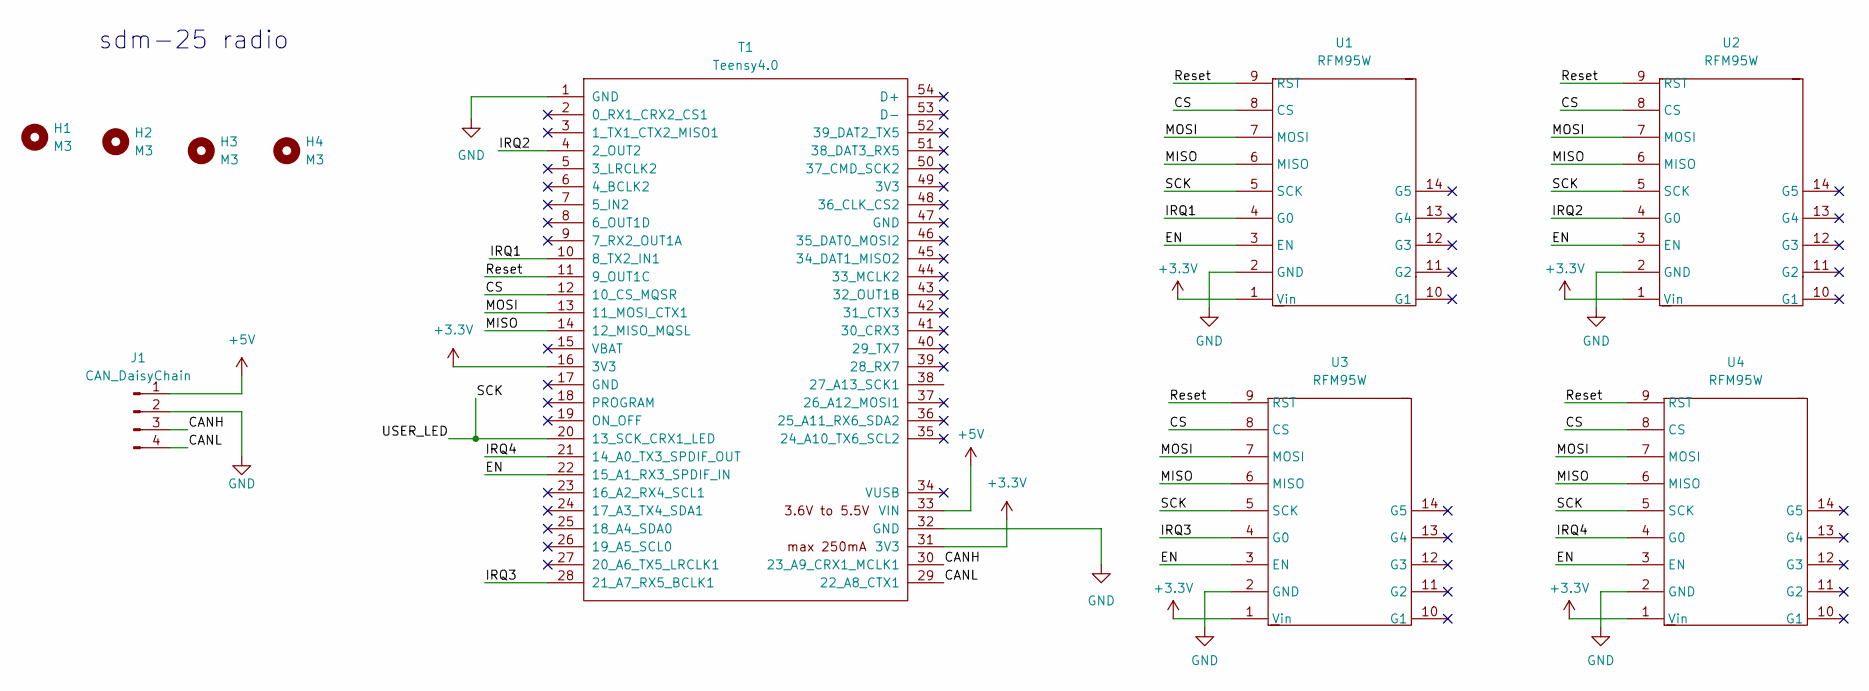
[picture p262: schematic Teensy_Telemetry_Compact.kicad_sch]

Parts:
H1, H2, H3, H4: M3; MountingHole_3.2mm_M3
J1: CAN_DaisyChain; JST_XH_B4B-XH-AM_1x04_P2.50mm_Vertical
T1: Teensy4.0; Teensy40
U1, U2, U3, U4: RFM95W

Connections:
+3.3V: T1.16 (3V3), T1.31 (3V3), U1.1 (Vin), U2.1 (Vin), U3.1 (Vin), U4.1 (Vin)
+5V: J1.1, T1.33 (VIN)
CANH: J1.3, T1.30 (23_A9_CRX1_MCLK1)
CANL: J1.4, T1.29 (22_A8_CTX1)
CS: T1.12 (10_CS_MQSR), U1.8 (CS), U2.8 (CS), U3.8 (CS), U4.8 (CS)
EN: T1.22 (15_A1_RX3_SPDIF_IN), U1.3 (EN), U2.3 (EN), U3.3 (EN), U4.3 (EN)
GND: J1.2, T1.1 (GND), T1.32 (GND), U1.2 (GND), U2.2 (GND), U3.2 (GND), U4.2 (GND)
IRQ1: T1.10 (8_TX2_IN1), U1.4 (G0)
IRQ2: T1.4 (2_OUT2), U2.4 (G0)
IRQ3: T1.28 (21_A7_RX5_BCLK1), U3.4 (G0)
IRQ4: T1.21 (14_A0_TX3_SPDIF_OUT), U4.4 (G0)
MISO: T1.14 (12_MISO_MQSL), U1.6 (MISO), U2.6 (MISO), U3.6 (MISO), U4.6 (MISO)
MOSI: T1.13 (11_MOSI_CTX1), U1.7 (MOSI), U2.7 (MOSI), U3.7 (MOSI), U4.7 (MOSI)
Reset: T1.11 (9_OUT1C), U1.9 (RST), U2.9 (RST), U3.9 (RST), U4.9 (RST)
SCK: T1.20 (13_SCK_CRX1_LED), U1.5 (SCK), U2.5 (SCK), U3.5 (SCK), U4.5 (SCK)

Notes on the sheet:
sdm-25 radio
