sundevilmotorsports/pcb-dev/PRE2026/Telemetry_STM32_V3/Telemetry_STM32_V3.kicad_sch

## KiCad design PRE2026/Telemetry_STM32_V3/Telemetry_STM32_V3.kicad_sch (2025-10-08)

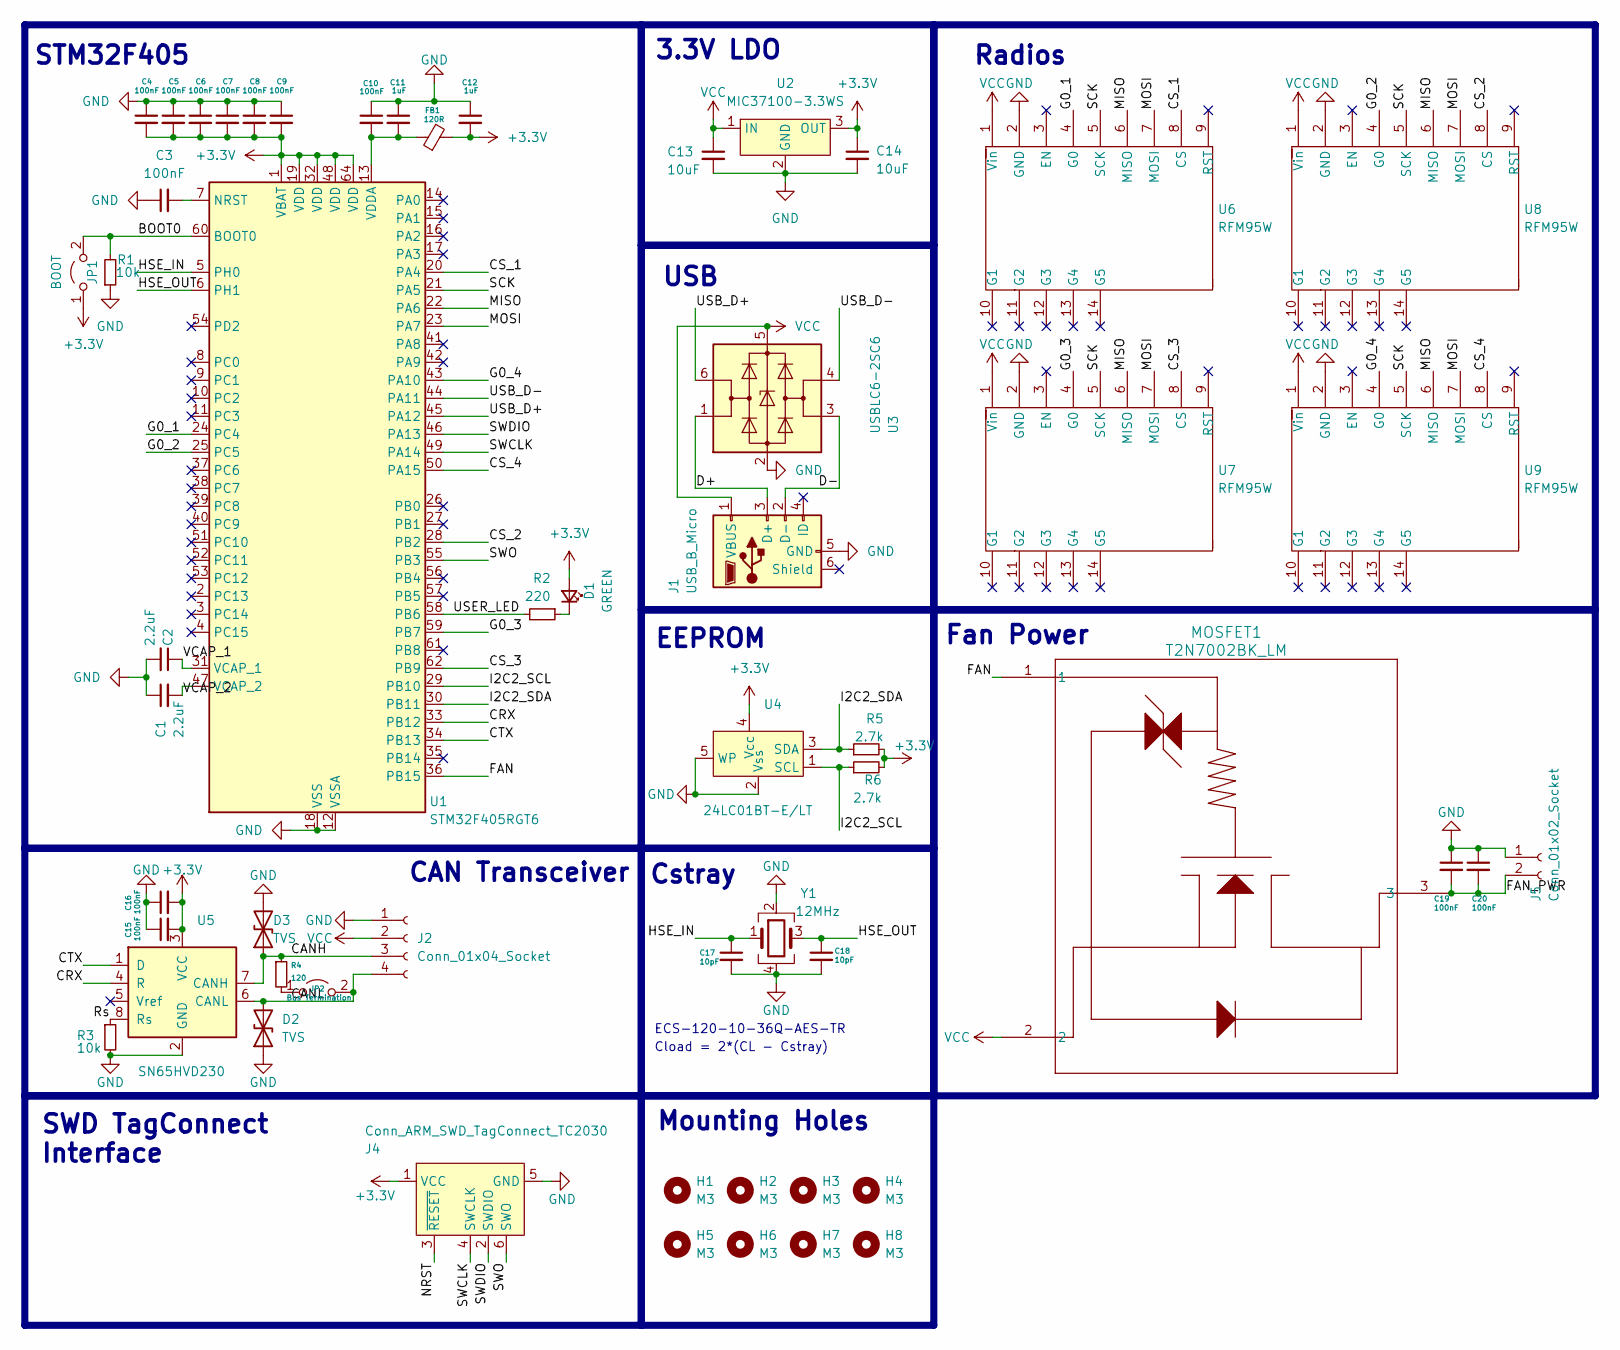
[picture p263: schematic Telemetry_STM32_V3.kicad_sch]

Parts:
C1, C2: 2.2uF; C_0603_1608Metric
C3, C4, C5, C6, C7, C8, C9, C10, C15, C16: 100nF; C_0402_1005Metric
C11, C12: 1uF; C_0603_1608Metric
C13, C14: 10uF; C_0805_2012Metric
C17, C18: 10pF; C_0402_1005Metric
C19, C20: 100nF
D1: GREEN; LED_0805_2012Metric
D2, D3: TVS; SOD-123FL
FB1: 120R; L_0603_1608Metric
H1, H2, H3, H4, H5, H6, H7, H8: M3; MountingHole_3.2mm_M3
J1: USB_B_Micro
J2: Conn_01x04_Socket
J4: Conn_ARM_SWD_TagConnect_TC2030; Tag-Connect_TC2030-IDC-NL_2x03_P1.27mm_Vertical
J5: Conn_01x02_Socket
JP1: BOOT; PinHeader_1x02_P2.54mm_Vertical
JP2: Bus Termination; PinHeader_1x02_P2.54mm_Vertical
MOSFET1: T2N7002BK_LM; SOT23_TOS
R1, R3: 10k; R_0805_2012Metric
R2: 220; R_0805_2012Metric
R4: 120; R_0603_1608Metric
R5, R6: 2.7k; R_0603_1608Metric
U1: STM32F405RGT6; LQFP-64_10x10mm_P0.5mm
U2: MIC37100-3.3WS; SOT-223-3_TabPin2
U3: USBLC6-2SC6; SOT-23-6
U4: 24LC01BT-E/LT; SC-70-5
U5: SN65HVD230; SOIC-8_3.9x4.9mm_P1.27mm
U6, U7, U8, U9: RFM95W
Y1: 12MHz; Crystal_SMD_2520-4Pin_2.5x2.0mm

Connections:
+3.3V: C4.2, C5.2, C6.2, C7.2, C8.2, C9.2, C12.2, C14.1, C15.2, C16.2, D1.2 (A), FB1.2, J4.1 (VCC), JP1.1 (A), R5.2, R6.2, U1.1 (VBAT), U1.19 (VDD), U1.32 (VDD), U1.48 (VDD), U1.64 (VDD), U2.3 (OUT), U4.4 (Vcc), U5.3 (VCC)
BOOT0: JP1.2 (B), R1.2, U1.60 (BOOT0)
CANH: D3.1 (A1), J2.3, R4.1, U5.7 (CANH)
CANL: D2.2 (A2), J2.4, JP2.2 (B), U5.6 (CANL)
CRX: U1.33 (PB12), U5.4 (R)
CS_1: U1.20 (PA4), U6.8 (CS)
CS_2: U1.28 (PB2), U8.8 (CS)
CS_3: U1.62 (PB9), U7.8 (CS)
CS_4: U1.50 (PA15), U9.8 (CS)
CTX: U1.34 (PB13), U5.1 (D)
D+: J1.3 (D+), U3.1 (I/O1)
D-: J1.2 (D-), U3.3 (I/O2)
FAN: MOSFET1.1, U1.36 (PB15)
FAN_PWR: C19.2, C20.2, J5.2, MOSFET1.3
G0_1: U1.24 (PC4), U6.4 (G0)
G0_2: U1.25 (PC5), U8.4 (G0)
G0_3: U1.59 (PB7), U7.4 (G0)
G0_4: U1.43 (PA10), U9.4 (G0)
GND: C1.1, C2.2, C3.1, C4.1, C5.1, C6.1, C7.1, C8.1, C9.1, C10.1, C11.1, C12.1, C13.2, C14.2, C15.1, C16.1, C17.2, C18.2, C19.1, C20.1, D2.1 (A1), D3.2 (A2), J1.5 (GND), J2.1, J4.5 (GND), J5.1, R1.1, R3.2, U1.12 (VSSA), U1.18 (VSS), U1.63 (VSS), U2.2 (GND), U3.2 (GND), U4.2 (Vss), U4.5 (WP), U5.2 (GND), U6.2 (GND), U7.2 (GND), U8.2 (GND), U9.2 (GND), Y1.2, Y1.4
HSE_IN: C17.1, U1.5 (PH0), Y1.1
HSE_OUT: C18.1, U1.6 (PH1), Y1.3
I2C2_SCL: R6.1, U1.29 (PB10), U4.1 (SCL)
I2C2_SDA: R5.1, U1.30 (PB11), U4.3 (SDA)
MISO: U1.22 (PA6), U6.6 (MISO), U7.6 (MISO), U8.6 (MISO), U9.6 (MISO)
MOSI: U1.23 (PA7), U6.7 (MOSI), U7.7 (MOSI), U8.7 (MOSI), U9.7 (MOSI)
NRST: J4.3 (~RESET)
unnamed: C3.2, U1.7 (NRST)
unnamed: C10.2, C11.2, FB1.1, U1.13 (VDDA)
unnamed: D1.1 (K), R2.1
unnamed: JP2.1 (A), R4.2
Rs: R3.1, U5.8 (Rs)
SCK: U1.21 (PA5), U6.5 (SCK), U7.5 (SCK), U8.5 (SCK), U9.5 (SCK)
SWCLK: J4.4 (SWCLK), U1.49 (PA14)
SWDIO: J4.2 (SWDIO), U1.46 (PA13)
SWO: J4.6 (SWO), U1.55 (PB3)
USB_D+: U1.45 (PA12), U3.6 (I/O1)
USB_D-: U1.44 (PA11), U3.4 (I/O2)
USER_LED: R2.2, U1.58 (PB6)
VCAP_1: C2.1, U1.31 (VCAP_1)
VCAP_2: C1.2, U1.47 (VCAP_2)
VCC: C13.1, J1.1 (VBUS), J2.2, MOSFET1.2, U2.1 (IN), U3.5 (VBUS), U6.1 (Vin), U7.1 (Vin), U8.1 (Vin), U9.1 (Vin)

Notes on the sheet:
EEPROM
Radios
Fan Power
ECS-120-10-36Q-AES-TR
STM32F405
Mounting Holes
3.3V LDO
Cstray
USB
Cload = 2*(CL - Cstray)
SWD TagConnect Interface
CAN Transceiver
