sundevilmotorsports/pcb-dev/PRE2026/cansplitter/cansplitter.kicad_sch

## KiCad design PRE2026/cansplitter/cansplitter.kicad_sch (2024-04-06)

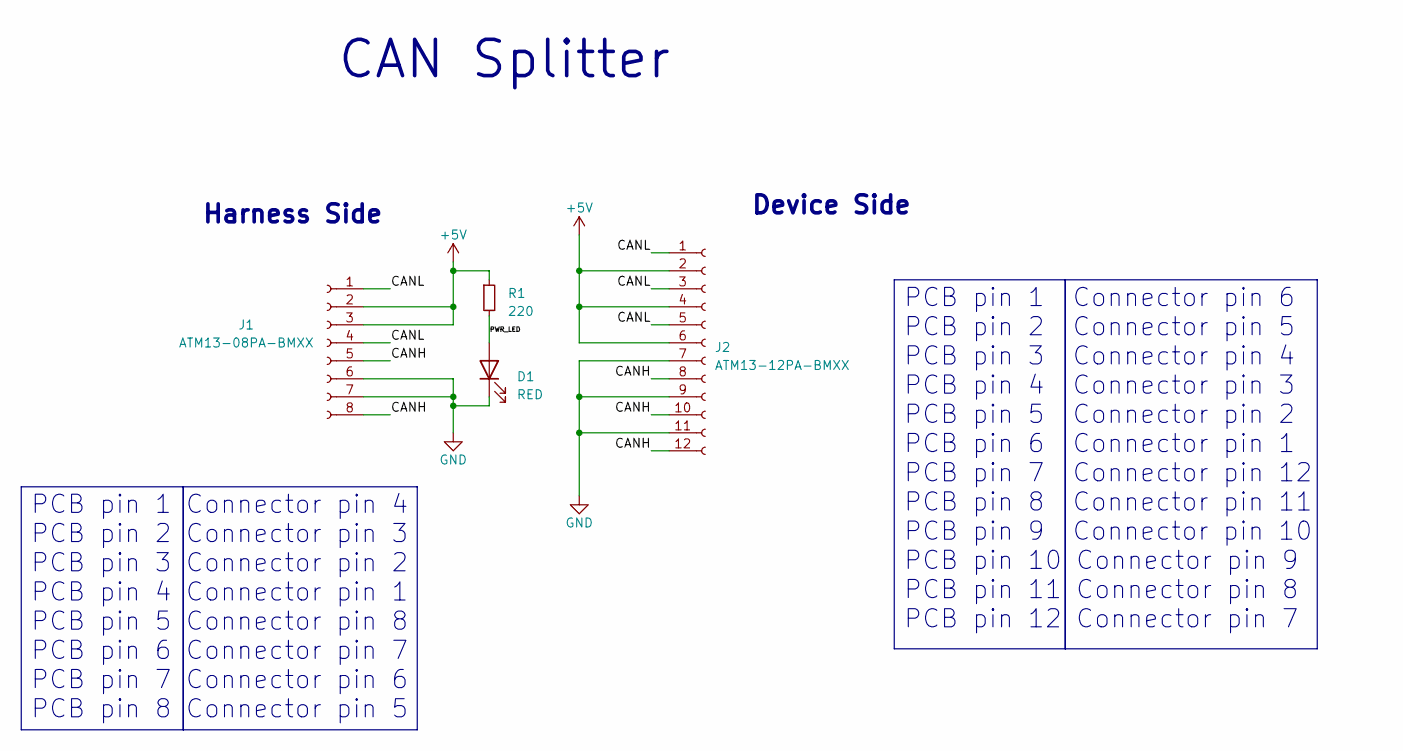
[picture p264: schematic cansplitter.kicad_sch]

Parts:
D1: RED; LED_1206_3216Metric
J1: ATM13-08PA-BMXX
J2: ATM13-12PA-BMXX
R1: 220; R_1206_3216Metric

Connections:
+5V: J1.2, J1.3, J2.2, J2.4, J2.6, R1.1
CANH: J1.5, J1.8, J2.8, J2.10, J2.12
CANL: J1.1, J1.4, J2.1, J2.3, J2.5
GND: D1.1 (K), J1.6, J1.7, J2.7, J2.9, J2.11
PWR_LED: D1.2 (A), R1.2

Notes on the sheet:
PCB pin 1 Connector pin 6 PCB pin 2 Connector pin 5 PCB pin 3 Connector pin 4 PCB pin 4 Connector pin 3 PCB pin 5 Connector pin 2 PCB pin 6 Connector pin 1 PCB pin 7 Connector pin 12 PCB pin 8 Connector pin 11 PCB pin 9 Connector pin 10 PCB pin 10 Connector pin 9 PCB pin 11 Connector pin 8 PCB pin 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
Harness Side
Device Side
CAN Splitter
PCB pin 1 Connector pin 4 PCB pin 2 Connector pin 3 PCB pin 3 Connector pin 2 PCB pin 4 Connector pin 1 PCB pin 5 Connector pin 8 PCB pin 6 Connector pin 7 PCB pin 7 Connector pin 6 PCB pin 8 Connector pin 5
