sundevilmotorsports/pcb-dev/PRE2026/lapbeacon/lapbeacon.kicad_sch

## KiCad design PRE2026/lapbeacon/lapbeacon.kicad_sch (2024-01-16)

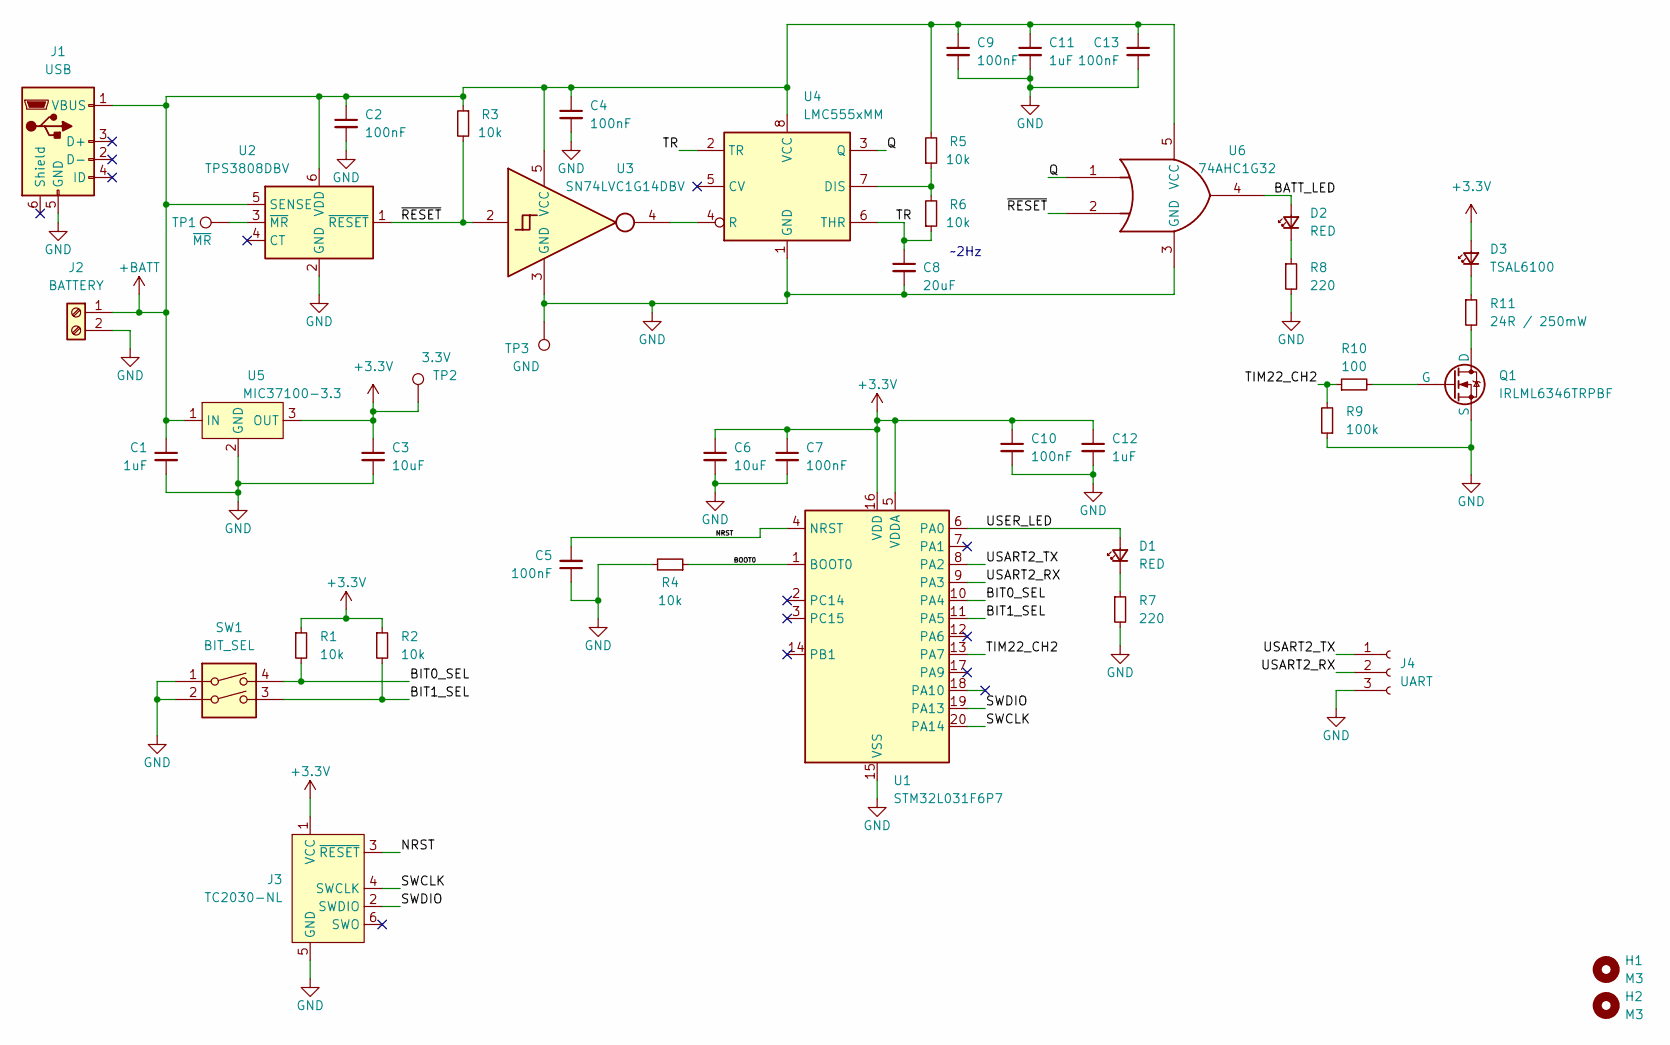
[picture p265: schematic lapbeacon.kicad_sch]

Parts:
C1, C11, C12: 1uF; C_0603_1608Metric
C2, C4, C5, C7, C9, C10, C13: 100nF; C_0402_1005Metric
C3, C6: 10uF; C_0805_2012Metric
C8: 20uF; C_0603_1608Metric
D1, D2: RED; LED_0603_1608Metric
D3: TSAL6100; LED_D5.0mm_IRBlack
H1, H2: M3; MountingHole_3.2mm_M3
J1: USB; USB_Micro-B_Molex-105017-0001
J2: BATTERY; TerminalBlock_TE_282834-2_1x02_P2.54mm_Horizontal
J3: TC2030-NL; Tag-Connect_TC2030-IDC-NL_2x03_P1.27mm_Vertical
J4: UART; JST_XH_B3B-XH-A_1x03_P2.50mm_Vertical
Q1: IRLML6346TRPBF; SOT-23
R1, R2: 10k; R_0805_2012Metric
R3, R5, R6: 10k; R_0402_1005Metric
R4: 10k; R_0603_1608Metric
R7, R8: 220; R_0603_1608Metric
R9: 100k; R_0805_2012Metric
R10: 100; R_0603_1608Metric
R11: 24R / 250mW; R_0603_1608Metric
SW1: BIT_SEL; 2454985-3
TP1: ~{MR}; TestPoint_Pad_1.0x1.0mm
TP2: 3.3V; TestPoint_Pad_1.0x1.0mm
TP3: GND; TestPoint_Pad_1.0x1.0mm
U1: STM32L031F6P7; TSSOP-20_4.4x6.5mm_P0.65mm
U2: TPS3808DBV; SOT-23-6
U3: SN74LVC1G14DBV; SOT-23-5
U4: LMC555xMM; VSSOP-8_3.0x3.0mm_P0.65mm
U5: MIC37100-3.3; SOT-223-3_TabPin2
U6: 74AHC1G32; SOT-23-5

Connections:
+3.3V: C3.1, C6.1, C7.1, C10.1, C12.1, D3.2 (A), J3.1 (VCC), R1.1, R2.1, TP2.1, U1.5 (VDDA), U1.16 (VDD), U5.3 (OUT)
+BATT: C1.1, C2.1, C4.1, C9.1, C11.1, C13.1, J1.1 (VBUS), J2.1, R3.1, R5.2, U2.5 (SENSE), U2.6 (VDD), U3.5 (VCC), U4.8 (VCC), U5.1 (IN), U6.5 (VCC)
BATT_LED: D2.2 (A), U6.4
BIT0_SEL: R1.2, SW1.4, U1.10 (PA4)
BIT1_SEL: R2.2, SW1.3, U1.11 (PA5)
BOOT0: R4.1, U1.1 (BOOT0)
GND: C1.2, C2.2, C3.2, C4.2, C5.1, C6.2, C7.2, C8.2, C9.2, C10.2, C11.2, C12.2, C13.2, J1.5 (GND), J2.2, J3.5 (GND), J4.3, Q1.3 (S), R4.2, R7.2, R8.2, R9.1, SW1.1, SW1.2, TP3.1, U1.15 (VSS), U2.2 (GND), U3.3 (GND), U4.1 (GND), U5.2 (GND), U6.3 (GND)
NRST: C5.2, J3.3 (~RESET), U1.4 (NRST)
unnamed: D1.1 (K), R7.1
unnamed: D2.1 (K), R8.1
unnamed: D3.1 (K), R11.1
unnamed: Q1.1 (D), R11.2
unnamed: Q1.2 (G), R10.2
unnamed: R5.1, R6.2, U4.7 (DIS)
unnamed: TP1.1, U2.3 (~MR)
unnamed: U3.4, U4.4 (R)
Q: U4.3 (Q), U6.1
SWCLK: J3.4 (SWCLK), U1.20 (PA14)
SWDIO: J3.2 (SWDIO), U1.19 (PA13)
TIM22_CH2: R9.2, R10.1, U1.13 (PA7)
TR: C8.1, R6.1, U4.2 (TR), U4.6 (THR)
USART2_RX: J4.2, U1.9 (PA3)
USART2_TX: J4.1, U1.8 (PA2)
USER_LED: D1.2 (A), U1.6 (PA0)
~RESET: R3.2, U2.1 (~RESET), U3.2, U6.2

Notes on the sheet:
~2Hz
