sundevilmotorsports/pcb-dev/PRE2026/loadcelladapter/loadcelladapter.kicad_sch

## KiCad design PRE2026/loadcelladapter/loadcelladapter.kicad_sch (2024-01-21)

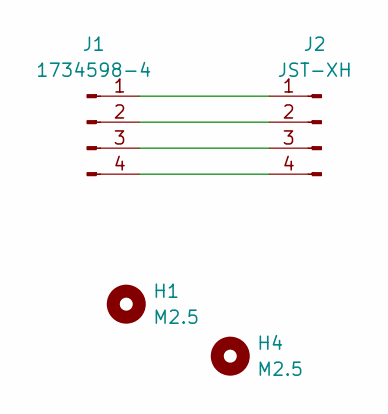
[picture p266: schematic loadcelladapter.kicad_sch]

Parts:
H1, H4: M2.5; MountingHole_3.2mm_M3
J1: 1734598-4; CONN4_1734598-4
J2: JST-XH; JST_XH_B4B-XH-AM_1x04_P2.50mm_Vertical

Connections:
unnamed: J1.1, J2.1
unnamed: J1.2, J2.2
unnamed: J1.3, J2.3
unnamed: J1.4, J2.4
