sundevilmotorsports/pcb-dev/PRE2026/mpcm/drs.kicad_sch

## KiCad design PRE2026/mpcm/drs.kicad_sch (2024-09-17)

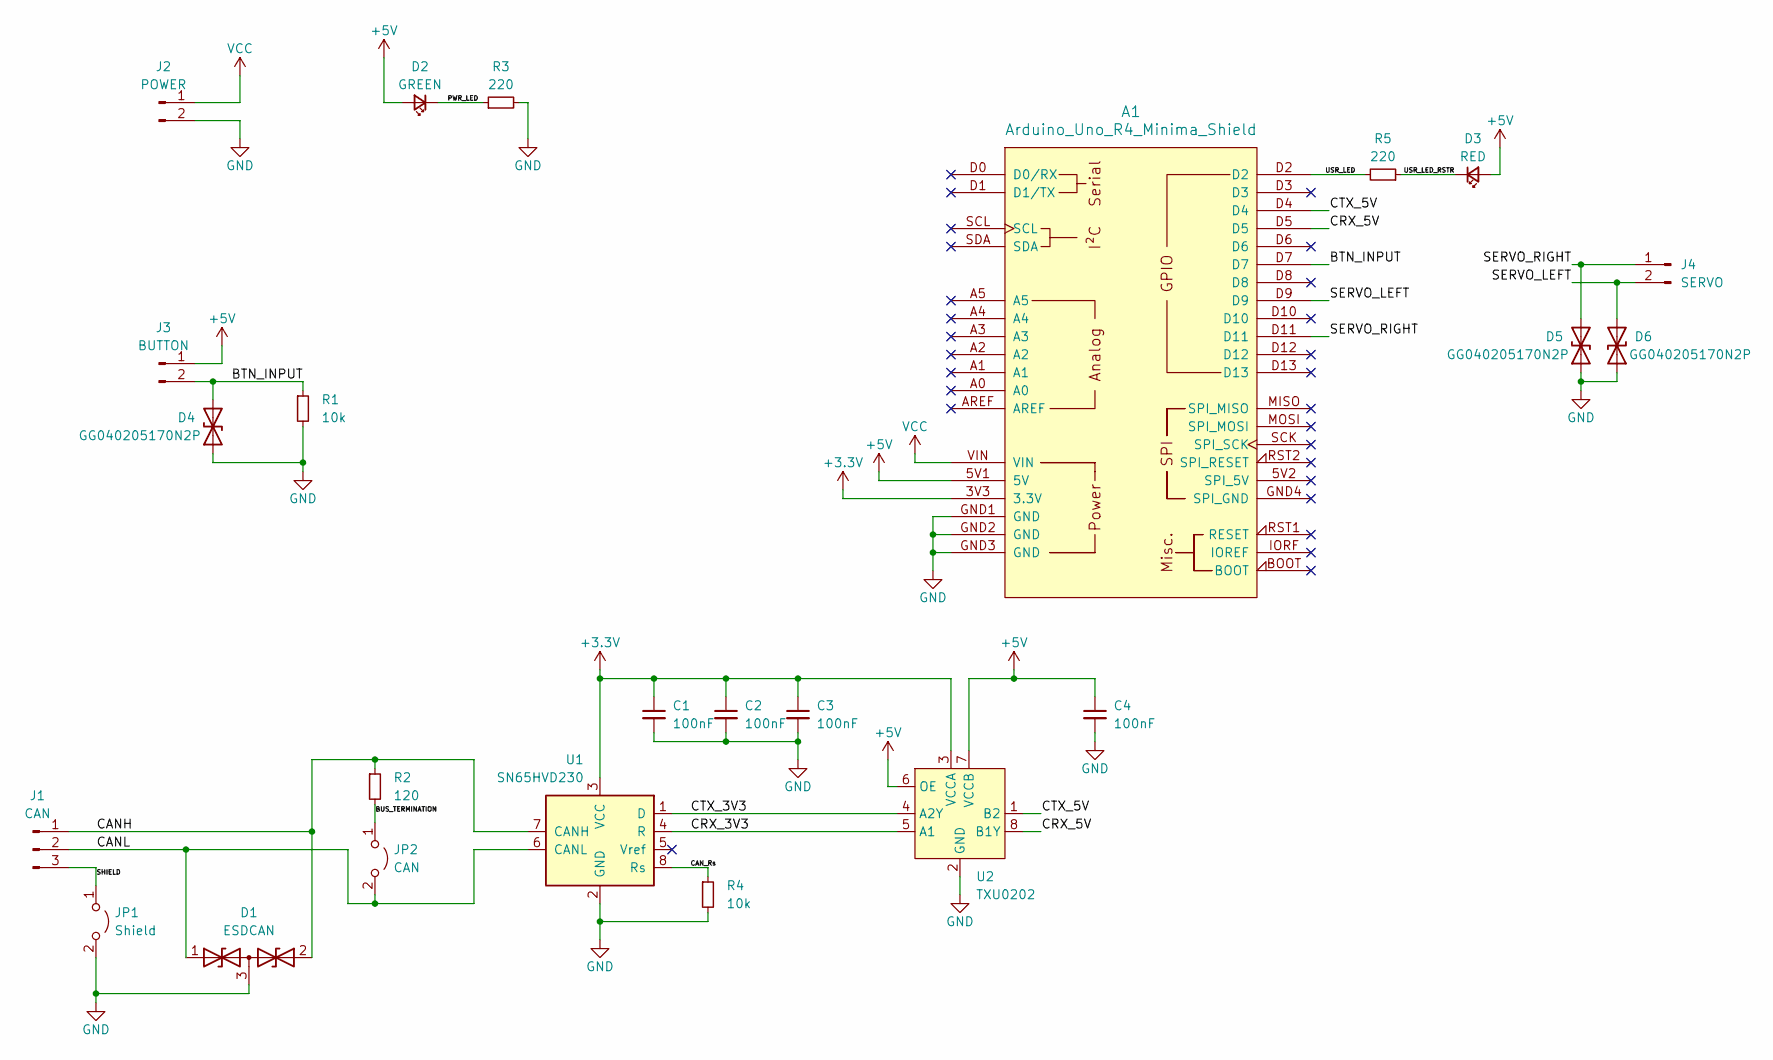
[picture p267: schematic drs.kicad_sch]

Parts:
A1: Arduino_Uno_R4_Minima_Shield
C1, C2, C3, C4: 100nF; C_0402_1005Metric
D1: ESDCAN; SOT-323_SC-70
D2: GREEN; LED_1206_3216Metric
D3: RED; LED_1206_3216Metric
D4, D5, D6: GG040205170N2P; D_0402_1005Metric
J1: CAN; JST_XH_B3B-XH-AM_1x03_P2.50mm_Vertical
J2: POWER; JST_XH_B2B-XH-AM_1x02_P2.50mm_Vertical
J3: BUTTON; JST_XH_B2B-XH-AM_1x02_P2.50mm_Vertical
J4: SERVO; JST_XH_B2B-XH-AM_1x02_P2.50mm_Vertical
JP1: Shield; PinHeader_1x02_P2.54mm_Vertical
JP2: CAN; PinHeader_1x02_P2.54mm_Vertical
R1, R4: 10k; R_1206_3216Metric
R2: 120; R_0603_1608Metric
R3, R5: 220; R_0805_2012Metric
U1: SN65HVD230; SOIC-8_3.9x4.9mm_P1.27mm
U2: TXU0202; VSSOP-8_2.3x2mm_P0.5mm

Connections:
+3.3V: A1.3V3 (3.3V), C1.1, C2.1, C3.1, U1.3 (VCC), U2.3 (VCCA)
+5V: A1.5V1 (5V), C4.1, D2.2 (A), D3.2 (A), J3.1, U2.6 (OE), U2.7 (VCCB)
BTN_INPUT: A1.D7, D4.2 (A2), J3.2, R1.1
BUS_TERMINATION: JP2.1 (A), R2.2
CANH: D1.2 (A2), J1.1, R2.1, U1.7 (CANH)
CANL: D1.1 (A1), J1.2, JP2.2 (B), U1.6 (CANL)
CAN_Rs: R4.1, U1.8 (Rs)
CRX_3V3: U1.4 (R), U2.5 (A1)
CRX_5V: A1.D5, U2.8 (B1Y)
CTX_3V3: U1.1 (D), U2.4 (A2Y)
CTX_5V: A1.D4, U2.1 (B2)
GND: A1.GND1 (GND), A1.GND2 (GND), A1.GND3 (GND), C1.2, C2.2, C3.2, C4.2, D1.3 (common), D4.1 (A1), D5.1 (A1), D6.1 (A1), J2.2, JP1.2 (B), R1.2, R3.2, R4.2, U1.2 (GND), U2.2 (GND)
PWR_LED: D2.1 (K), R3.1
SERVO_LEFT: A1.D9, D6.2 (A2), J4.2
SERVO_RIGHT: A1.D11, D5.2 (A2), J4.1
SHIELD: J1.3, JP1.1 (A)
USR_LED: A1.D2, R5.2
USR_LED_RSTR: D3.1 (K), R5.1
VCC: A1.VIN, J2.1
