sundevilmotorsports/pcb-dev/PRE2026/pedalboard/Pedal Load.kicad_sch

## KiCad design PRE2026/pedalboard/Pedal Load.kicad_sch (2024-01-16)

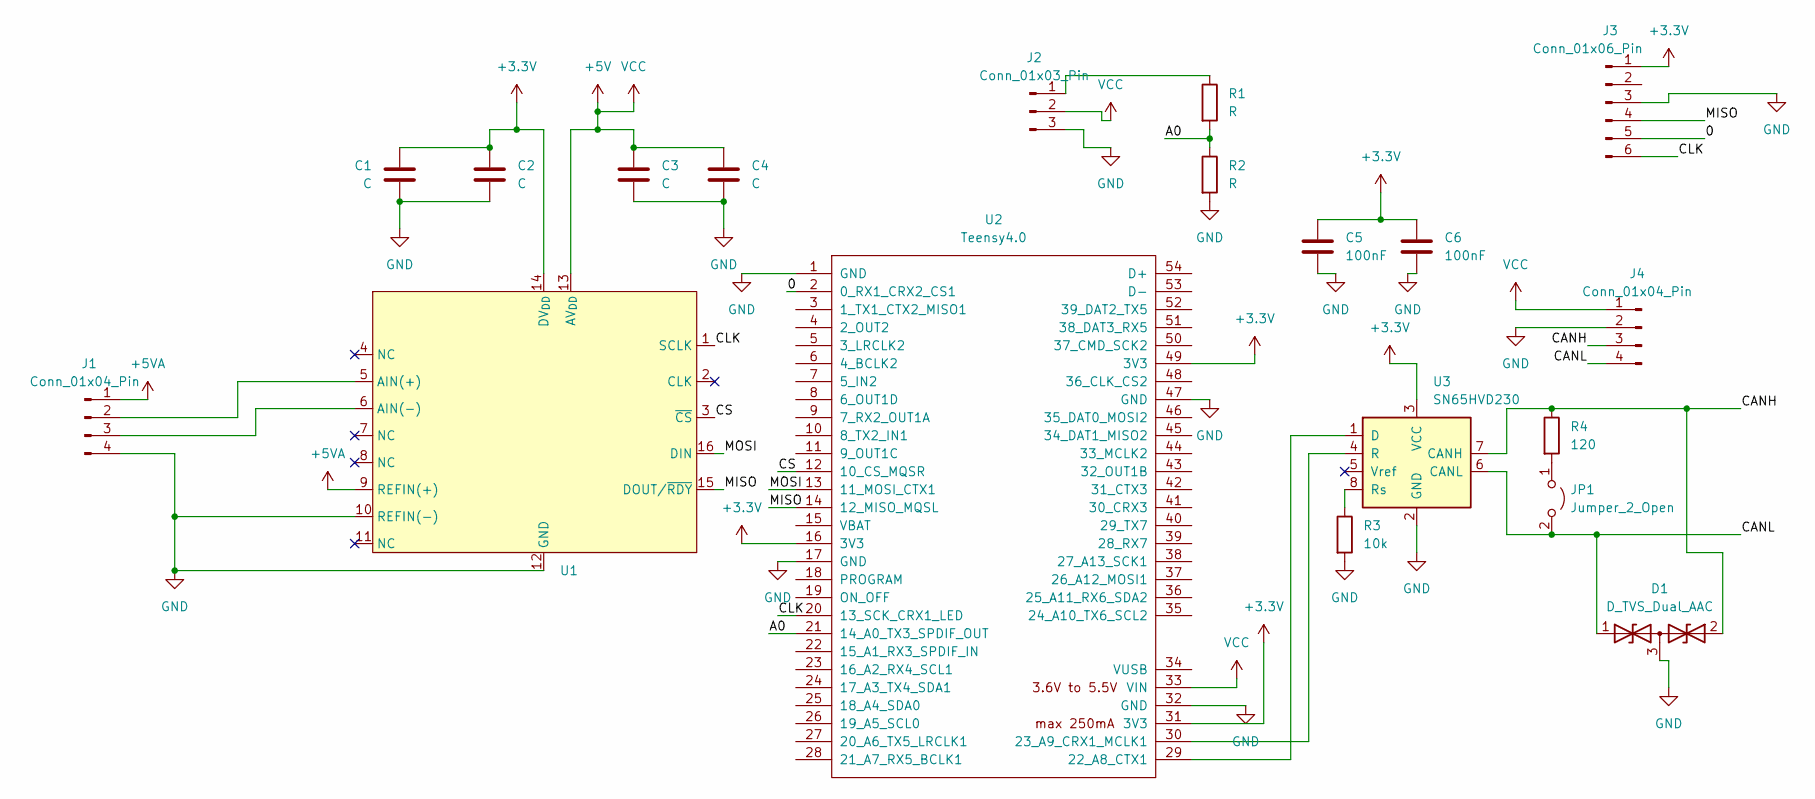
[picture p268: schematic Pedal Load.kicad_sch]

Parts:
C1, C2, C3, C4: C; C_0603_1608Metric
C5, C6: 100nF; C_0603_1608Metric
D1: D_TVS_Dual_AAC; SOT-323_SC-70
J1, J4: Conn_01x04_Pin; JST_XH_B4B-XH-A_1x04_P2.50mm_Vertical
J2: Conn_01x03_Pin; JST_XH_B3B-XH-A_1x03_P2.50mm_Vertical
J3: Conn_01x06_Pin; PinHeader_1x06_P2.54mm_Vertical
JP1: Jumper_2_Open; PinHeader_2x01_P2.54mm_Vertical
R1, R2: R; R_0805_2012Metric
R3: 10k; R_0603_1608Metric
R4: 120; R_0603_1608Metric
U1: TSSOP-16_4.4x5mm_P0.65mm
U2: Teensy4.0; Teensy40
U3: SN65HVD230; SOIC-8_3.9x4.9mm_P1.27mm

Connections:
0: J3.5, U2.2 (0_RX1_CRX2_CS1)
+3.3V: C1.1, C2.1, C5.1, C6.1, J3.1, U1.14 (DV_{DD}), U2.16 (3V3), U2.31 (3V3), U2.49 (3V3), U3.3 (VCC)
+5V: C3.1, C4.1, J2.2, J4.1, U1.13 (AV_{DD}), U2.33 (VIN)
+5VA: J1.1, U1.9 (REFIN(+))
A0: R1.2, R2.1, U2.21 (14_A0_TX3_SPDIF_OUT)
CANH: D1.2 (A2), J4.3, R4.1, U3.7 (CANH)
CANL: D1.1 (A1), J4.4, JP1.2 (B), U3.6 (CANL)
CLK: J3.6, U1.1 (SCLK), U2.20 (13_SCK_CRX1_LED)
CS: U1.3 (~CS), U2.12 (10_CS_MQSR)
GND: C1.2, C2.2, C3.2, C4.2, C5.2, C6.2, D1.3 (common), J1.4, J2.3, J3.3, J4.2, R2.2, R3.2, U1.10 (REFIN(-)), U1.12 (GND), U2.1 (GND), U2.17 (GND), U2.32 (GND), U2.47 (GND), U3.2 (GND)
MISO: J3.4, U1.15 (DOUT/~RDY), U2.14 (12_MISO_MQSL)
MOSI: U1.16 (DIN), U2.13 (11_MOSI_CTX1)
unnamed: J1.2, U1.5 (AIN(+))
unnamed: J1.3, U1.6 (AIN(-))
unnamed: J2.1, R1.1
unnamed: JP1.1 (A), R4.2
unnamed: R3.1, U3.8 (Rs)
unnamed: U2.29 (22_A8_CTX1), U3.1 (D)
unnamed: U2.30 (23_A9_CRX1_MCLK1), U3.4 (R)
