sundevilmotorsports/pcb-dev/PRE2026/sdm24logger/can.kicad_sch

## KiCad design PRE2026/sdm24logger/can.kicad_sch (2025-02-01)

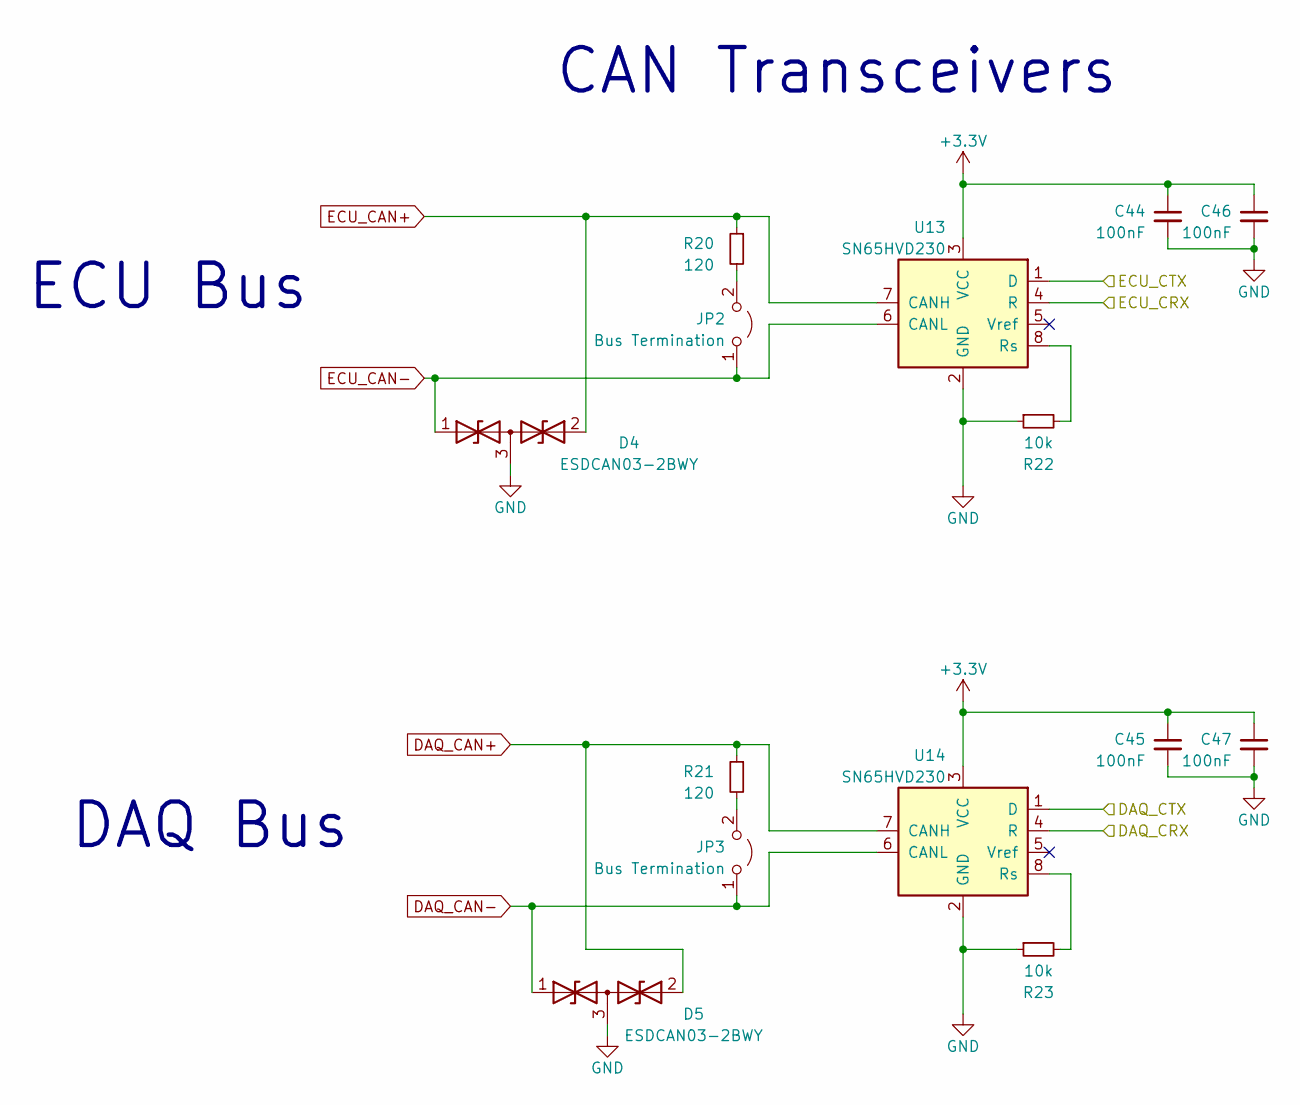
[picture p269: schematic can.kicad_sch]

Parts:
C44, C45, C46, C47: 100nF; C_0402_1005Metric
D4, D5: ESDCAN03-2BWY; SOT-323_SC-70
JP2, JP3: Bus Termination; PinHeader_1x02_P2.54mm_Vertical
R20, R21: 120; R_0402_1005Metric
R22, R23: 10k; R_0603_1608Metric
U13, U14: SN65HVD230; SOIC-8_3.9x4.9mm_P1.27mm

Connections:
+3.3V: C44.1, C45.1, C46.1, C47.1, U13.3 (VCC), U14.3 (VCC)
DAQ_CAN+: D5.2 (A2), R21.1, U14.7 (CANH)
DAQ_CAN-: D5.1 (A1), JP3.1 (A), U14.6 (CANL)
DAQ_CRX: U14.4 (R)
DAQ_CTX: U14.1 (D)
ECU_CAN+: D4.2 (A2), R20.1, U13.7 (CANH)
ECU_CAN-: D4.1 (A1), JP2.1 (A), U13.6 (CANL)
ECU_CRX: U13.4 (R)
ECU_CTX: U13.1 (D)
GND: C44.2, C45.2, C46.2, C47.2, D4.3 (common), D5.3 (common), R22.1, R23.1, U13.2 (GND), U14.2 (GND)
unnamed: JP2.2 (B), R20.2
unnamed: JP3.2 (B), R21.2
unnamed: R22.2, U13.8 (Rs)
unnamed: R23.2, U14.8 (Rs)

Notes on the sheet:
DAQ Bus
ECU Bus
CAN Transceivers
