sundevilmotorsports/pcb-dev/PRE2026/sdm24logger/connectors.kicad_sch

## KiCad design PRE2026/sdm24logger/connectors.kicad_sch (2025-02-01)

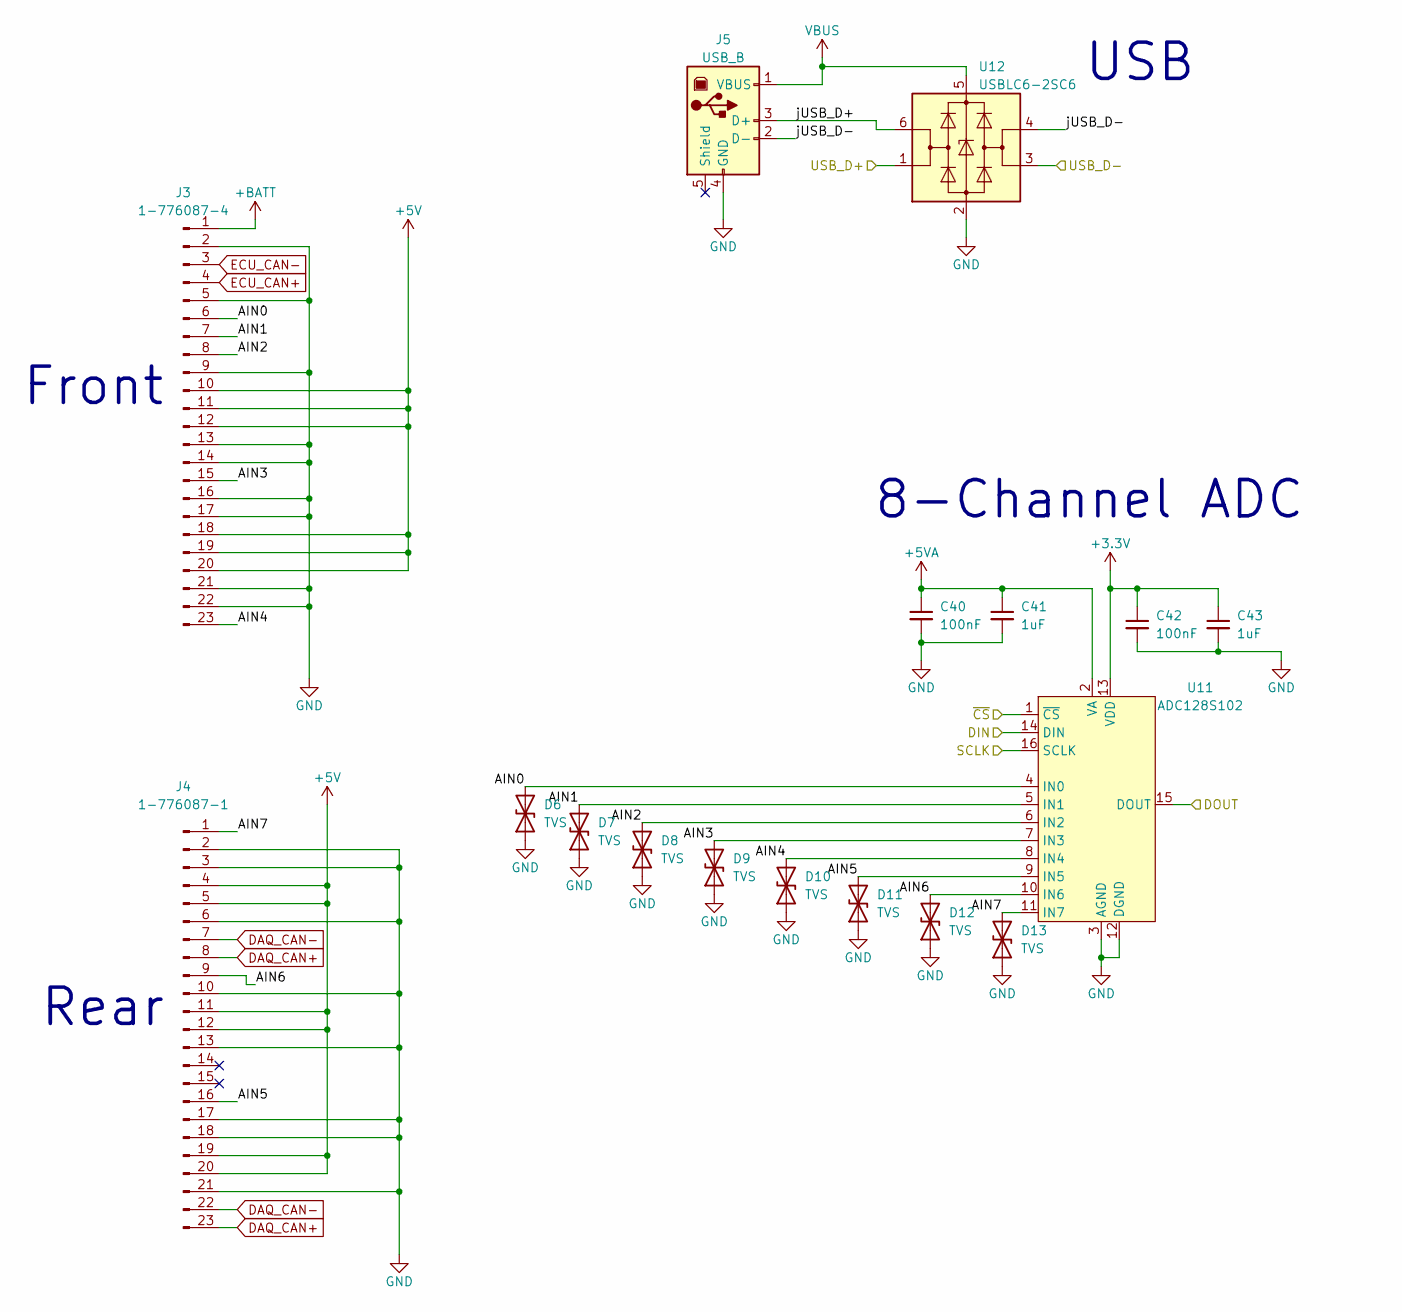
[picture p270: schematic connectors.kicad_sch]

Parts:
C40, C42: 100nF; C_0402_1005Metric
C41, C43: 1uF; C_0603_1608Metric
D6, D7, D8, D9, D10, D11, D12, D13: TVS; D_SOD-323
J3: 1-776087-4; CONN23_776087_TEC
J4: 1-776087-1; CONN23_776087_TEC
J5: USB_B; Molex_usbB_67068-7041
U11: ADC128S102; TSSOP-16_4.4x5mm_P0.65mm
U12: USBLC6-2SC6; SOT-23-6

Connections:
+3.3V: C42.1, C43.1, U11.13 (VDD)
+5V: J3.10, J3.11, J3.12, J3.18, J3.19, J3.20, J4.4, J4.5, J4.11, J4.12, J4.19, J4.20
+5VA: C40.1, C41.1, U11.2 (VA)
+BATT: J3.1
AIN0: D6.2 (A2), J3.6, U11.4 (IN0)
AIN1: D7.2 (A2), J3.7, U11.5 (IN1)
AIN2: D8.2 (A2), J3.8, U11.6 (IN2)
AIN3: D9.2 (A2), J3.15, U11.7 (IN3)
AIN4: D10.2 (A2), J3.23, U11.8 (IN4)
AIN5: D11.2 (A2), J4.16, U11.9 (IN5)
AIN6: D12.2 (A2), J4.9, U11.10 (IN6)
AIN7: D13.2 (A2), J4.1, U11.11 (IN7)
DAQ_CAN+: J4.8, J4.23
DAQ_CAN-: J4.7, J4.22
DIN: U11.14 (DIN)
DOUT: U11.15 (DOUT)
ECU_CAN+: J3.4
ECU_CAN-: J3.3
GND: C40.2, C41.2, C42.2, C43.2, D6.1 (A1), D7.1 (A1), D8.1 (A1), D9.1 (A1), D10.1 (A1), D11.1 (A1), D12.1 (A1), D13.1 (A1), J3.2, J3.5, J3.9, J3.13, J3.14, J3.16, J3.17, J3.21, J3.22, J4.2, J4.3, J4.6, J4.10, J4.13, J4.17, J4.18, J4.21, J5.4 (GND), U11.3 (AGND), U11.12 (DGND), U12.2 (GND)
SCLK: U11.16 (SCLK)
USB_D+: U12.1 (I/O1)
USB_D-: U12.3 (I/O2)
VBUS: J5.1 (VBUS), U12.5 (VBUS)
jUSB_D+: J5.3 (D+), U12.6 (I/O1)
jUSB_D-: J5.2 (D-), U12.4 (I/O2)
~CS: U11.1 (~CS)

Notes on the sheet:
8-Channel ADC
Rear
Front
USB
