sundevilmotorsports/pcb-dev/PRE2026/sdm24logger/gps.kicad_sch

## KiCad design PRE2026/sdm24logger/gps.kicad_sch (2025-02-01)

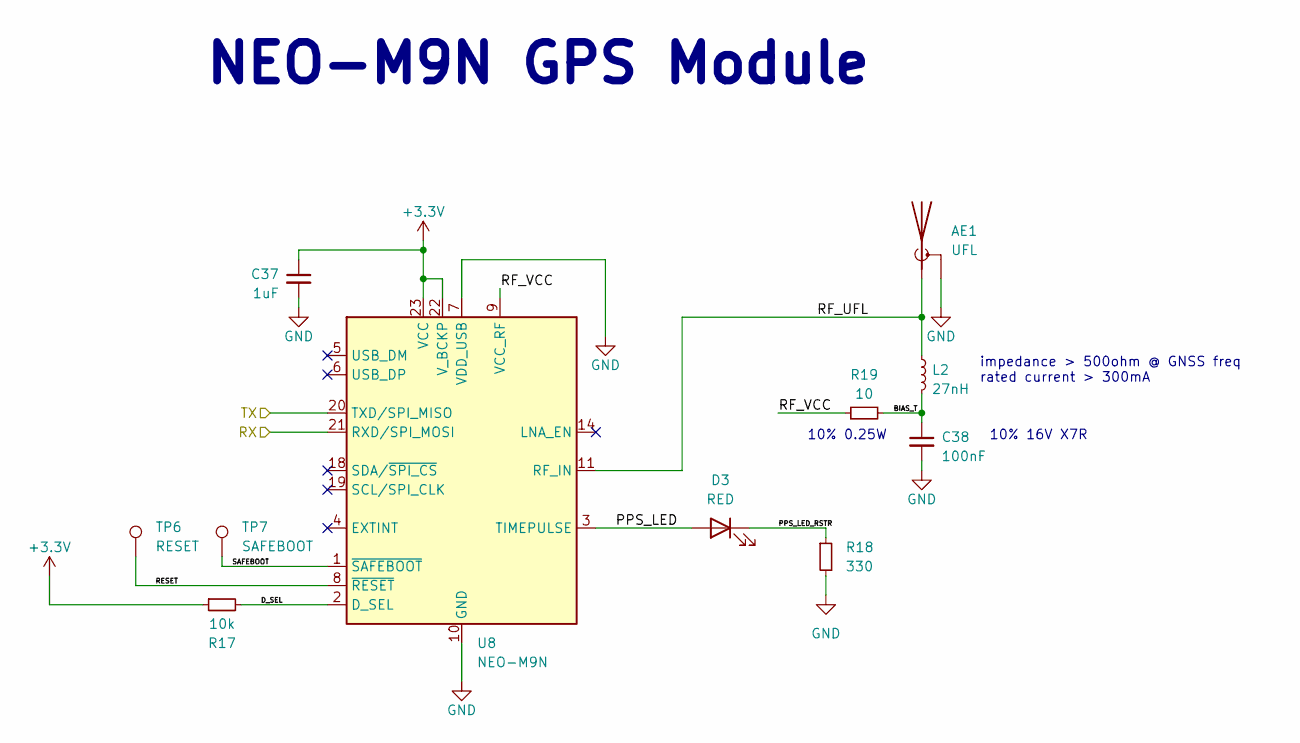
[picture p271: schematic gps.kicad_sch]

Parts:
AE1: UFL; U.FL_Molex_MCRF_73412-0110_Vertical
C37: 1uF; C_0603_1608Metric
C38: 100nF; C_0402_1005Metric
D3: RED; SSF-LXH100LID
L2: 27nH; L_0402_1005Metric
R17: 10k; R_0603_1608Metric
R18: 330; R_0603_1608Metric
R19: 10; R_0402_1005Metric
TP6: RESET; TestPoint_Pad_1.0x1.0mm
TP7: SAFEBOOT; TestPoint_Pad_1.0x1.0mm
U8: NEO-M9N; ublox_NEO

Connections:
+3.3V: C37.1, R17.1, U8.22 (V_BCKP), U8.23 (VCC)
BIAS_T: C38.1, L2.2, R19.2
D_SEL: R17.2, U8.2 (D_SEL)
GND: AE1.2 (Shield), C37.2, C38.2, R18.2, U8.7 (VDD_USB), U8.10 (GND), U8.12 (GND), U8.13 (GND), U8.24 (GND)
PPS_LED: D3.2 (A), U8.3 (TIMEPULSE)
PPS_LED_RSTR: D3.1 (K), R18.1
RESET: TP6.1, U8.8 (~RESET)
RF_UFL: AE1.1 (A), L2.1, U8.11 (RF_IN)
RF_VCC: R19.1, U8.9 (VCC_RF)
RX: U8.21 (RXD/SPI_MOSI)
SAFEBOOT: TP7.1, U8.1 (~SAFEBOOT)
TX: U8.20 (TXD/SPI_MISO)

Notes on the sheet:
NEO-M9N GPS Module
impedance > 500ohm @ GNSS freq rated current > 300mA
10% 0.25W
10% 16V X7R
