sundevilmotorsports/pcb-dev/PRE2026/sdm24logger/memory.kicad_sch

## KiCad design PRE2026/sdm24logger/memory.kicad_sch (2025-02-01)

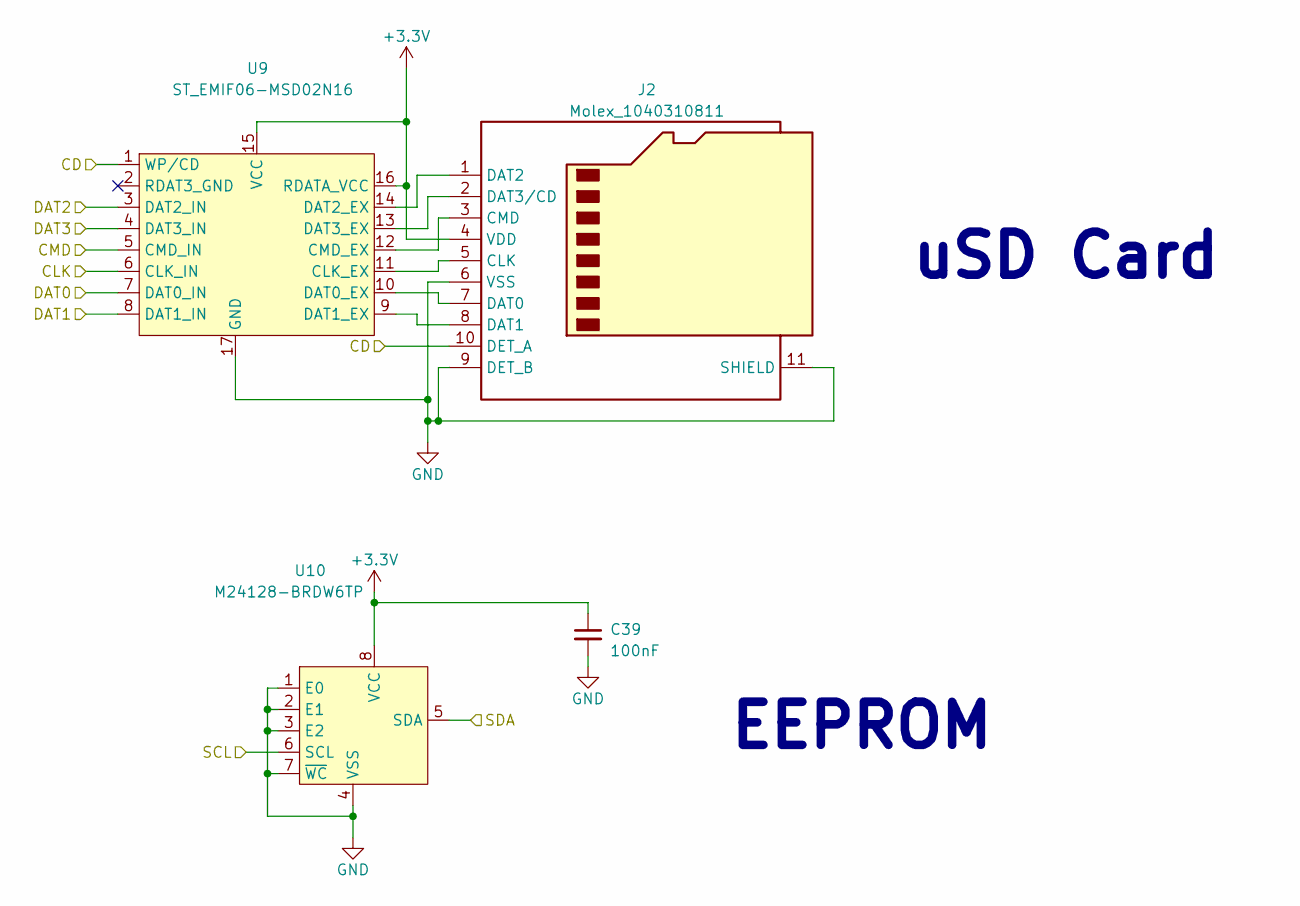
[picture p272: schematic memory.kicad_sch]

Parts:
C39: 100nF; C_0402_1005Metric
J2: Molex_1040310811; microSD_HC_Molex_104031-0811
U9: ST_EMIF06-MSD02N16; UQFN-17-3.5x1.2mm
U10: M24128-BRDW6TP; TSSOP-8_4.4x3mm_P0.65mm

Connections:
+3.3V: C39.1, J2.4 (VDD), U9.15 (VCC), U9.16 (RDATA_VCC), U10.8 (VCC)
CD: J2.10 (DET_A), U9.1 (WP/CD)
CLK: U9.6 (CLK_IN)
CMD: U9.5 (CMD_IN)
DAT0: U9.7 (DAT0_IN)
DAT1: U9.8 (DAT1_IN)
DAT2: U9.3 (DAT2_IN)
DAT3: U9.4 (DAT3_IN)
GND: C39.2, J2.6 (VSS), J2.9 (DET_B), J2.11 (SHIELD), U9.17 (GND), U10.1 (E0), U10.2 (E1), U10.3 (E2), U10.4 (VSS), U10.7 (~WC)
unnamed: J2.1 (DAT2), U9.14 (DAT2_EX)
unnamed: J2.2 (DAT3/CD), U9.13 (DAT3_EX)
unnamed: J2.3 (CMD), U9.12 (CMD_EX)
unnamed: J2.5 (CLK), U9.11 (CLK_EX)
unnamed: J2.7 (DAT0), U9.10 (DAT0_EX)
unnamed: J2.8 (DAT1), U9.9 (DAT1_EX)
SCL: U10.6 (SCL)
SDA: U10.5 (SDA)

Notes on the sheet:
uSD Card
EEPROM
