sundevilmotorsports/pcb-dev/PRE2026/sdm24logger/power.kicad_sch

## KiCad design PRE2026/sdm24logger/power.kicad_sch (2025-02-01)

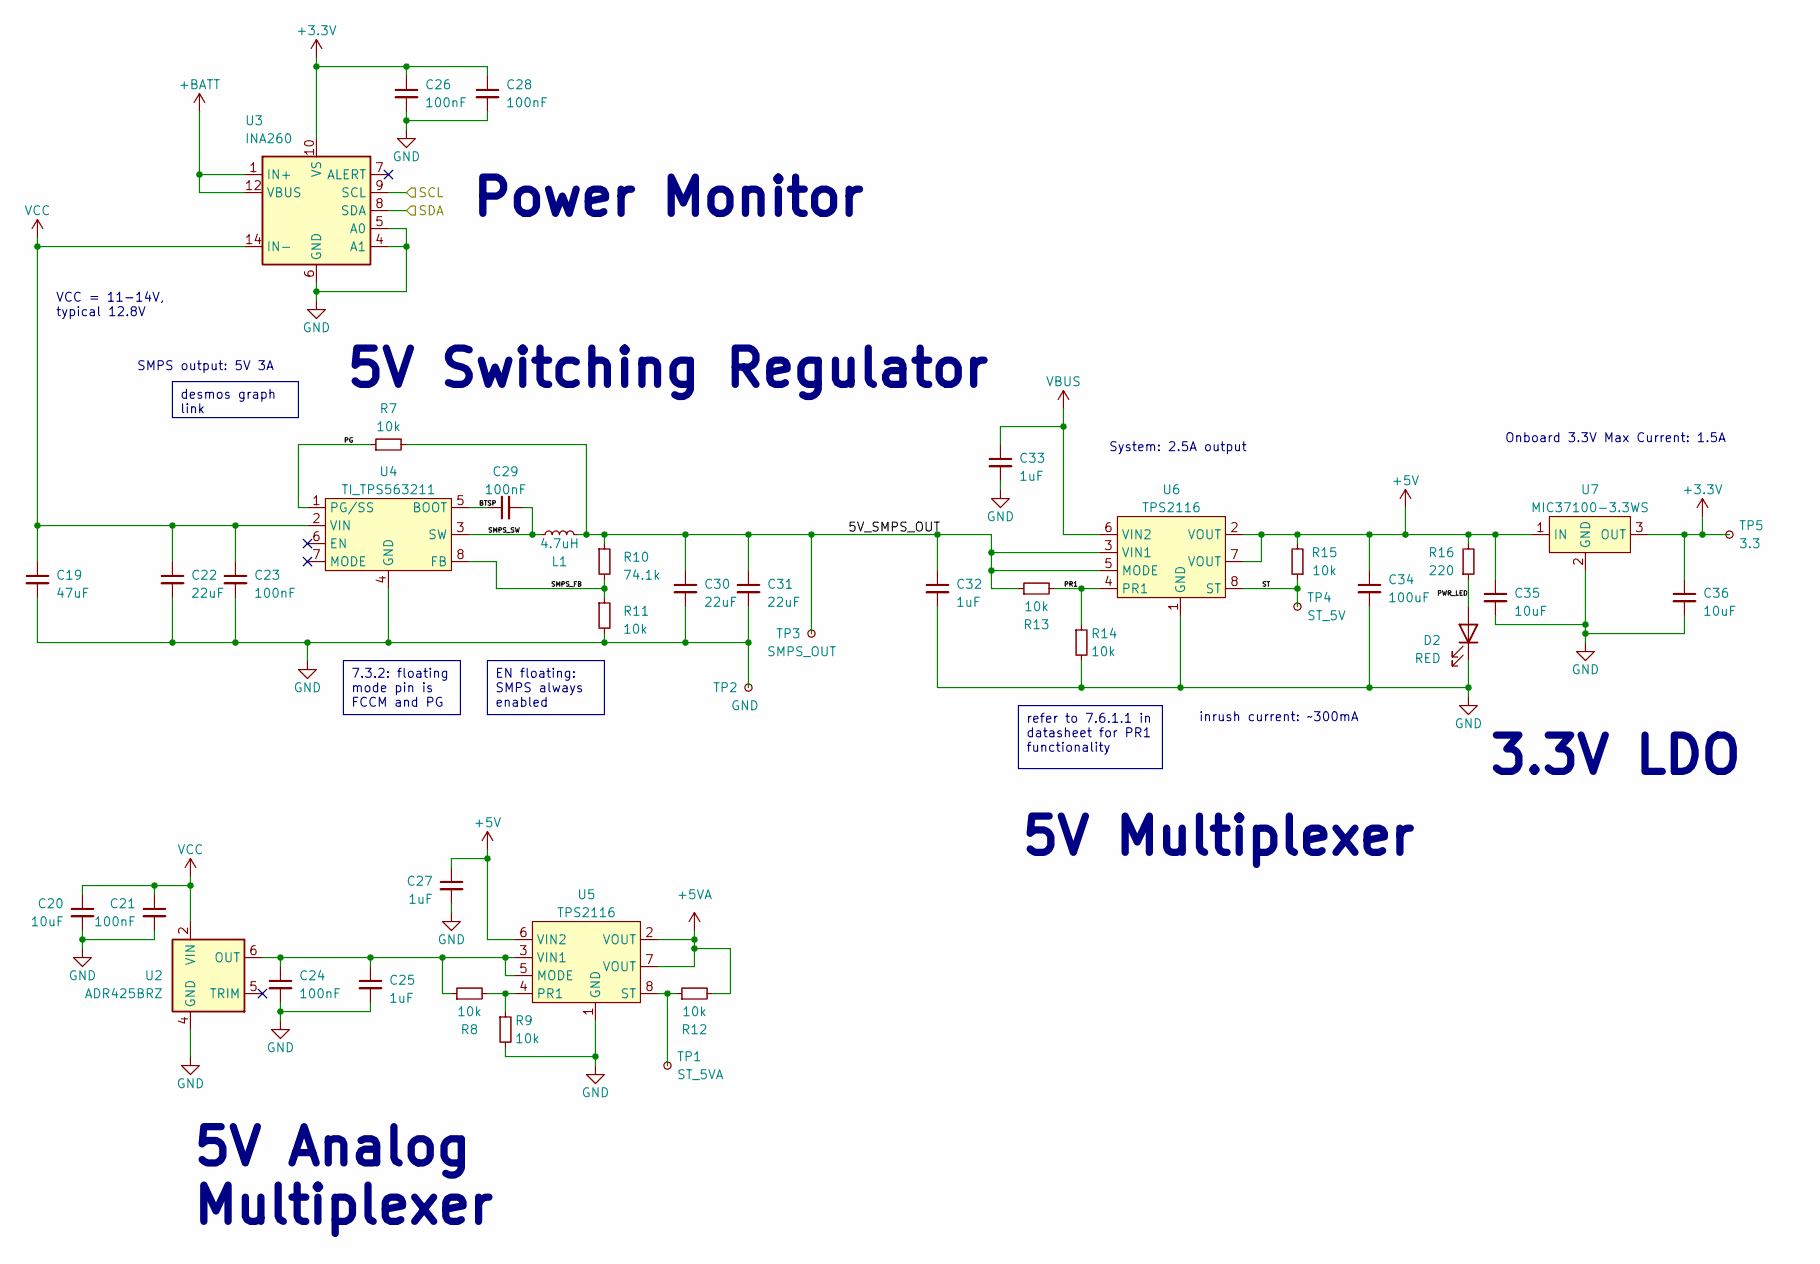
[picture p273: schematic power.kicad_sch]

Parts:
C19: 47uF; CP_Elec_6.3x5.9
C20: 10uF; C_0805_2012Metric
C21, C24, C26, C28, C29: 100nF; C_0402_1005Metric
C22: 22uF; C_1206_3216Metric
C23: 100nF; C_0603_1608Metric
C25, C27, C32, C33: 1uF; C_0603_1608Metric
C30, C31: 22uF; C_0805_2012Metric
C34: 100uF; CP_Elec_6.3x5.9
C35, C36: 10uF; C_1206_3216Metric
D2: RED; SSF-LXH100LID
L1: 4.7uH; L_Bourns_SRP7028A_7.3x6.6mm
R7, R13, R14, R15: 10k; R_0603_1608Metric
R8, R9, R11, R12: 10k; R_0402_1005Metric
R10: 74.1k; R_0402_1005Metric
R16: 220; R_0603_1608Metric
TP1: ST_5VA; TestPoint_Pad_1.0x1.0mm
TP2: GND; TestPoint_Pad_1.5x1.5mm
TP3: SMPS_OUT; TestPoint_Pad_1.5x1.5mm
TP4: ST_5V; TestPoint_Pad_1.0x1.0mm
TP5: 3.3; TestPoint_Pad_1.0x1.0mm
U2: ADR425BRZ; SOIC-8_3.9x4.9mm_P1.27mm
U3: INA260; TSSOP-16_4.4x5mm_P0.65mm
U4: TI_TPS563211; SOT-5X3
U5, U6: TPS2116; SOT-5X3
U7: MIC37100-3.3WS; SOT-223-3_TabPin2

Connections:
5V_SMPS_OUT: C30.1, C31.1, C32.1, L1.1, R7.2, R10.1, R13.1, TP3.1, U6.3 (VIN1), U6.5 (MODE)
+3.3V: C26.1, C28.1, C36.1, TP5.1, U3.10 (VS), U7.3 (OUT)
+5V: C27.1, C34.1, C35.1, R15.2, R16.2, U5.6 (VIN2), U6.2 (VOUT), U6.7 (VOUT), U7.1 (IN)
+5VA: R12.2, U5.2 (VOUT), U5.7 (VOUT)
+BATT: U3.1 (IN+), U3.2 (IN+), U3.3 (IN+), U3.12 (VBUS)
BTSP: C29.1, U4.5 (BOOT)
GND: C19.2, C20.2, C21.2, C22.2, C23.2, C24.2, C25.2, C26.2, C27.2, C28.2, C30.2, C31.2, C32.2, C33.2, C34.2, C35.2, C36.2, D2.1 (K), R9.2, R11.2, R14.2, TP2.1, U2.4 (GND), U3.4 (A1), U3.5 (A0), U3.6 (GND), U3.11 (GND), U4.4 (GND), U5.1 (GND), U6.1 (GND), U7.2 (GND)
unnamed: C24.1, C25.1, R8.1, U2.6 (OUT), U5.3 (VIN1), U5.5 (MODE)
unnamed: R8.2, R9.1, U5.4 (PR1)
unnamed: R12.1, TP1.1, U5.8 (ST)
PG: R7.1, U4.1 (PG/SS)
PR1: R13.2, R14.1, U6.4 (PR1)
PWR_LED: D2.2 (A), R16.1
SCL: U3.9 (SCL)
SDA: U3.8 (SDA)
SMPS_FB: R10.2, R11.1, U4.8 (FB)
SMPS_SW: C29.2, L1.2, U4.3 (SW)
ST: R15.1, TP4.1, U6.8 (ST)
VBUS: C33.1, U6.6 (VIN2)
VCC: C19.1, C20.1, C21.1, C22.1, C23.1, U2.2 (VIN), U3.14 (IN-), U3.15 (IN-), U3.16 (IN-), U4.2 (VIN)

Notes on the sheet:
7.3.2: floating mode pin is FCCM and PG
refer to 7.6.1.1 in datasheet for PR1 functionality
desmos graph link
EN floating: SMPS always enabled
VCC = 11-14V, typical 12.8V
Onboard 3.3V Max Current: 1.5A
5V Switching Regulator
5V Multiplexer
inrush current: ~300mA
5V Analog Multiplexer
Power Monitor
System: 2.5A output
3.3V LDO
SMPS output: 5V 3A
