sundevilmotorsports/pcb-dev/PRE2026/sdm24logger/sdm24logger.kicad_sch

## KiCad design PRE2026/sdm24logger/sdm24logger.kicad_sch (2025-02-01)

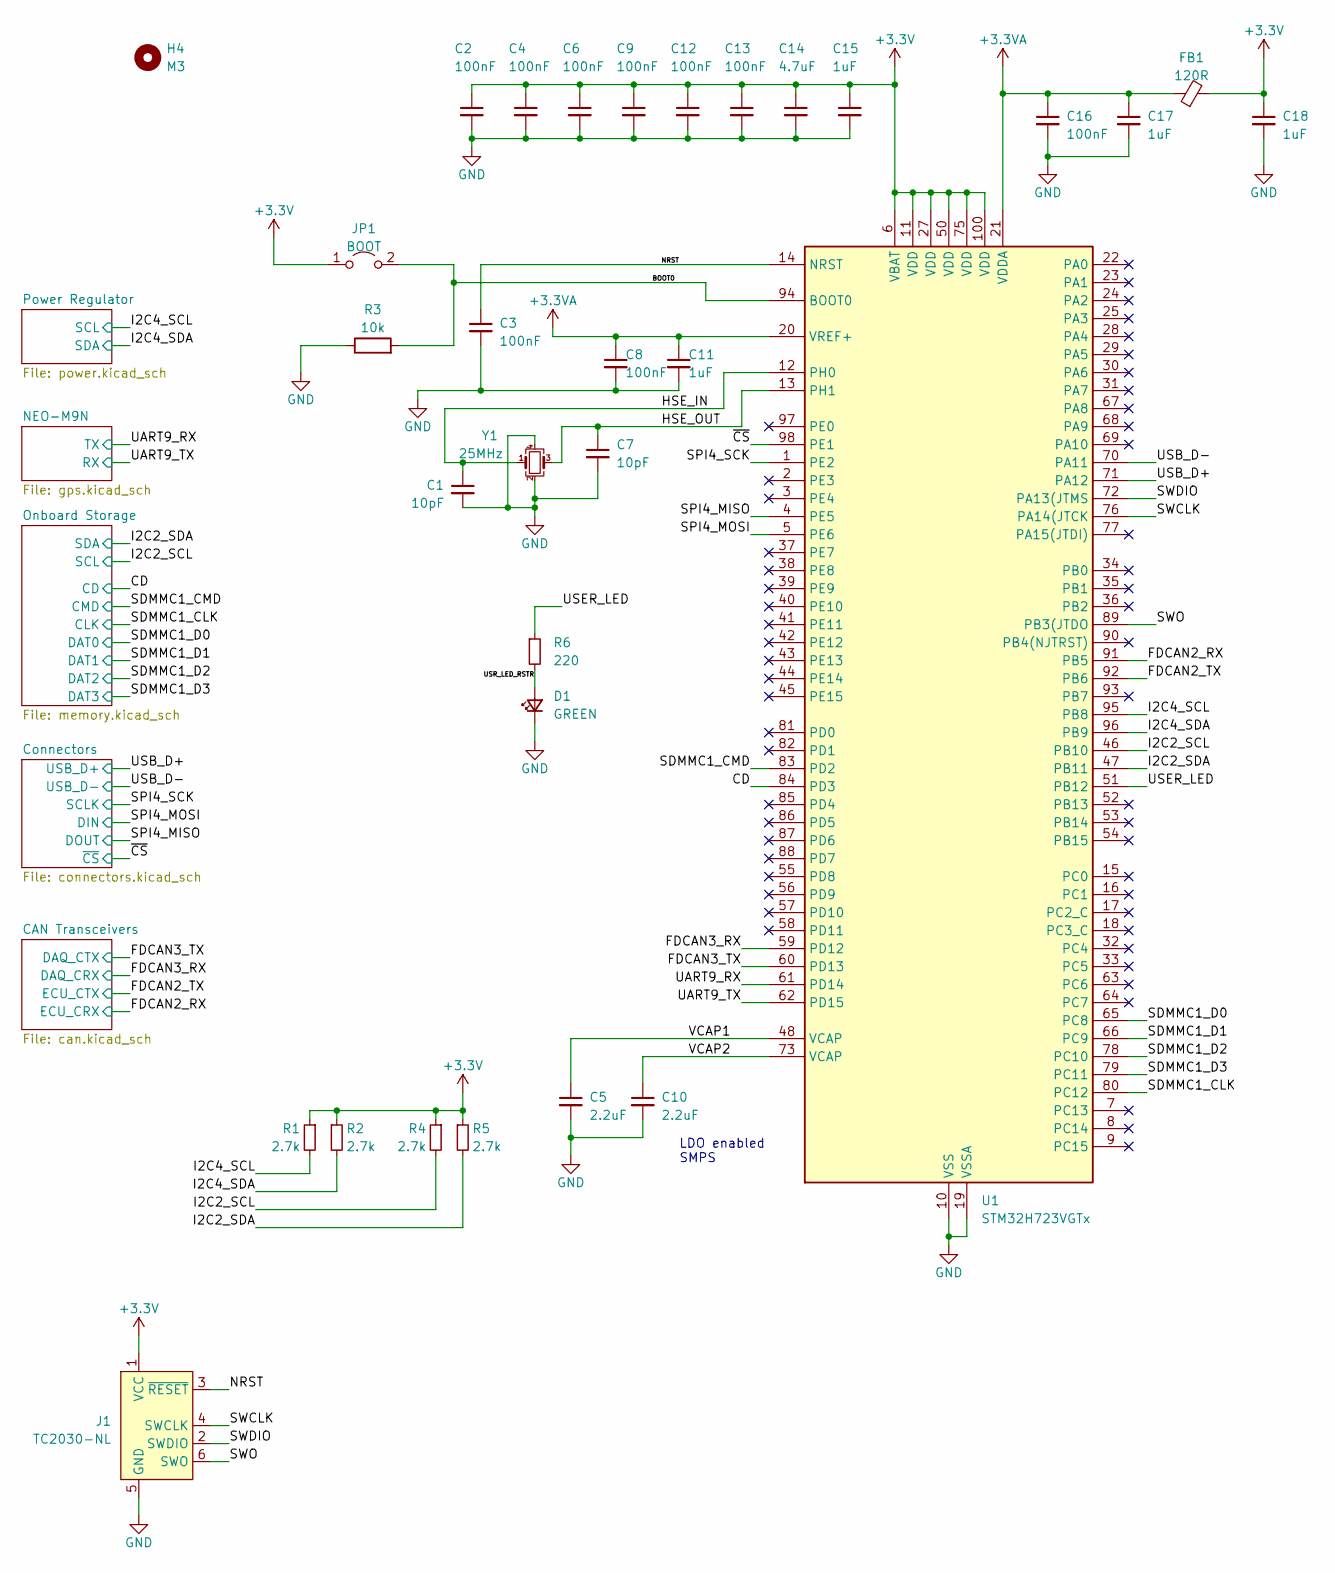
[picture p274: schematic sdm24logger.kicad_sch]

Parts:
C1, C7: 10pF; C_0402_1005Metric
C2, C3, C4, C6, C8, C9, C12, C13, C16: 100nF; C_0402_1005Metric
C5, C10: 2.2uF; C_0603_1608Metric
C11, C15, C17, C18: 1uF; C_0603_1608Metric
C14: 4.7uF; C_0603_1608Metric
D1: GREEN; SSF-LXH100LGD
FB1: 120R; L_0603_1608Metric
H4: M3; MountingHole_3.2mm_M3
J1: TC2030-NL; Tag-Connect_TC2030-IDC-NL_2x03_P1.27mm_Vertical
JP1: BOOT; PinHeader_1x02_P2.54mm_Vertical
R1, R2, R4, R5: 2.7k; R_0603_1608Metric
R3: 10k; R_0603_1608Metric
R6: 220; R_0603_1608Metric
U1: STM32H723VGTx; LQFP-100_14x14mm_P0.5mm
Y1: 25MHz; Crystal_SMD_2016-4Pin_2.0x1.6mm

Connections:
+3.3V: C2.1, C4.1, C6.1, C9.1, C12.1, C13.1, C14.1, C15.1, C18.1, FB1.2, J1.1 (VCC), JP1.1 (A), R1.1, R2.1, R4.1, R5.1, U1.6 (VBAT), U1.11 (VDD), U1.27 (VDD), U1.50 (VDD), U1.75 (VDD), U1.100 (VDD)
+3.3VA: C8.1, C11.1, C16.1, C17.1, FB1.1, U1.20 (VREF+), U1.21 (VDDA)
BOOT0: JP1.2 (B), R3.2, U1.94 (BOOT0)
CD: U1.84 (PD3)
FDCAN2_RX: U1.91 (PB5)
FDCAN2_TX: U1.92 (PB6)
FDCAN3_RX: U1.59 (PD12)
FDCAN3_TX: U1.60 (PD13)
GND: C1.2, C2.2, C3.2, C4.2, C5.2, C6.2, C7.2, C8.2, C9.2, C10.2, C11.2, C12.2, C13.2, C14.2, C15.2, C16.2, C17.2, C18.2, D1.1 (K), J1.5 (GND), R3.1, U1.10 (VSS), U1.19 (VSSA), U1.26 (VSS), U1.49 (VSS), U1.74 (VSS), U1.99 (VSS), Y1.2, Y1.4
HSE_IN: C1.1, U1.12 (PH0), Y1.1
HSE_OUT: C7.1, U1.13 (PH1), Y1.3
I2C2_SCL: R4.2, U1.46 (PB10)
I2C2_SDA: R5.2, U1.47 (PB11)
I2C4_SCL: R1.2, U1.95 (PB8)
I2C4_SDA: R2.2, U1.96 (PB9)
NRST: C3.1, J1.3 (~RESET), U1.14 (NRST)
SDMMC1_CLK: U1.80 (PC12)
SDMMC1_CMD: U1.83 (PD2)
SDMMC1_D0: U1.65 (PC8)
SDMMC1_D1: U1.66 (PC9)
SDMMC1_D2: U1.78 (PC10)
SDMMC1_D3: U1.79 (PC11)
SPI4_MISO: U1.4 (PE5)
SPI4_MOSI: U1.5 (PE6)
SPI4_SCK: U1.1 (PE2)
SWCLK: J1.4 (SWCLK), U1.76 (PA14(JTCK)
SWDIO: J1.2 (SWDIO), U1.72 (PA13(JTMS)
SWO: J1.6 (SWO), U1.89 (PB3(JTDO)
UART9_RX: U1.61 (PD14)
UART9_TX: U1.62 (PD15)
USB_D+: U1.71 (PA12)
USB_D-: U1.70 (PA11)
USER_LED: R6.1, U1.51 (PB12)
USR_LED_RSTR: D1.2 (A), R6.2
VCAP1: C5.1, U1.48 (VCAP)
VCAP2: C10.1, U1.73 (VCAP)
~CS: U1.98 (PE1)

Notes on the sheet:
LDO enabled SMPS
