sundevilmotorsports/pcb-dev/PRE2026/telemetry/telemetry.kicad_sch

## KiCad design PRE2026/telemetry/telemetry.kicad_sch (2024-01-15)

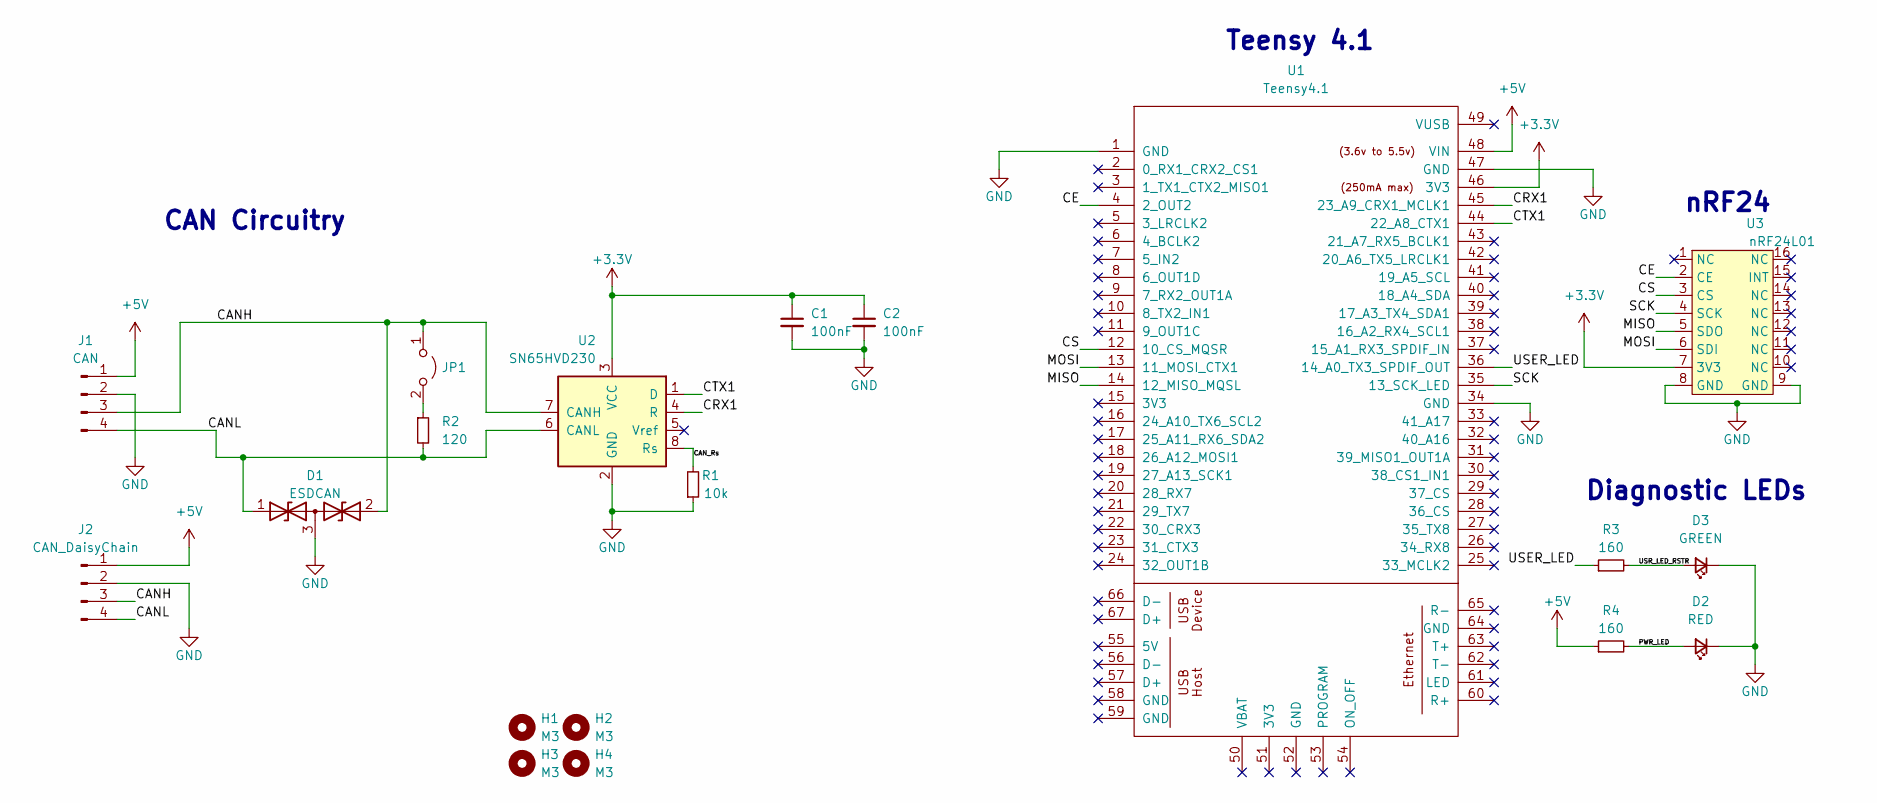
[picture p276: schematic telemetry.kicad_sch]

Parts:
C1, C2: 100nF; C_0603_1608Metric
D1: ESDCAN; SOT-323_SC-70
D2: RED; LED_1206_3216Metric
D3: GREEN; LED_1206_3216Metric
H1, H2, H3, H4: M3; MountingHole_3.2mm_M3
J1: CAN; JST_XH_B4B-XH-AM_1x04_P2.50mm_Vertical
J2: CAN_DaisyChain; JST_XH_B4B-XH-AM_1x04_P2.50mm_Vertical
JP1: Bus Termination; PinHeader_1x02_P2.54mm_Vertical
R1: 10k; R_0805_2012Metric
R2: 120; R_0603_1608Metric
R3, R4: 160; R_0805_2012Metric
U1: Teensy4.1; Teensy41
U2: SN65HVD230; SOIC-8_3.9x4.9mm_P1.27mm
U3: nRF24L01; nrf24L01-click

Connections:
+3.3V: C1.1, C2.1, U1.46 (3V3), U2.3 (VCC), U3.7 (3V3)
+5V: J1.1, J2.1, R4.1, U1.48 (VIN)
CANH: D1.2 (A2), J1.3, J2.3, JP1.1 (A), U2.7 (CANH)
CANL: D1.1 (A1), J1.4, J2.4, R2.2, U2.6 (CANL)
CAN_Rs: R1.2, U2.8 (Rs)
CE: U1.4 (2_OUT2), U3.2 (CE)
CRX1: U1.45 (23_A9_CRX1_MCLK1), U2.4 (R)
CS: U1.12 (10_CS_MQSR), U3.3 (CS)
CTX1: U1.44 (22_A8_CTX1), U2.1 (D)
GND: C1.2, C2.2, D1.3 (common), D2.1 (K), D3.1 (K), J1.2, J2.2, R1.1, U1.1 (GND), U1.34 (GND), U1.47 (GND), U2.2 (GND), U3.8 (GND), U3.9 (GND)
MISO: U1.14 (12_MISO_MQSL), U3.5 (SDO)
MOSI: U1.13 (11_MOSI_CTX1), U3.6 (SDI)
unnamed: JP1.2 (B), R2.1
PWR_LED: D2.2 (A), R4.2
SCK: U1.35 (13_SCK_LED), U3.4 (SCK)
USER_LED: R3.1, U1.36 (14_A0_TX3_SPDIF_OUT)
USR_LED_RSTR: D3.2 (A), R3.2

Notes on the sheet:
nRF24
CAN Circuitry
Diagnostic LEDs
Teensy 4.1
