sundevilmotorsports/pcb-dev/PRE2026/wheelspeed/wheelspeed.kicad_sch

## KiCad design PRE2026/wheelspeed/wheelspeed.kicad_sch (2023-11-30)

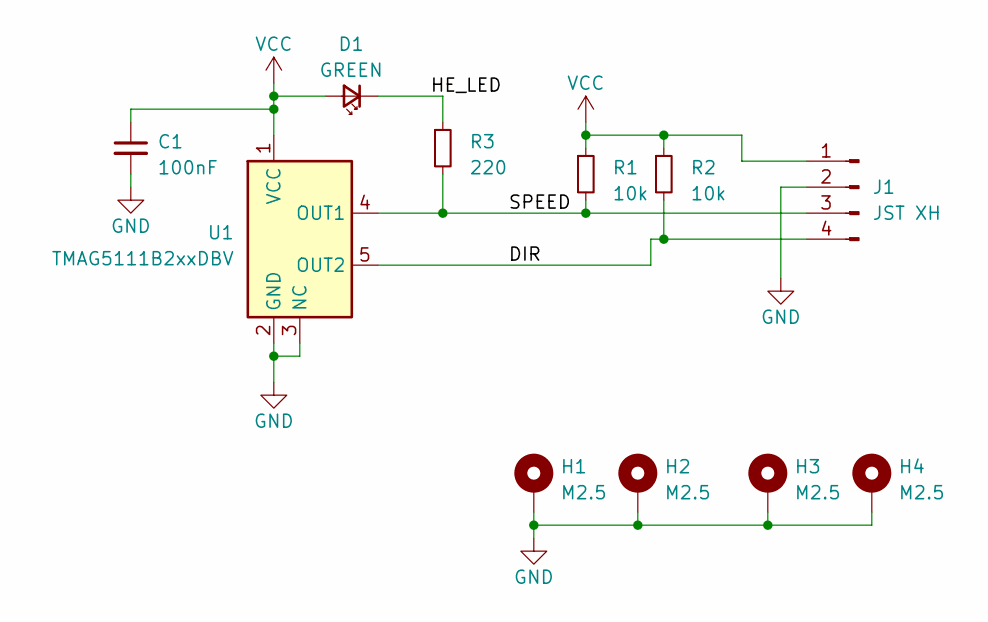
[picture p277: schematic wheelspeed.kicad_sch]

Parts:
C1: 100nF; C_0603_1608Metric
D1: GREEN; LED_1206_3216Metric
H1, H2, H3, H4: M2.5; MountingHole_2.7mm_M2.5_ISO7380_Pad
J1: JST XH; JST_XH_B4B-XH-AM_1x04_P2.50mm_Vertical
R1, R2: 10k; R_0805_2012Metric
R3: 220; R_0805_2012Metric
U1: TMAG5111B2xxDBV; SOT-23-5

Connections:
DIR: J1.4, R2.2, U1.5 (OUT2)
GND: C1.2, H1.1, H2.1, H3.1, H4.1, J1.2, U1.2 (GND), U1.3 (NC)
HE_LED: D1.1 (K), R3.1
SPEED: J1.3, R1.2, R3.2, U1.4 (OUT1)
VCC: C1.1, D1.2 (A), J1.1, R1.1, R2.1, U1.1 (VCC)
