sundevilmotorsports/pcb-dev/2026/BSPD_Test_Bench/SDM26_BSPD_Test_Bench_V1.0/SDM26_BSPD_Test_Bench_V1.0.kicad_sch

## KiCad design 2026/BSPD_Test_Bench/SDM26_BSPD_Test_Bench_V1.0/SDM26_BSPD_Test_Bench_V1.0.kicad_sch (2026-11-06)

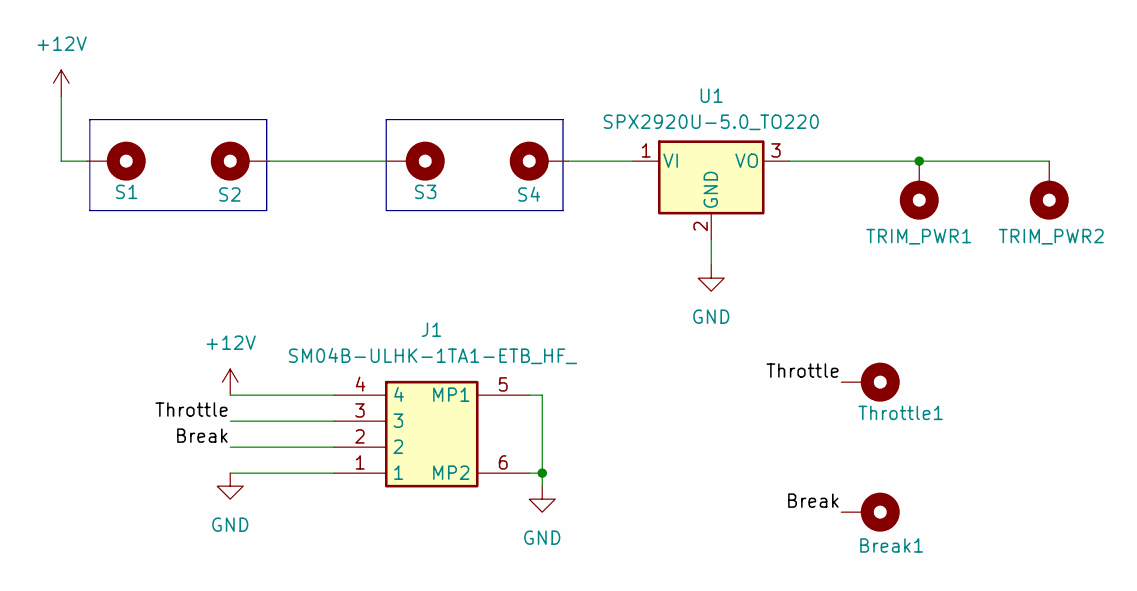
[picture p278: schematic SDM26_BSPD_Test_Bench_V1.0.kicad_sch]

Parts:
Break1: MountingHole_Pad_MP; MountingHole_2.2mm_M2_Pad_TopBottom
J1: SM04B-ULHK-1TA1-ETB_HF_; SM04BULHK1TA1ETBHF; Mouser Part Number 306-SM4BULH1TA1ETBHF
S1, S2, S3, S4: MountingHole_Pad_MP; MountingHole_2.2mm_M2_Pad_TopBottom
TRIM_PWR1, TRIM_PWR2: MountingHole_Pad_MP; MountingHole_2.2mm_M2_Pad_TopBottom
Throttle1: MountingHole_Pad_MP; MountingHole_2.2mm_M2_Pad_TopBottom
U1: SPX2920U-5.0_TO220; TO-220-3_Vertical

Connections:
+12V: J1.4, S1.MP
Break: Break1.MP, J1.2
GND: J1.1, J1.5 (MP1), J1.6 (MP2), U1.2 (GND)
unnamed: S2.MP, S3.MP
unnamed: S4.MP, U1.1 (VI)
unnamed: TRIM_PWR1.MP, TRIM_PWR2.MP, U1.3 (VO)
Throttle: J1.3, Throttle1.MP
