sundevilmotorsports/pcb-dev/2027/SDM27_S3_Logger/SDM27_S3_Logger_V1/SDM27_S3_LoggerV1.0.kicad_sch

## KiCad design 2027/SDM27_S3_Logger/SDM27_S3_Logger_V1/SDM27_S3_LoggerV1.0.kicad_sch (2026-11-06)

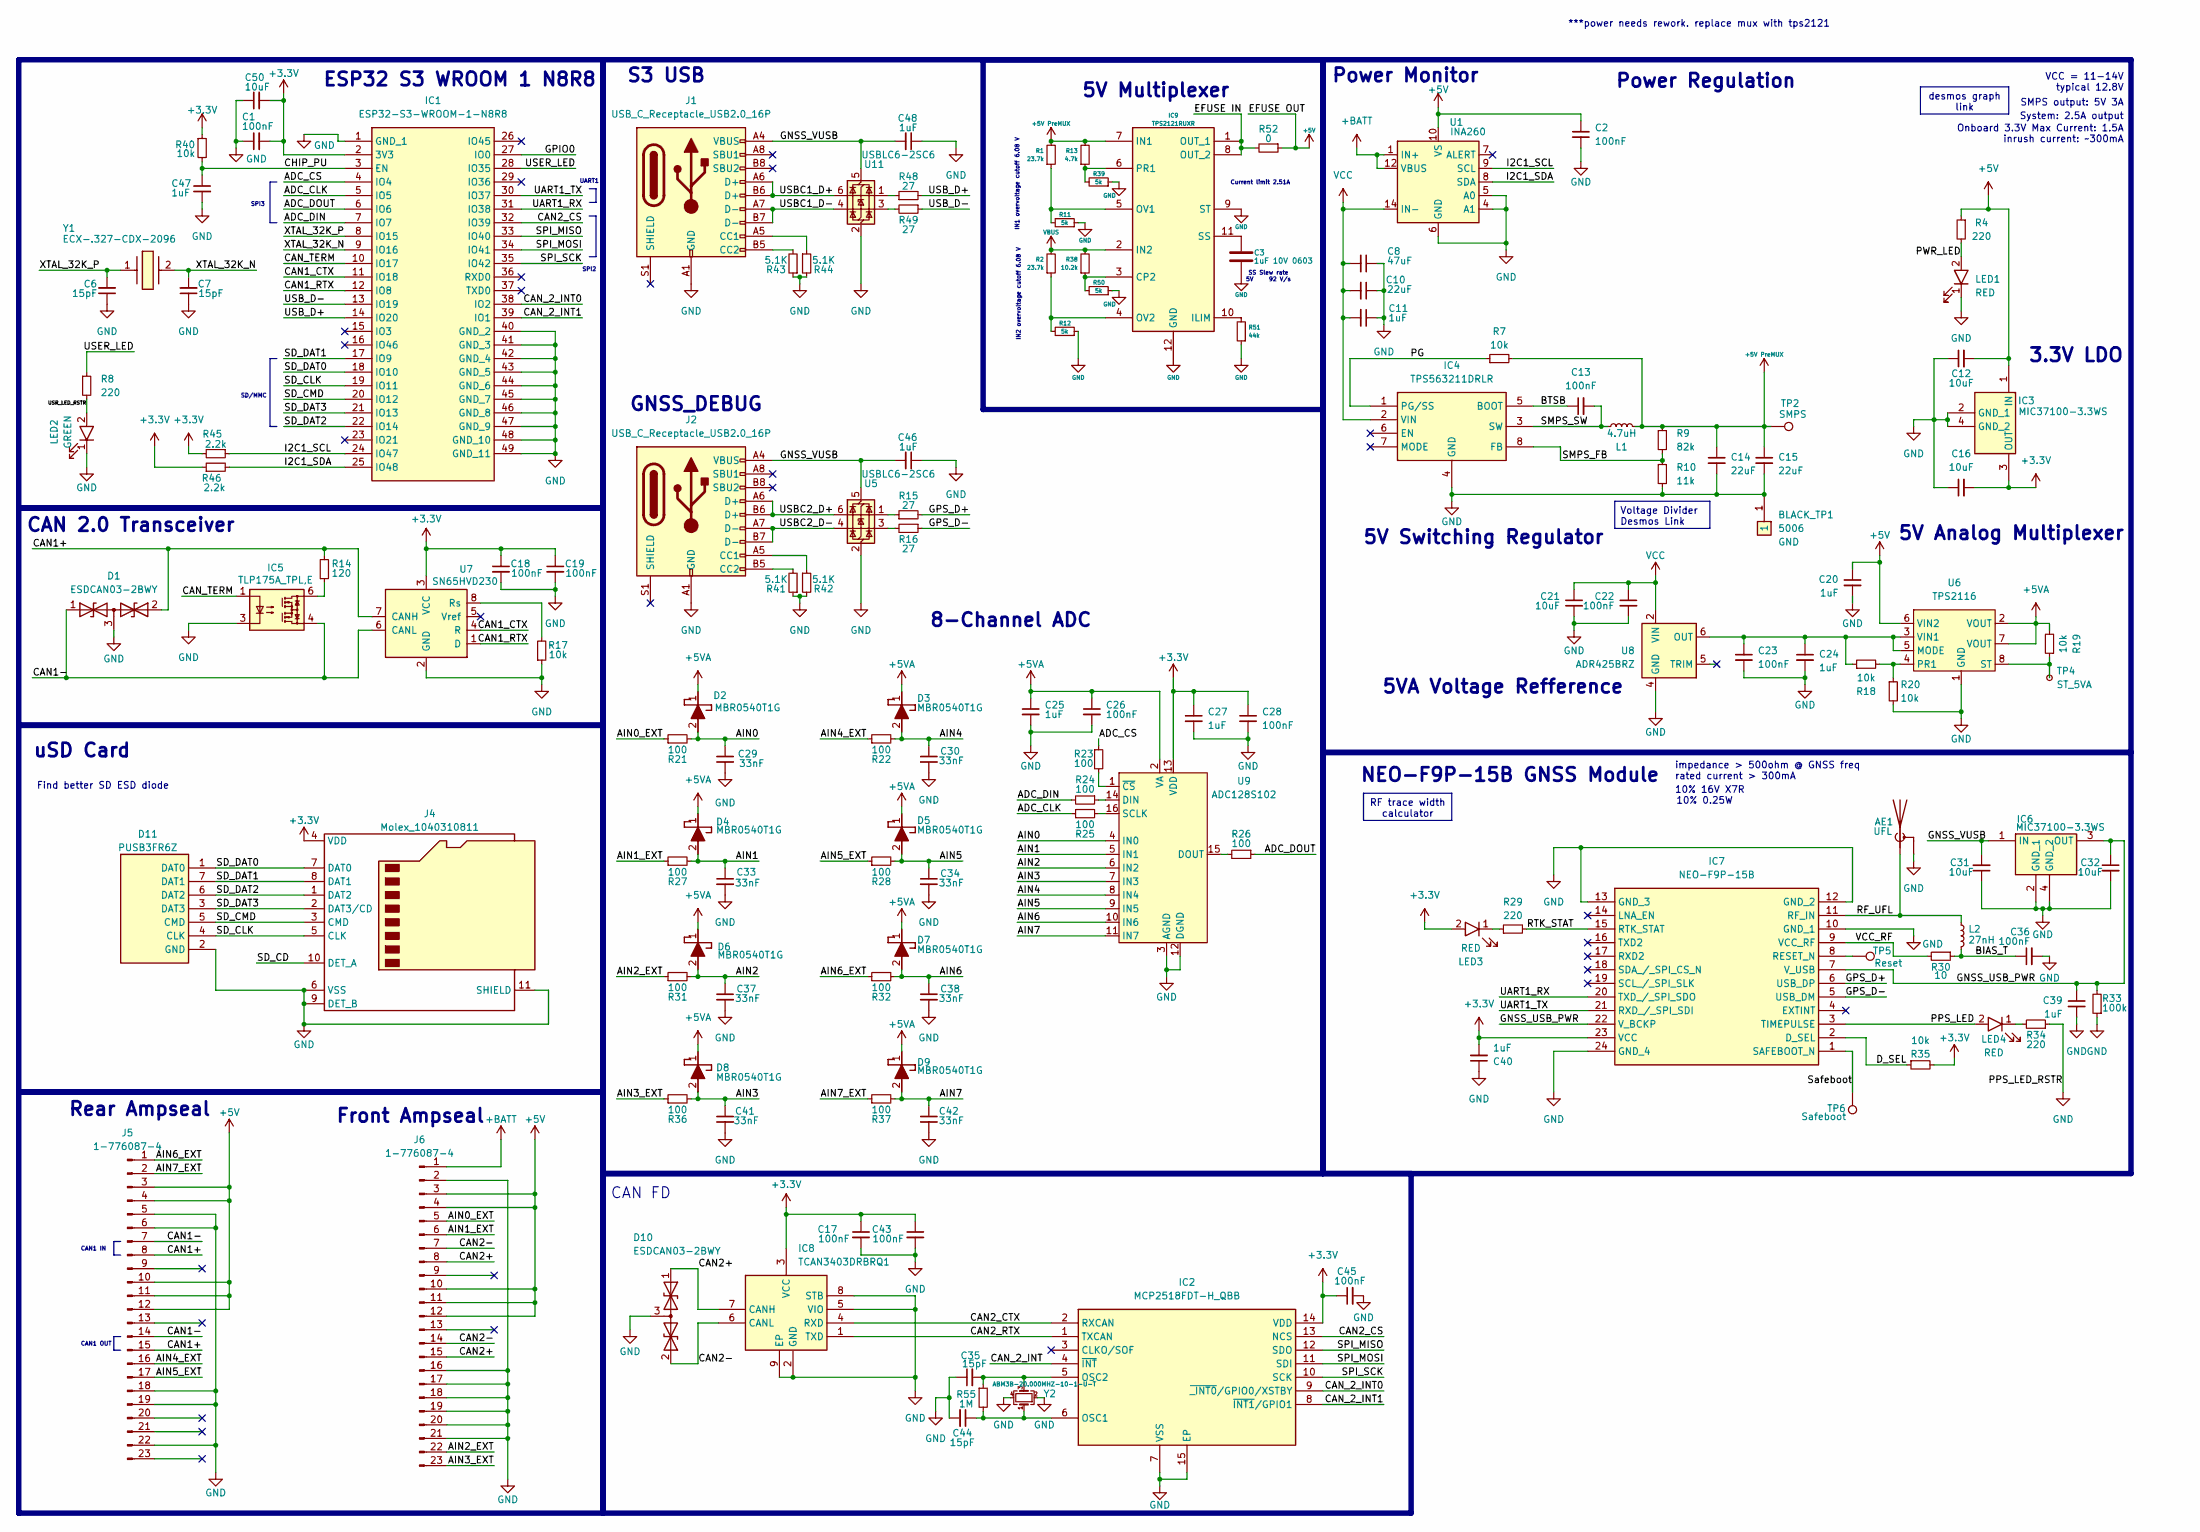
[picture p279: schematic SDM27_S3_LoggerV1.0.kicad_sch]

Parts:
AE1: UFL; U.FL_Molex_MCRF_73412-0110_Vertical
BLACK_TP1: 5006; Mouser Part Number 534-5006
C1, C2, C13, C18, C19, C22, C23, C26, C28, C36, C45: 100nF; C_0603_1608Metric
C3: 1uF 10V 0603; C_0603_1608Metric
C6, C7, C35, C44: 15pF; C_0603_1608Metric
C8: 47uF; CP_Elec_6.3x5.9
C10, C14, C15: 22uF; C_0603_1608Metric
C11, C20, C24, C25, C27, C39, C40, C46, C47, C48: 1uF; C_0603_1608Metric
C12, C16, C21, C31, C32, C50: 10uF; C_0603_1608Metric
C17, C43: 100nF; C_0402_1005Metric
C29, C30, C33, C34, C37, C38, C41, C42: 33nF; C_0603_1608Metric
D1, D10: ESDCAN03-2BWY; SOT65P210X110-3N; Mouser Part Number 511-ESDCAN03-2BWY
D2, D3, D4, D5, D6, D7, D8, D9: MBR0540T1G; SOD3716X135N; Mouser Part Number 863-MBR0540T1G
D11: PUSB3FR6Z; Mouser Part Number 771-PUSB3FR6Z
IC1: ESP32-S3-WROOM-1-N8R8; ESP32S3WROOM1N8R8; Mouser Part Number 356-EP32S3WROOM1N8R8
IC2: MCP2518FDT-H_QBB; SON65P300X450X90-15L-D; Mouser Part Number 579-MCP2518FDT-H/QBB
IC3, IC6: MIC37100-3.3WS; SOT230P700X180-4N; Mouser Part Number 998-MIC37100-3.3WS
IC4: TPS563211DRLR; SOTFL50P160X60-8N; Mouser Part Number 595-TPS563211DRLR
IC5: TLP175A_TPL,E; TLP266J; Mouser Part Number 757-TLP175A(TPLE
IC7: NEO-F9P-15B; NEOF9P15B; Mouser Part Number 377-NEO-F9P-15B
IC8: TCAN3403DRBRQ1; SON65P300X300X100-9N-D; Manufacturer_Part_Number TCAN3403DRBRQ1; Mouser Part Number 595-TCAN3403DRBRQ1
IC9: TPS2121RUXR; Mouser Part Number 595-TPS2121RUXR
J1, J2: USB_C_Receptacle_USB2.0_16P; USB_C_Receptacle_G-Switch_GT-USB-7010ASV
J4: Molex_1040310811; microSD_HC_Molex_104031-0811
J5, J6: 1-776087-4; CONN23_776087_TEC
L1: 4.7uH; L_Bourns_SRP7028A_7.3x6.6mm
L2: 27nH; L_0402_1005Metric
LED1, LED3, LED4: RED; SSFLXH100LID01; Mouser Part Number 696-SSFLXH100LID01
LED2: GREEN; SSFLXH100LID01; Mouser Part Number 696-SSFLXH100LID01
R1, R2: 23.7k; R_0402_1005Metric
R4, R8, R29, R34: 220; R_0603_1608Metric
R7, R17, R18, R19, R20, R35, R40: 10k; R_0603_1608Metric
R9: 82k; R_0603_1608Metric
R10: 11k; R_0603_1608Metric
R11, R12, R39, R50: 5k; R_0402_1005Metric
R13: 4.7k; R_0402_1005Metric
R14: 120; R_0603_1608Metric
R15, R16, R48, R49: 27; R_0603_1608Metric
R21, R22, R23, R24, R25, R26, R27, R28, R31, R32, R36, R37: 100; R_0603_1608Metric
R30: 10; R_0603_1608Metric
R33: 100k; R_0603_1608Metric
R38: 10.2k; R_0402_1005Metric
R41, R42, R43, R44: 5.1K; R_0603_1608Metric
R45, R46: 2.2k; R_0603_1608Metric
R51: 44k; R_0402_1005Metric
R52: 0; R_0603_1608Metric
R55: 1M; R_0603_1608Metric
TP2: SMPS; TestPoint_Pad_1.5x1.5mm
TP4: ST_5VA; TestPoint_Pad_1.5x1.5mm
TP5: Reset; TestPoint_Pad_1.5x1.5mm
TP6: Safeboot; TestPoint_Pad_1.5x1.5mm
U1: INA260; TSSOP-16_4.4x5mm_P0.65mm
U5, U11: USBLC6-2SC6; SOT-23-6
U6: TPS2116; SOT-5X3
U7: SN65HVD230; SOIC-8_3.9x4.9mm_P1.27mm
U8: ADR425BRZ; SOIC-8_3.9x4.9mm_P1.27mm
U9: ADC128S102; TSSOP-16_4.4x5mm_P0.65mm
Y1: ECX-.327-CDX-2096; ECX327CDX2096; Mouser Part Number 520-X-.327-CDX2096
Y2: ABM3B-20.000MHZ-10-1-U-T; ABM3B; Mouser Part Number 815-ABM3B-20-T

Connections:
+3.3V: C1.2, C16.2, C17.1, C18.1, C19.1, C27.1, C28.1, C40.2, C43.1, C45.1, C50.2, IC1.2 (3V3), IC2.14 (VDD), IC3.3 (OUT), IC7.23 (VCC), IC8.3 (VCC), J4.4 (VDD), LED3.2 (A), R35.2, R40.1, R45.2, R46.1, U7.3 (VCC), U9.13 (VDD)
+5V: C2.1, C12.2, C20.1, IC3.1 (IN), J5.3, J5.4, J5.10, J5.11, J5.12, J6.3, J6.4, J6.10, J6.11, J6.12, R4.1, R52.1, U1.10 (VS), U6.6 (VIN2)
+5V PreMUX: C14.1, C15.1, IC9.7 (IN1), L1.1, R1.2, R7.2, R9.1, R13.2, TP2.1
+5VA: C25.1, C26.1, D2.1 (K), D3.1 (K), D4.1 (K), D5.1 (K), D6.1 (K), D7.1 (K), D8.1 (K), D9.1 (K), R19.2, U6.2 (VOUT), U6.7 (VOUT), U9.2 (VA)
+BATT: J6.1, U1.1 (IN+), U1.2 (IN+), U1.3 (IN+), U1.12 (VBUS)
ADC_CLK: IC1.5 (IO5), R25.1
ADC_CS: IC1.4 (IO4), R23.1
ADC_DIN: IC1.7 (IO7), R24.2
ADC_DOUT: IC1.6 (IO6), R26.1
AIN0: C29.1, D2.2 (A), R21.2, U9.4 (IN0)
AIN0_EXT: J6.5, R21.1
AIN1: C33.1, D4.2 (A), R27.2, U9.5 (IN1)
AIN1_EXT: J6.6, R27.1
AIN2: C37.1, D6.2 (A), R31.2, U9.6 (IN2)
AIN2_EXT: J6.22, R31.1
AIN3: C41.1, D8.2 (A), R36.2, U9.7 (IN3)
AIN3_EXT: J6.23, R36.1
AIN4: C30.1, D3.2 (A), R22.2, U9.8 (IN4)
AIN4_EXT: J5.16, R22.1
AIN5: C34.1, D5.2 (A), R28.2, U9.9 (IN5)
AIN5_EXT: J5.17, R28.1
AIN6: C38.1, D7.2 (A), R32.2, U9.10 (IN6)
AIN6_EXT: J5.1, R32.1
AIN7: C42.1, D9.2 (A), R37.2, U9.11 (IN7)
AIN7_EXT: J5.2, R37.1
BIAS_T: C36.1, L2.2, R30.1
BTSB: C13.1, IC4.5 (BOOT)
CAN1+: D1.2, J5.8, J5.15, R14.2, U7.7 (CANH)
CAN1-: D1.1, IC5.4, J5.7, J5.14, U7.6 (CANL)
CAN1_CTX: IC1.11 (IO18), U7.4 (R)
CAN1_RTX: IC1.12 (IO8), U7.1 (D)
CAN2+: D10.1, IC8.7 (CANH), J6.8, J6.15
CAN2-: D10.2, IC8.6 (CANL), J6.7, J6.14
CAN2_CS: IC1.32 (IO39), IC2.13 (NCS)
CAN2_CTX: IC2.2 (RXCAN), IC8.4 (RXD)
CAN2_RTX: IC2.1 (TXCAN), IC8.1 (TXD)
CAN_2_INT: IC2.4 (~INT)
CAN_2_INT0: IC1.38 (IO2), IC2.9 (~_INT0/GPIO0/XSTBY)
CAN_2_INT1: IC1.39 (IO1), IC2.8 (~INT1/GPIO1)
CAN_TERM: IC1.10 (IO17), IC5.1
CHIP_PU: C47.1, IC1.3 (EN), R40.2
D_SEL: IC7.2 (D_SEL), R35.1
EFUSE IN: IC9.1 (OUT_1), IC9.8 (OUT_2), R52.2
GND: AE1.2 (Shield), BLACK_TP1.1, C1.1, C2.2, C3.2, C6.1, C7.1, C8.1, C10.1, C11.1, C12.1, C14.2, C15.2, C16.1, C17.2, C18.2, C19.2, C20.2, C21.2, C22.2, C23.2, C24.2, C25.2, C26.2, C27.2, C28.2, C29.2, C30.2, C31.1, C32.2, C33.2, C34.2, C35.1, C36.2, C37.2, C38.2, C39.2, C40.1, C41.2, C42.2, C43.2, C44.2, C45.2, C46.1, C47.2, C48.1, C50.1, D1.3, D10.3, D11.2 (GND), IC1.1 (GND_1), IC1.40 (GND_2), IC1.41 (GND_3), IC1.42 (GND_4), IC1.43 (GND_5), IC1.44 (GND_6), IC1.45 (GND_7), IC1.46 (GND_8), IC1.47 (GND_9), IC1.48 (GND_10), IC1.49 (GND_11), IC2.7 (VSS), IC2.15 (EP), IC3.2 (GND_1), IC3.4 (GND_2), IC4.4 (GND), IC5.3, IC6.2 (GND_1), IC6.4 (GND_2), IC7.10 (GND_1), IC7.12 (GND_2), IC7.13 (GND_3), IC7.24 (GND_4), IC8.2 (GND), IC8.5 (VIO), IC8.8 (STB), IC8.9 (EP), IC9.9 (ST), IC9.12 (GND), J1.A1 (GND), J2.A1 (GND), J4.6 (VSS), J4.9 (DET_B), J4.11 (SHIELD), J5.5, J5.6, J5.18, J5.19, J5.22, J6.2, J6.16, J6.17, J6.18, J6.19, J6.20, J6.21, LED1.1 (K), LED2.1 (K), R10.2, R11.1, R12.1, R17.1, R20.2, R33.1, R34.1, R39.1, R41.1, R42.2, R43.1, R44.2, R50.1, R51.1, U1.4 (A1), U1.5 (A0), U1.6 (GND), U1.11 (GND), U5.2 (GND), U6.1 (GND), U7.2 (GND), U8.4 (GND), U9.3 (AGND), U9.12 (DGND), U11.2 (GND), Y2.2 (GND_1), Y2.4 (GND_2)
GNSS_USB_PWR: C32.1, C39.1, IC6.3 (OUT), IC7.7 (V_USB), IC7.22 (V_BCKP), R33.2
GNSS_VUSB: C31.2, C46.2, C48.2, IC6.1 (IN), J1.A4 (VBUS), J1.A9 (VBUS), J1.B4 (VBUS), J1.B9 (VBUS), J2.A4 (VBUS), J2.A9 (VBUS), J2.B4 (VBUS), J2.B9 (VBUS), U5.5 (VBUS), U11.5 (VBUS)
GPIO0: IC1.27 (IO0)
GPS_D+: IC7.6 (USB_DP), R15.2
GPS_D-: IC7.5 (USB_DM), R16.1
I2C1_SCL: IC1.24 (IO47), R45.1, U1.9 (SCL)
I2C1_SDA: IC1.25 (IO48), R46.2, U1.8 (SDA)
unnamed: C3.1, IC9.11 (SS)
unnamed: C23.1, C24.1, R18.1, U6.3 (VIN1), U6.5 (MODE), U8.6 (OUT)
unnamed: C35.2, IC2.5 (OSC2), R55.1, Y2.3 (XTAL_2)
unnamed: C44.1, IC2.6 (OSC1), R55.2, Y2.1 (XTAL_1)
unnamed: IC5.6, R14.1
unnamed: IC7.8 (RESET_N), TP5.1
unnamed: IC9.3 (CP2), R38.1, R50.2
unnamed: IC9.4 (OV2), R2.1, R12.2
unnamed: IC9.5 (OV1), R1.1, R11.2
unnamed: IC9.6 (PR1), R13.1, R39.2
unnamed: IC9.10 (ILIM), R51.2
unnamed: J1.A5 (CC1), R44.1
unnamed: J1.B5 (CC2), R43.2
unnamed: J2.A5 (CC1), R42.1
unnamed: J2.B5 (CC2), R41.2
unnamed: LED3.1 (K), R29.1
unnamed: LED4.1 (K), R34.2
unnamed: R15.1, U5.1 (I/O1)
unnamed: R16.2, U5.3 (I/O2)
unnamed: R17.2, U7.8 (Rs)
unnamed: R18.2, R20.1, U6.4 (PR1)
unnamed: R19.1, TP4.1, U6.8 (ST)
unnamed: R23.2, U9.1 (~CS)
unnamed: R24.1, U9.14 (DIN)
unnamed: R25.2, U9.16 (SCLK)
unnamed: R26.2, U9.15 (DOUT)
unnamed: R48.1, U11.1 (I/O1)
unnamed: R49.2, U11.3 (I/O2)
PG: IC4.1 (PG/SS), R7.1
PPS_LED: IC7.3 (TIMEPULSE), LED4.2 (A)
PWR_LED: LED1.2 (A), R4.2
RF_UFL: AE1.1 (A), IC7.11 (RF_IN), L2.1
RTK_STAT: IC7.15 (RTK_STAT), R29.2
SD_CD: J4.10 (DET_A)
SD_CLK: D11.4 (CLK), IC1.19 (IO11), J4.5 (CLK)
SD_CMD: D11.5 (CMD), IC1.20 (IO12), J4.3 (CMD)
SD_DAT0: D11.1 (DAT0), IC1.18 (IO10), J4.7 (DAT0)
SD_DAT1: D11.7 (DAT1), IC1.17 (IO9), J4.8 (DAT1)
SD_DAT2: D11.6 (DAT2), IC1.22 (IO14), J4.1 (DAT2)
SD_DAT3: D11.3 (DAT3), IC1.21 (IO13), J4.2 (DAT3/CD)
SMPS_FB: IC4.8 (FB), R9.2, R10.1
SMPS_SW: C13.2, IC4.3 (SW), L1.2
SPI_MISO: IC1.33 (IO40), IC2.12 (SDO)
SPI_MOSI: IC1.34 (IO41), IC2.11 (SDI)
SPI_SCK: IC1.35 (IO42), IC2.10 (SCK)
Safeboot: IC7.1 (SAFEBOOT_N), TP6.1
UART1_RX: IC1.31 (IO38), IC7.20 (TXD_/_SPI_SDO)
UART1_TX: IC1.30 (IO37), IC7.21 (RXD_/_SPI_SDI)
USBC1_D+: J1.A6 (D+), J1.B6 (D+), U11.6 (I/O1)
USBC1_D-: J1.A7 (D-), J1.B7 (D-), U11.4 (I/O2)
USBC2_D+: J2.A6 (D+), J2.B6 (D+), U5.6 (I/O1)
USBC2_D-: J2.A7 (D-), J2.B7 (D-), U5.4 (I/O2)
USB_D+: IC1.14 (IO20), R48.2
USB_D-: IC1.13 (IO19), R49.1
USER_LED: IC1.28 (IO35), R8.1
USR_LED_RSTR: LED2.2 (A), R8.2
VBUS: IC9.2 (IN2), R2.2, R38.2
VCC: C8.2, C10.2, C11.2, C21.1, C22.1, IC4.2 (VIN), U1.14 (IN-), U1.15 (IN-), U1.16 (IN-), U8.2 (VIN)
VCC_RF: IC7.9 (VCC_RF), R30.2
XTAL_32K_N: C7.2, IC1.9 (IO16), Y1.2
XTAL_32K_P: C6.2, IC1.8 (IO15), Y1.1

Notes on the sheet:
Power Regulation
CAN 2.0 Transceiver
SPI3
SD/MMC
10% 16V X7R
Find better SD ESD diode
inrush current: ~300mA
5V Switching Regulator
5V Multiplexer
5V Analog Multiplexer
ESP32 S3 WROOM 1 N8R8
SS Slew rate 5V 92 V/s
Power Monitor
IN2 overvoltage cutoff 6.08 V
CAN1 IN
UART1
IN1 overvoltage cutoff 6.08 V
S3 USB
10% 0.25W
Onboard 3.3V Max Current: 1.5A
CAN FD
impedance > 500ohm @ GNSS freq rated current > 300mA
Front Ampseal
3.3V LDO
VCC = 11-14V typical 12.8V
GNSS_DEBUG
8-Channel ADC
uSD Card
5VA Voltage Refference
***power needs rework. replace mux with tps2121
SMPS output: 5V 3A
CAN1 OUT
SPI2
NEO-F9P-15B GNSS Module
System: 2.5A output
Current limit 2.51A
Rear Ampseal
desmos graph link
Voltage Divider Desmos Link
RF trace width calculator
