sundevilmotorsports/pcb-dev/2027/SDM27_Telemetry/SDM27_Telemetry_V1/SDM27_Telemetry_V1.kicad_sch

## KiCad design 2027/SDM27_Telemetry/SDM27_Telemetry_V1/SDM27_Telemetry_V1.kicad_sch (2026-11-06)

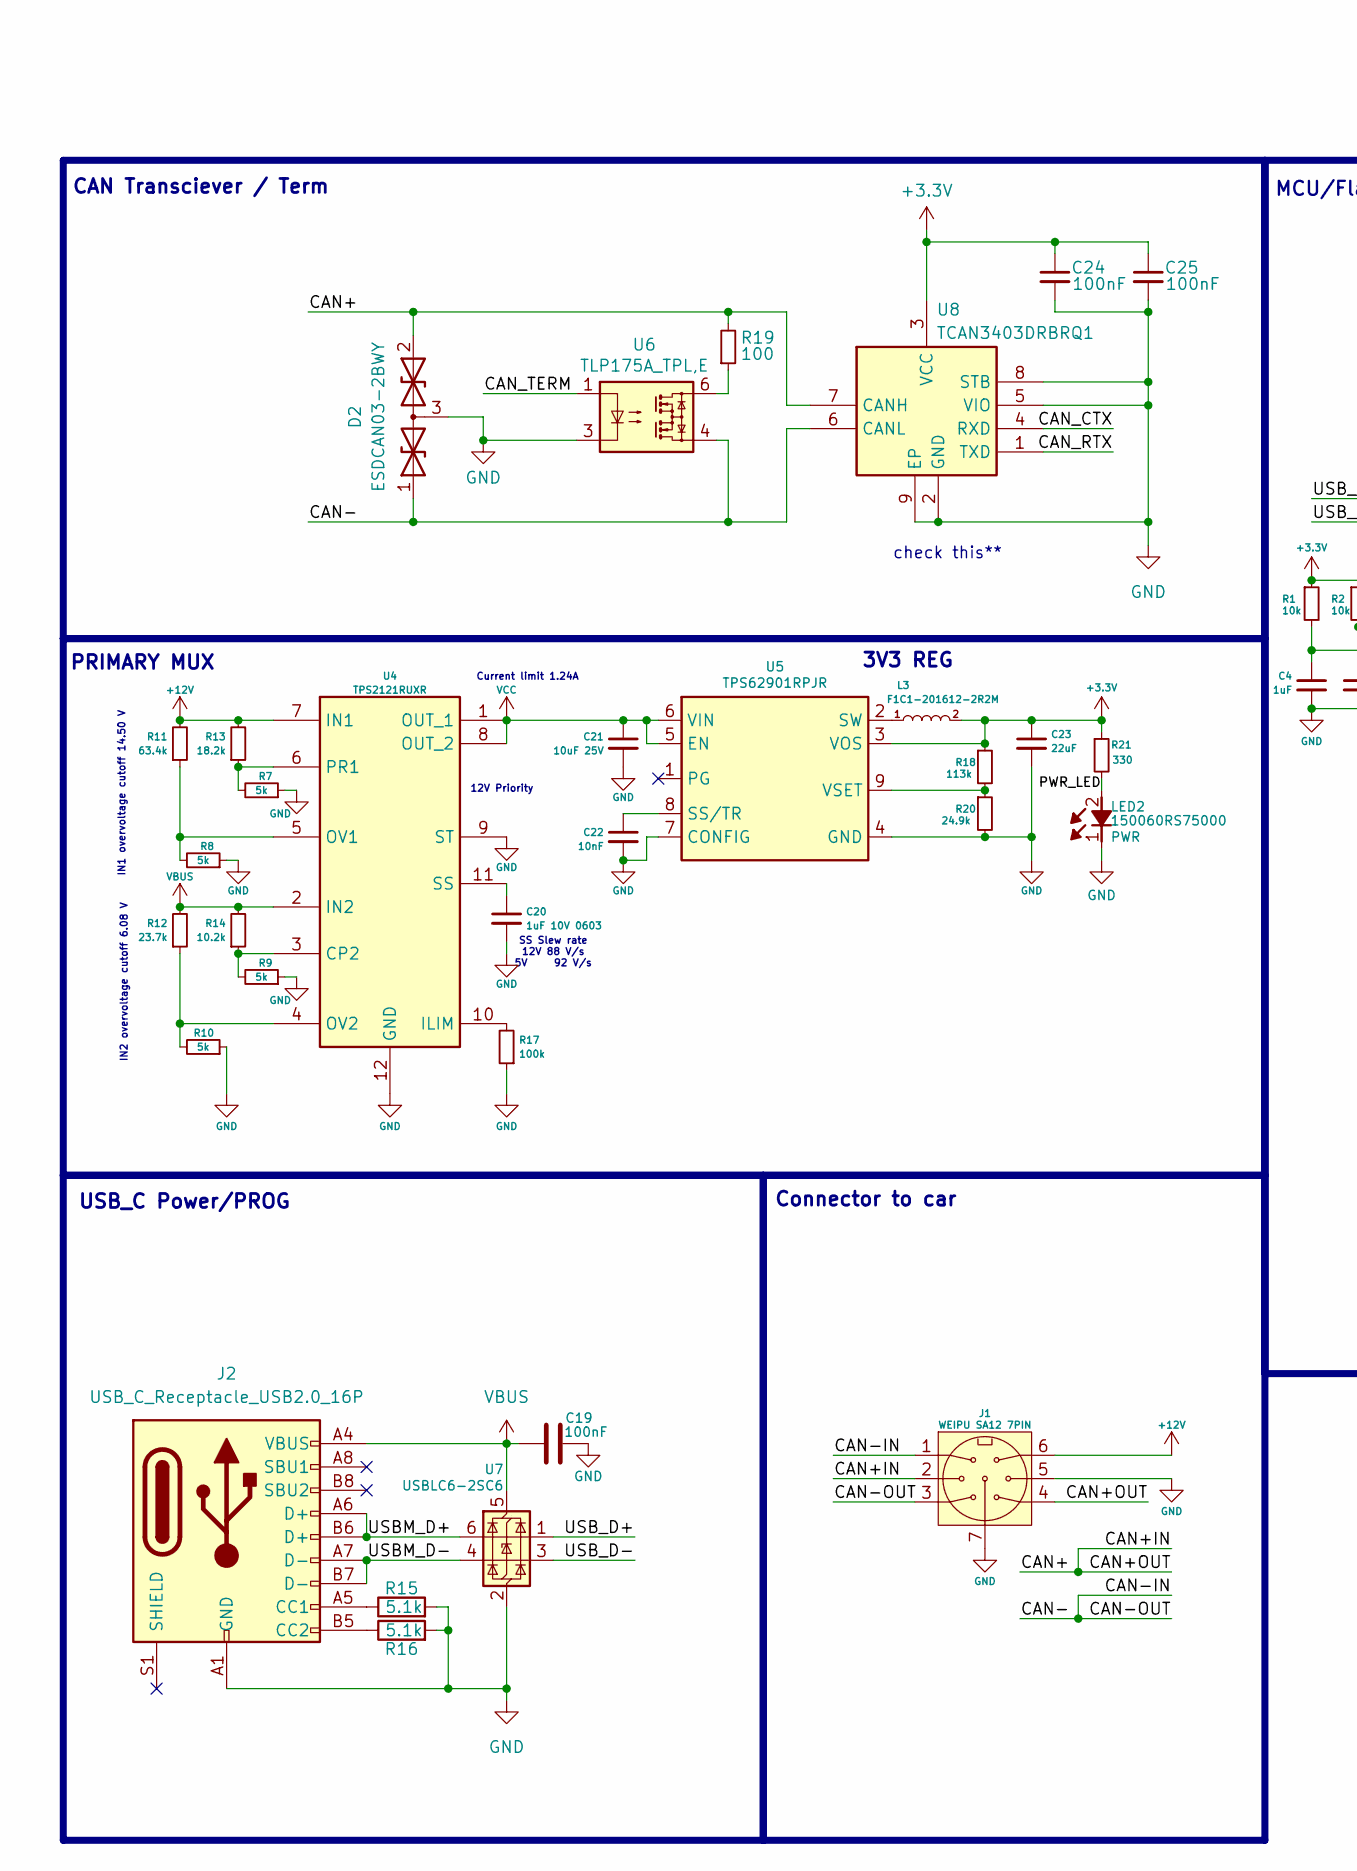
[picture p280: schematic SDM27_Telemetry_V1.kicad_sch, part in row 2, column 1]

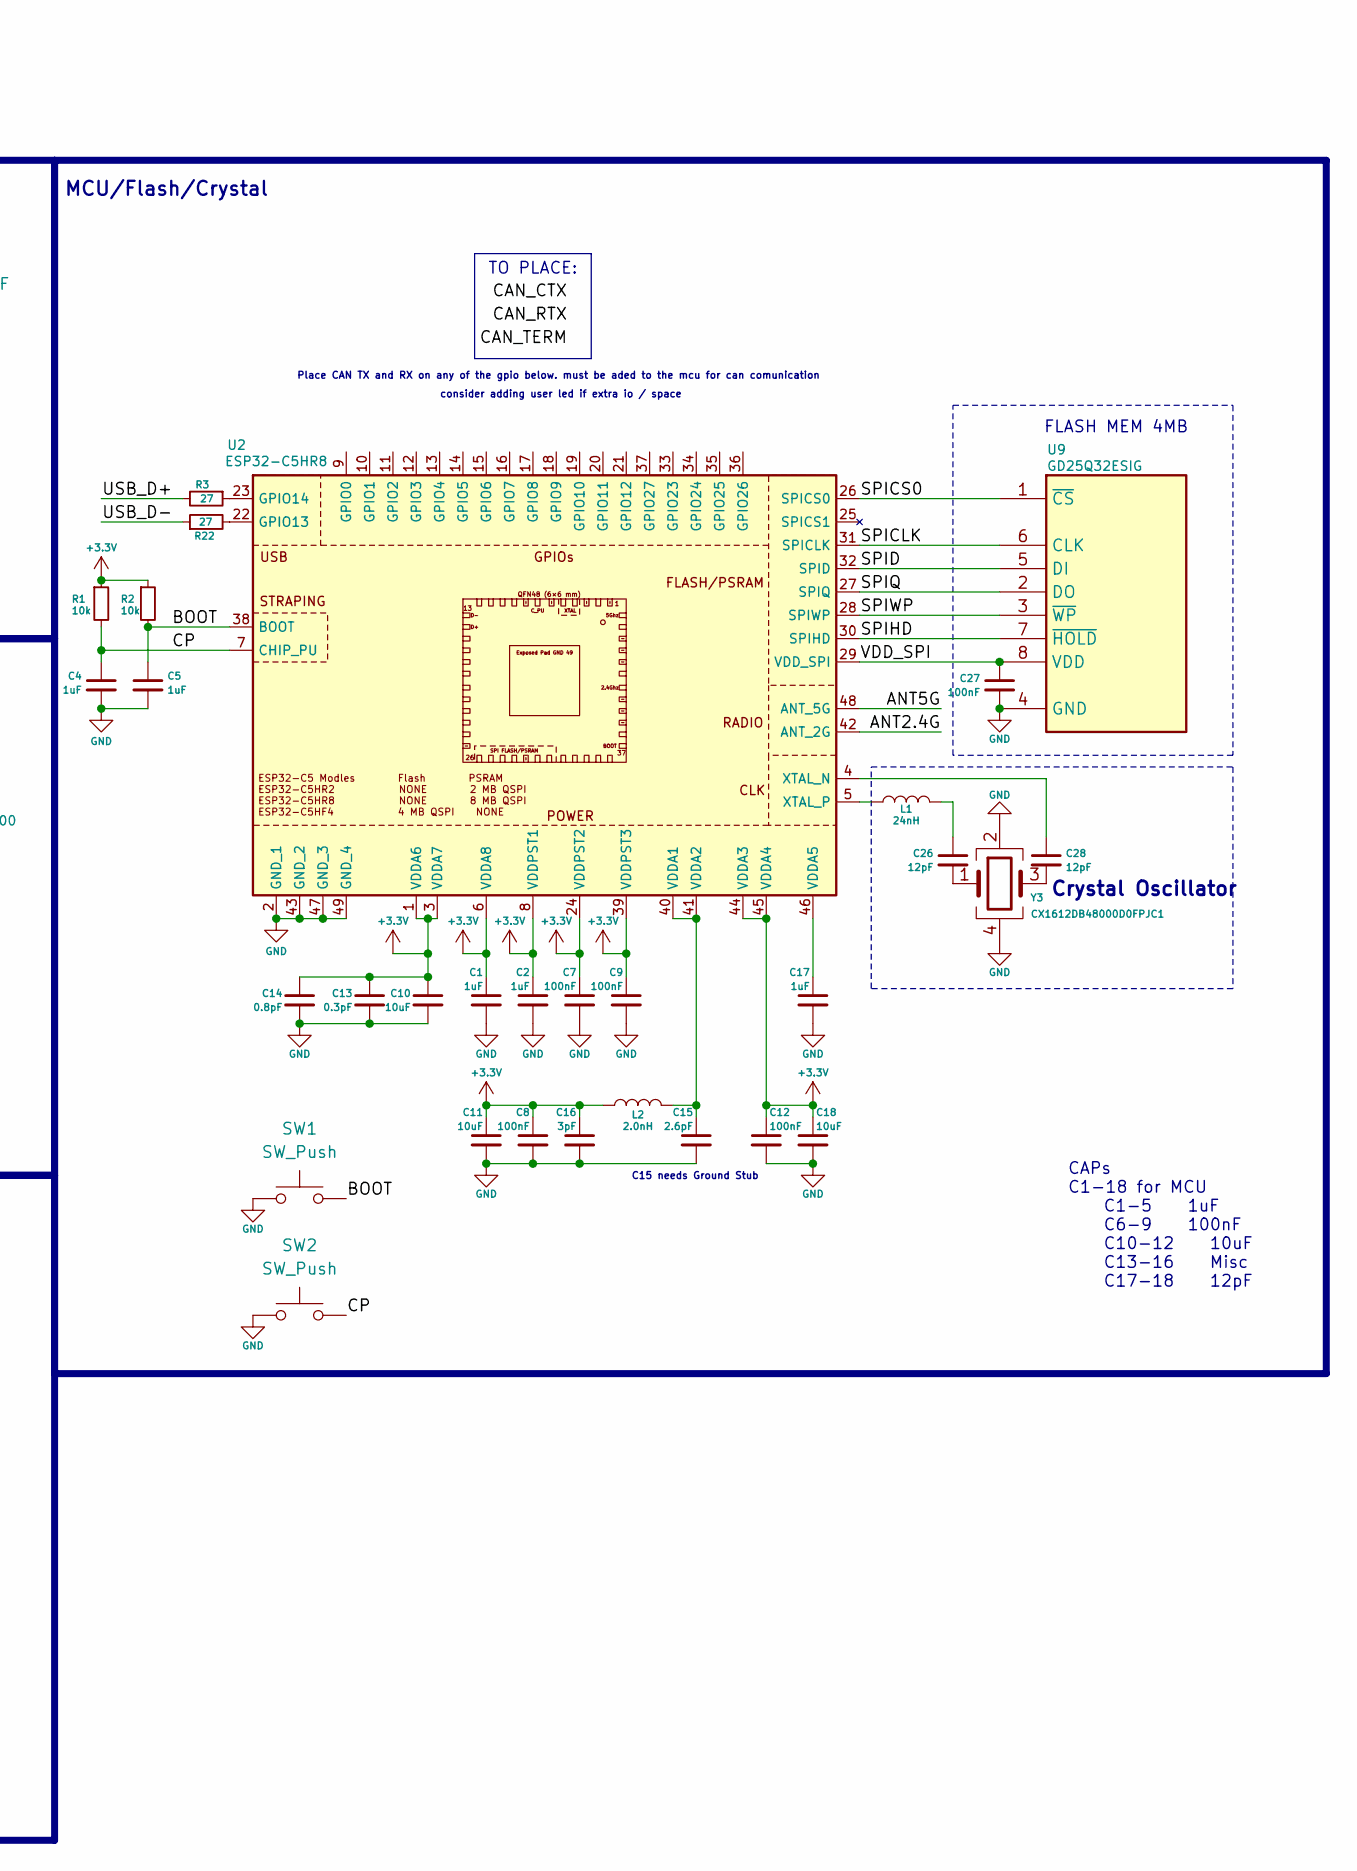
[picture p281: schematic SDM27_Telemetry_V1.kicad_sch, part in row 2, column 2]

Parts:
C1, C2, C4, C5, C17: 1uF; C_0603_1608Metric
C7, C8, C9, C12, C19, C24, C25, C27: 100nF; C_0603_1608Metric
C10, C11, C18: 10uF; C_0603_1608Metric
C13: 0.3pF; C_0603_1608Metric
C14: 0.8pF; C_0603_1608Metric
C15: 2.6pF; C_0603_1608Metric
C16: 3pF; C_0603_1608Metric
C20: 1uF 10V 0603; C_0603_1608Metric
C21: 10uF 25V; C_0603_1608Metric
C22: 10nF; C_0603_1608Metric
C23: 22uF; C_0603_1608Metric
C26, C28: 12pF; C_0201_0603Metric
D2: ESDCAN03-2BWY; SOT65P210X110-3N; Mouser Part Number 511-ESDCAN03-2BWY
J1: WEIPU SA12 7PIN; PinHeader_1x07_P2.54mm_Vertical
J2: USB_C_Receptacle_USB2.0_16P; USB_C_Receptacle_G-Switch_GT-USB-7010ASV
L1: 24nH; L_0402_1005Metric
L2: 2.0nH; L_0402_1005Metric
L3: F1C1-201612-2R2M; F1C12016122R2M; Mouser Part Number 530-F1C1-201612-2R2M
LED2: 150060RS75000; LEDC1608X80N; Mouser Part Number 710-150060RS75000
R1, R2: 10k; R_0402_1005Metric
R3, R22: 27; R_0402_1005Metric
R7, R8, R9, R10: 5k; R_0603_1608Metric
R11: 63.4k; R_0603_1608Metric
R12: 23.7k; R_0603_1608Metric
R13: 18.2k; R_0603_1608Metric
R14: 10.2k; R_0603_1608Metric
R15, R16: 5.1k; R_0603_1608Metric
R17: 100k; R_0603_1608Metric
R18: 113k; R_0603_1608Metric
R19: 100; R_0603_1608Metric
R20: 24.9k; R_0603_1608Metric
R21: 330; R_0603_1608Metric
SW1, SW2: SW_Push; SW_SPST_CK_KXT3
U2: ESP32-C5HR8; QFN40P600X600X90-49N-D; Manufacturer_Part_Number ESP32-C5HR8
U4: TPS2121RUXR; Mouser Part Number 595-TPS2121RUXR
U5: TPS62901RPJR; Mouser Part Number 595-TPS62901RPJR
U6: TLP175A_TPL,E; TLP266J; Mouser Part Number 757-TLP175A(TPLE
U7: USBLC6-2SC6; SOT-23-6
U8: TCAN3403DRBRQ1; SON65P300X300X100-9N-D; Manufacturer_Part_Number TCAN3403DRBRQ1; Mouser Part Number 595-TCAN3403DRBRQ1
U9: GD25Q32ESIG; SOP-8-1EP_4.57x4.57mm_P1.27mm_EP4.57x4.45mm; Mouser Part Number 363-GD25Q32ESIG
Y3: CX1612DB48000D0FPJC1; Mouser Part Number 581-CX1612DB48D0FPJ

Connections:
+3.3V: C1.1, C2.1, C7.1, C8.1, C9.1, C10.1, C11.1, C12.1, C13.1, C14.1, C16.1, C18.1, C23.1, C24.1, C25.1, L2.2, L3.2, R1.1, R2.1, R18.1, R21.1, U2.1 (VDDA6), U2.3 (VDDA7), U2.6 (VDDA8), U2.8 (VDDPST1), U2.24 (VDDPST2), U2.39 (VDDPST3), U2.44 (VDDA3), U2.45 (VDDA4), U5.3 (VOS), U8.3 (VCC)
+12V: J1.6, R11.2, R13.2, U4.7 (IN1)
ANT2.4G: U2.42 (ANT_2G)
ANT5G: U2.48 (ANT_5G)
BOOT: C5.1, R2.2, SW1.2, U2.38 (BOOT)
CAN+: D2.2, J1.2, J1.4, R19.2, U8.7 (CANH)
CAN-: D2.1, J1.1, J1.3, U6.4, U8.6 (CANL)
CAN_CTX: U8.4 (RXD)
CAN_RTX: U8.1 (TXD)
CAN_TERM: U6.1
CP: C4.1, R1.2, SW2.2, U2.7 (CHIP_PU)
GND: C1.2, C2.2, C4.2, C5.2, C7.2, C8.2, C9.2, C10.2, C11.2, C12.2, C13.2, C14.2, C15.2, C16.2, C17.2, C18.2, C19.1, C20.2, C21.2, C22.2, C23.2, C24.2, C25.2, C27.2, D2.3, J1.5, J1.7, J2.A1 (GND), J2.A12 (GND), J2.B1 (GND), J2.B12 (GND), LED2.1 (K), R7.1, R8.1, R9.1, R10.1, R15.2, R16.2, R17.1, R20.2, SW1.1, SW2.1, U2.2 (GND_1), U2.43 (GND_2), U2.47 (GND_3), U2.49 (GND_4), U4.9 (ST), U4.12 (GND), U5.4 (GND), U5.7 (CONFIG), U6.3, U7.2 (GND), U8.2 (GND), U8.5 (VIO), U8.8 (STB), U8.9 (EP), U9.4 (GND), Y3.2, Y3.4
unnamed: C15.1, L2.1, U2.40 (VDDA1), U2.41 (VDDA2)
unnamed: C17.1, U2.46 (VDDA5)
unnamed: C20.1, U4.11 (SS)
unnamed: C22.1, U5.8 (SS/TR)
unnamed: C26.1, L1.2
unnamed: C26.2, Y3.1
unnamed: C28.1, U2.4 (XTAL_N)
unnamed: C28.2, Y3.3
unnamed: J2.A5 (CC1), R15.1
unnamed: J2.B5 (CC2), R16.1
unnamed: L1.1, U2.5 (XTAL_P)
unnamed: L3.1, U5.2 (SW)
unnamed: R3.1, U2.23 (GPIO14)
unnamed: R10.2, R12.1, U4.4 (OV2)
unnamed: R8.2, R11.1, U4.5 (OV1)
unnamed: R7.2, R13.1, U4.6 (PR1)
unnamed: R9.2, R14.1, U4.3 (CP2)
unnamed: R17.2, U4.10 (ILIM)
unnamed: R18.2, R20.1, U5.9 (VSET)
unnamed: R19.1, U6.6
unnamed: R22.2, U2.22 (GPIO13)
PWR_LED: LED2.2 (A), R21.2
SPICLK: U2.31 (SPICLK), U9.6 (CLK)
SPICS0: U2.26 (SPICS0), U9.1 (~CS)
SPID: U2.32 (SPID), U9.5 (DI)
SPIHD: U2.30 (SPIHD), U9.7 (~HOLD)
SPIQ: U2.27 (SPIQ), U9.2 (DO)
SPIWP: U2.28 (SPIWP), U9.3 (~WP)
USBM_D+: J2.A6 (D+), J2.B6 (D+), U7.6 (I/O1)
USBM_D-: J2.A7 (D-), J2.B7 (D-), U7.4 (I/O2)
USB_D+: R3.2, U7.1 (I/O1)
USB_D-: R22.1, U7.3 (I/O2)
VBUS: C19.2, J2.A4 (VBUS), J2.A9 (VBUS), J2.B4 (VBUS), J2.B9 (VBUS), R12.2, R14.2, U4.2 (IN2), U7.5 (VBUS)
VCC: C21.1, U4.1 (OUT_1), U4.8 (OUT_2), U5.5 (EN), U5.6 (VIN)
VDD_SPI: C27.1, U2.29 (VDD_SPI), U9.8 (VDD)

Notes on the sheet:
12V Priority
TO PLACE:
Connector to car
FLASH MEM 4MB
3V3 REG
PRIMARY MUX
C15 needs Ground Stub
Crystal Oscillator
MCU/Flash/Crystal
consider adding user led if extra io / space
SS Slew rate 12V 88 V/s 5V 92 V/s
IN1 overvoltage cutoff 14.50 V
IN2 overvoltage cutoff 6.08 V
USB_C Power/PROG
CAPs C1-18 for MCU C1-5 1uF C6-9 100nF C10-12 10uF C13-16 Misc C17-18 12pF
check this**
Place CAN TX and RX on any of the gpio below. must be aded to the mcu for can comunication
CAN Transciever / Term
Current limit 1.24A
