sundevilmotorsports/pcb-dev/2027/SDM27_Timing _Gates/SDM27TimingGatesV1/SDM27TimingGatesV1.kicad_sch

## KiCad design 2027/SDM27_Timing _Gates/SDM27TimingGatesV1/SDM27TimingGatesV1.kicad_sch (2026-11-06)

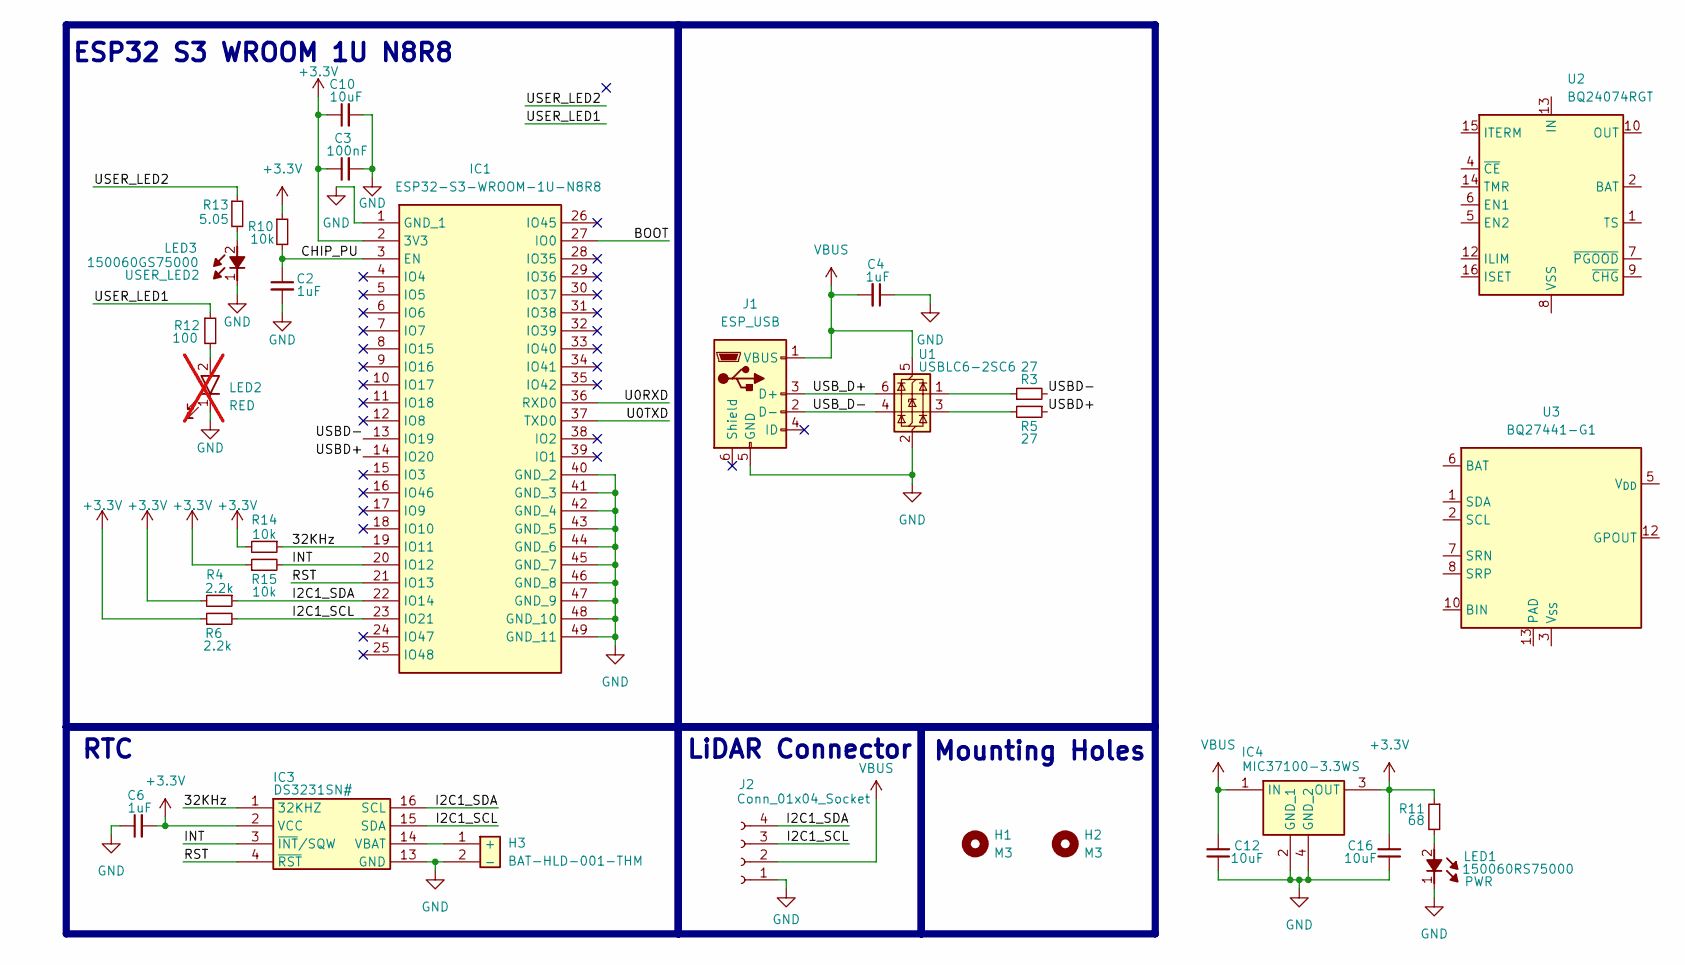
[picture p282: schematic SDM27TimingGatesV1.kicad_sch]

Parts:
C2, C4, C6: 1uF; C_0603_1608Metric
C3: 100nF; C_0603_1608Metric
C10, C12, C16: 10uF; C_0603_1608Metric
H1, H2: M3; MountingHole_3.2mm_M3
H3: BAT-HLD-001-THM; BATHLD001THM; Mouser Part Number N/A
IC1: ESP32-S3-WROOM-1U-N8R8; ESP32S3WROOM1UN8R8; Mouser Part Number 356-ESP32S3WRM1UN8R8
IC3: DS3231SN#; SOIC127P1032X265-16L; Mouser Part Number 700-DS3231SN#
IC4: MIC37100-3.3WS; SOT230P700X180-4N; Mouser Part Number 998-MIC37100-3.3WS
J1: ESP_USB; USB_Micro-B_Molex-105017-0001
J2: Conn_01x04_Socket; JST_XH_B4B-XH-A_1x04_P2.50mm_Vertical
LED1: 150060RS75000; LEDC1608X80N; Mouser Part Number 710-150060RS75000
LED2: RED; SSFLXH100LID01; Mouser Part Number 696-SSFLXH100LID01; not fitted
LED3: 150060GS75000; LEDC1608X80N; Mouser Part Number 710-150060GS75000
R3, R5: 27; R_0603_1608Metric
R4, R6: 2.2k; R_0603_1608Metric
R10, R14, R15: 10k; R_0603_1608Metric
R11: 68; R_0603_1608Metric
R12: 100; R_0603_1608Metric
R13: 5.05; R_0603_1608Metric
U1: USBLC6-2SC6; SOT-23-6
U2: BQ24074RGT; VQFN-16-1EP_3x3mm_P0.5mm_EP1.6x1.6mm
U3: BQ27441-G1; Texas_S-PDSO-N12

Connections:
32KHz: IC1.19 (IO11), IC3.1 (32KHZ), R14.1
+3.3V: C3.1, C6.2, C10.1, C16.2, IC1.2 (3V3), IC3.2 (VCC), IC4.3 (OUT), R4.2, R6.1, R10.1, R11.1, R14.2, R15.1
BOOT: IC1.27 (IO0)
CHIP_PU: C2.1, IC1.3 (EN), R10.2
GND: C2.2, C3.2, C4.1, C6.1, C10.2, C12.1, C16.1, H3.2 (-), IC1.1 (GND_1), IC1.40 (GND_2), IC1.41 (GND_3), IC1.42 (GND_4), IC1.43 (GND_5), IC1.44 (GND_6), IC1.45 (GND_7), IC1.46 (GND_8), IC1.47 (GND_9), IC1.48 (GND_10), IC1.49 (GND_11), IC3.13 (GND), IC4.2 (GND_1), IC4.4 (GND_2), J1.5 (GND), J2.1, LED1.1 (K), LED2.1 (K), LED3.1 (K), U1.2 (GND)
I2C1_SCL: IC1.23 (IO21), IC3.15 (SDA), J2.3, R6.2
I2C1_SDA: IC1.22 (IO14), IC3.16 (SCL), J2.4, R4.1
INT: IC1.20 (IO12), IC3.3 (~INT/SQW), R15.2
unnamed: H3.1 (+), IC3.14 (VBAT)
unnamed: LED1.2 (A), R11.2
unnamed: LED2.2 (A), R12.2
unnamed: LED3.2 (A), R13.2
unnamed: R3.1, U1.1 (I/O1)
unnamed: R5.2, U1.3 (I/O2)
unnamed: U2.2 (BAT), U2.3 (BAT)
unnamed: U2.10 (OUT), U2.11 (OUT)
unnamed: U2.8 (VSS), U2.17 (VSS)
RST: IC1.21 (IO13), IC3.4 (~RST)
U0RXD: IC1.36 (RXD0)
U0TXD: IC1.37 (TXD0)
USBD+: IC1.14 (IO20), R5.1
USBD-: IC1.13 (IO19), R3.2
USB_D+: J1.3 (D+), U1.6 (I/O1)
USB_D-: J1.2 (D-), U1.4 (I/O2)
USER_LED1: R12.1
USER_LED2: R13.1
VBUS: C4.2, C12.2, IC4.1 (IN), J1.1 (VBUS), J2.2, U1.5 (VBUS)

Notes on the sheet:
LiDAR Connector
Mounting Holes
ESP32 S3 WROOM 1U N8R8
RTC
