sundevilmotorsports/pcb-dev/PRE2026/ONVEHICLE/IRTRAN/IRTRAN.kicad_sch

## KiCad design PRE2026/ONVEHICLE/IRTRAN/IRTRAN.kicad_sch (2024-01-15)

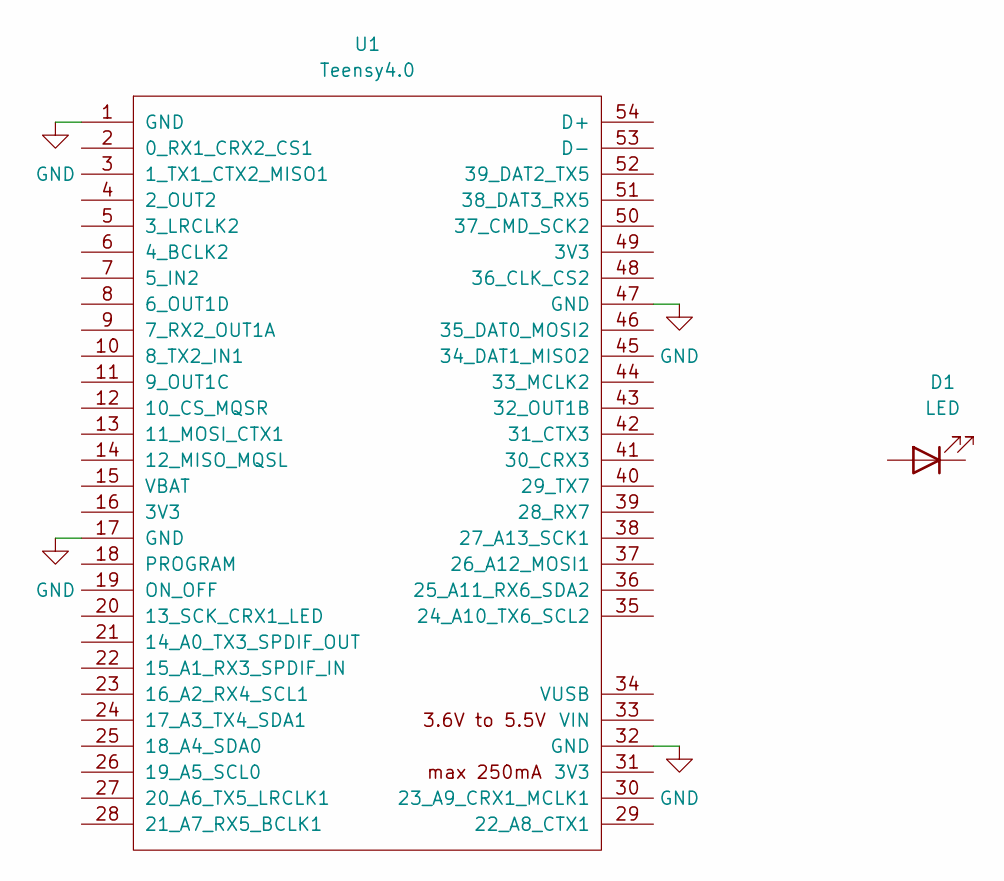
[picture p283: schematic IRTRAN.kicad_sch]

Parts:
D1: LED
U1: Teensy4.0

Connections:
GND: U1.1 (GND), U1.17 (GND), U1.32 (GND), U1.47 (GND)
