sundevilmotorsports/pcb-dev/PRE2026/SDM25Shifter/Shifter/Shifter.kicad_sch

## KiCad design PRE2026/SDM25Shifter/Shifter/Shifter.kicad_sch (2025-10-08)

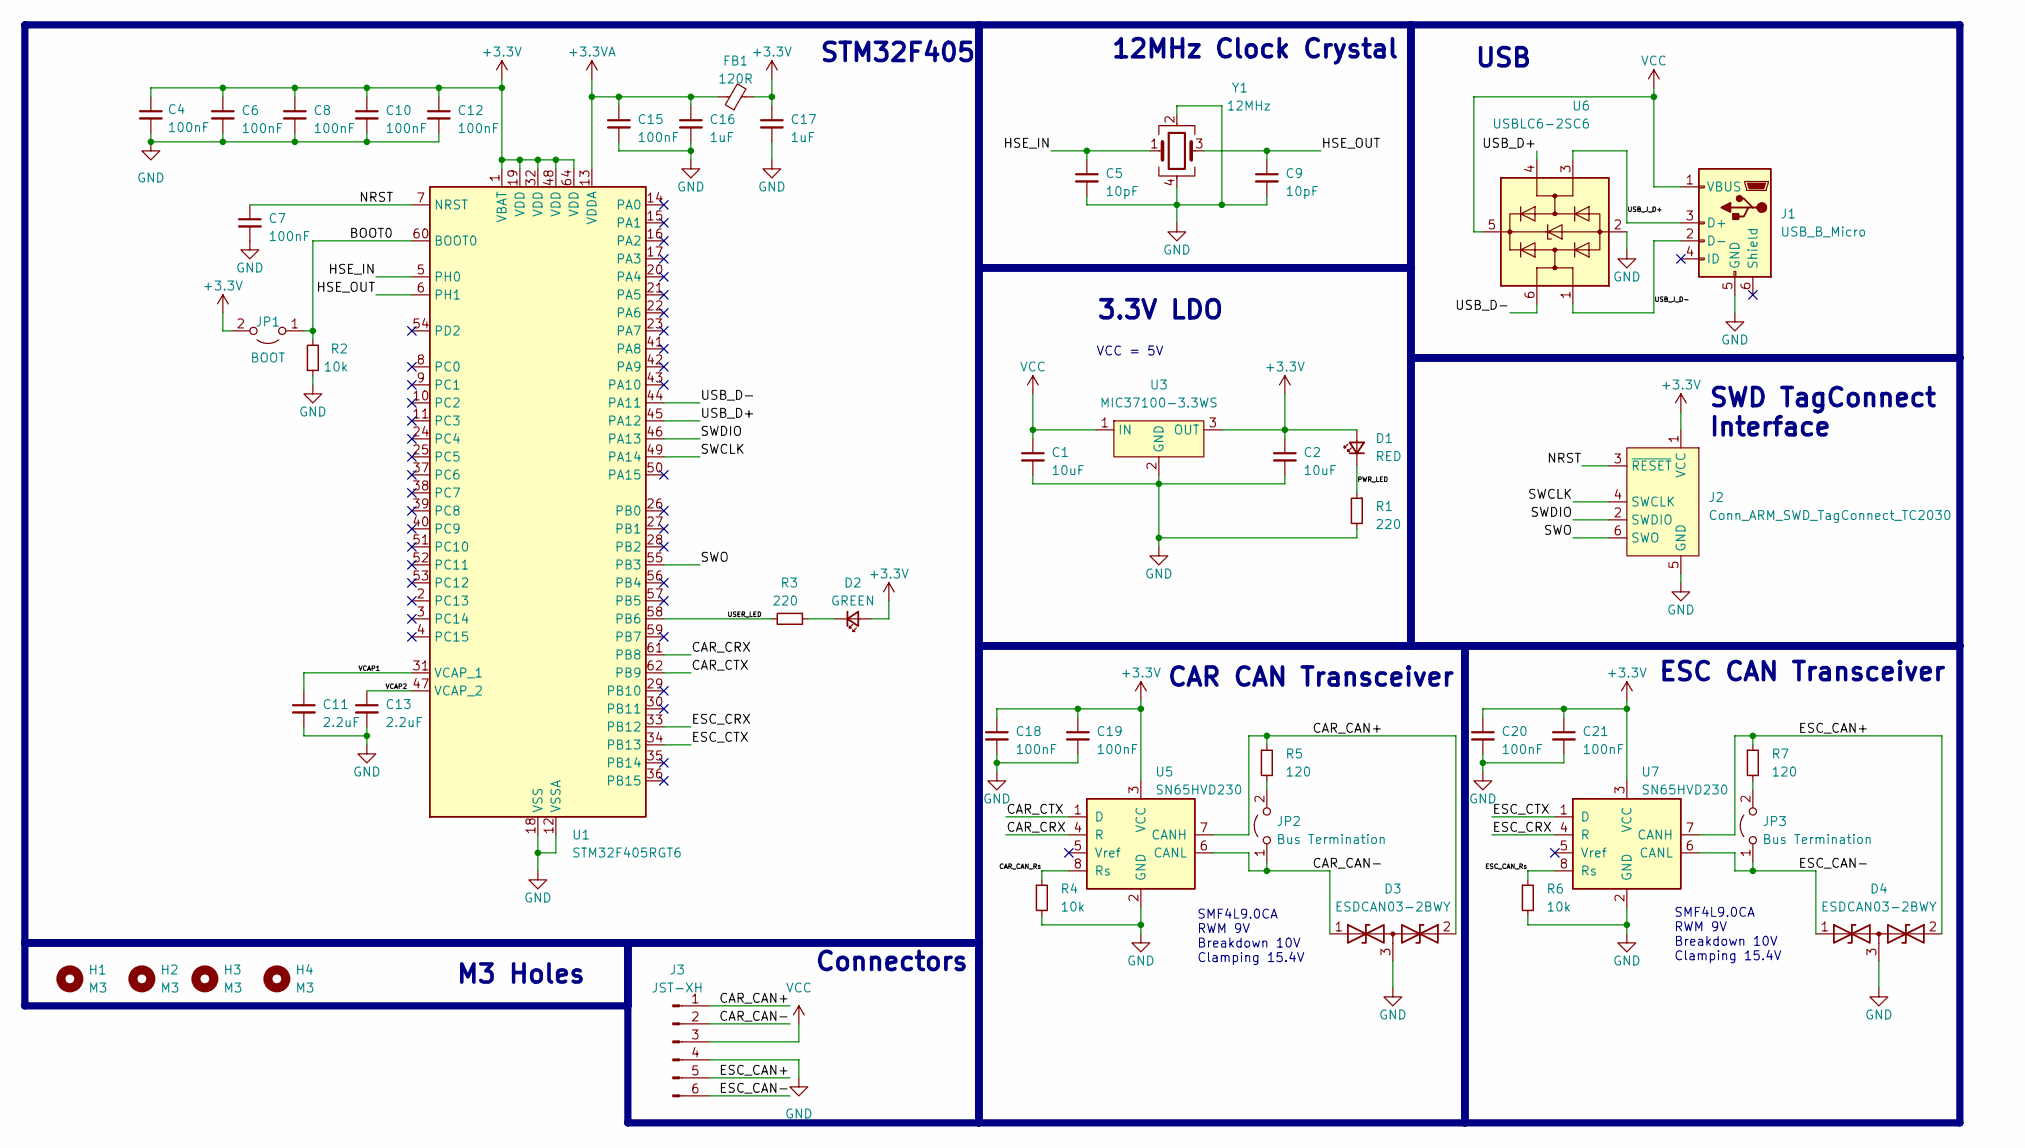
[picture p284: schematic Shifter.kicad_sch]

Parts:
C1, C2: 10uF; C_0603_1608Metric
C4, C6, C7, C8, C10, C12, C15, C18, C19, C20, C21: 100nF; C_0603_1608Metric
C5, C9: 10pF; C_0603_1608Metric
C11, C13: 2.2uF; C_0603_1608Metric
C16, C17: 1uF; C_0603_1608Metric
D1: RED; LED_0805_2012Metric
D2: GREEN; LED_0805_2012Metric
D3, D4: ESDCAN03-2BWY; SOT65P210X110-3N; Mouser Part Number 511-ESDCAN03-2BWY
FB1: 120R; L_0603_1608Metric
H1, H2, H3, H4: M3; MountingHole_3.2mm_M3
J1: USB_B_Micro; USB_Micro-B_Molex-105017-0001
J2: Conn_ARM_SWD_TagConnect_TC2030; Tag-Connect_TC2030-IDC-NL_2x03_P1.27mm_Vertical
J3: JST-XH; JST_XH_B6B-XH-A_1x06_P2.50mm_Vertical
JP1: BOOT; PinHeader_1x02_P2.54mm_Vertical
JP2, JP3: Bus Termination; PinHeader_1x02_P2.54mm_Vertical
R1, R3: 220; R_0603_1608Metric
R2, R4, R6: 10k; R_0603_1608Metric
R5, R7: 120; R_0603_1608Metric
U1: STM32F405RGT6; LQFP-64_10x10mm_P0.5mm
U3: MIC37100-3.3WS; SOT-223-3_TabPin2
U5, U7: SN65HVD230; SOIC-8_3.9x4.9mm_P1.27mm
U6: USBLC6-2SC6; SOT-23-6
Y1: 12MHz; Crystal_SMD_2520-4Pin_2.5x2.0mm

Connections:
+3.3V: C2.1, C4.1, C6.1, C8.1, C10.1, C12.1, C17.1, C18.1, C19.1, C20.1, C21.1, D1.2 (A), D2.2 (A), FB1.2, J2.1 (VCC), JP1.2 (B), U1.1 (VBAT), U1.19 (VDD), U1.32 (VDD), U1.48 (VDD), U1.64 (VDD), U3.3 (OUT), U5.3 (VCC), U7.3 (VCC)
+3.3VA: C15.1, C16.1, FB1.1, U1.13 (VDDA)
BOOT0: JP1.1 (A), R2.2, U1.60 (BOOT0)
CAR_CAN+: D3.2, J3.1, R5.1, U5.7 (CANH)
CAR_CAN-: D3.1, J3.2, JP2.1 (A), U5.6 (CANL)
CAR_CAN_Rs: R4.1, U5.8 (Rs)
CAR_CRX: U1.61 (PB8), U5.4 (R)
CAR_CTX: U1.62 (PB9), U5.1 (D)
ESC_CAN+: D4.2, J3.5, R7.1, U7.7 (CANH)
ESC_CAN-: D4.1, J3.6, JP3.1 (A), U7.6 (CANL)
ESC_CAN_Rs: R6.1, U7.8 (Rs)
ESC_CRX: U1.33 (PB12), U7.4 (R)
ESC_CTX: U1.34 (PB13), U7.1 (D)
GND: C1.2, C2.2, C4.2, C5.2, C6.2, C7.2, C8.2, C9.2, C10.2, C11.2, C12.2, C13.2, C15.2, C16.2, C17.2, C18.2, C19.2, C20.2, C21.2, D3.3, D4.3, J1.5 (GND), J2.5 (GND), J3.4, R1.2, R2.1, R4.2, R6.2, U1.12 (VSSA), U1.18 (VSS), U1.63 (VSS), U3.2 (GND), U5.2 (GND), U6.2 (GND), U7.2 (GND), Y1.2, Y1.4
HSE_IN: C5.1, U1.5 (PH0), Y1.1
HSE_OUT: C9.1, U1.6 (PH1), Y1.3
NRST: C7.1, J2.3 (~RESET), U1.7 (NRST)
unnamed: D2.1 (K), R3.1
unnamed: JP2.2 (B), R5.2
unnamed: JP3.2 (B), R7.2
PWR_LED: D1.1 (K), R1.1
SWCLK: J2.4 (SWCLK), U1.49 (PA14)
SWDIO: J2.2 (SWDIO), U1.46 (PA13)
SWO: J2.6 (SWO), U1.55 (PB3)
USB_D+: U1.45 (PA12), U6.4 (I/O2)
USB_D-: U1.44 (PA11), U6.6 (I/O1)
USB_J_D+: J1.3 (D+), U6.3 (I/O2)
USB_J_D-: J1.2 (D-), U6.1 (I/O1)
USER_LED: R3.2, U1.58 (PB6)
VCAP1: C11.1, U1.31 (VCAP_1)
VCAP2: C13.1, U1.47 (VCAP_2)
VCC: C1.1, J1.1 (VBUS), J3.3, U3.1 (IN), U6.5 (VBUS)

Notes on the sheet:
USB
3.3V LDO
M3 Holes
CAR CAN Transceiver
SMF4L9.0CA RWM 9V Breakdown 10V Clamping 15.4V
Connectors
SWD TagConnect Interface
12MHz Clock Crystal
VCC = 5V
ESC CAN Transceiver
STM32F405
