sundevilmotorsports/pcb-dev/PRE2026/SDM25steering/STEERING WHEEL IN HERE/steering wheel v4.kicad_sch

## KiCad design PRE2026/SDM25steering/STEERING WHEEL IN HERE/steering wheel v4.kicad_sch (2025-05-09)

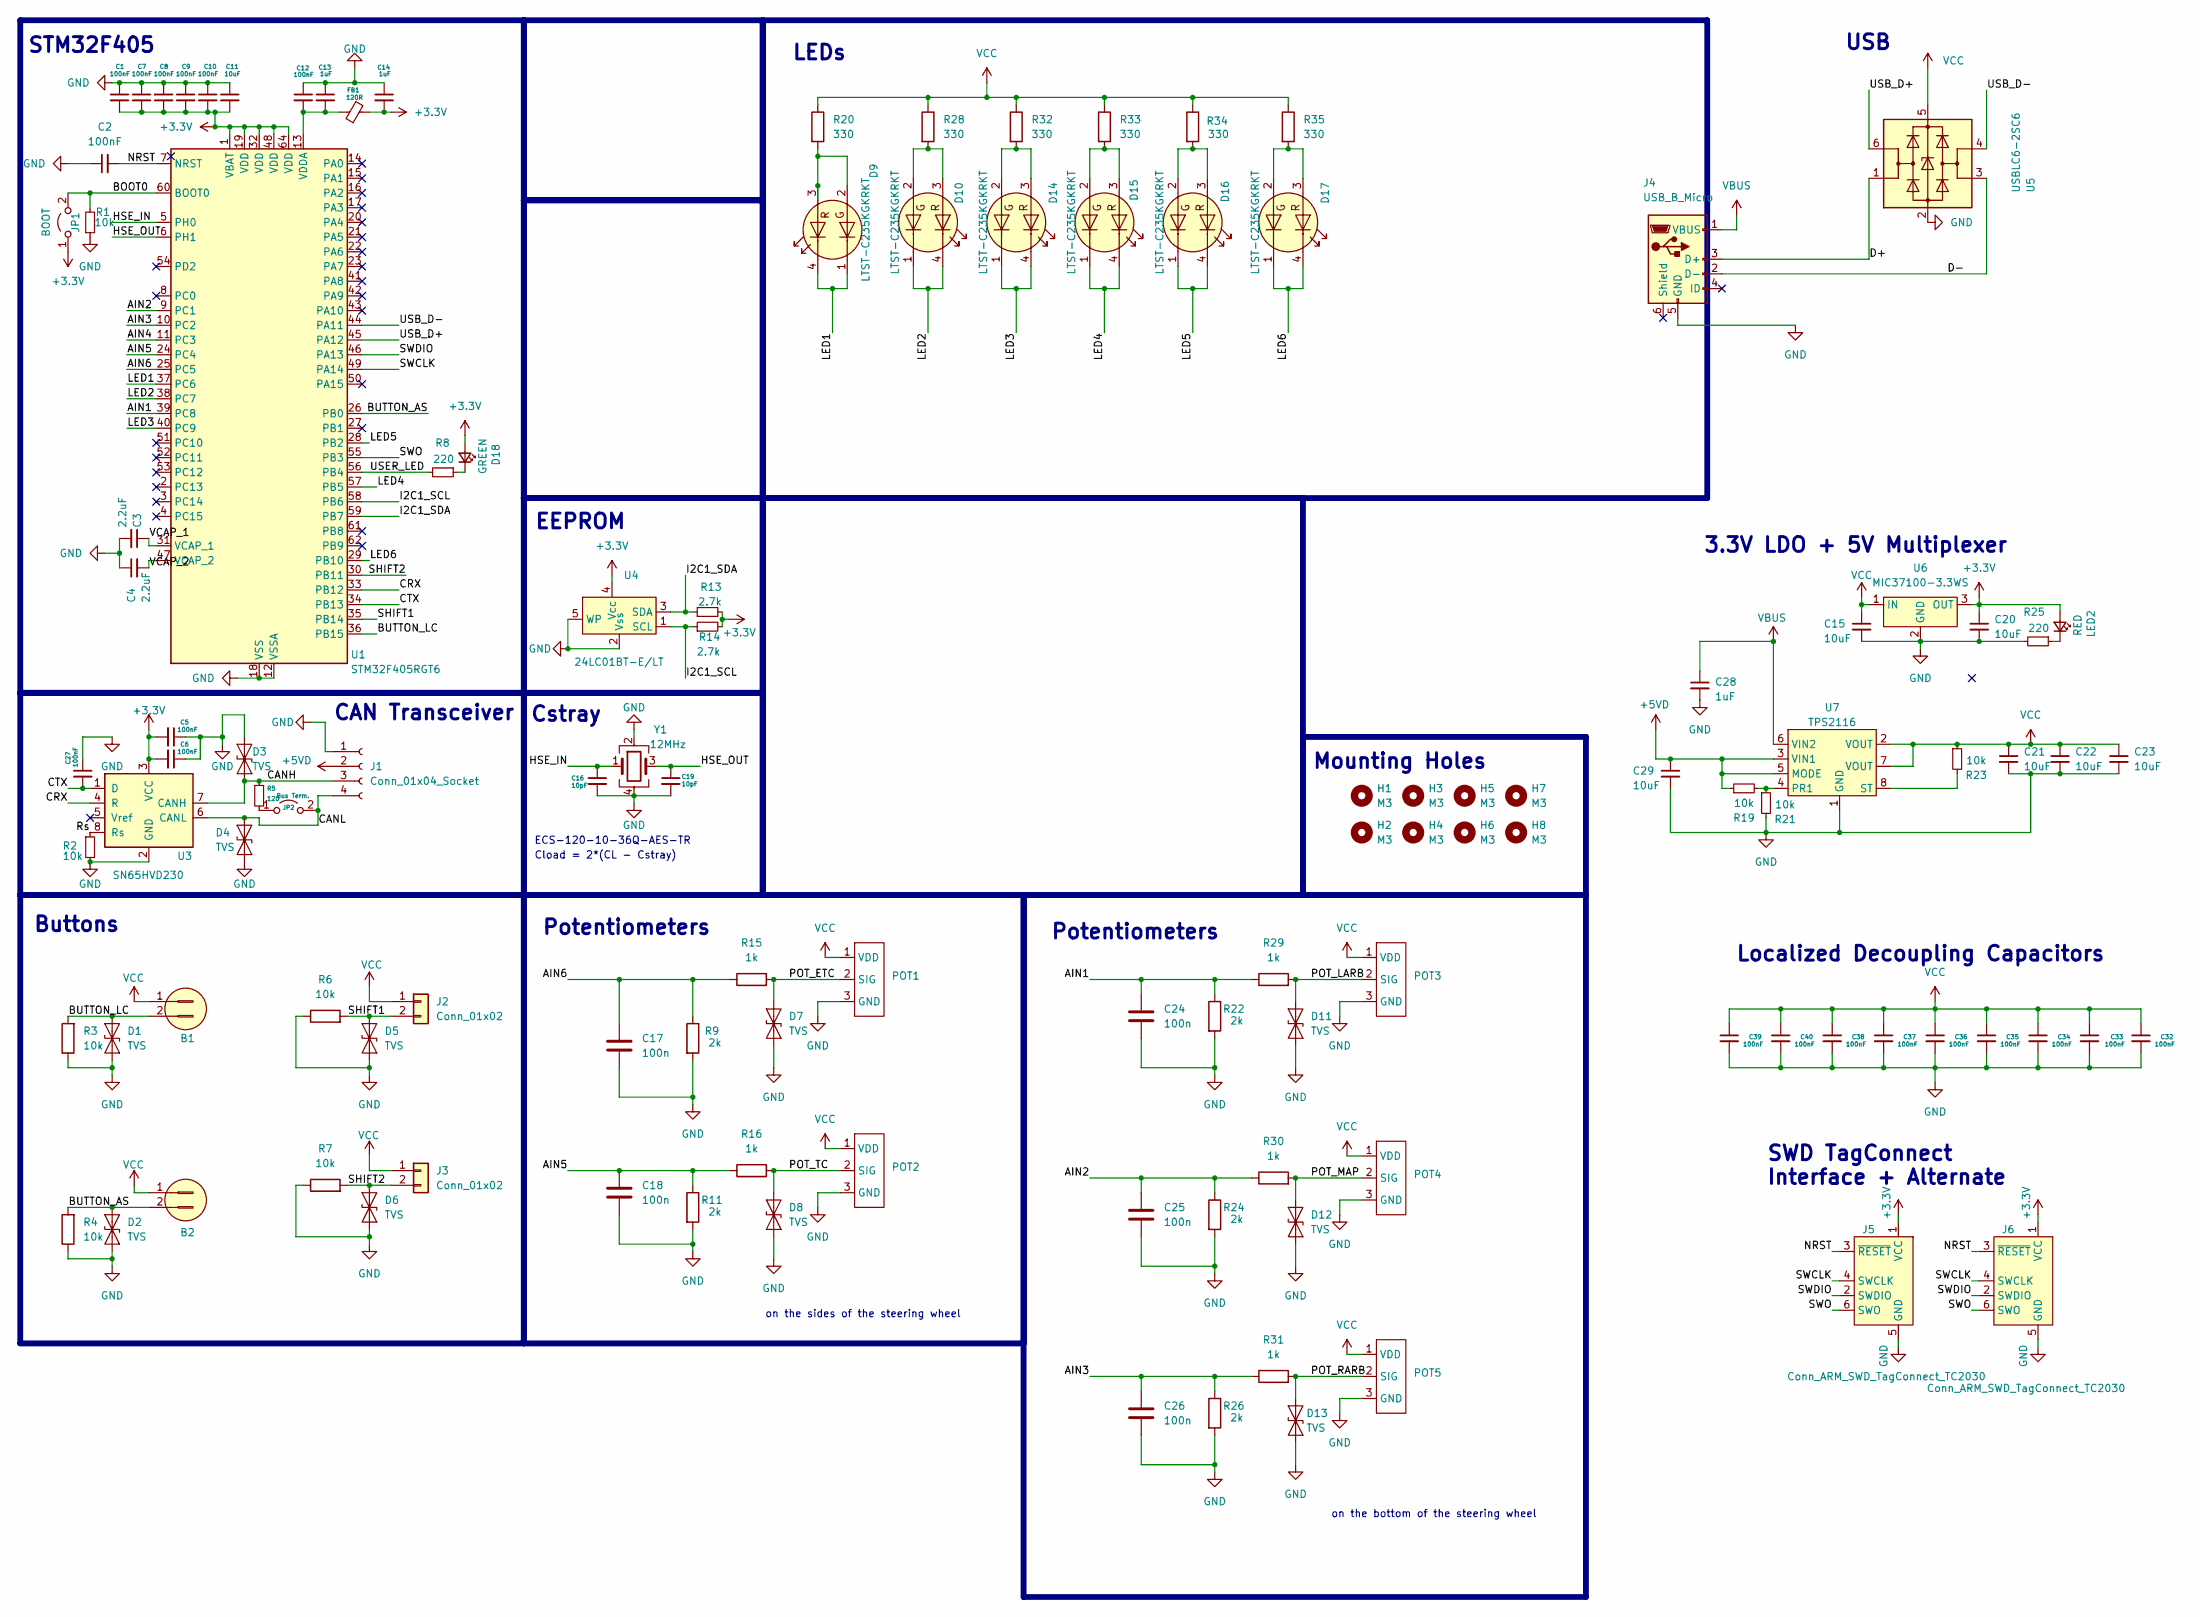
[picture p285: schematic steering wheel v4.kicad_sch]

Parts:
B1, B2: Conn_01x02; 8631CQD2
C1, C2, C5, C6, C7, C8, C9, C10, C12, C27, C32, C33, C34, C35, C36, C37, C38, C39, C40: 100nF; C_0402_1005Metric
C3, C4: 2.2uF; C_0603_1608Metric
C11, C15, C20, C21, C22, C23, C29: 10uF; C_0805_2012Metric
C13, C14, C28: 1uF; C_0603_1608Metric
C16, C19: 10pF; C_0402_1005Metric
C17, C18, C24, C25, C26: 100n; C_0402_1005Metric
D1, D2, D5, D6, D7, D8, D11, D12, D13: TVS; D_SOD-323_HandSoldering
D3, D4: TVS; SOD-123FL
D9, D10, D14, D15, D16, D17: LTST-C235KGKRKT; LED_Cree-PLCC4_5x5mm_CW
D18: GREEN; LED_0805_2012Metric
FB1: 120R; L_0603_1608Metric
H1, H2, H3, H4, H5, H6, H7, H8: M3; MountingHole_3.2mm_M3
J1: Conn_01x04_Socket; JST_EH_S4B-EH_1x04_P2.50mm_Horizontal
J2, J3: Conn_01x02; JST_EH_S2B-EH_1x02_P2.50mm_Horizontal
J4: USB_B_Micro; USB_Micro-B_Molex-105017-0001
J5, J6: Conn_ARM_SWD_TagConnect_TC2030; Tag-Connect_TC2030-IDC-NL_2x03_P1.27mm_Vertical
JP1: BOOT; PinHeader_1x02_P2.54mm_Vertical
JP2: Bus Term.; PinHeader_1x02_P2.54mm_Vertical
LED2: RED; LED_0805_2012Metric
POT1, POT2, POT3: PEC11R-4315F-S0012
POT4, POT5: P081N-271F2CBR10K
R1, R2: 10k; R_0805_2012Metric
R3, R4, R6, R7, R19, R21, R23: 10k; R_0603_1608Metric
R5: 120; R_0603_1608Metric
R8, R25: 220; R_0603_1608Metric
R9, R11, R22, R24, R26: 2k; R_0603_1608Metric
R13, R14: 2.7k; R_0603_1608Metric
R15, R16, R29, R30, R31: 1k; R_0603_1608Metric
R20, R28, R32, R33, R34, R35: 330; R_0603_1608Metric
U1: STM32F405RGT6; LQFP-64_10x10mm_P0.5mm
U3: SN65HVD230; SOIC-8_3.9x4.9mm_P1.27mm
U4: 24LC01BT-E/LT; SOT-353_SC-70-5
U5: USBLC6-2SC6; SOT-23-6
U6: MIC37100-3.3WS; SOT-223-3_TabPin2
U7: TPS2116; SOT-5X3
Y1: 12MHz; Crystal_SMD_2520-4Pin_2.5x2.0mm

Connections:
+3.3V: C1.2, C5.2, C6.2, C7.2, C8.2, C9.2, C10.2, C11.2, C14.2, C20.1, D18.2 (A), FB1.2, J5.1 (VCC), J6.1 (VCC), JP1.1 (A), LED2.2 (A), R13.2, R14.2, U1.1 (VBAT), U1.19 (VDD), U1.32 (VDD), U1.48 (VDD), U1.64 (VDD), U3.3 (VCC), U4.4 (Vcc), U6.3 (OUT)
+5VD: C29.1, J1.2, R19.1, U7.3 (VIN1), U7.5 (MODE)
AIN1: C24.1, R22.1, R29.1, U1.39 (PC8)
AIN2: C25.1, R24.1, R30.1, U1.9 (PC1)
AIN3: C26.1, R26.1, R31.1, U1.10 (PC2)
AIN4: U1.11 (PC3)
AIN5: C18.1, R11.1, R16.1, U1.24 (PC4)
AIN6: C17.1, R9.1, R15.1, U1.25 (PC5)
BOOT0: JP1.2 (B), R1.2, U1.60 (BOOT0)
BUTTON_AS: B2.2, D2.2 (A2), R4.2, U1.26 (PB0)
BUTTON_LC: B1.2, D1.2 (A2), R3.2, U1.36 (PB15)
CANH: D3.1 (A1), J1.3, R5.1, U3.7 (CANH)
CANL: D4.2 (A2), J1.4, JP2.2 (B), U3.6 (CANL)
CRX: U1.33 (PB12), U3.4 (R)
CTX: C27.2, U1.34 (PB13), U3.1 (D)
D+: J4.3 (D+), U5.1 (I/O1)
D-: J4.2 (D-), U5.3 (I/O2)
GND: C1.1, C2.1, C3.2, C4.1, C5.1, C6.1, C7.1, C8.1, C9.1, C10.1, C11.1, C12.1, C13.1, C14.1, C15.2, C16.2, C17.2, C18.2, C19.2, C20.2, C21.2, C22.2, C23.2, C24.2, C25.2, C26.2, C27.1, C28.2, C29.2, C32.2, C33.2, C34.2, C35.2, C36.2, C37.2, C38.2, C39.2, C40.2, D1.1 (A1), D2.1 (A1), D3.2 (A2), D4.1 (A1), D5.1 (A1), D6.1 (A1), D7.1 (A1), D8.1 (A1), D11.1 (A1), D12.1 (A1), D13.1 (A1), J1.1, J4.5 (GND), J5.5 (GND), J6.5 (GND), POT1.3 (GND), POT2.3 (GND), POT3.3 (GND), POT4.3 (GND), POT5.3 (GND), R1.1, R2.2, R3.1, R4.1, R6.1, R7.1, R9.2, R11.2, R21.2, R22.2, R24.2, R25.2, R26.2, U1.12 (VSSA), U1.18 (VSS), U1.63 (VSS), U3.2 (GND), U4.2 (Vss), U4.5 (WP), U5.2 (GND), U6.2 (GND), U7.1 (GND), Y1.2, Y1.4
HSE_IN: C16.1, U1.5 (PH0), Y1.1
HSE_OUT: C19.1, U1.6 (PH1), Y1.3
I2C1_SCL: R14.1, U1.58 (PB6), U4.1 (SCL)
I2C1_SDA: R13.1, U1.59 (PB7), U4.3 (SDA)
LED1: D9.1 (K2), D9.4 (K1), U1.37 (PC6)
LED2: D10.1 (K2), D10.4 (K1), U1.38 (PC7)
LED3: D14.1 (K2), D14.4 (K1), U1.40 (PC9)
LED4: D15.1 (K2), D15.4 (K1), U1.57 (PB5)
LED5: D16.1 (K2), D16.4 (K1), U1.28 (PB2)
LED6: D17.1 (K2), D17.4 (K1), U1.29 (PB10)
NRST: C2.2, J5.3 (~RESET), J6.3 (~RESET), U1.7 (NRST)
unnamed: C12.2, C13.2, FB1.1, U1.13 (VDDA)
unnamed: D9.2 (A2), D9.3 (A1), R20.2
unnamed: D10.2 (A2), D10.3 (A1), R28.2
unnamed: D14.2 (A2), D14.3 (A1), R32.2
unnamed: D15.2 (A2), D15.3 (A1), R33.2
unnamed: D16.2 (A2), D16.3 (A1), R34.2
unnamed: D17.2 (A2), D17.3 (A1), R35.2
unnamed: D18.1 (K), R8.1
unnamed: JP2.1 (A), R5.2
unnamed: LED2.1 (K), R25.1
unnamed: R19.2, R21.1, U7.4 (PR1)
unnamed: R23.2, U7.8 (ST)
POT_ETC: D7.2 (A2), POT1.2 (SIG), R15.2
POT_LARB: D11.2 (A2), POT3.2 (SIG), R29.2
POT_MAP: D12.2 (A2), POT4.2 (SIG), R30.2
POT_RARB: D13.2 (A2), POT5.2 (SIG), R31.2
POT_TC: D8.2 (A2), POT2.2 (SIG), R16.2
Rs: R2.1, U3.8 (Rs)
SHIFT1: D5.2 (A2), J2.2, R6.2, U1.35 (PB14)
SHIFT2: D6.2 (A2), J3.2, R7.2, U1.30 (PB11)
SWCLK: J5.4 (SWCLK), J6.4 (SWCLK), U1.49 (PA14)
SWDIO: J5.2 (SWDIO), J6.2 (SWDIO), U1.46 (PA13)
SWO: J5.6 (SWO), J6.6 (SWO), U1.55 (PB3)
USB_D+: U1.45 (PA12), U5.6 (I/O1)
USB_D-: U1.44 (PA11), U5.4 (I/O2)
USER_LED: R8.2, U1.56 (PB4)
VBUS: C28.1, J4.1 (VBUS), U7.6 (VIN2)
VCAP_1: C3.1, U1.31 (VCAP_1)
VCAP_2: C4.2, U1.47 (VCAP_2)
VCC: B1.1, B2.1, C15.1, C21.1, C22.1, C23.1, C32.1, C33.1, C34.1, C35.1, C36.1, C37.1, C38.1, C39.1, C40.1, J2.1, J3.1, POT1.1 (VDD), POT2.1 (VDD), POT3.1 (VDD), POT4.1 (VDD), POT5.1 (VDD), R20.1, R23.1, R28.1, R32.1, R33.1, R34.1, R35.1, U5.5 (VBUS), U6.1 (IN), U7.2 (VOUT), U7.7 (VOUT)

Notes on the sheet:
Cstray
CAN Transceiver
Localized Decoupling Capacitors
Buttons
STM32F405
on the bottom of the steering wheel
Mounting Holes
Potentiometers
SWD TagConnect Interface + Alternate
USB
LEDs
on the sides of the steering wheel
3.3V LDO + 5V Multiplexer
Cload = 2*(CL - Cstray)
EEPROM
ECS-120-10-36Q-AES-TR
