sundevilmotorsports/pcb-dev/PRE2026/TimingGates/timingGatesTeensy/timingGatesTeensy.kicad_sch

## KiCad design PRE2026/TimingGates/timingGatesTeensy/timingGatesTeensy.kicad_sch (2025-10-08)

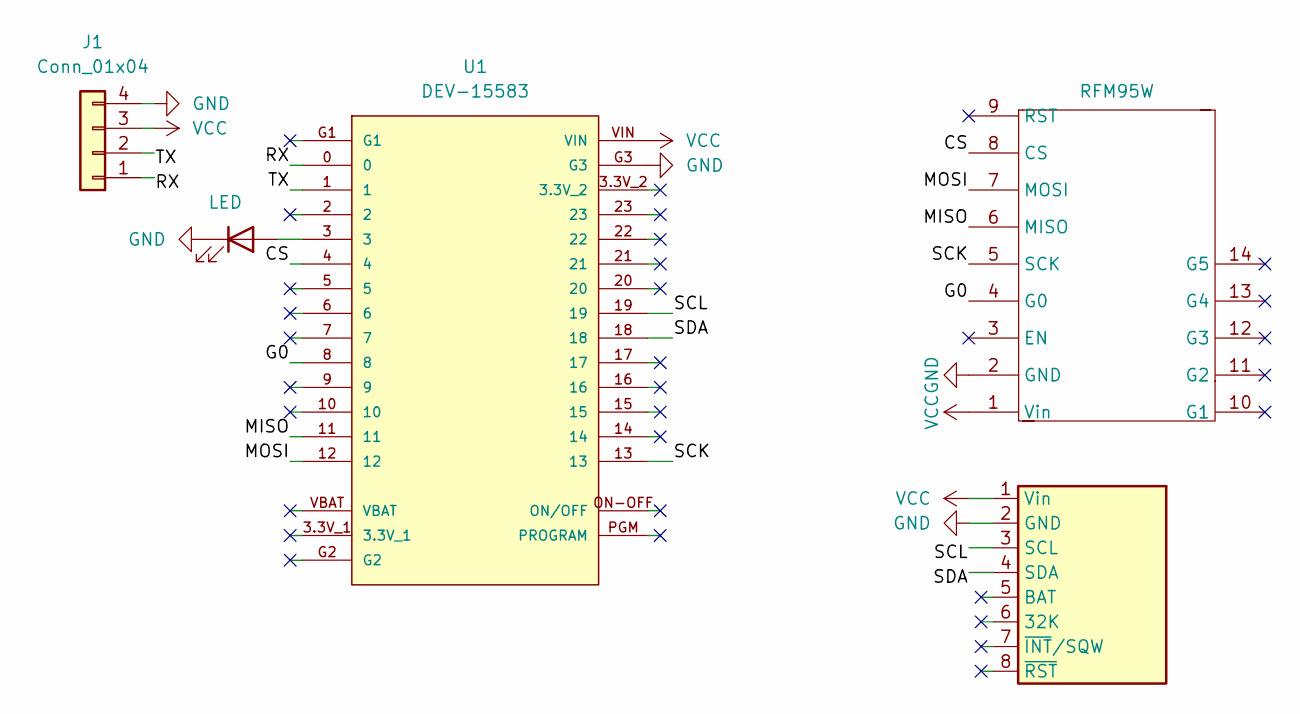
[picture p286: schematic timingGatesTeensy.kicad_sch]

Parts:
D1: LED
J1: Conn_01x04
U1: DEV-15583; Teensy4.0
U3: DS3231; SOIC-16W_7.5x10.3mm_P1.27mm
U4: RFM95W

Connections:
CS: U1.4, U4.8 (CS)
G0: U1.8, U4.4 (G0)
GND: D1.1 (K), J1.4, U1.G3, U3.2 (GND), U4.2 (GND)
MISO: U1.11, U4.6 (MISO)
MOSI: U1.12, U4.7 (MOSI)
unnamed: D1.2 (A), U1.3
RX: J1.1, U1.0
SCK: U1.13, U4.5 (SCK)
SCL: U1.19, U3.3 (SCL)
SDA: U1.18, U3.4 (SDA)
TX: J1.2, U1.1
VCC: J1.3, U1.VIN, U3.1 (Vin), U4.1 (Vin)
