sundevilmotorsports/pcb-dev/PRE2026/cansplitter/cansplitter2/cansplitter2.kicad_sch

## KiCad design PRE2026/cansplitter/cansplitter2/cansplitter2.kicad_sch (2024-10-03)

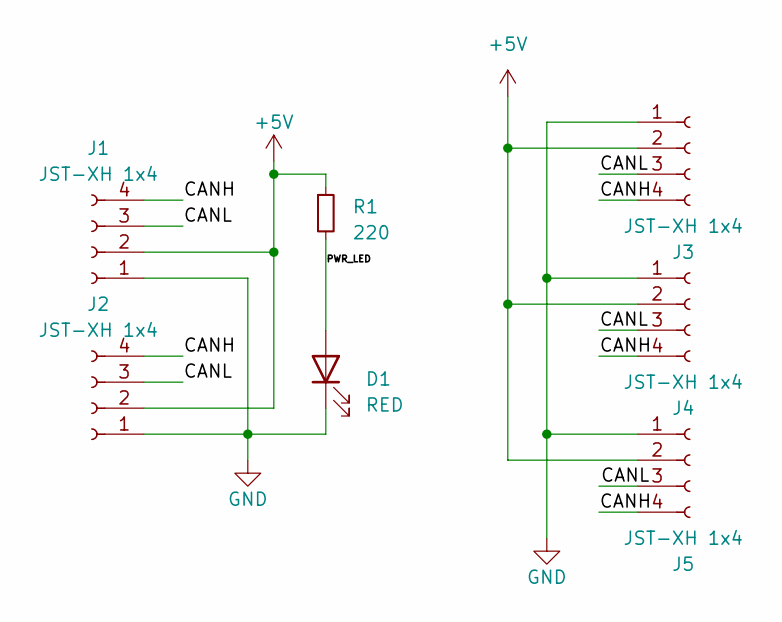
[picture p287: schematic cansplitter2.kicad_sch]

Parts:
D1: RED; LED_1206_3216Metric
J1, J2, J3, J4, J5: JST-XH 1x4; JST_XH_B4B-XH-A_1x04_P2.50mm_Vertical
R1: 220; R_1206_3216Metric

Connections:
+5V: J1.2, J2.2, J3.2, J4.2, J5.2, R1.1
CANH: J1.4, J2.4, J3.4, J4.4, J5.4
CANL: J1.3, J2.3, J3.3, J4.3, J5.3
GND: D1.1 (K), J1.1, J2.1, J3.1, J4.1, J5.1
PWR_LED: D1.2 (A), R1.2
