sundevilmotorsports/pcb-dev/PRE2026/pedalboard/SDM24PedalLoad(1)/Pedal Load .kicad_sch

## KiCad design PRE2026/pedalboard/SDM24PedalLoad(1)/Pedal Load .kicad_sch (2024-01-15)

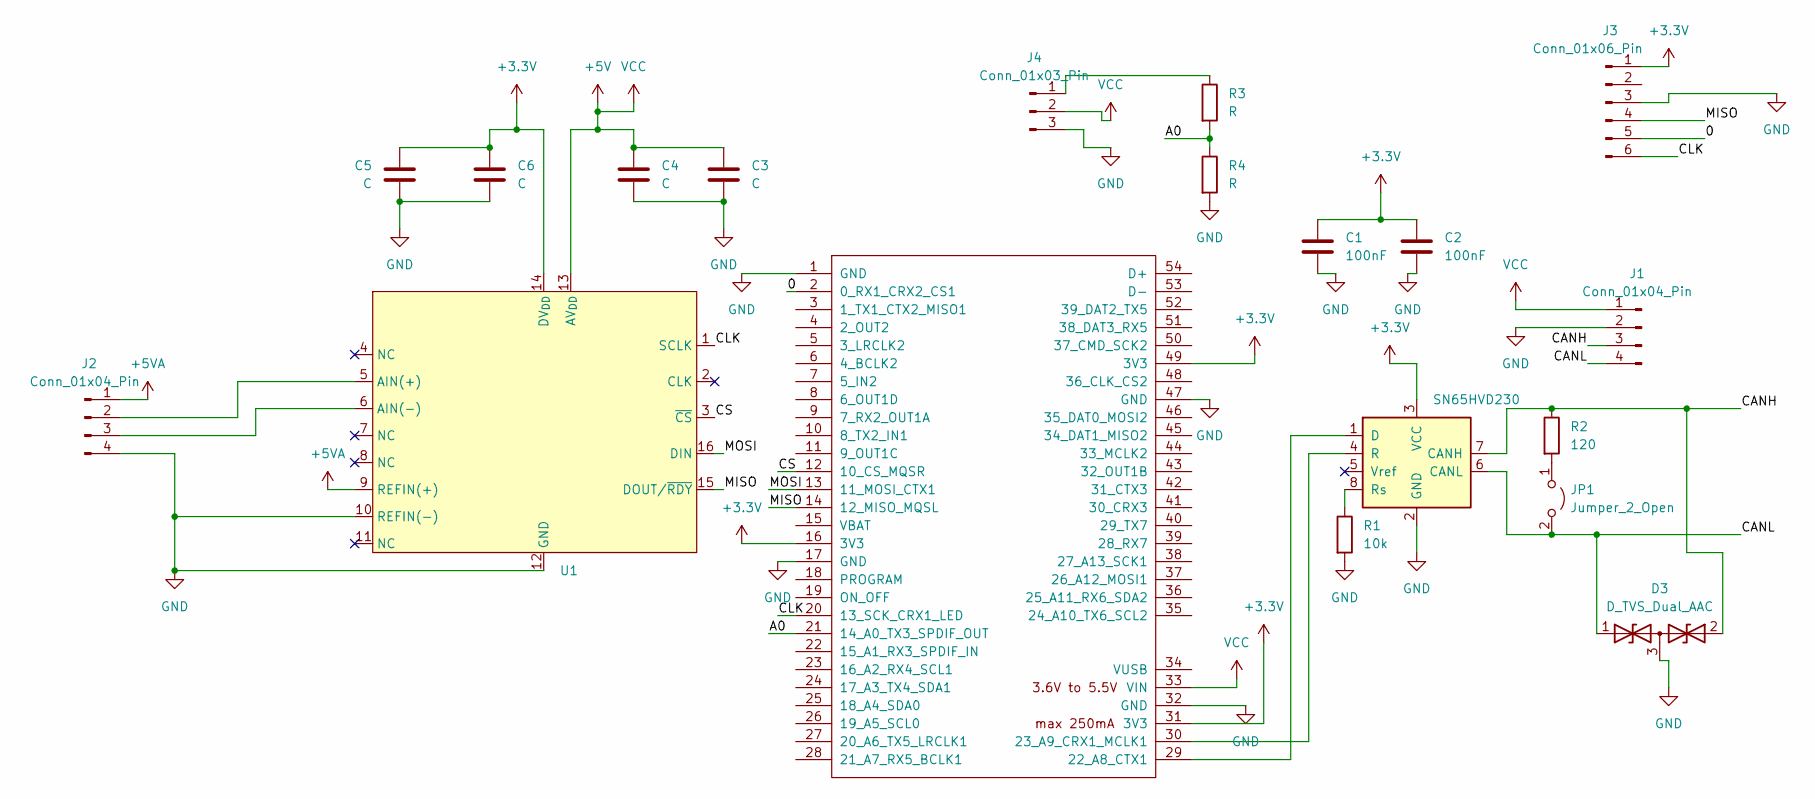
[picture p288: schematic Pedal Load .kicad_sch]

Parts:
C1, C2: 100nF; C_0603_1608Metric
C3, C4, C5, C6: C; C_0603_1608Metric
D3: D_TVS_Dual_AAC; SOT-323_SC-70
J1, J2: Conn_01x04_Pin; JST_XH_B4B-XH-A_1x04_P2.50mm_Vertical
J3: Conn_01x06_Pin; PinHeader_1x06_P2.54mm_Vertical
J4: Conn_01x03_Pin; JST_XH_B3B-XH-A_1x03_P2.50mm_Vertical
JP1: Jumper_2_Open; PinHeader_2x01_P2.54mm_Vertical
R1: 10k; R_0603_1608Metric
R2: 120; R_0603_1608Metric
R3, R4: R; R_0805_2012Metric
U1: TSSOP-16_4.4x5mm_P0.65mm
U3: SN65HVD230; SOIC-8_3.9x4.9mm_P1.27mm
U4: Teensy4.0; Teensy40

Connections:
0: J3.5, U4.2 (0_RX1_CRX2_CS1)
+3.3V: C1.1, C2.1, C5.1, C6.1, J3.1, U1.14 (DV_{DD}), U3.3 (VCC), U4.16 (3V3), U4.31 (3V3), U4.49 (3V3)
+5V: C3.1, C4.1, J1.1, J4.2, U1.13 (AV_{DD}), U4.33 (VIN)
+5VA: J2.1, U1.9 (REFIN(+))
A0: R3.2, R4.1, U4.21 (14_A0_TX3_SPDIF_OUT)
CANH: D3.2 (A2), J1.3, R2.1, U3.7 (CANH)
CANL: D3.1 (A1), J1.4, JP1.2 (B), U3.6 (CANL)
CLK: J3.6, U1.1 (SCLK), U4.20 (13_SCK_CRX1_LED)
CS: U1.3 (~CS), U4.12 (10_CS_MQSR)
GND: C1.2, C2.2, C3.2, C4.2, C5.2, C6.2, D3.3 (common), J1.2, J2.4, J3.3, J4.3, R1.2, R4.2, U1.10 (REFIN(-)), U1.12 (GND), U3.2 (GND), U4.1 (GND), U4.17 (GND), U4.32 (GND), U4.47 (GND)
MISO: J3.4, U1.15 (DOUT/~RDY), U4.14 (12_MISO_MQSL)
MOSI: U1.16 (DIN), U4.13 (11_MOSI_CTX1)
unnamed: J2.2, U1.5 (AIN(+))
unnamed: J2.3, U1.6 (AIN(-))
unnamed: J4.1, R3.1
unnamed: JP1.1 (A), R2.2
unnamed: R1.1, U3.8 (Rs)
unnamed: U3.1 (D), U4.29 (22_A8_CTX1)
unnamed: U3.4 (R), U4.30 (23_A9_CRX1_MCLK1)
