sundevilmotorsports/pcb-dev/2026/CAN_Splitter_Mini/4 Connector/SDM26_Splitter_Mini4_V1.0/SDM26_Splitter_Mini4_V1.0.kicad_sch

## KiCad design 2026/CAN_Splitter_Mini/4 Connector/SDM26_Splitter_Mini4_V1.0/SDM26_Splitter_Mini4_V1.0.kicad_sch (2026-11-06)

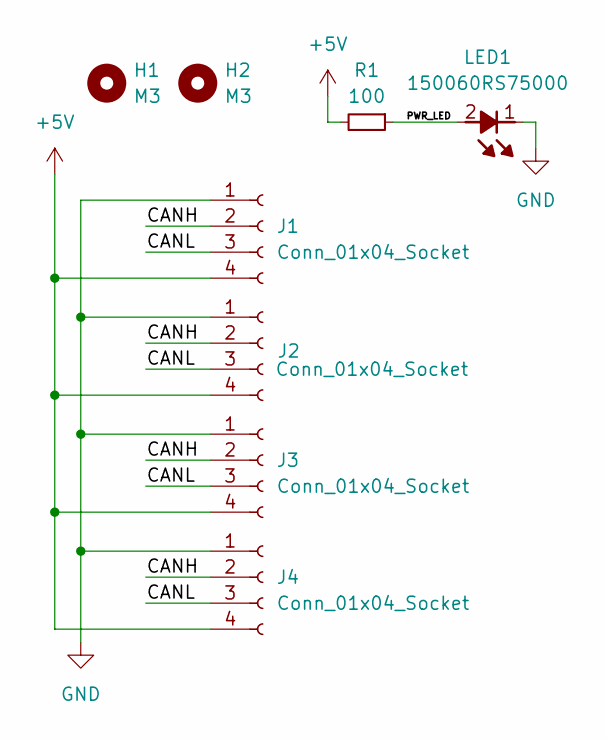
[picture p289: schematic SDM26_Splitter_Mini4_V1.0.kicad_sch]

Parts:
H1, H2: M3; MountingHole_3.2mm_M3
J1, J2, J3, J4: Conn_01x04_Socket; JST_EH_S4B-EH_1x04_P2.50mm_Horizontal_1
LED1: 150060RS75000; LEDC1608X80N; Mouser Part Number 710-150060RS75000
R1: 100; C_0603_1608Metric

Connections:
+5V: J1.4, J2.4, J3.4, J4.4, R1.2
CANH: J1.2, J2.2, J3.2, J4.2
CANL: J1.3, J2.3, J3.3, J4.3
GND: J1.1, J2.1, J3.1, J4.1, LED1.1 (K)
PWR_LED: LED1.2 (A), R1.1
