sundevilmotorsports/pcb-dev/PRE2026/TimingGates/timingGatesSTM32/timingGatesSTM32V1/timingGatesSTM32V1.kicad_sch

## KiCad design PRE2026/TimingGates/timingGatesSTM32/timingGatesSTM32V1/timingGatesSTM32V1.kicad_sch (2025-10-08)

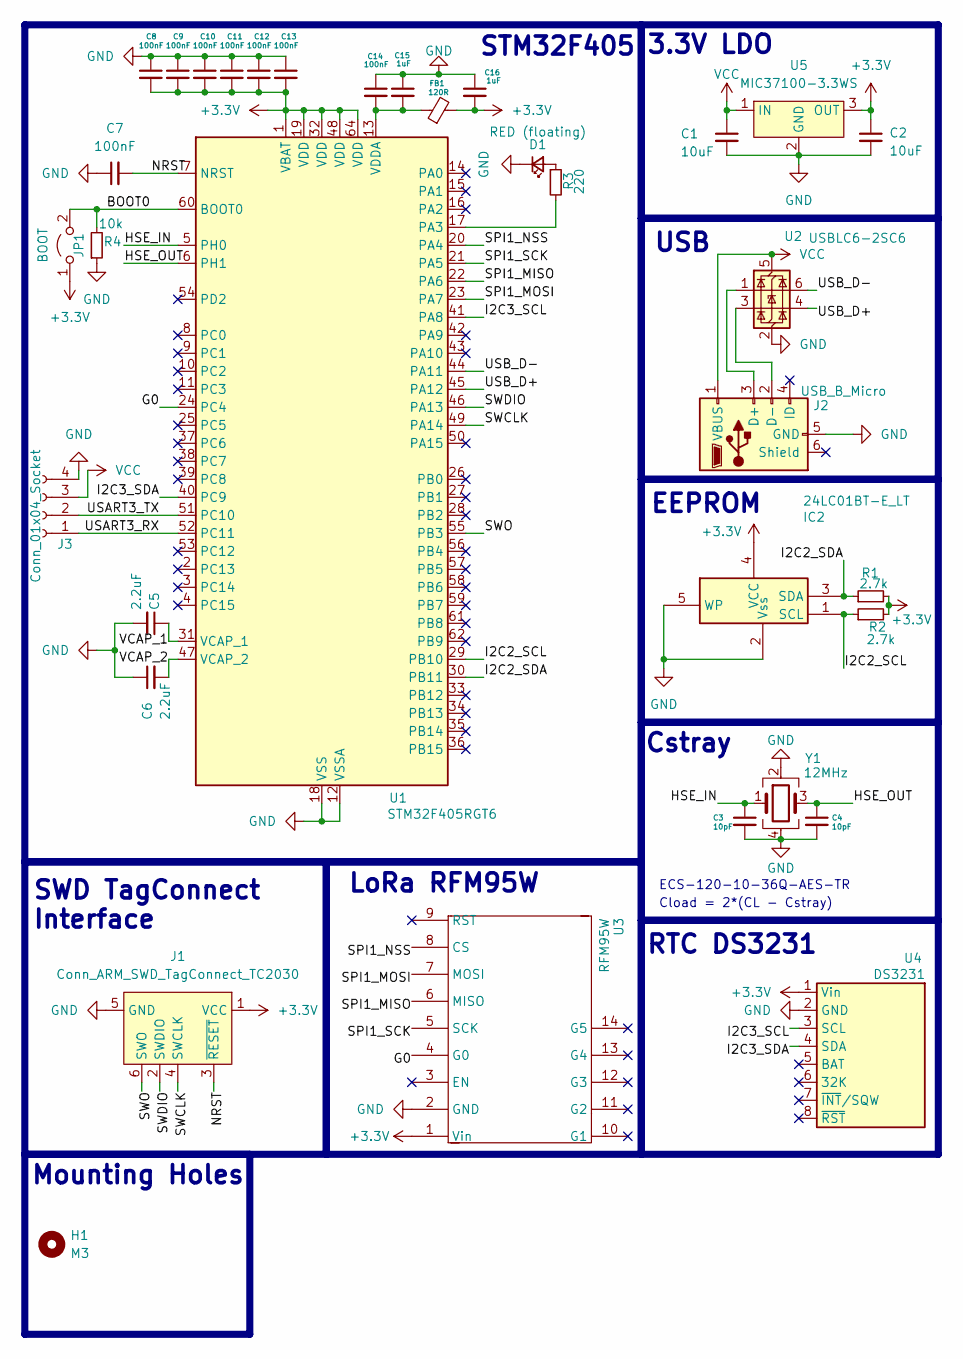
[picture p290: schematic timingGatesSTM32V1.kicad_sch]

Parts:
C1, C2: 10uF; C_0805_2012Metric
C3, C4: 10pF; C_0402_1005Metric
C5, C6: 2.2uF; C_0603_1608Metric
C7, C8, C9, C10, C11, C12, C13, C14: 100nF; C_0402_1005Metric
C15, C16: 1uF; C_0603_1608Metric
D1: RED (floating); LED_0805_2012Metric
FB1: 120R; L_0603_1608Metric
H1: M3; MountingHole_3.2mm_M3
IC2: 24LC01BT-E_LT; SOT65P210X110-5N; Mouser Part Number 579-24LC01BT-E/LT
J1: Conn_ARM_SWD_TagConnect_TC2030; Tag-Connect_TC2030-IDC-NL_2x03_P1.27mm_Vertical
J2: USB_B_Micro; USB_Micro-B_Molex-105017-0001
J3: Conn_01x04_Socket; JST_XH_B4B-XH-A_1x04_P2.50mm_Vertical
JP1: BOOT; PinHeader_1x02_P2.54mm_Vertical
R1, R2: 2.7k; R_0603_1608Metric
R3: 220; R_0805_2012Metric
R4: 10k; R_0805_2012Metric
U1: STM32F405RGT6; LQFP-64_10x10mm_P0.5mm
U2: USBLC6-2SC6; SOT-23-6
U3: RFM95W
U4: DS3231
U5: MIC37100-3.3WS; SOT-223-3_TabPin2
Y1: 12MHz; Crystal_SMD_2520-4Pin_2.5x2.0mm

Connections:
+3.3V: C2.1, C8.2, C9.2, C10.2, C11.2, C12.2, C13.2, C16.2, FB1.2, IC2.4 (VCC), J1.1 (VCC), JP1.1 (A), R1.2, R2.2, U1.1 (VBAT), U1.19 (VDD), U1.32 (VDD), U1.48 (VDD), U1.64 (VDD), U3.1 (Vin), U4.1 (Vin), U5.3 (OUT)
BOOT0: JP1.2 (B), R4.2, U1.60 (BOOT0)
G0: U1.24 (PC4), U3.4 (G0)
GND: C1.2, C2.2, C3.2, C4.2, C5.2, C6.1, C7.1, C8.1, C9.1, C10.1, C11.1, C12.1, C13.1, C14.1, C15.1, C16.1, D1.1 (K), IC2.2 (Vss), IC2.5 (WP), J1.5 (GND), J2.5 (GND), J3.4, R4.1, U1.12 (VSSA), U1.18 (VSS), U1.63 (VSS), U2.2 (GND), U3.2 (GND), U4.2 (GND), U5.2 (GND), Y1.2, Y1.4
HSE_IN: C3.1, U1.5 (PH0), Y1.1
HSE_OUT: C4.1, U1.6 (PH1), Y1.3
I2C2_SCL: IC2.1 (SCL), R2.1, U1.29 (PB10)
I2C2_SDA: IC2.3 (SDA), R1.1, U1.30 (PB11)
I2C3_SCL: U1.41 (PA8), U4.3 (SCL)
I2C3_SDA: U1.40 (PC9), U4.4 (SDA)
NRST: C7.2, J1.3 (~RESET), U1.7 (NRST)
unnamed: C14.2, C15.2, FB1.1, U1.13 (VDDA)
unnamed: D1.2 (A), R3.1
unnamed: J2.2 (D-), U2.3 (I/O2)
unnamed: J2.3 (D+), U2.1 (I/O1)
unnamed: R3.2, U1.17 (PA3)
SPI1_MISO: U1.22 (PA6), U3.6 (MISO)
SPI1_MOSI: U1.23 (PA7), U3.7 (MOSI)
SPI1_NSS: U1.20 (PA4), U3.8 (CS)
SPI1_SCK: U1.21 (PA5), U3.5 (SCK)
SWCLK: J1.4 (SWCLK), U1.49 (PA14)
SWDIO: J1.2 (SWDIO), U1.46 (PA13)
SWO: J1.6 (SWO), U1.55 (PB3)
USART3_RX: J3.1, U1.52 (PC11)
USART3_TX: J3.2, U1.51 (PC10)
USB_D+: U1.45 (PA12), U2.4 (I/O2)
USB_D-: U1.44 (PA11), U2.6 (I/O1)
VCAP_1: C5.1, U1.31 (VCAP_1)
VCAP_2: C6.2, U1.47 (VCAP_2)
VCC: C1.1, J2.1 (VBUS), J3.3, U2.5 (VBUS), U5.1 (IN)

Notes on the sheet:
STM32F405
Cload = 2*(CL - Cstray)
EEPROM
Mounting Holes
3.3V LDO
ECS-120-10-36Q-AES-TR
SWD TagConnect Interface
LoRa RFM95W
USB
Cstray
RTC DS3231
