sundevilmotorsports/pcb-dev/(commit log)

2022-03-22 added teensy libs
2022-03-27 rewriting main schematic
    [sdm22main.kicad_sch]
2022-03-28 finished first draft of main board
    [sdm22main.kicad_sch]
2022-03-28 first draft main board
    [sdm22main.kicad_pcb, sdm22main.kicad_sch]
2022-03-28 rev 1.1 for main board, a lot simpler
    [sdm22main.kicad_pcb, sdm22main.kicad_sch]
2022-03-28 adjusting footprint labels
    [sdm22main.kicad_pcb]
2022-04-02 added mounting holes, updated battery footprint
    [sdm22main.kicad_pcb, sdm22main.kicad_sch]
2022-04-06 worked on wheel board
    [sdm22wheel.kicad_pcb, sdm22wheel.kicad_sch]
2022-04-14 aligned mounting holes on wheel board
    [sdm22wheel.kicad_pcb, sdm22wheel.step]
2022-04-14 updated main board with i2c
    [sdm22main.kicad_pcb, sdm22main.kicad_sch]
2022-04-19 alligned mounting holes
    [sdm22main.kicad_pcb]
2022-04-23 main board passes drc
    [sdm22main.kicad_pcb]
2022-04-23 added extra analog ports to main board
    [sdm22main.kicad_pcb, sdm22main.kicad_sch]
2022-04-23 checked jlcpcb capabilities against boards
    [sdm22main.kicad_pcb, sdm22main.kicad_sch, sdm22wheel.kicad_pcb]
2022-04-24 creating gerber files
    [sdm22main.kicad_pcb, sdm22wheel.kicad_pcb, sdm22wheel.step]
2022-04-24 created gerber and pdf files
    [sdm22main.kicad_pcb, sdm22wheel.kicad_pcb]
2022-06-26 added can board
    [can_board.kicad_pcb, can_board.kicad_sch]
2022-06-26 added jlc string to canboard
    [can_board.kicad_pcb]
2022-06-26 trying split termination
    [can_board.kicad_pcb, can_board.kicad_sch]
2022-07-11 redoing can board w/o split termination
    [can_board.kicad_pcb]
2022-07-13 decent layout for unsplit-can board
    [can_board.kicad_pcb, can_board.kicad_sch]
2022-07-17 updated split CAN design
    [can_board.kicad_pcb, can_board.kicad_sch]
2022-07-17 more spacing between canh and canl
    [can_board.kicad_pcb]
2022-08-28 added 10k resistor for can board
    [can_board.kicad_pcb, can_board.kicad_sch]
2022-10-04 finish CAN board design
    [can_board.kicad_pcb, can_board.kicad_sch]
2022-10-04 added pinout info
    [can_board.kicad_pcb]
2022-10-04 CAN: back silckscreen additions
    [can_board.kicad_pcb]
2022-10-09 started yaw probe teensy variant
    [yaw_probe_teensy.kicad_pcb, yaw_probe_teensy.kicad_sch]
2022-10-09 yaw probe teensy: schematic finished
    [yaw_probe_teensy.kicad_sch]
2022-10-17 started stm32 variant for yaw probe
    [yaw_probe_stm32.kicad_pcb, yaw_probe_stm32.kicad_sch, yaw_probe_teensy.kicad_sch]
2022-10-19 started main board
    [sdm23main.kicad_pcb, sdm23main.kicad_sch]
2022-10-19 initial draft for main board sdm23
    [sdm23main.kicad_pcb, sdm23main.kicad_sch]
2022-10-19 sdm23main: rearranging layout
    [sdm23main.kicad_pcb, sdm23main.kicad_sch]
2022-10-22 front-rear schematics
    [sdm23front-rear1.kicad_pcb, sdm23front-rear1.kicad_sch]
2022-10-27 uploading yaw probe draft
    [629105150521 (rev1).stp, can_board.kicad_pcb, can_board.kicad_sch, sdm22main.kicad_pcb, sdm22main.kicad_sch, sdm22wheel.kicad_pcb, sdm22wheel.kicad_sch, sdm23main.kicad_pcb]
2022-12-12 Updated CAN Transceiver symbol
    [sdm23front-rear1.kicad_sch]
2023-01-10 imu box
    [imu_box.kicad_pcb, imu_box.kicad_sch, sdm23main.kicad_pcb, sdm23main.kicad_sch, yaw_probe_stm32.kicad_pcb, yaw_probe_teensy.kicad_pcb, yaw_probe_teensy.kicad_sch]
2023-01-10 imu: use different t4.0 footprint
    [imu_box.kicad_pcb, imu_box.kicad_sch]
2023-01-11 update yaw probe for DRS
    [yaw_probe_teensy.kicad_pcb, yaw_probe_teensy.kicad_sch]
2023-01-12 silkscreen additions
    [imu_box.kicad_pcb, imu_box.kicad_sch, sdm23main.kicad_pcb, sdm23main.kicad_sch, yaw_probe_teensy.kicad_pcb, yaw_probe_teensy.kicad_sch]
2023-01-13 add another pwm output to aero board
    [yaw_probe_teensy.kicad_pcb, yaw_probe_teensy.kicad_sch]
2023-01-15 io box
    [sdm23io.kicad_pcb, sdm23io.kicad_sch]
2023-01-18 start sg amplifier
    [imu_box.kicad_pcb, imu_box.kicad_sch, sdm23io.kicad_pcb, sdm23main.kicad_pcb, sdm23main.kicad_sch, sg_amplifier.kicad_pcb, sg_amplifier.kicad_sch, yaw_probe_teensy.kicad_pcb]
2023-01-20 parts for sg amplifier
    [sg_amplifier.kicad_pcb, sg_amplifier.kicad_sch]
2023-01-20 first draft for amplifier pcb
    [sg_amplifier.kicad_pcb]
2023-01-20 moving old projects
    [629105150521 (rev1).stp, sdm23io.kicad_pcb, sdm23io.kicad_sch, yaw_probe_stm32.kicad_pcb, yaw_probe_stm32.kicad_sch]
2023-01-23 various improvements
    [imu_box.kicad_pcb, sdm23front-rear1.kicad_pcb, sdm23front-rear1.kicad_sch, sdm23io.kicad_pcb, sdm23io.kicad_sch, sdm23main.kicad_pcb, sdm23main.kicad_sch, sg_amplifier.kicad_pcb]
2023-01-23 sg amplifier silkscreen
    [sg_amplifier.kicad_pcb]
2023-01-27 sent JLC order
    [can_board.kicad_pcb, can_board.kicad_sch, imu_box.kicad_pcb, imu_box.kicad_sch, sdm23io.kicad_pcb, sdm23main.kicad_pcb, sdm23main.kicad_sch, sg_amplifier.kicad_pcb]
2023-07-04 updating things
    [can_board.kicad_pcb, imu_box.kicad_pcb, imu_box.kicad_sch, sdm23io.kicad_pcb, sdm23io.kicad_sch, sdm23main.kicad_pcb, sdm23main.kicad_sch, sg_amplifier.kicad_pcb]
2023-07-04 commiting SDM-24 wheel board
    [561-1101-100F.SLDPRT, 561-1101-100F.STEP, 561-1301-100F.SLDPRT, 561-1301-100F.STEP, 5x3-2mm.SLDPRT, 5x3-2mm.STEP, ATM15-08PA-BM01.stp, ATM15-3P-BM01.stp]
2023-08-23 updating repo
    [c-1-770669-1-p-3d.stp, can.kicad_sch, connectors.kicad_sch, gps.kicad_sch, memory.kicad_sch, power.kicad_sch, sdm24logger.kicad_sch, sdm24wheel.kicad_pcb]
2023-08-26 wheel board updates
    [sdm24wheel.kicad_sch]
2023-09-04 wheel board rework
    [ATM15-08PA-BM01.stp, ATM15-3P-BM01.stp, JST - XH - Thru - 3Pin - 2.5mm (Genuine).stp, JST - XH - Thru - 4Pin - 2.5mm (Genuine).stp, sdm24wheel.kicad_pcb, sdm24wheel.kicad_sch]
2023-09-29 adding updates
    [6473423-2.step, connectors.kicad_sch, gps.kicad_sch, memory.kicad_sch, power.kicad_sch, sdm24logger.kicad_sch, sdm24wheel.kicad_pcb, sdm24wheel.kicad_sch]
2023-09-29 update wheel board dimension
    [sdm24wheel.kicad_pcb]
2023-09-30 cleaning repository a bit
    [cansplitter.kicad_pcb, cansplitter.kicad_sch]
2023-09-30 researching tvs diodes for logger
    [connectors.kicad_sch, sdm24logger.kicad_sch]
2023-10-13 add 3d models for data logger
    [1040310811.stp, 670687041.stp, c-1-770669-1-p-3d.stp, c-1-776087-1-n-3d.stp.SLDPRT, c-1-776087-1-n-3d.stp.STEP, c-1-776087-4-n-3d.stp, connectors.kicad_sch, gps.kicad_sch]
2023-10-13 inductor model for smps
    [3D_SRP7028CC SERIES.stp, power.kicad_sch, sdm24logger.kicad_pcb]
2023-10-14 smps layout rev1
    [sdm24logger.kicad_pcb]
2023-10-14 smps layout, power mux
    [NX2016SA_NDK.step, connectors.kicad_sch, gps.kicad_sch, memory.kicad_sch, power.kicad_sch, sdm24logger.kicad_pcb, sdm24logger.kicad_sch]
2023-10-14 lap timing board
    [ONVEHICLE.kicad_pcb, ONVEHICLE.kicad_sch]
2023-10-17 board outline, gps antenna
    [734120110.stp, gps.kicad_sch, power.kicad_sch, sdm24logger.kicad_pcb, sdm24logger.kicad_sch]
2023-10-18 gps activities
    [gps.kicad_sch, sdm24logger.kicad_pcb]
2023-10-19 optocoupler for drs button
    [connectors.kicad_sch, sdm24logger.kicad_pcb]
2023-10-20 planning for external adc
    [TLX9291A.stp, connectors.kicad_sch, memory.kicad_sch, sdm24logger.kicad_pcb, sdm24logger.kicad_sch]
2023-10-20 adding externl adc
    [connectors.kicad_sch, sdm24logger.kicad_pcb]
2023-10-21 adding model for i2c shifter
    [DCT0008A.stp, connectors.kicad_sch, power.kicad_sch, sdm24logger.kicad_pcb, sdm24logger.kicad_sch]
2023-10-23 wheel speed board first iteration
    [JST - XH - Thru - 4Pin - 2.5mm (Genuine).stp, wheelspeed.kicad_pcb, wheelspeed.kicad_sch]
2023-10-23 ADC pinouts
    [connectors.kicad_sch, gps.kicad_sch, memory.kicad_sch, power.kicad_sch, sdm24logger.kicad_pcb, sdm24logger.kicad_sch]
2023-10-26 uploading changes
    [connectors.kicad_sch, memory.kicad_sch, power.kicad_sch, sdm24logger.kicad_pcb, sdm24logger.kicad_sch]
2023-10-26 add footprints for volt ref
    [connectors.kicad_sch, gps.kicad_sch, memory.kicad_sch, power.kicad_sch, sdm24logger.kicad_pcb, sdm24logger.kicad_sch]
2023-10-27 length match can splitter, add adapter for load cell connector
    [JST - XH - Thru - 4Pin - 2.5mm (Genuine).stp, c-1734261-4-a-3d.stp, c-1734598-4-r-3d.stp, cansplitter.kicad_pcb, loadcelladapter.kicad_pcb, loadcelladapter.kicad_sch, wheelspeed.kicad_pcb]
2023-10-30 finalize wheel speed board
    [wheelspeed.kicad_pcb]
2023-10-31 finalize wheel board
    [sdm24wheel.kicad_pcb, sdm24wheel.kicad_sch]
2023-11-01 drs box started
    [drs.kicad_pcb, drs.kicad_sch]
2023-11-02 more progress on drs box
    [drs.kicad_pcb, drs.kicad_sch]
2023-11-02 update label wheel board
    [sdm24wheel.kicad_pcb, sdm24wheel.kicad_sch]
2023-11-03 drs work, wheel board m3
    [drs.kicad_sch, sdm24wheel.kicad_pcb, sdm24wheel.kicad_sch]
2023-11-04 found shifter for drs
    [drs.kicad_pcb, drs.kicad_sch, sdm24wheel.kicad_pcb, sdm24wheel.kicad_sch]
2023-11-08 start routing on logger
    [connectors.kicad_sch, drs.kicad_pcb, drs.kicad_sch, gps.kicad_sch, loadcelladapter.step, memory.kicad_sch, power.kicad_sch, sdm24logger.kicad_pcb]
2023-11-09 IMU Box PCB added
    [IMUBox.kicad_pcb, IMUBox.kicad_sch, ISM330DHCX.step, Teensy_4.0_Assembly.STEP]
2023-11-09 Added document values to IMU Box
    [IMUBox.kicad_pcb, IMUBox.kicad_sch]
2023-11-10 sdio routing on data logger
    [connectors.kicad_sch, memory.kicad_sch, sdm24logger.kicad_pcb, sdm24logger.kicad_sch]
2023-11-10 reorganize logger schematic
    [can.kicad_sch, connectors.kicad_sch, gps.kicad_sch, memory.kicad_sch, power.kicad_sch, sdm24logger.kicad_pcb, sdm24logger.kicad_sch]
2023-11-11 start working on digital i/o for logger
    [connectors.kicad_sch]
2023-11-12 add power monitor to data logger
    [can.kicad_sch, connectors.kicad_sch, gps.kicad_sch, memory.kicad_sch, power.kicad_sch, sdm24logger.kicad_pcb, sdm24logger.kicad_sch]
2023-11-13 routed power circuitry
    [can.kicad_sch, connectors.kicad_sch, gps.kicad_sch, memory.kicad_sch, power.kicad_sch, sdm24logger.kicad_pcb, sdm24logger.kicad_sch]
2023-11-14 digital input for data logger
    [connectors.kicad_sch, sdm24logger.kicad_pcb]
2023-11-15 logger panel
    [loggerpanel-F_Silkscreen.dxf, loggerpanel.kicad_pcb, loggerpanel.kicad_sch, loggerpanel.step]
2023-11-30 drs board
    [GG040205170N2P.SLDPRT, GG040205170N2P.STEP, JST - XH - Thru - 2Pin - 2.5mm (Genuine).stp, JST - XH - Thru - 3Pin - 2.5mm (Genuine).stp, drs.kicad_pcb, drs.kicad_sch, wheelspeed.kicad_pcb, wheelspeed.kicad_sch]
2023-12-01 logger updates
    [can.kicad_sch, connectors.kicad_sch, gps.kicad_sch, memory.kicad_sch, power.kicad_sch, sdm24logger.kicad_pcb, sdm24logger.kicad_sch, sdm24wheel.kicad_pcb]
2023-12-02 first draft data logger
    [can.kicad_sch, connectors.kicad_sch, gps.kicad_sch, memory.kicad_sch, power.kicad_sch, sdm24logger.kicad_pcb, sdm24logger.kicad_sch]
2023-12-03 fahb files
    [IMUBox-B_Cu.gbl, IMUBox-B_Mask.gbs, IMUBox-B_Paste.gbp, IMUBox-B_Paste.gbr, IMUBox-B_Silkscreen.gbo, IMUBox-Edge_Cuts.gm1, IMUBox-F_Cu.gtl, IMUBox-F_Mask.gts]
2023-12-03 logger: move c13 to vbat
    [sdm24logger.kicad_pcb]
2023-12-03 logger: redo 5v routing
    [connectors.kicad_sch, sdm24logger.kicad_pcb]
2023-12-03 change 5va mux input
    [gps.kicad_sch, power.kicad_sch, sdm24logger.kicad_pcb, sdm24logger.kicad_sch]
2023-12-03 logger: adjust trace spacing
    [sdm24logger.kicad_pcb]
2023-12-03 logger: fix adr425 footprint
    [connectors.kicad_sch, power.kicad_sch, sdm24logger.kicad_pcb]
2023-12-03 logger: general improvements
    [sdm24logger.kicad_pcb]
2023-12-04 sent logger/wheel/he/cansplitter/lca/imu for fabrication
    [can.kicad_sch, can_board.kicad_pcb, can_board.kicad_sch, connectors.kicad_sch, gps.kicad_sch, memory.kicad_sch, power.kicad_sch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]
2023-12-05 assembly info for logger
    [can.kicad_sch, connectors.kicad_sch, gps.kicad_sch, power.kicad_sch, sdm24logger.kicad_pcb]
2023-12-05 more assembly drawings
    [IMUBox.kicad_pcb, drs.kicad_pcb, sdm24wheel.kicad_pcb, wheelspeed.kicad_pcb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]
2024-01-14 over engineering yet again
    [lapbeacon.kicad_pcb, lapbeacon.kicad_sch]
2024-01-15 finalize telemetry
    [IRTRAN.kicad_pcb, IRTRAN.kicad_sch, ONVEHICLE.kicad_pcb, ONVEHICLE.kicad_sch, Pedal Load .kicad_pcb, Pedal Load .kicad_sch, SOD-123FL.STEP, Teensy_4.0_Assembly.STEP]
2024-01-15 add led to lap receiver
    [ONVEHICLE.kicad_pcb, ONVEHICLE.kicad_sch]
2024-01-16 fix swd in wheel board
    [sdm24wheel.kicad_pcb, sdm24wheel.kicad_sch]
2024-01-21 data logger 3.1
    [82720Mold_SS.stp, ECS-120-10-36Q-AES-TR.STEP, IMUBox.kicad_pcb, ONVEHICLE.kicad_pcb, Teensy_4.0_Assembly.STEP, can.kicad_sch, connectors.kicad_sch, gps.kicad_sch]
2024-01-21 wheel board v1.1
    [sdm24wheel.kicad_pcb, sdm24wheel.kicad_sch]
2024-01-21 Fab files for pcbway
    [ONVEHICLE-B_Cu.gbr, ONVEHICLE-B_Mask.gbr, ONVEHICLE-B_Paste.gbr, ONVEHICLE-B_Silkscreen.gbr, ONVEHICLE-Edge_Cuts.gbr, ONVEHICLE-F_Cu.gbr, ONVEHICLE-F_Mask.gbr, ONVEHICLE-F_Paste.gbr]
2024-01-21 adding gps connector to panel model
    [TE-SMA-PanelMount.STEP, loggerpanel.kicad_pcb, sdm24logger.kicad_pcb]
2024-01-22 logger panel changes
    [loggerpanel-Edge_Cuts.dxf, loggerpanel.kicad_pcb, loggerpanel.step, sdm24logger.kicad_pcb]
2024-01-22 adjust nrf footprint
    [telemetry-B_Cu.gbr, telemetry-B_Mask.gbr, telemetry-B_Paste.gbr, telemetry-B_Silkscreen.gbr, telemetry-Edge_Cuts.gbr, telemetry-F_Cu.gbr, telemetry-F_Mask.gbr, telemetry-F_Paste.gbr]
2024-01-28 less wide logger
    [sdm24logger.kicad_pcb]
2024-01-28 before change to conn footprint
    [sdm24logger.kicad_pcb]
2024-01-28 remove mech hole for connector
    [sdm24logger.kicad_pcb]
2024-02-01 ordered logger v3.1, panel, shifter
    [SDM24-Shifter-B_Cu.gbl, SDM24-Shifter-B_Mask.gbs, SDM24-Shifter-B_Paste.gbp, SDM24-Shifter-B_Silkscreen.gbo, SDM24-Shifter-Edge_Cuts.gm1, SDM24-Shifter-F_Cu.gtl, SDM24-Shifter-F_Mask.gts, SDM24-Shifter-F_Paste.gtp]
2024-04-06 drawings and update can splitter with mappings
    [cansplitter.kicad_sch]
2024-08-31 SDM25 Wheelboard updates
    Incremental work - unfinished.
    [1050170001.stp, 561-1101-100F.SLDPRT, 561-1101-100F.STEP, 561-1301-100F.SLDPRT, 561-1301-100F.STEP, 5x3-2mm.SLDPRT, 5x3-2mm.STEP, ECS-120-10-36Q-AES-TR.STEP]
2024-09-17 SDM-25 Wheelboard
    Includes preliminary design for accompanying mlx-breakout board. Power delivery/input for new 5V WSPD sensor.
    [1050170001.stp, 561-1101-100F.SLDPRT, 561-1101-100F.STEP, 561-1301-100F.SLDPRT, 561-1301-100F.STEP, 5x3-2mm.SLDPRT, 5x3-2mm.STEP, ECS-120-10-36Q-AES-TR.STEP]
2024-10-03 Cansplitter revision added
    Let me know if I need to add anything
    [cansplitter2.kicad_pcb, cansplitter2.kicad_sch]
2024-10-26 Improved CANsplitter revisions
    brrr
    [cansplitter2.kicad_pcb, cansplitterV3.kicad_pcb]
2024-12-05 sdm24 logger BOM
    [sdm24logger.csv]
2024-12-05 can splitter mfg
    update to include markings + output files for manufacturing
    [cansplitterV3-B_Cu.gbl, cansplitterV3-B_Mask.gbs, cansplitterV3-B_Paste.gbp, cansplitterV3-B_Silkscreen.gbo, cansplitterV3-Edge_Cuts.gm1, cansplitterV3-F_Cu.gtl, cansplitterV3-F_Mask.gts, cansplitterV3-F_Paste.gtp]
2024-12-05 STM32 telemetry upload
    includes first revision STM32 based telemetry board - by matthew mcconnell
    [Telemetry_STM32_V3.kicad_pcb, Telemetry_STM32_V3.kicad_sch]
2024-12-15 telem pcb updates
    updated labels + assignments for prod
    [Telemetry_STM32_V3.kicad_pcb]
2024-12-15 telem + cansplitter builds
    included build files sent out for manufacture
    [Telemetry_STM32_V3-B_Cu.gbl, Telemetry_STM32_V3-B_Mask.gbs, Telemetry_STM32_V3-B_Paste.gbp, Telemetry_STM32_V3-B_Silkscreen.gbo, Telemetry_STM32_V3-Edge_Cuts.gm1, Telemetry_STM32_V3-F_Cu.gtl, Telemetry_STM32_V3-F_Mask.gts, Telemetry_STM32_V3-F_Paste.gtp]
2024-12-17 wheelboard wspd revision
    first iteration using MAX9924 and VR sensor
    [sdm25wheel.kicad_sch]
2024-12-26 WSPD MAX9924 PCB Integration
    Integrated MAX9924 IC into the wheelboard PCB for WSPD measurement.
    [sdm25wheel.kicad_pcb, sdm25wheel.kicad_sch]
2025-01-23 Telemetry CAN Pin Fix
    Moved CAN pins to correct pins on STM32
    [Telemetry_STM32_V3-B_Cu.gbl, Telemetry_STM32_V3-B_Mask.gbs, Telemetry_STM32_V3-B_Paste.gbp, Telemetry_STM32_V3-B_Silkscreen.gbo, Telemetry_STM32_V3-Edge_Cuts.gm1, Telemetry_STM32_V3-F_Cu.gtl, Telemetry_STM32_V3-F_Mask.gts, Telemetry_STM32_V3-F_Paste.gtp]
2025-01-23 SDM25_IMU_STM32
    New IMU board with STM32
    [SDM25_IMU_STM32.csv, SDM25_IMU_STM32.kicad_pcb, SDM25_IMU_STM32.kicad_sch, SDM25_IMU_STM322.csv]
2025-01-23 SDM25_IMU Edits
    -Renamed components to avoid duplicate component names.
    -Other small fixes
    [24LC02BT_ELT_3D.step, ISM330DHCXTR_3D.step, Micro_USB_Type_B_3D.stp, SDM25_IMU_STM32.kicad_pcb, SDM25_IMU_STM32.kicad_sch, SOD-123FL.STEP]
2025-01-25 SDM25 Steering Wheel
    Bulk of steering wheel files, including files for manufacture. Most design work done by Erin Pryor.
    [sdm25mlxboard.step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]
2025-01-25 Manuf. Builds.
    Buildout for Manufacture on several boards.
    [SDM25_IMU_STM32-B_Cu.gbl, SDM25_IMU_STM32-B_Mask.gbs, SDM25_IMU_STM32-B_Paste.gbp, SDM25_IMU_STM32-B_Silkscreen.gbo, SDM25_IMU_STM32-Edge_Cuts.gm1, SDM25_IMU_STM32-F_Cu.gtl, SDM25_IMU_STM32-F_Mask.gts, SDM25_IMU_STM32-F_Paste.gtp]
2025-01-30 Last minute board fixes.
    Changed I2C pull down resistors to pull up on Telemetry and IMU.
    Improved routing of NRST pin on IMU.
    [SDM25_IMU_STM32.kicad_pcb, SDM25_IMU_STM32.kicad_sch, Telemetry_STM32_V3.kicad_pcb, Telemetry_STM32_V3.kicad_sch]
2025-02-01 SDM-24 Logger TVS diodes
    TVS protection added on all analog inputs. Also built out for manufacture files.
    [NEO.STEP, TE-SMA-PanelMount.STEP, c-1-776087-1-n-3d.stp.STEP, can.kicad_sch, connectors.kicad_sch, gps.kicad_sch, loadcelladapter.step, memory.kicad_sch]
2025-02-02 IMU + Telemetry + Steering Wheel
    Final manufacturing outputs
    [SDM25_IMU_STM32-B_Cu.gbl, SDM25_IMU_STM32-B_Mask.gbs, SDM25_IMU_STM32-B_Paste.gbp, SDM25_IMU_STM32-B_Silkscreen.gbo, SDM25_IMU_STM32-Edge_Cuts.gm1, SDM25_IMU_STM32-F_Cu.gtl, SDM25_IMU_STM32-F_Mask.gts, SDM25_IMU_STM32-F_Paste.gtp]
2025-02-03 drs/mpcm
    modified DRS with multipurpose control module labeling for SDM-25, module will be used in ARB + shiftR
    [GG040205170N2P.SLDPRT, GG040205170N2P.STEP, JST - XH - Thru - 2Pin - 2.5mm (Genuine).stp, JST - XH - Thru - 3Pin - 2.5mm (Genuine).stp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]
2025-02-26 Timing gates PCB
    Init for timing gates PCB
    [timingGatesSTM32V1.kicad_pcb, timingGatesSTM32V1.kicad_sch, timingGatesSTM32V1.step]
2025-03-01 drs/mcpm fix
    changing folder name
    also uploading WIP steering wheel revision
    [GG040205170N2P.SLDPRT, GG040205170N2P.STEP, JST - XH - Thru - 2Pin - 2.5mm (Genuine).stp, JST - XH - Thru - 3Pin - 2.5mm (Genuine).stp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]
2025-03-16 Steering Wheel REV2
    Complete overhaul of the steering wheel module complete - ready for review.
    [steering wheel v4.kicad_pcb, steering wheel v4.kicad_sch]
2025-03-17 Post-Feedback STW Updates
    Updates to Steering PCB regarding differential pair routing.
    [steering wheel v4.kicad_pcb]
2025-03-18 BSPD edits
    [3362U-1-104ALF.stp, BSPD.kicad_pcb, BSPD.kicad_sch, CD4001BM96E4.stp, CD74HC08QM96Q1.stp, DT13-08PA.step, EDI2CAP.CFG, L7805ACD2T-TR.stp]
2025-03-18 BSPD edits
    Connector and LED
    [BSPD.kicad_pcb, BSPD.kicad_sch]
2025-03-19 BSPD
    ft BIG LED and the correct DT(M) Connector
    [BSPD.kicad_pcb]
2025-04-03 3/20/25 Fab Outputs
    [BSPD.csv, cansplitterV3.kicad_pcb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]
2025-04-04 IMU Fix
    Fixed CAN, I2C, and USB Differential Pairs
    [SDM25_IMU_STM32.kicad_pcb]
2025-04-04 IMU Fixes (electric boogaloo)
    further fixes
    [SDM25_IMU_STM32-B_Mask.gbs, SDM25_IMU_STM32-B_Paste.gbp, SDM25_IMU_STM32-B_Silkscreen.gbo, SDM25_IMU_STM32-Edge_Cuts.gm1, SDM25_IMU_STM32-F_Cu.gtl, SDM25_IMU_STM32-F_Mask.gts, SDM25_IMU_STM32-F_Paste.gtp, SDM25_IMU_STM32-F_Silkscreen.gto]
2025-04-05 IMU fix
    USB D+ D-
    [SDM25_IMU_STM32-B_Cu.gbl, SDM25_IMU_STM32-B_Mask.gbs, SDM25_IMU_STM32-B_Paste.gbp, SDM25_IMU_STM32-B_Silkscreen.gbo, SDM25_IMU_STM32-Edge_Cuts.gm1, SDM25_IMU_STM32-F_Cu.gtl, SDM25_IMU_STM32-F_Mask.gts, SDM25_IMU_STM32-F_Paste.gtp]
2025-04-05 Telemetry - CAN, I2C, USB Fix
    Fr this time
    [Telemetry_STM32_V3-B_Cu.gbl, Telemetry_STM32_V3-B_Mask.gbs, Telemetry_STM32_V3-B_Paste.gbp, Telemetry_STM32_V3-B_Silkscreen.gbo, Telemetry_STM32_V3-Edge_Cuts.gm1, Telemetry_STM32_V3-F_Cu.gtl, Telemetry_STM32_V3-F_Mask.gts, Telemetry_STM32_V3-F_Paste.gtp]
2025-04-12 BSPD
    New Latch
    New Trimmers
    [BSPD-B_Cu.gbr, BSPD-B_Mask.gbr, BSPD-B_Paste.gbr, BSPD-B_Silkscreen.gbr, BSPD-Edge_Cuts.gbr, BSPD-F_Cu.gbr, BSPD-F_Mask.gbr, BSPD-F_Paste.gbr]
2025-04-12 Teensy Telemetry
    [Teensy_4.0_Assembly.STEP, Teensy_Telemetry_Compact.kicad_pcb, Teensy_Telemetry_Compact.kicad_sch]
2025-05-09 evan's 5/8 push
    [BSPD-B_Cu.gbl, BSPD-B_Mask.gbs, BSPD-B_Paste.gbp, BSPD-B_Silkscreen.gbo, BSPD-Edge_Cuts.gm1, BSPD-F_Cu.gtl, BSPD-F_Mask.gts, BSPD-F_Paste.gtp]
2025-10-08 Changing the organization of PCB repo for better accessibility and allowing for easier access (#5)
    * Reorganizing to make it future proof
    * Reorganizing to make it future proof
    * Adding BSPD Circuit
    * Beginning logger the loooong way (V3) and other misc changes
    * Logger V3.0 wiring complete needs silkscreen fixes
    * Logger 3.1
    * Logger V3.11
    * Wheelboard 2026 Commit
    * Put into right folder
    * Update L2 to correct size and other misc changes
    * Small changes to schematic
    * Added Diode and JST 4 pin automotive connector
    * CAN Splitter
    * update voltage divider to more common values and changed CAN termination to MOSFET
    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
    [1040310811.stp, 1050170001.stp, 150060RS75000.step, 24LC02BT_ELT_3D.step, 2N7002,215.step, 3362U-1-104ALF.stp, 3386P-1-103TLF.step, 3D_SRP7028CC SERIES.stp]
2025-10-10 Edited pcb layout. Added CAN 2 circuitry
    [SDM26_Wheelboard_V1.2.kicad_pcb, SDM26_Wheelboard_V1.2.kicad_sch]
2025-10-10 Temp sensor and msic update
    [MLX90642ESF-BCA-000-SP.step, SDM26_TempSensor_V1.0.kicad_pcb, SDM26_TempSensor_V1.0.kicad_sch]
2025-10-17 pitot board :)
    [4525DO-DS5AI001DP.step, PitotBoard.kicad_pcb, PitotBoard.kicad_sch, SDM26_SteeringWheel_V1.0.kicad_sch]
2025-10-17 Wheelboard dimesnion update
    [SDM26_Wheelboard_V1.2.kicad_pcb]
2025-10-17 CAN Splitter Mini
    [SDM26_Splitter_Mini_V1.0.kicad_pcb, SDM26_Splitter_Mini_V1.0.kicad_sch]
2025-10-17 Logger misc
    [SDM26LoggerV4.0.kicad_sch]
2025-10-18 Moved Mini edge connectors
    [SDM26_Splitter_Mini_V1.0.kicad_pcb]
2025-10-20 Fixed PCB for systems
    [SDM26_SteeringWheel_V1.0.kicad_sch]
2025-10-20 Fixing SW Regression
    [SDM26_SteeringWheel_V1.0.kicad_sch]
2025-10-20 Revert "Fixing SW Regression"
    This reverts commit b1f5285f4e309ac5406c286e558759261840c35c.
    [SDM26_SteeringWheel_V1.0.kicad_sch]
2025-10-20 Fixing stering wheel for systems (again?)
    [MHPS2285V.step, MHPS2285V.stp, SDM26_SteeringWheel_V1.0.kicad_pcb]
2025-10-20 fixed overwritten sw commit
    [SDM26_SteeringWheel_V1.0.kicad_pcb, SDM26_SteeringWheel_V1.0.kicad_sch]
2025-10-21 Systems got me workin
    [SDM26_SteeringWheel_V1.0.kicad_pcb, SDM26_SteeringWheel_V1.0.kicad_sch]
2025-10-24 Moved around some stuff on the red side and like one thing on the blue
    [SDM26_Wheelboard_V1.2.kicad_pcb]
2025-10-31 Wheelboard AGAIN
    [M3_Bolt.STEP, SDM26_TimingGates_V2.0.kicad_pcb, SDM26_Wheelboard_V2.0.kicad_pcb, SDM26_Wheelboard_V2.0.kicad_sch, bom.csv, designators.csv, positions.csv]
2025-11-03 wheel board 1.3 + parts added to libraries
    [MCP2518FDT-H_QBB.stp, SDM2026_Wheelboard_V1.3.kicad_pcb, SDM2026_Wheelboard_V1.3.kicad_sch]
2025-11-08 Wheel Board 1.3
    [SDM2026_Wheelboard_V1.3.kicad_pcb, SDM2026_Wheelboard_V1.3.kicad_sch]
2025-11-15 Finalizing Wheelboards
    [SDM2026_Wheelboard_V1.3.kicad_pcb, SDM2026_Wheelboard_V1.3.kicad_sch, SDM26_Wheelboard_V2.0.kicad_pcb, SDM26_Wheelboard_V2.0.kicad_sch]
2025-11-15 Fixed analog and added misc 2
    [NondimensionalTractionControl_V1.1.kicad_pcb, NondimensionalTractionControl_V1.1.kicad_sch]
2025-11-18 Misc (A lot and I don't wanna organize 😛)
    [NondimensionalTractionControl_V1.1.kicad_pcb, PitotBoard.kicad_pcb, SDM26LoggerV2.kicad_sch, SDM26_TempSensor_V1.0.kicad_pcb, SDM26_Wheelboard.kicad_pcb, SDM26_Wheelboard.kicad_sch, SDM26_Wheelboard_V1.0.kicad_pcb, SDM26_Wheelboard_V1.0.kicad_sch]
2025-11-21 Nathaniel first commit added KiCad shifter project, pcb, and schematic
    [Shifter_SDM.kicad_pcb, Shifter_SDM.kicad_sch]
2025-11-25 Added Rotor Temp Sensor board
    [MLX90614ESF-BAA-000-SP.step, SDM26_RotorTempSensor_V1.0.kicad_pcb, SDM26_RotorTempSensor_V1.0.kicad_sch]
2025-11-26 Dash and ESP32 template
    Made Dash Project
    Fixed some of the footprints and made more usable
    [Dash.kicad_pcb, Dash.kicad_sch, ESP32_MCU_Template.kicad_pcb, ESP32_MCU_Template.kicad_sch]
2025-11-26 Dash edits and added symbol and footprints to lib
    [Dash.kicad_sch, TLC5955RTQT.stp]
2025-12-04 Dash and Libraries Update
    [CLMUD-FKC-CHJNPM569ABB845343.stp, Dash.kicad_sch]
2026-01-15 Naming Updates
    [SDM26_RotorTempSensor_V1.0.kicad_pcb, SDM26_RotorTempSensor_V1.0.kicad_sch]
2026-01-16 Renamed Variable Resistors to Potentiometers
    [SDM26_BSPD_V1.1.kicad_sch]
2026-01-16 misc updates
    [USB4215-03-A.step]
2026-01-16 Added Backlight boost to dash Sch
    [Dash.kicad_sch]
2026-01-17 Dash Sch Edits
    Moved to USB-C
    Progress on RGB LED nets
    [Dash.kicad_sch]
2026-01-18 Changed dash to IP67 USB C
    [Dash.kicad_sch, USB4730-GF-A.stp]
2026-01-18 Wheelboard 2.1 fixed 5v power for wsp ic
    [SDM26_Wheelboard_V2.1.kicad_pcb, SDM26_Wheelboard_V2.1.kicad_sch]
2026-01-21 update ESP32S3 MCU Template
    Changed R15 from 10k to 0ohm
    [ESP32_MCU_Template.kicad_sch]
2026-01-22 One more fix on esp32 template sch
    chip pu
    [ESP32_MCU_Template.kicad_sch]
2026-01-31 Dash progress
    added to libs and swaped dash to BT818. Work in progress
    [BT818Q-T.stp, Dash.kicad_sch, S25FL256LAGNFB010.stp]
2026-02-13 Dash Updates
    [19428-0011.stp, Dash.kicad_pcb, Dash.kicad_sch, KSS321G_LFS.stp]
2026-02-17 Timing gates V3.0
    [SDM26_TimingGates_V3.0.kicad_pcb, SDM26_TimingGates_V3.0.kicad_sch]
2026-02-17 SDM27 Logger
    [Power.kicad_sch, SDM27LoggerV1.0.kicad_pcb, SDM27LoggerV1.0.kicad_sch, analog.kicad_sch, connectors.kicad_sch]
2026-02-17 Temp Sensor Board
    [SDM26_RotorTempSensor_V1.0.kicad_pcb, SDM26_RotorTempSensor_V1.0.kicad_sch]
2026-02-18 NDTC Fixing pwr pin swap
    [NondimensionalTractionControl_V1.0.kicad_pcb, NondimensionalTractionControl_V1.0.kicad_sch, NondimensionalTractionControl_V1.1.kicad_pcb, NondimensionalTractionControl_V1.1.kicad_sch, NondimensionalTractionControl_V1.2.kicad_pcb, NondimensionalTractionControl_V1.2.kicad_sch]
2026-02-18 27 can spliter
    [CAN_Splitter_2027.kicad_pcb, CAN_Splitter_2027.kicad_sch]
2026-02-19 Dash PCB work
    [Dash.kicad_pcb, Dash.kicad_sch]
2026-02-20 my bad pimp
    [IIS2MDCTR.stp, SDM26_IMU_V1.0.kicad_pcb, SDM26_IMU_V1.0.kicad_sch]
2026-02-20 add telemetry
    [Telemetry.kicad_pcb, Telemetry.kicad_sch]
2026-02-25 SW removed display added spi connection
    [SDM26_SteeringWheel_V1.1.kicad_sch]
2026-02-25 Telemetry finalization
    [Telemetry.kicad_pcb, Telemetry.kicad_sch]
2026-02-25 Cleaning schematic
    [NondimensionalTractionControl_V1.2.kicad_sch]
2026-02-27 Decreased Splitter size
    [SDM26_Splitter_V1.2.kicad_pcb, SDM26_Splitter_V1.2.kicad_sch]
2026-02-27 Added Magnetometer
    [SDM26_IMU_V1.1.kicad_pcb, SDM26_IMU_V1.1.kicad_sch]
2026-02-27 Fixing IMU_V1.0 getting nuked
    [IIS2MDCTR.stp, SDM26_IMU_V1.0.kicad_pcb, SDM26_IMU_V1.0.kicad_sch]
2026-03-03 Can Splitter and mini Can Splitter updates
    [SDM26_Splitter_Mini3_V1.0.kicad_pcb, SDM26_Splitter_Mini3_V1.0.kicad_sch, SDM26_Splitter_Mini4_V1.0.kicad_pcb, SDM26_Splitter_Mini4_V1.0.kicad_sch]
2026-03-03 Added RF amplifier to telemetry board
    [SE2576L-R.step, Telemetry.kicad_pcb, Telemetry.kicad_sch]
2026-03-19 Cleaning IMU Repo
    [SDM26_IMU_V1.1.kicad_pcb, SDM26_IMU_V1.1.kicad_sch]
2026-03-19 (Misc) Updated export locations
    [NondimensionalTractionControl_V1.2.kicad_pcb]
2026-03-19 Updated naming and small updates
    [SDM26_Shifter_V1.0.kicad_pcb, SDM26_Shifter_V1.0.kicad_sch, Shifter_SDM.kicad_pcb, Shifter_SDM.kicad_sch]
2026-03-19 (Misc) Changed naming and output dir
    [SDM26_SteeringWheel_V1.1.kicad_sch]
2026-03-19 Renamed, added impedance matching documentation
    [SDM26_Telemetry_V1.0.kicad_pcb, SDM26_Telemetry_V1.0.kicad_sch]
2026-03-19 Renamed V3 to V2.1
    [SDM26_TimingGates_V2.1.kicad_pcb, SDM26_TimingGates_V2.1.kicad_sch]
2026-03-19 Changed naming conventions
    [SDM27_CANSplitter_V1.0.kicad_pcb, SDM27_CANSplitter_V1.0.kicad_sch]
2026-03-19 adding libraries to misc libraries
    [CONUFL001-SMD-T.step, IIS2MDCTR.stp, M2_Bolt.STEP, Power.kicad_sch, SDM27LoggerV1.0.kicad_pcb, SDM27LoggerV1.0.kicad_sch, TPD4S480RUKR.step, TPS26750SRSMR.step]
2026-04-02 Hella dash edits
    just cranked that shit out
    [Dash.kicad_pcb, Dash.kicad_sch]
2026-04-04 Dash check, Fernando
    [Dash.kicad_pcb, Dash.kicad_sch]
2026-05-18 SDM27 C5 Wheel board started
    basic wip wheel board sch, with dual band RF ( :
    [SDM27_WheelBoard_v1.0.kicad_pcb, SDM27_WheelBoard_v1.0.kicad_sch]
2026-05-19 Wheel board parts update
    [SDM27_WheelBoard_v1.0.kicad_sch]
2026-05-19 Wheel Board, new parts added
    [LFD182G45DCHD277.stp, NCP187AMT330TAG.stp, SDM27_WheelBoard_v1.0.kicad_pcb, SDM27_WheelBoard_v1.0.kicad_sch]
2026-05-21 more edits, board still very WIP. need to add USB
    [27wheel board.stl, SDM27_WheelBoard_v1.0.kicad_pcb, SDM27_WheelBoard_v1.0.kicad_sch]
2026-06-14 Slip Angle V1
    Board done, ive got all the parts
    [ADNS-3050.stp, SensorMountV1.kicad_pcb, SensorMountV1.kicad_sch]
2026-06-14 Fixed a werid trace thing on slip angle
    [SensorMountV1.kicad_pcb]
2026-06-17 SA12 footprint part
    [sa127pinfootprint.kicad_pcb, sa127pinfootprint.kicad_sch]
2026-06-20 Slip angle v2
    [SensorMountV2.kicad_pcb, SensorMountV2.kicad_sch]
2026-06-20 small fix to slip
    [SensorMountV2.kicad_pcb]
2026-06-21 Cooling Sensor Board progres
    [Cooling_System_Sensor_Board_V1.kicad_pcb, Cooling_System_Sensor_Board_V1.kicad_sch]
2026-06-22 board done
    could add more to silk screen
    [Cooling_System_Sensor_Board_V1.kicad_pcb, Cooling_System_Sensor_Board_V1.kicad_sch]
2026-06-22 small cooling board fix
    [Cooling_System_Sensor_Board_V1.kicad_pcb]
2026-07-10 Gerber Files Made for 7/12 order
    [Cooling_System_Sensor_Board_V1.kicad_pcb, SensorMountV2.kicad_pcb]
2026-07-11 Wheel board power ICS and Shifter gate drive IC added
    [6EDL7141XUMA1.stp, SDM27_WheelBoard_v1.0.kicad_sch, ShifterBoard_V1.kicad_pcb, ShifterBoard_V1.kicad_sch, TPS2121RUXR.stp, TPS542951RSAR.stp]
2026-07-12 7/12 boards
2026-07-17 WheelBoard Final edits
    fancy connector symbols
    [SDM27_WheelBoard_v1.0.kicad_sch, SN74LVC1G17YZPR.stp]
2026-07-17 WB notes
    [SDM27_WheelBoard_v1.0.kicad_sch]
2026-07-17 Notes again, my B
    [SDM27_WheelBoard_v1.0.kicad_sch]
2026-07-17 Annotation Updates
    [SDM27_WheelBoard_v1.0.kicad_sch]
2026-07-18 PCB Review 7/17
    [SDM27_WheelBoard_v1.0.kicad_sch]
2026-07-20 Added SDM27 S3 logger
    Added USB-C and CAN FD. Still a few things to fix
    [SDM27_S3_LoggerV1.0.kicad_sch]
2026-07-28 wheel boards
    [SDM27_WheelBoard_v1.0.kicad_pcb, SDM27_WheelBoard_v1.0.kicad_sch, sa127pinfootprint.kicad_pcb]
2026-07-29 part values update
    [SDM27_WheelBoard_v1.0.kicad_pcb, SDM27_WheelBoard_v1.0.kicad_sch]
2026-07-29 board progrez 40%
    its 4:30 am...
    [SDM27_WheelBoard_v1.0.kicad_pcb]
2026-07-30 WB 90% + added buttons
    [SDM27_WheelBoard_v1.0.kicad_pcb, SDM27_WheelBoard_v1.0.kicad_sch, SKTHBAE010.stp]
2026-07-30 A few more WB edits before bed
    [SDM27_WheelBoard_v1.0.kicad_pcb]
2026-07-31 added wb power mux to s3 logger
    [SDM27_S3_LoggerV1.0.kicad_sch]
2026-07-31 Cell Telem
    added simcom footprint
    [SDM27_Telemetry_V1.kicad_pcb, SDM27_Telemetry_V1.kicad_sch]
2026-07-31 BSPD Init + Misc
    [BSS84AK,215.step, SDM27_BSPD_V1.0.kicad_pcb, SDM27_BSPD_V1.0.kicad_sch]
2026-08-01 BSPD Commit + Misc
    [MLZ2012N3R3LTD25.step, SDM27_BSPD_V1.0.kicad_pcb, SDM27_BSPD_V1.0.kicad_sch]
2026-08-02 Added FDCAN SPI, USB2.0 Fullspeed, moved GNSS UART
    work to be done: remove traces of old EFUSE, find source of VCC global net
    [SDM27_S3_LoggerV1.0.kicad_sch]
2026-08-02 Added CAN IN/OUT to connectors
    [SDM27_S3_LoggerV1.0.kicad_sch]
2026-08-12 logger SD ESD diode swap sch
    [PUSB3FR6Z.stp, SDM27_S3_LoggerV1.0.kicad_sch, SDM27_Telemetry_V1.kicad_sch]
2026-08-27 C5 template update
    [ESP-C5.kicad_sch]
2026-08-28 C5 template edits. updated C5 symbol and fixed a few sch errors
    errors with strapping and USB C.
    Still need to finish designator refactoring.
2026-09-02 SDM27 WB - added USBC and UFL
    [SDM27_WheelBoard_v1.0.kicad_pcb, SDM27_WheelBoard_v1.0.kicad_sch, USB4730-GF-A_REVA.step]
2026-09-03 C5 Template updates
    [ESP-C5.kicad_sch, F1C1-201612-2R2M.stp, TPS62901RPJR.stp]
2026-09-08 Initial IMU Schematic before review
    [IMU_V1.kicad_pcb, IMU_V1.kicad_sch]
2026-09-09 IMU updates, ready for layout
    [ESP-C5.kicad_sch, IMU_V1.kicad_sch]
2026-09-09 weipu 7 pin jst
    [IMU_V1.kicad_sch]
2026-09-10 Oscillator Files
    Added missing oscillator files for kicad
    [CX1612DB48000D0FPJC1.stp]
2026-09-10 IMU V1 Fixes
    redesignated resistor and capacitor values to be sorted.
    Added 7 pin jst-ph to board
    Removed extra pair of resistors on USB D Pins that was added. (Already had a set on MCU)
    [IMU_V1.kicad_pcb, IMU_V1.kicad_sch]
2026-09-11 C5 template fixes
    [ESP-C5.kicad_sch]
2026-09-11 cleaned up hidden wires
    Cleaned up hidden wires
    [ESP-C5-CANSNIFFERV1.kicad_sch, ESP-C5.kicad_pcb, ESP-C5.kicad_sch]
2026-09-11 Fixed buck capacitance values
    [SDM27_BSPD_V1.0.kicad_sch]
2026-09-13 port to pc
    [IMU_V1.kicad_pcb, IMU_V1.kicad_sch]
2026-09-23 Added strain guage amp schematic and layout file, currently completeing schematic
    [SDM27_StrainGaugeAmp.kicad_pcb, SDM27_StrainGaugeAmp.kicad_sch]
2026-09-23 Updated schematic layout for Strain gauge amp
    [SDM27_StrainGaugeAmp.kicad_sch]
2026-09-23 CAN sniffer updated
    updated CAN sniffer
    [.kicad_sch, .kicad_sch.kicad_sch, ESP-C5-CAN SNIFFER.kicad_sch, ESP-C5.kicad_sch]
2026-09-25 IMU PCB V1
    [IMU_V1.kicad_pcb, IMU_V1.kicad_sch]
2026-09-25 Marked strain gauges as DNP and added 4-pin WAIPU connector
    [SDM27_StrainGaugeAmp.kicad_sch]
2026-09-25 Started layout organized sections
    [SDM27_StrainGaugeAmp.kicad_pcb, SDM27_StrainGaugeAmp.kicad_sch]
2026-09-26 Organized layout a bit more also added CAN termination resistor
    [SDM27_StrainGaugeAmp.kicad_pcb, SDM27_StrainGaugeAmp.kicad_sch]
2026-09-28 fully updated PCB layout so far
    [ESP-C5-CAN SNIFFER.kicad_pcb, ESP-C5-CAN SNIFFER.kicad_sch]
2026-09-29 strain awg eval
    [StrainGaugeEval_V1.kicad_pcb, StrainGaugeEval_V1.kicad_sch]
2026-09-30 IMU V1 Revisions
    Components on 1 side
    Revised Routing.
    [IMU_V1.kicad_pcb, IMU_V1.kicad_sch]
2026-10-01 strain awg eval layout
    [MCP3561R-E_ST.stp, StrainGaugeEval_V1.kicad_pcb, StrainGaugeEval_V1.kicad_sch, TC1108-3.0VDBTR.stp]
2026-10-01 Strain Gauge Eval board done
    [StrainGaugeEval_V1.kicad_pcb, StrainGaugeEval_V1.kicad_sch]
2026-10-01 strain gauge eval silk screen updates
    [StrainGaugeEval_V1.kicad_pcb]
2026-10-01 Wheel boards silk screen done.
    [SDM27_WheelBoard_v1.0.kicad_pcb, SDM27_WheelBoard_v1.0.kicad_sch]
2026-10-02 Started Organization-SDM Telem
    [Rf.kicad_sch, SDM27_Telemetry_V1.kicad_sch]
2026-10-06 T113 Dash kicad init
    [CAN-USB.kicad_sch, sdm27-dash-v1.kicad_pcb, sdm27-dash-v1.kicad_sch]
2026-10-08 Updates to PCB fir CAN Sniffer
    Mostly done PCB
2026-10-09 Update layout
    [SDM27_StrainGaugeAmp.kicad_pcb]
2026-10-11 IMU port
    Just updating files for Laptop, silkscreen cleared up just needs stitching
2026-10-12 IMU V1 Finalized
2026-10-20 Revert "Merge branch 'main' of https://github.com/sundevilmotorsports/pcb-dev"
    This reverts commit 77c4aaa4414c887e3a1759e24849b67653962ada, reversing
    changes made to 66aa26cb5628437af23413e372475af4b0eb60dc.
2026-10-20 Library maintenance
    edited some 3dmodles to point to their footprints. edited symbols and footprints to link properly. edited footprint and symbol library names in all projects 2026-2027 to use the same library nick name "SDM" for both symbol and footprint.
    all users must delete their old lib and make a new one named SDM for symbol and footprint.
2026-10-22 Updated silkscreen references on board
2026-10-23 Wheel board edits - design review
2026-10-23 IMU Final Touches and Gerber/Drill Files
2026-10-23 Wheelboard layout review
2026-10-25 Added TLV9022QDRQ1 Precision Automotive Rail to Rail Comparator
2026-10-26 wheel boards and IMU Fab files + USB fix
2026-10-27 Made final changes to strain gauage board
2026-10-28 Added Strain Gauge BOM with Supplier links for Mouser order
2026-10-29 Silkscreen SDM Logos
2026-10-30 Created dedicated folders for main board and breakout
2026-11-13 Update ESP-C5-CAN SNIFFERV1.1.kicad_pcb
